scotthowson/desk-setup/desk-showcase-source/README.md

# L-249 desk showcase

30 seconds, 1920 × 1080, 24 fps, H.264 MP4 with original stereo ambient audio. Shots: establishing orbit, the three screens from the seat, a low pass under top B's front edge showing the rails, legs, feet and the bolted corner, the walnut and Y60 detail (glass rendered), a closing orbit, an end card with the repository and the manual.

Geometry exported from scotthowson/desk-setup index.html on main, Git blob e3dda0f5167aab8b4ff53113c0957ae94d3c382a.

The furniture mesh geometry is from the repository. Film treatment adds procedural walnut grain, screen artwork, studio lighting, room extension and camera animation. The model is a visual representation, not fabrication documentation. Internal coplanar case panels are omitted from the film render to prevent flicker.

Rebuild with Python (numpy, Pillow, moderngl), Node.js and ffmpeg:

1. node export_scene.cjs
2. python render.py
3. python score.py
4. ffmpeg -i desk-showcase-silent.mp4 -i ambient-score.wav -c:v copy -c:a aac -b:a 192k -af afade=t=out:st=28:d=2 -shortest -movflags +faststart desk-showcase.mp4

Three.js is included under its MIT license. Soundtrack is generated by score.py; it uses no third-party recordings.
