scotthowson/desk-setup/components/skadis/skadis-2x2-back-preview.png

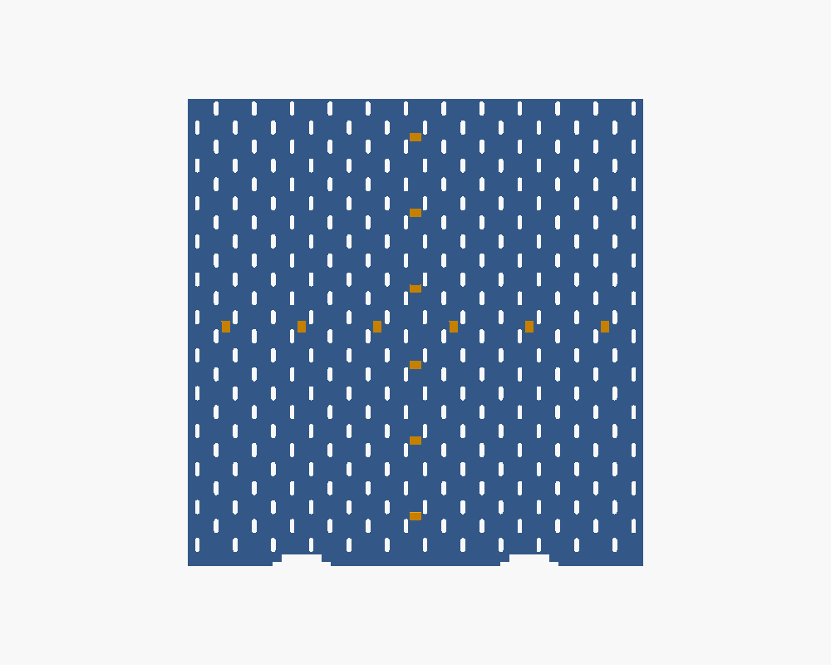
components/skadis/skadis-2x2-back-preview.png
