scotthowson/desk-setup/components/skadis/skadis-BL-preview.png

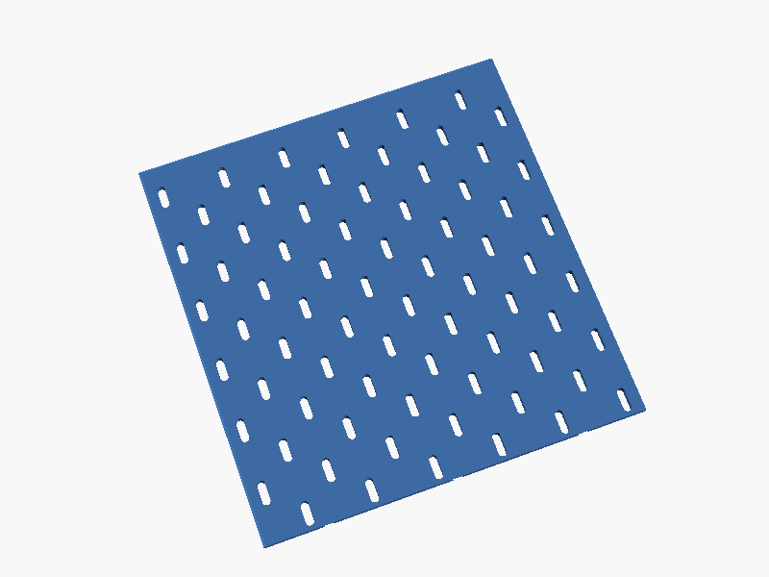
components/skadis/skadis-BL-preview.png
