scotthowson/desk-setup/components/skadis/skadis-bridges-preview.png

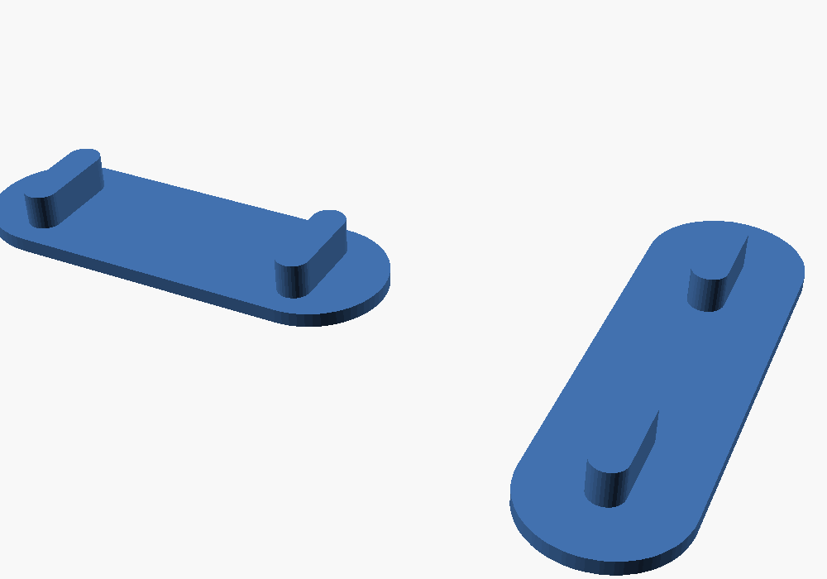
components/skadis/skadis-bridges-preview.png
