scotthowson/desk-setup/components/skadis/skadis-cross-back-preview.png

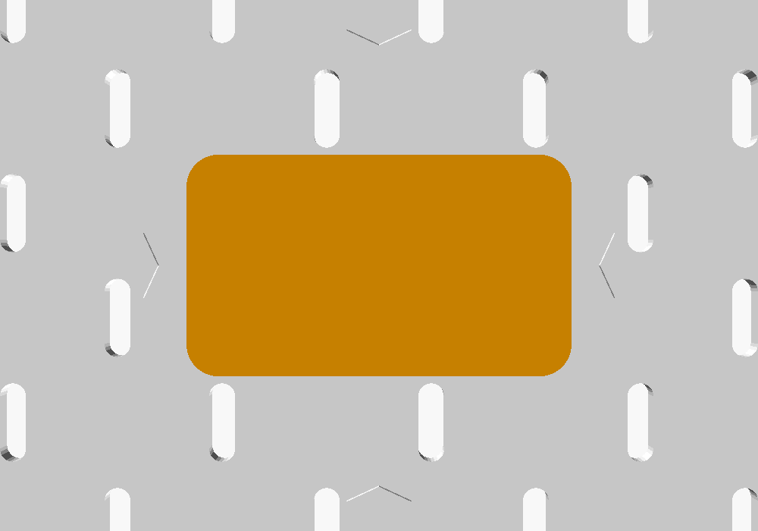
components/skadis/skadis-cross-back-preview.png
