scotthowson/desk-setup/components/skadis/skadis-cross-preview.png

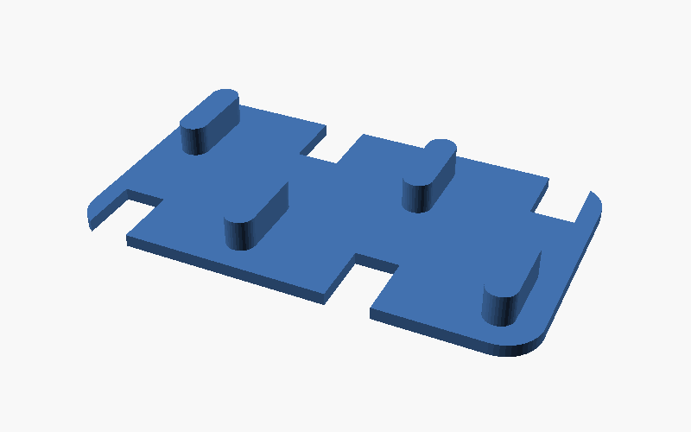
components/skadis/skadis-cross-preview.png
