scotthowson/desk-setup/components/skadis/skadis-extras-preview.png

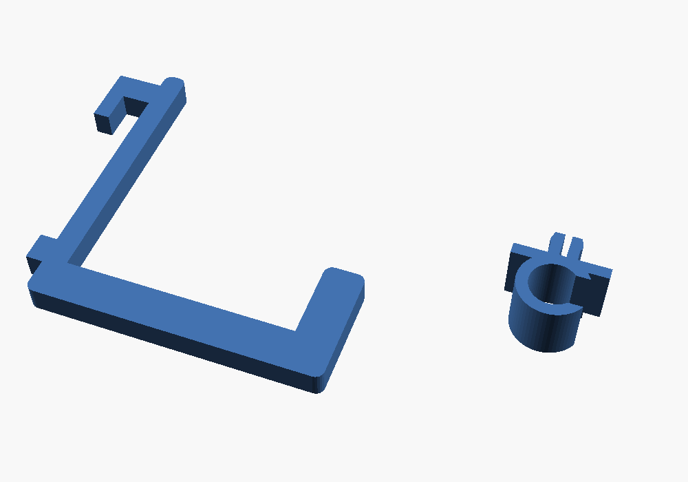
components/skadis/skadis-extras-preview.png
