scotthowson/desk-setup/components/skadis/skadis-joint-preview.png

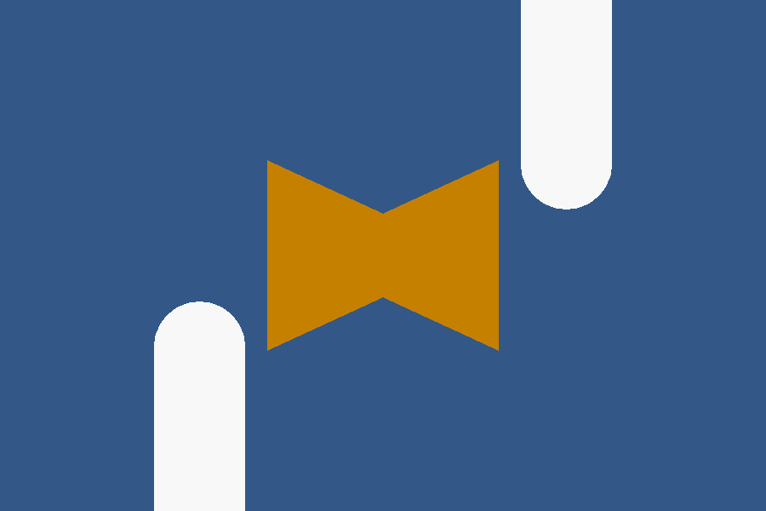
components/skadis/skadis-joint-preview.png
