scotthowson/desk-setup/components/skadis/skadis-key-preview.png

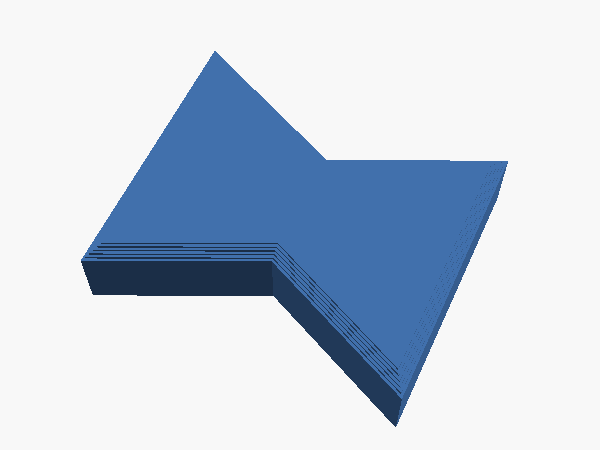
components/skadis/skadis-key-preview.png
