scotthowson/desk-setup/components/underware/accessories/og-accessories-preview.png

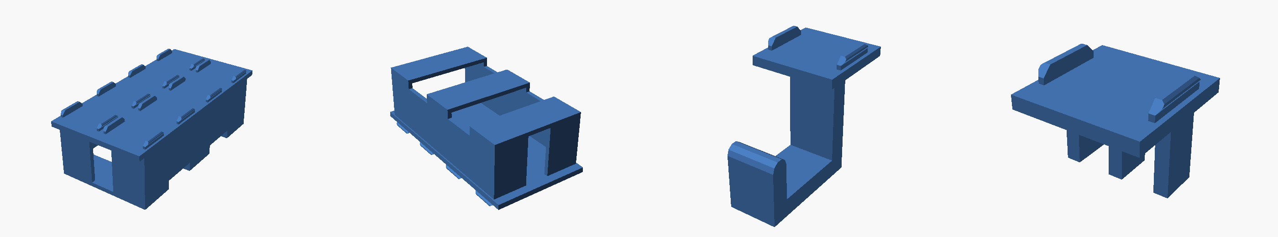
components/underware/accessories/og-accessories-preview.png
