scotthowson/desk-setup/components/underware/channel-L-preview.png

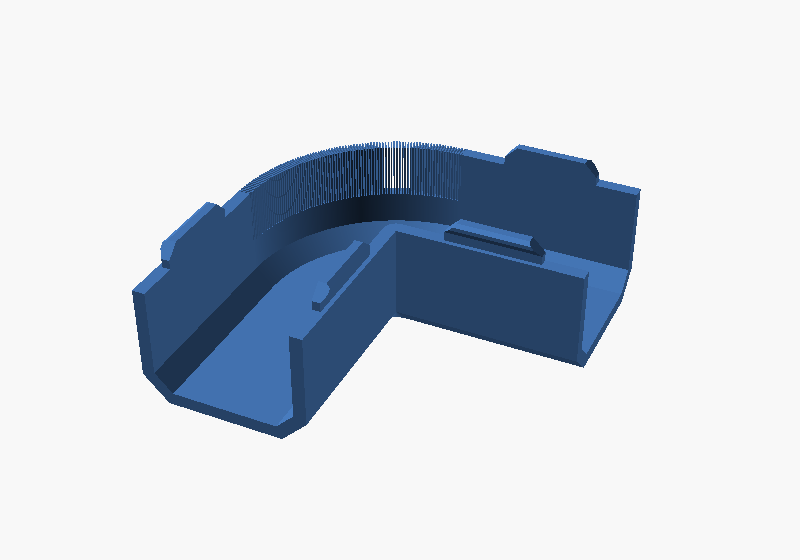
components/underware/channel-L-preview.png
