scotthowson/desk-setup/components/underware/channel-T-preview.png

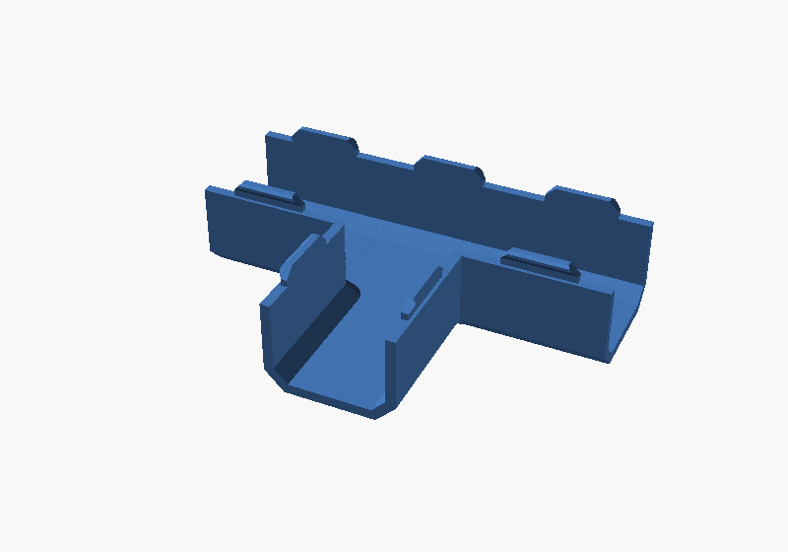
components/underware/channel-T-preview.png
