scotthowson/desk-setup/components/underware/plan.png

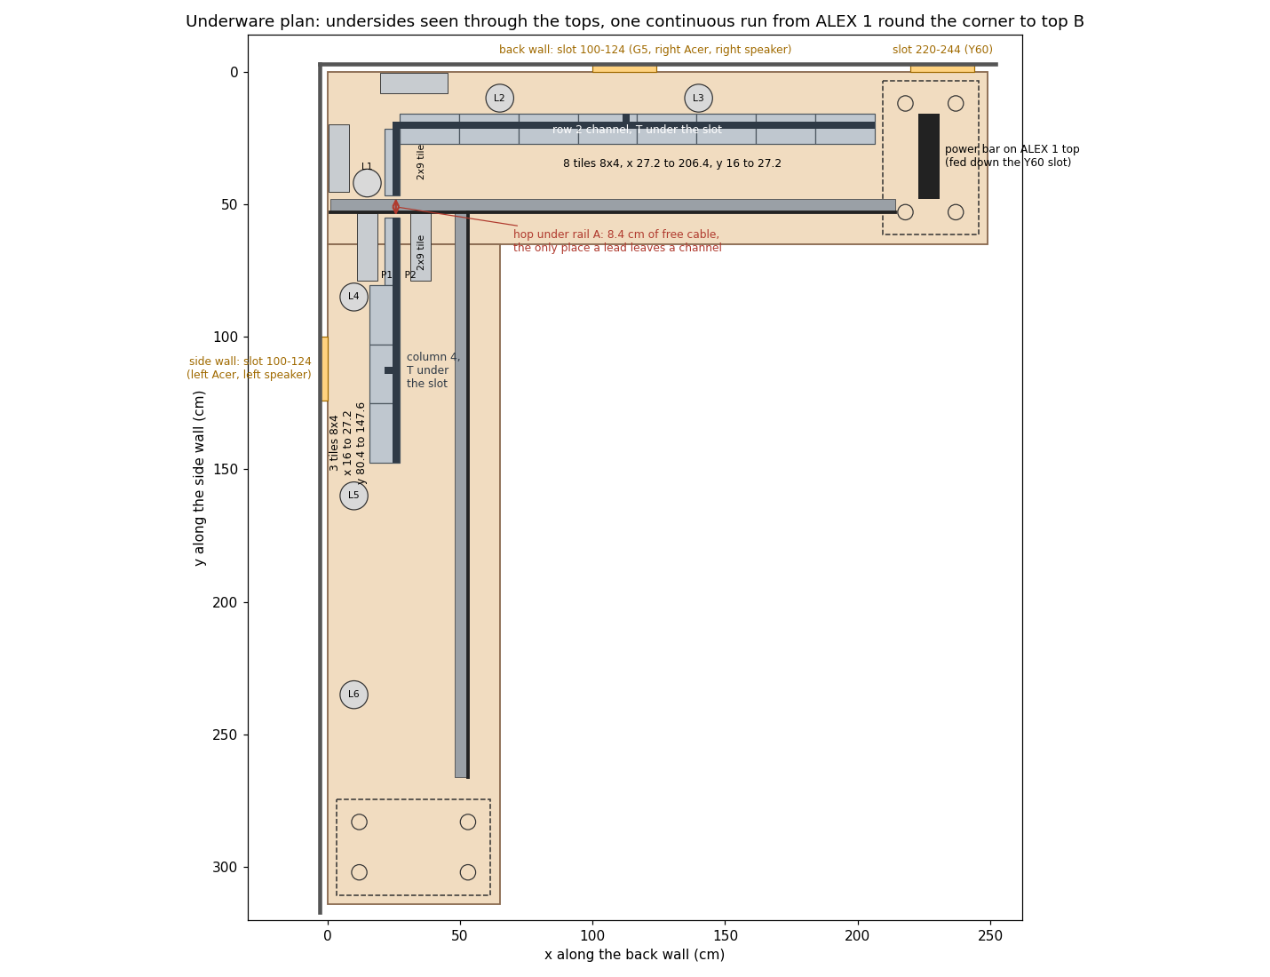
components/underware/plan.png
