scotthowson/desk-setup/components/underware/tile-8x4-lite-preview.png

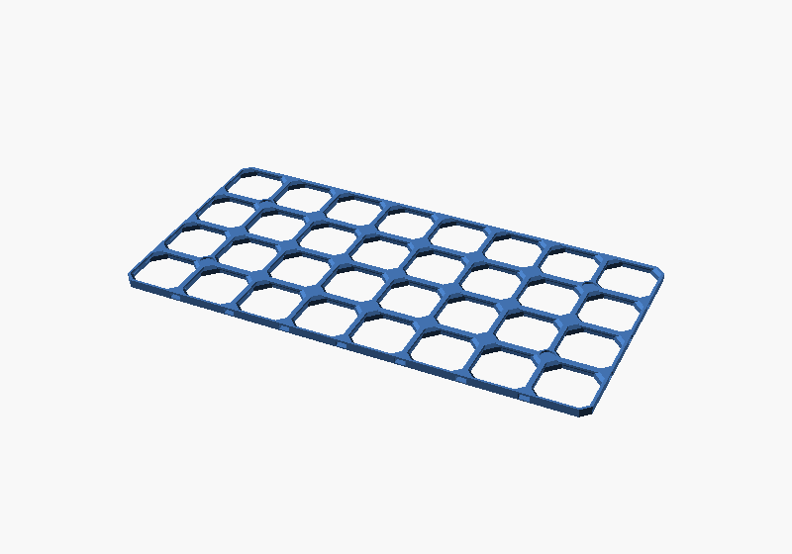
components/underware/tile-8x4-lite-preview.png
