scotthowson/desk-setup/parts/accessories/alex-foot-pad-preview.png

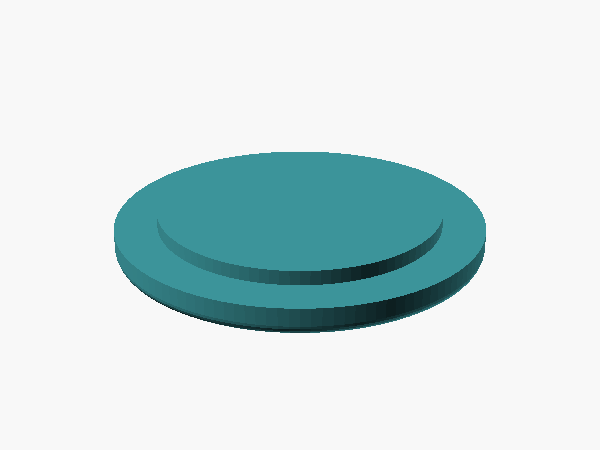
parts/accessories/alex-foot-pad-preview.png
