scotthowson/desk-setup/parts/accessories/alex-foot-preview.png

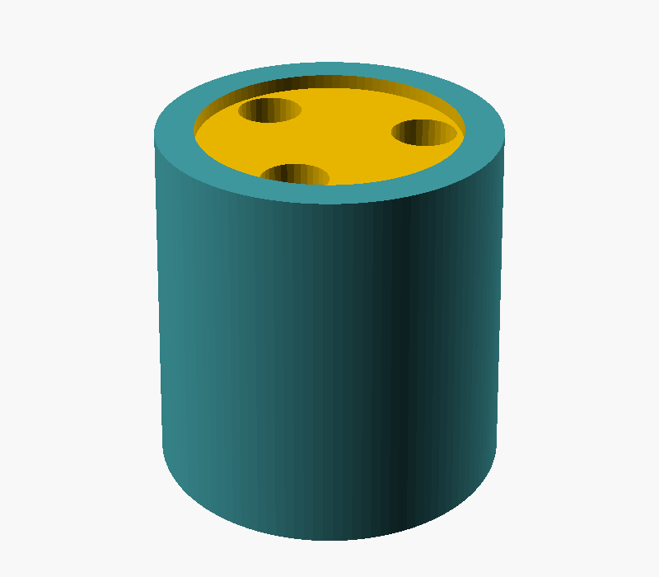
parts/accessories/alex-foot-preview.png
