scotthowson/desk-setup/parts/accessories/laptop-sling-preview.png

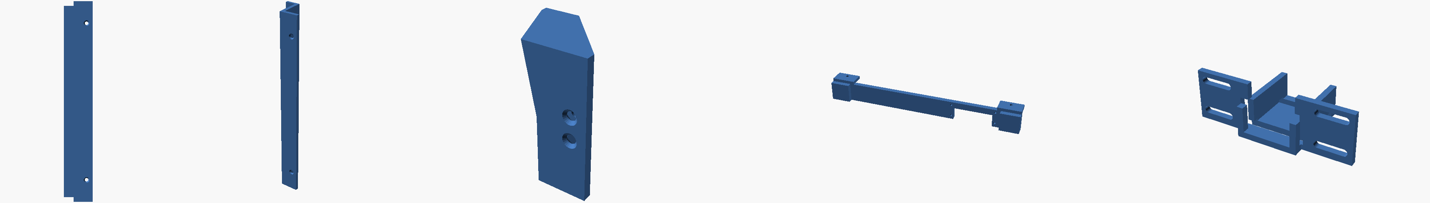
parts/accessories/laptop-sling-preview.png
