scotthowson/desk-setup/parts/accessories/phone-stand-preview.png

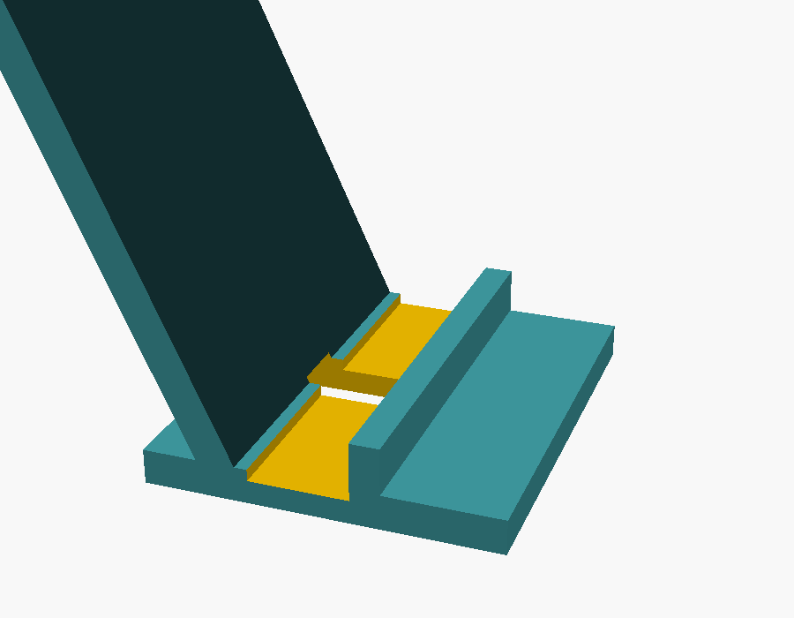
parts/accessories/phone-stand-preview.png
