scotthowson/desk-setup/parts/accessories/wall-gap-connector-preview.png

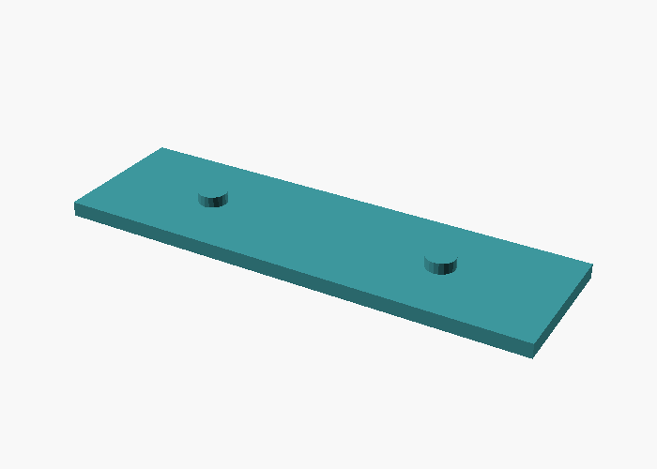
parts/accessories/wall-gap-connector-preview.png
