scotthowson/desk-setup/parts/accessories/wall-gap-corner-preview.png

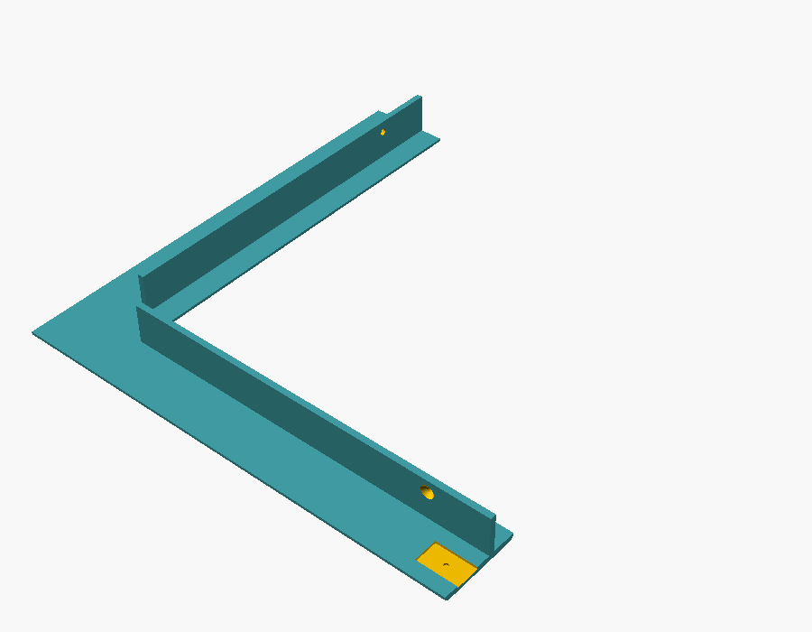
parts/accessories/wall-gap-corner-preview.png
