scotthowson/desk-setup/parts/accessories/wall-gap-end-cap-preview.png

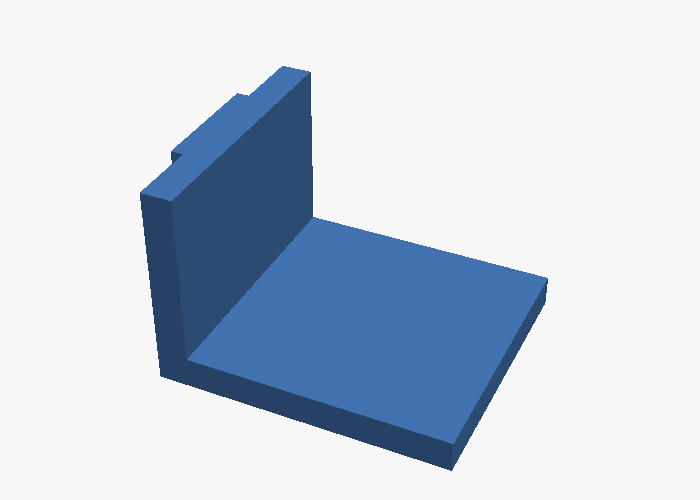
parts/accessories/wall-gap-end-cap-preview.png
