scotthowson/desk-setup/parts/accessories/wall-gap-strip-clamp-preview.png

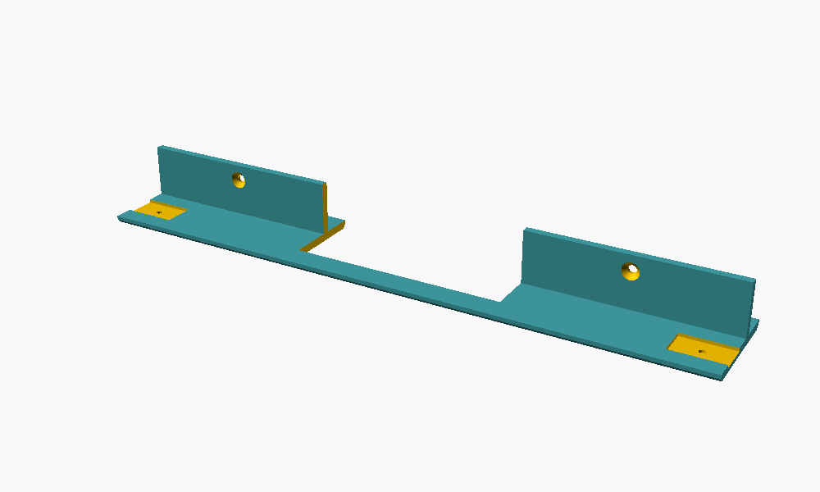
parts/accessories/wall-gap-strip-clamp-preview.png
