scotthowson/desk-setup/parts/cables/cable-clip-preview.png

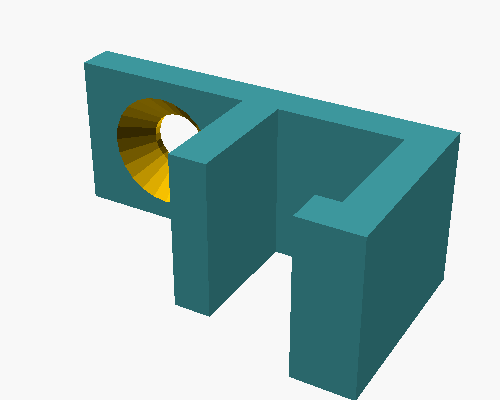
parts/cables/cable-clip-preview.png
