scotthowson/desk-setup/parts/cables/cable-tray-preview.png

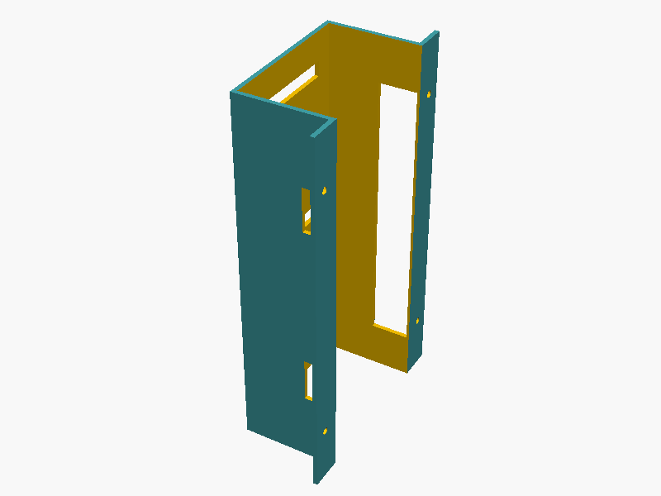
parts/cables/cable-tray-preview.png
