scotthowson/desk-setup/parts/cables/power-bar-cradle-preview.png

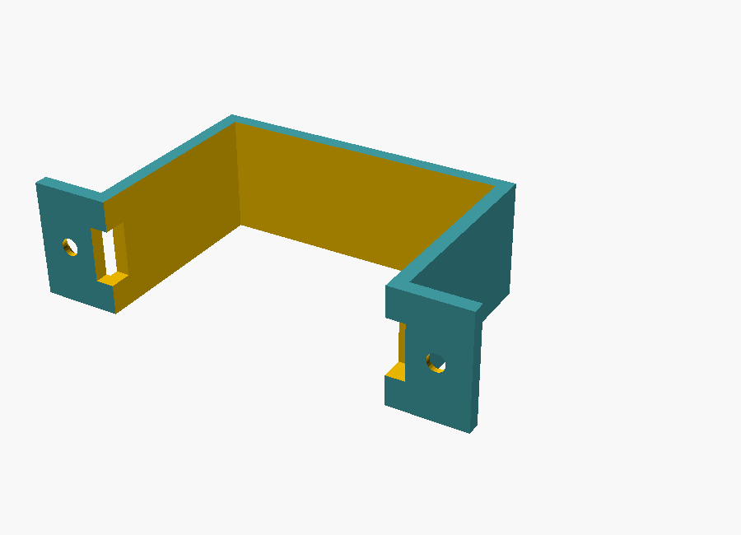
parts/cables/power-bar-cradle-preview.png
