scotthowson/desk-setup/parts/cables/rail-cable-hook-preview.png

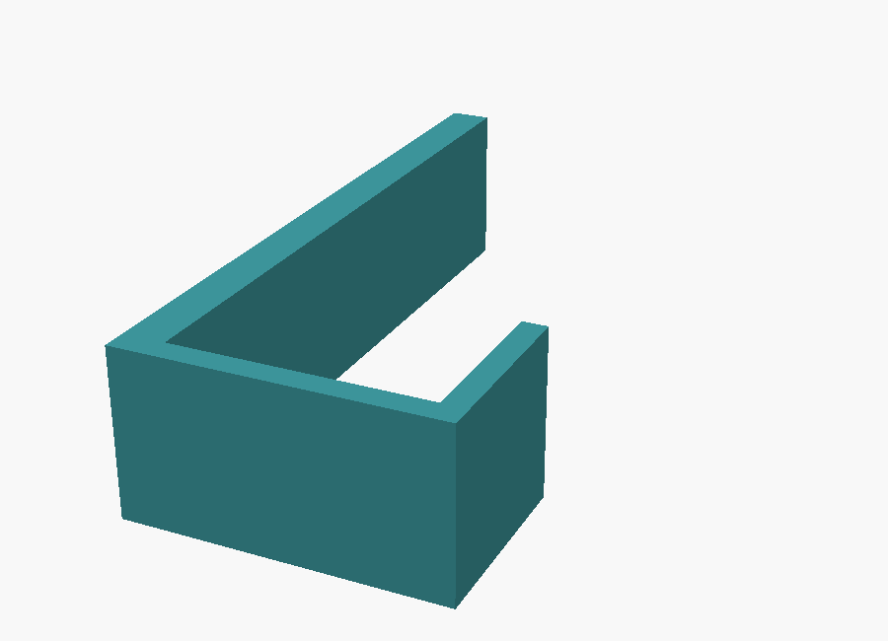
parts/cables/rail-cable-hook-preview.png
