scotthowson/desk-setup/parts/structure/foot-ring-preview.png

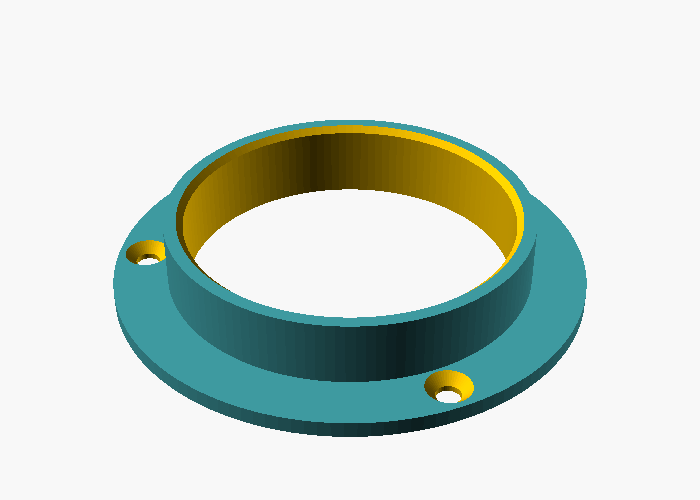
parts/structure/foot-ring-preview.png
