scotthowson/desk-setup/parts/structure/rail-end-cap-preview.png

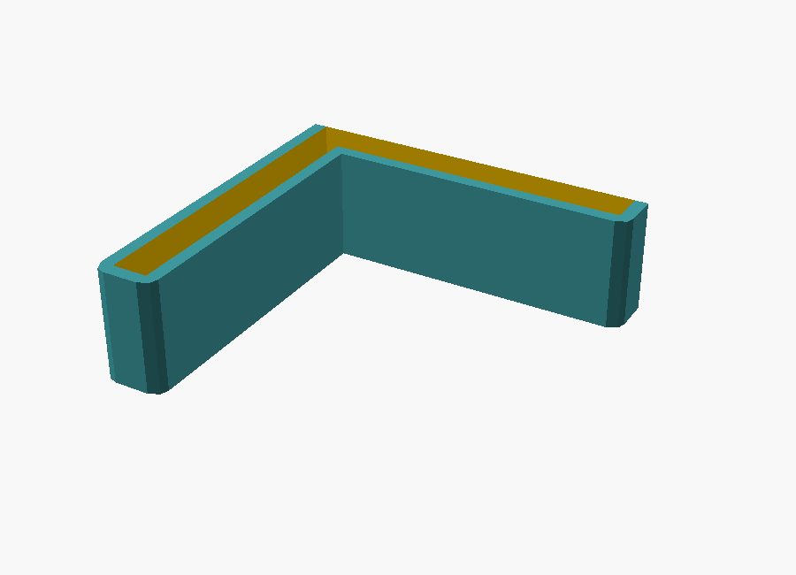
parts/structure/rail-end-cap-preview.png
