scotthowson/desk-setup/parts/tools/alex-corner-template-preview.png

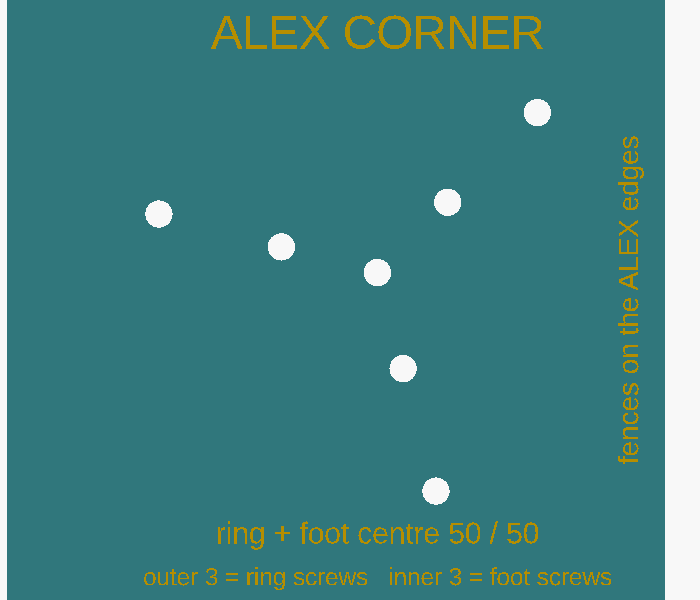
parts/tools/alex-corner-template-preview.png
