scotthowson/desk-setup/parts/tools/edge-t-square-preview.png

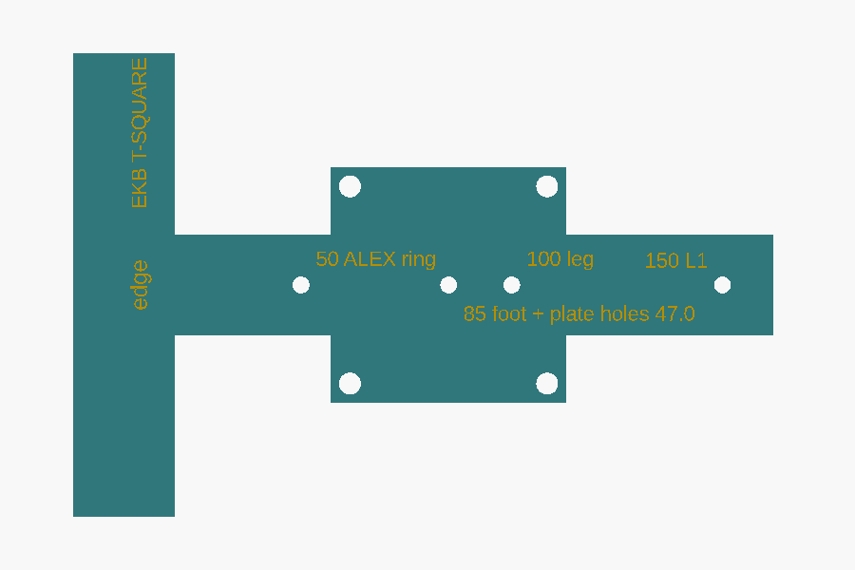
parts/tools/edge-t-square-preview.png
