scotthowson/desk-setup/parts/tools/feet-corner-jig-preview.png

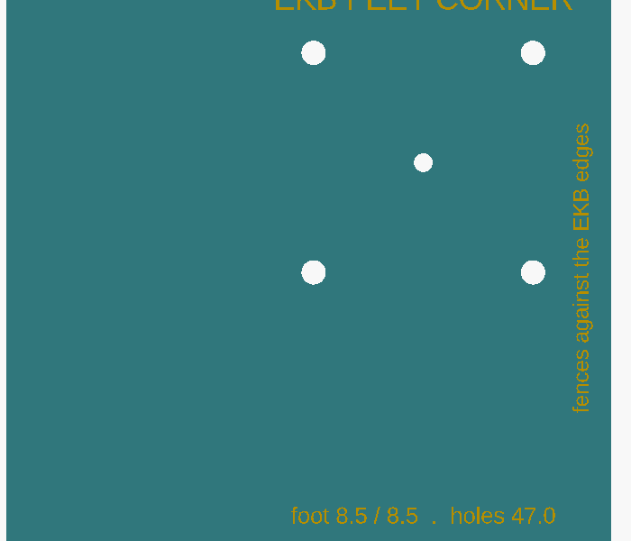
parts/tools/feet-corner-jig-preview.png
