scotthowson/desk-setup/parts/tools/fitting-centring-plug-preview.png

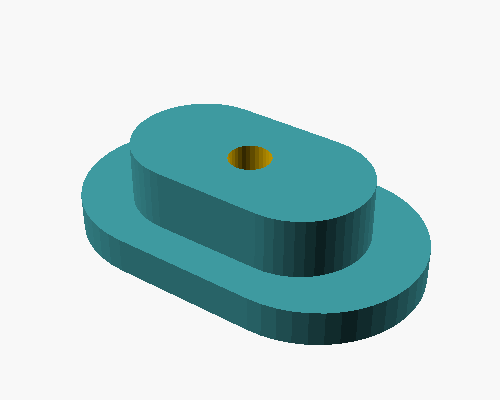
parts/tools/fitting-centring-plug-preview.png
