scotthowson/desk-setup/parts/tools/foot-height-gauge-preview.png

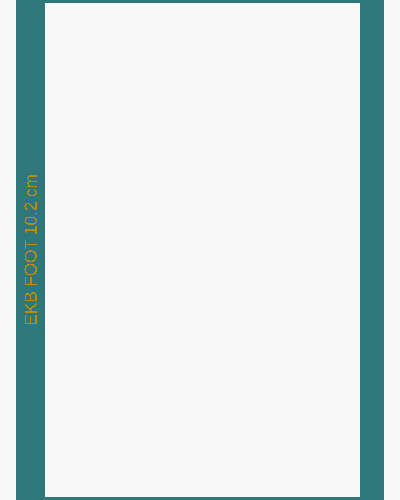
parts/tools/foot-height-gauge-preview.png
