scotthowson/desk-setup/parts/tools/leg-jig-preview.png

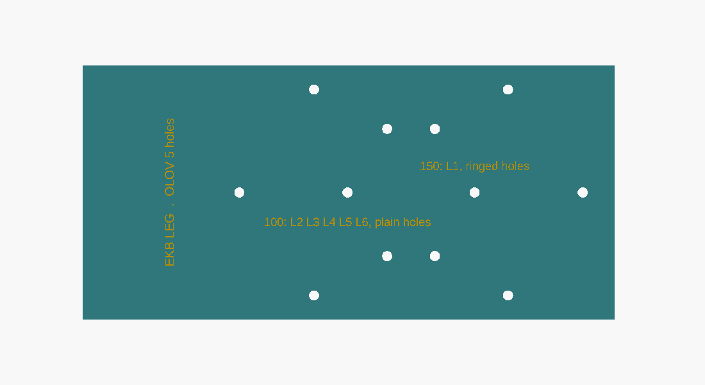
parts/tools/leg-jig-preview.png
