scotthowson/desk-setup/parts/tools/rail-bolt-jig-preview.png

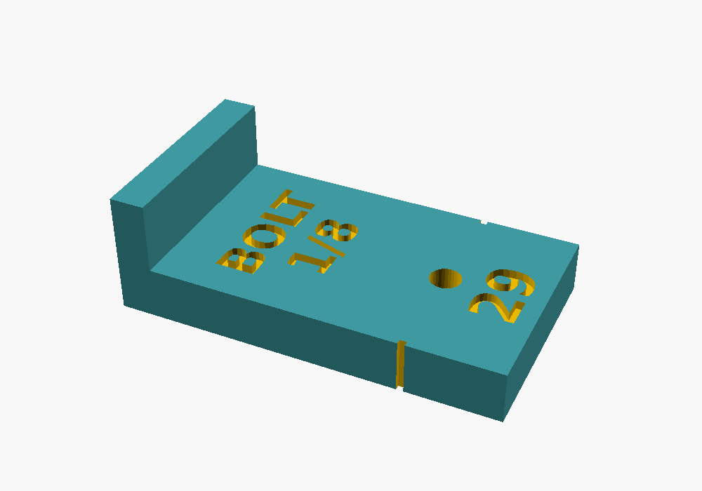
parts/tools/rail-bolt-jig-preview.png
