scotthowson/desk-setup/parts/tools/rail-drill-jig-preview.png

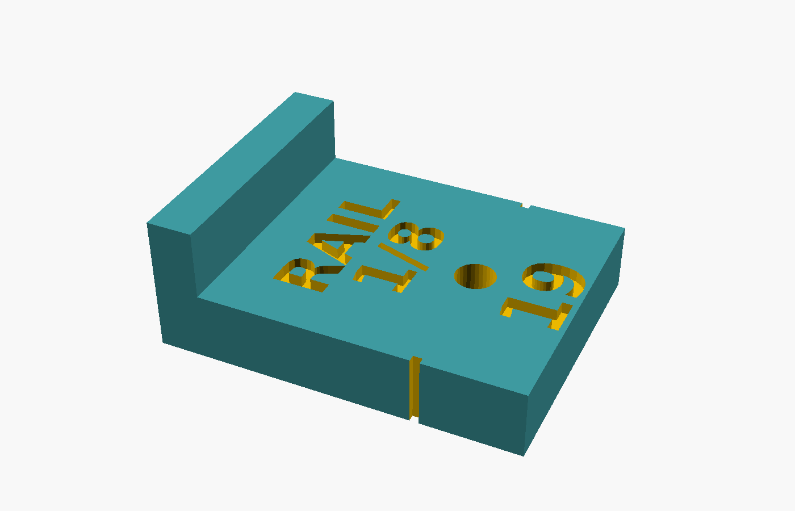
parts/tools/rail-drill-jig-preview.png
