scotthowson/desk-setup/parts/tools/rail-marking-gauge-preview.png

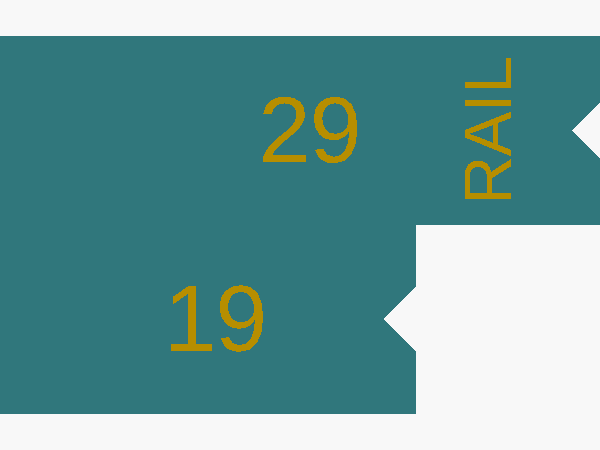
parts/tools/rail-marking-gauge-preview.png
