scotthowson/desk-setup/parts/tools/rail-setback-gauge-preview.png

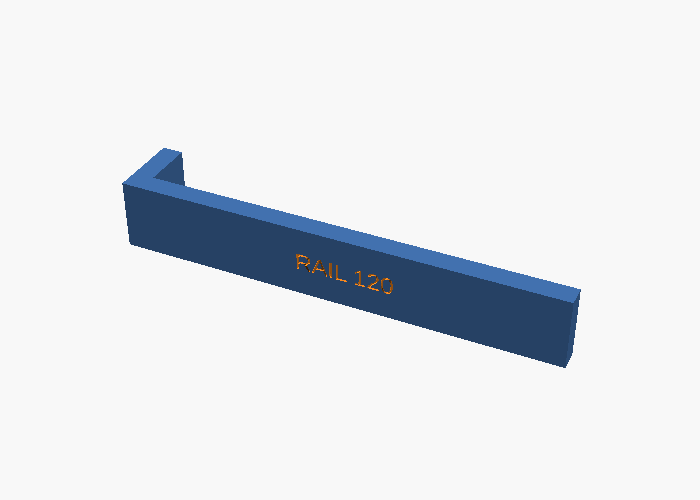
parts/tools/rail-setback-gauge-preview.png
