scotthowson/desk-setup/parts/tools/wall-gauge-preview.png

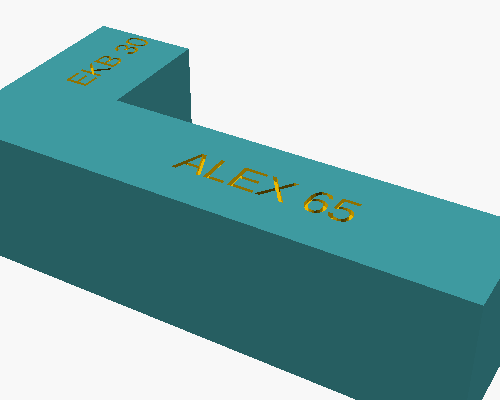
parts/tools/wall-gauge-preview.png
