scotthowson/desk-setup/components/skadis/skadis-controller-hook-x1.stl

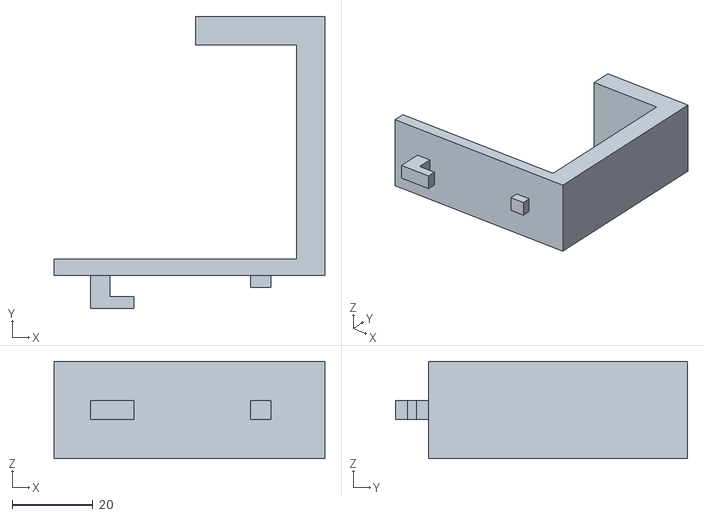
[picture p44: CAD file, 2026-10-30]
components/skadis/skadis-controller-hook-x1.stl
67.0 x 72.2 x 24.0
