scotthowson/desk-setup/components/underware/accessories/og-brick-dock-g5-x1.stl

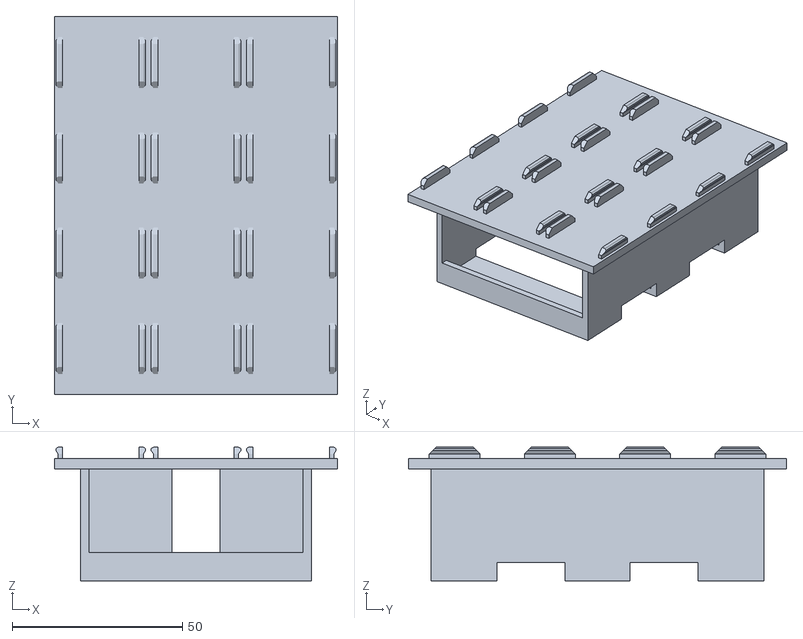
[picture p45: CAD file, 2026-11-02]
components/underware/accessories/og-brick-dock-g5-x1.stl
83.2 x 111.2 x 39.3
