scotthowson/desk-setup/components/underware/tile-9x9-lite.stl

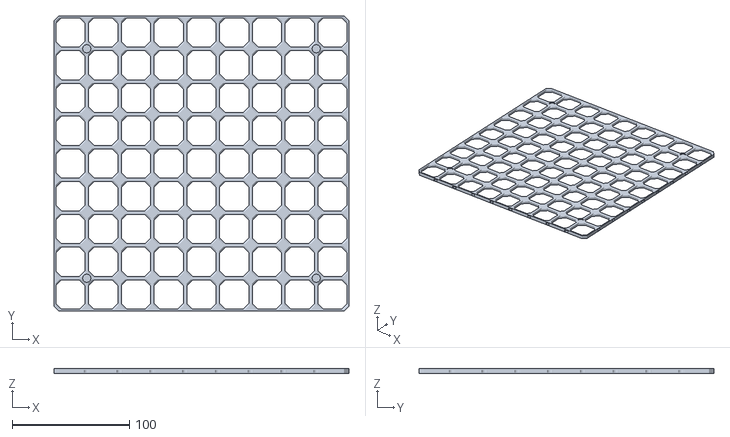
[picture p46: CAD file, 2026-10-28]
components/underware/tile-9x9-lite.stl
252.0 x 252.0 x 4.00
