scotthowson/desk-setup/parts/accessories/laptop-sling-usbc-clip-x1.stl

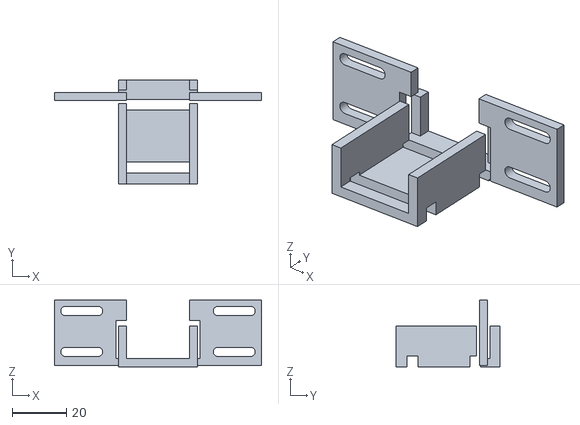
[picture p47: CAD file, 2026-11-02]
parts/accessories/laptop-sling-usbc-clip-x1.stl
76.0 x 38.0 x 24.5
