scotthowson/desk-setup/parts/cables/cable-tray-x3.stl

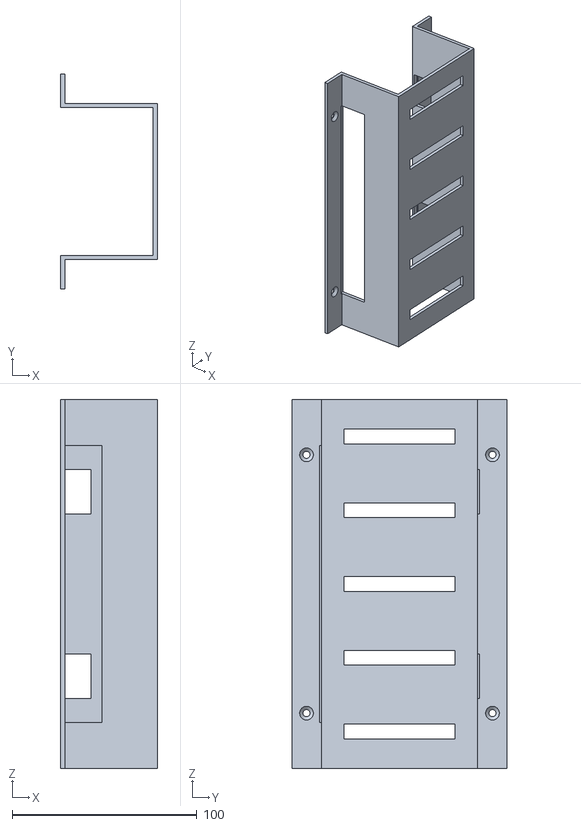
[picture p48: CAD file, 2026-10-23]
parts/cables/cable-tray-x3.stl
52.4 x 116.8 x 200.0
