scotthowson/desk-setup/parts/structure/foot-ring-x8.stl

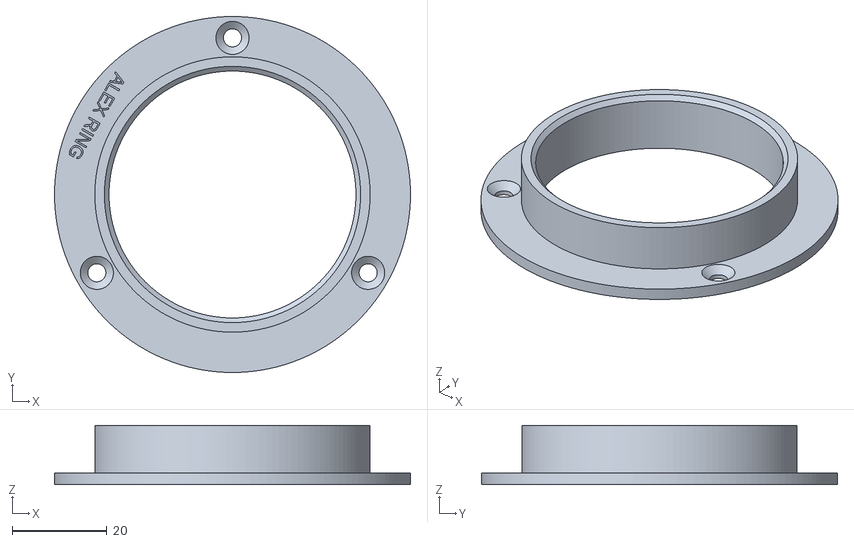
[picture p49: CAD file, 2026-10-23]
parts/structure/foot-ring-x8.stl
75.0 x 75.0 x 12.5
