scotthowson/desk-setup/components/skadis/skadis-shelf-120-x2.stl

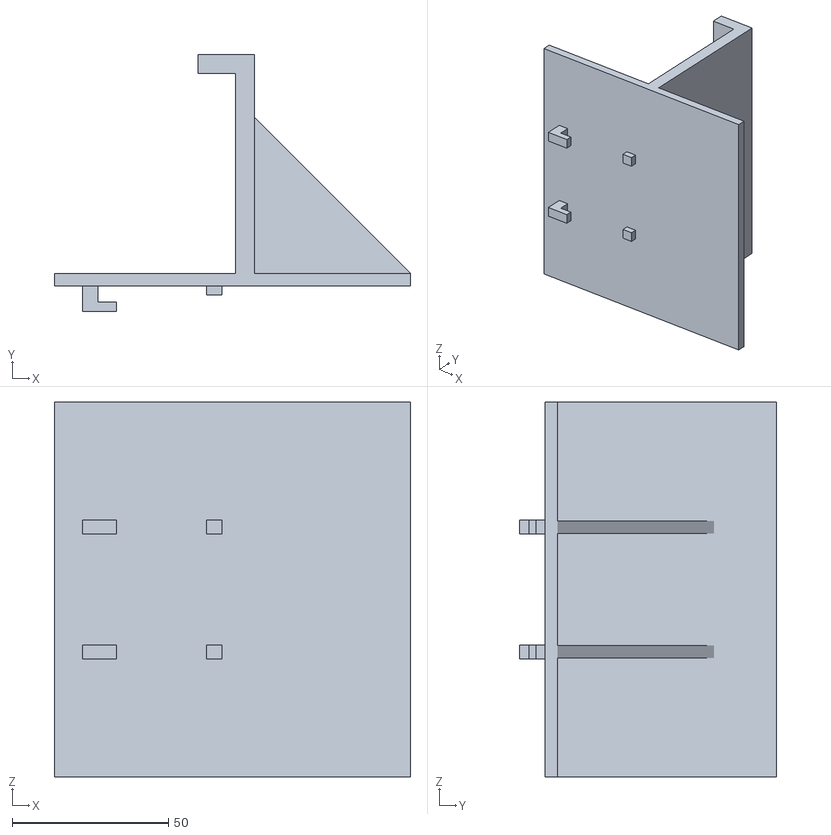
[picture p50: CAD file, 2026-10-30]
components/skadis/skadis-shelf-120-x2.stl
114.0 x 82.2 x 120.0
