scotthowson/desk-setup/components/underware/accessories/og-brick-dock-dell65-x1.stl

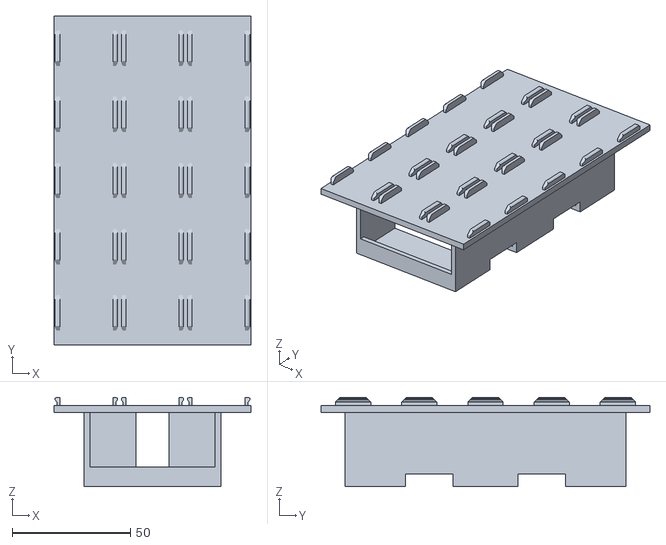
[picture p51: CAD file, 2026-11-02]
components/underware/accessories/og-brick-dock-dell65-x1.stl
83.2 x 139.2 x 37.8
