scotthowson/desk-setup/components/underware/tile-8x9-lite.stl

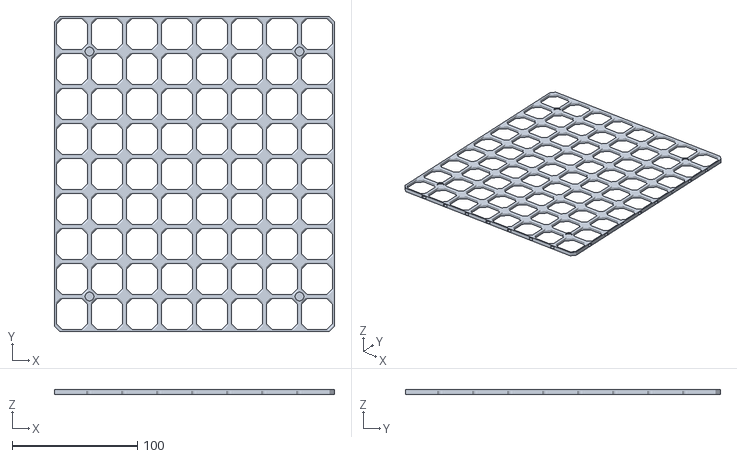
[picture p52: CAD file, 2026-10-28]
components/underware/tile-8x9-lite.stl
224.0 x 252.0 x 4.00
