scotthowson/desk-setup/parts/accessories/laptop-sling-carriage-x1.stl

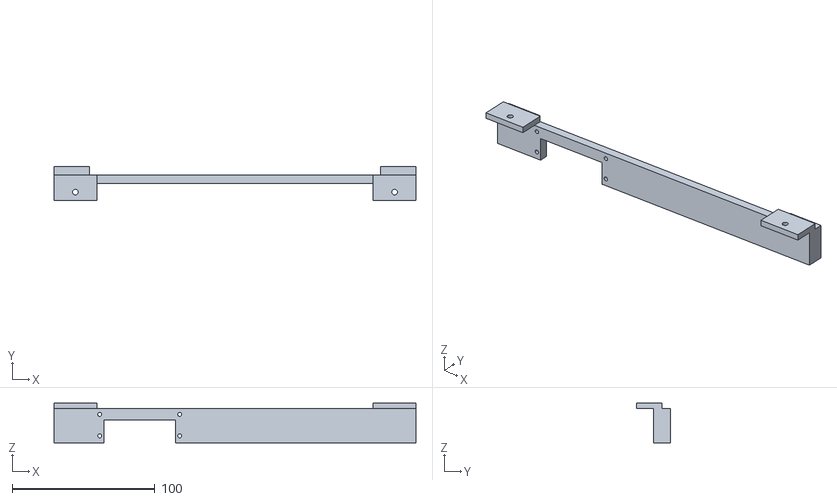
[picture p53: CAD file, 2026-11-02]
parts/accessories/laptop-sling-carriage-x1.stl
253.4 x 24.0 x 28.0
