scotthowson/desk-setup/parts/cables/cable-clip-x6.stl

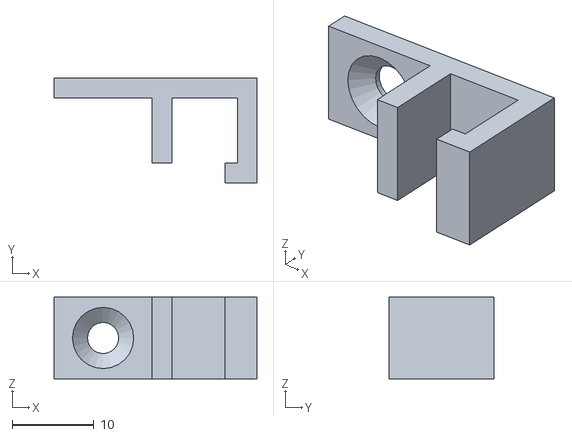
[picture p54: CAD file, 2026-10-23]
parts/cables/cable-clip-x6.stl
24.8 x 12.8 x 10.0
