scotthowson/desk-setup/parts/structure/rail-end-cap-B-x2.stl

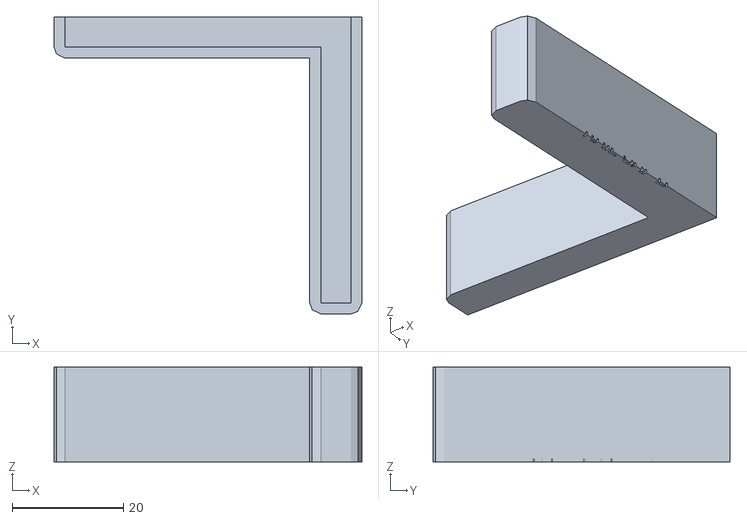
[picture p55: CAD file, 2026-10-23]
parts/structure/rail-end-cap-B-x2.stl
55.4 x 53.4 x 17.0
