scotthowson/desk-setup/parts/tools/pilot-drill-guide-x1.stl

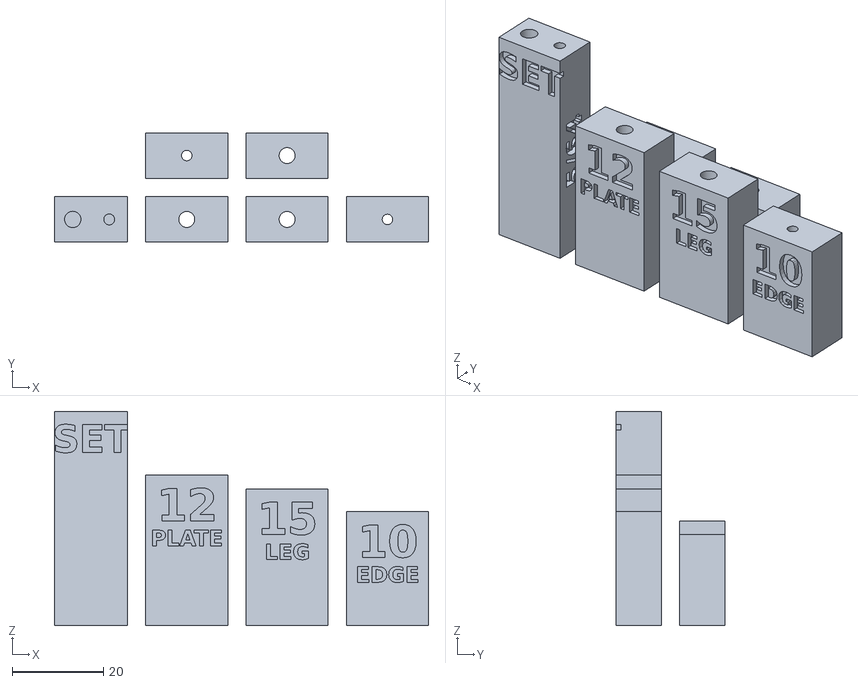
[picture p56: CAD file, 2026-11-02]
parts/tools/pilot-drill-guide-x1.stl
82.0 x 24.0 x 47.0
