scotthowson/desk-setup/components/skadis/skadis-keyboard-perch-x2.stl

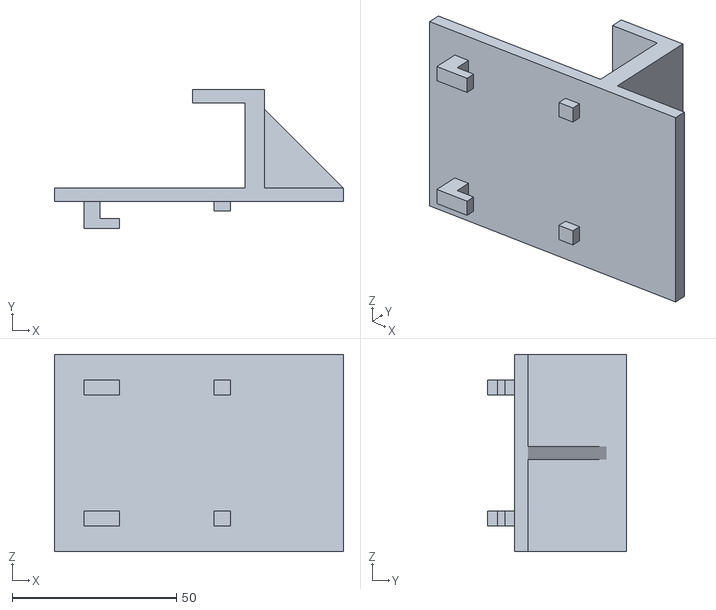
[picture p57: CAD file, 2026-10-30]
components/skadis/skadis-keyboard-perch-x2.stl
88.0 x 42.2 x 60.0
