scotthowson/desk-setup/components/underware/accessories/og-hook-x2.stl

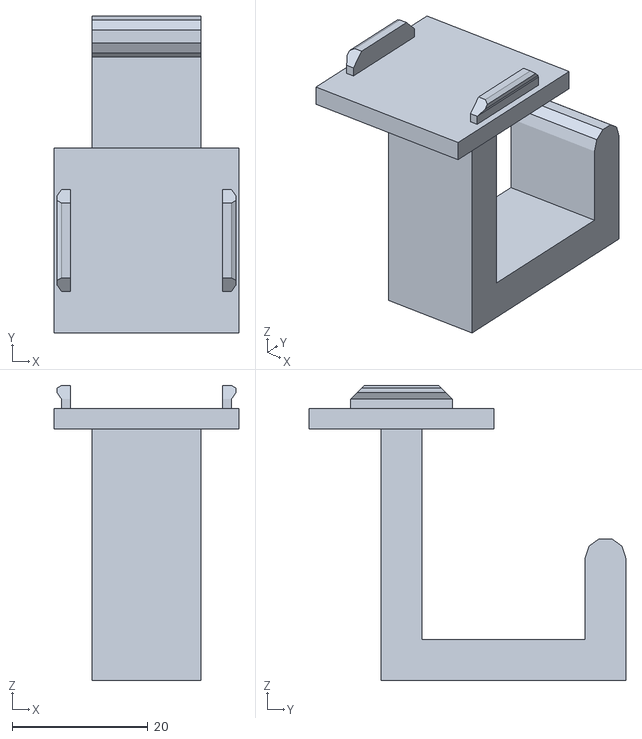
[picture p58: CAD file, 2026-11-02]
components/underware/accessories/og-hook-x2.stl
27.2 x 46.6 x 43.4
