scotthowson/desk-setup/components/underware/channel-L-x1.stl

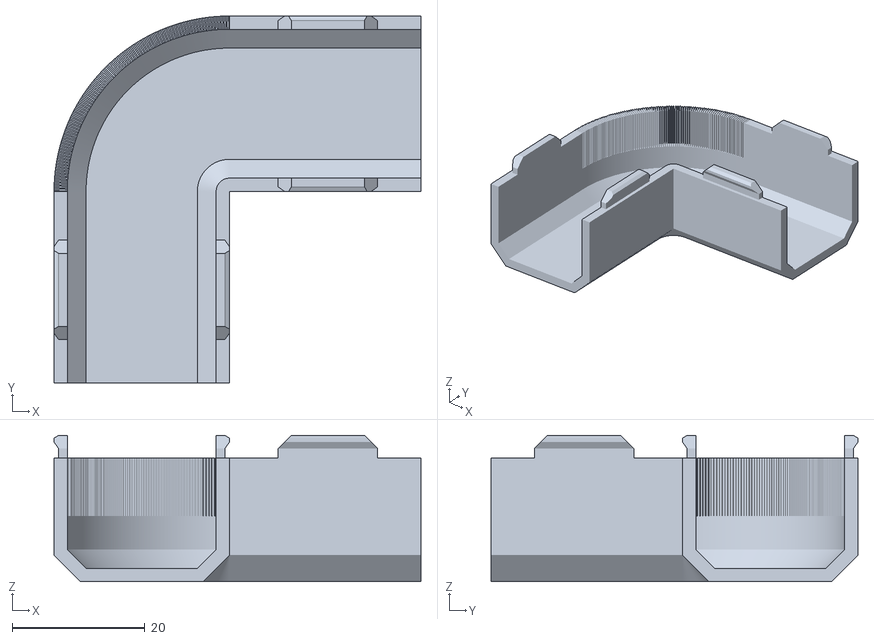
[picture p59: CAD file, 2026-10-26]
components/underware/channel-L-x1.stl
55.2 x 55.2 x 22.0
