scotthowson/desk-setup/parts/accessories/laptop-sling-mouth-x2.stl

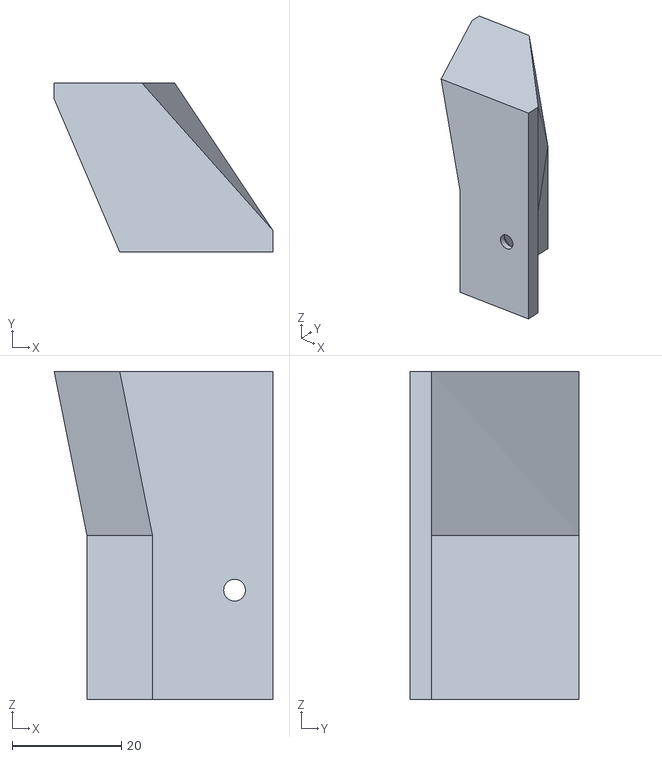
[picture p60: CAD file, 2026-11-02]
parts/accessories/laptop-sling-mouth-x2.stl
40.0 x 31.0 x 60.0
