scotthowson/desk-setup/parts/cables/power-bar-cradle-x4.stl

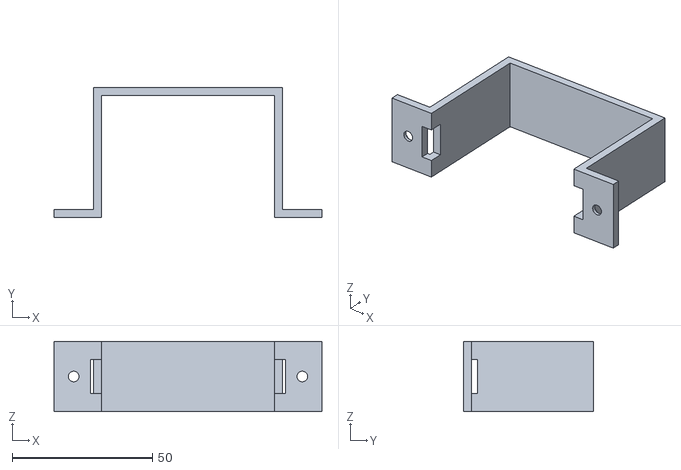
[picture p61: CAD file, 2026-10-21]
parts/cables/power-bar-cradle-x4.stl
95.5 x 46.5 x 25.0
