scotthowson/desk-setup/parts/structure/rail-end-cap-A-x1.stl

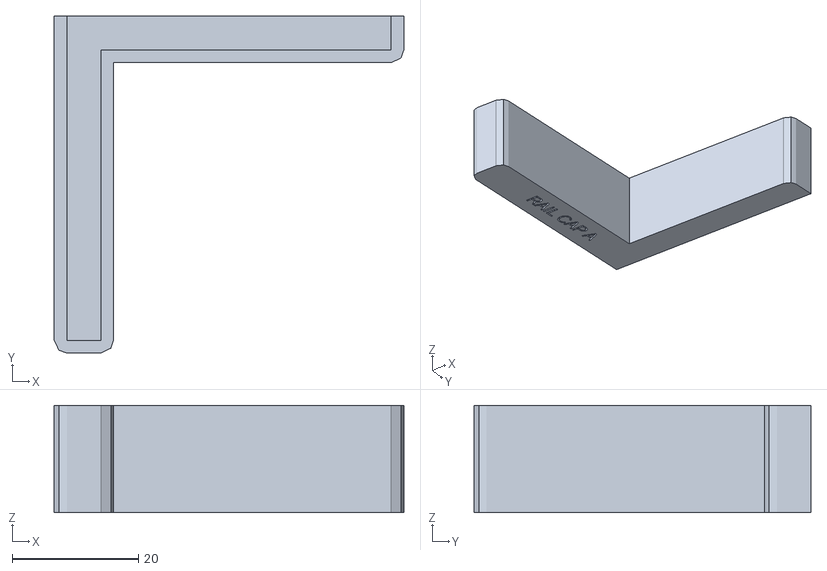
[picture p62: CAD file, 2026-10-23]
parts/structure/rail-end-cap-A-x1.stl
55.4 x 53.4 x 17.0
