scotthowson/desk-setup/parts/tools/rail-drill-jig-x1.stl

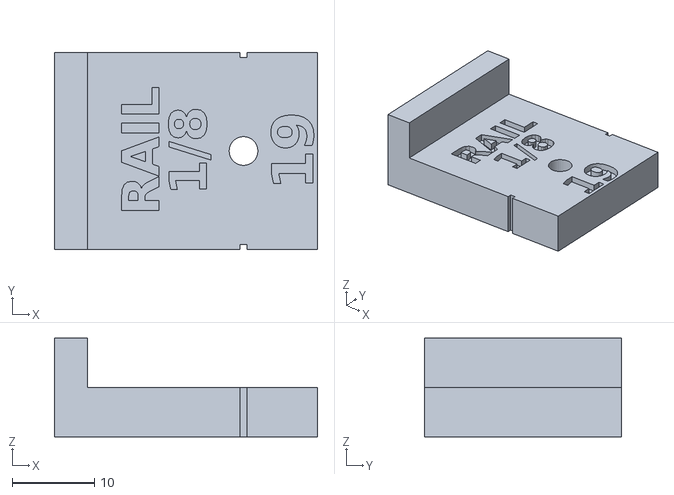
[picture p63: CAD file, 2026-11-02]
parts/tools/rail-drill-jig-x1.stl
32.0 x 24.0 x 12.0
