scotthowson/desk-setup/components/skadis/rib-240-k3-x4.stl

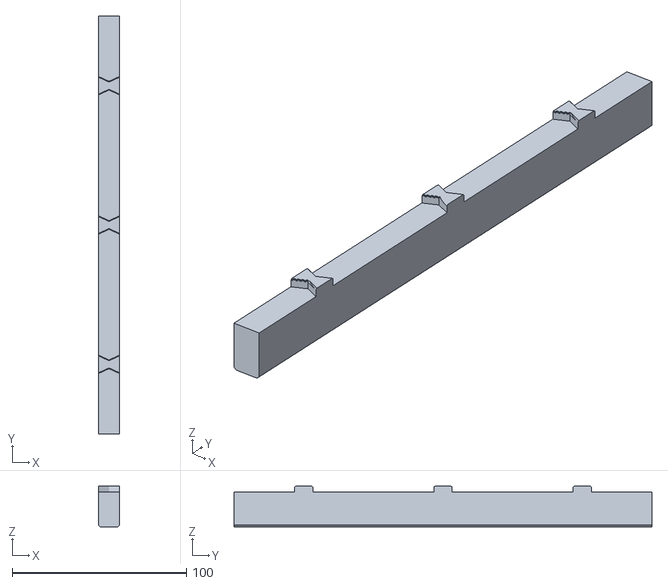
[picture p64: CAD file, 2026-10-30]
components/skadis/rib-240-k3-x4.stl
12.0 x 240.0 x 23.4
