scotthowson/desk-setup/components/underware/accessories/og-cable-exit-x2.stl

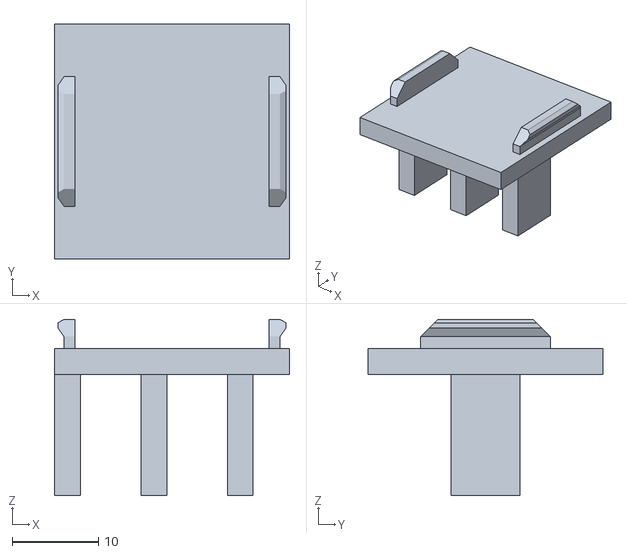
[picture p65: CAD file, 2026-11-02]
components/underware/accessories/og-cable-exit-x2.stl
27.2 x 27.2 x 20.4
