scotthowson/desk-setup/components/underware/channel-T-x2.stl

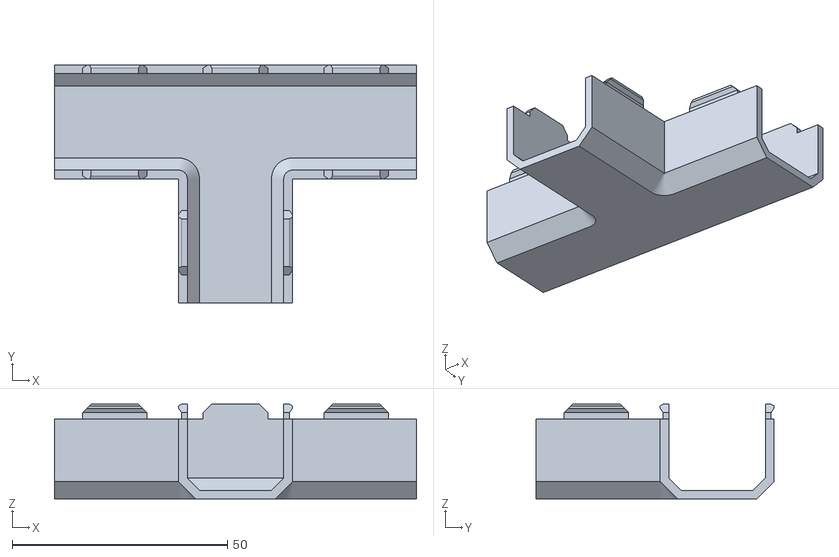
[picture p66: CAD file, 2026-10-26]
components/underware/channel-T-x2.stl
84.0 x 55.2 x 22.0
