scotthowson/desk-setup/parts/accessories/laptop-sling-rail-x2.stl

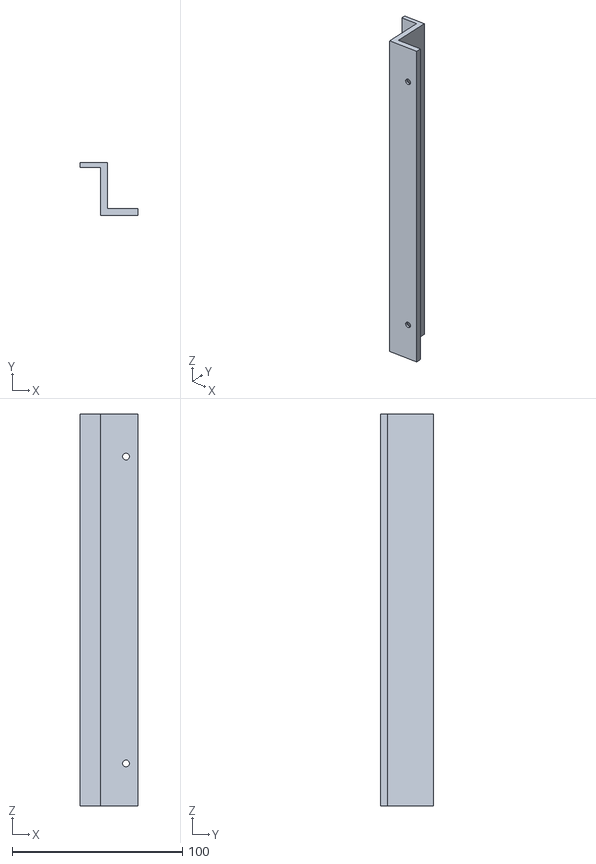
[picture p67: CAD file, 2026-11-02]
parts/accessories/laptop-sling-rail-x2.stl
34.0 x 31.0 x 230.0
