scotthowson/desk-setup/parts/cables/rail-cable-hook-x4.stl

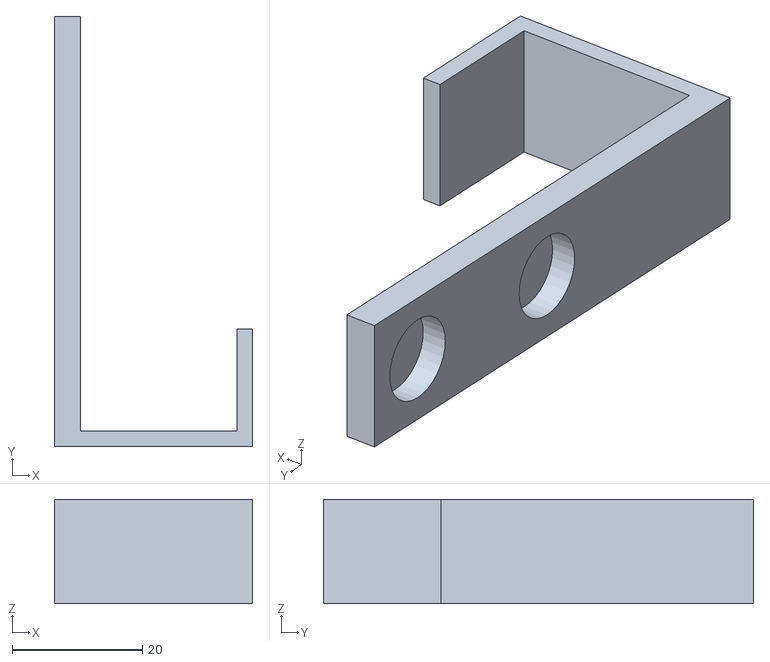
[picture p68: CAD file, 2026-10-21]
parts/cables/rail-cable-hook-x4.stl
30.4 x 66.0 x 16.0
