scotthowson/desk-setup/parts/tools/rail-setback-gauge-x2.stl

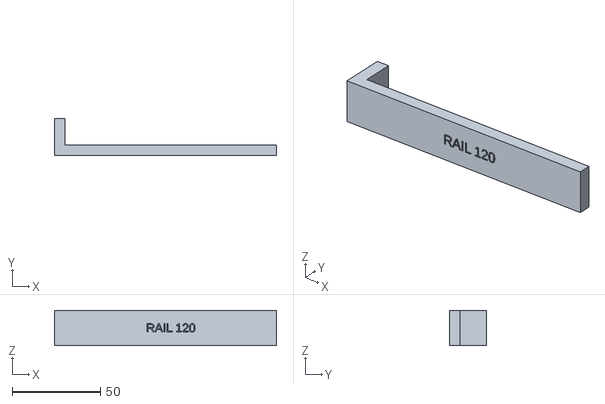
[picture p69: CAD file, 2026-10-26]
parts/tools/rail-setback-gauge-x2.stl
126.0 x 21.0 x 20.0
