scotthowson/desk-setup/components/skadis/rib-240-k0.stl

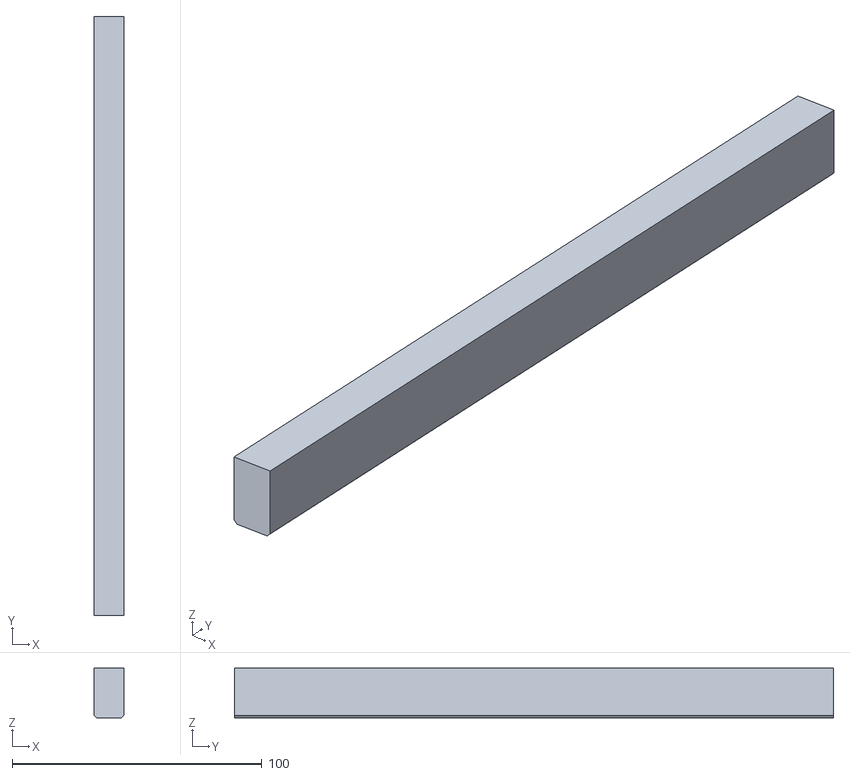
[picture p70: CAD file, 2026-10-30]
components/skadis/rib-240-k0.stl
12.0 x 240.0 x 20.0
