scotthowson/desk-setup/components/underware/channel-I-4-x1.stl

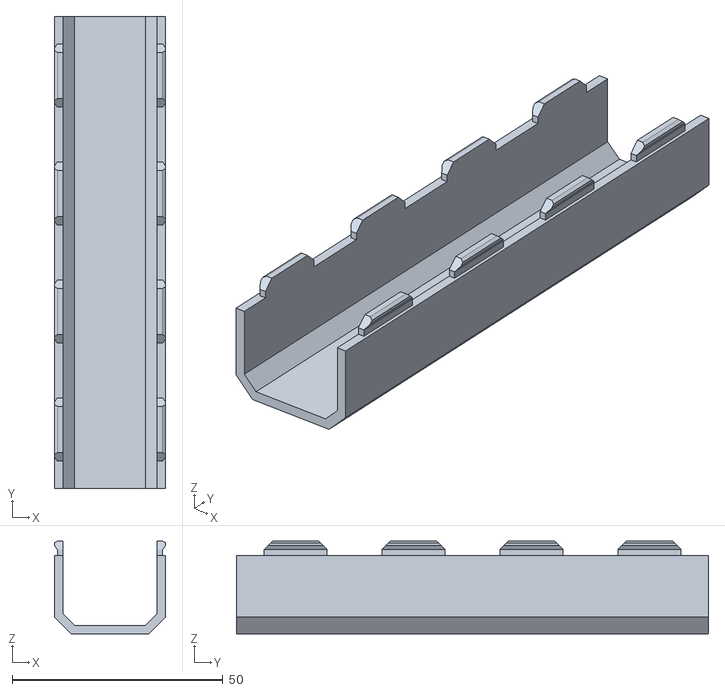
[picture p71: CAD file, 2026-10-26]
components/underware/channel-I-4-x1.stl
26.4 x 112.0 x 22.0
