scotthowson/desk-setup/parts/accessories/wall-gap-end-cap-x2.stl

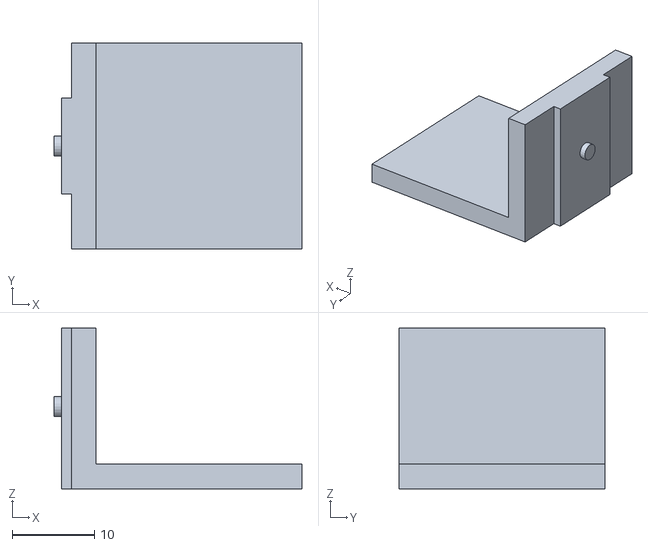
[picture p72: CAD file, 2026-10-25]
parts/accessories/wall-gap-end-cap-x2.stl
30.1 x 25.0 x 19.5
