scotthowson/desk-setup/parts/tools/alex-corner-template-x1.stl

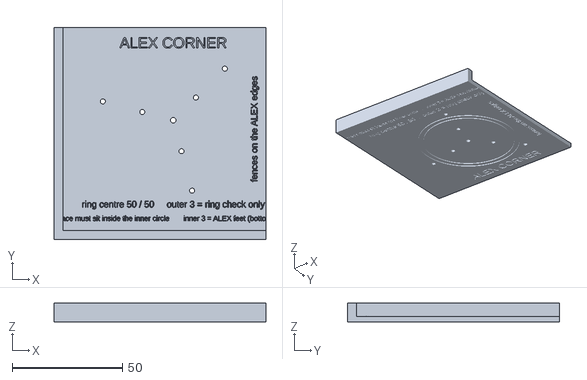
[picture p73: CAD file, 2026-10-23]
parts/tools/alex-corner-template-x1.stl
96.0 x 96.0 x 8.50
