scotthowson/desk-setup/components/skadis/skadis-bridge-v-x4.stl

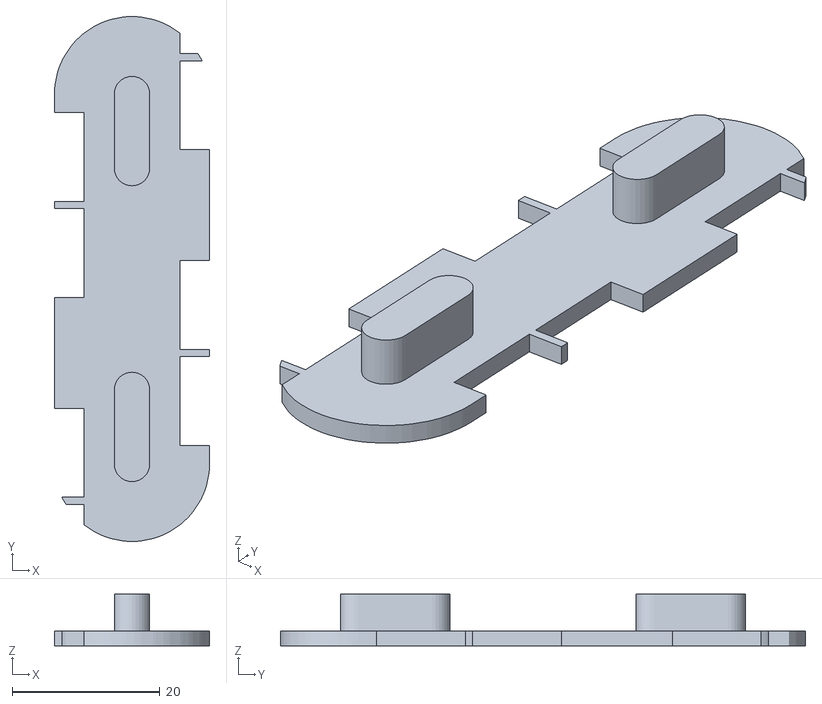
[picture p74: CAD file, 2026-10-30]
components/skadis/skadis-bridge-v-x4.stl
21.0 x 71.0 x 7.00
