scotthowson/desk-setup/components/underware/channel-I-8-x11.stl

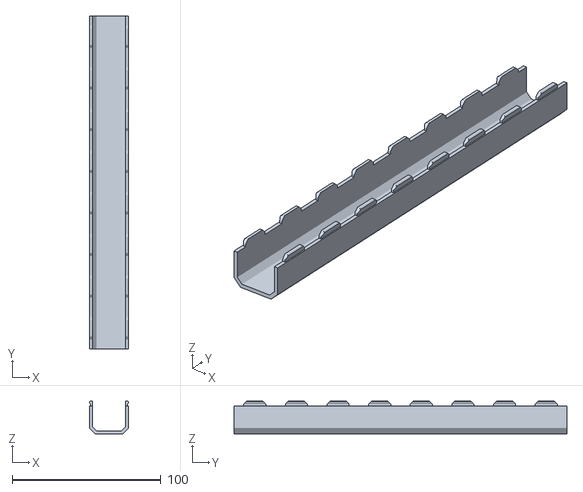
[picture p75: CAD file, 2026-10-26]
components/underware/channel-I-8-x11.stl
26.4 x 224.0 x 22.0
