scotthowson/desk-setup/parts/accessories/wall-gap-strip-220-x1.stl

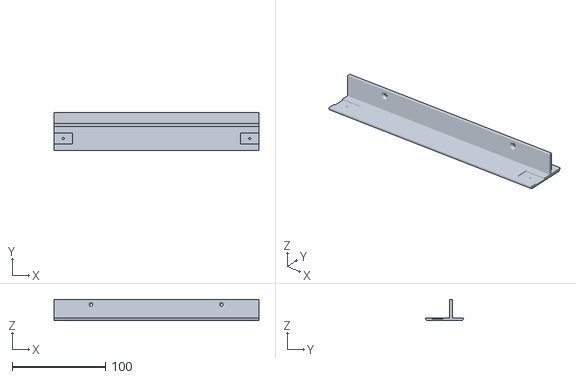
[picture p76: CAD file, 2026-10-25]
parts/accessories/wall-gap-strip-220-x1.stl
220.0 x 41.0 x 23.0
