scotthowson/desk-setup/parts/tools/edge-t-square-x1.stl

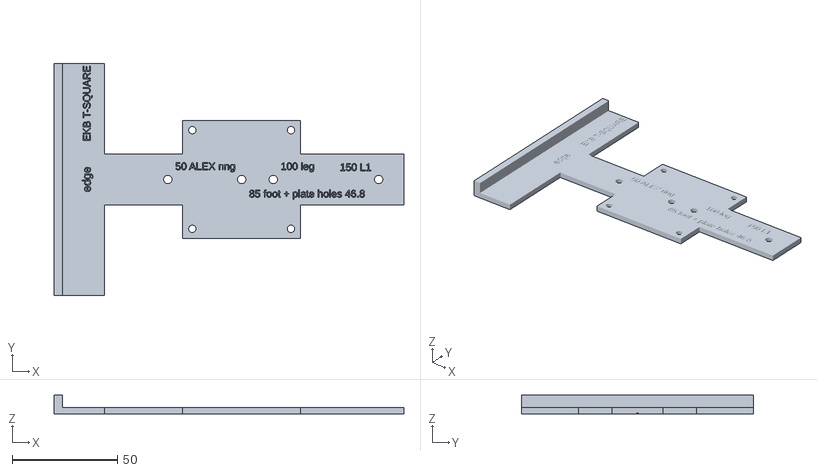
[picture p77: CAD file, 2026-10-23]
parts/tools/edge-t-square-x1.stl
166.0 x 110.0 x 9.00
