scotthowson/desk-setup/components/skadis/skadis-bridge-h-x4.stl

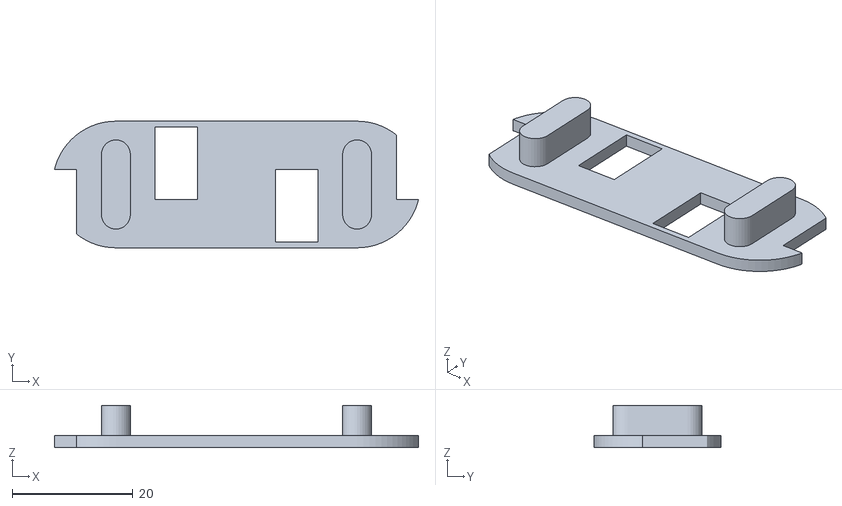
[picture p78: CAD file, 2026-10-30]
components/skadis/skadis-bridge-h-x4.stl
60.4 x 21.0 x 7.00
