scotthowson/desk-setup/components/underware/tile-2x9-lite-x2.stl

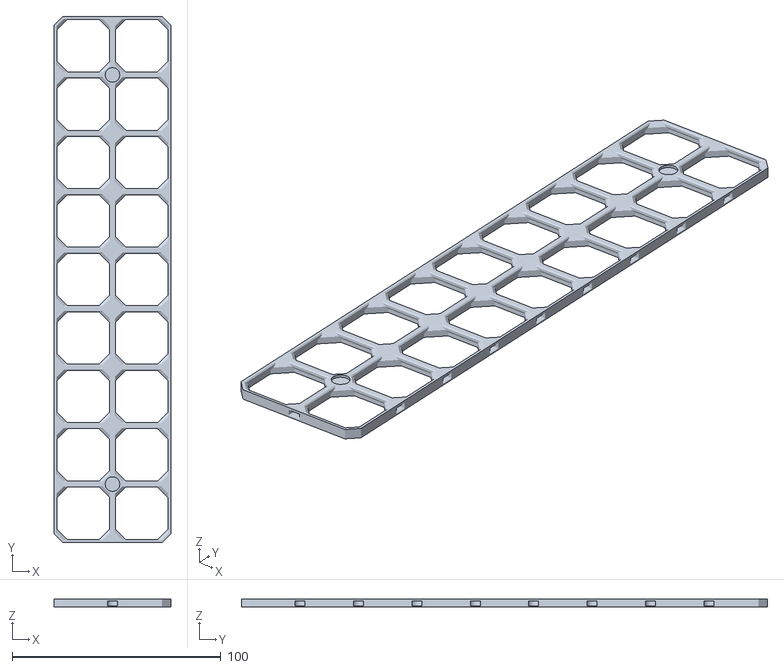
[picture p79: CAD file, 2026-10-26]
components/underware/tile-2x9-lite-x2.stl
56.0 x 252.0 x 4.00
