scotthowson/desk-setup/parts/accessories/wall-gap-strip-50-x1.stl

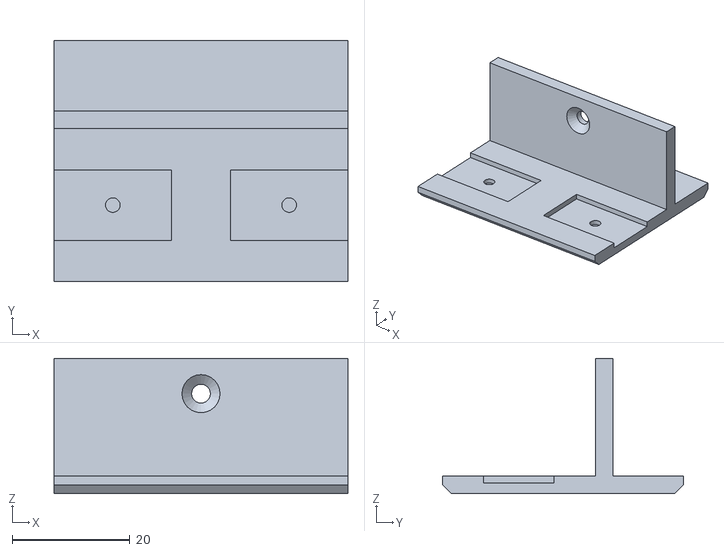
[picture p80: CAD file, 2026-10-25]
parts/accessories/wall-gap-strip-50-x1.stl
50.0 x 41.0 x 23.0
