scotthowson/desk-setup/parts/tools/feet-corner-jig-x1.stl

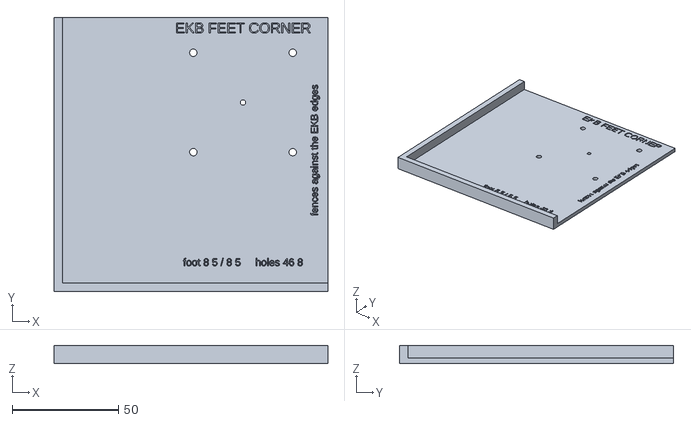
[picture p81: CAD file, 2026-10-23]
parts/tools/feet-corner-jig-x1.stl
129.0 x 129.0 x 8.50
