scotthowson/desk-setup/components/skadis/skadis-headset-hook-x1.stl

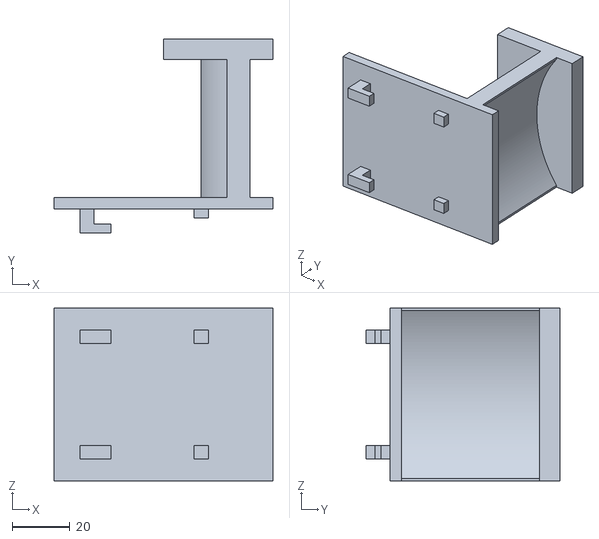
[picture p82: CAD file, 2026-10-30]
components/skadis/skadis-headset-hook-x1.stl
76.0 x 67.2 x 60.0
