scotthowson/desk-setup/components/underware/tile-8x4-lite-x11.stl

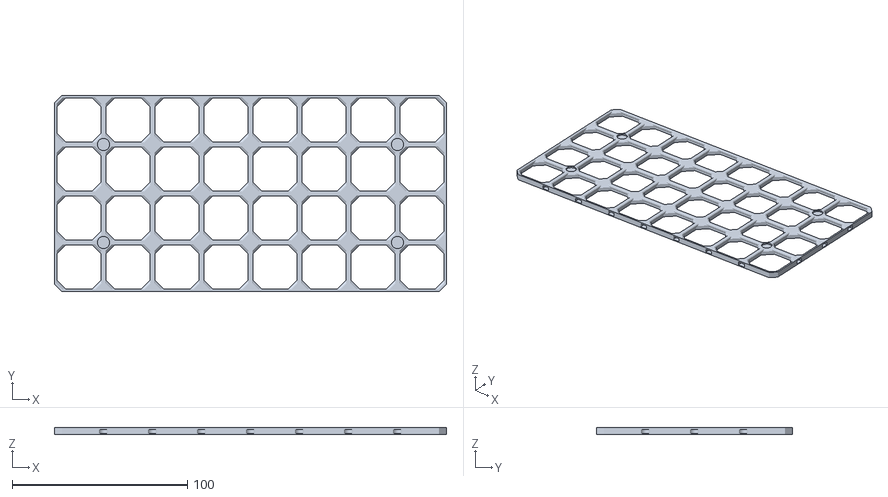
[picture p83: CAD file, 2026-10-26]
components/underware/tile-8x4-lite-x11.stl
224.0 x 112.0 x 4.00
