scotthowson/desk-setup/parts/accessories/alex-foot-60-x8.stl

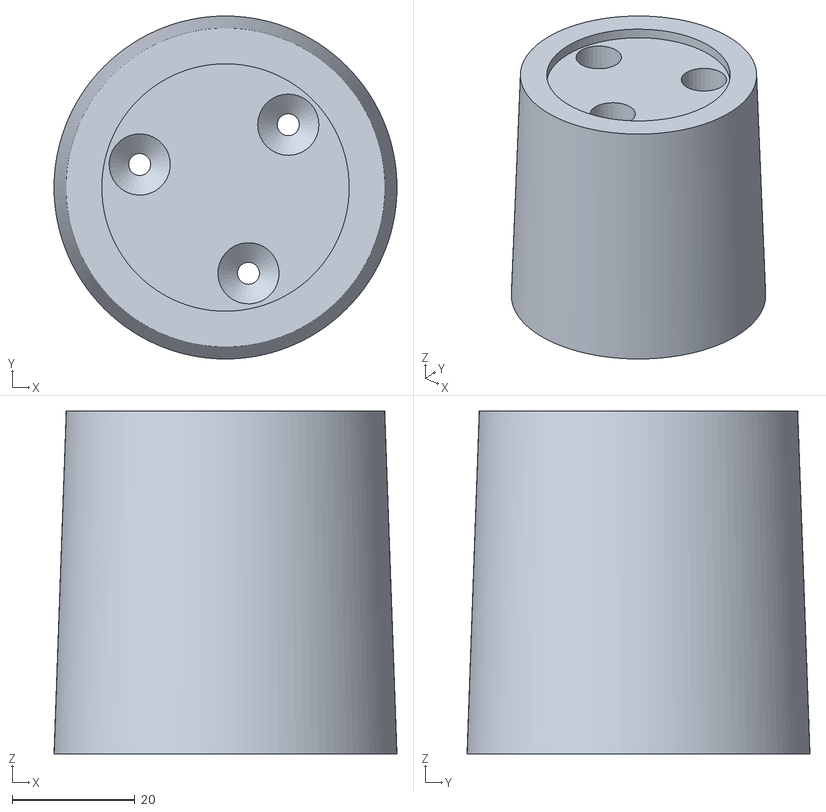
[picture p84: CAD file, 2026-10-23]
parts/accessories/alex-foot-60-x8.stl
56.0 x 56.0 x 56.0
