scotthowson/desk-setup/parts/tools/fitting-centring-plug-x2.stl

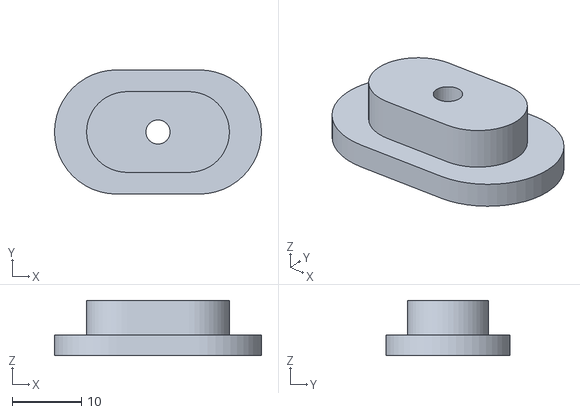
[picture p85: CAD file, 2026-10-23]
parts/tools/fitting-centring-plug-x2.stl
30.0 x 18.0 x 8.00
