scotthowson/desk-setup/components/skadis/rib-160-k2-x2.stl

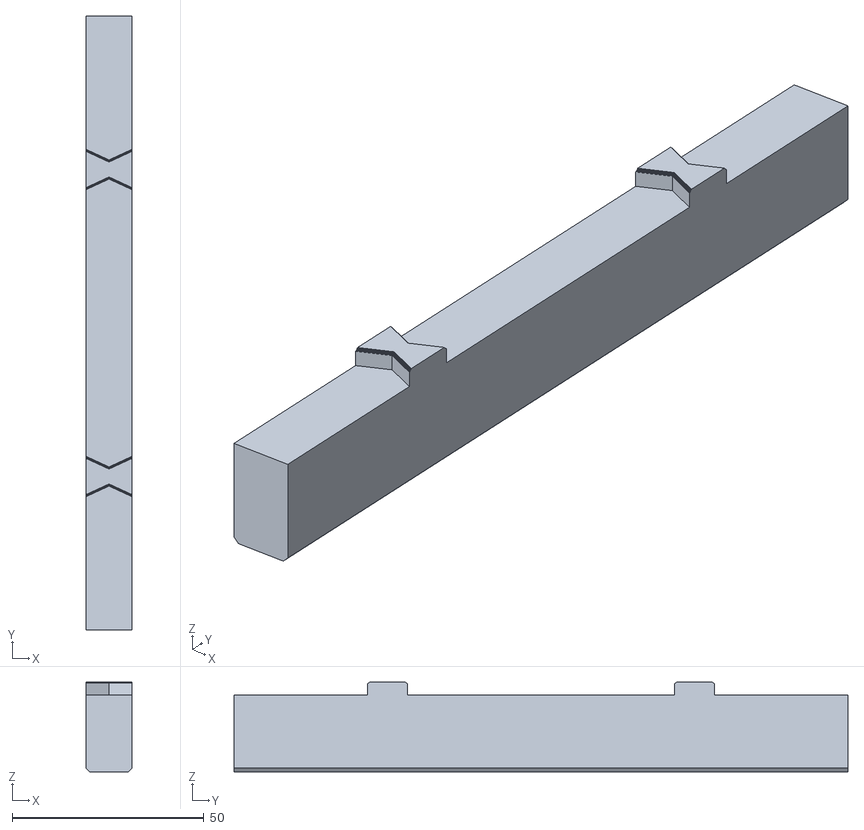
[picture p86: CAD file, 2026-10-30]
components/skadis/rib-160-k2-x2.stl
12.0 x 160.0 x 23.4
