scotthowson/desk-setup/components/underware/channel-I-3-x2.stl

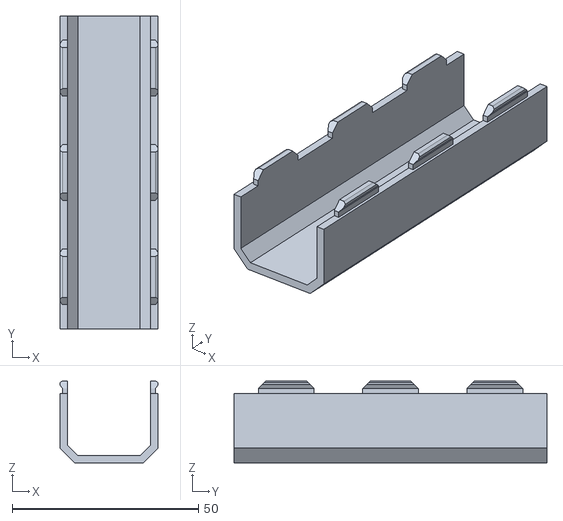
[picture p87: CAD file, 2026-10-26]
components/underware/channel-I-3-x2.stl
26.4 x 84.0 x 22.0
