scotthowson/desk-setup/parts/accessories/alex-foot-20-x8.stl

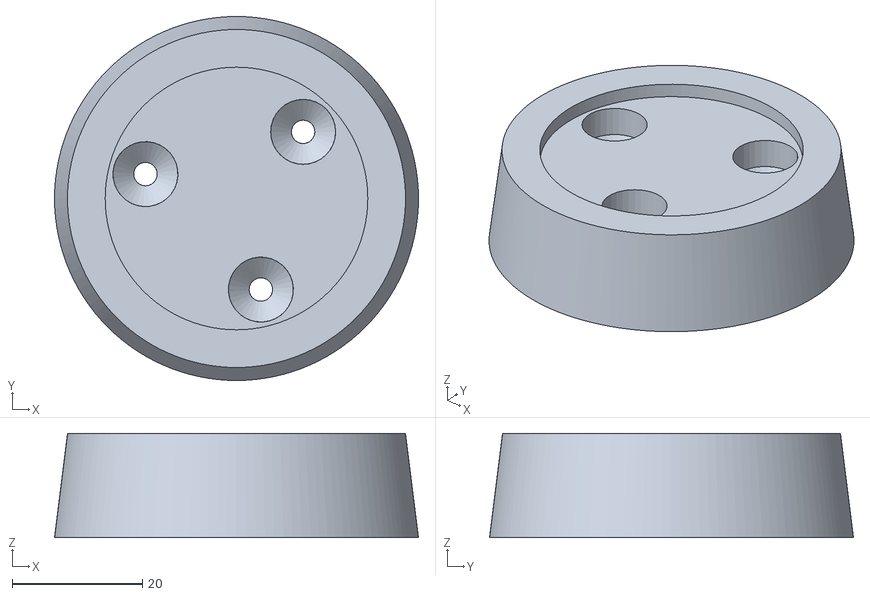
[picture p88: CAD file, 2026-10-23]
parts/accessories/alex-foot-20-x8.stl
56.0 x 56.0 x 16.0
