scotthowson/desk-setup/parts/tools/leg-jig-x1.stl

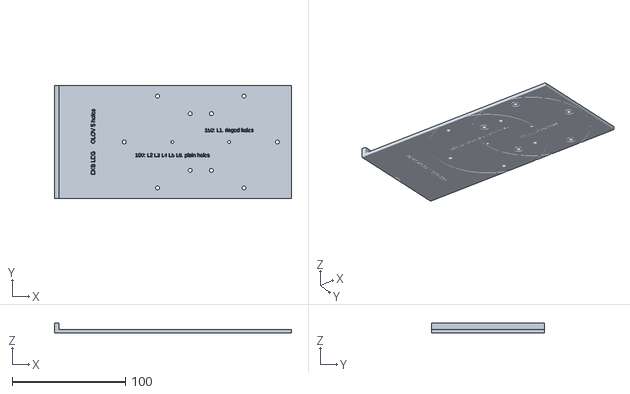
[picture p89: CAD file, 2026-10-23]
parts/tools/leg-jig-x1.stl
209.0 x 100.0 x 9.00
