scotthowson/desk-setup/components/skadis/skadis-cross-x4.stl

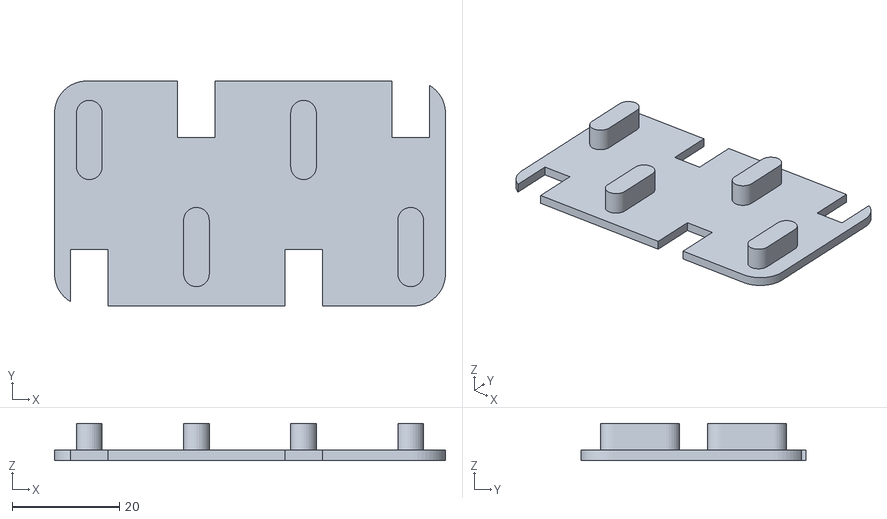
[picture p90: CAD file, 2026-10-30]
components/skadis/skadis-cross-x4.stl
73.0 x 42.0 x 7.00
