scotthowson/desk-setup/parts/accessories/alex-foot-40-x8.stl

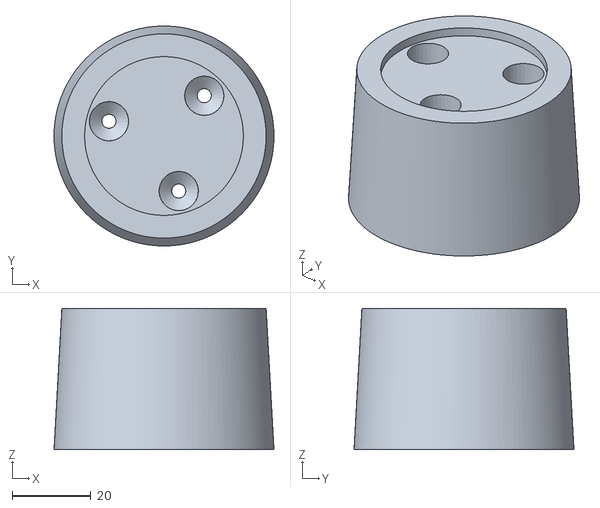
[picture p91: CAD file, 2026-10-23]
parts/accessories/alex-foot-40-x8.stl
56.0 x 56.0 x 36.0
