scotthowson/desk-setup/parts/tools/wall-gauge-x1.stl

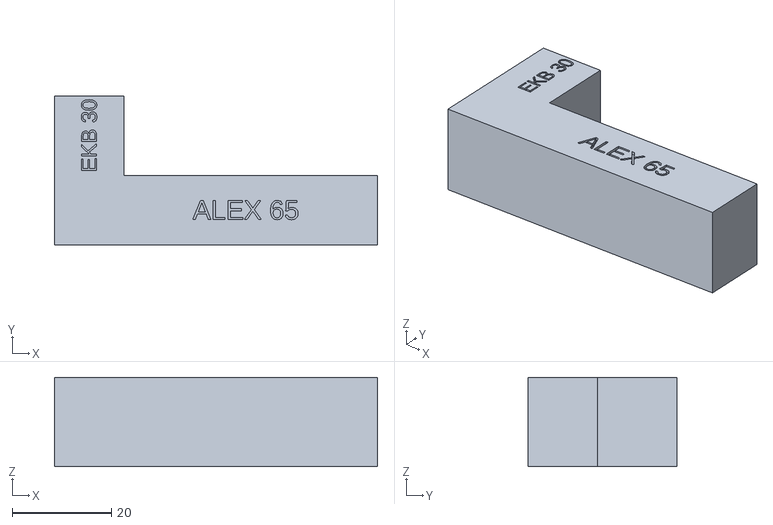
[picture p92: CAD file, 2026-10-23]
parts/tools/wall-gauge-x1.stl
65.0 x 30.0 x 18.0
