scotthowson/desk-setup/components/skadis/skadis-phone-dock-x1.stl

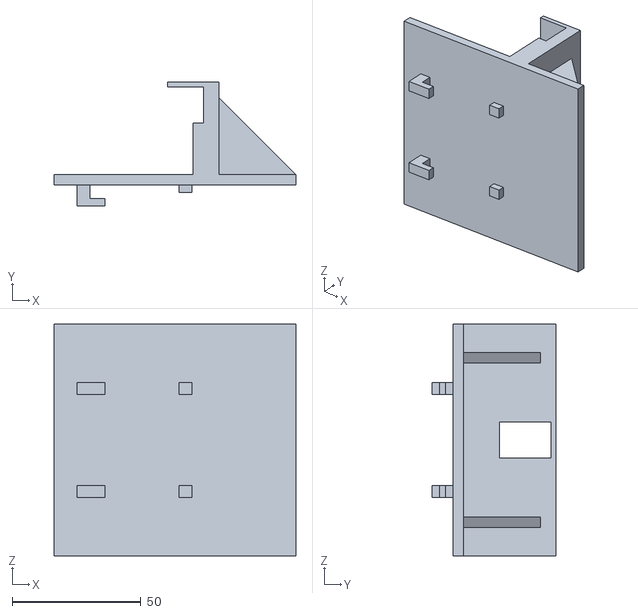
[picture p93: CAD file, 2026-10-30]
components/skadis/skadis-phone-dock-x1.stl
94.0 x 48.2 x 90.0
