scotthowson/desk-setup/parts/accessories/alex-foot-pad-x8.stl

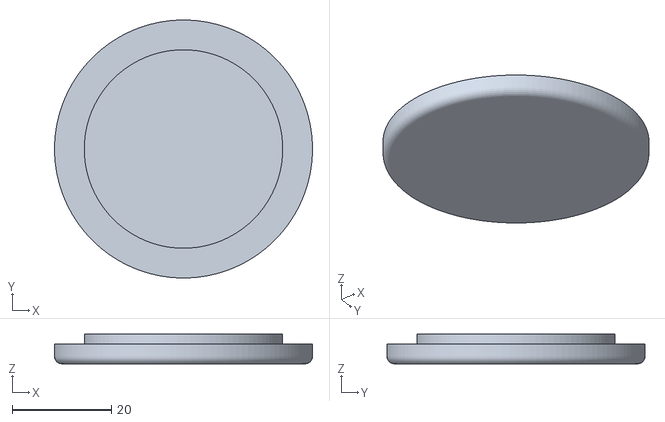
[picture p94: CAD file, 2026-10-22]
parts/accessories/alex-foot-pad-x8.stl
52.0 x 52.0 x 6.00
