scotthowson/desk-setup/parts/tools/foot-height-gauge-x1.stl

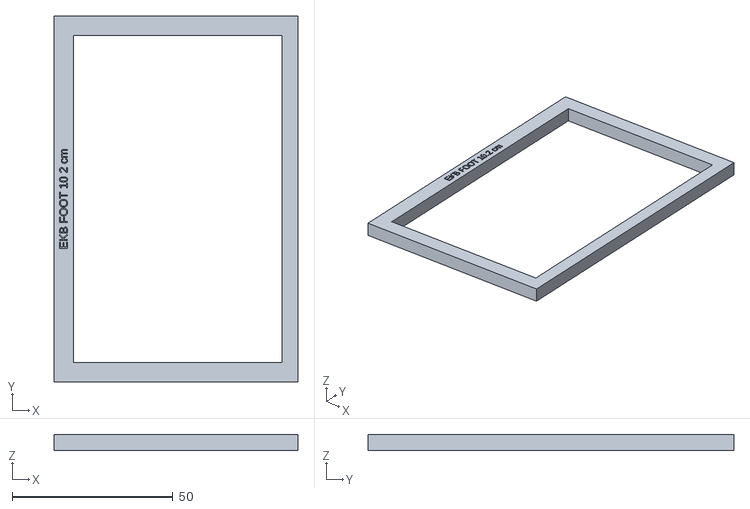
[picture p95: CAD file, 2026-10-23]
parts/tools/foot-height-gauge-x1.stl
76.0 x 114.0 x 5.00
