scotthowson/desk-setup/parts/accessories/wall-gap-strip-80-x2.stl

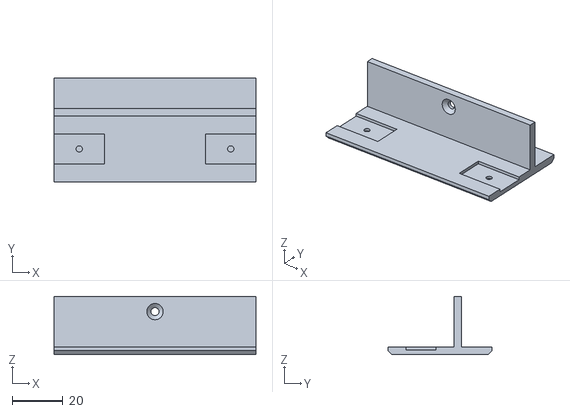
[picture p96: CAD file, 2026-10-22]
parts/accessories/wall-gap-strip-80-x2.stl
80.0 x 41.0 x 23.0
