scotthowson/desk-setup/parts/tools/rail-marking-gauge-x1.stl

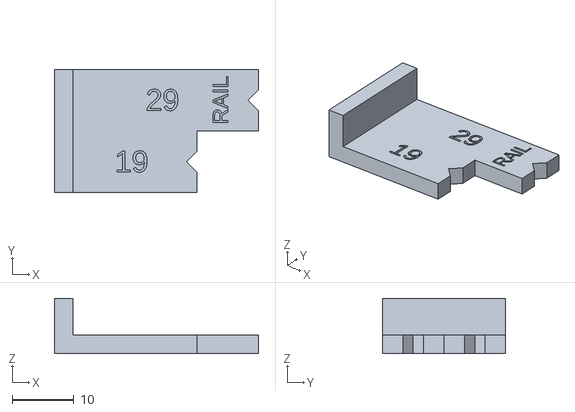
[picture p97: CAD file, 2026-10-23]
parts/tools/rail-marking-gauge-x1.stl
33.1 x 20.0 x 9.00
