scotthowson/desk-setup/components/skadis/skadis-wall-standoff-x2.stl

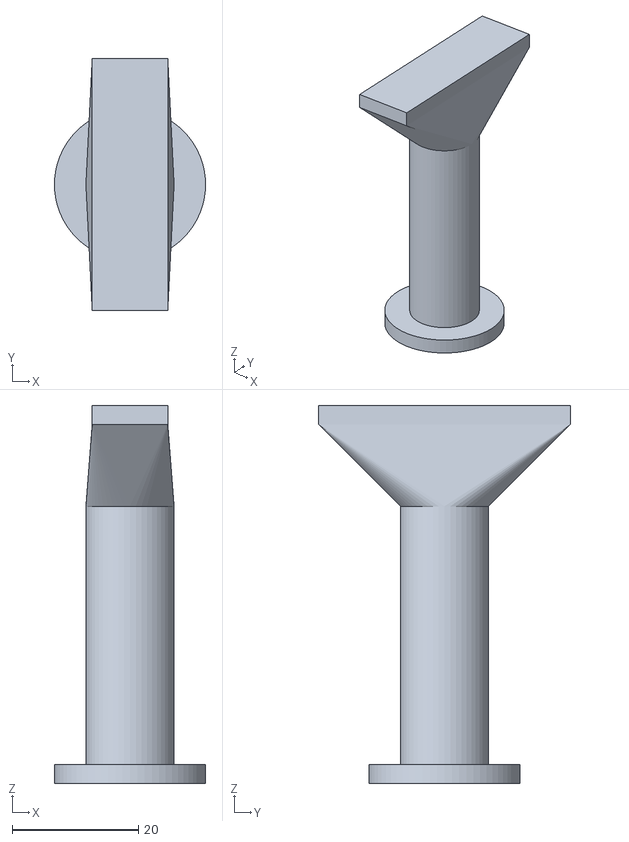
[picture p98: CAD file, 2026-10-30]
components/skadis/skadis-wall-standoff-x2.stl
24.0 x 40.0 x 60.0
