scotthowson/desk-setup/parts/accessories/wall-gap-corner-x1.stl

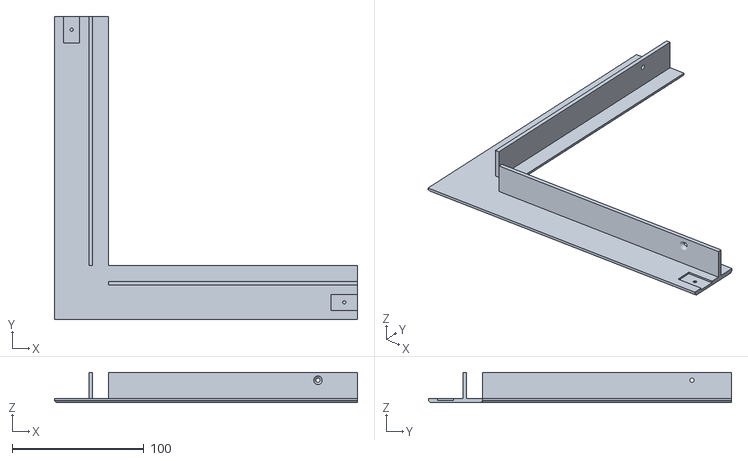
[picture p99: CAD file, 2026-10-22]
parts/accessories/wall-gap-corner-x1.stl
230.0 x 230.0 x 23.0
