scotthowson/desk-setup/components/skadis/skadis-cable-comb-x1.stl

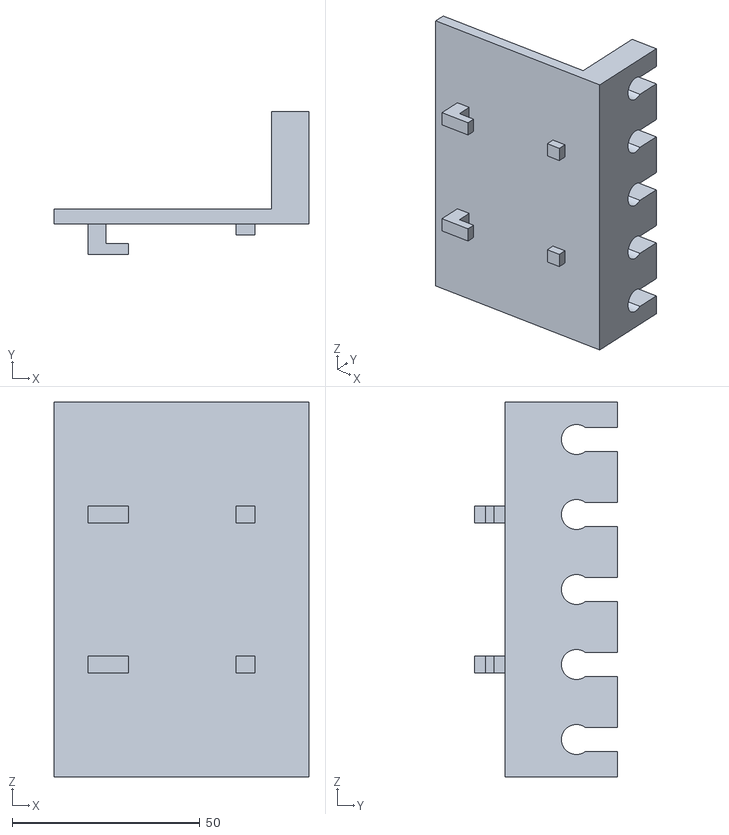
[picture p100: CAD file, 2026-10-30]
components/skadis/skadis-cable-comb-x1.stl
68.0 x 38.2 x 100.0
