scotthowson/desk-setup/parts/accessories/wall-gap-strip-clamp-x2.stl

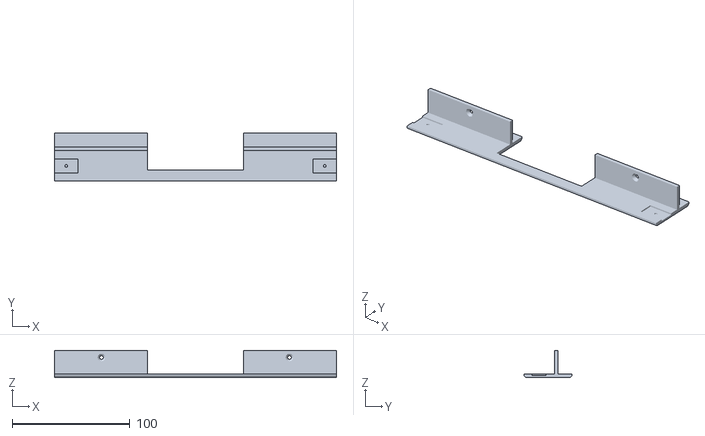
[picture p101: CAD file, 2026-10-22]
parts/accessories/wall-gap-strip-clamp-x2.stl
240.0 x 41.0 x 23.0
