scotthowson/desk-setup/components/skadis/rib-80-k1-x2.stl

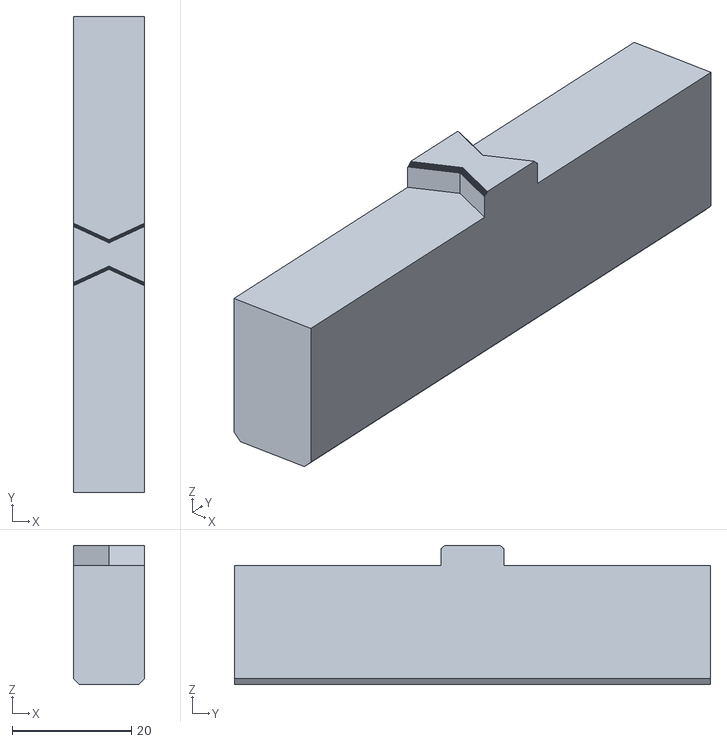
[picture p102: CAD file, 2026-10-30]
components/skadis/rib-80-k1-x2.stl
12.0 x 80.0 x 23.4
