scotthowson/desk-setup/parts/accessories/wall-gap-strip-x15.stl

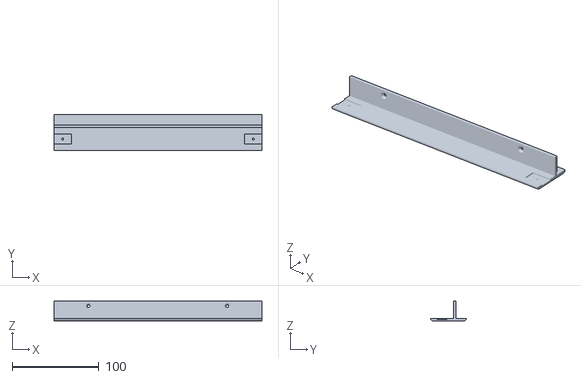
[picture p103: CAD file, 2026-10-22]
parts/accessories/wall-gap-strip-x15.stl
240.0 x 41.0 x 23.0
