scotthowson/desk-setup/components/skadis/skadis-cable-clip-x6.stl

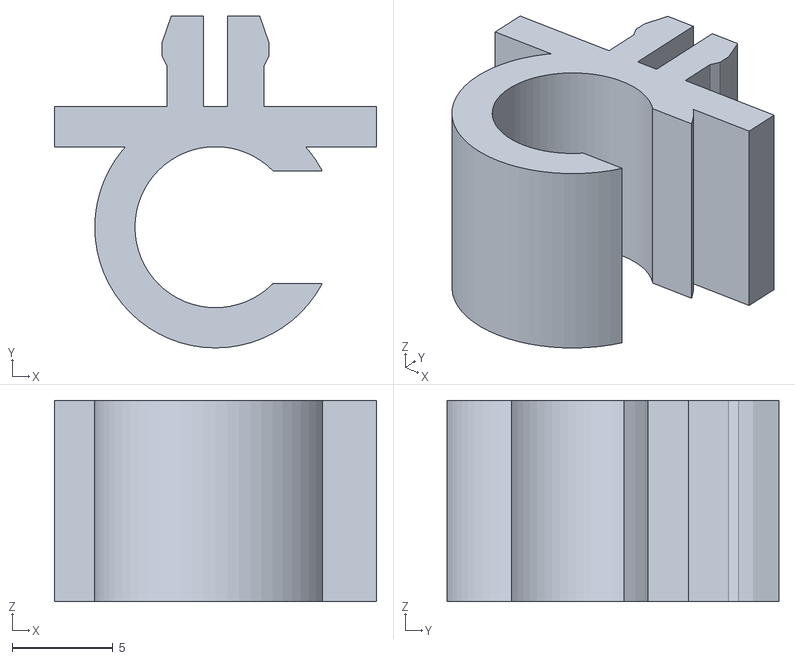
[picture p104: CAD file, 2026-10-29]
components/skadis/skadis-cable-clip-x6.stl
16.0 x 16.5 x 10.0
