scotthowson/desk-setup/parts/accessories/wall-gap-strip-slot-x3.stl

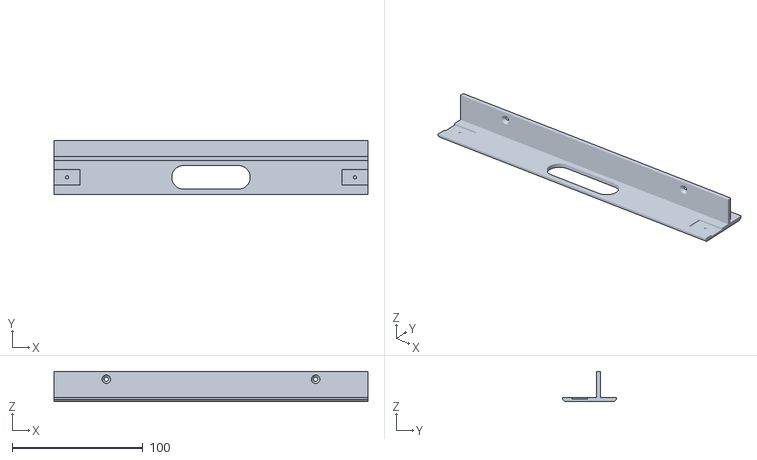
[picture p105: CAD file, 2026-10-22]
parts/accessories/wall-gap-strip-slot-x3.stl
240.0 x 41.0 x 23.0
