scotthowson/desk-setup/components/skadis/skadis-hook-x4.stl

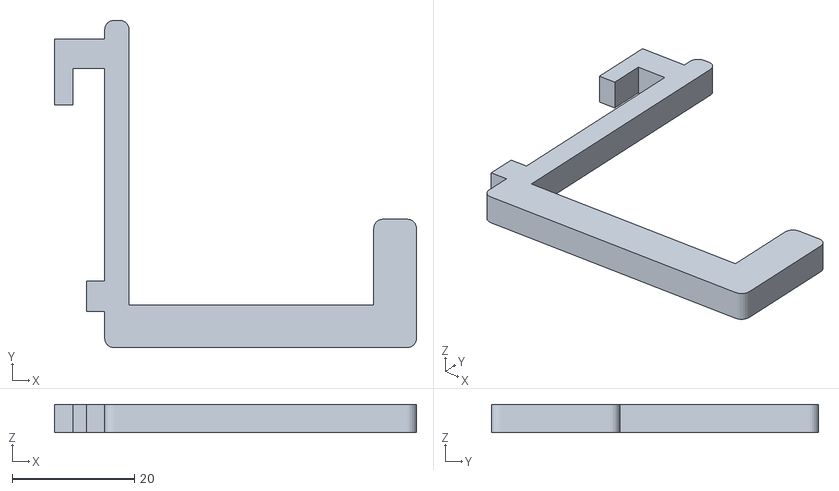
[picture p106: CAD file, 2026-10-29]
components/skadis/skadis-hook-x4.stl
59.2 x 53.5 x 4.60
