scotthowson/desk-setup/parts/accessories/wall-gap-connector-x26.stl

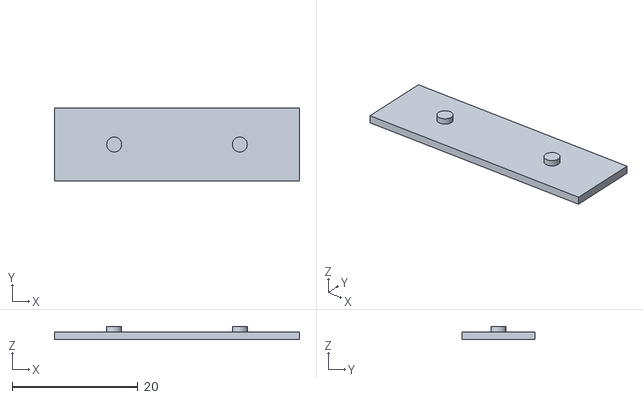
[picture p107: CAD file, 2026-10-22]
parts/accessories/wall-gap-connector-x26.stl
39.0 x 11.6 x 2.10
