scotthowson/desk-setup/components/skadis/skadis-6x6-x4.3mf

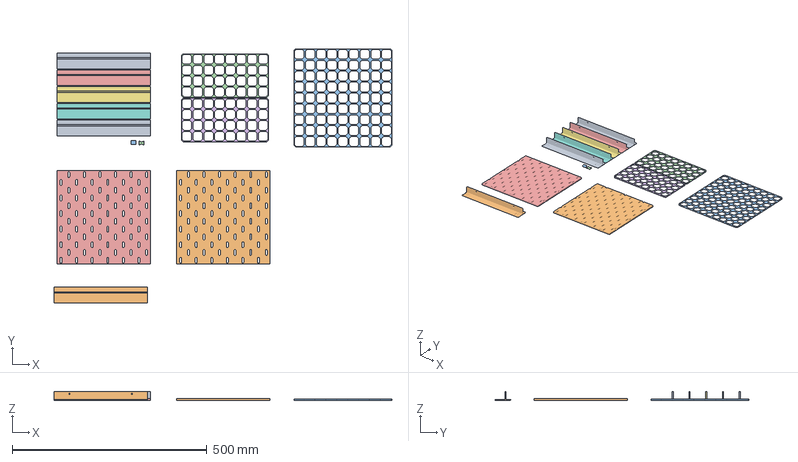
[picture p108: CAD file, 2026-10-29]
components/skadis/skadis-6x6-x4.3mf
868.0 x 653.2 x 23.0 mm
wall-gap-strip-x15.stl x 6
skadis-C-x1.stl
tile-9x9-lite.stl
tile-8x4-lite-x11.stl x 2
skadis-key-x24.stl x 2
skadis-T-x1.stl
