scotthowson/desk-setup/parts/accessories/phone-stand-x1.stl

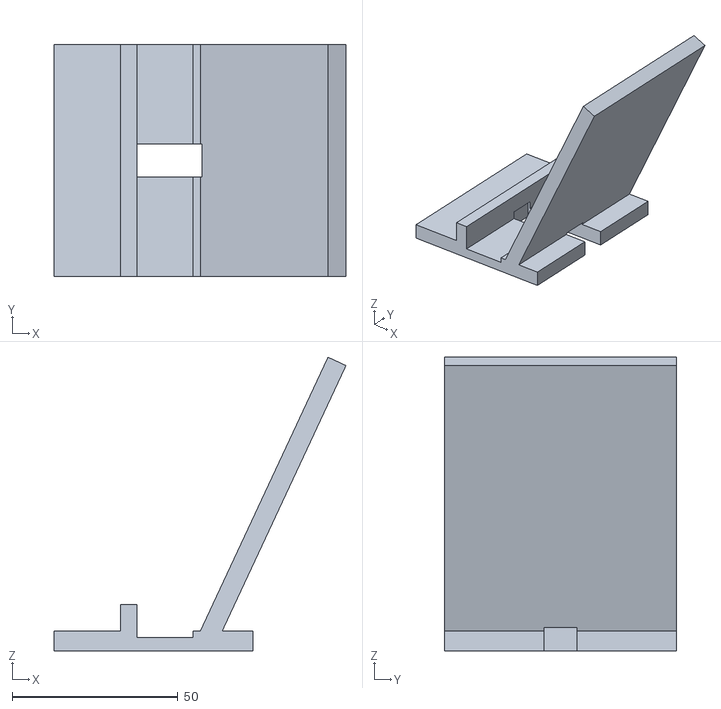
[picture p109: CAD file, 2026-10-21]
parts/accessories/phone-stand-x1.stl
88.1 x 70.0 x 88.6
