scotthowson/desk-setup/components/skadis/skadis-key-x24.stl

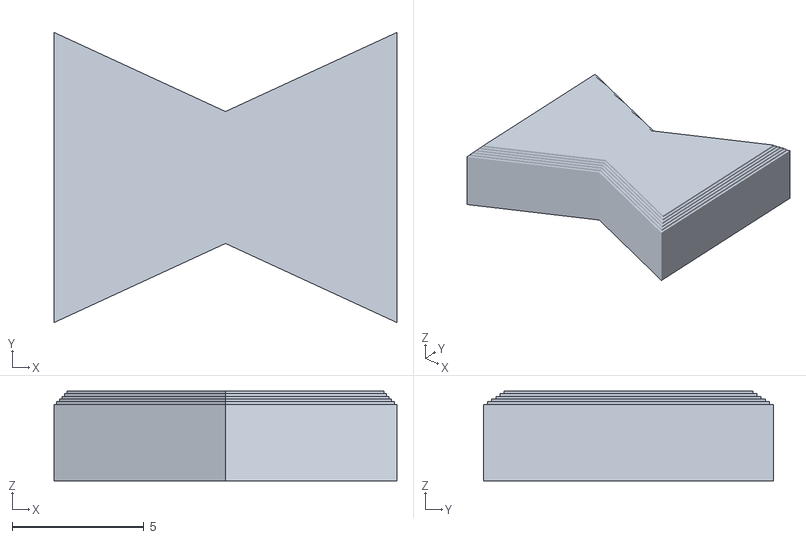
[picture p110: CAD file, 2026-10-28]
components/skadis/skadis-key-x24.stl
13.0 x 11.0 x 3.41
