scotthowson/desk-setup/components/skadis/skadis-B-x1.stl

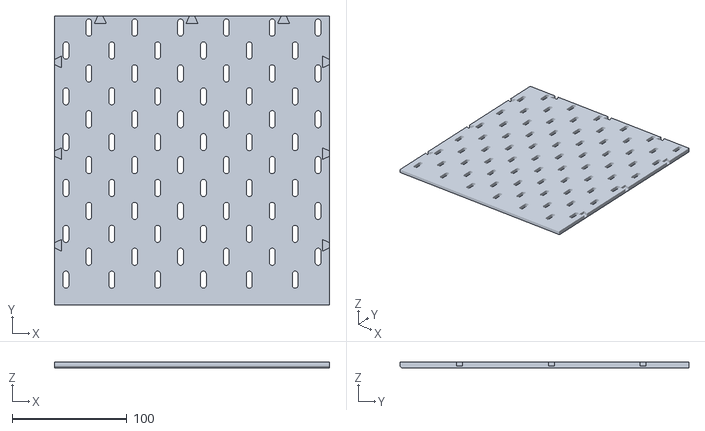
[picture p111: CAD file, 2026-10-28]
components/skadis/skadis-B-x1.stl
240.0 x 252.0 x 5.00
