scotthowson/desk-setup/components/skadis/skadis-TR-x1.stl

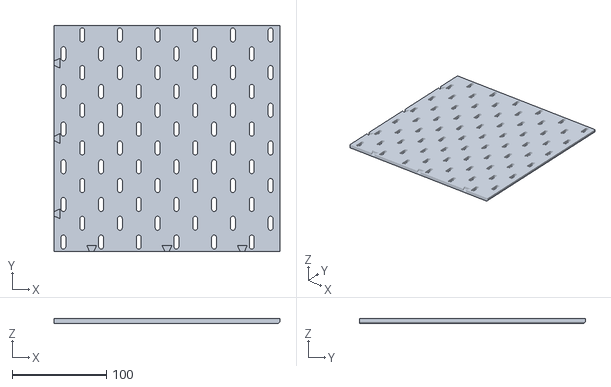
[picture p112: CAD file, 2026-10-28]
components/skadis/skadis-TR-x1.stl
240.0 x 240.0 x 5.00
