scotthowson/desk-setup/components/skadis/skadis-key.scad

// Bow-tie key for the SKÅDIS tiles (skadis-tile.scad): one per pocket pair, three per
// joint. 13 x 11 x 3.4 mm, dovetail waist 5 mm. Push it into the back of the joint with a
// thumb until the pocket's lip clicks over it; the chamfer on its top edge cams it past
// the lip. Print flat, as saved, PETG, same profile as the tiles. Print spares: 0.7 g each.

key_len = 13; key_neck = 5; key_tip = 11; key_depth = 3.5; cham = 0.5;
h = key_depth - 0.1;
key_poly = [[-key_len / 2, -key_tip / 2], [-key_len / 2, key_tip / 2], [0, key_neck / 2], [key_len / 2, key_tip / 2], [key_len / 2, -key_tip / 2], [0, -key_neck / 2]];
linear_extrude(h - cham) polygon(key_poly);
steps = 5;   // the chamfer as shrinking slices, so the waist is kept (a hull would fill it)
for (i = [0 : steps - 1]) translate([0, 0, h - cham + i * cham / steps]) linear_extrude(cham / steps + 0.01) offset(delta = -cham * (i + 1) / steps) polygon(key_poly);
