scotthowson/desk-setup/parts/structure/rail-end-cap.scad

// End cap for the 2 x 2 x 3/16 in angle rails. Slips onto a cut end so nothing sharp faces
// the wall gap or the cabinet. The flat leg of the angle is flush against the underside of
// the top, so the cap has NO wall on that face: it covers the end, the underside and free
// edge of the flat leg, and both faces and the bottom edge of the vertical leg.
// Three rail ends take a cap (rail B's corner end is bolted to rail A and takes none), and
// an L-section end is HANDED: the two ends of one rail need mirror-image caps. Render both:
//   openscad -D hand=1 -o rail-end-cap-A-x1.stl rail-end-cap.scad    (rail A's far end: print 1)
//   openscad -D hand=-1 -o rail-end-cap-B-x2.stl rail-end-cap.scad   (rail A's wall end and rail B's far end, which is the mirror of A's far end about the desk's diagonal: print 2)
// A cap that does not go on is the other hand. Print with the closed end down. PETG or ABS;
// a dab of hot glue if it is loose.

hand  = 1;
leg   = 50.8;
t     = 4.8;
slack = 0.3;   // per side
wall  = 2;
depth = 15;

// The angle seen end-on: flat leg along the top (its top face is y = leg, against the desk),
// vertical leg down the left side (x 0..t).
module L2d(l, th) { polygon([[0, 0], [th, 0], [th, l - th], [l, l - th], [l, l], [0, l]]); }

mirror([hand < 0 ? 1 : 0, 0, 0]) difference() {
    linear_extrude(depth + wall) offset(r = wall) L2d(leg + 2 * slack, t + 2 * slack);
    translate([0, 0, wall]) linear_extrude(depth + 1) L2d(leg + 2 * slack, t + 2 * slack);   // the socket
    translate([-wall - 1, leg + 2 * slack, -1]) cube([leg + 2 * wall + 4, wall + 2, depth + wall + 2]);   // open on the desk-side face
    mirror([hand < 0 ? 1 : 0, 0, 0]) translate([(t + 2 * slack) / 2, (leg + 2 * slack) / 2, -0.01]) mirror([1, 0, 0]) rotate([0, 0, 90]) linear_extrude(0.6) text(hand > 0 ? "RAIL CAP A" : "RAIL CAP B", size = 3.2, halign = "center", valign = "center");   // on the closed end, reads correctly from outside for both hands
}
