scotthowson/desk-setup/(list of files, cad)

Other CAD files:
components/skadis/rib-240-k1-x6.stl
components/skadis/skadis-TL-x1.stl
components/skadis/skadis-L1-x1.stl
components/skadis/skadis-M1-x1.stl
components/skadis/skadis-L-x1.stl
components/skadis/skadis-R1-x1.stl
components/skadis/skadis-BR-x1.stl
components/skadis/skadis-BL-x1.stl
components/skadis/skadis-R-x1.stl
components/skadis/skadis-T-x1.stl
components/skadis/skadis-C-x1.stl
parts/tools/rail-drill-jig.scad
components/underware/monokini_I_channel.scad
components/underware/monokini_L_channel.scad
components/underware/monokini_S_channel.scad
components/underware/monokini_T_channel.scad
components/underware/monokini_X_channel.scad
components/underware/openGrid.scad
parts/tools/rail-bolt-jig-x1.stl
