scotthowson/desk-setup/manual/IKEA-Style-Assembly-Manual.pdf

# L-Shaped Corner Desk

### Assembly manual

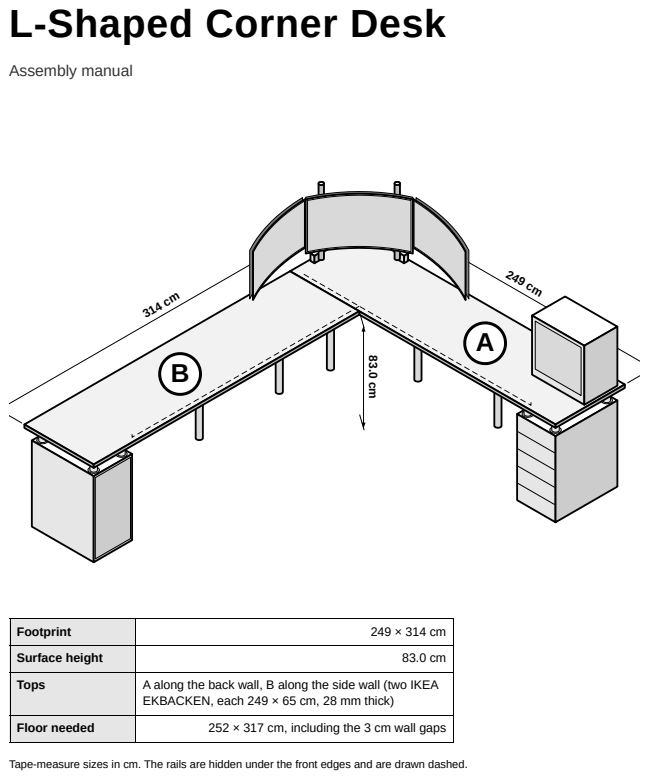
[picture p113: page 1]

Footprint | 249 × 314 cm

Surface height | 83.0 cm

Tops | A along the back wall, B along the side wall (two IKEA EKBACKEN, each 249 × 65 cm, 28 mm thick)

Floor needed | 252 × 317 cm, including the 3 cm wall gaps

Tape-measure sizes in cm. The rails are hidden under the front edges and are drawn dashed.

# Contents

A · Finished assembly | 3
B · Before you begin | 5
B · Printed tools: how each one is used | 8
C · Complete parts inventory | 14
D · Component preparation | 17
E · Steel rail fabrication and drilling | 27
F · Legs, feet, rails and cabinets | 37
G · Standing the tops and fitting the rings | 48
H · The joint | 52
I · Monitor mount and accessories | 59
J · Wall-gap trim (optional) | 64
K · Final inspection and load testing | 68
L · Maintenance and troubleshooting | 74
Appendix · Outstanding measurements | 76

L-Shaped Corner Desk · Assembly Manual

L-Shaped Corner Desk · Assembly Manual | 2

# A · Finished assembly

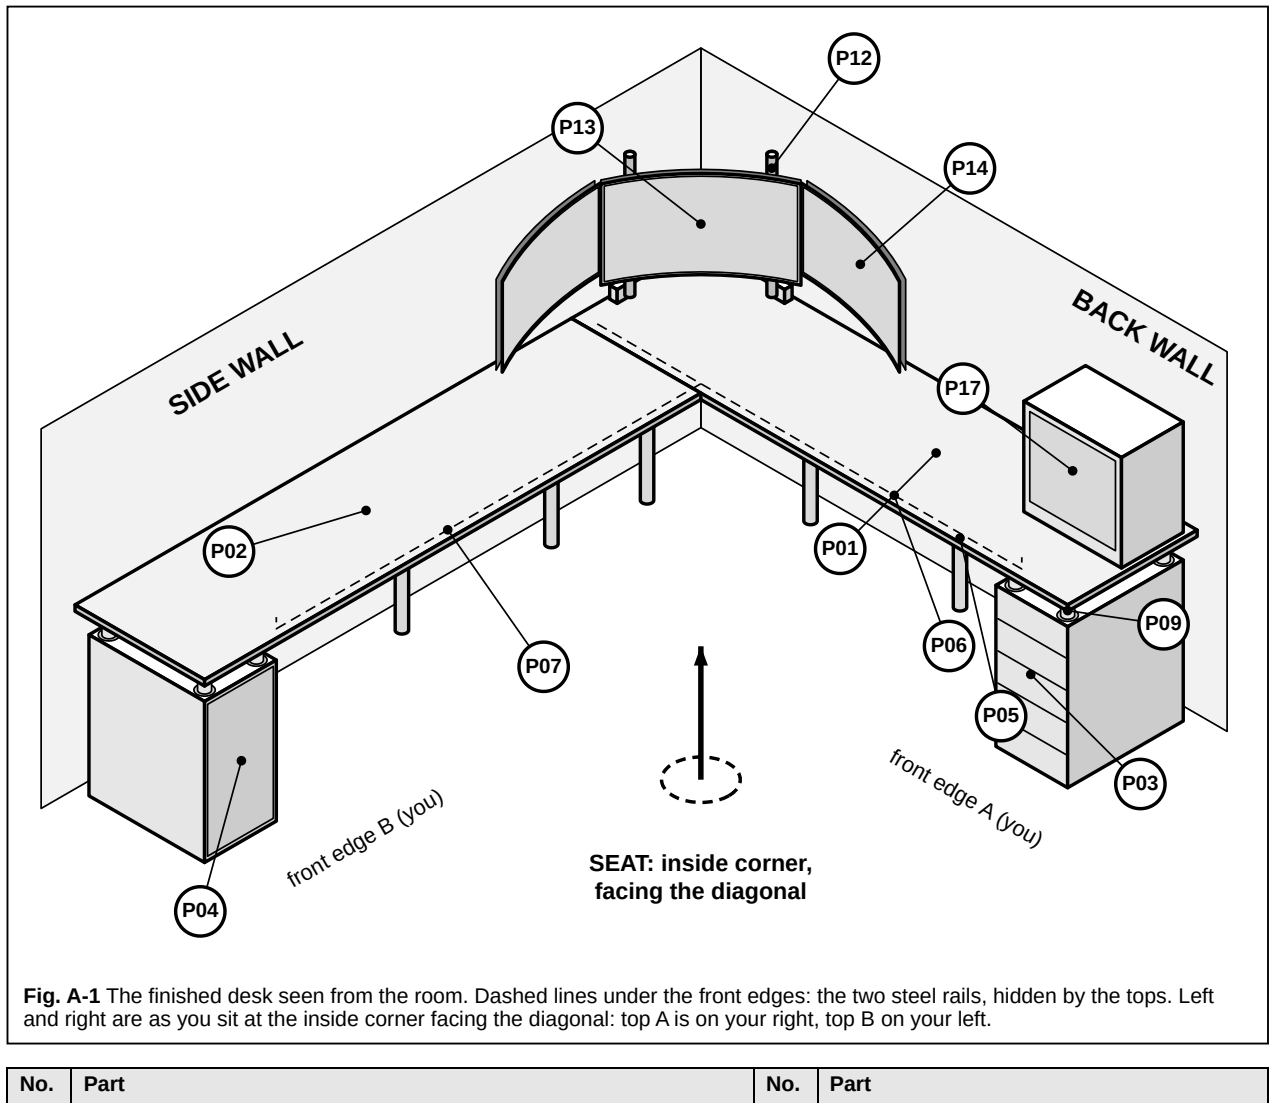
[picture p114: figure]
BACK WALL; SIDE WALL; SEAT: inside corner, facing the diagonal; front edge A (you); front edge B (you); Part

Fig. A-1 The finished desk seen from the room. Dashed lines under the front edges: the two steel rails, hidden by the tops. Left and right are as you sit at the inside corner facing the diagonal: top A is on your right, top B on your left.

P01 | Top A, EKBACKEN 249 × 65 cm, 28 mm thick | P07 | Rail B, steel angle 213 cm
P02 | Top B, EKBACKEN 249 × 65 cm, 28 mm thick | P09 | Round adjustable foot 4 in x 8
P03 | ALEX 1, drawer unit 36 × 58 × 70 cm | P12 | VIVO STAND-V300CU
P04 | ALEX 2, storage unit with door 36 × 58 × 70 cm | P13 | Samsung Odyssey G5 32 in
P05 | OLOV leg x 6, 105 mm plate | P14 | Acer XZ320QU x 2
P06 | Rail A, steel angle 213 cm | P17 | HYTE Y60 on printed pedestal

What this desk is
Two IKEA kitchen tops make an L. Top A lies along the back wall and keeps the corner square; top B lies along the side wall and its end butts against top A's front edge. Each top stands 3 cm off its wall, with its square, unfinished long edge toward the wall. The far end of each top rests on an ALEX cabinet through four adjustable feet: the feet are screwed to the top, and their pads drop into printed rings on the cabinet, so the desk cannot slide on the cabinets and the two heavy boxes hold the whole frame square. Six OLOV legs stand along the two wall edges, none at the front, so the space under the inside corner is open for your knees.

That leaves the two front edges with nothing under them for more than two metres, so each one is carried by a steel angle rail screwed to the underside 12 cm back from the front edge. Under the inside corner the two rails are bolted together with two gusseted steel fittings, so the corner of top B hangs from rail A. The rails never touch a cabinet: their ends load the top, and the top loads the nearest feet. The monitor stand clamps to top A's two wall edges, 40 cm from the corner; the surface is 83.0 cm above the floor.

L-Shaped Corner Desk · Assembly Manual | A · Finished assembly
L-Shaped Corner Desk · Assembly Manual | Page 3

# A · Plan of the finished desk

A

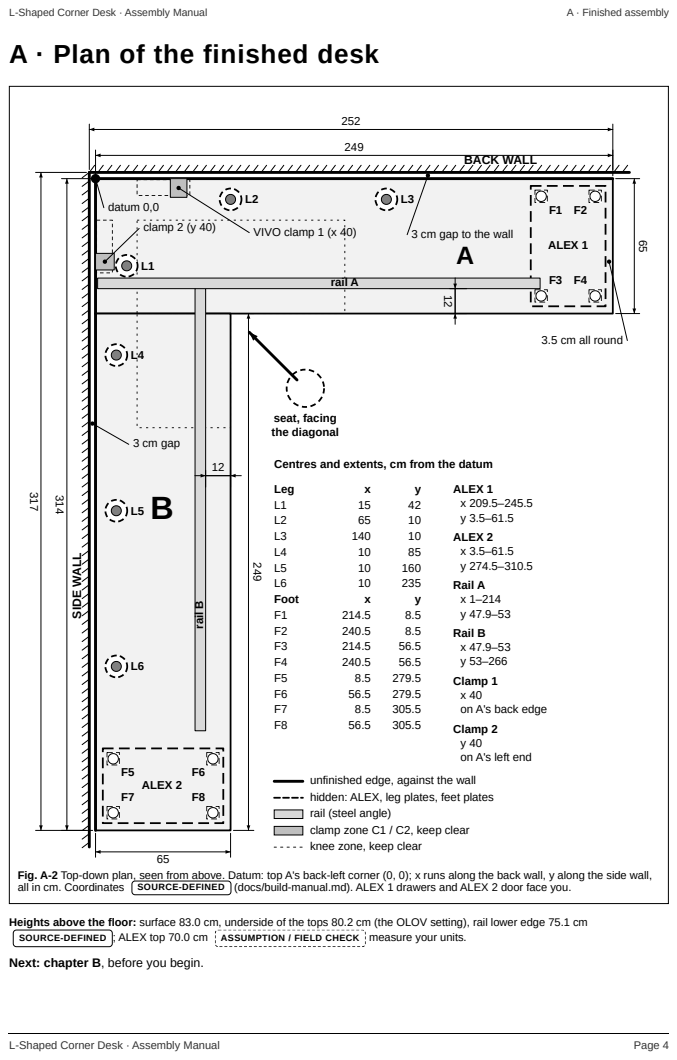
[picture p115: page 4]
BACK WALL; SID; ALEX 1; ALEX 2; rail A; rail B; VIVO clamp 1 (x 40); clamp 2 (y 40); datum 0,0; seat, facing the diagonal; 3 cm gap; Leg; Foot; ALEX 1 x 209.5–245.5 y 3.5–61.5 ALEX 2 x 3.5–61.5 y 274.5–310.5 Rail A x 1–214 y 47.9–53 Rail B x 47.9–53 y 53–266 Clamp 1 x 40 on A's back edge Clamp 2 y 40 on A's left end; L-Shaped Corner Desk · Assembly Manual; A · Finished assembly

3 cm gap to the wall

3.5 cm all round

Centres and extents, cm from the datum

unfinished edge, against the wall
hidden: ALEX, leg plates, feet plates
rail (steel angle)
clamp zone C1 / C2, keep clear
knee zone, keep clear

Fig. A-2 Top-down plan, seen from above. Datum: top A's back-left corner (0, 0); x runs along the back wall, y along the side wall,
all in cm. Coordinates SOURCE-DEFINED (docs/build-manual.md). ALEX 1 drawers and ALEX 2 door face you.

Heights above the floor: surface 83.0 cm, underside of the tops 80.2 cm (the OLOV setting), rail lower edge 75.1 cm
SOURCE-DEFINED ; ALEX top 70.0 cm ASSUMPTION / FIELD CHECK measure your units.
Next: chapter B, before you begin.

# B · Before you begin

Read this chapter once before you pick up a drill. Budget a weekend: the steel on day one, the assembly on day two.

## Safety

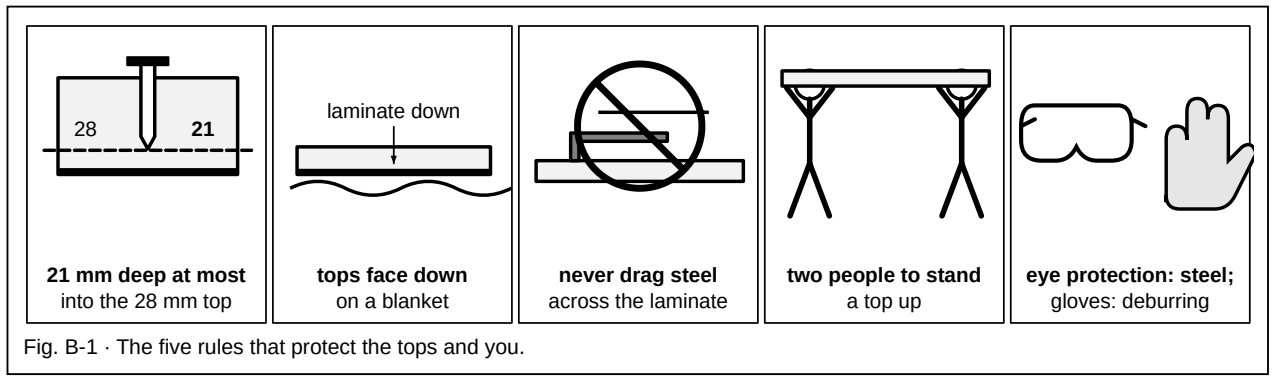
[picture p116: figure]
21 mm deep at most into the 28 mm top; tops face down on a blanket; never drag steel across the laminate; two people to stand a top up; eye protection: steel; gloves: deburring; laminate down

Fig. B-1 · The five rules that protect the tops and you.

!

NEVER A FASTENER DEEPER THAN 21 MM INTO A TOP
The EKBACKEN tops are 28 mm particleboard with a thin laminate skin. A screw or pilot that reaches the skin lifts it into a bump you will see and feel for ever. Every screw in this manual leaves at least 7 mm of wood under the laminate. 28 mm expected. If a top measures 27 mm, nothing changes: the deepest screw still stops 6 mm short of the laminate. Under 27 mm, stop and ask. If you ever substitute a screw, keep this rule. Chapter D shows every depth.

Laminate protection. Spread a blanket on the floor first. The tops lie face down on it, laminate on the blanket, for every marking and drilling step. Never slide or drag steel (rails, fittings, the clamp plates) across the laminate: lift it on and off.
Eye protection for every hole drilled in steel; drill at low speed with cutting oil. Gloves while you deburr and file the steel: drilled edges are sharp.
Two people to turn a top over and stand it on its legs (249 cm long). A helper is also needed to slide the finished desk off and back to the walls.

## Work area

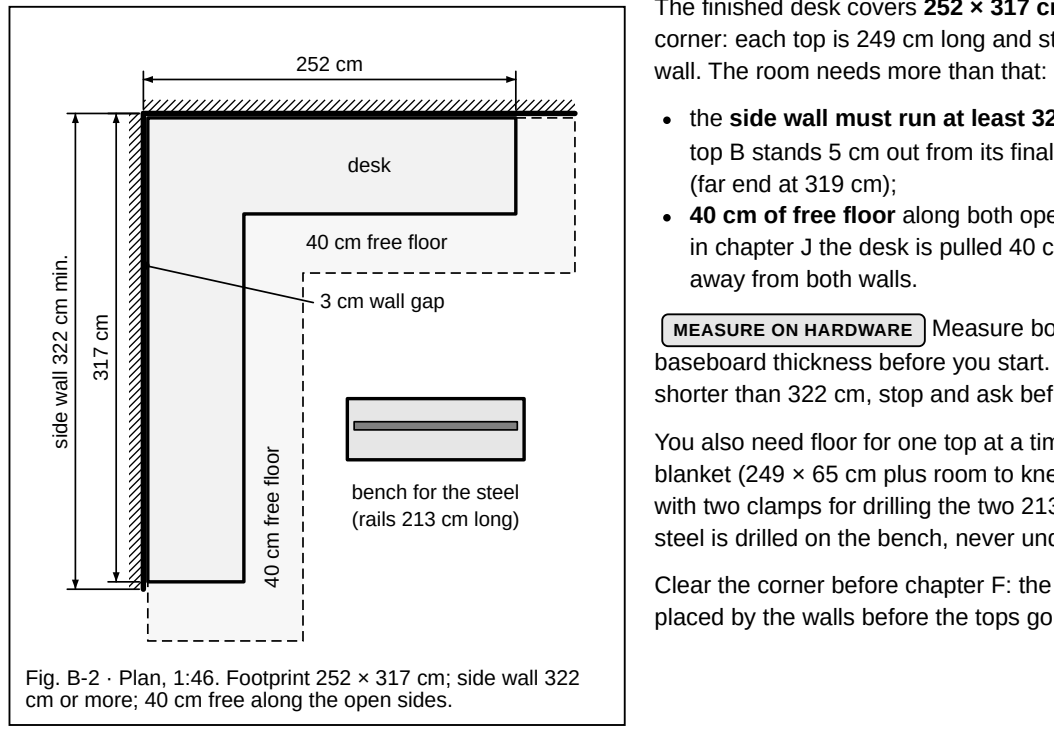
[picture p117: figure]
side wall 322 cm; min.; desk; 40 cm free floor; 3 cm wall gap; bench for the steel (rails 213 cm long); wall. The room needs more than that:; (far end at 319 cm);; away from both walls.

Fig. B-2 · Plan, 1:46. Footprint 252 × 317 cm; side wall 322 cm or more; 40 cm free along the open sides.

The finished desk covers 252 × 317 cm of floor in the corner: each top is 249 cm long and stands 3 cm off its

the side wall must run at least 322 cm: in chapter G top B stands 5 cm out from its final place for a moment

### 40 cm of free floor along both open sides of the desk:

in chapter J the desk is pulled 40 cm into the room,

MEASURE ON HARDWARE Measure both walls and the baseboard thickness before you start. If the side wall is shorter than 322 cm, stop and ask before chapter G.

You also need floor for one top at a time face down on the blanket (249 × 65 cm plus room to kneel), and a bench with two clamps for drilling the two 213 cm steel rails. All steel is drilled on the bench, never under the desk.

Clear the corner before chapter F: the ALEX units are placed by the walls before the tops go on.

L-Shaped Corner Desk · Assembly Manual | B · Before you begin

## Workshop tools

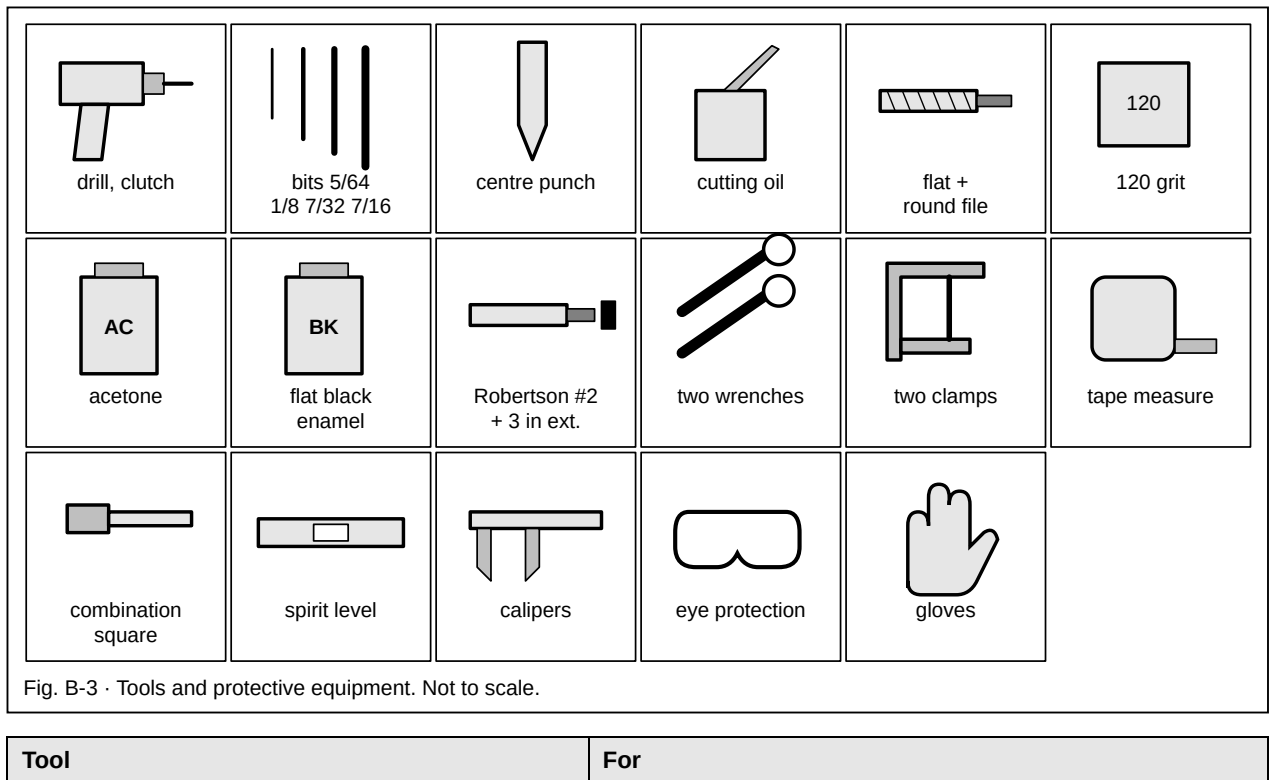
[picture p118: figure]
drill, clutch; bits 5/64; centre punch; cutting oil; flat +; round file; 120 grit; acetone; flat black enamel; Robertson #2 + 3 in ext.; two wrenches; two clamps; tape measure; combination square; spirit level; calipers; eye protection; gloves; Tool; For

Fig. B-3 · Tools and protective equipment. Not to scale.

Corded or 18 V drill, clutch set low | all holes and screws
Bits: 5/64, 1/8, 7/32 in HSS; 7/16 in cobalt | ring and trim pilots; top and steel pilots; rail screw holes; fitting bolt holes
Centre punch (or a nail) | only for a mark the jig or plug cannot reach
Cutting oil or 3-in-1 | every hole in steel
Flat file, round file, 120 grit, acetone, flat black enamel | deburr, ease a tight hole, scuff, degrease, paint the rails
Robertson #2 bit + 3 in magnetic extension | rail screws beside the vertical leg (the chuck would hit the leg otherwise)
Two wrenches or sockets for the 3/8-16 bolts (one for the head, one for the nut) | the corner fittings
Two clamps, 6 in or larger | hold each rail on its line; hold a fitting as a drilling template
Tape measure, combination square, masking tape, pencil | layout and the tape labels on the tops and rails
Spirit level, 60 cm or longer | setting the legs and feet
Calipers | top thickness, pad diameter, ALEX panel (the measurements on the last page of this chapter)

Protective equipment
Safety glasses or goggles: every hole in steel, and opening the 7/16 in holes. Work gloves: deburring, filing and handling the cut rail ends.
A blanket large enough for a whole top (249 × 65 cm).
L-Shaped Corner Desk · Assembly Manual | B · Before you begin

## Printed tools (P18): print these before you mark anything

All of them are in parts/tools/; parts/README.md has print settings. Print as saved, no supports. Never scale a printed tool in the slicer: its distances are the tool. The lipped and fenced tools print lip-up and are turned over to

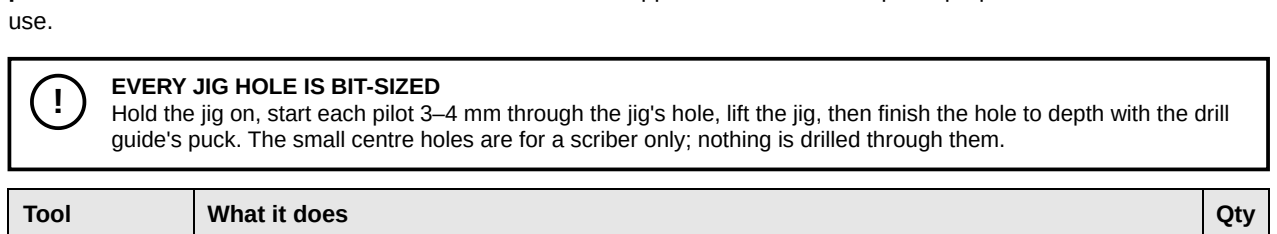
[picture p119: figure]
use.; EVERY JIG HOLE IS BIT-SIZED; Tool; What it does; Qty

Hold the jig on, start each pilot 3–4 mm through the jig's hole, lift the jig, then finish the hole to depth with the drill guide's puck. The small centre holes are for a scriber only; nothing is drilled through them.

| Edge T-square. Lip over any edge; holes named for their distance from the edge in mm: 50 (checks a ring centre 5 cm in on the ALEX), 85 (feet, 8.5 cm in, with the plate's four 1/8 in holes 46.8 mm apart round it), 100 (legs L2–L6, 10 cm in) and 150 (leg L1, 15 cm in). | 1
| Leg jig. Lip over the wall edge; an OLOV's centre and its five 1/8 in holes in one placement: 100 pattern for L2–L6 (solid circle), 150 pattern for L1 (dashed circle, ringed holes). | 1
| | Feet corner jig. Fences on a far corner of a face-down top; a foot's centre 8.5 cm from both edges and its four 1/8 in holes 46.8 mm apart: F2, F4, F7, F8. | 1
| | ALEX corner template. A check, not the way the rings are placed (they are placed by tracing the pads, chapter G). Laid on a bare traced corner, the pencil trace must sit inside its inner engraved circle (⌀52 mm); its outer three holes are check-only. It is also the jig for the optional ALEX feet on the bottom corners (inner three 5/64 in holes, radius 14.5 mm). | 1
| | Rail marking gauge. Lip over the angle's edge; pencil notches at 19 mm (screw line on the flat leg) and 29 mm (bolt line on the vertical leg). | 1
| | Rail drill jig. Lip over the flat leg's free edge; a 1/8 in bore on the 19 line; sight grooves on the station line. PETG. | 1
| | Slot plug (fitting-centring-plug). Drops into a fitting's 21 × 12 slot; a 1/8 in bore dead centre, so the pilot cannot wander in the slot's play. | 2
| | Pilot drill guide. SET tower (45 mm for the 1/8 in bit, 35 mm for the 5/64 in) and five depth pucks: 12 PLATE, 15 LEG, 10 EDGE, 12 ALEX, 25 RAIL. Re-set the bit every time you change it. | 1 set
| | | Foot height gauge. A C with 102 mm inside: all eight feet wound to the same height without a ruler. | 1
| | | Rail setback gauge. A 120 mm bar with a lip: hooked over a top's front edge (top face down), its end is where the rail's vertical leg goes, 12 cm back. Labelled RAIL 120. | 2
| | | Wall gauge. An L: the 65 leg (6.5 cm, ALEX back to wall) and the 30 leg (3 cm, a top's raw edge to wall). | 1

Also print the eight locating rings (P10) now: parts/structure/foot-ring, PETG or ABS, flange down. Their 52 mm bore suits the 50 mm pad; measure your pad first (last page of this chapter).

L-Shaped Corner Desk · Assembly Manual | B · Before you begin

## Printed tools: how each one is used

1 · Edge T-square

50

85
100

150

station (tape)

10 cm

85 pad: four 1/8 in
feet-plate holes

scriber

face-down top

lip

Fig. B-4 · The T-square on a face-down top, lip over the edge, at its station. Hole names are mm from the edge.

1. Turn it over so the lip hangs down. Hook the lip over the edge named in the marking table.
2. Slide the head along the edge until the blade's centre line sits on the station you ticked with the tape.
3. Put the scriber through the hole the table names:

### 50 checks a ring centre on the ALEX (5 cm in), 85

feet (8.5 cm in), 100 legs L2–L6 (10 cm in), 150 leg L1 (15 cm in). Each hole is named for its distance from the edge in mm.
4. The four holes round 85 are 1/8 in drill holes for a feet plate (46.8 mm apart): start the four pilots through them, lift, finish with the 15 LEG puck.
5. First-print check: hook it over a top's edge: the 100 hole must sit 10.0 cm from the edge. If not, reprint it, never scaled.

2 · Leg jig

wall | 100: L2-L6 | 150: L1
unfinished (wall) edge; dashed tick: station

Fig. B-5 · The leg jig hooked over the wall (unfinished) edge.

1. Turn it over (lip down). Hook the lip over the wall edge and slide it to the leg's station.
2. L2–L6: the 100 pattern: plain holes, solid circle, one hole toward the wall. L1: the 150 pattern: ringed holes, dashed circle.
3. Start the five 1/8 in pilots 3–4 mm deep through the pattern's holes.
4. The small centre hole is for a scriber only; never drill it.
5. Lift the jig and finish each pilot with the 15 LEG puck.
L-Shaped Corner Desk · Assembly Manual | B · Before you begin

3 · Feet corner jig

8.5 cm

8.5 cm

plate outline

Fig. B-6 · The feet corner jig on a far corner of a face-down top, fences against both edges.

1. Turn it over (fences down). Drop it over a far corner of the top so both fences bear on the two edges.
2. It gives the foot centre 8.5 cm from both edges and the plate's four holes, 46.8 mm apart, square to the edges.
3. Start the four 1/8 in pilots through it, lift it, finish with the 15 LEG puck.
4. It does F2, F4, F7, F8. The other four feet (F1, F3, F5, F6) are 34.5 cm from the far end: the T-square's 85 pad does those, at the tape stations in chapter D.

4 · ALEX corner template

ALEX corner

5 cm

5 cm

outer 3: ring
circle, check only

inner 3: ALEX
feet, bottom only

Fig. B-7 · The template on an ALEX corner, holes at 45°, 165° and 285° from the edge. Black: the outer check-only positions (radius 33 mm). White: the ALEX-foot holes (radius 14.5 mm). Dashed: the engraved ring circles; the inner one is ⌀52 mm.

1. It checks, it does not place. Each ring is placed by tracing its pad on the cabinet top (chapter G).
2. Check, before drilling (chapter G, step 2a): with the top lifted off, turn the template over (fences down) and lay it on the bare traced corner, fences against both edges. Your pencil trace must sit inside the inner engraved circle (⌀52 mm) all round. If it does not, re-trace.
3. The outer three holes (radius 33 mm, engraved "outer 3 = ring check only") are check positions only: never drill through them on the top.
4. The inner three (5/64 in, radius 14.5 mm) are drilled only for the optional ALEX feet, with the template against a cabinet's bottom corner; lift it, finish with the 12 ALEX puck. Same template for all eight corners.
L-Shaped Corner Desk · Assembly Manual | B · Before you begin

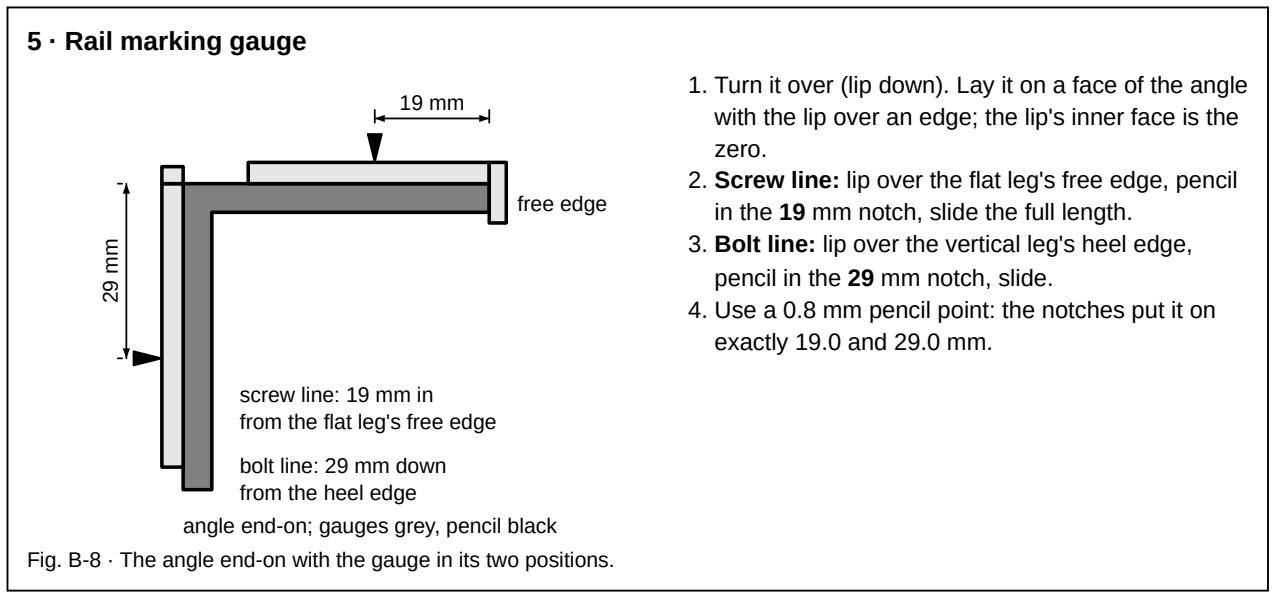
[picture p120: figure]
5 · Rail marking gauge; free edge; screw line: 19 mm in from the flat leg's free edge; bolt line: 29 mm down from the heel edge angle end-on; gauges grey, pencil black; zero.; pencil in the 29 mm notch, slide.; exactly 19.0 and 29.0 mm.

Fig. B-8 · The angle end-on with the gauge in its two positions.

1. Turn it over (lip down). Lay it on a face of the angle with the lip over an edge; the lip's inner face is the
2. Screw line: lip over the flat leg's free edge, pencil in the 19 mm notch, slide the full length.
3. Bolt line: lip over the vertical leg's heel edge,
4. Use a 0.8 mm pencil point: the notches put it on

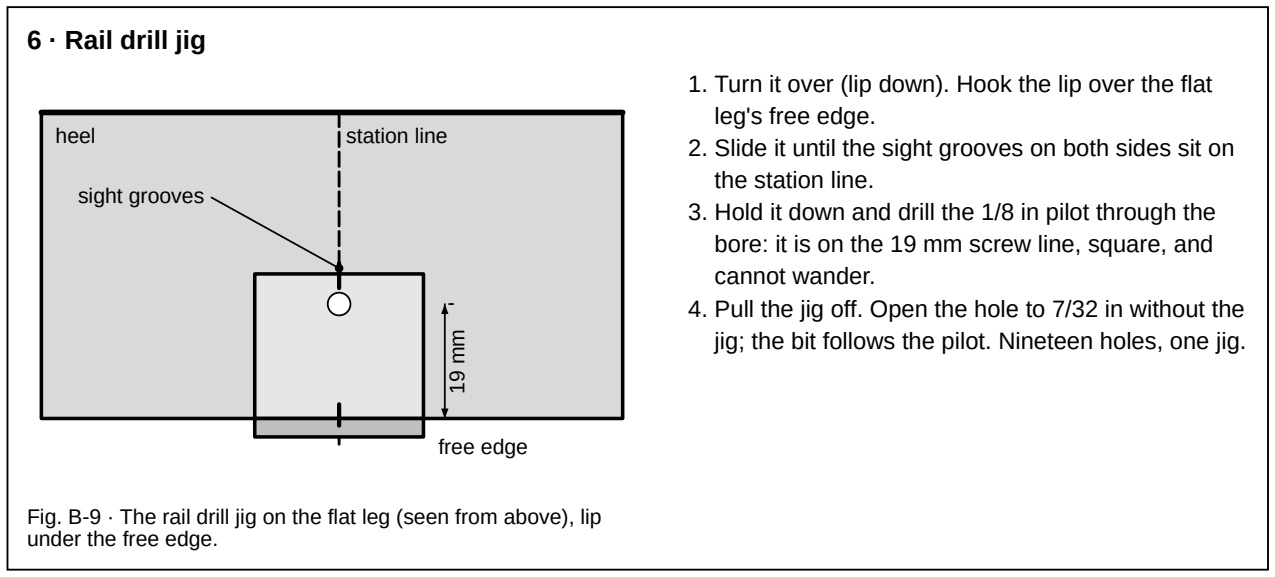
[picture p121: figure]
6 · Rail drill jig; heel; free edge; station line; sight grooves; under the free edge.; leg's free edge.; the station line.; cannot wander.

Fig. B-9 · The rail drill jig on the flat leg (seen from above), lip

1. Turn it over (lip down). Hook the lip over the flat
2. Slide it until the sight grooves on both sides sit on
3. Hold it down and drill the 1/8 in pilot through the bore: it is on the 19 mm screw line, square, and
4. Pull the jig off. Open the hole to 7/32 in without the jig; the bit follows the pilot. Nineteen holes, one jig.

## Drill bits: four sizes make every hole

Bit | Holes | Through | Depth / guide step
5/64 in HSS | ring screws into the ALEX tops, 24 (+24 for optional ALEX feet); wall-gap trim, 48 (optional) | the ring's own holes; the trim's lip holes | 12 mm, 12 ALEX; 10 mm, 10 EDGE
1/8 in HSS | OLOV plates 30; feet plates 32; joining plates 16; rail screws into the tops 19; first pass of the 6 fitting bolt holes in the rails | leg jig, feet corner jig or T-square; plate holes; rail holes; the slot plug in the fitting | 15 mm, 15 LEG; 12 mm, 12 PLATE; 20 mm into the top, 25 RAIL; through the steel
7/32 in HSS | the 19 rail screw holes in the rails' flat legs (9 in A, 10 in B) | the 1/8 in pilot made through the rail drill jig | through, 19 mm from the free edge, oil
7/16 in cobalt | the 6 fitting bolt holes in the rails' vertical legs (4 in A, 2 in B) | the 1/8 in pilot made through the slot plug, fitting off | through, 29 mm from the heel, slow, oil

Sort these four out of the bit case and keep them with the printed jigs. The jig bores are sized for these imperial bits (2.3 and 3.5 mm); the metric near-misses do not fit.

L-Shaped Corner Desk · Assembly Manual | B · Before you begin

7 · Slot plug (fitting-centring-plug)

rail's vertical leg

heel on the mark

plug: 1/8 in bore on the slot centre

next

Fig. B-10 · A fitting clamped on the rail's vertical leg, heel on its mark, plug in the first slot.

1. Clamp the fitting to the rail with its heel on the mark from chapter E.
2. Drop a plug into each of the leg's two slots (that is why there are two). Drill the 1/8 in pilot through each plug's bore. Three clamp positions, six pilots.
3. Take the fitting off. Open each pilot to 7/16 in; the bit follows the pilot.
4. Why: the slots are 21 × 12 mm, so a bolt or a punch could sit anywhere along the slot. The plug fills it and puts every pilot on the slot centre.

8 · Pilot drill guide

45 m

m

(a) SET
1/8: 45, 5/64: 35

depth of the puck

chuck nose stops

(b) drill through the puck Fig. B-11 · (a) Setting the bit in the SET tower. (b) Drilling through a puck.
1. Set the bit: loosen the chuck, drop the bit tip-first into the SET tower's hole for it (45 mm for 1/8 in, 35 mm for 5/64 in), rest the chuck nose on the tower, tighten.
2. Drill: stand the puck for that hole flat on the surface (or on the plate, or on the rail's flat leg), bit down its bore, drill until the chuck nose lands on the puck.
3. Pucks: the number is the hole depth in mm. 12 PLATE (1/8 in, joining plates) · 15 LEG (1/8 in, OLOV and feet plates) · 10 EDGE (5/64 in, trim screws sideways into the raw edge, bit horizontal)
- 12 ALEX (5/64 in, rings and ALEX feet) · 25 RAIL (1/8 in, through the angle, 20 mm into the wood).
4. In plain words: the chuck nose is the stop. The tower fixes how much bit hangs out of the chuck (45 mm). Each puck is a block exactly 45 minus the depth tall: 15 LEG is 30 mm tall, so when the chuck lands on it, 15 mm of bit is in the wood and it cannot go deeper. Do not push the bit all the way into the chuck; let the tower set it.
5. Re-set the bit every time you change it. A domed chuck nose: drill one test hole in scrap through 15 LEG and measure it; about 15 mm proves the chuck and the pucks.
L-Shaped Corner Desk · Assembly Manual | B · Before you begin

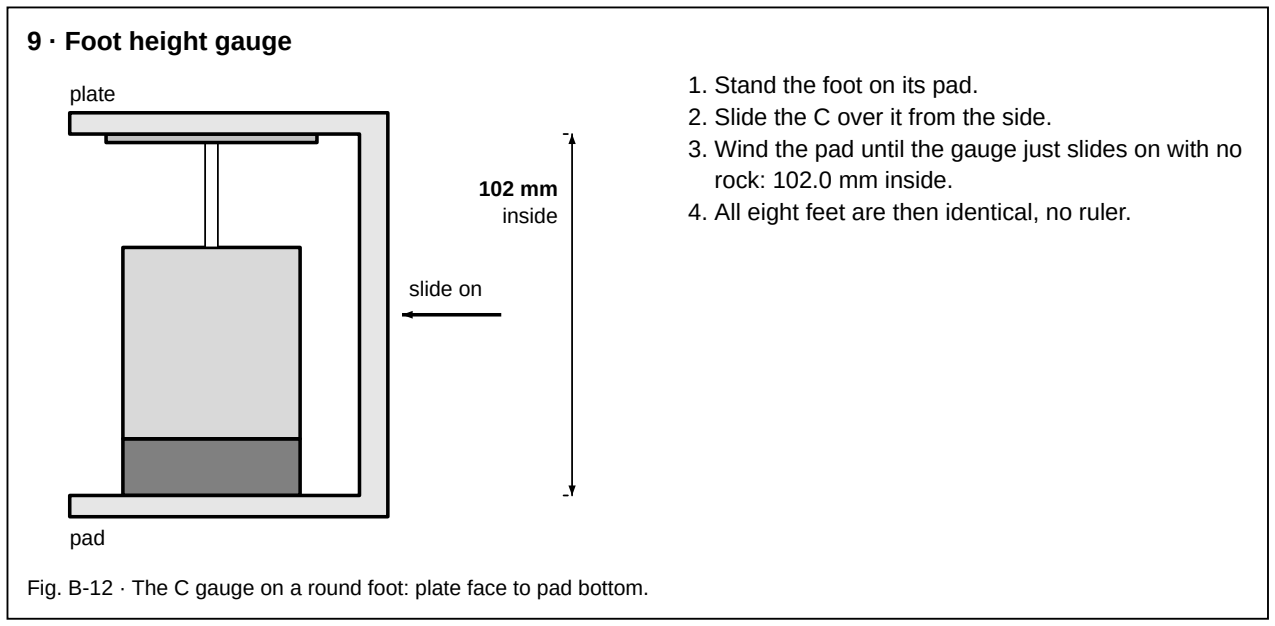
[picture p122: figure]
9 · Foot height gauge; slide on; 102 mm inside; plate; pad; 1. Stand the foot on its pad. 2. Slide the C over it from the side.; rock: 102.0 mm inside.

Fig. B-12 · The C gauge on a round foot: plate face to pad bottom.

3. Wind the pad until the gauge just slides on with no
4. All eight feet are then identical, no ruler.

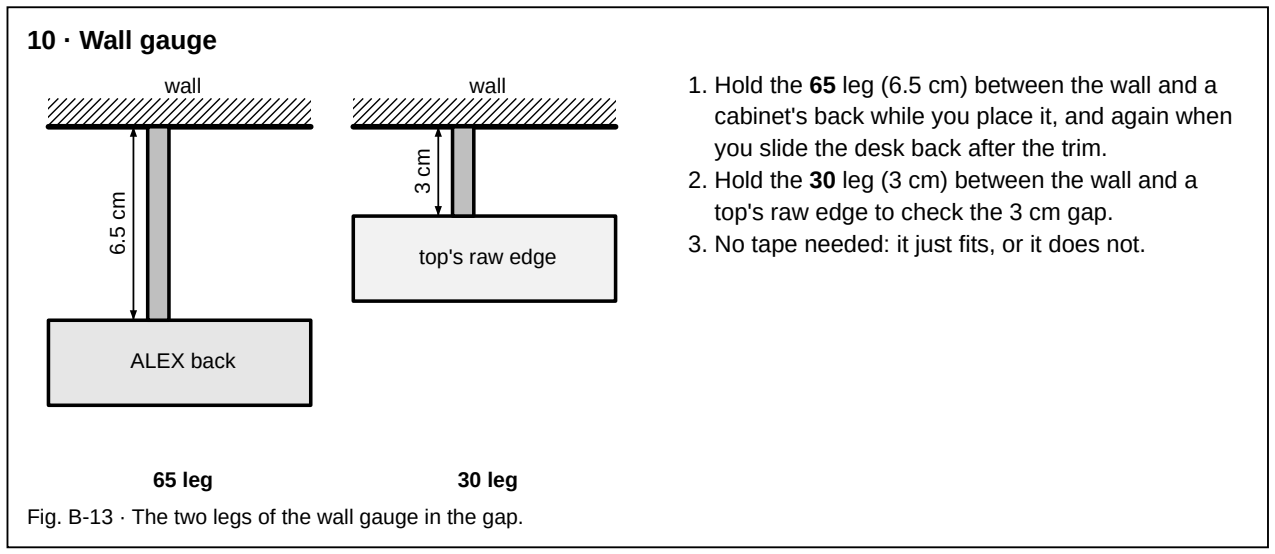
[picture p123: figure]
10 · Wall gauge; wall; ALEX back; 65 leg; top's raw edge; 30 leg; you slide the desk back after the trim.; top's raw edge to check the 3 cm gap.

Fig. B-13 · The two legs of the wall gauge in the gap.

1. Hold the 65 leg (6.5 cm) between the wall and a cabinet's back while you place it, and again when
2. Hold the 30 leg (3 cm) between the wall and a
3. No tape needed: it just fits, or it does not.

11 · Rail setback gauge (× 2)
1. Top face down. The rail lies on the underside, flat leg on the wood, vertical leg pointing up, roughly on its pencil line.
2. Hook the gauge's short lip over the front edge so the lip hangs down the edge and the bar lies flat on the underside, pointing toward the back.
3. Push the rail toward the front edge until the outer face of its vertical leg touches the end of the bar. It is now exactly 12 cm back, because the bar is 120 mm long.
4. Second gauge near the other end of the rail. With both touching, the rail is parallel to the front edge along its whole length. Clamp it there and pull the gauges out.
5. Before the first screw, hook one gauge in the middle: it should just touch. Like the wall gauge, it fits or it does not. Chapter F, step 4.

Every jig hole is bit-sized: start the pilot 3–4 mm through the jig, lift the jig, finish the hole to depth with the puck. Centre holes are for a scriber only. Never scale a tool in the slicer: its distances are the tool.

L-Shaped Corner Desk · Assembly Manual | B · Before you begin

## How sure is each number?

Every dimension in this manual carries one of three confidence labels, or a fourth label that is an instruction to you:

VERIFIED | Measured on the purchased part, or taken from the part's own geometry file (the printed parts).
SOURCE-DEFINED | Defined by the project documents (the build manual): a design position, not a measurement. It is right by definition; you put the part there.
ASSUMPTION / FIELD CHECK | An engineering estimate or a check done on site. Confirm it before you rely on it.
MEASURE ON HARDWARE | Not yet measured on your parts. Measure it yourself before the step that uses it, and stop if it differs.

## Confirm before you drill anything

These numbers are not yet confirmed on the parts you have. Each one is checked again where it is used; if one differs, stop and correct the layout before any hole is drilled.

EKBACKEN thickness, both tops (calipers) | 28 mm | MEASURE ON HARDWARE | D: every screw depth. If a top measures 27 mm, nothing changes: the deepest screw still stops 6 mm short of the laminate. Under 27 mm, stop and ask.
Delivered rail lengths, both pieces, and the angle thickness | 213 cm layout length (bought as 84 in = 213.4 cm); 4.8 mm thick | MEASURE ON HARDWARE | E: hole stations. 213 cm is the layout length; the far end may carry the extra.
Strut fitting slots, positions from the heel | 21 × 12 mm slots, centres 29.15 and 78.45 mm from the heel (legs 100.5 × 41 mm) | VERIFIED | E (drilling template), H (bolting the corner): measured 23 Oct 2026.
Feet pad diameter (calipers) | 50 mm | MEASURE ON HARDWARE | G: the rings are bored 52 mm for a 50 mm pad; re-print them if yours differs.
ALEX top panel thickness | 15.9 mm (5/8 in), measured 23 Oct 2026 | VERIFIED | G: the ring screws reach 13.4 mm, 2.5 mm of panel remains; the 12 ALEX pilot leaves 3.9 mm.
ALEX height, with and without its stock feet | 70.0 cm | ASSUMPTION / FIELD CHECK | F (cabinets placed), G: with the feet it sets the underside at 80.2 cm.
VIVO top arm reach | about 89 mm | ASSUMPTION / FIELD CHECK | I: the clamps on the 28 mm top plus a pad plate.
VIVO maximum clamp opening | 31 mm or more | MEASURE ON HARDWARE | I: the clamps on the 28 mm top plus a pad plate.
Room: both walls; baseboard thickness | back wall 252 cm or more; side wall 322 cm or more; 40 cm free along the open sides | MEASURE ON HARDWARE | B (work area), F (ALEX units by the walls), G (top B stood 5 cm out), J (desk pulled 40 cm into the room). Side wall under 322 cm: stop and ask before chapter G.
ALEX bottom panel thickness (only for the optional ALEX feet) | not given | MEASURE ON HARDWARE | F: before fitting the optional ALEX feet.
Feet load rating | unknown; the design wants 50 kg or more each | ASSUMPTION / FIELD CHECK | C (P09); check the listing or the maker.

Next: chapter C (check every part against the inventory).

L-Shaped Corner Desk · Assembly Manual | B · Before you begin

# C · Complete parts inventory

Check every part against this list before you start. Part numbers P01–P21 and hardware numbers H01–H11 are used in every callout balloon in this manual. Lengths a tape measures are in cm; thicknesses, holes, plates and screws in mm. REQUIRED parts are needed for the desk to stand; OPTIONAL parts can be left out.

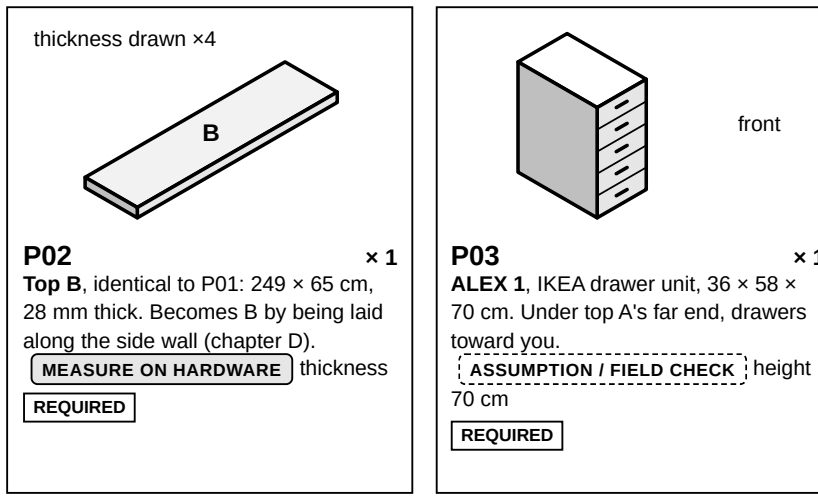
[picture p124: figure]
thickness drawn ×4; Top B, identical to P01: 249 × 65 cm, 28 mm thick. Becomes B by being laid along the side wall (chapter D). MEASURE ON HARDWARE thickness; REQUIRED; toward you. ASSUMPTION / FIELD CHECK height 70 cm
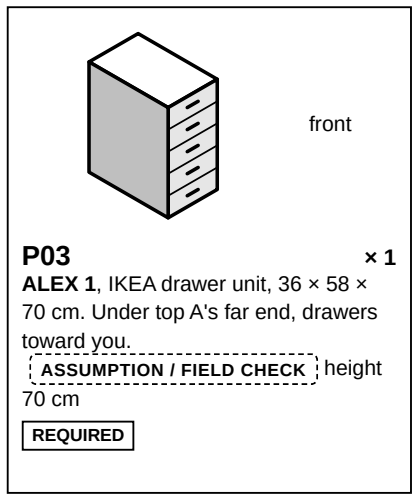
[picture p125: figure]
front; ALEX 1, IKEA drawer unit, 36 × 58 × 70 cm. Under top A's far end, drawers
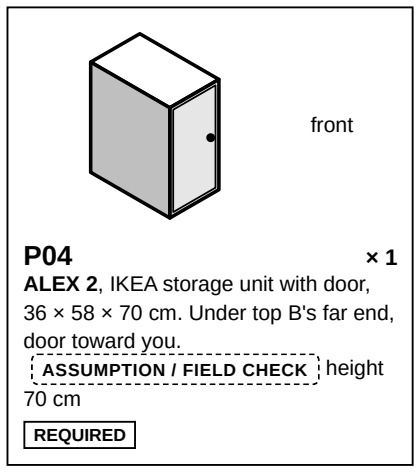
[picture p126: figure]
front; ALEX 2, IKEA storage unit with door, 36 × 58 × 70 cm. Under top B's far end, door toward you. ASSUMPTION / FIELD CHECK height 70 cm; REQUIRED
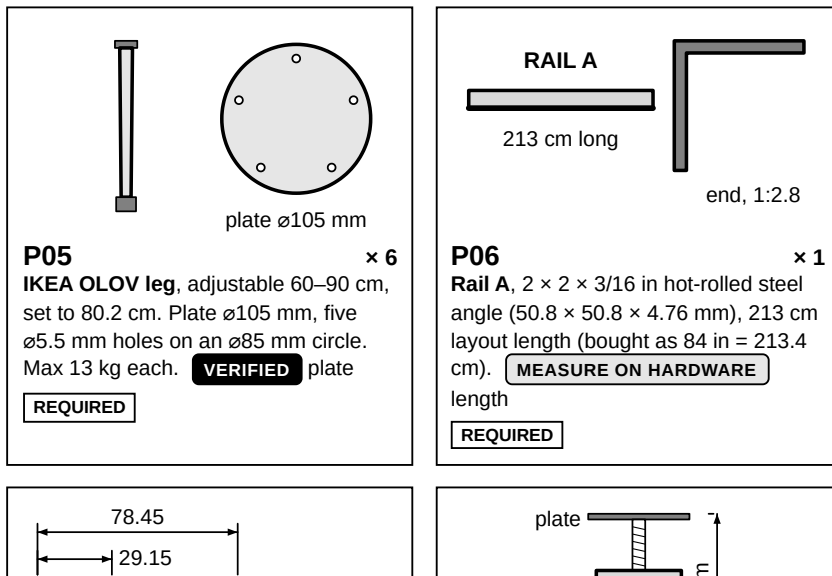
[picture p127: figure]
plate ⌀105 mm; IKEA OLOV leg, adjustable 60–90 cm, set to 80.2 cm. Plate ⌀105 mm, five ⌀5.5 mm holes on an ⌀85 mm circle. Max 13 kg each. VERIFIED plate; REQUIRED; RAIL A; 213 cm long; end, 1:2.8; angle (50.8 × 50.8 × 4.76 mm), 213 cm layout length (bought as 84 in = 213.4 cm). MEASURE ON HARDWARE length; plate
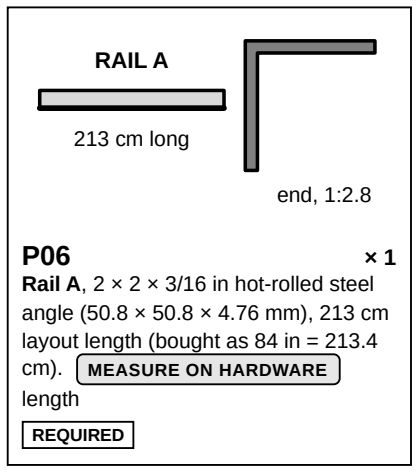
[picture p128: figure]

Rail A, 2 × 2 × 3/16 in hot-rolled steel

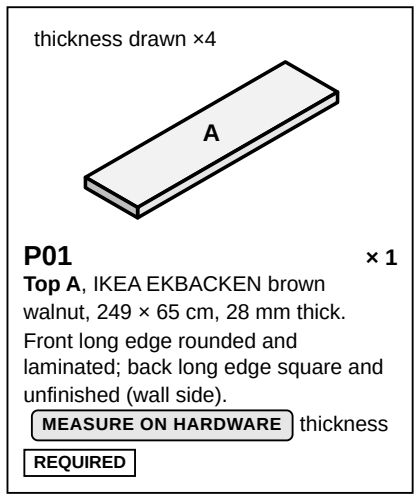
[picture p129: figure]
thickness drawn ×4; Top A, IKEA EKBACKEN brown walnut, 249 × 65 cm, 28 mm thick. Front long edge rounded and laminated; back long edge square and unfinished (wall side). MEASURE ON HARDWARE thickness; REQUIRED
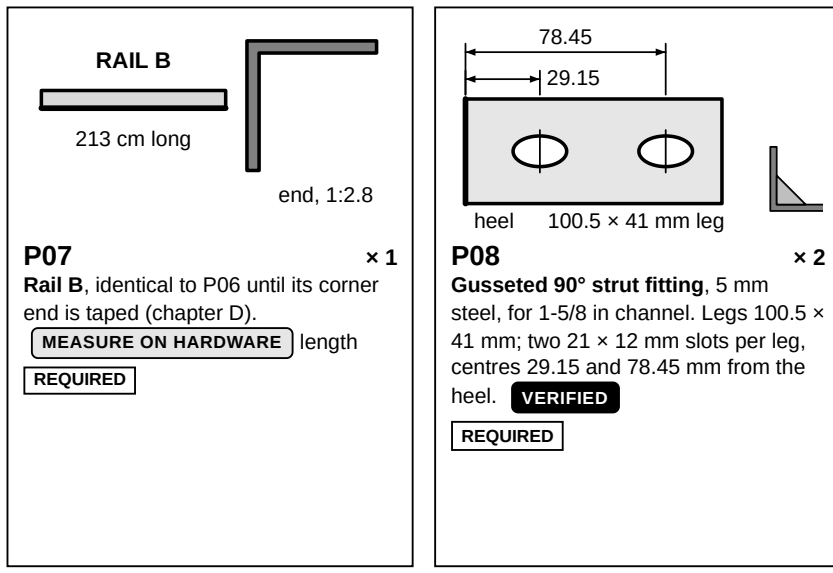
[picture p130: figure]
RAIL B; 213 cm long; end, 1:2.8; end is taped (chapter D). MEASURE ON HARDWARE length; REQUIRED; heel; 100.5 × 41 mm leg; Gusseted 90° strut fitting, 5 mm; 41 mm; two 21 × 12 mm slots per leg, centres 29.15 and 78.45 mm from the heel. VERIFIED
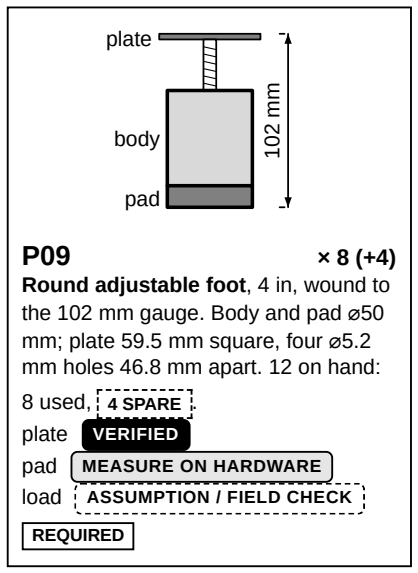
[picture p131: figure]

Rail B, identical to P06 until its corner

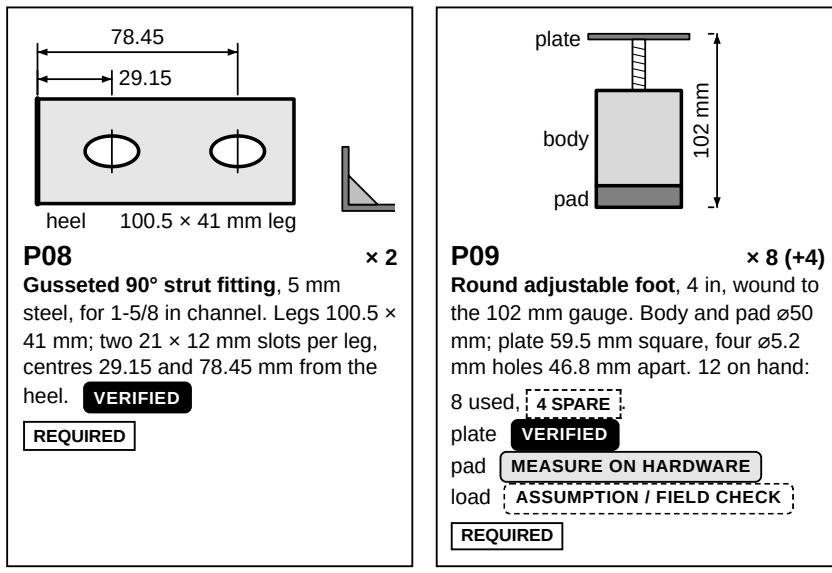
[picture p132: figure]
body; pad; Round adjustable foot, 4 in, wound to the 102 mm gauge. Body and pad ⌀50 mm; plate 59.5 mm square, four ⌀5.2 mm holes 46.8 mm apart. 12 on hand: 8 used, 4 SPARE .; plate VERIFIED; pad MEASURE ON HARDWARE; load ASSUMPTION / FIELD CHECK; REQUIRED

steel, for 1-5/8 in channel. Legs 100.5 ×

L-Shaped Corner Desk · Assembly Manual | C · Parts inventory

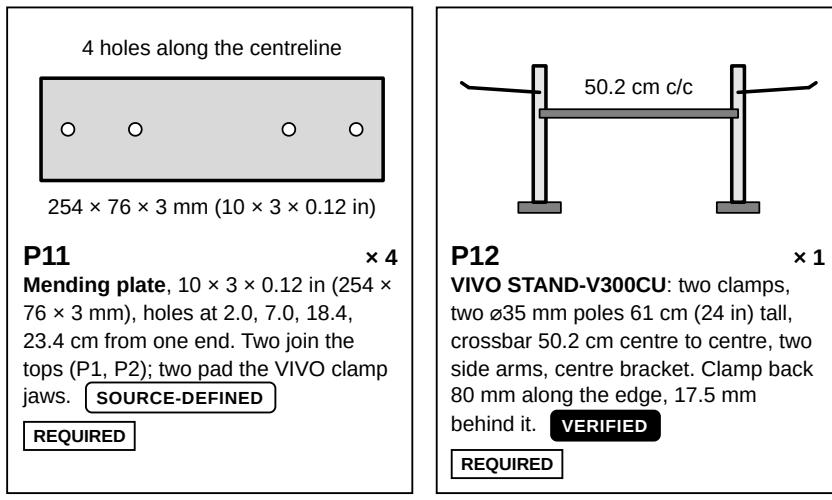
[picture p133: figure]
VIVO STAND-V300CU: two clamps, two ⌀35 mm poles 61 cm (24 in) tall, crossbar 50.2 cm centre to centre, two side arms, centre bracket. Clamp back 80 mm along the edge, 17.5 mm behind it. VERIFIED; REQUIRED
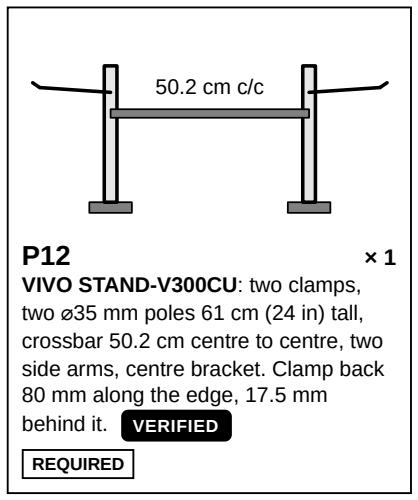
[picture p134: figure]
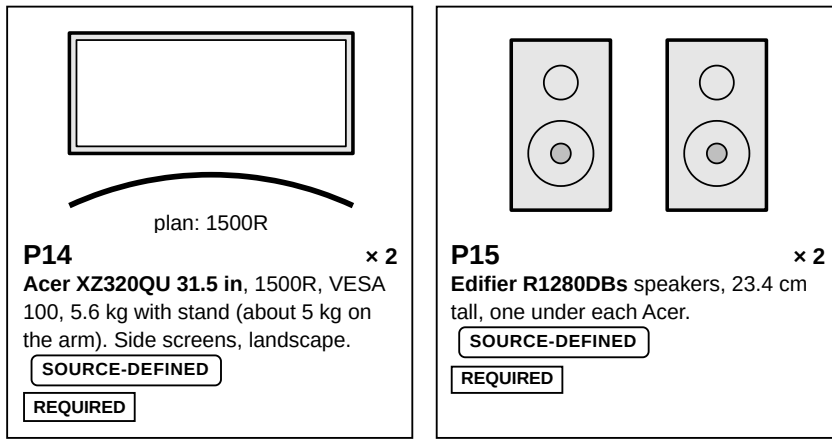
[picture p135: figure]
Edifier R1280DBs speakers, 23.4 cm tall, one under each Acer.; SOURCE-DEFINED; REQUIRED
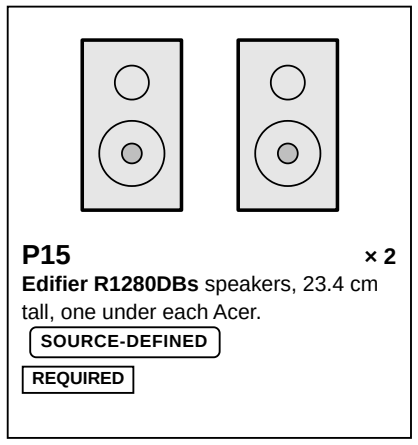
[picture p136: figure]
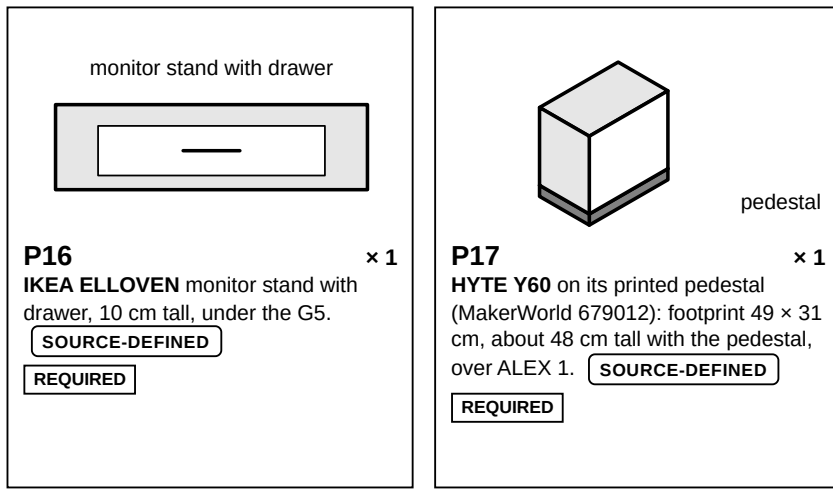
[picture p137: figure]
monitor stand with drawer; IKEA ELLOVEN monitor stand with drawer, 10 cm tall, under the G5.; SOURCE-DEFINED; REQUIRED; pedestal; HYTE Y60 on its printed pedestal (MakerWorld 679012): footprint 49 × 31 cm, about 48 cm tall with the pedestal, over ALEX 1. SOURCE-DEFINED
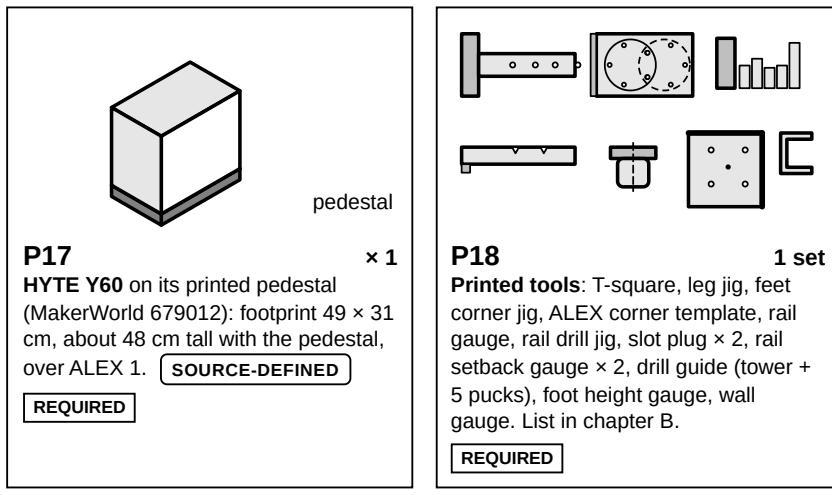
[picture p138: figure]
1 set; Printed tools: T-square, leg jig, feet corner jig, ALEX corner template, rail; setback gauge × 2, drill guide (tower + 5 pucks), foot height gauge, wall gauge. List in chapter B.; REQUIRED
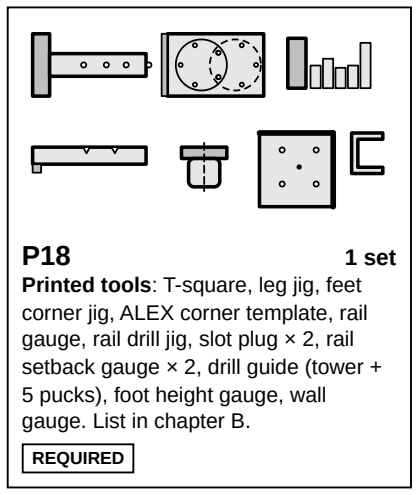
[picture p139: figure]

gauge, rail drill jig, slot plug × 2, rail

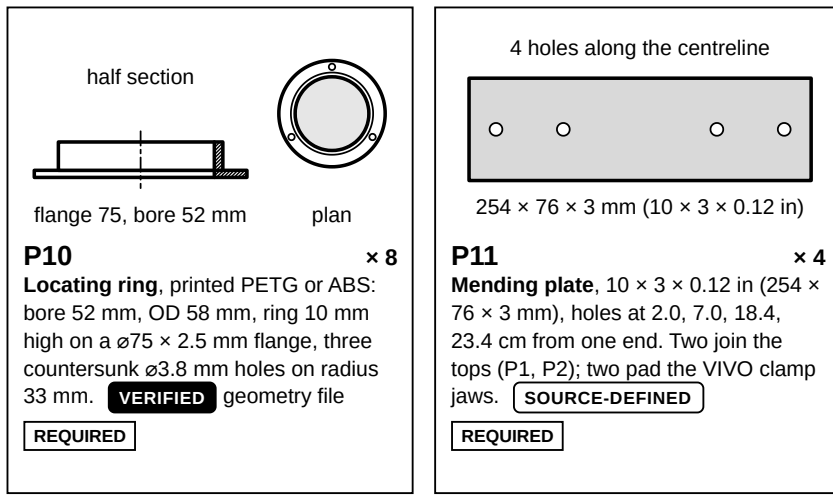
[picture p140: figure]
half section; flange 75, bore 52 mm; plan; Locating ring, printed PETG or ABS: bore 52 mm, OD 58 mm, ring 10 mm high on a ⌀75 × 2.5 mm flange, three countersunk ⌀3.8 mm holes on radius 33 mm. VERIFIED geometry file; REQUIRED; 4 holes along the centreline; Mending plate, 10 × 3 × 0.12 in (254 × 76 × 3 mm), holes at 2.0, 7.0, 18.4, 23.4 cm from one end. Two join the tops (P1, P2); two pad the VIVO clamp jaws. SOURCE-DEFINED
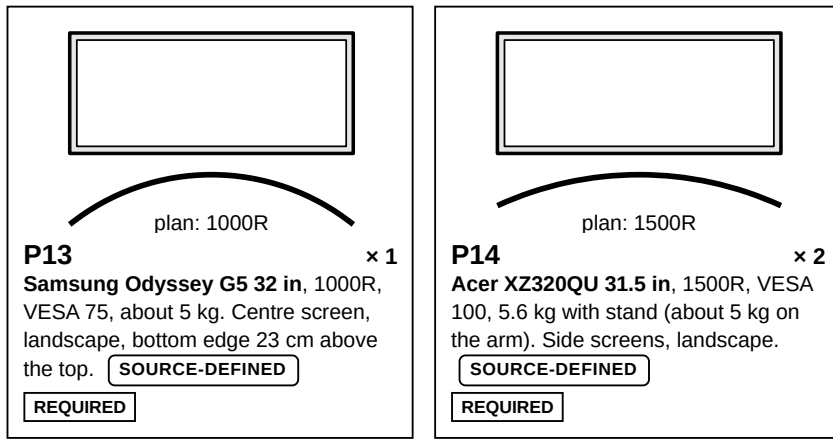
[picture p141: figure]
plan: 1000R; Samsung Odyssey G5 32 in, 1000R, VESA 75, about 5 kg. Centre screen, landscape, bottom edge 23 cm above the top. SOURCE-DEFINED; REQUIRED; plan: 1500R; Acer XZ320QU 31.5 in, 1500R, VESA 100, 5.6 kg with stand (about 5 kg on the arm). Side screens, landscape.; SOURCE-DEFINED
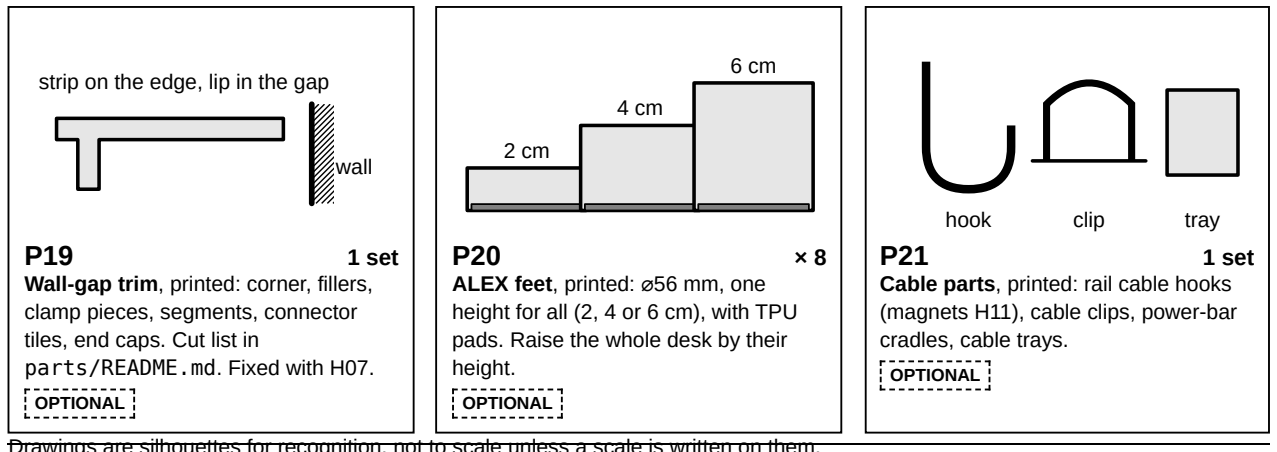
[picture p142: figure]
strip on the edge, lip in the gap; wall; 1 set; Wall-gap trim, printed: corner, fillers, clamp pieces, segments, connector tiles, end caps. Cut list in parts/README.md. Fixed with H07.; OPTIONAL; ALEX feet, printed: ⌀56 mm, one height for all (2, 4 or 6 cm), with TPU pads. Raise the whole desk by their height.; hook; clip; tray; Cable parts, printed: rail cable hooks (magnets H11), cable clips, power-bar cradles, cable trays.

Drawings are silhouettes for recognition, not to scale unless a scale is written on them.

L-Shaped Corner Desk · Assembly Manual | C · Parts inventory

## Hardware H01–H11

Screws and bolts are drawn 1:1 (true length, nominal diameter): lay a screw on the drawing to check it. Washers and the nut are symbols. All hardware was ordered 22 Oct 2026 SOURCE-DEFINED . Buy a few spares of each screw.

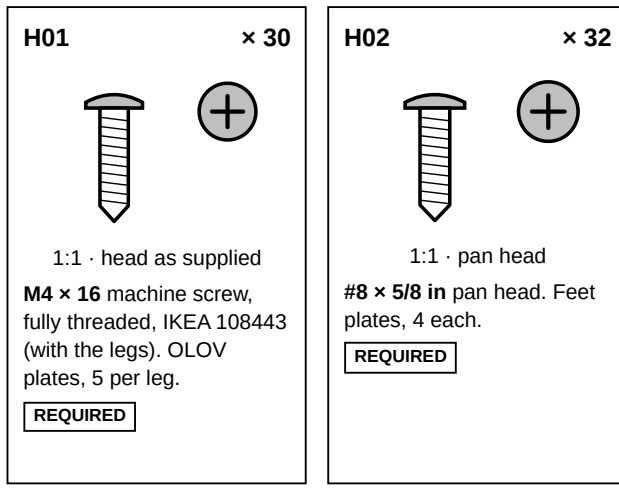
[picture p143: figure]
1:1 · head as supplied; M4 × 16 machine screw, fully threaded, IKEA 108443 (with the legs). OLOV plates, 5 per leg.; REQUIRED; 1:1 · pan head; #8 × 5/8 in pan head. Feet plates, 4 each.
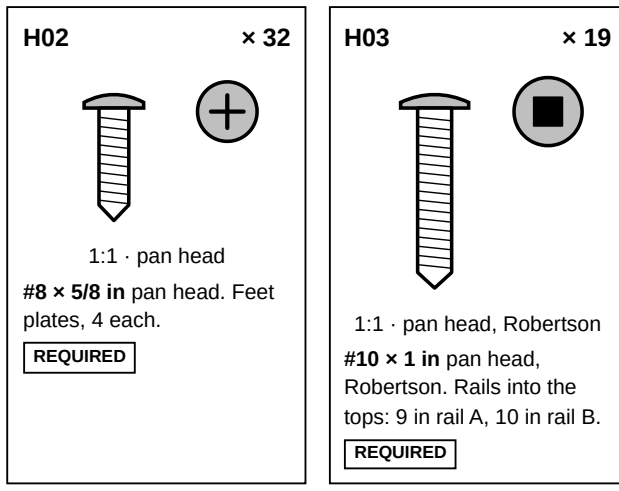
[picture p144: figure]
1:1 · pan head, Robertson; #10 × 1 in pan head, Robertson. Rails into the tops: 9 in rail A, 10 in rail B.; REQUIRED
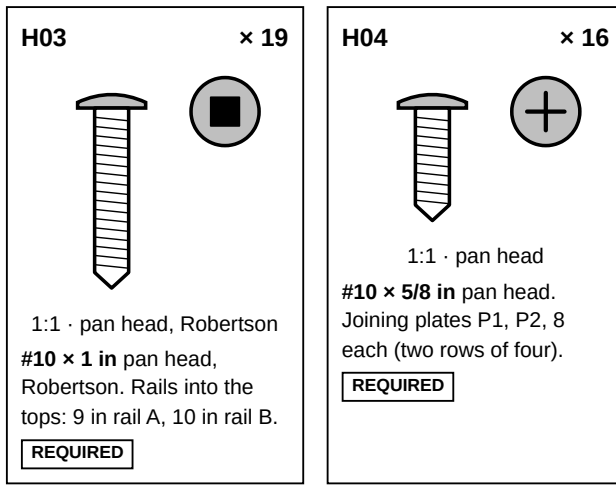
[picture p145: figure]
1:1 · pan head; #10 × 5/8 in pan head. Joining plates P1, P2, 8 each (two rows of four).; REQUIRED
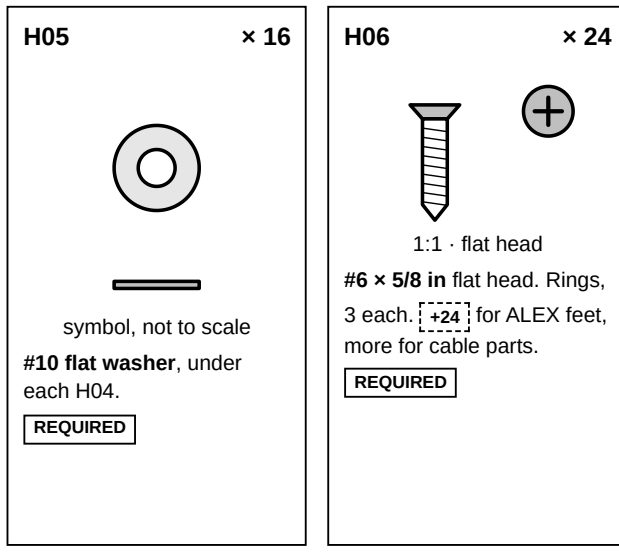
[picture p146: figure]
symbol, not to scale; #10 flat washer, under each H04.; REQUIRED; 1:1 · flat head; #6 × 5/8 in flat head. Rings, 3 each. +24 for ALEX feet, more for cable parts.
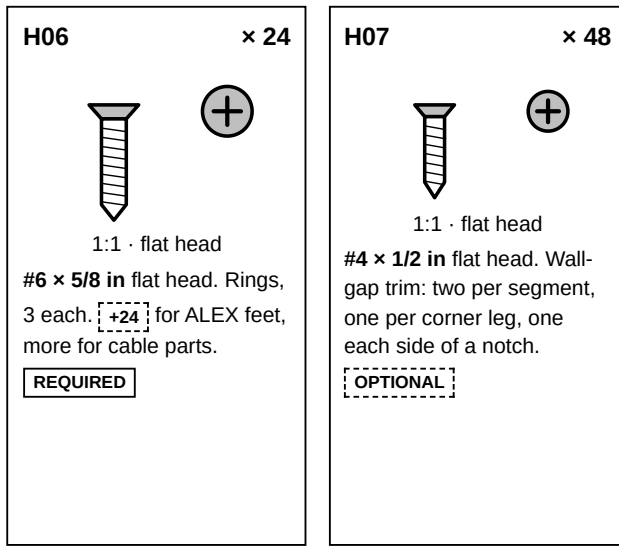
[picture p147: figure]
1:1 · flat head; #4 × 1/2 in flat head. Wall- gap trim: two per segment, one per corner leg, one each side of a notch.; OPTIONAL
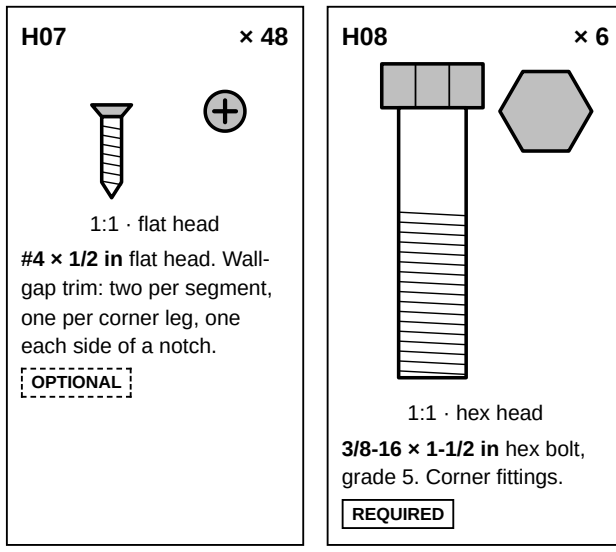
[picture p148: figure]
1:1 · hex head; 3/8-16 × 1-1/2 in hex bolt, grade 5. Corner fittings.; REQUIRED
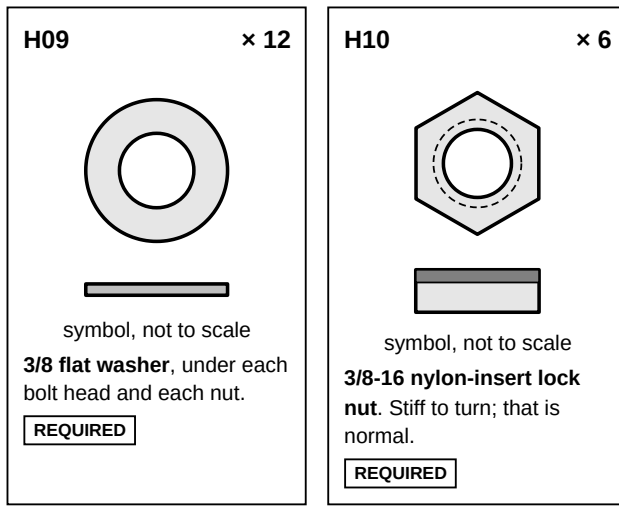
[picture p149: figure]
symbol, not to scale; 3/8 flat washer, under each bolt head and each nut.; REQUIRED; 3/8-16 nylon-insert lock nut. Stiff to turn; that is normal.
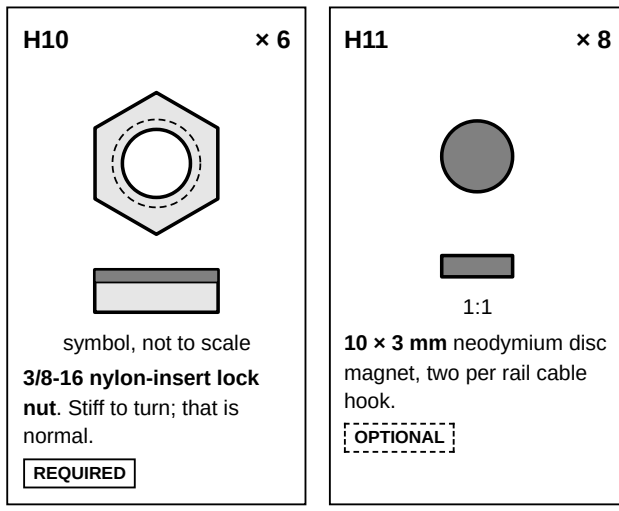
[picture p150: figure]
10 × 3 mm neodymium disc magnet, two per rail cable hook.; OPTIONAL
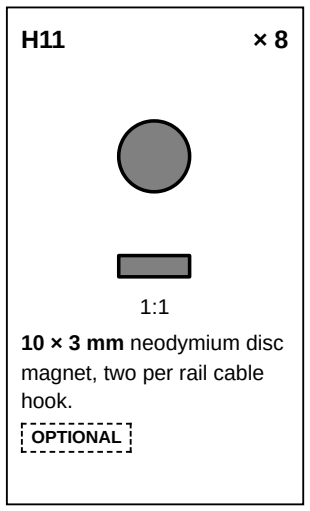
[picture p151: figure]

Next: chapter D (mark both tops face down and label the rails).

L-Shaped Corner Desk · Assembly Manual | C · Parts inventory

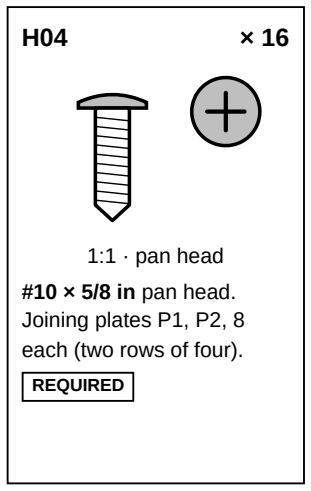
[picture p152: figure]
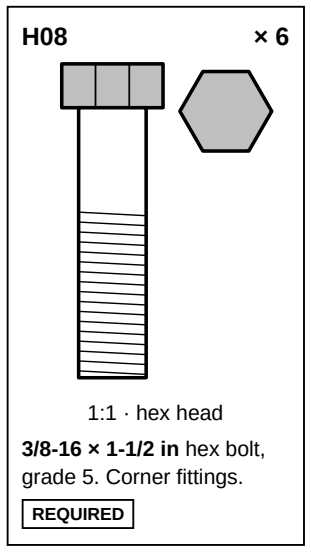
[picture p153: figure]

# D · Component preparation

This chapter marks both tops face down and labels the two rails. Nothing is fixed yet. Positions are in cm, as the tape reads them; thicknesses, holes and screws in mm. Every position is measured from one datum: top A's back-left corner. x runs along the back wall, y along the side wall. Top A covers x 0–249 cm, y 0–65 cm; top B covers x 0–65 cm,

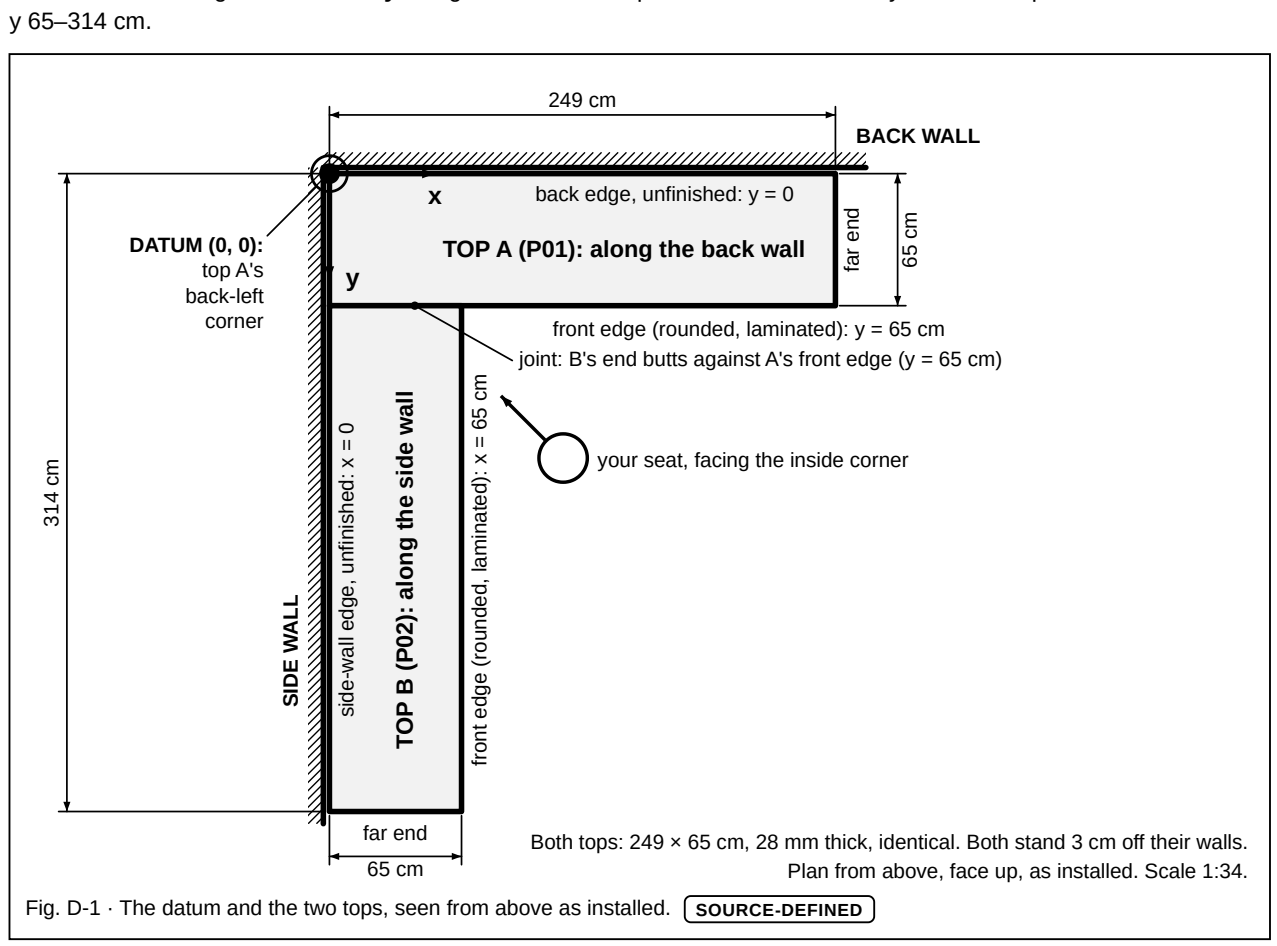
[picture p154: figure]
BACK WALL; SID; WALL; TOP A (P01): along the back wall; B (P02): alo; g the; sid; all; back edge, unfinished: y = 0; side-wall edge, unfinished: x = 0; far end; DATUM (0, 0): top A's back-left corner; your seat, facing the inside corner

front edge (rounded, laminated): y = 65 cm

front edge (rounded, laminated): x = 65 cm

joint: B's end butts against A's front edge (y = 65 cm)

Both tops: 249 × 65 cm, 28 mm thick, identical. Both stand 3 cm off their walls. Plan from above, face up, as installed. Scale 1:34. Fig. D-1 · The datum and the two tops, seen from above as installed. SOURCE-DEFINED

Which edge is which
Each top has one rounded, laminated long edge: the front. The other long edge is square and unfinished: it goes against the wall. Either short end can become the side-wall end.

Which top is A
The two tops (P01, P02) are identical. A is the one you lay along the back wall; its unfinished edge is y = 0. B lies along the side wall; its unfinished edge is x = 0 and one short end, the joint end, butts against A's front edge. Top B is top A turned 90°, never mirrored.

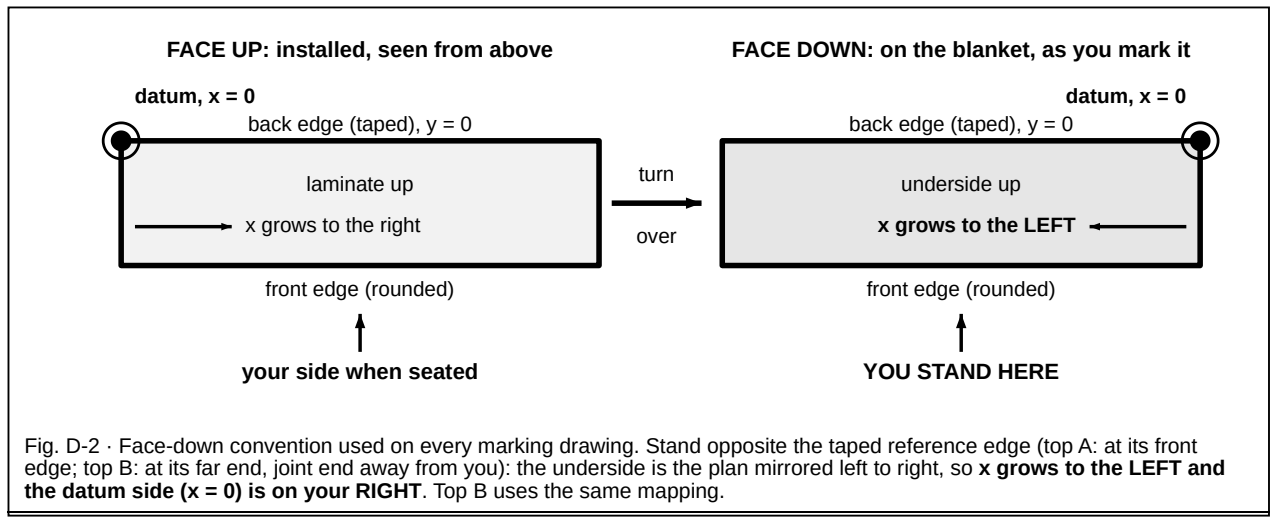
[picture p155: figure]
FACE UP: installed, seen from above; datum, x = 0 back edge (taped), y = 0; front edge (rounded); x grows to the right; laminate up; your side when seated; x grows to the LEFT; underside up; YOU STAND HERE; turn; over

FACE DOWN: on the blanket, as you mark it

Fig. D-2 · Face-down convention used on every marking drawing. Stand opposite the taped reference edge (top A: at its front edge; top B: at its far end, joint end away from you): the underside is the plan mirrored left to right, so x grows to the LEFT and the datum side (x = 0) is on your RIGHT. Top B uses the same mapping.

L-Shaped Corner Desk · Assembly Manual | D · Component preparation

## Top A, face down: overview

1

Calipers on top A MEASURE ON HARDWARE . 28 mm expected. If a top measures 27 mm, nothing changes: the deepest screw still stops 6 mm short of the laminate. Under 27 mm, stop and ask. Tape the unfinished long edge ("A · BACK EDGE") and the short end you choose as the side-wall end ("A · SIDE-WALL END"). Lay top A face down on the blanket and stand at the front edge, back edge away from you.

C1

C2

P2 P1

1

1
0

5 L1

65 L2

140 L3

214 rail A end

249

DATUM

← x grows to the LEFT · all cm · tape hooked on the side-wall end

L1

L3 | L2

F1
F2

F3

F4

10

42

RAIL A: vertical leg's outer face on y = 53 cm

ALEX 1
below

FRONT EDGE · rounded, laminated · y = 65 cm · you stand here

side-wall end, x = 0

far end

1:16. y: tape on the back edge. Feet F1–F4: from the far end, Fig. D-5. Fig. D-3 · Top A underside as you see it, all cm. Datum at the far right corner. Circles: OLOV plates (P05); squares: feet plates (P09); grey band: rail A (P06); hatched C1, C2: clamp zones; dashed: pad plates, joining plates P1, P2 (P11), rail B's corner end and ALEX 1 (reference).

Mark | Hook the tape on | Tape reads (cm) | Then
L1 | the back edge, tape along the side-wall end | 42 leg jig, 150 pattern, lip over the side-wall end (the lip gives the | 15 from the end). Plate ends 6.5 mm short of rail A
L2 | the side-wall end, tape along the back edge | 65 leg jig, 100 pattern, lip over the back edge
L3 | the side-wall end, tape along the back edge | 140 leg jig, 100 pattern, lip over the back edge
F1 | the far end, tape along the back edge | 34.5 T-square, lip over the back edge, hole 85 on the tick, its four | plate holes
F3 | the far end, tape along the front edge | 34.5 T-square, lip over the front (rounded) edge, hole 85 on the tick, | its four plate holes
F2, F4 | no tape: feet corner jig on the far back and far front corners | | 8.5 cm in from both edges
Rail A line | the back edge, at both ends of the line and the middle | 53 line from 1 to 214 on the side-wall-end tape; the vertical leg's | outer face goes on it (12 cm from the front edge)
C1 | the side-wall end, along the back edge | 36 to 44 | keep clear, 9 cm in from the back edge
C2 | the back edge, along the side-wall end | 36 to 44 | keep clear, 9 cm in from the side-wall end
Pad plate 1 | the side-wall end, along the back edge | 20.0 to 45.4 | outline only, 0.5 to 8.1 cm in from the back edge
Pad plate 2 | the back edge, along the side-wall end | 20.0 to 45.4 | outline only, 0.5 to 8.1 cm in from the side-wall end
P1 / P2 | the side-wall end, along the front edge | 11.2–18.8 / 31.2–38.8 | outline only, from 53.3 cm (back-edge tape) to the front edge; screwed in chapter H

All positions SOURCE-DEFINED (design positions). Pilots: 1/8 in, started 3–4 mm through the jig; in chapter F the jig drops back onto these starts (no second start) and each is finished to depth with its puck.

L-Shaped Corner Desk · Assembly Manual | D · Component preparation

## Top A: the corner

C1

C2

P2 | P1

1

0

rail A

wall end

15 L1, P1

20

35 P2

36

40 clamp 1

44

45.4

47.9

53 rail B line

65 L2

0
0.5

8.1
9
10 L2

20

36

40 clamp 2
42 L1
44
45.4
47.9

53 rail A
53.3 P1 P2

65

DATUM

L1

L2

pad plate 1
(outline only)

pad plate 2

(outline only)

rail B end, later

RAIL A

6.5 mm clear of rail A

FRONT EDGE · rounded · y = 65 · top B butts here · you stand here

BACK EDGE · y = 0 · away from you · all cm

x: tape hooked on the side-wall end · y: tape hooked on the back edge · Scale 1:5

Fig. D-4 · Top A corner, face down, 1:5, all cm. You stand at the front edge, back edge away; x grows to the left. The numbers along the top are the tape hooked on the side-wall end; the numbers on the right are the tape hooked on the back edge.

2

L1: hook the tape on the back edge and tick 42 cm along the side-wall end. Hook the leg jig's lip over the side-wall end at that tick and use its 150 pattern (dashed circle, ringed holes): start the five 1/8 in pilots. L2: tape on the side-wall end, tick 65 cm along the back edge; lip over the back edge, 100 pattern (solid circle).

3

Rail A line: tape hooked on the back edge, tick 53 cm near each end and in the middle; join the ticks from 1 cm to 214 cm (side-wall-end tape); the rail's wall end goes on the 1 cm mark, not flush with the end. Hatch C1 and C2 with pencil. Draw the two pad-plate outlines and the P1, P2 outlines. Nothing is drilled inside C1, C2 or the outlines.

L-Shaped Corner Desk · Assembly Manual | D · Component preparation

## Top A: the far end (feet for ALEX 1)

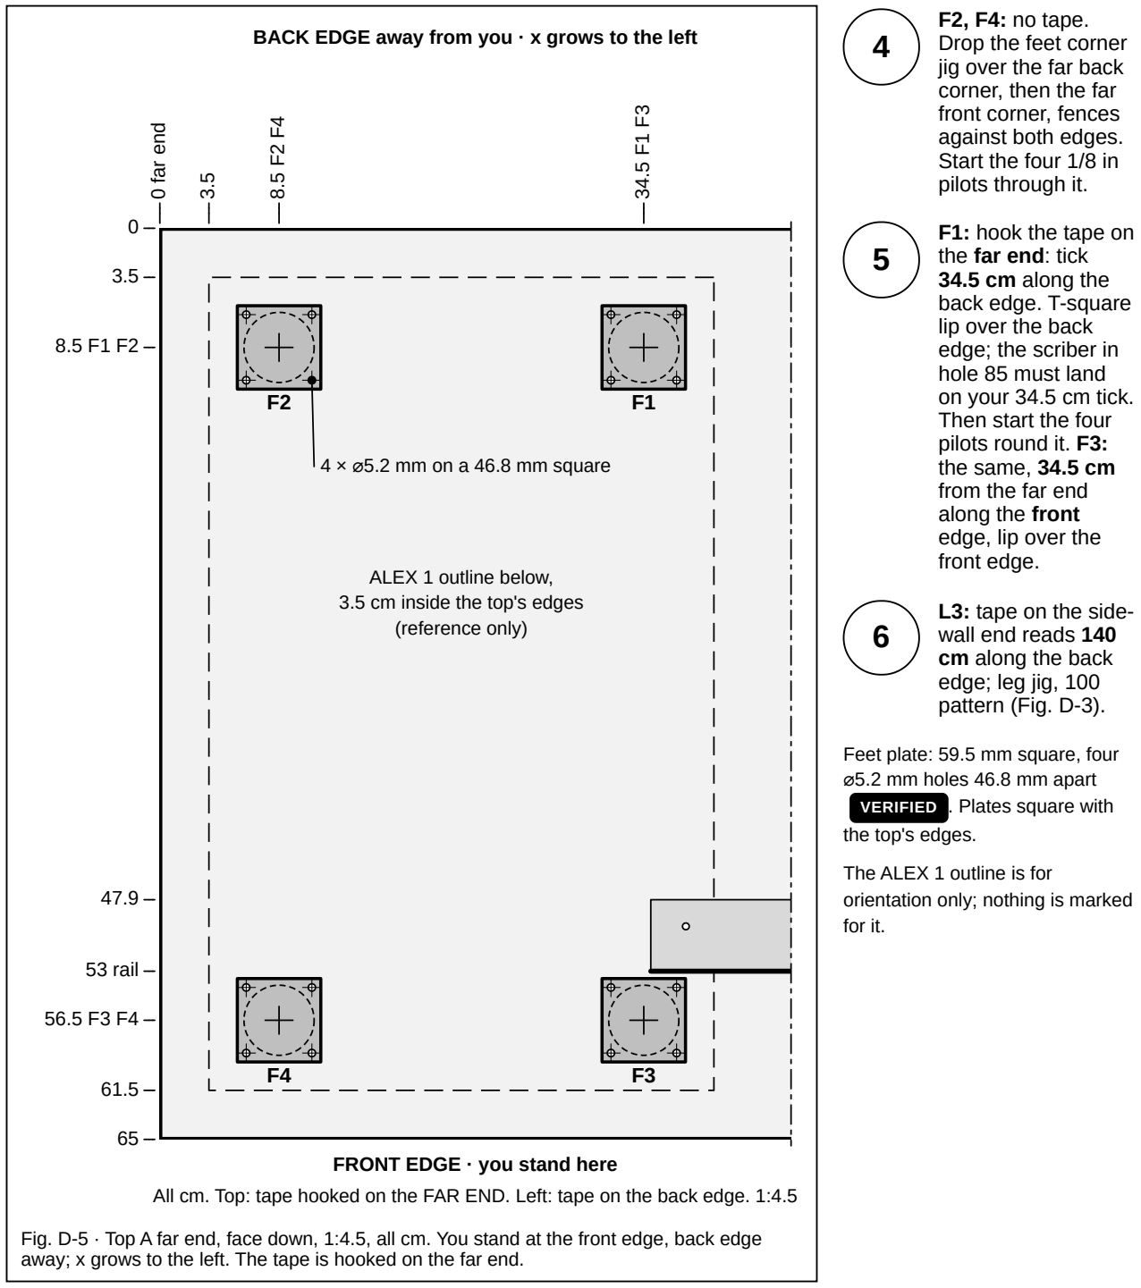
[picture p156: figure]
0 far end; 53 rail; ALEX 1 outline below, 3.5 cm inside the top's edges (reference only); 4 × ⌀5.2 mm on a 46.8 mm square; FRONT EDGE · you stand here; F2, F4: no tape. Drop the feet corner jig over the far back corner, then the far front corner, fences against both edges. Start the four 1/8 in pilots through it.; F1: hook the tape on the far end: tick 34.5 cm along the back edge. T-square lip over the back edge; the scriber in hole 85 must land on your 34.5 cm tick. Then start the four pilots round it. F3: the same, 34.5 cm from the far end along the front edge, lip over the front edge.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

All cm. Top: tape hooked on the FAR END. Left: tape on the back edge. 1:4.5

BACK EDGE away from you · x grows to the left

Fig. D-5 · Top A far end, face down, 1:4.5, all cm. You stand at the front edge, back edge away; x grows to the left. The tape is hooked on the far end.

L-Shaped Corner Desk · Assembly Manual | D · Component preparation

## Top B, face down: overview

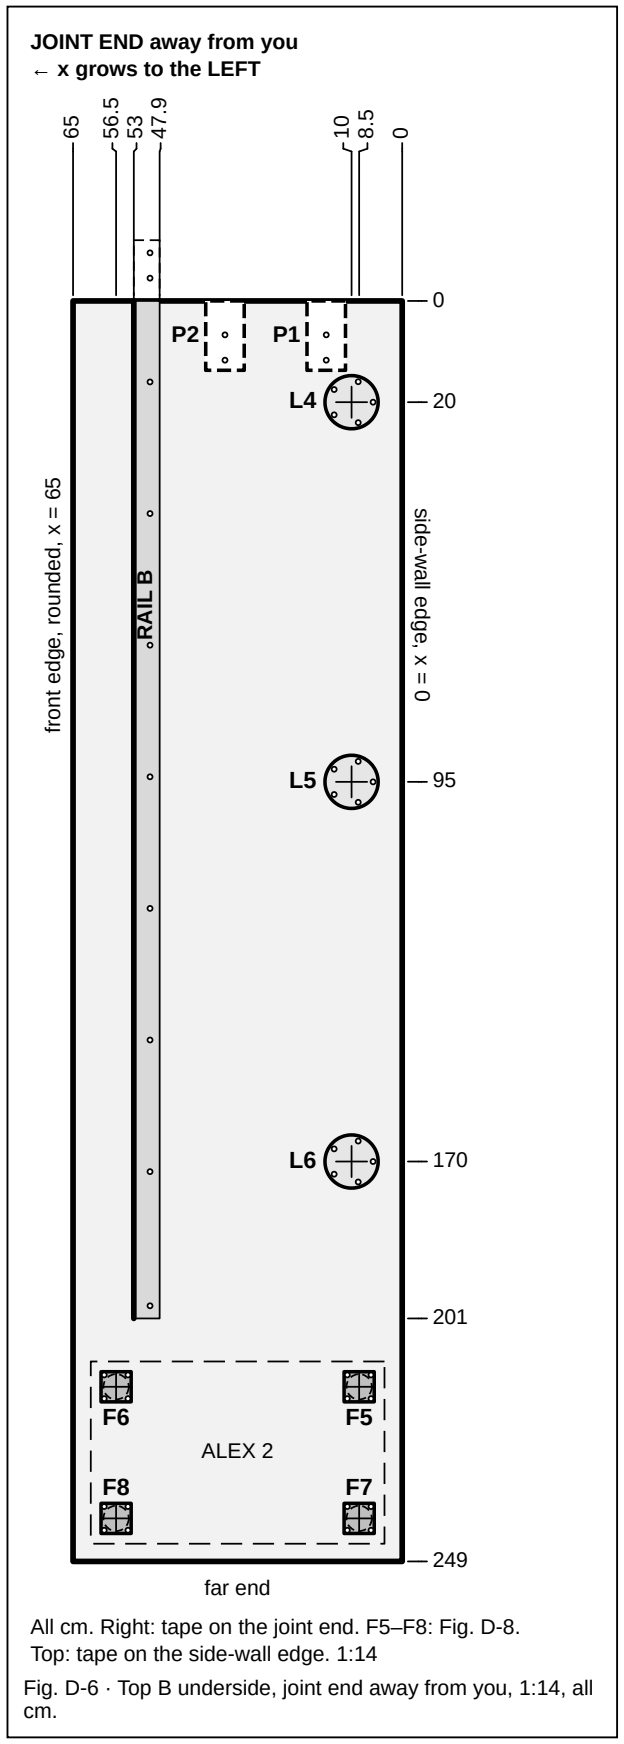
[picture p157: figure]
JOINT END away from you ← x grows to the LEFT; far end; front edge, rounded, x = 65; side-wall edge, x = 0; AIL B; ALEX 2; Top: tape on the side-wall edge. 1:14

All cm. Right: tape on the joint end. F5–F8: Fig. D-8.

Fig. D-6 · Top B underside, joint end away from you, 1:14, all

7

Calipers on top B MEASURE ON HARDWARE . 28 mm expected. If a top measures 27 mm, nothing changes: the deepest screw still stops 6 mm short of the laminate. Under 27 mm, stop and ask. Tape its unfinished long edge ("B · SIDE-WALL EDGE") and the short end that will butt against top A ("B · JOINT END"). Lay it face down and stand at the far end, joint end away from you: the side-wall edge is on your right.

On top B the legs, the rail line and the plates are read with the tape hooked on the joint end; the feet F5, F6 with the tape hooked on the far end. The numbers below are what the tape shows.

Mark | Tape reads (cm), hooked on the joint end unless marked | Then
L4 | 20 | along the side-wall edge; leg jig, 100 pattern, lip over the side-wall edge
L5 | 95
L6 | 170
F5 | far end: 34.5 | tape hooked on the far end, along the side-wall edge; T-square hole 85 on the tick, lip over the side-wall edge
F6 | far end: 34.5 | tape hooked on the far end, along the front edge; T-square hole 85 on the tick, lip over the front edge
F7, F8 | no tape | feet corner jig on the two far corners
Rail B line | 0 to 201 | at 53 cm from the side-wall edge (12 cm from the front edge); the vertical leg's outer face goes on it; the rail's corner end sticks out 12 cm past the joint end
P1 / P2 | 0 to 13.7 | outline only, 11.2–18.8 / 31.2– 38.8 cm from the side-wall edge; screws in chapter H at 6.7 and 11.7 cm

All positions SOURCE-DEFINED (design positions). L4–L6 have one pilot pointing at the side wall, like L2 and L3.

L-Shaped Corner Desk · Assembly Manual | D · Component preparation

## Top B: the joint end

P2 | P1

1

0

0 L4

15 P1

35 P2
47.9

53 rail B line

65

rail B end, 12 past

0 joint end

6.7

11.7
13.7 P1 P2 end
L4 | 20 L4

top A goes here (not this top)

rail B sticks out 12 cm past the joint end

All cm. Top: tape hooked on the side-wall edge. Right: tape hooked on the joint end.
Joint end away from you, x grows to the left. Scale 1:5 Fig. D-7 · Top B joint end, face down, 1:5, all cm. The hatched area beyond the joint end is where top A will be; rail B's corner end lies there.

8

L4: tape hooked on the joint end reads 20 cm along the side-wall edge; leg jig, 100 pattern, lip over the side-wall edge. Draw the rail B line: tape hooked on the side-wall edge, tick 53 cm near each end and in the middle; join the ticks from the joint end to 201 cm on the joint-end tape. Draw the P1 and P2 outlines from the joint end to 13.7 cm.

Rail B's holes 1 and 2 (shown beyond the joint end) go into top A when the tops are joined in chapter H; on top B only its holes 3 to 10 are used (chapter F).

L-Shaped Corner Desk · Assembly Manual | D · Component preparation

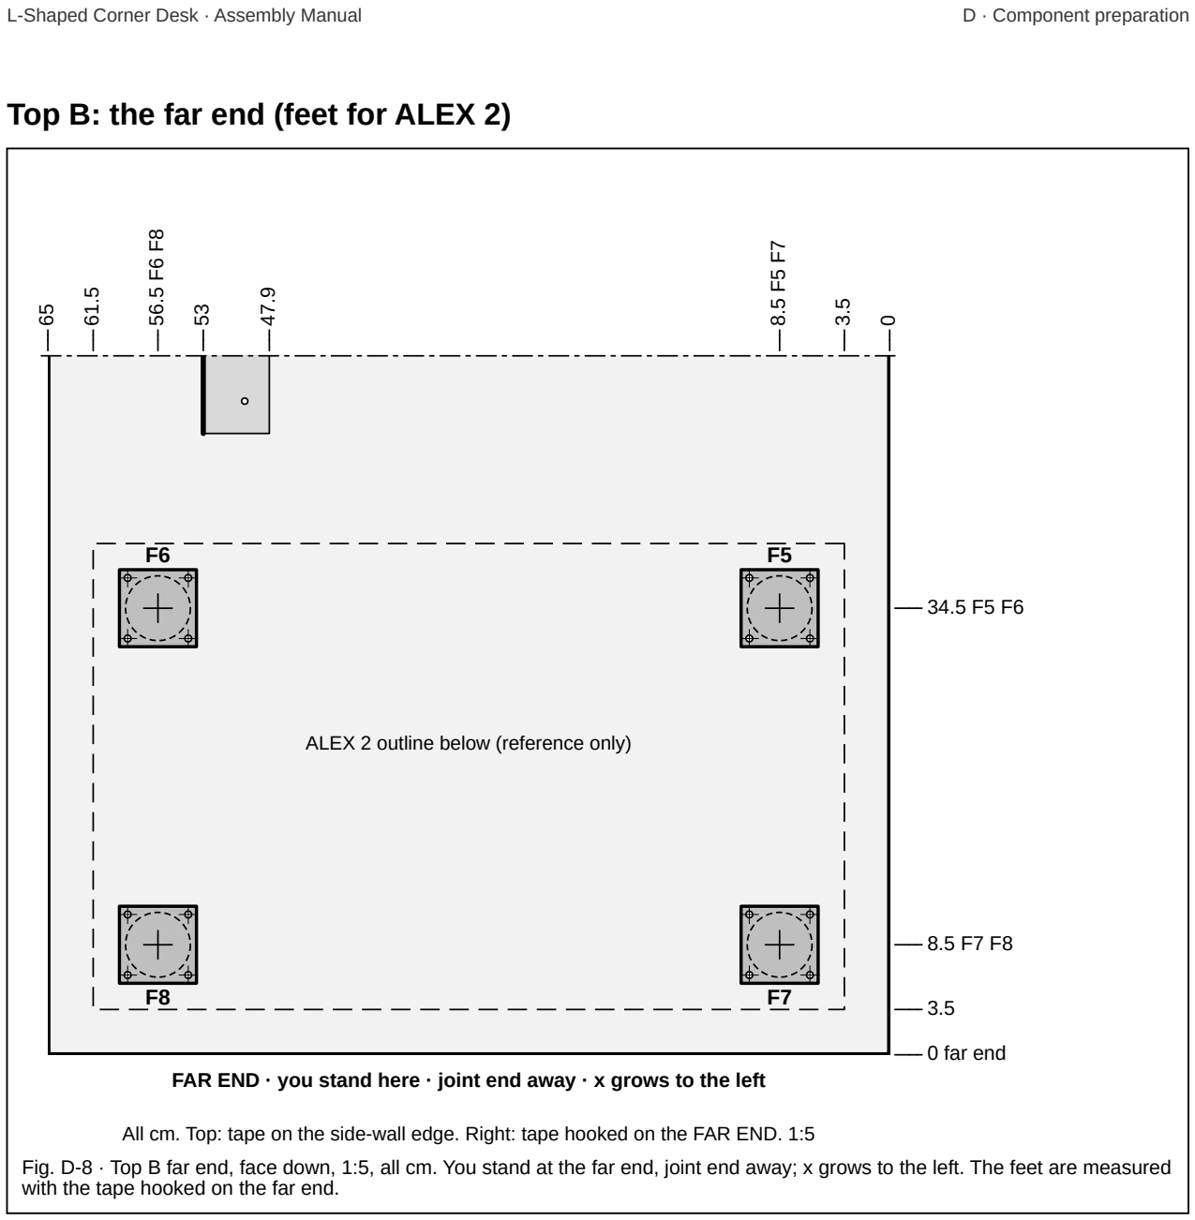
[picture p158: figure]
Top B: the far end (feet for ALEX 2); 0 far end; ALEX 2 outline below (reference only); with the tape hooked on the far end.

FAR END · you stand here · joint end away · x grows to the left

All cm. Top: tape on the side-wall edge. Right: tape hooked on the FAR END. 1:5 Fig. D-8 · Top B far end, face down, 1:5, all cm. You stand at the far end, joint end away; x grows to the left. The feet are measured

9

F7, F8: no tape: feet corner jig over the two far corners, fences against both edges; start the four 1/8 in pilots. F5: hook the tape on the far end: tick 34.5 cm along the side-wall edge; T-square lip over the side-wall edge, the scriber in hole 85 must land on the tick. F6: the same, 34.5 cm from the far end along the front edge, lip over the front edge. L5, L6: leg jig, 100 pattern, at 95 cm and 170 cm on the joint-end tape (Fig. D-6).

L-Shaped Corner Desk · Assembly Manual | D · Component preparation

## Rails: labels and orientation

10

The two steel angles arrive identical; either can be rail A. Tape one end of each: "A · WALL END" and "B · CORNER END". Every station on a rail is measured from its taped end. Measure both delivered lengths MEASURE ON HARDWARE (213 cm layout length; the far end may carry the extra).

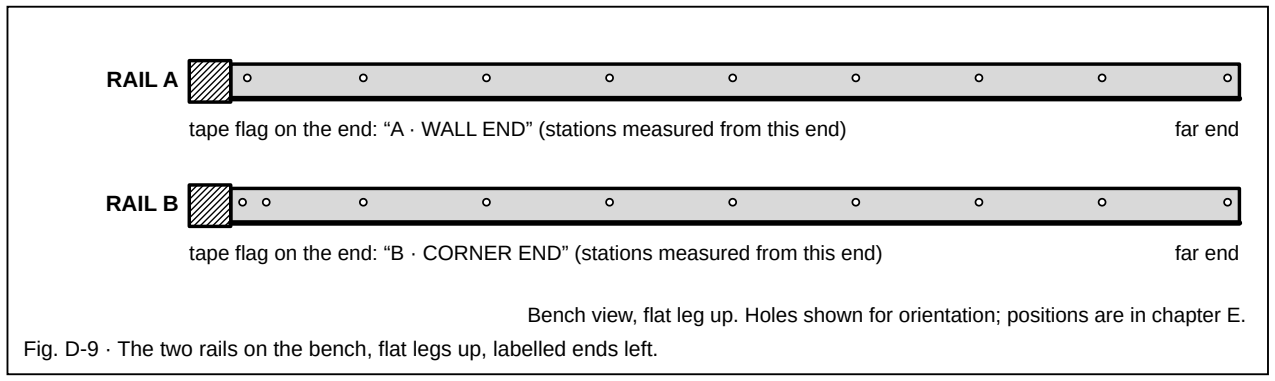
[picture p159: figure]
RAIL A; RAIL B

tape flag on the end: “A · WALL END” (stations measured from this end) | far end
tape flag on the end: “B · CORNER END” (stations measured from this end) | far end

Bench view, flat leg up. Holes shown for orientation; positions are in chapter E. Fig. D-9 · The two rails on the bench, flat legs up, labelled ends left.

flat leg UP, tight against the underside vertical leg DOWN, on the front-edge side its outer face on the rail line (top A: y = 53 cm)

12 cm to the front edge

TOP A, laminate up (as installed) | front edge

← back wall side

Section through top A and rail A, end-on, about 1:2. Rail B on top B: the same, outer face on x = 53 cm. Fig. D-10 · How a rail sits under its top: flat leg UP against the underside, all screws through it; vertical leg DOWN on the front-edge side, its outer face on the rail line, 12 cm from the front edge. Rail A: outer face at 53 cm from the back edge, wall end 1 cm in from the side-wall end. Rail B: outer face at 53 cm from the side-wall edge, corner end 12 cm past top B's joint end.

The printed rail end caps are handed: cap A fits rail A's far end (print 1); cap B fits rail A's wall end and rail B's far end (print 2); rail B's corner end is bolted to rail A and takes no cap.

L-Shaped Corner Desk · Assembly Manual | D · Component preparation

## Hole types and depths

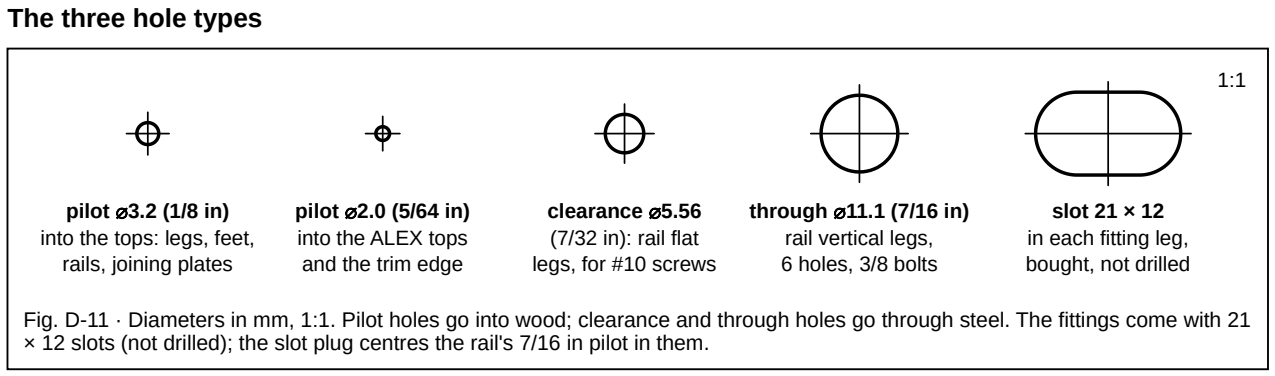
[picture p160: figure]
The three hole types; pilot ⌀3.2 (1/8 in) into the tops: legs, feet, rails, joining plates; pilot ⌀2.0 (5/64 in) into the ALEX tops and the trim edge; clearance ⌀5.56 (7/32 in): rail flat legs, for #10 screws; through ⌀11.1 (7/16 in) rail vertical legs, 6 holes, 3/8 bolts; slot 21 × 12 in each fitting leg, bought, not drilled

Fig. D-11 · Diameters in mm, 1:1. Pilot holes go into wood; clearance and through holes go through steel. The fittings come with 21 × 12 slots (not drilled); the slot plug centres the rail's 7/16 in pilot in them.

Every fastener, its pilot and its puck

Fastener | Qty | Goes through | Into the wood (mm) | Pilot | Puck
H01 · M4 × 16 (with the OLOV) | 30 | leg plate, about 3 mm | 13 | 1/8 in, 15 mm deep | 15 LEG
H02 · #8 × 5/8 in pan head | 32 | feet plate, about 1.5–2 mm | 14 | 1/8 in, 15 mm deep | 15 LEG
H03 · #10 × 1 in pan head, Robertson | 19 | 4.8 mm angle | 20.6 | 1/8 in: the 25 RAIL puck stands on the steel and stops the bit 20 mm into the wood | 25 RAIL
H04 + H05 · #10 × 5/8 in with washer | 16 | 3 mm joining plate | 13 | 1/8 in, 12 mm deep, plate OFF, puck standing on the wood | 12 PLATE
H06 · #6 × 5/8 in flat head | 24 | 2.5 mm ring flange | 13.4, into the 15.9 mm ALEX top | 5/64 in, 12 mm deep | 12 ALEX
H07 · #4 × 1/2 in flat head (optional trim) | 48 | trim lip | sideways into the raw back edge, 14 mm below the surface | 5/64 in, 10 mm deep | 10 EDGE
H08 + H09 + H10 · 3/8-16 bolts | 6 | fittings and rail vertical legs | none | 7/16 in, bench-drilled | —

Depths SOURCE-DEFINED (guide.html fastener table, facts.json). The bolt holes and the 7/32 in screw holes in the steel are drilled on the bench (chapter E); everything into wood goes through a jig first and is finished with its puck.

L-Shaped Corner Desk · Assembly Manual | D · Component preparation

## Never through the laminate

!

NEVER THROUGH THE LAMINATE
No screw tip and no pilot goes deeper than 21 mm into a 28 mm top: at least 7 mm of wood must remain under the laminate face. Set every pilot depth with the drill guide's puck, never by eye. 28 mm expected. If a top measures 27 mm, nothing changes: the deepest screw still stops 6 mm short of the laminate. Under 27 mm, stop and ask.

### 21 mm LIMIT: no screw tip and no pilot past this line

7 mm of wood must remain above the laminate

laminate face (desk surface), down on the blanket

28 m

m

OLOV plate
M4 × 16

13

pilot 15
15 LEG

foot plate
#8 × 5/8

14

pilot 15
15 LEG

rail flat leg
#10 × 1

20.6

pilot 20
25 RAIL

joining plate
#10 × 5/8

13

pilot 12
12 PLATE
(25 from the steel face) (plate off, puck on the wood)

trim #4 × 1/2

pilot 10, 10 EDGE,
14 mm below the surface

raw back edge

Section through a 28 mm top, face down as you drill it (underside up), 2:1. Grey: the part being screwed on.
Dashed: the pilot hole. Bold numbers: how far the screw goes into the wood, mm.
Fig. D-12 · Every fastener into the tops at its depth, 2:1, mm. The joining-plate pilot is drilled with the plate off: scribe through its holes, lift it, puck on the wood.

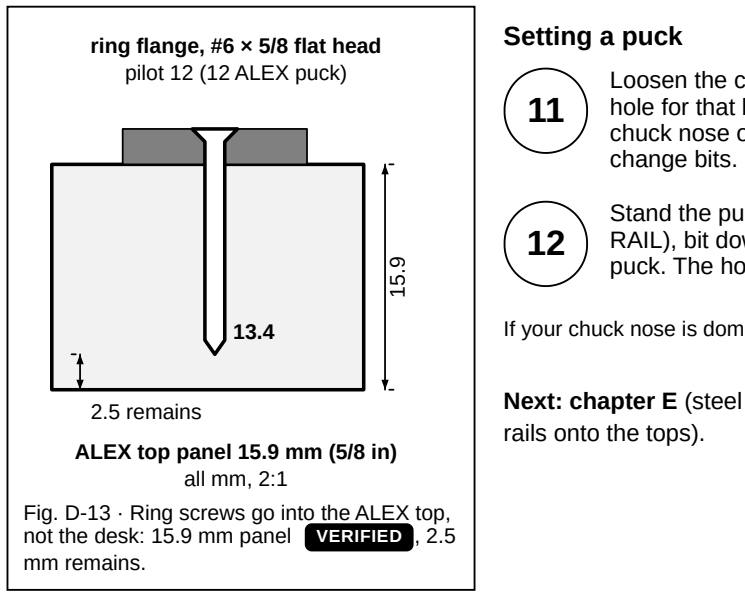
[picture p161: figure]
2.5 remains; ring flange, #6 × 5/8 flat head pilot 12 (12 ALEX puck); ALEX top panel 15.9 mm (5/8 in) all mm, 2:1; mm remains.; Setting a puck; change bits.; rails onto the tops).

Fig. D-13 · Ring screws go into the ALEX top, not the desk: 15.9 mm panel VERIFIED , 2.5

Loosen the chuck. Drop the bit tip-first into the SET tower's hole for that bit (45 mm for 1/8 in, 35 mm for 5/64 in), rest the chuck nose on the tower, tighten. Re-set every time you

Stand the puck flat on the surface (on the rail's flat leg for 25 RAIL), bit down its bore, drill until the chuck nose lands on the puck. The hole is then the depth written on the puck.

If your chuck nose is domed, drill one test hole in scrap and measure it first.

Next: chapter E (steel on the bench), then chapter F (legs, feet and

L-Shaped Corner Desk · Assembly Manual | D · Component preparation

# E · Steel rail fabrication and drilling

All steel work happens on the bench, before either rail goes near a top. Under the desk you only drive screws and bolts; you never drill steel there. Two identical lengths of 2 × 2 × 3/16 in hot-rolled angle arrive; either can be rail A. Tape readings in cm, caliper and drill sizes in mm.

!

MEASURE BEFORE MARKING OR DRILLING MEASURE ON HARDWARE
1 · Tape each rail from end to end and write the length on the tape label. Design length 213 cm; bought as 84 in (2133.6 mm, so about 213.4 cm). If a rail is under 213 cm, stop and check before drilling.
2 · Calipers on each angle: legs 50.8 mm, thickness 4.76 mm (the docs expect about 4.8 mm).
3 · Every station is measured from the labelled end: rail A's wall end, rail B's corner end. The far end carries any extra length. Never centre the hole pattern on the bar and never shift a hole to share out the extra.

1

Check the datum labels. The rail ends were tape-labelled in chapter D: check them (RAIL A · WALL END, RAIL B · CORNER END). Never add a second label to the other end. Measure both rails from those ends (Fig. E-1). File both cut ends of each rail smooth.

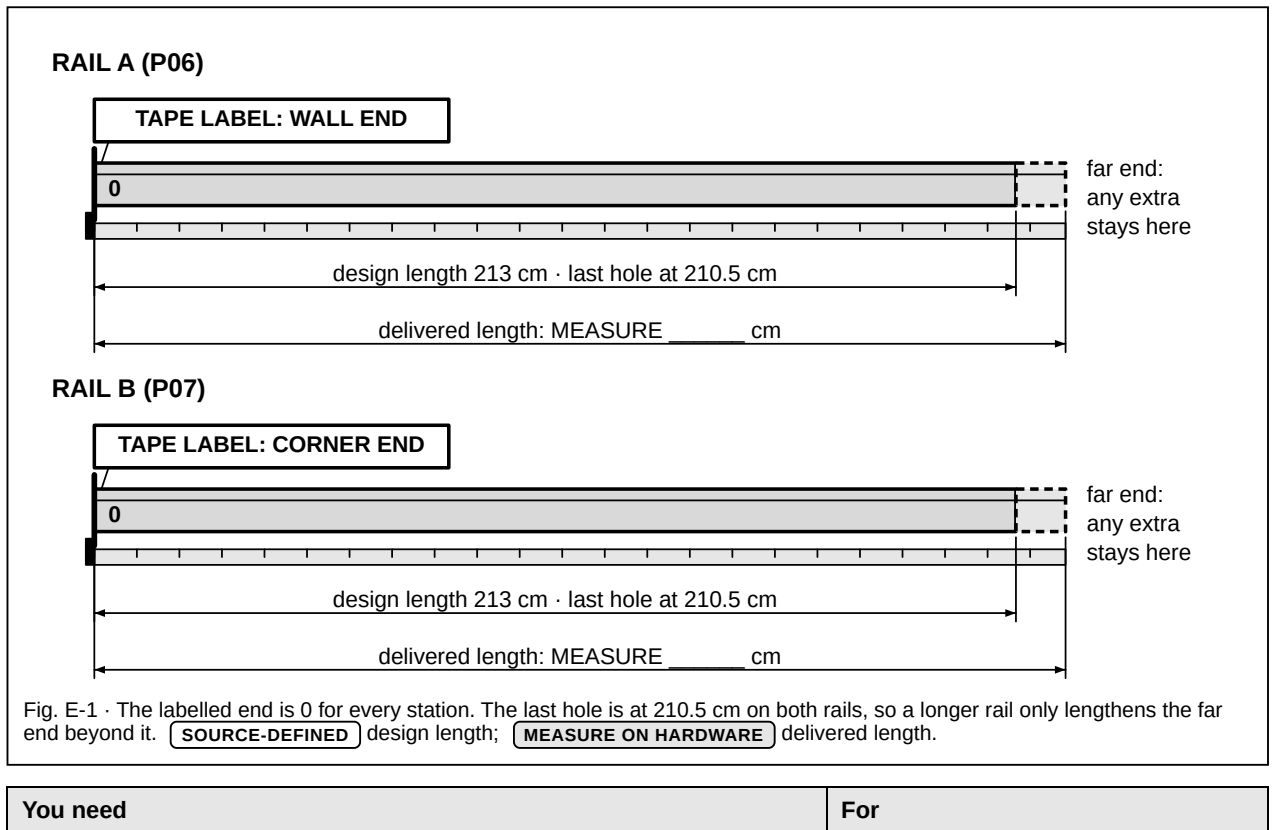
[picture p162: figure]
RAIL A (P06); TAPE LABEL: WALL END; delivered length: MEASURE ______ cm; far end: any extra stays here; RAIL B (P07); TAPE LABEL: CORNER END; You need; For

design length 213 cm · last hole at 210.5 cm

design length 213 cm · last hole at 210.5 cm

Fig. E-1 · The labelled end is 0 for every station. The last hole is at 210.5 cm on both rails, so a longer rail only lengthens the far end beyond it. SOURCE-DEFINED design length; MEASURE ON HARDWARE delivered length.

P06 rail A, P07 rail B; one P08 fitting as the template | the work pieces
P18 printed tools: edge T-square, rail marking gauge, rail drill jig (PETG), 2 fitting slot plugs | stations, the 19 and 29 lines, pilots, bolt-hole transfer
Bits 1/8, 7/32 and 7/16 in (the 7/16 cobalt), cutting oil, flat file, 2 clamps, tape, combination square, pencil | drilling and deburring; a drill press if you have one
Acetone or mineral spirits, 120 grit, flat black enamel | finish (step 9)
L-Shaped Corner Desk · Assembly Manual | E · Steel rails

## Which way up: the section and the two lines

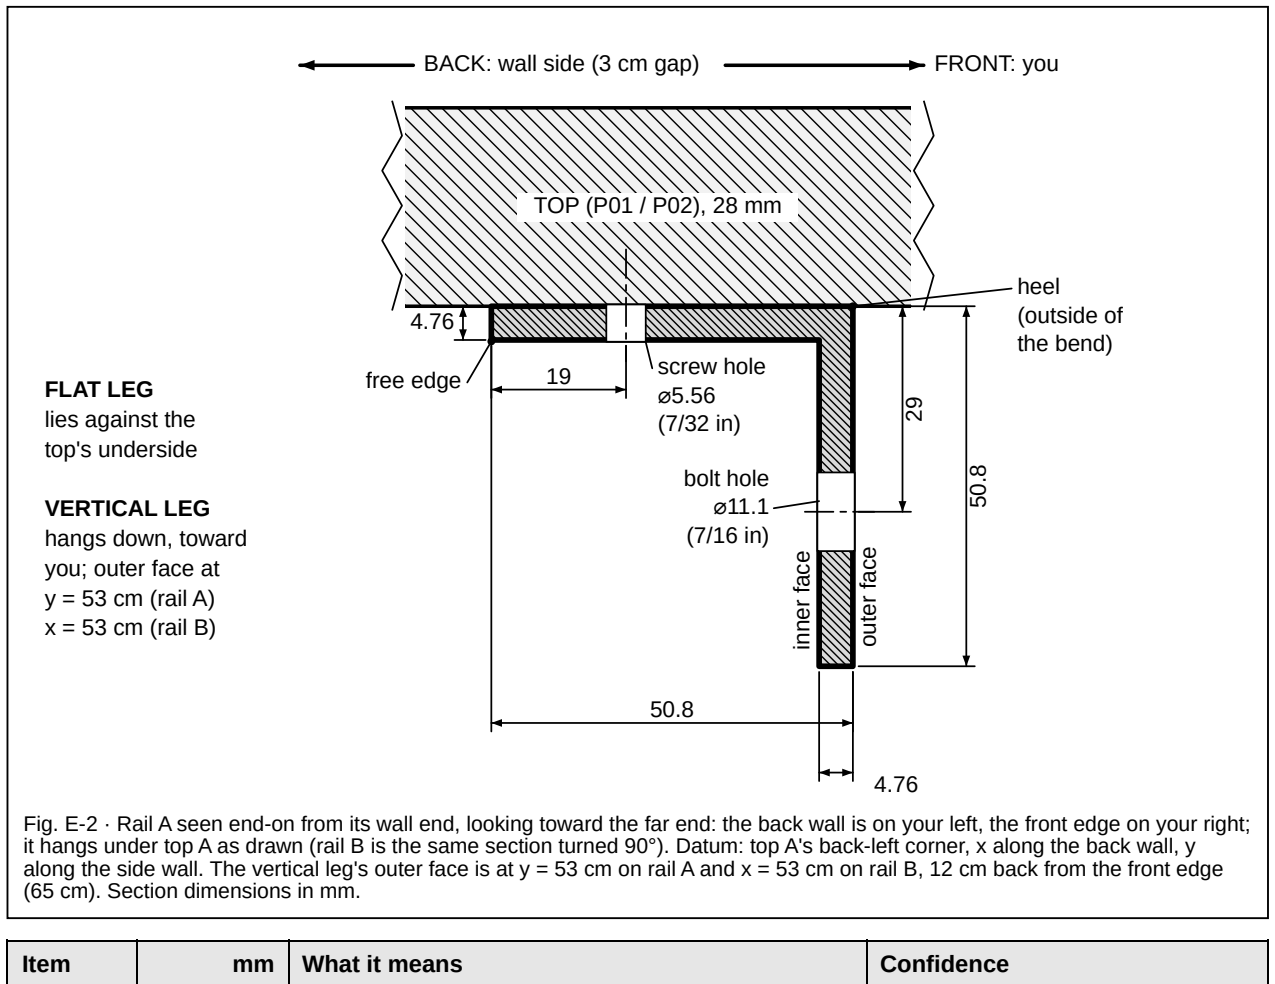
[picture p163: figure]
TOP (P01 / P02), 28 mm; free edge; screw hole ⌀5.56 (7/32 in); bolt hole ⌀11.1 (7/16 in); inner face; outer face; heel (outside of the bend); FLAT LEG lies against the top's underside; VERTICAL LEG hangs down, toward you; outer face at y = 53 cm (rail A) x = 53 cm (rail B); BACK: wall side (3 cm gap); FRONT: you; (65 cm). Section dimensions in mm.; Item; What it means; Confidence

Fig. E-2 · Rail A seen end-on from its wall end, looking toward the far end: the back wall is on your left, the front edge on your right; it hangs under top A as drawn (rail B is the same section turned 90°). Datum: top A's back-left corner, x along the back wall, y along the side wall. The vertical leg's outer face is at y = 53 cm on rail A and x = 53 cm on rail B, 12 cm back from the front edge

Section | 50.8 × 50.8 × 4.76 | 2 × 2 × 3/16 in hot-rolled angle | SOURCE-DEFINED MEASURE ON HARDWARE thickness
Flat leg | | lies against the top's underside; its free edge points to the wall | SOURCE-DEFINED
Vertical leg | | hangs down on the side nearer you; outer face y = 53 cm (A), x = 53 cm (B) | SOURCE-DEFINED
Screw line | 19 | from the flat leg's free edge; centres of the ⌀5.56 (7/32 in) screw holes | SOURCE-DEFINED
Bolt line | 29 | below the heel (the top's underside); centres of the ⌀11.1 (7/16 in) bolt holes | SOURCE-DEFINED
Fitting slots | 21 × 12 | two per P08 leg, centres 29.15 and 78.45 from the heel; legs 100.5 × 41, 5 thick (all mm) | VERIFIED 23 Oct 2026

Bench set-up. Clamp the rail with the flat leg's face up and the vertical leg hanging down over the bench edge. That is how it is marked and how the flat-leg holes are drilled. For the vertical leg (steps 6 and 7) turn it so the vertical leg's outer face is up and the flat leg hangs over the edge.

The two fabrication drawings that follow are full pages, turned sideways: turn the booklet a quarter turn clockwise to read them. Every hole is given from the labelled end, never from the hole before: the drawings carry mm ordinates, the hole table beside each drawing gives the same stations in cm for the tape.

L-Shaped Corner Desk · Assembly Manual | E · Steel rails

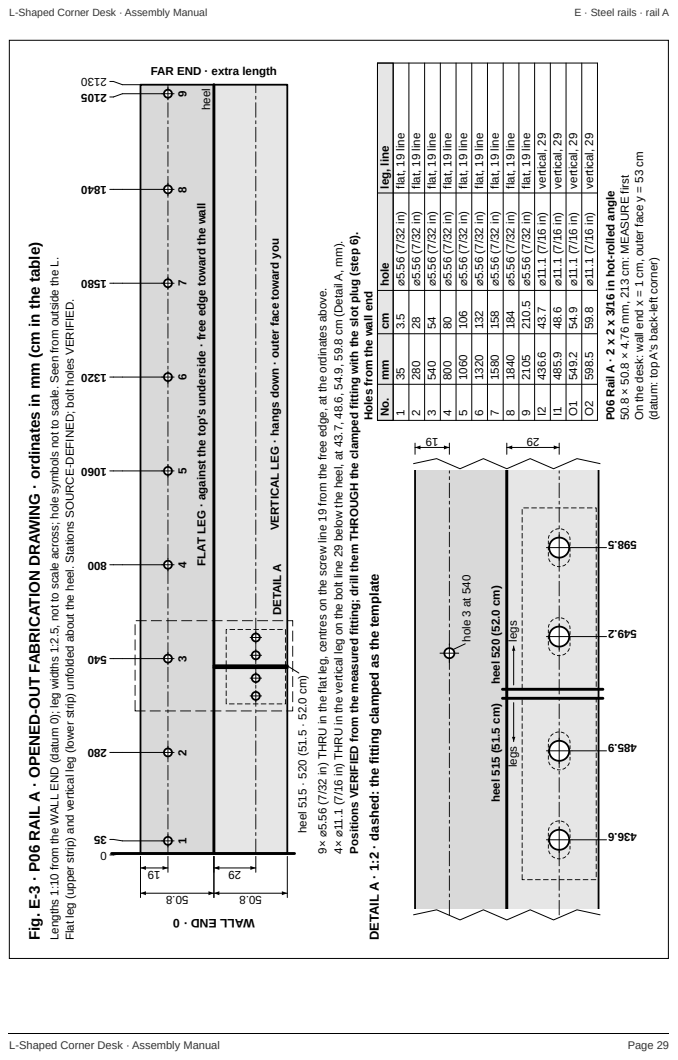
[picture p164: page 29]
Fig. E-3 · P; AIL; RIC; ATIO; AWIN; G · ordin; ate; ble); EFIN; D; bolt holes V; RIFIE; TAIL; ard the w; all; TIC; G · hangs do; ard y; heel; heel 515 · 520 (51.5 · 52.0 cm); ositions V; D fro; H the cla; e fittin; cla; plate; hole 3 at 540; legs; heel 515 (51.5 cm); heel 520 (52.0 cm); oles fro; m the w; all end; I2 436.6 43.7 ⌀11.1 (7/16 in) vertical, 29; I1 485.9 48.6 ⌀11.1 (7/16 in) vertical, 29; O1 549.2 54.9 ⌀11.1 (7/16 in) vertical, 29; O2 598.5 59.8 ⌀11.1 (7/16 in) vertical, 29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

FAR END · extra length

1 35 3.5 ⌀5.56 (7/32 in) flat, 19 line

2 280 28 ⌀5.56 (7/32 in) flat, 19 line

3 540 54 ⌀5.56 (7/32 in) flat, 19 line

4 800 80 ⌀5.56 (7/32 in) flat, 19 line

5 1060 106 ⌀5.56 (7/32 in) flat, 19 line

6 1320 132 ⌀5.56 (7/32 in) flat, 19 line

7 1580 158 ⌀5.56 (7/32 in) flat, 19 line

8 1840 184 ⌀5.56 (7/32 in) flat, 19 line

9 2105 210.5 ⌀5.56 (7/32 in) flat, 19 line

m cm hole leg, line

all end x = 1 cm, outer face y = 53 cm

ail A · 2 x 2 x 3/16 in hot-rolled angle

mped fitting with the slot plug (step 6).

D (datum 0); leg widths 1:2.5, not to scale across; hole symbols not to scale. Seen from outside the L.

U in the vertical leg on the bolt line 29 below the heel, at 43.7, 48.6, 54.9, 59.8 cm (Detail A, m

(datum: top A's back-left corner)

G · against the top's underside · free edge to

wn · outer face to

U in the flat leg, centres on the screw line 19 from the free edge, at the ordinates above.

On the desk: w

Flat leg (upper strip) and vertical leg (lower strip) unfolded about the heel. Stations S

m the measured fitting; drill them

Lengths 1:10 from the WALL E

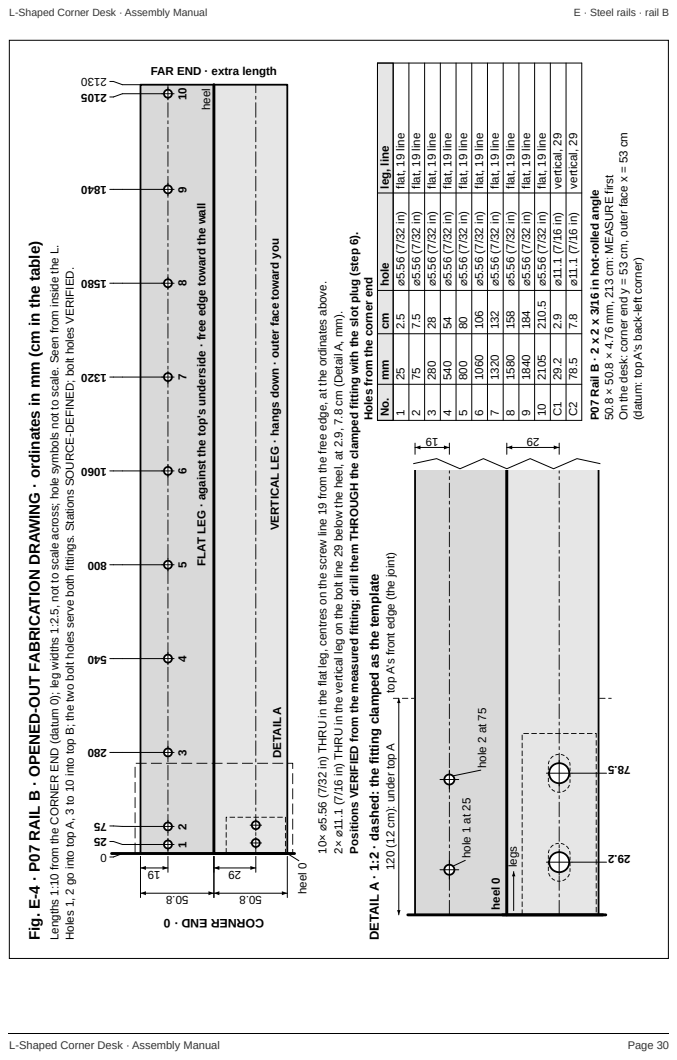
[picture p165: page 30]
Fig. E-4 · P; AIL; RIC; ATIO; AWIN; G · ordin; ate; ble); EFIN; D; bolt holes V; RIFIE; TAIL; ard the w; all; TIC; G · hangs do; ard y; heel; heel 0; ositions V; D fro; H the cla; e fittin; cla; plate; hole 1 at 25; hole 2 at 75; legs; oles fro; C1 29.2 2.9 ⌀11.1 (7/16 in) vertical, 29; C2 78.5 7.8 ⌀11.1 (7/16 in) vertical, 29; E first; L-Shaped Corner Desk · Assembly Manual; E · Steel rails · rail B

FAR END · extra length

On the desk: corner end y = 53 cm, outer face x = 53 cm

1 25 2.5 ⌀5.56 (7/32 in) flat, 19 line

2 75 7.5 ⌀5.56 (7/32 in) flat, 19 line

3 280 28 ⌀5.56 (7/32 in) flat, 19 line

4 540 54 ⌀5.56 (7/32 in) flat, 19 line

5 800 80 ⌀5.56 (7/32 in) flat, 19 line

6 1060 106 ⌀5.56 (7/32 in) flat, 19 line

7 1320 132 ⌀5.56 (7/32 in) flat, 19 line

8 1580 158 ⌀5.56 (7/32 in) flat, 19 line

9 1840 184 ⌀5.56 (7/32 in) flat, 19 line

10 2105 210.5 ⌀5.56 (7/32 in) flat, 19 line

m cm hole leg, line

ail B · 2 x 2 x 3/16 in hot-rolled angle

mped fitting with the slot plug (step 6).

D (datum 0); leg widths 1:2.5, not to scale across; hole symbols not to scale. Seen from inside the L.

(datum: top A's back-left corner)

G · against the top's underside · free edge to

m the corner end

wn · outer face to

U in the flat leg, centres on the screw line 19 from the free edge, at the ordinates above.

U in the vertical leg on the bolt line 29 below the heel, at 2.9, 7.8 cm (Detail A, m

Holes 1, 2 go into top A, 3 to 10 into top B; the two bolt holes serve both fittings. Stations S

m the measured fitting; drill them

120 (12 cm): under top A top A's front edge (the joint)

Lengths 1:10 from the C

2

Mark the stations. Hook the tape over the labelled end and tick every station on the flat leg from that one hook: rail A 3.5, 28, 54, 80, 106, 132, 158, 184, 210.5 cm; rail B 2.5, 7.5, 28, 54, 80, 106, 132, 158, 184, 210.5 cm. Square each tick across the leg along the T-square's blade, its lip hooked over the heel edge.

Heel marks. On rail A, turn the vertical leg's outer face up and scribe (do not pencil) the heel positions at 51.5 cm and 52.0 cm from the wall end, squared across the leg. On rail B scribe a 0 on the vertical leg's outer face at the corner end. Scribed lines survive the paint; pencil does not.

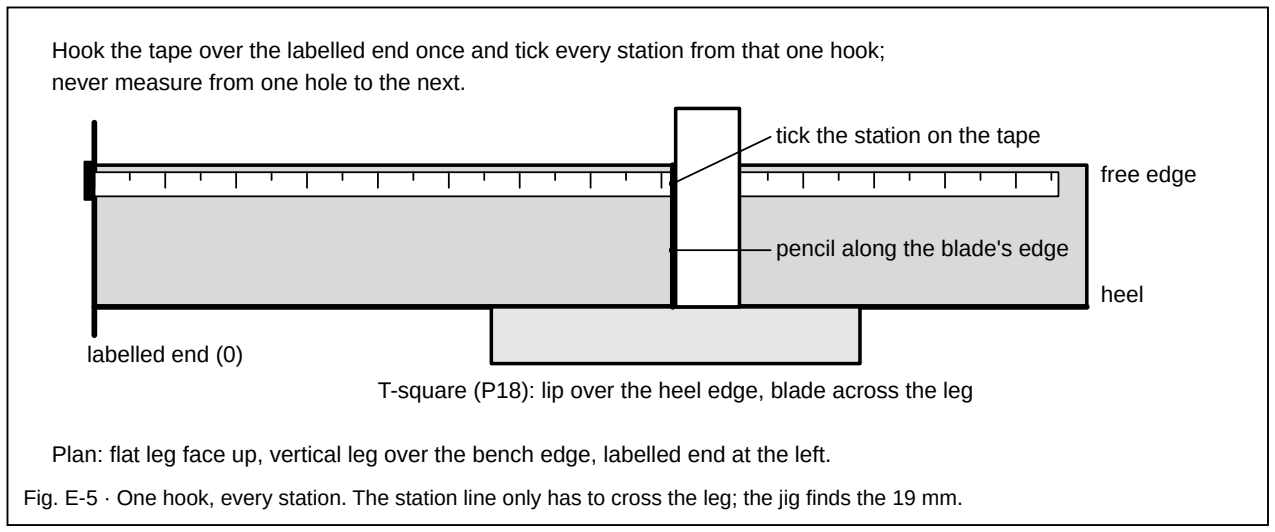
[picture p166: figure]
free edge; heel; labelled end (0); tick the station on the tape; pencil along the blade's edge

T-square (P18): lip over the heel edge, blade across the leg

Hook the tape over the labelled end once and tick every station from that one hook; never measure from one hole to the next.

Plan: flat leg face up, vertical leg over the bench edge, labelled end at the left.

Fig. E-5 · One hook, every station. The station line only has to cross the leg; the jig finds the 19 mm.

3

Pencil the two lines with the rail marking gauge, full length. Screw line: lip over the flat leg's free edge, pencil in the 19 notch, slide. Bolt line: gauge on the vertical leg's outer face, lip over the heel, pencil in the 29 notch, slide. The bolt line is only a check: the fitting's holes must sit on it in step 6.

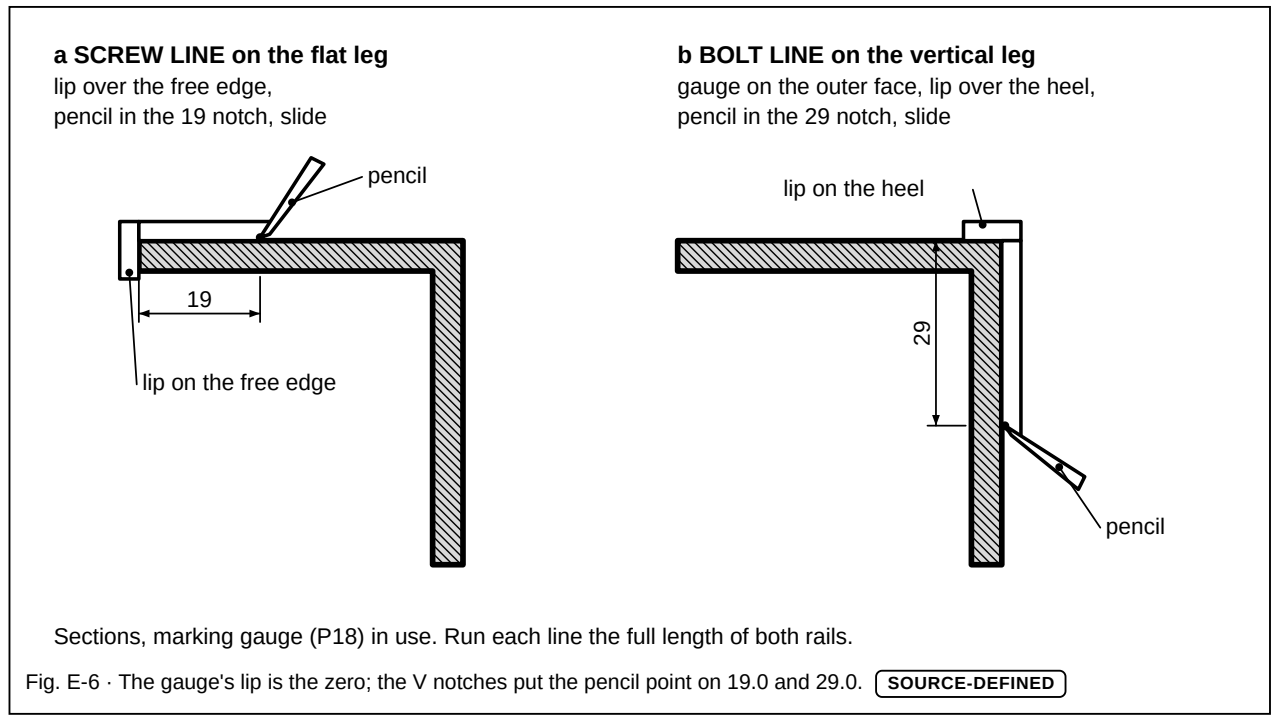
[picture p167: figure]
a SCREW LINE on the flat leg lip over the free edge, pencil in the 19 notch, slide; lip on the free edge; pencil; b BOLT LINE on the vertical leg; pencil in the 29 notch, slide; lip on the heel

gauge on the outer face, lip over the heel,

Sections, marking gauge (P18) in use. Run each line the full length of both rails.

Fig. E-6 · The gauge's lip is the zero; the V notches put the pencil point on 19.0 and 29.0. SOURCE-DEFINED

L-Shaped Corner Desk · Assembly Manual | E · Steel rails

4

Pilot the screw holes through the drill jig. Jig lip down over the flat leg's free edge, sight grooves on the station line, hold it down and drill 1/8 in through its bore: square, on the 19 mm line, no punch needed. All 19 stations (9 on rail A, 10 on rail B). Use a drill press if you have one.

5

Open and deburr. Jig off. Open every pilot to ⌀5.56 (7/32 in) at low speed with a drop of oil on each; the bit follows the pilot. Deburr both faces with the file or a larger bit turned by hand.

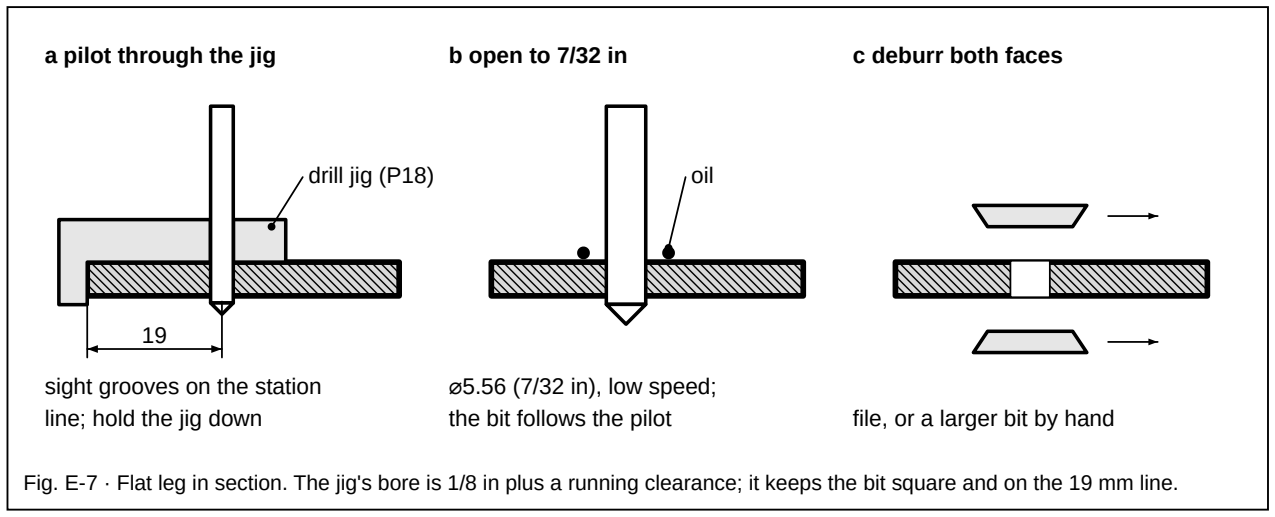
[picture p168: figure]
a pilot through the jig; drill jig (P18); sight grooves on the station line; hold the jig down; b open to 7/32 in; oil; ⌀5.56 (7/32 in), low speed; the bit follows the pilot; c deburr both faces; file, or a larger bit by hand

Fig. E-7 · Flat leg in section. The jig's bore is 1/8 in plus a running clearance; it keeps the bit square and on the 19 mm line.

!

THE FITTING IS THE TEMPLATE VERIFIED
The fittings were measured on 23 Oct 2026: legs 100.5 × 41, two 21 × 12 slots per leg with centres 29.15 and 78.45 mm from the heel. That puts the six bolt holes at the positions below. Even so, do not lay them out with the tape: clamp the fitting on its heel mark and drill through it with the printed slot plug (steps 6 and 7), so each hole lands on its slot's centre. Check first that a plug drops into each slot without rattle. The heel of a fitting is the outside of its bend.
Clamp the fitting | Heel on | Legs toward | Holes it makes (cm from the labelled end)
Rail A, outside fitting | the 52.0 cm mark | the far end | O1 54.9, O2 59.8
Rail A, inside fitting | the 51.5 cm mark | the wall end | I1 48.6, I2 43.7
Rail B, one fitting (both share the holes) | the corner end itself (0) | the far end | C1 2.9, C2 7.8

Heel stations SOURCE-DEFINED ; hole positions from the measured slot centres VERIFIED . Both fittings are identical, so holes copied from one fit the other.

L-Shaped Corner Desk · Assembly Manual | E · Steel rails

6

Clamp the fitting and pilot through the plugs. Rail with the vertical leg's outer face up. Clamp one fitting to the vertical leg with its heel exactly on the mark and its holes centred on the 29 mm line, legs the way Fig. E-8 shows. Drop a slot plug into each slot and drill the 1/8 in pilot through each plug's bore into the rail. Repeat for each of the three placements.

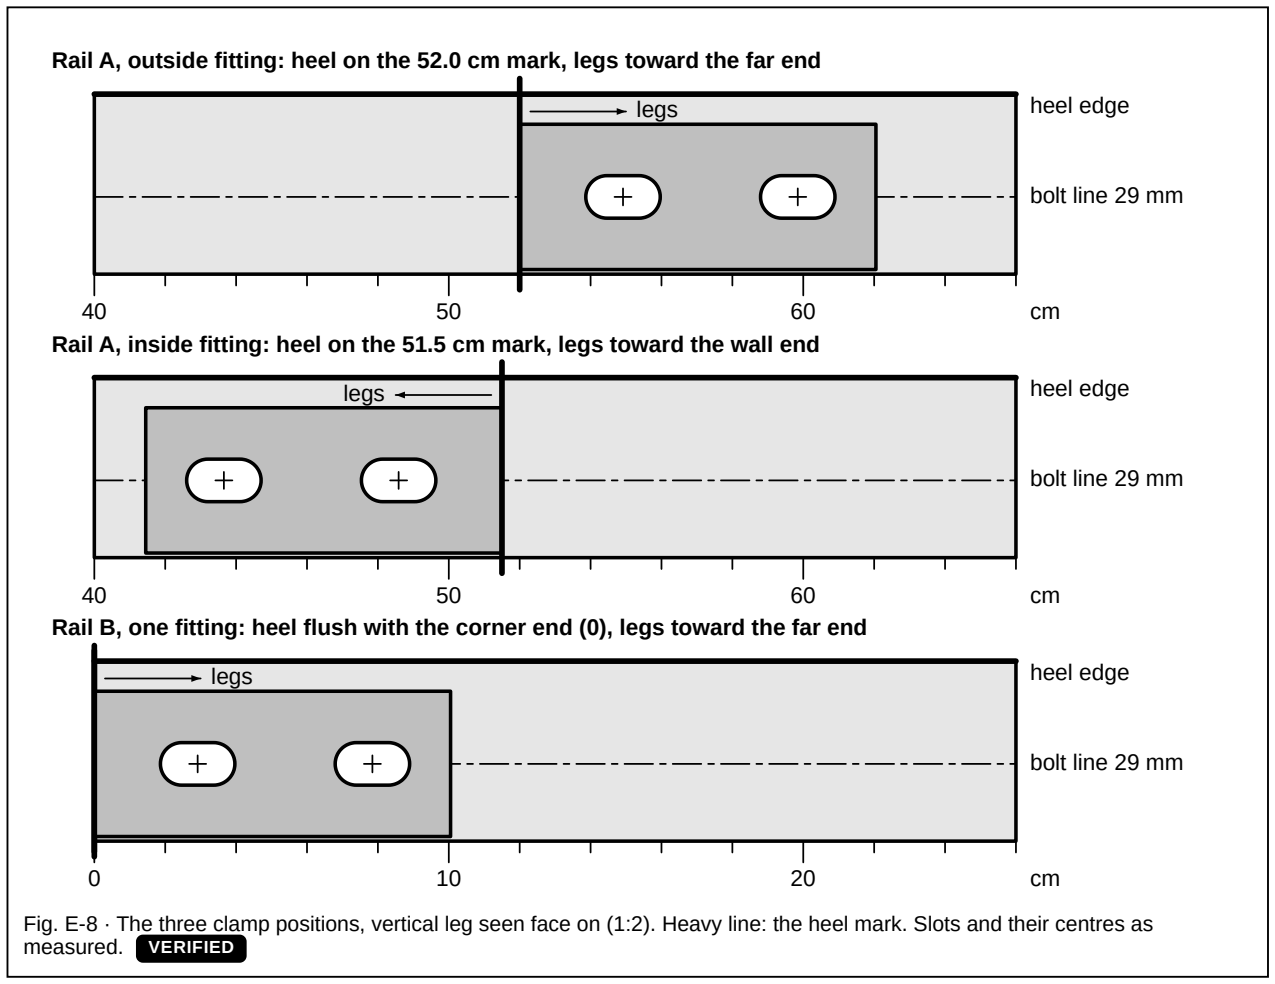
[picture p169: figure]
heel edge; bolt line 29 mm; legs; measured. VERIFIED

Rail A, outside fitting: heel on the 52.0 cm mark, legs toward the far end

Rail A, inside fitting: heel on the 51.5 cm mark, legs toward the wall end

Rail B, one fitting: heel flush with the corner end (0), legs toward the far end

Fig. E-8 · The three clamp positions, vertical leg seen face on (1:2). Heavy line: the heel mark. Slots and their centres as

L-Shaped Corner Desk · Assembly Manual | E · Steel rails

7

Fitting off, open to ⌀11.1 (7/16 in). Cobalt bit, slow, oil on each. The bit follows the pilot, so the hole lands on the slot's centre, not anywhere along its 21 mm. Deburr. Six holes: four in rail A, two in rail B.

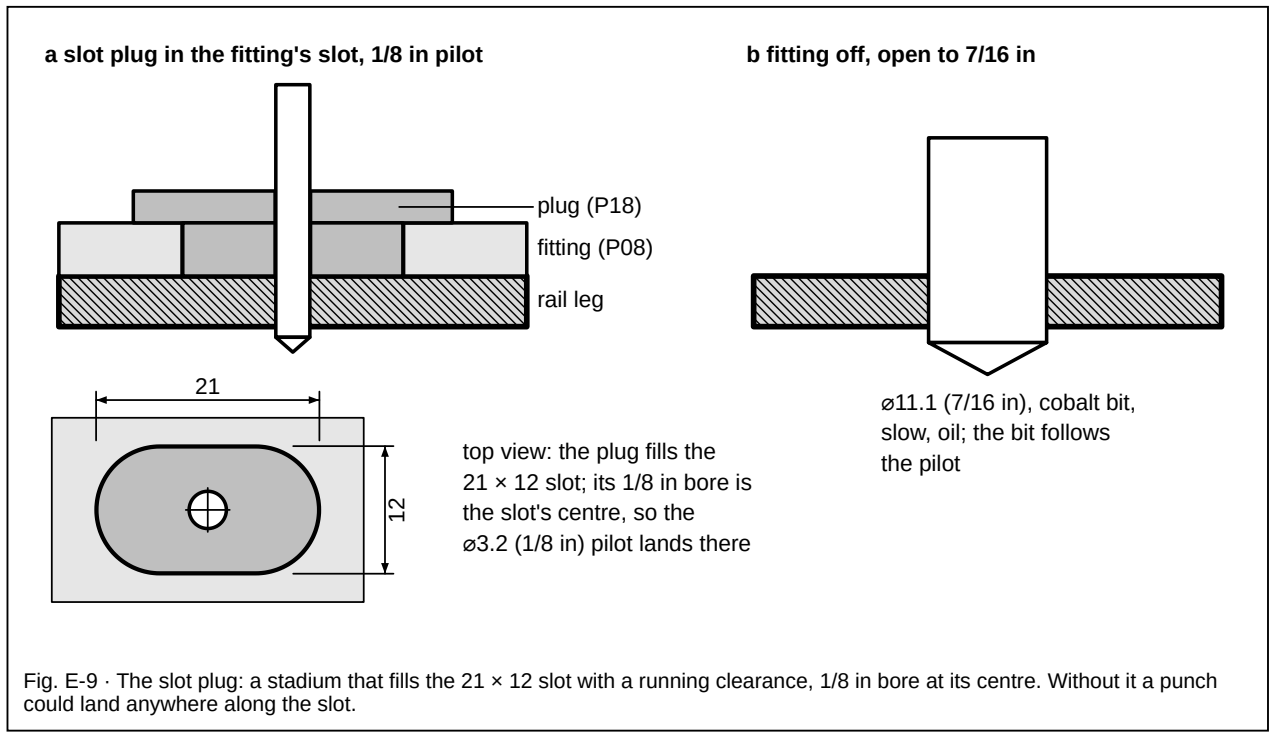
[picture p170: figure]
plug (P18); fitting (P08); rail leg; top view: the plug fills the 21 × 12 slot; its 1/8 in bore is the slot's centre, so the ⌀3.2 (1/8 in) pilot lands there; b fitting off, open to 7/16 in; ⌀11.1 (7/16 in), cobalt bit, slow, oil; the bit follows the pilot; could land anywhere along the slot.

a slot plug in the fitting's slot, 1/8 in pilot

Fig. E-9 · The slot plug: a stadium that fills the 21 × 12 slot with a running clearance, 1/8 in bore at its centre. Without it a punch

L-Shaped Corner Desk · Assembly Manual | E · Steel rails

!

WHY THE HOLES ON BOTH RAILS MEET WITHOUT A JIG VERIFIED
1 · The same fitting is the template for all three placements: rail A heel on the 52.0 cm mark legs toward the far end, rail A heel on the 51.5 cm mark legs toward the wall end, rail B heel flush with the corner end.
2 · The slot plug puts every pilot on a slot centre, 29.15 and 78.45 mm from wherever the heel sat. So when a fitting is bolted on, its slots sit over the holes it made.
3 · Both fittings are identical, so the inside one fits the holes the outside one made.
4 · What makes the two rails meet at the corner is rail B's end against rail A's vertical leg with B's outer face on the 52.0 cm mark. The floor test (step 8) proves it before painting: every bolt must slide in by hand. If one won't, open that rail hole with a round file now, never under the desk.
The rail drill jig is only for the 19-line screw holes, on either rail; it plays no part in the bolt holes.

### 1 One fitting, three placements. Rail A, vertical leg:

heel on 51.5 cm, legs → wall end heel on 52.0 cm, legs → far end

slot centres
29.15 and
78.45 mm from
the heel

Rail B, vertical leg:

heel flush with the corner end, legs → far end

each pilot goes through
the slot plug: dead on
the slot centre

### 2 Bolted: each slot sits over the hole it made (rail A from the knee space, rail B cut)

rail A

slots (grey)
over the holes

rail B's end on A, outer face on the 52.0 cm mark

inside fitting | outside fitting

Fig. E-10 · Top: the one fitting in its three placements, heel marks heavy, slots dashed. Bottom: bolted at the corner, each slot over the hole it made. VERIFIED slot centres; SOURCE-DEFINED heel marks.

L-Shaped Corner Desk · Assembly Manual | E · Steel rails

8

Floor test. Lay both rails upside down on the floor, flat legs down, vertical legs up. Butt rail B's corner end against the outer face of rail A's vertical leg so that rail B's outer face is on rail A's 52.0 cm mark; rail B's flat leg then covers 46.9 to 52.0 cm on rail A's tape. Bolt both fittings on loosely: the outside one on the far-end side of rail B, the inside one on the wall side. Every bolt must slide in by hand. Check the corner with the combination square. If a bolt will not go in, open that hole with a round file now, not under the desk.

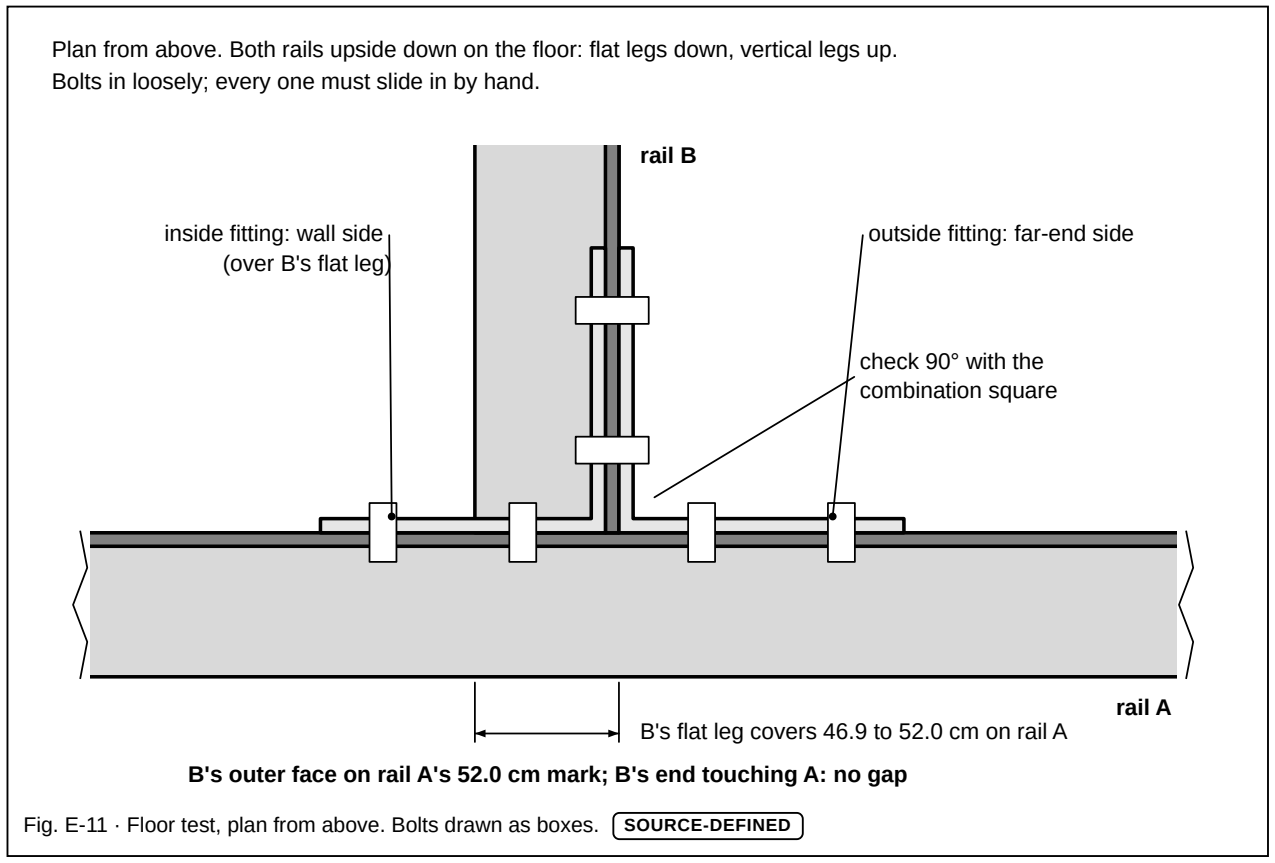
[picture p171: figure]
inside fitting: wall side; outside fitting: far-end side; (over B's flat leg); rail B; check 90° with the combination square; rail A

Plan from above. Both rails upside down on the floor: flat legs down, vertical legs up.
Bolts in loosely; every one must slide in by hand.

B's flat leg covers 46.9 to 52.0 cm on rail A B's outer face on rail A's 52.0 cm mark; B's end touching A: no gap

Fig. E-11 · Floor test, plan from above. Bolts drawn as boxes. SOURCE-DEFINED

9

Finish. Take the fittings off. Degrease both rails, scuff with 120 grit, two coats of flat black enamel, 24 h to cure. The holes need no masking.

Re-mark after painting. Put a strip of tape on rail A's vertical leg over the scribed 52.0 cm line and mark the line and 52.0 on it. Tape and re-label both reference ends again: RAIL A · WALL END, RAIL B · CORNER END. Chapter H checks rail B's outer face against this 52.0 cm mark.

The rails are now ready for the tops: rail A goes on top A with its wall end at x = 1 cm (1 cm in from the taped end), rail B on top B with its corner end projecting 12 cm past the joint end. The corner is bolted in chapter H.

Next: chapter F (legs, feet and the rails go onto the tops).

L-Shaped Corner Desk · Assembly Manual | E · Steel rails

# F · Legs, feet, rails and cabinets

Tops face down on a blanket: six legs, eight feet (gauged before the plates go on) and the two rails. Then the cabinets are set by the walls. Rings come in chapter G.

No. | Part | No. | Hardware | Qty
P01 P02 | Top A and top B, EKBACKEN 249 × 65 cm, 28 mm thick | H01 | M4 x 16 mm machine screw, IKEA 108443 (with the OLOV legs) | 30
P03 P04 | ALEX 1, drawer unit; ALEX 2, storage unit with door (36 × 58 × 70 cm) | H02 | #8 x 5/8 in pan head screw (feet plates, 4 each) | 32
P05 | OLOV leg x 6, 105 mm plate | H06 | #6 x 5/8 in flat head (rings, 3 each) | 24
P06 P07 | Rail A and rail B, steel angle 213 cm, drilled | H03 | #10 x 1 in pan head, Robertson (rails; 17 now, 2 in chapter H) | 19
P09 P10 | Round adjustable foot 4 in x 8; printed locating ring x 8 (chapter G) | P18 printed tools: leg jig, feet corner jig, edge T-square, ALEX corner template, drill guide (tower + pucks), foot height gauge, wall gauge

A

back edge: square, unfinished (goes to the wall) · y = 0 measure y from here

front edge: rounded, laminated

side-w

all end · x = 0

far end · x = 249 cm
TAPE

TA

P
E

datum

x

stand here | B

joint end (tape 0)

front edge: rounded, la

minated · x = 65 cm

TAPE

TA

P
E

y

far end

stand here

A
B

Face up, as installed:
heavy line = unfinished edge, always to a wall.

B is A turned a quarter turn: B's drawings are not a
mirror of A's.

Either short end of A can be its side-wall end: tape one.

Fig. F-1 How each top lies while you mark it: face down, laminate on the blanket. Heavy line: the square, unfinished long edge, which always goes to a wall (y = 0 on A, x = 0 on B). Tape the unfinished edge and the end you measure from, and stand where the person symbol is; the drawings in this chapter then match what you see, with x growing to the left. Datum: top A's back-left corner (0, 0). The arrow turns A anticlockwise into B.

Decide the desk height first (the legs are pre-set in step 1): built at 83.0 cm as planned; optional printed ALEX feet, 2, 4 or 6 cm tall, raise everything by their height. SOURCE-DEFINED

ALEX feet | Underside of the tops (cm) | Top surface (cm) | Every OLOV set to (cm) | Rail lower edge (cm)
none (as planned) | 80.2 | 83.0 | 80.2 | 75.1
2 cm | 82.2 | 85.0 | 82.2 | 77.1
4 cm | 84.2 | 87.0 | 84.2 | 79.1
6 cm | 86.2 | 89.0 | 86.2 (OLOV max 90) | 81.1
L-Shaped Corner Desk · Assembly Manual | F · Legs, feet, rails and cabinets

# F · Underside support layout

rail A line, y = 53 cm (step 4)

C1

C2

back edge (unfinished, to the wall) · y = 0 · measure y from here

front edge (rounded)

far end

side-w

all end · x = 0

datum

L1

L3 | L2
F2 | F1
F4 | F3

ALEX 1
below

10 cm

8.5 cm

34.5 cm | 15 cm

Fig. F-2 Top A face down. Stand at the front edge with the back edge away from you: the side-wall end is on your right and x grows to the left from the side-wall end. Circles: OLOV plates with their five holes, one pointing at the wall (L1's pattern is turned). Squares: feet plates. Grey: clamp zones C1, C2, keep clear; thin dashed: the clamp pad outlines; dash-dot: rail A's line. Datum (0,
0) at the top-right corner of this view. Drawing labels in cm.

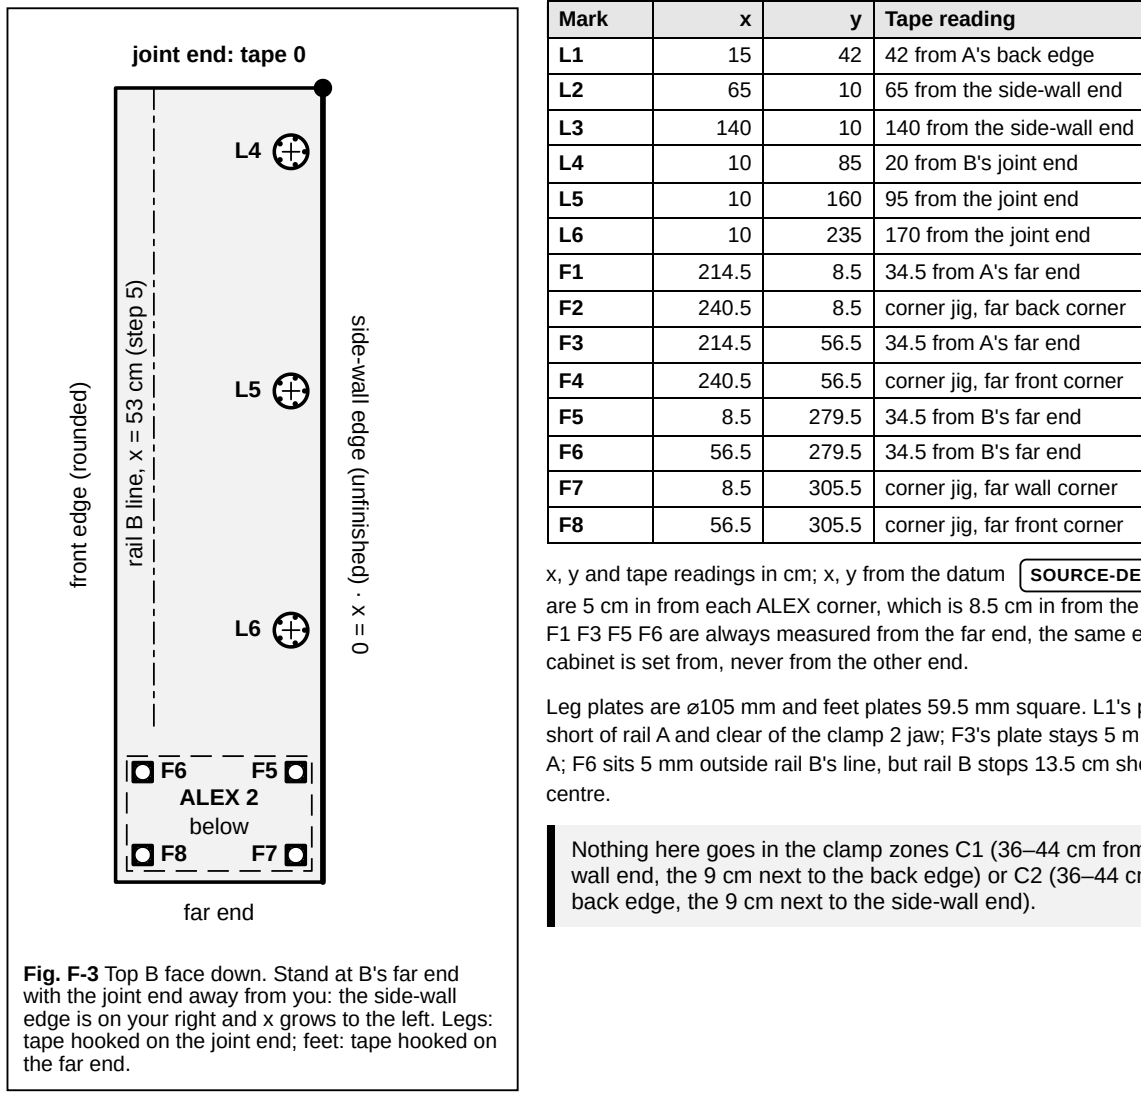
[picture p172: figure]
rail B line, x = 53 cm (step 5); joint end: tape 0; far end; side-w; all edge (unfinished) · x = 0; front edge (rounded); ALEX 2 below; the far end.; Mark; Tape reading; 42 from A's back edge; 65 from the side-wall end; 140 from the side-wall end; 20 from B's joint end; 95 from the joint end; 170 from the joint end; 34.5 from A's far end; corner jig, far back corner; corner jig, far front corner; 34.5 from B's far end; corner jig, far wall corner; centre.

Fig. F-3 Top B face down. Stand at B's far end with the joint end away from you: the side-wall edge is on your right and x grows to the left. Legs: tape hooked on the joint end; feet: tape hooked on x, y and tape readings in cm; x, y from the datum SOURCE-DEFINED . Feet are 5 cm in from each ALEX corner, which is 8.5 cm in from the top's edges. F1 F3 F5 F6 are always measured from the far end, the same end the cabinet is set from, never from the other end.

Leg plates are ⌀105 mm and feet plates 59.5 mm square. L1's plate ends short of rail A and clear of the clamp 2 jaw; F3's plate stays 5 mm clear of rail A; F6 sits 5 mm outside rail B's line, but rail B stops 13.5 cm short of F6's

Nothing here goes in the clamp zones C1 (36–44 cm from the side-wall end, the 9 cm next to the back edge) or C2 (36–44 cm from the back edge, the 9 cm next to the side-wall end).

L-Shaped Corner Desk · Assembly Manual | F · Legs, feet, rails and cabinets

# F · Step 1: legs

Calipers on both tops before the first hole: expect 28 mm. At 27 mm nothing changes: the deepest screw still stops 6 mm short of the laminate. Under 27 mm, stop and ask. No screw may go deeper than 21 mm into a top.

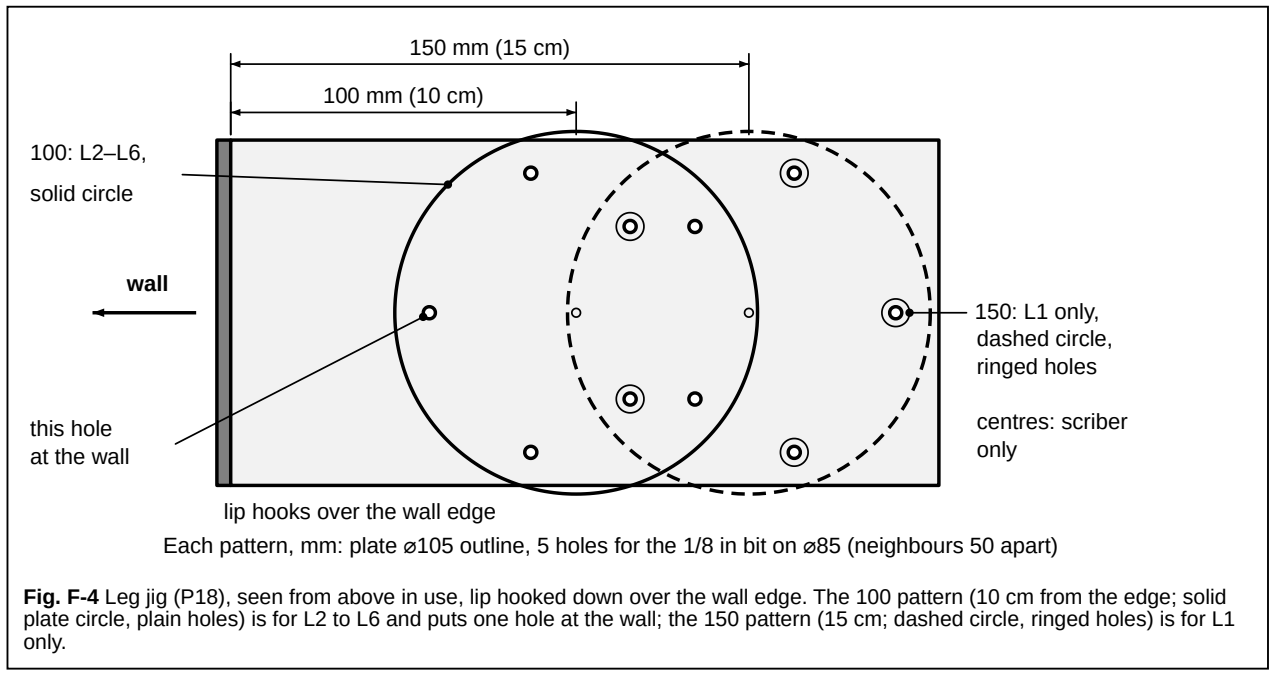
[picture p173: figure]
wall; lip hooks over the wall edge; this hole at the wall; 150: L1 only, dashed circle, ringed holes; solid circle; centres: scriber only; only.

Each pattern, mm: plate ⌀105 outline, 5 holes for the 1/8 in bit on ⌀85 (neighbours 50 apart)

Fig. F-4 Leg jig (P18), seen from above in use, lip hooked down over the wall edge. The 100 pattern (10 cm from the edge; solid plate circle, plain holes) is for L2 to L6 and puts one hole at the wall; the 150 pattern (15 cm; dashed circle, ringed holes) is for L1

Leg | Top | Hook the lip over | Tape station (cm), as marked in chapter D | Pattern
L1 | A | side-wall end (x = 0) | 42 from the back edge | 150, ringed holes
L2 L3 | A | back edge (y = 0) | 65 (L2) and 140 (L3) from the side-wall end | 100
L4 L5 L6 | B | side-wall edge (x = 0) | 20 (L4), 95 (L5), 170 (L6) from the joint end | 100

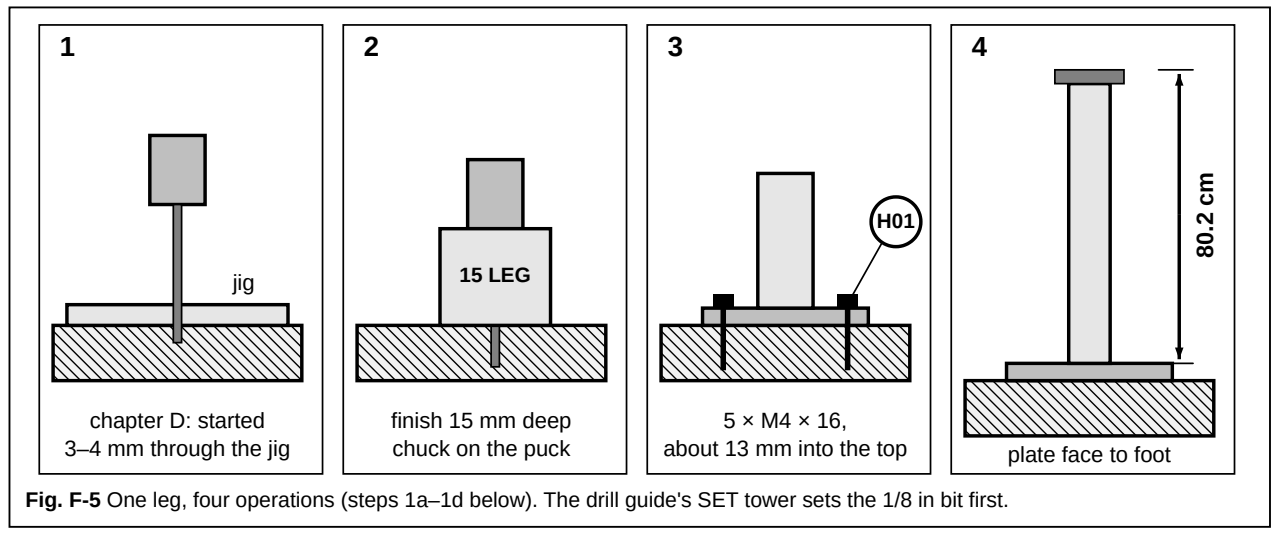
[picture p174: figure]
chapter D: started 3–4 mm through the jig; jig; 15 LEG; finish 15 mm deep chuck on the puck; 5 × M4 × 16, about 13 mm into the top; plate face to foot

Fig. F-5 One leg, four operations (steps 1a–1d below). The drill guide's SET tower sets the 1/8 in bit first.

1

a Drop the leg jig back onto the five starts you made in chapter D, bit tip in each start, then lift it. b Finish each pilot 15 mm deep with the 1/8 in bit and the 15 LEG puck. c Screw the OLOV plate on with five H01 M4 × 16 screws (about 13 mm into the top). d Pre-set the leg to 80.2 cm from plate face to foot (or the table's number at the start of this chapter if you fit ALEX feet). Six legs, 30 screws.

OLOV plate ⌀105 mm, five ⌀5.5 mm holes on an ⌀85 mm circle, neighbouring holes 50 mm apart; leg range 60–90 cm. VERIFIED 105 mm plate measured 22 Oct 2026; hole pattern from a shared OLOV template, printed and test-fitted.

L-Shaped Corner Desk · Assembly Manual | F · Legs, feet, rails and cabinets

# F · Step 2: wind each foot to 102 mm, loose

Measure your ALEX units first, with and without their stock feet. The drawings take an ALEX as 70 cm tall, which is what makes the feet 102 mm between the ALEX top and the underside at 80.2 cm. If a unit is not 70.0 cm tall, nothing changes here; levelling in chapter G takes it up.

2

Hold each foot loose in your hand, plate and all, before
anything is screwed. Wind its pad out until the printed foot height gauge (102.0 mm inside) just slides over it from the side with no rock. All eight then match without a ruler. Do this now: the gauge's C sits against the plate face, so it cannot be used once the plate is screwed to the top.

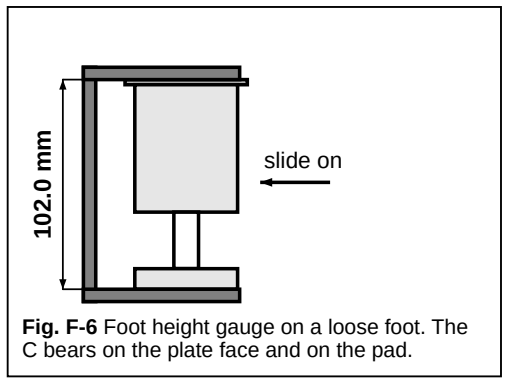
[picture p175: figure]
slide on

Fig. F-6 Foot height gauge on a loose foot. The C bears on the plate face and on the pad.

!

ASSUMPTION / FIELD CHECK ASSUMPTION / FIELD CHECK
The feet's load rating is unknown; the design wants 50 kg or more each.
L-Shaped Corner Desk · Assembly Manual | F · Legs, feet, rails and cabinets

# F · Step 3: feet plates

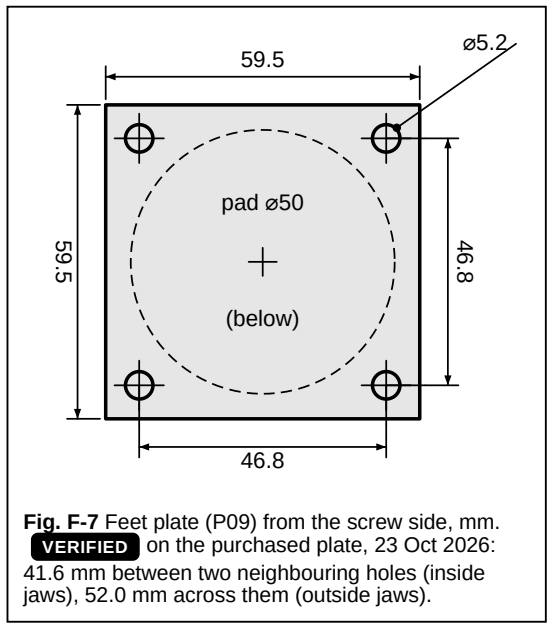
[picture p176: figure]
pad ⌀50; (below)

Fig. F-7 Feet plate (P09) from the screw side, mm. VERIFIED on the purchased plate, 23 Oct 2026: 41.6 mm between two neighbouring holes (inside jaws), 52.0 mm across them (outside jaws).

Feet | Tool | Placement (as in chapter D)
F2 F4 | feet corner jig | top A's two far corners, fences on both edges
F1 F3 | T-square, 85 hole | lip over A's back edge (F1) or front edge (F3), station 34.5 cm from A's far end (tape hooked on the far end)
F7 F8 | feet corner jig | top B's two far corners
F5 F6 | T-square, 85 hole | lip over B's side-wall edge (F5) or front edge (F6), station 34.5 cm from B's far end (tape hooked on the far end)

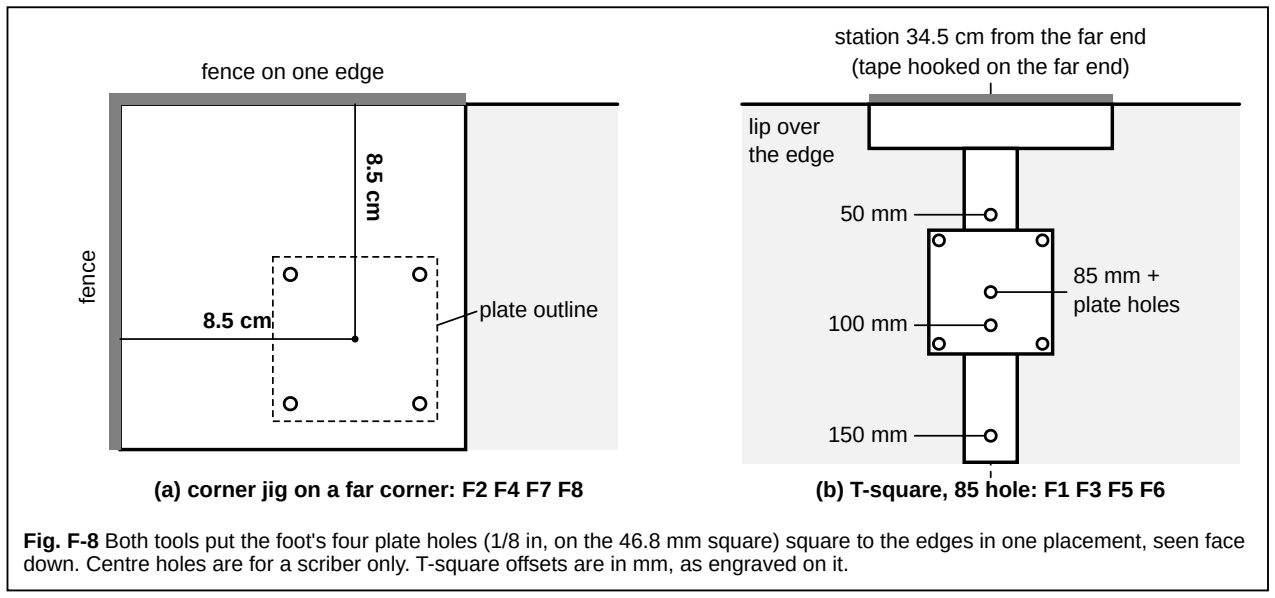
[picture p177: figure]
fence on one edge; fence; plate outline; station 34.5 cm from the far end (tape hooked on the far end); 85 mm + plate holes; lip over the edge; (b) T-square, 85 hole: F1 F3 F5 F6

(a) corner jig on a far corner: F2 F4 F7 F8

Fig. F-8 Both tools put the foot's four plate holes (1/8 in, on the 46.8 mm square) square to the edges in one placement, seen face down. Centre holes are for a scriber only. T-square offsets are in mm, as engraved on it.

3

Drop the tool back onto the four starts you made in chapter D, bit tip in each start, then lift it and finish each pilot 15 mm deep with the 1/8 in bit and the 15 LEG puck. Screw the plate of each gauged foot on with four H02 #8 × 5/8 pan heads (14 mm into the top), pad pointing away from the top. Eight plates, 32 screws.

L-Shaped Corner Desk · Assembly Manual | F · Legs, feet, rails and cabinets

# F · Steps 4 and 5: rails to the tops

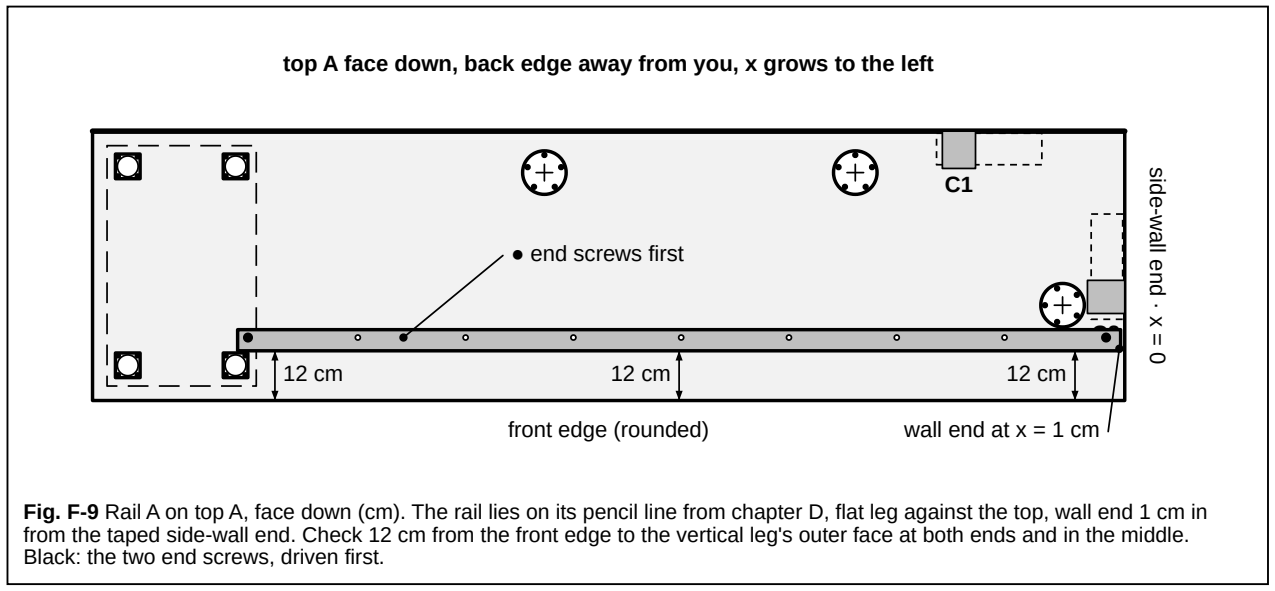
[picture p178: figure]
front edge (rounded); side-w; all end · x = 0; wall end at x = 1 cm; ● end screws first

top A face down, back edge away from you, x grows to the left

Fig. F-9 Rail A on top A, face down (cm). The rail lies on its pencil line from chapter D, flat leg against the top, wall end 1 cm in from the taped side-wall end. Check 12 cm from the front edge to the vertical leg's outer face at both ends and in the middle. Black: the two end screws, driven first.

25 RAIL puck

12 cm to the outer face

top, laminate down on the blanket

vertical leg

(a) rail A in section: pilot 1/8 in, 20 mm into the wood

12 cm

- holes 1, 2: chapter H
- holes 3–10: screw now

joint end

side-w

all edge

(b) rail B at top B's joint end

Fig. F-10 (a) Rail A in section, the top face down, so the vertical leg points up (mm, except the 12 cm). The 25 RAIL puck stands on the flat leg: the 1/8 in pilot goes 20 mm into the wood. (b) Rail B on top B, face down: stand at B's far end, joint end away from you, x grows to the left. Its corner end projects 12 cm past the joint end; holes 1 and 2 (open) lie in the projection.

4

Rail A. Clamp it on its line, flat leg against the top, wall end at x = 1 cm. Hook a rail setback gauge over the front edge near each end and push the rail against both (12 cm from the front edge to the vertical leg's outer face); check the middle with one. Through each rail hole drill a 1/8 in pilot with the 25 RAIL puck standing on the flat leg (20 mm into the wood). Drive the two end screws first, re-check the 12 cm, then the rest: H03 #10 × 1 in Robertson on the #2 bit in the 3 in extension (the chuck would hit the vertical leg otherwise), until each head seats. Nine screws.

5

Rail B. Clamp it on its line with the corner end projecting 12 cm past top B's joint end. Pilot and screw holes 3 to 10 only, the same way: eight screws. Holes 1 and 2 go into top A in chapter H.

The printed rail end caps go on later, once the desk stands; they are handed: cap A fits rail A's far end, cap B fits rail A's wall end and rail B's far end. Rail B's corner end is bolted to rail A and takes no cap.

L-Shaped Corner Desk · Assembly Manual | F · Legs, feet, rails and cabinets

# F · Step 6: place the ALEX units

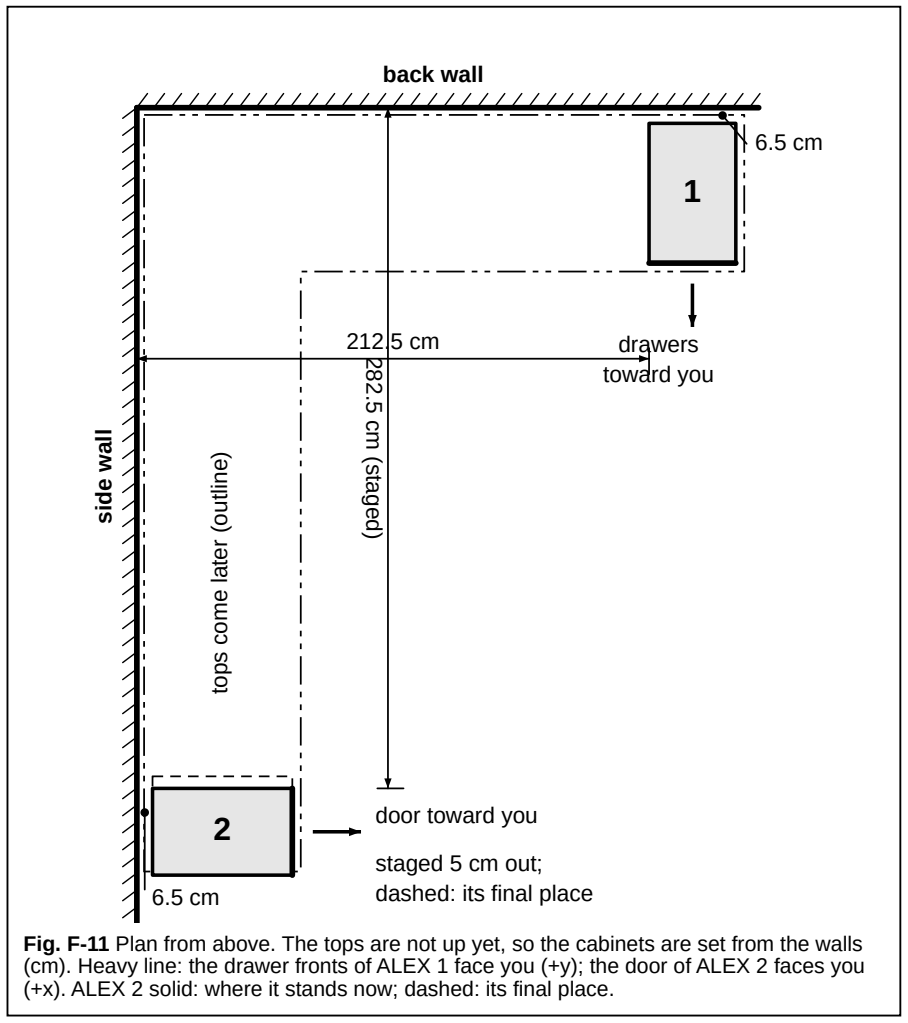
[picture p179: figure]
back wall; side w; all; tops come later (outline); drawers toward you; door toward you; staged 5 cm out; dashed: its final place; 282.5 cm (staged)

Fig. F-11 Plan from above. The tops are not up yet, so the cabinets are set from the walls (cm). Heavy line: the drawer fronts of ALEX 1 face you (+y); the door of ALEX 2 faces you (+x). ALEX 2 solid: where it stands now; dashed: its final place.

6

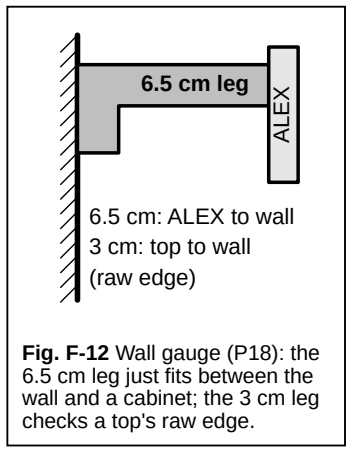
[picture p180: figure]
ALE; 6.5 cm leg; 6.5 cm: ALEX to wall 3 cm: top to wall (raw edge); Fig. F-12 Wall gauge (P18): the 6.5 cm leg just fits between the wall and a cabinet; the 3 cm leg checks a top's raw edge.

Stand ALEX 1 (P03) with its back 6.5 cm off the back wall and its near side 212.5 cm from the side wall, drawers toward you. Stand ALEX 2 (P04) with its side 6.5 cm off the side wall and, for now, its near end 282.5 cm from the back wall, door toward you: 5 cm short of its final 277.5 cm, so that rail B's corner end comes down clear of rail A's flat leg when top B is stood on it in chapter G. It is pushed home in chapter G. Painter's tape on the floor round each one saves guessing.

While it stands 5 cm out, top B's far end reaches 319 cm from the back wall: the side wall must run at least 322 cm. If it does not, stop and ask before chapter G.

No rings yet: they are fitted in chapter G by tracing the pads (a 50 mm pad in a 52 mm ring has only about 1 mm each side).

Optional ALEX feet (decided at the start of this chapter): fit them now, before the cabinets stand. Unscrew the stock feet, lay the unit on its back, hook the corner template over each bottom corner and use its inner three holes (r 14.5 mm). Pilot 5/64 in, 12 mm deep with the 12 ALEX puck; three #6 × 5/8 flat heads per foot down the wells, four feet per unit, all the same height.

!

MEASURE ON HARDWARE MEASURE ON HARDWARE
Before fitting ALEX feet, measure the ALEX bottom panel at an edge. 14 mm or more is fine: the 12 ALEX pilot is 12 mm deep and the #6 × 5/8 screw reaches only 9.9 mm into the panel through the foot's 6 mm roof, so 4 mm remains at 14 mm. Under 14 mm: do not fit them. The top panel measured 15.9 mm, so the bottom is likely similar and likely fine.
L-Shaped Corner Desk · Assembly Manual | F · Legs, feet, rails and cabinets

# F · The ring, and the check (used in chapter G)

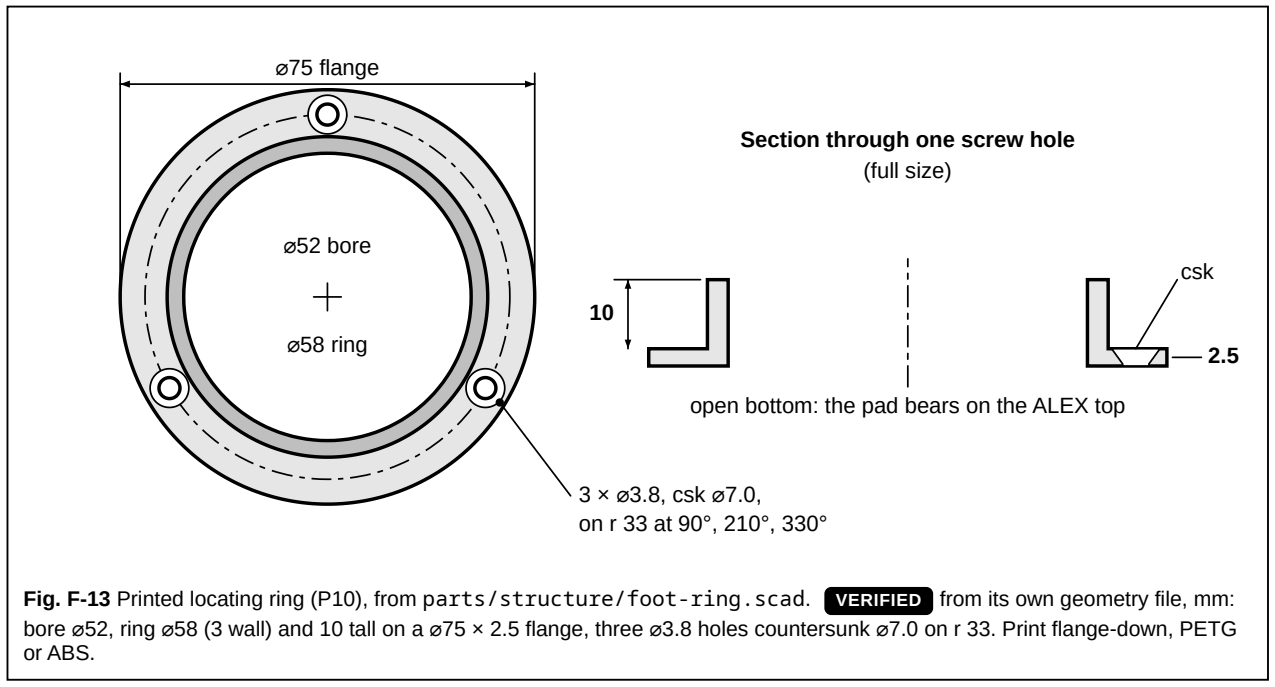
[picture p181: figure]
⌀52 bore; ⌀58 ring; 3 × ⌀3.8, csk ⌀7.0, on r 33 at 90°, 210°, 330°; ⌀75 flange; csk; Section through one screw hole (full size); or ABS.

open bottom: the pad bears on the ALEX top

Fig. F-13 Printed locating ring (P10), from parts/structure/foot-ring.scad. VERIFIED from its own geometry file, mm: bore ⌀52, ring ⌀58 (3 wall) and 10 tall on a ⌀75 × 2.5 flange, three ⌀3.8 holes countersunk ⌀7.0 on r 33. Print flange-down, PETG

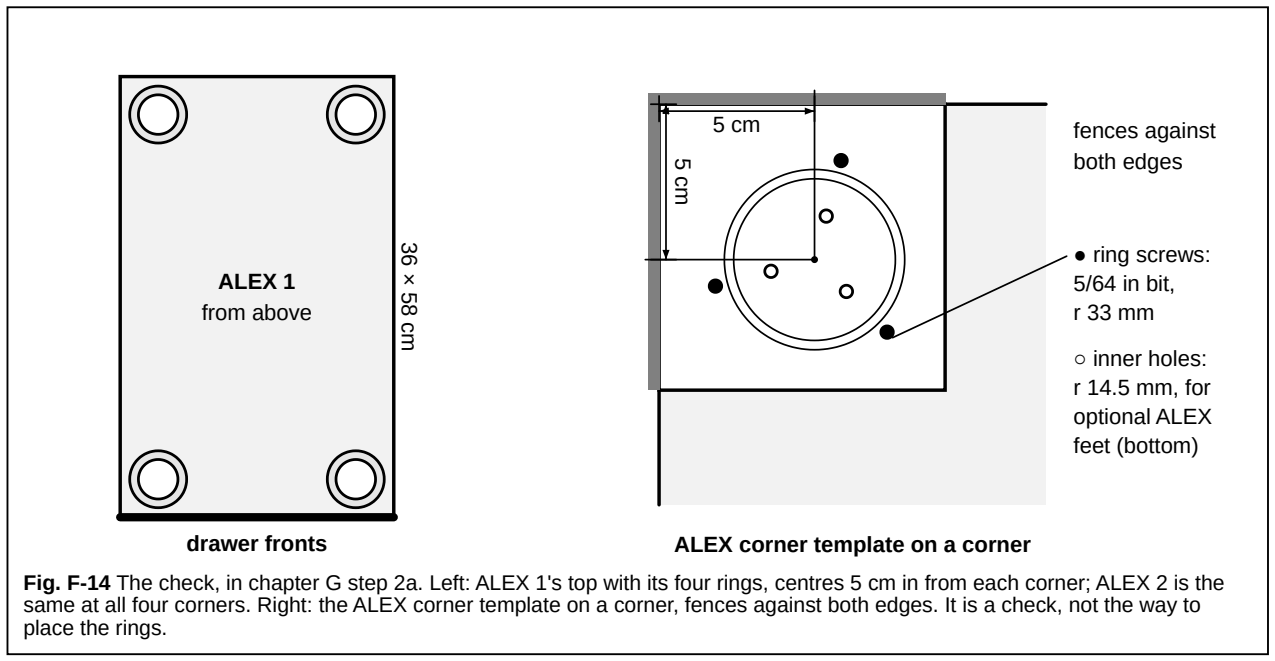
[picture p182: figure]
drawer fronts; ALEX 1 from above; fences against both edges; ● ring screws: 5/64 in bit, r 33 mm; ○ inner holes: r 14.5 mm, for optional ALEX feet (bottom); ALEX corner template on a corner; place the rings.

Fig. F-14 The check, in chapter G step 2a. Left: ALEX 1's top with its four rings, centres 5 cm in from each corner; ALEX 2 is the same at all four corners. Right: the ALEX corner template on a corner, fences against both edges. It is a check, not the way to

The check happens in chapter G step 2a: with the top lifted off and before any ring is drilled, lay the corner template on the bare corner. The pencil trace must sit inside the template's inner engraved circle (⌀52 mm) all round. If it does not, move the cabinet and trace again. The ring is round and is fitted turned so its own three holes are at any angle.

L-Shaped Corner Desk · Assembly Manual | F · Legs, feet, rails and cabinets

# F · Foot, pad and ring in section

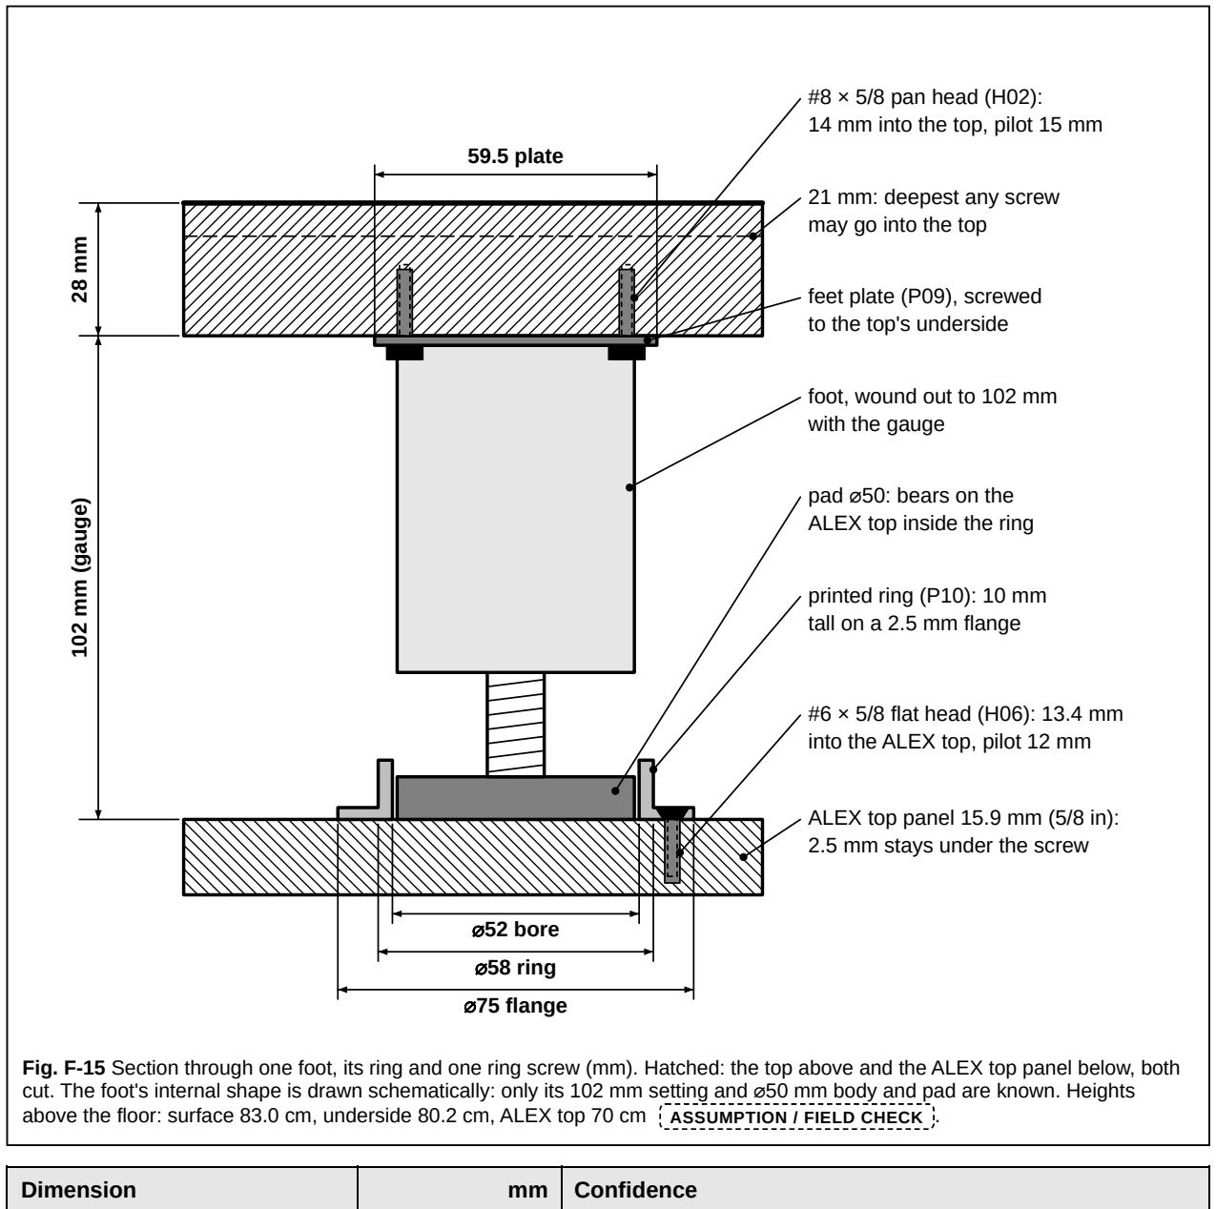
[picture p183: figure]
m (gauge) 28 m; ⌀52 bore; ⌀58 ring; ⌀75 flange; 59.5 plate; #8 × 5/8 pan head (H02): 14 mm into the top, pilot 15 mm; 21 mm: deepest any screw may go into the top; feet plate (P09), screwed to the top's underside; foot, wound out to 102 mm with the gauge; printed ring (P10): 10 mm tall on a 2.5 mm flange; pad ⌀50: bears on the ALEX top inside the ring; #6 × 5/8 flat head (H06): 13.4 mm into the ALEX top, pilot 12 mm; ALEX top panel 15.9 mm (5/8 in): 2.5 mm stays under the screw; Dimension; Confidence

Fig. F-15 Section through one foot, its ring and one ring screw (mm). Hatched: the top above and the ALEX top panel below, both cut. The foot's internal shape is drawn schematically: only its 102 mm setting and ⌀50 mm body and pad are known. Heights above the floor: surface 83.0 cm, underside 80.2 cm, ALEX top 70 cm ASSUMPTION / FIELD CHECK .

Top thickness | 28 | MEASURE ON HARDWARE expect 28 mm
Foot, plate face to pad (gauge) | 102 | SOURCE-DEFINED
Feet plate, hole spacing | 59.5 / 46.8 | VERIFIED
Pad diameter | 50 | MEASURE ON HARDWARE before relying on the 52 mm bore
Ring bore / ring / flange | 52 / 58 / 75 × 2.5 | VERIFIED geometry file
ALEX top panel thickness | 15.9 | VERIFIED 5/8 in, 23 Oct 2026; 2.5 mm under each screw
L-Shaped Corner Desk · Assembly Manual | F · Legs, feet, rails and cabinets

# F · Load path

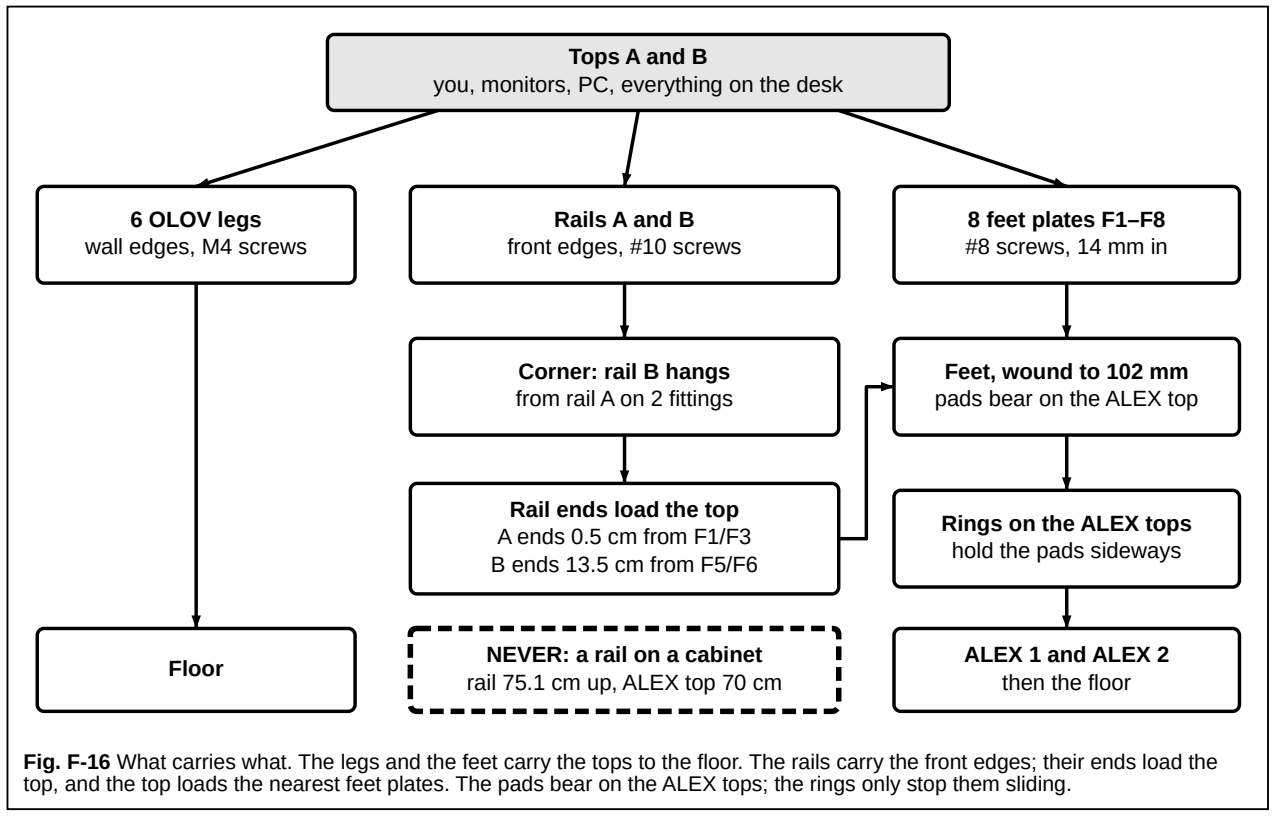
[picture p184: figure]
Tops A and B; 6 OLOV legs wall edges, M4 screws; Rails A and B front edges, #10 screws; 8 feet plates F1–F8 #8 screws, 14 mm in; Corner: rail B hangs from rail A on 2 fittings; Rail ends load the top A ends 0.5 cm from F1/F3 B ends 13.5 cm from F5/F6; Feet, wound to 102 mm pads bear on the ALEX top; Rings on the ALEX tops hold the pads sideways; ALEX 1 and ALEX 2 then the floor; Floor; NEVER: a rail on a cabinet rail 75.1 cm up, ALEX top 70 cm

you, monitors, PC, everything on the desk

Fig. F-16 What carries what. The legs and the feet carry the tops to the floor. The rails carry the front edges; their ends load the top, and the top loads the nearest feet plates. The pads bear on the ALEX tops; the rings only stop them sliding.

F3 | F4

rail end

rail A

ALEX 1 below

(a) rail A's far end, plan rail end x 214 cm
F1/F3 centres x 214.5 cm

F6

### 13.5 cm

rail B

ALEX 2

front edge

(b) rail B's end, plan (front edge at the top) rail end y 266 cm · ALEX 2 face y 274.5 cm F5/F6 centres y 279.5 cm

Fig. F-17 Where the rails stop (cm from the datum; front edges at the bottom). (a) Rail A ends at x 214 cm, 0.5 cm short of the F1/F3 centres at 214.5 cm, beside F3's plate. (b) Seen from above, turned a quarter turn: front edge at the top, y grows to the right. Rail B ends at y 266 cm; the top bridges the 13.5 cm to F5/F6.

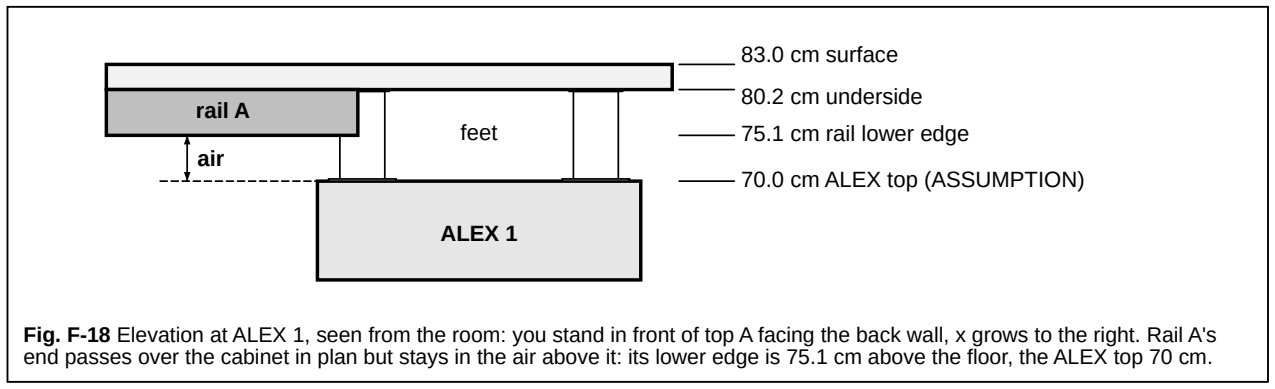
[picture p185: figure]
83.0 cm surface; 80.2 cm underside; 75.1 cm rail lower edge; 70.0 cm ALEX top (ASSUMPTION); air; rail A; feet; ALEX 1

Fig. F-18 Elevation at ALEX 1, seen from the room: you stand in front of top A facing the back wall, x grows to the right. Rail A's end passes over the cabinet in plan but stays in the air above it: its lower edge is 75.1 cm above the floor, the ALEX top 70 cm.

L-Shaped Corner Desk · Assembly Manual | F · Legs, feet, rails and cabinets

# F · The assembled underside

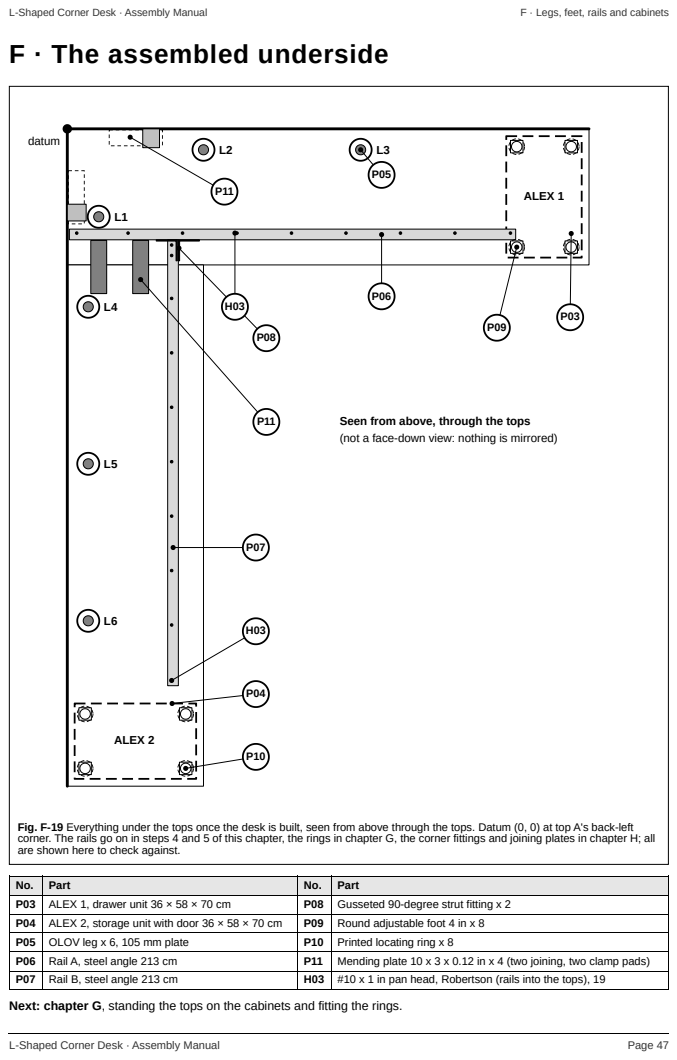
[picture p186: page 47]

Seen from above, through the tops
(not a face-down view: nothing is mirrored)

Fig. F-19 Everything under the tops once the desk is built, seen from above through the tops. Datum (0, 0) at top A's back-left
corner. The rails go on in steps 4 and 5 of this chapter, the rings in chapter G, the corner fittings and joining plates in chapter H; all
are shown here to check against.

No. | Part | No. | Part
P03 | ALEX 1, drawer unit 36 × 58 × 70 cm | P08 | Gusseted 90-degree strut fitting x 2
P04 | ALEX 2, storage unit with door 36 × 58 × 70 cm | P09 | Round adjustable foot 4 in x 8
P05 | OLOV leg x 6, 105 mm plate | P10 | Printed locating ring x 8
P06 | Rail A, steel angle 213 cm | P11 | Mending plate 10 x 3 x 0.12 in x 4 (two joining, two clamp pads)
P07 | Rail B, steel angle 213 cm | H03 | #10 x 1 in pan head, Robertson (rails into the tops), 19

Next: chapter G, standing the tops on the cabinets and fitting the rings.

# G · Standing the tops and fitting the rings

Two people. Both tops lie face down with their legs, feet and rails on (chapter F), every OLOV at 80.2 cm and every pad set with the foot height gauge (102 mm). ALEX 1 stands in its place; ALEX 2 stands 5 cm short of its place, its near end 282.5 cm from the back wall. Neither has rings yet: each ring is placed by tracing round its pad.

Parts | Hardware | Tools
P01 top A · P02 top B · P03 ALEX 1 · P04 ALEX 2 · P05 OLOV leg · P06 rail A · P07 rail B · P09 foot · P10 ring × 8 | H06 #6 × 5/8 in flat head × 24 (3 per ring) | Sharp pencil, wall gauge, ALEX corner template, drill guide (SET tower, 12 ALEX puck), 5/64 in bit, level, tape measure, blanket

1

Stand top A on the bare ALEX 1. With a helper, turn top A over and stand it on its legs with its four pads on the bare ALEX top: lower the ALEX end first, then the leg end. Push the ALEX unit, never the top, until 3.5 cm of top shows all round the cabinet and the wall gauge's ALEX 65 leg (6.5 cm) just fits between the back

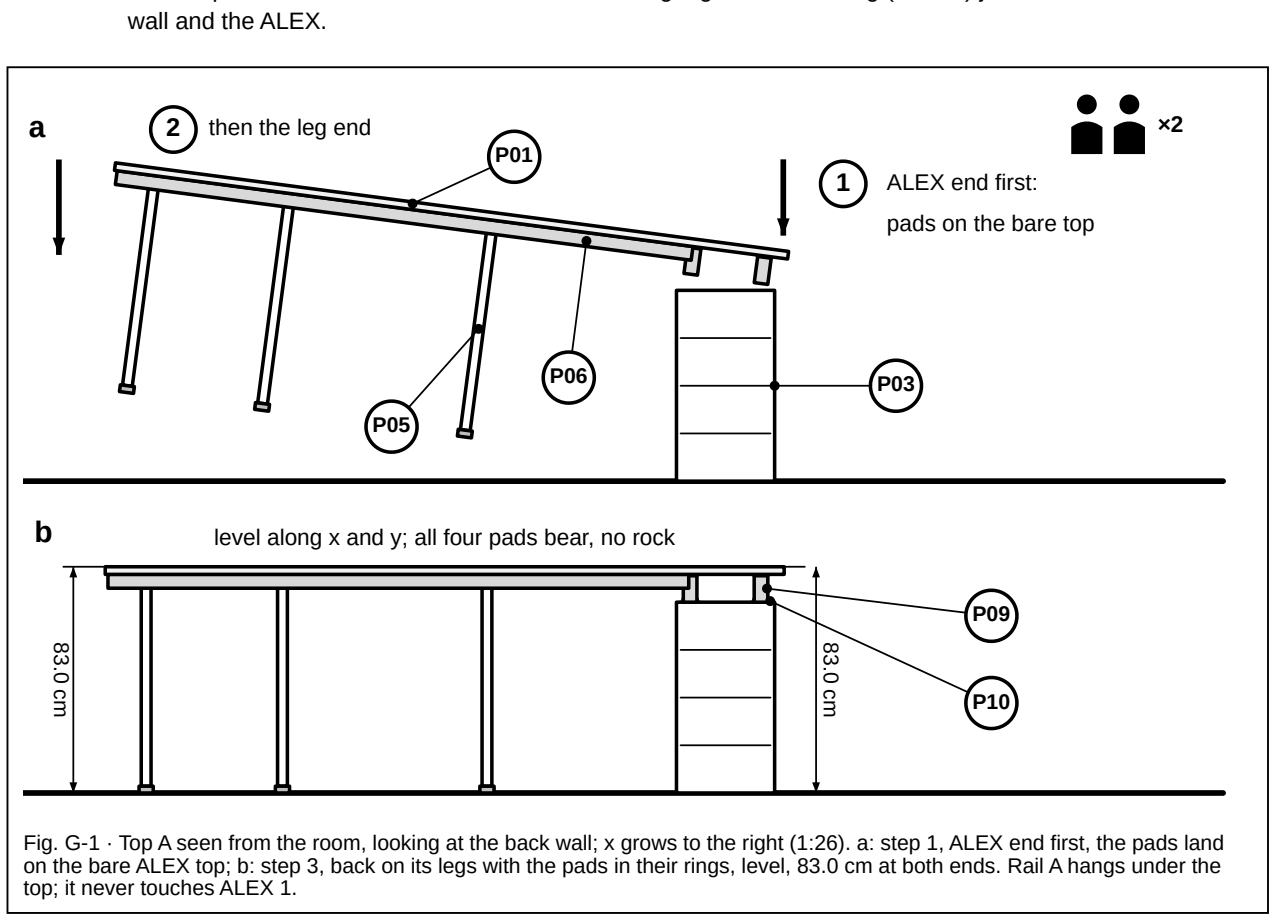
[picture p187: figure]
wall and the ALEX.; 1 ALEX end first:; pads on the bare top; 2 then the leg end; top; it never touches ALEX 1.

level along x and y; all four pads bear, no rock

Fig. G-1 · Top A seen from the room, looking at the back wall; x grows to the right (1:26). a: step 1, ALEX end first, the pads land on the bare ALEX top; b: step 3, back on its legs with the pads in their rings, level, 83.0 cm at both ends. Rail A hangs under the

Top A is positioned only by moving ALEX 1 under it. Once the rings are on and the pads sit in them, push the ALEX with the pads in the rings; the top moves with it.

L-Shaped Corner Desk · Assembly Manual | G · Standing the tops

2

Fit the rings on ALEX 1 by tracing.
1. With top A standing where step 1 left it, draw round each of the four pads on the ALEX top with a sharp pencil.
2. Two people: lift top A off and lay it face down on the blanket.
3. Check the traces before drilling anything. Lay the ALEX corner template on each bare corner, fences against the edges: the pencil trace must sit inside the template's inner engraved circle (⌀52 mm) all round. If one does not, put the top back on, push the cabinet to correct it, and trace again.
4. Set a ring (P10) on each pencil circle, flange down. Look down through its open bottom and move it until the pencil line shows all the way round inside the ⌀52 mm bore.
5. Hold it there. Start the three 5/64 in pilots through the ring's own holes, 3–4 mm deep, lift the ring, and finish each pilot 12 mm deep with the drill guide's 12 ALEX puck.
6. Put the ring back and drive three H06 #6 × 5/8 in flat-head screws.

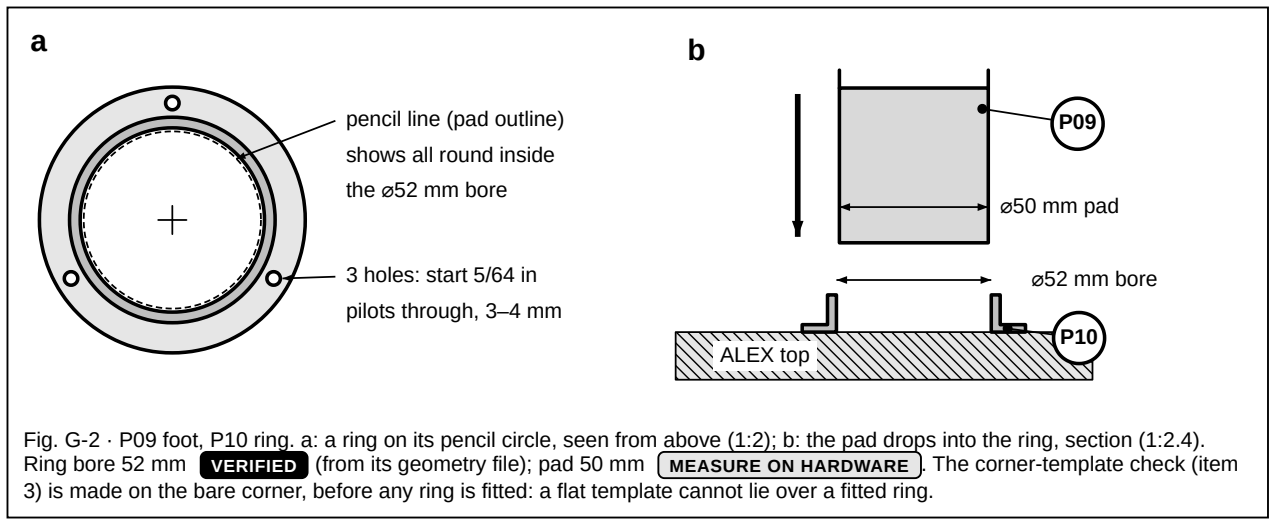
[picture p188: figure]
pencil line (pad outline) shows all round inside the ⌀52 mm bore; 3 holes: start 5/64 in pilots through, 3–4 mm; ALEX top; ⌀52 mm bore; ⌀50 mm pad

Fig. G-2 · P09 foot, P10 ring. a: a ring on its pencil circle, seen from above (1:2); b: the pad drops into the ring, section (1:2.4). Ring bore 52 mm VERIFIED (from its geometry file); pad 50 mm MEASURE ON HARDWARE . The corner-template check (item
3) is made on the bare corner, before any ring is fitted: a flat template cannot lie over a fitted ring.

3

Stand top A again and level it. Two people, ALEX end first as in step 1: the pads drop into the rings. Level along x and along y by turning the OLOV feet and the round feet until it reads flat and all four pads bear with no rock. Target: surface 83.0 cm above the floor at every corner. SOURCE-DEFINED

From here on, never push or lift the top alone.
If top A is not 3 cm off a wall (the wall gauge's EKB 30 leg, 3 cm), push the ALEX with the pads in the rings; the

83.0 cm assumes ALEX units 70.0 cm tall ASSUMPTION / FIELD CHECK until measured. With the optional ALEX feet the surface is 85.0, 87.0 or 89.0 cm (2, 4 or 6 cm feet).

L-Shaped Corner Desk · Assembly Manual | G · Standing the tops

4

Top B on the bare ALEX 2, then its rings.
1. Wind each of top B's OLOV legs to 79.9–80.0 cm (plate face to foot), so rail B's corner end can later slide under top A.
2. ALEX 2 stands with its near end 282.5 cm from the back wall (chapter F), 5 cm short of its place, so rail B's corner end clears rail A's flat leg. Turn top B over onto its legs with its pads on the bare ALEX 2, ALEX end first. For a moment top B's far end reaches 319 cm from the back wall: the side wall must run at least 322 cm; if it does not, stop and ask.
3. Push ALEX 2, never the top, until 3.5 cm of top shows all round the cabinet and the wall gauge's ALEX 65 leg (6.5 cm) just fits between the side wall and the ALEX.
4. Fit the four rings on ALEX 2 by tracing, exactly as in step 2: pencil round each pad, lift top B off, check every trace with the corner template, rings on the circles, pilots through the rings, screws.
5. Stand top B back on, ALEX end first: the pads drop into the rings.

5

Push ALEX 2 home; top B comes with it. Push ALEX 2 the last 5 cm toward the back wall, with the pads in its rings, until rail B's corner end touches the outer face of rail A's vertical leg and B's end meets A's front edge (y = 65 cm). Under the corner, rail B's outer face lines up with the taped 52.0 cm mark on rail A. Then wind B's legs up to 80.2 cm, until the two surfaces are flush.

a | push ALEX 2

legs set to
79.9–80.0 cm

P07

P02

P04

P01

b | rail B's end on rail A, B's end at A's front edge: wind B's legs up to flush

Fig. G-3 · P01 top A, P02 top B, P04 ALEX 2, P07 rail B. Seen from the knee space, looking at the side wall: top A is on your right, y grows to the left (1:24); top A cut beyond B's inside edge, ALEX 1 not shown. a: rings on, legs at 79.9–80.0 cm, ALEX 2 5 cm out, push it home; b: home, legs wound up to 80.2 cm. Neither rail touches an ALEX.

L-Shaped Corner Desk · Assembly Manual | G · Standing the tops

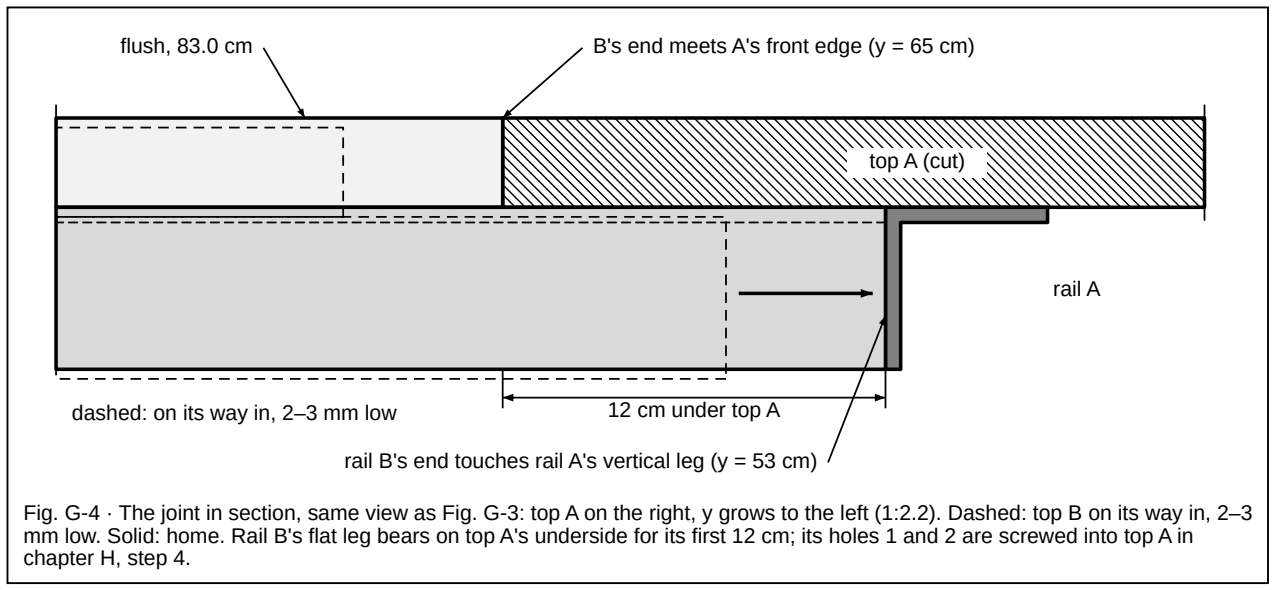
[picture p189: figure]
12 cm under top A; dashed: on its way in, 2–3 mm low; top A (cut); rail A; chapter H, step 4.

rail B's end touches rail A's vertical leg (y = 53 cm)

flush, 83.0 cm | B's end meets A's front edge (y = 65 cm)

Fig. G-4 · The joint in section, same view as Fig. G-3: top A on the right, y grows to the left (1:2.2). Dashed: top B on its way in, 2–3 mm low. Solid: home. Rail B's flat leg bears on top A's underside for its first 12 cm; its holes 1 and 2 are screwed into top A in

If the corner will not meet or come flush, adjust leg height, not the joint. Never hammer, clamp or lever the tops together. If B's end is off along the joint, push ALEX 2 with the pads in the rings; top B moves with it.

Next: chapter H, the joint: plates, rail B's last two screws and the corner fittings.

L-Shaped Corner Desk · Assembly Manual | G · Standing the tops

# H · The joint

Both tops stand on their rings (chapter G); top B's end meets top A's front edge and rail B's end touches rail A. You work from below, lying in the knee space. The two gusseted fittings bolted round rail B's end, not the joining plates, carry the inside corner of top B.

!

SEQUENCE: THE FITTINGS GO ON LAST SOURCE-DEFINED
1 · The two surfaces are flush at the joint, levelled with the feet, never packed (step 1).
2 · Rail B's end touches rail A's vertical leg; rail B's outer face is on the taped 52.0 cm mark; the L is square (step 2).
3 · Joining plates P1 and P2 are screwed across the joint (step 3). They align the tops; they do not carry the corner.
4 · Rail B's screws 1 and 2 are in top A (step 4). The inside fitting sits right under them and would block the driver. 5 · Only then the fittings (steps 5–7), and the bolts tightened last (step 8).
| Part | Qty | | Hardware | Qty
P06 P07 | Rail A, rail B, on the tops (chapter F) | 1 + 1 | H03 | #10 × 1 in pan head, Robertson (rail B holes 1, 2) | 2
P08 | Gusseted 90° strut fitting, 5 mm, legs 100.5 × 41 mm, two 21 × 12 mm slots per leg VERIFIED | 2 | H04 H05 | #10 × 5/8 in pan head, #10 washer (plates) | 8 + 8
P11 | Mending plate 10 × 3 × 0.12 in (joining plates P1, P2) | 2 | H08 H09 H10 | 3/8-16 × 1½ in hex bolt grade 5; 3/8 flat washer; 3/8-16 nylon-insert nut | 6 / 12 / 6

1

Surfaces flush. Bring the two surfaces level at the joint by turning the OLOV feet and the round feet, never by packing anything under the joining plates. A fingertip across the joint finds no step.

2

Check under the corner and the square, while the tops can still move. Rail B's end touches the face of rail A's vertical leg with no gap, and rail B's outer face lines up with the taped 52.0 cm mark on rail A. The butt joint is closed across its full 65 cm width (no light). If anything is off, push ALEX 2 with the pads in its rings; top B moves with it. Never push or lift top B alone.

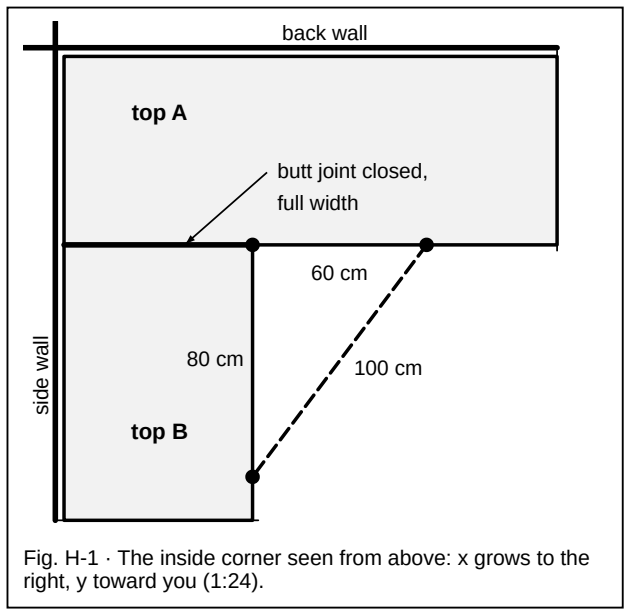
[picture p190: figure]
back wall; side wall; butt joint closed, full width; top A; top B; right, y toward you (1:24).

Fig. H-1 · The inside corner seen from above: x grows to the

!

FIELD CHECK, not in the source documents
ASSUMPTION / FIELD CHECK
Optional 3-4-5 triangle: hook the tape on the inside corner and mark 60 cm along A's front edge and 80 cm along B's inside edge; the tape between the two marks reads 100 cm when the L is square. Write down what it reads. If it is off, check the butt joint for a gap first, then push ALEX 2 with the pads in its rings. Never force the corner.
L-Shaped Corner Desk · Assembly Manual | H · The joint

3

Joining plates P1 and P2, from below. Each plate goes on the outline drawn in chapter D: y 53.3–78.7 cm, long axis along y, centred on x = 15 cm (P1) and x = 35 cm (P2). They are not centred on the joint: each starts 3 mm clear of rail A.
1. Hold the plate on its outline and scribe through its eight holes (two rows of four, 5.0 cm apart).
2. Take the plate off. Pilot each mark 1/8 in, 12 mm deep, with the drill guide's 12 PLATE puck standing on the wood.
3. Put the plate back and drive H04 #10 × 5/8 in, each with an H05 washer: four screws in each top, eight
per plate. SOURCE-DEFINED

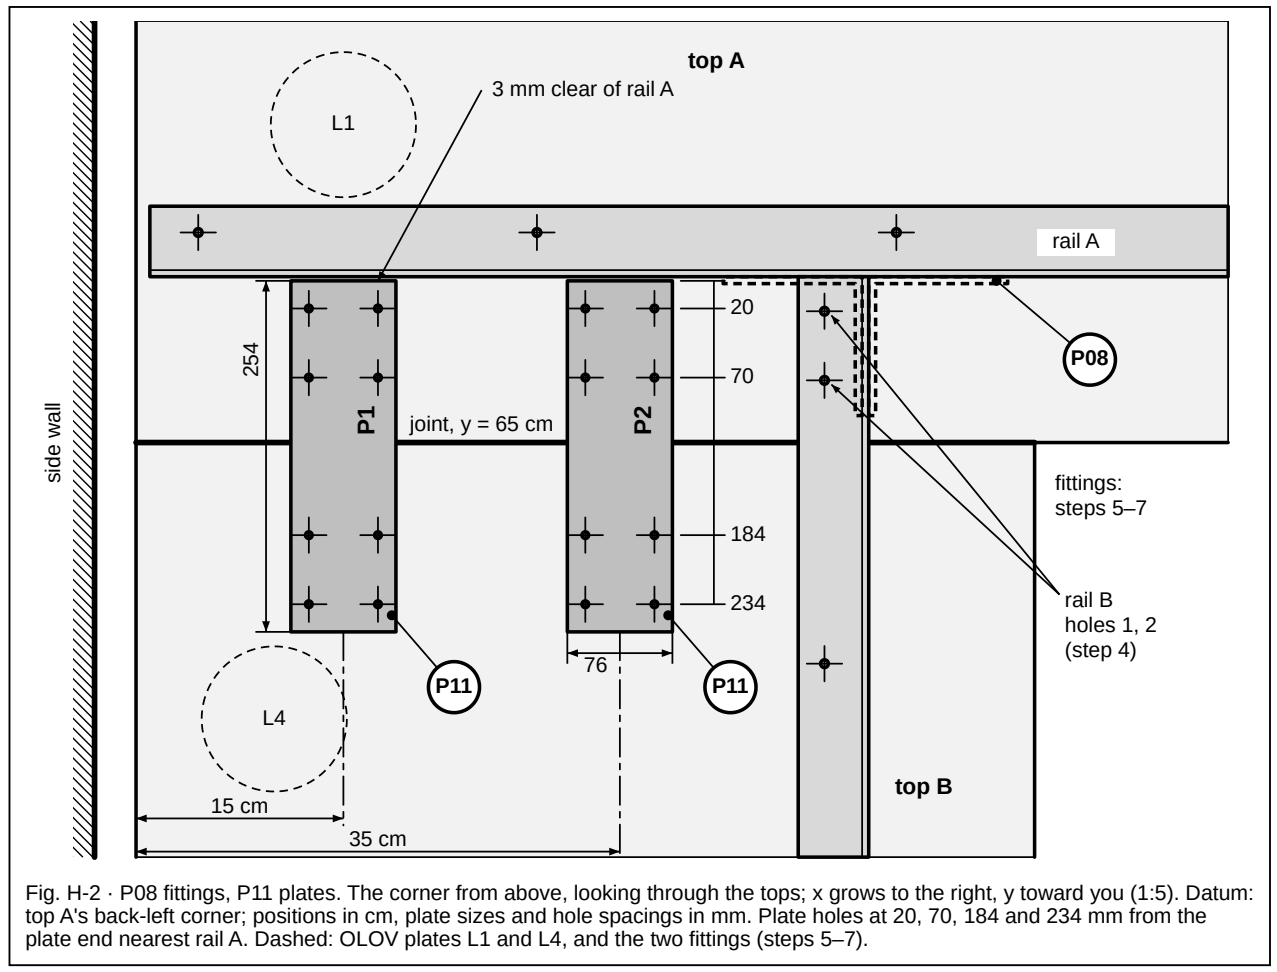
[picture p191: figure]
3 mm clear of rail A L1; top A; top B; rail B holes 1, 2 (step 4); fittings: steps 5–7; joint, y = 65 cm; side wall; rail A

Fig. H-2 · P08 fittings, P11 plates. The corner from above, looking through the tops; x grows to the right, y toward you (1:5). Datum: top A's back-left corner; positions in cm, plate sizes and hole spacings in mm. Plate holes at 20, 70, 184 and 234 mm from the plate end nearest rail A. Dashed: OLOV plates L1 and L4, and the two fittings (steps 5–7).

Plate | Centre x (cm) | Span y (cm) | Screws in top A, y (cm) | Screws in top B, y (cm) | Pilot (mm)
P1 | 15 | 53.3–78.7 | 55.3, 60.3 | 71.7, 76.7 | ⌀3.2 (1/8 in) × 12 deep, puck 12 PLATE
P2 | 35 | 53.3–78.7 | 55.3, 60.3 | 71.7, 76.7 | same

Every plate hole is more than 4 cm from an edge, so all eight get a screw.

L-Shaped Corner Desk · Assembly Manual | H · The joint

4

Rail B's screws 1 and 2. Rail B's first 12 cm lies under top A; its holes 1 and 2 (2.5 cm and 7.5 cm from its corner end) are the only rail holes not yet screwed. Through each, drill a 1/8 in pilot with the drill guide's 25 RAIL puck standing on the flat leg; it stops the bit 20 mm into the wood. Drive H03 #10 × 1 in with the Robertson #2 bit on the 3 in extension until the head seats. SOURCE-DEFINED

a pilot through the rail hole

puck 25 RAIL (P18)
on the leg's face

chuck nose stops here

25 m

m from the leg

20

pilot
⌀3.2 (1/8 in)

b screw driven

20.6 m

m in wood

7.4 left

4.76

28 top

#10 × 1 in pan head (H03)

through the ⌀5.56 (7/32 in) hole

Never more than 21 mm into the 28 mm top. Drawn upright, as for rail B's holes 1 and 2.

Fig. H-3 · One rail screw in section, all mm. The puck stops the pilot 25 mm from the flat leg's face, 20 mm into the wood; the screw passes the 4.76 mm steel and goes 20.6 mm into the 28 mm top, leaving 7.4 mm under the laminate. SOURCE-DEFINED ; top thickness MEASURE ON HARDWARE : if a top reads 27 mm nothing changes, this deepest screw still stops 6 mm short of the laminate; under 27 mm, stop and ask.

Every hole below this point is already drilled: the rails' bolt holes were drilled on the bench through a fitting (chapter E). Rail A: 54.9 cm and 59.8 cm (outside fitting), 48.6 cm and 43.7 cm (inside fitting) from the wall end; rail B: 2.9 cm and 7.8

L-Shaped Corner Desk · Assembly Manual | H · The joint

## The corner assembly

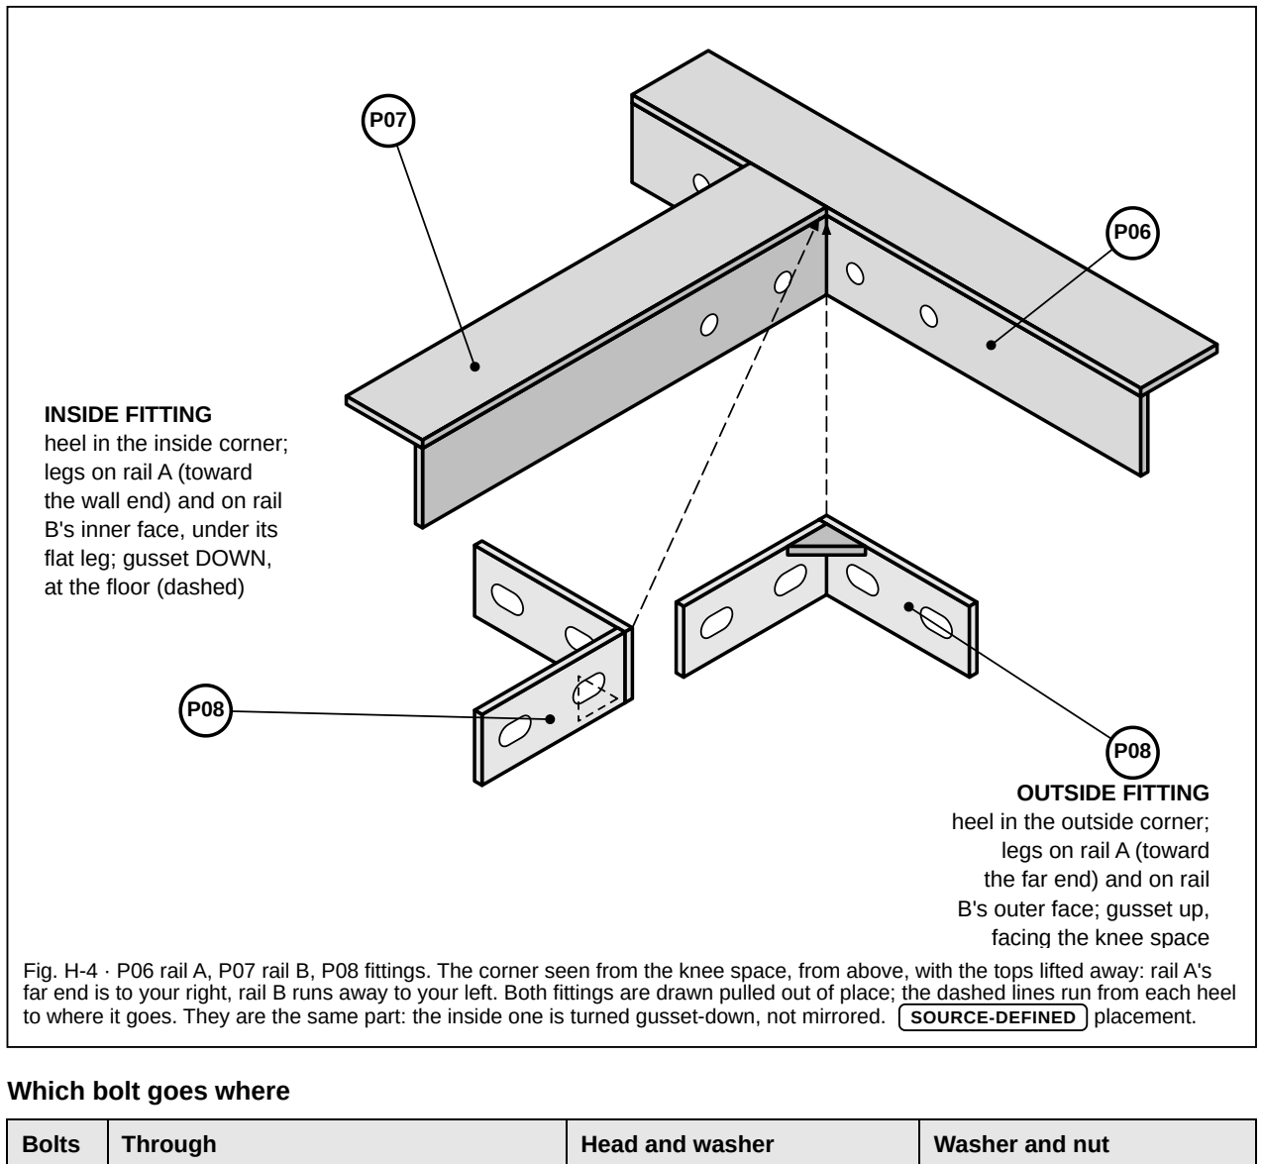
[picture p192: figure]
OUTSIDE FITTING heel in the outside corner; legs on rail A (toward the far end) and on rail B's outer face; gusset up, facing the knee space; INSIDE FITTING heel in the inside corner; legs on rail A (toward the wall end) and on rail B's inner face, under its flat leg; gusset DOWN, at the floor (dashed); Which bolt goes where; Bolts; Through; Head and washer; Washer and nut

Fig. H-4 · P06 rail A, P07 rail B, P08 fittings. The corner seen from the knee space, from above, with the tops lifted away: rail A's far end is to your right, rail B runs away to your left. Both fittings are drawn pulled out of place; the dashed lines run from each heel to where it goes. They are the same part: the inside one is turned gusset-down, not mirrored. SOURCE-DEFINED placement.

O1, O2 | outside fitting + rail A's vertical leg | fitting side, in the knee space | rail A's inner face, under its flat leg
I1, I2 | inside fitting + rail A's vertical leg | fitting side, in the pocket under rail B | rail A's inner face, under its flat leg
C1, C2 | outside fitting + rail B's vertical leg + inside fitting | outside fitting, knee side | inside fitting, in the pocket

Every bolt goes in from the fitting side: four H08 through rail A's leg with one fitting each, two through rail B's leg with a fitting on each side. H09 washer under every head and every nut; H10 nylon-insert nuts.

L-Shaped Corner Desk · Assembly Manual | H · The joint

5

Outside fitting. Heel into the outside corner, one leg flat on rail A's vertical leg toward the far end, the other on rail B's outer face, gusset up, facing the knee space. Push O1 and O2 through from the fitting side with a washer under each head; washer and nut on rail A's inner face. Finger-tight.

6

Inside fitting. Into the pocket: heel in the inside corner, one leg on rail A's vertical leg toward the wall end, the other on the inner face of rail B's vertical leg, gusset pointing at the floor. Gusset-up it would sit 1 mm under the head of rail B's screw 1. I1 and I2 from the fitting side, washers, nuts on rail A's inner face. Finger-tight.

I1 | O1

C1

I2 | O2

C2

rail A (P06)

rail B (P07)

← wall end

outside fitting:
heel on rail A's
52.0 cm mark

inside fitting:
heel on rail A's
51.5 cm mark

Section at the bolt line, 29 mm below the top, seen from above. Dashed: flat legs above the cut.

Fig. H-5 · P06 rail A, P07 rail B. Section at the bolt line, seen from above: x grows to the right (wall end on the left), y toward you. The outside fitting's heel is on rail A's 52.0 cm mark, the inside one's on the 51.5 cm mark. Arrows: insertion direction. The cut runs along the fitting slots, so their 21 mm length shows round each bolt.

L-Shaped Corner Desk · Assembly Manual | H · The joint

7

Through bolts. C1 and C2 from the outside fitting: through the outside fitting, rail B's vertical leg and the inside fitting, washer under the head, washer and nut in the pocket. Finger-tight. All six bolts are now in;

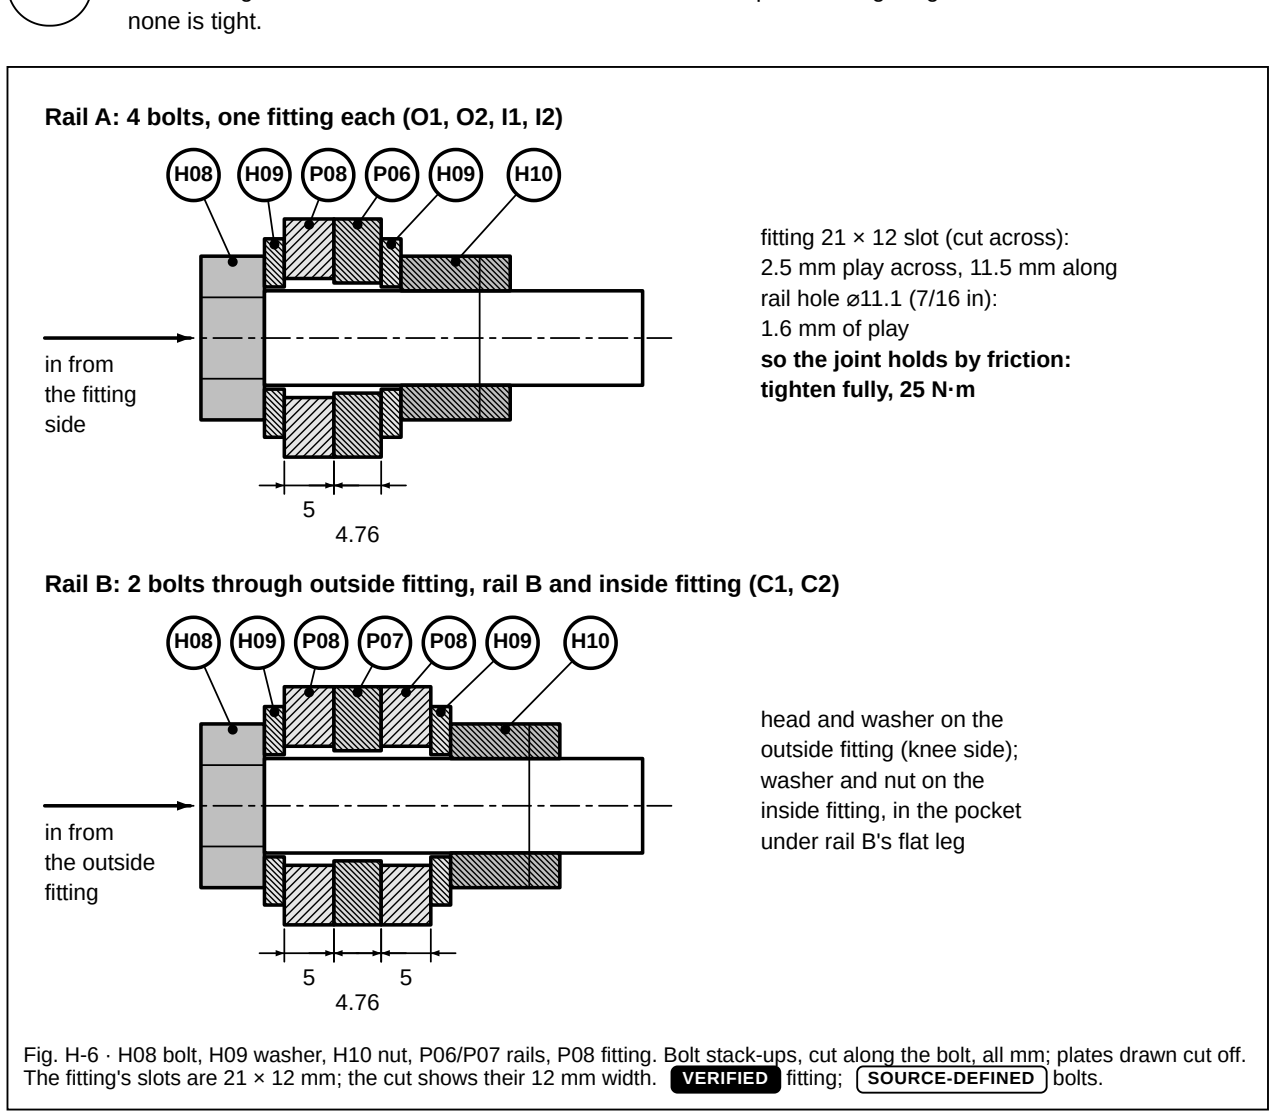
[picture p193: figure]
none is tight.; in from the fitting side; fitting 21 × 12 slot (cut across): 2.5 mm play across, 11.5 mm along rail hole ⌀11.1 (7/16 in): 1.6 mm of play so the joint holds by friction: tighten fully, 25 N·m; in from the outside fitting; head and washer on the outside fitting (knee side); washer and nut on the inside fitting, in the pocket under rail B's flat leg

Rail A: 4 bolts, one fitting each (O1, O2, I1, I2)

Rail B: 2 bolts through outside fitting, rail B and inside fitting (C1, C2)

Fig. H-6 · H08 bolt, H09 washer, H10 nut, P06/P07 rails, P08 fitting. Bolt stack-ups, cut along the bolt, all mm; plates drawn cut off. The fitting's slots are 21 × 12 mm; the cut shows their 12 mm width. VERIFIED fitting; SOURCE-DEFINED bolts.

8

Check again, then tighten all six. Fingertip across the joint: no step. Rail B's end still touching rail A. Then tighten every bolt fully, as the panel says.

!

TIGHTENING: 25 N·m (18 ft·lb) SOURCE-DEFINED
With a torque wrench, 25 N·m (18 ft·lb), under the standard dry torque even for a grade 2 bolt. Without one, pull as hard as one hand can on a 15 cm wrench, then stop. Never an impact wrench or impact driver on these bolts: a 1/2 in impact wrench delivers many times this and will strip the 3/8 thread or shear the bolt; run the nuts down by hand and finish with a hand ratchet or torque wrench, 9/16 in socket.
Why tight, not snug: this is a friction joint. The fittings' 21 × 12 mm slots leave 2.5 mm of play across and 11.5 mm along each bolt, the 7/16 in rail holes 1.6 mm, so only the clamping force keeps rail B's corner from settling. When: only after the two surfaces are flush and rail B's end touches rail A.
Later: if the corner ever drops a millimetre, retighten these six bolts.
L-Shaped Corner Desk · Assembly Manual | H · The joint

9

Quick checks before the mount. If one fails, fix it with the feet or the legs, never at the joint. Heights at the corners are measured in chapter K.

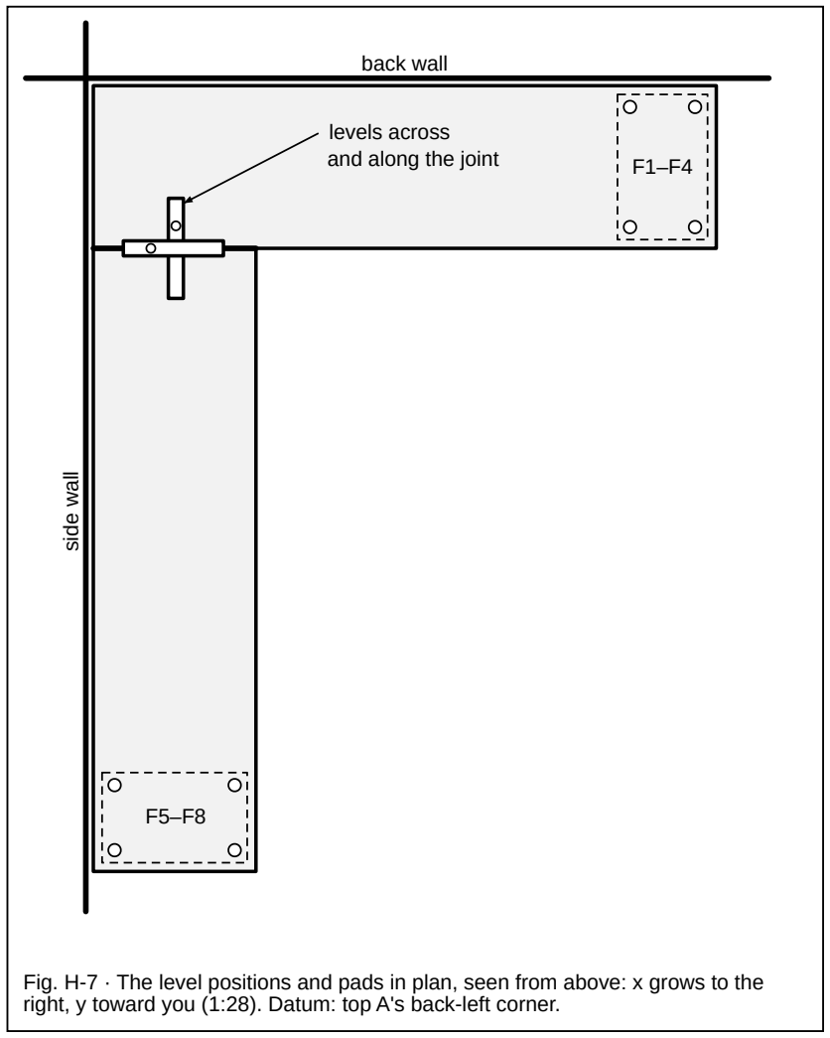
[picture p194: figure]
back wall; side wall; levels across and along the joint

Fig. H-7 · The level positions and pads in plan, seen from above: x grows to the right, y toward you (1:28). Datum: top A's back-left corner.

Level: a level across the joint and along it reads flat both ways; a fingertip finds no step.
Pads: all eight bear. Rock each of F1–F8 sideways by hand; do not turn it, that changes its height. None rocks or lifts.

Load test, sideways push and settling record: chapter K. Never stand or sit on the corner.

Next: chapter I, the monitor mount.

L-Shaped Corner Desk · Assembly Manual | H · The joint

# I · Monitor mount and accessories

The VIVO STAND-V300CU (P12) has two independent C-clamps and no base bar. Both clamp onto top A's own wall edges, never on the joint: clamp 1 centred at x = 40.0 cm on the back edge, clamp 2 centred at y = 40.0 cm on the side-wall end. The crossbar runs on the diagonal between the poles. Each lower jaw bears on a spare steel mending plate (P11), because particleboard crushes under a bare steel jaw over months. Datum: top A's back-left corner (0, 0); x along the back wall, y along the side wall.

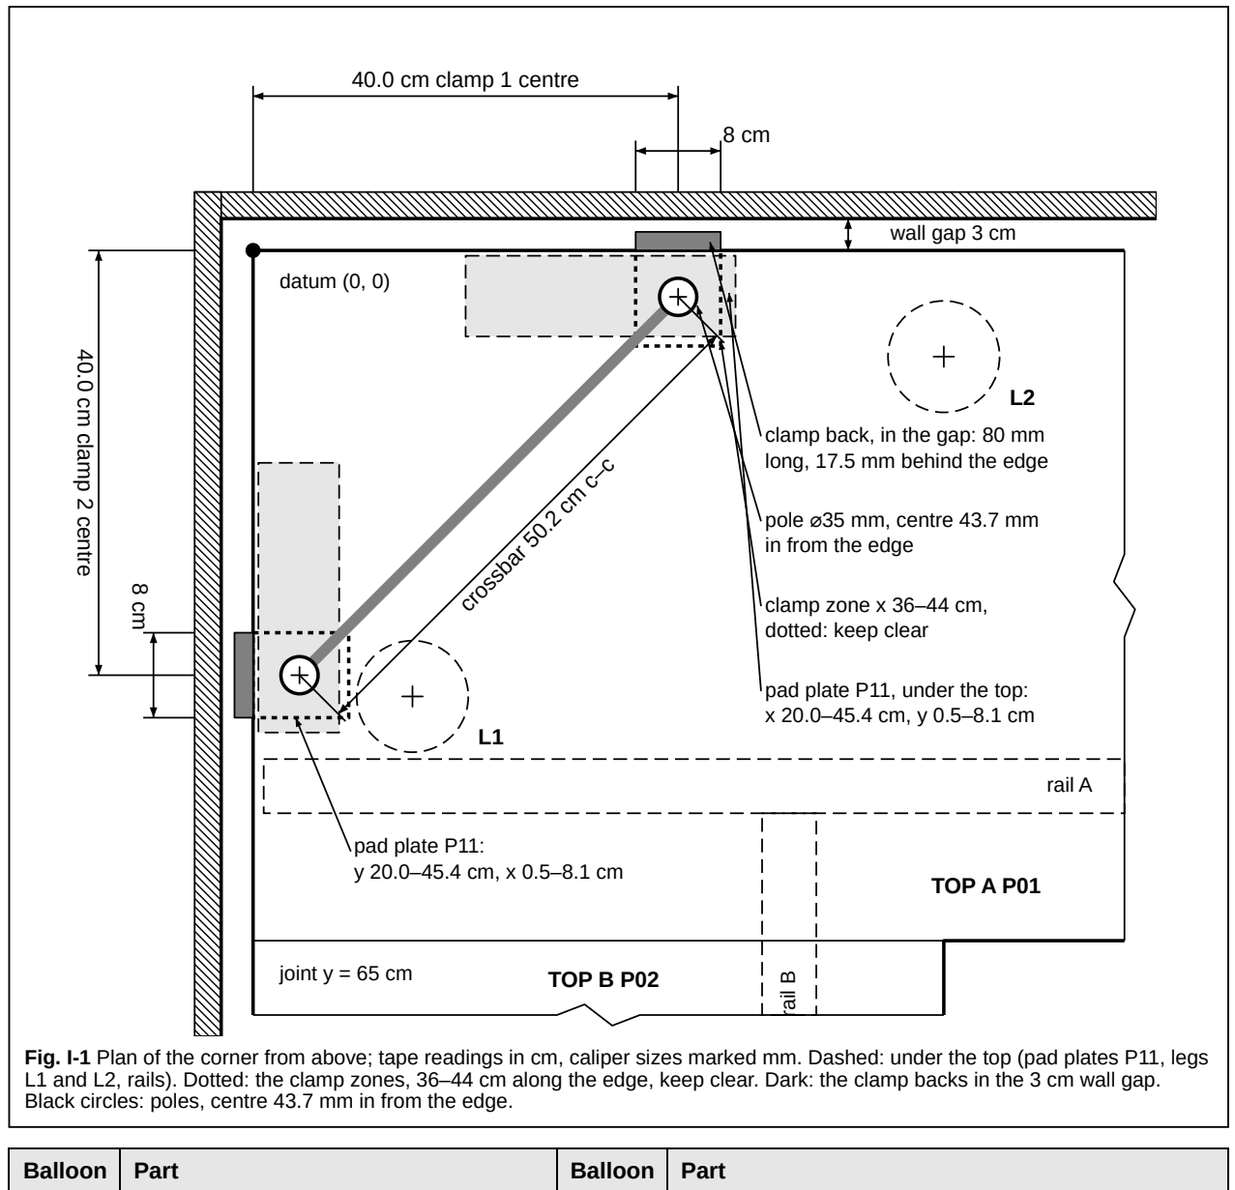
[picture p195: figure]
40.0 cm clamp 1 centre; 40.0 cm cla; mp 2 centre; wall gap 3 cm; crossbar 50.2 cm c–c; datum (0, 0); clamp back, in the gap: 80 mm long, 17.5 mm behind the edge; pole ⌀35 mm, centre 43.7 mm in from the edge; clamp zone x 36–44 cm, dotted: keep clear; pad plate P11, under the top: x 20.0–45.4 cm, y 0.5–8.1 cm; pad plate P11: y 20.0–45.4 cm, x 0.5–8.1 cm; rail A; rail; joint y = 65 cm; TOP A P01; TOP B P02; Balloon; Part

Fig. I-1 Plan of the corner from above; tape readings in cm, caliper sizes marked mm. Dashed: under the top (pad plates P11, legs L1 and L2, rails). Dotted: the clamp zones, 36–44 cm along the edge, keep clear. Dark: the clamp backs in the 3 cm wall gap. Black circles: poles, centre 43.7 mm in from the edge.

P01 | Top A, EKBACKEN 249 × 65 cm, 28 mm thick | P11 | Mending plate 10 × 3 × 0.12 in, two used here as clamp pads
P02 | Top B, EKBACKEN 249 × 65 cm, 28 mm thick | P12 | VIVO STAND-V300CU (clamps, poles, crossbar, arms)
L-Shaped Corner Desk · Assembly Manual | I · Monitor mount

## What is measured at the clamp

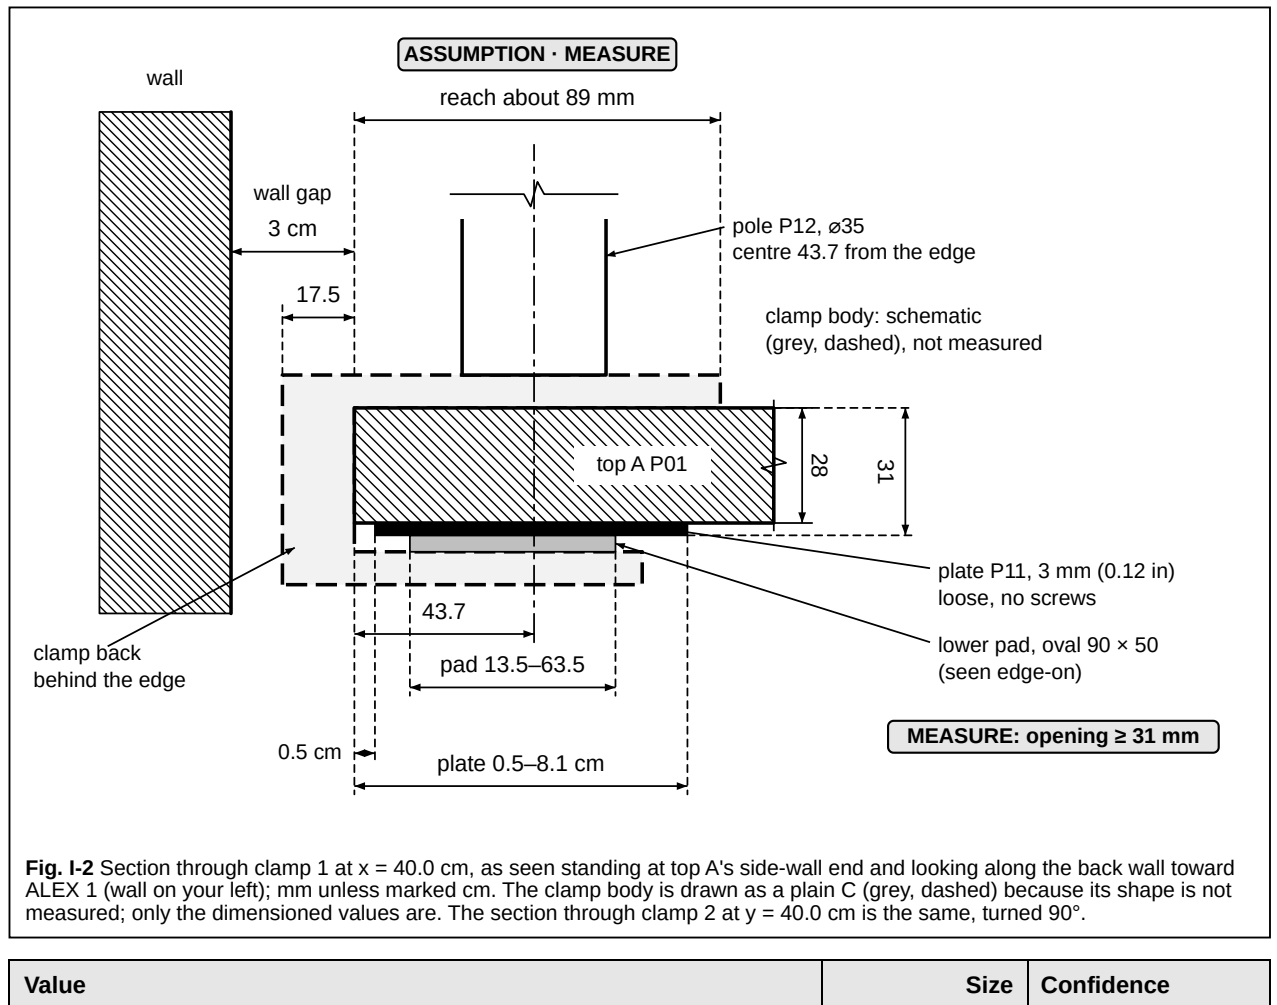
[picture p196: figure]
wall; top A P01; wall gap; pad 13.5–63.5; plate 0.5–8.1 cm; reach about 89 mm; ASSUMPTION · MEASURE; pole P12, ⌀35 centre 43.7 from the edge; clamp back behind the edge; plate P11, 3 mm (0.12 in) loose, no screws; lower pad, oval 90 × 50 (seen edge-on); clamp body: schematic (grey, dashed), not measured; MEASURE: opening ≥ 31 mm; Value; Size; Confidence

Fig. I-2 Section through clamp 1 at x = 40.0 cm, as seen standing at top A's side-wall end and looking along the back wall toward ALEX 1 (wall on your left); mm unless marked cm. The clamp body is drawn as a plain C (grey, dashed) because its shape is not measured; only the dimensioned values are. The section through clamp 2 at y = 40.0 cm is the same, turned 90°.

Crossbar, centre to centre of its end collars (19¾ in) | 50.2 cm | VERIFIED
Pole diameter; pole centre in from the desk edge | 35 mm; 43.7 mm | VERIFIED
Clamp back: length along the edge; projection behind the edge (it sits in the 3 cm wall gap) | 80 mm; 17.5 mm | VERIFIED
Lower pad: oval 90 × 50 mm, 13.5 to 63.5 mm in from the edge, so it lands on the plate (0.5–8.1 cm from the edge) | 13.5–63.5 mm | VERIFIED
Clamp centre from the corner: ideal 39.9 cm; built at 40.0 cm, the crossbar sets the last millimetre | 40.0 cm | SOURCE-DEFINED
Clamp zones x 36–44 cm, y 0–9 cm (clamp 1) and y 36–44 cm, x 0–9 cm (clamp 2); pad plates x 20.0–45.4 cm, y 0.5–8.1 cm and y 20.0–45.4 cm, x 0.5–8.1 cm | Fig. I-1 | SOURCE-DEFINED
Top 28 mm plus plate 3 mm (0.12 in): under 60 mm, so VIVO's Option 1 holes (2 and 4 on the lower clamp) | 31 mm | SOURCE-DEFINED
Top arm reach from the edge | about 89 mm | ASSUMPTION / FIELD CHECK
Maximum jaw opening (must be 31 mm or more) | ≥ 31 mm | MEASURE ON HARDWARE
L-Shaped Corner Desk · Assembly Manual | I · Monitor mount

## Hang the mount

1

Lay the pad plates. Lay a spare mending plate P11 flat on the underside, on each pad outline drawn when top A was marked (chapter D), long side along the edge: x 20.0–45.4 cm, y 0.5–8.1 cm at clamp 1; y 20.0– 45.4 cm, x 0.5–8.1 cm at clamp 2. Loose, no screws: the jaw holds it. SOURCE-DEFINED

!

MEASURE ON HARDWARE before hanging the clamps
Top arm reach (about 89 mm) and maximum opening (needs 31 mm or more: 28 mm top + 3 mm plate) are not measured. Open the lower clamp fully on the Option 1 holes and measure the gap with calipers; if it is under 31 mm, stop. The clamp zones are drawn 9 cm deep from the edge; if the reach measures more, keep the zone clear to the measured reach.

2

Hang both lower clamps, finger-tight only. Clamp 1 centred at x = 40.0 cm on A's back edge, clamp 2 centred at y = 40.0 cm on A's side-wall end (Fig. I-1). Use the VIVO sheet's Option 1 holes (2 and 4): top and plate together are 31 mm, under 60 mm. The clamp backs sit in the 3 cm wall gap; the lower pad lands on the plate, 13.5–63.5 mm from the edge (Fig. I-2).

3

Fit the poles and the crossbar as the spacing guide (VIVO sheet step 3). The crossbar measured 50.2 cm centre to centre, so it fixes the pole spacing. Only now tighten both clamps, with the crossbar on.

VERIFIED

4

Refit the crossbar at monitor height (VIVO sheet step 6): 40–43 cm above the top (123.0–126.0 cm from the floor).

5

Hang the three screens, all landscape, and set the heights in Fig. I-3. The G5 goes on the centre bracket (VESA 75), screen centred on the diagonal at (36.5, 36.5) cm, 20 cm in front of the crossbar. The Acers go on the side arms, toed in 15°; each Acer's near end ends up about 12 cm from the G5's curved end. The side arms run along the wall behind each panel, then forward into the VESA plate.

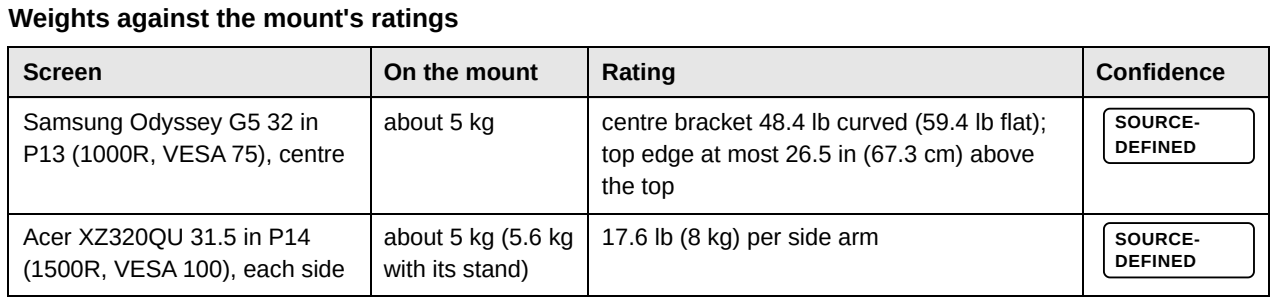
[picture p197: figure]
Weights against the mount's ratings; Screen; On the mount; Rating; Confidence

Samsung Odyssey G5 32 in P13 (1000R, VESA 75), centre | about 5 kg | centre bracket 48.4 lb curved (59.4 lb flat); top edge at most 26.5 in (67.3 cm) above the top | SOURCE-DEFINED
Acer XZ320QU 31.5 in P14 (1500R, VESA 100), each side | about 5 kg (5.6 kg with its stand) | 17.6 lb (8 kg) per side arm | SOURCE-DEFINED

Ratings: the VIVO listing as quoted in docs/design-review.md (facts.json monitors.vivo_ratings); screen weights from the same review.

The clamps load top A's edges near legs L1 and L2, not the corner tip. Do not add a soft pad under a jaw: the steel plate is the pad.

L-Shaped Corner Desk · Assembly Manual | I · Monitor mount

## Heights above the top

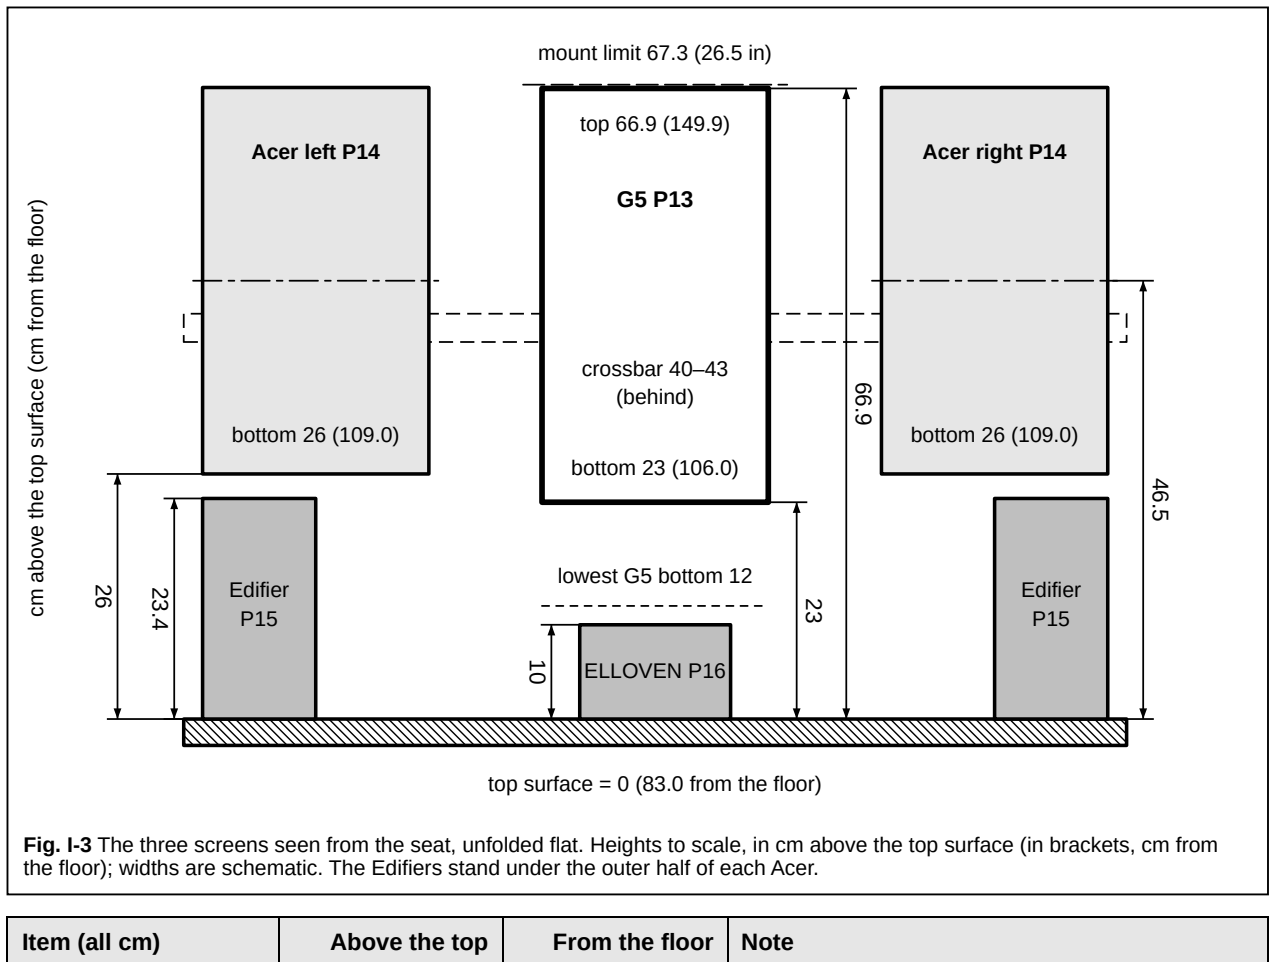
[picture p198: figure]
Acer left P14; bottom 26 (109.0); Acer right P14; top 66.9 (149.9); bottom 23 (106.0); ELLOVEN P16; lowest G5 bottom 12; mount limit 67.3 (26.5 in); Edifier P15; crossbar 40–43 (behind); top surface = 0 (83.0 from the floor); Item (all cm); Above the top; From the floor; Note

cm above the top surface (cm from the floor)

Fig. I-3 The three screens seen from the seat, unfolded flat. Heights to scale, in cm above the top surface (in brackets, cm from the floor); widths are schematic. The Edifiers stand under the outer half of each Acer.

Top surface | 0 | 83.0 | underside 80.2, top 28 mm thick
ELLOVEN P16 top | 10 | 93.0 | 13 under the G5
G5 bottom edge | 23 | 106.0 | SOURCE-DEFINED
Edifier P15 top | 23.4 | 106.4 | 2.6 under each Acer
Acer bottom edges | 26 | 109.0 | panel centre 46.5 above the top
VIVO crossbar | 40–43 | 123.0–126.0 | refitted at monitor height
G5 top edge | 66.9 | 149.9 | 0.4 under the mount's 67.3 (26.5 in) limit

The G5's top edge at 66.9 cm is only 0.4 cm under the 67.3 cm limit. If the assembled mount will not reach, lower the G5: a bottom edge anywhere down to 12 cm above the top still clears the ELLOVEN (10 cm tall).

L-Shaped Corner Desk · Assembly Manual | I · Monitor mount

## Everything else on the desk

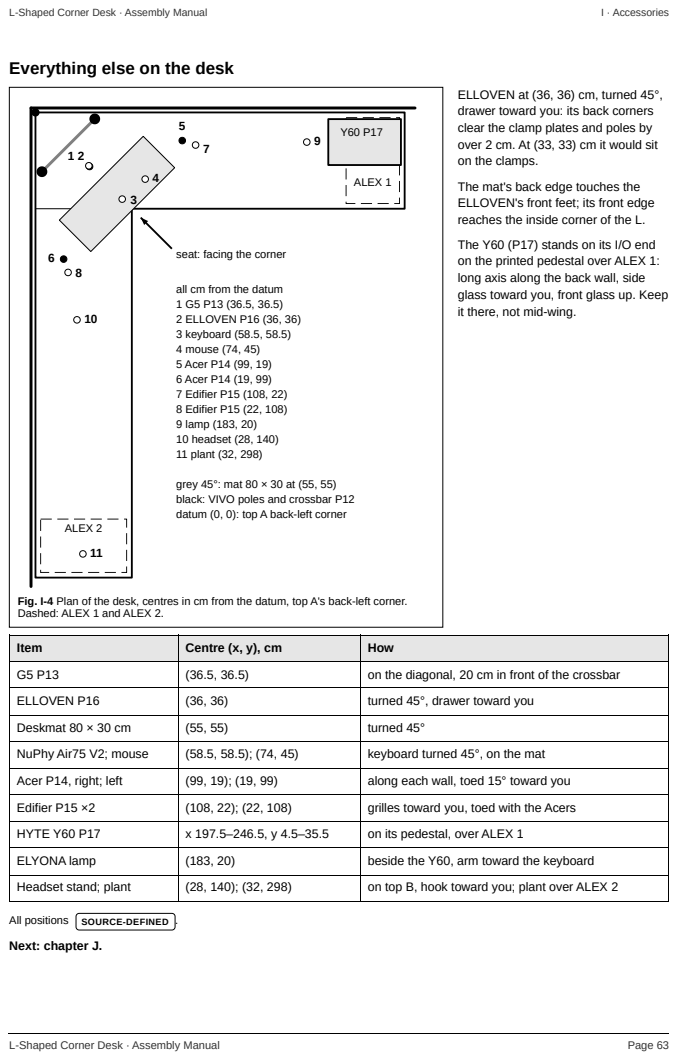
[picture p199: page 63]
ALEX 1; ALEX 2; all cm from the datum 1 G5 P13 (36.5, 36.5) 2 ELLOVEN P16 (36, 36) 3 keyboard (58.5, 58.5) 4 mouse (74, 45) 5 Acer P14 (99, 19) 6 Acer P14 (19, 99) 7 Edifier P15 (108, 22) 8 Edifier P15 (22, 108) 9 lamp (183, 20) 10 headset (28, 140) 11 plant (32, 298); L-Shaped Corner Desk · Assembly Manual; I · Accessories

ELLOVEN at (36, 36) cm, turned 45°,
drawer toward you: its back corners
clear the clamp plates and poles by
over 2 cm. At (33, 33) cm it would sit
on the clamps.
The mat's back edge touches the
ELLOVEN's front feet; its front edge
reaches the inside corner of the L.
The Y60 (P17) stands on its I/O end
on the printed pedestal over ALEX 1:
long axis along the back wall, side
glass toward you, front glass up. Keep
it there, not mid-wing.

seat: facing the corner

grey 45°: mat 80 × 30 at (55, 55)
black: VIVO poles and crossbar P12
datum (0, 0): top A back-left corner

Fig. I-4 Plan of the desk, centres in cm from the datum, top A's back-left corner.
Dashed: ALEX 1 and ALEX 2.

Item | Centre (x, y), cm | How

G5 P13 | (36.5, 36.5) | on the diagonal, 20 cm in front of the crossbar

ELLOVEN P16 | (36, 36) | turned 45°, drawer toward you

Deskmat 80 × 30 cm | (55, 55) | turned 45°

NuPhy Air75 V2; mouse | (58.5, 58.5); (74, 45) | keyboard turned 45°, on the mat

Acer P14, right; left | (99, 19); (19, 99) | along each wall, toed 15° toward you

Edifier P15 ×2 | (108, 22); (22, 108) | grilles toward you, toed with the Acers

HYTE Y60 P17 | x 197.5–246.5, y 4.5–35.5 | on its pedestal, over ALEX 1

ELYONA lamp | (183, 20) | beside the Y60, arm toward the keyboard

Headset stand; plant | (28, 140); (32, 298) | on top B, hook toward you; plant over ALEX 2

All positions SOURCE-DEFINED .
Next: chapter J.

# J · Wall-gap trim (optional)

The clamp pieces wrap round the VIVO clamp backs, so both clamps must already be fitted and tight. The trim goes on before the final push to the walls.

Parts: P19 wall-gap trim (corner, two 80 mm fillers, two clamp pieces, 240 mm segments, the short end pieces, connector tiles, two end caps), H07 #4 × 1/2 in flat head × 48. Tools: tape measure, drill guide with the 10 EDGE puck, 5/64 in bit, wall gauge. No figure in this chapter uses part balloons.

1

Unload the desk. Take the screens, the PC and everything loose off the desk.

2

Measure, set, print. With the desk still against both walls, measure the gap between each top's raw back edge and the wall, in mm, at five or six points along each wall. Take the smallest reading, find it in the table, and set gap in parts/accessories/wall-gap-common.scad to the value under it. Then print the trim.

MEASURE ON HARDWARE

Smallest gap (mm) | 27 | 28 | 29 | 30 | 31 | 32 | 33 | under 27 or over 33
Set gap to | 26 | 27 | 28 | 29 (as saved) | 30 | 31 | 32 | measure again and ask before printing
Wall | From the wall corner outward: desk positions in cm, piece lengths in mm | Slotted segments (cm)
back | corner (to 20), 80 mm filler (20–28), clamp piece (28–52), 8 × 240 mm, 1 × 50 mm (to 249) | 3rd (100–124), 8th (220– 244)
side | corner (to 20), 80 mm filler (20–28), clamp piece (28–52), 10 × 240 mm, 1 × 220 mm (to 314) | 3rd (100–124)

The corner piece covers each wall's first 20 cm of desk. 24 connector tiles: 11 joints on the back wall, 13 on the side wall. Cut list from parts/README.md.

L-Shaped Corner Desk · Assembly Manual | J · Wall-gap trim

3

Pull the desk out, 40 cm from both walls. Two people, one at each ALEX unit: slide the whole desk away from both walls. The ALEX units slide on their feet and the pads stay in their rings. Nothing comes apart.

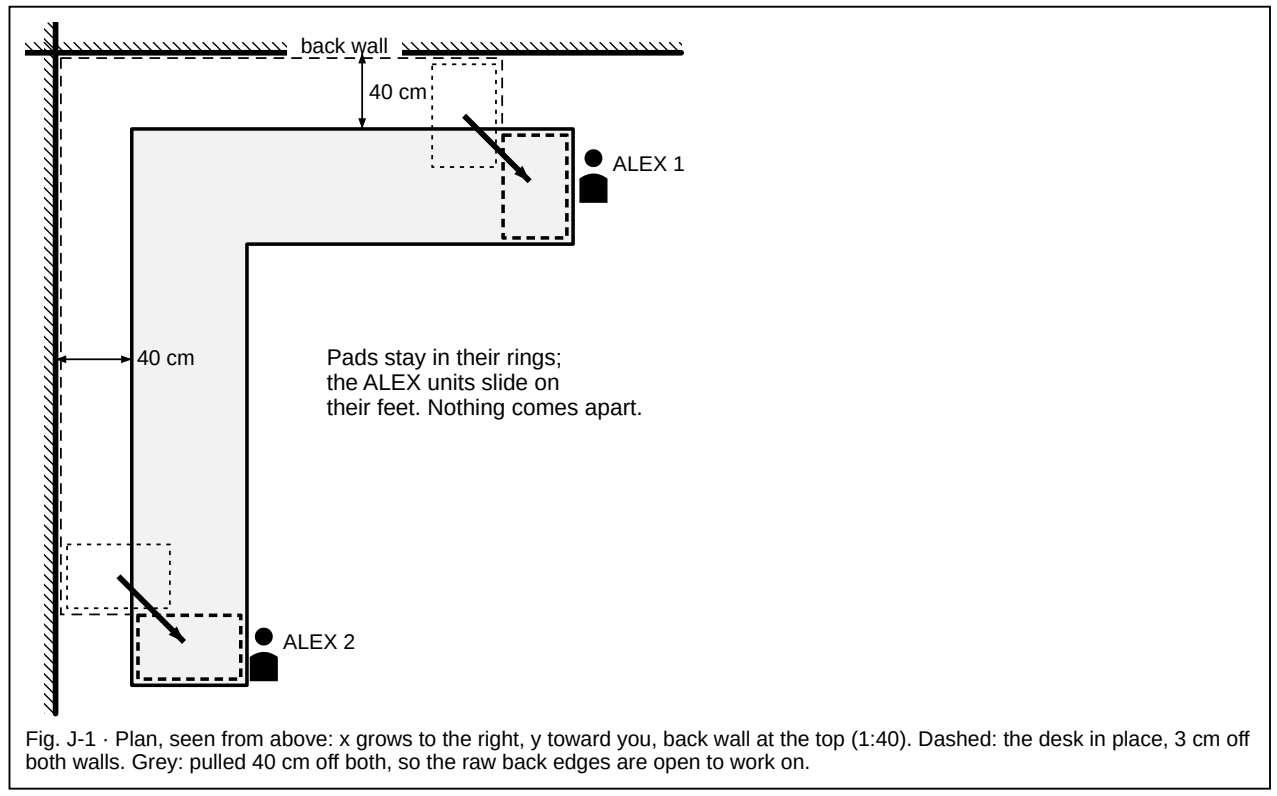
[picture p200: figure]
back wall; ALEX 1; ALEX 2; Pads stay in their rings; the ALEX units slide on their feet. Nothing comes apart.

Fig. J-1 · Plan, seen from above: x grows to the right, y toward you, back wall at the top (1:40). Dashed: the desk in place, 3 cm off both walls. Grey: pulled 40 cm off both, so the raw back edges are open to work on.

L-Shaped Corner Desk · Assembly Manual | J · Wall-gap trim

4

Build each chain from the corner outward. Corner piece, 80 mm filler, clamp piece with its notch round the clamp back, then the 240 mm segments (slotted ones where the cut list says), ending with the short piece. Butt every joint and push a connector tile up into the pockets. Push an end cap into the last piece's end pocket, end wall flush with the trim's end.

back wall
C F
K
1 | 2 | 3 | 4 | 5 | 6 | 7 | 8 | 50 mm
0 | 20 | 52 | 100 | 124 | 220 | 244

side wall
C F
K
1 | 2 | 3 | 4 | 5 | 6 | 7 | 8 | 9 | 10 | 220
0 | 20 | 52 | 100 | 124 | 292 | 314

Desk positions in cm. C corner · F 80 mm filler · K clamp piece (white: notch round the clamp back)
1, 2 … 240 mm segments, grey with a slot = slotted · ■ connector tile under every joint

Fig. J-2 · Chain order along both walls, straightened out: the wall corner on the left, desk positions in cm growing to the right, piece lengths in mm (1:20). The notch (white, in K) wraps the clamp back, 80 mm long and 17.5 mm proud VERIFIED .

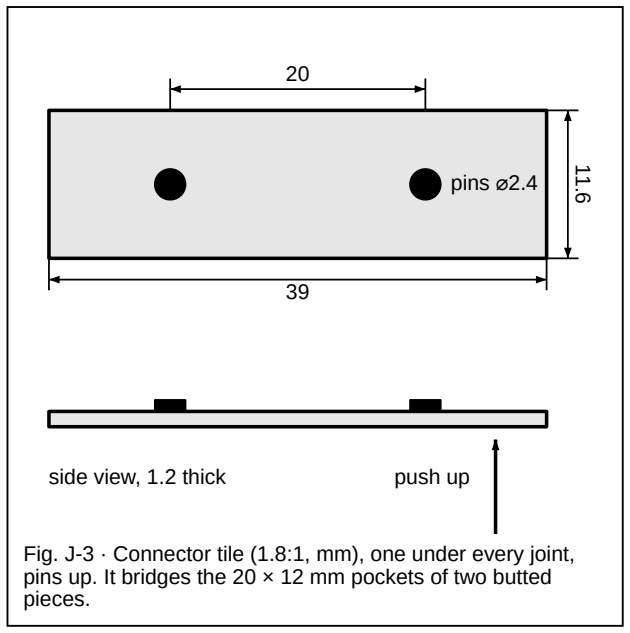
[picture p201: figure]
pins ⌀2.4; side view, 1.2 thick; push up; pieces.

Fig. J-3 · Connector tile (1.8:1, mm), one under every joint, pins up. It bridges the 20 × 12 mm pockets of two butted

Every piece, the corner included, has a pocket on its underside at each end, over the gap. Butt two pieces, then push a tile up into both pockets until its pins seat: the joint cannot step, bow or drift, and nothing shows on top. The end cap is half a tile with a 28 mm end wall: it clips into the far-end pocket of each chain and closes the gap where the raw edge would show from the side.

If a wall is out and the notch misses the clamp, change the 80 mm filler's seg and reprint it, nothing else.

L-Shaped Corner Desk · Assembly Manual | J · Wall-gap trim

5

Pilot and screw. Through each lip hole, pilot 5/64 in, 10 mm deep, drill horizontal, with the drill guide's 10 EDGE puck held against the raw edge. Drive an H07 #4 × 1/2 in flat head into each: two per segment, one per corner leg, one each side of a clamp notch.

29 reach | 12 on top

1 to
the wall
20 lip

14

pilot ⌀2.0 (5/64 in) × 10 mm deep, puck 10 EDGE, bit horizontal

#4 × 1/2 in flat head (H07)

desk top, raw back edge

desk surface

gap
(wall side)

Fig. J-4 · Trim on the raw back edge, section across the edge (1.8:1, mm), seen from the side-wall end looking along the back wall (x grows away from you): the wall on the left, the desk on the right. 12 mm rests on the surface, the 20 mm lip drops into the gap, the screw sits 14 mm below the surface: nothing shows on top and nothing goes into the top face. Profile from parts/accessories/wall-gap-common.scad SOURCE-DEFINED ; top 28 mm thick MEASURE ON HARDWARE .

6

Slide the desk back. Two people again, one at each ALEX, until the wall gauge's ALEX 65 leg (6.5 cm) just fits between the wall and each ALEX. The trim's outer edge stops 1 mm short of the wall.

7

Load the desk again. Put the screens, the PC and everything else back in their chapter I positions: chapter K checks the desk with everything in place.

Retighten every screw after two weeks.

Next: chapter K, final inspection and load testing.

ALEX 65
leg

6.5 cm

3 cm

ALEX 1

top A

back wall

Fig. J-5 · Wall gauge at ALEX 1, section across the back wall, seen from the side-wall end looking along the back wall (x grows away from you): the wall on the left, the room on the right (1:3.3).

L-Shaped Corner Desk · Assembly Manual | J · Wall-gap trim

# K · Final inspection and load testing

Ten checks, in order, before you call the desk done. Each is an ACCEPTANCE CHECK : a pass or fail you can see or measure. Several of them test a STRUCTURAL ESTIMATE from the design review that has not been measured on this desk; the check says which. Write the results in the boxes and in the sign-off table at the end of this chapter. Datum for every drawing: top A's back-left corner (0, 0).

## Check 1 · Surface height at the six corners ACCEPTANCE CHECK

1

Measure from the floor to the top face at the six supported corners 1 to 6, then the inside corner 7 last (Fig. K-1). Every reading 83.0 cm ± 0.3 cm (82.7 to 83.3 cm). With the optional ALEX feet fitted, read instead: 2 cm feet 85.0 cm, 4 cm feet 87.0 cm, 6 cm feet 89.0 cm, each ± 0.3 cm. If a corner is out, adjust only what carries it, then measure all seven again (positions x, y in cm): corner 1 (0, 0) by legs L1 and L2; corners 2 (249, 0) and 3 (249, 65) by the ALEX 1 feet; corners 4 (65, 314) and 5 (0, 314) by the ALEX 2 feet; corner 6 (0, 65) by leg L4. Corner 7, the inside corner (65, 65), has no support of its own: it follows the joint, so it is measured last and set by chapter H, never adjusted here.

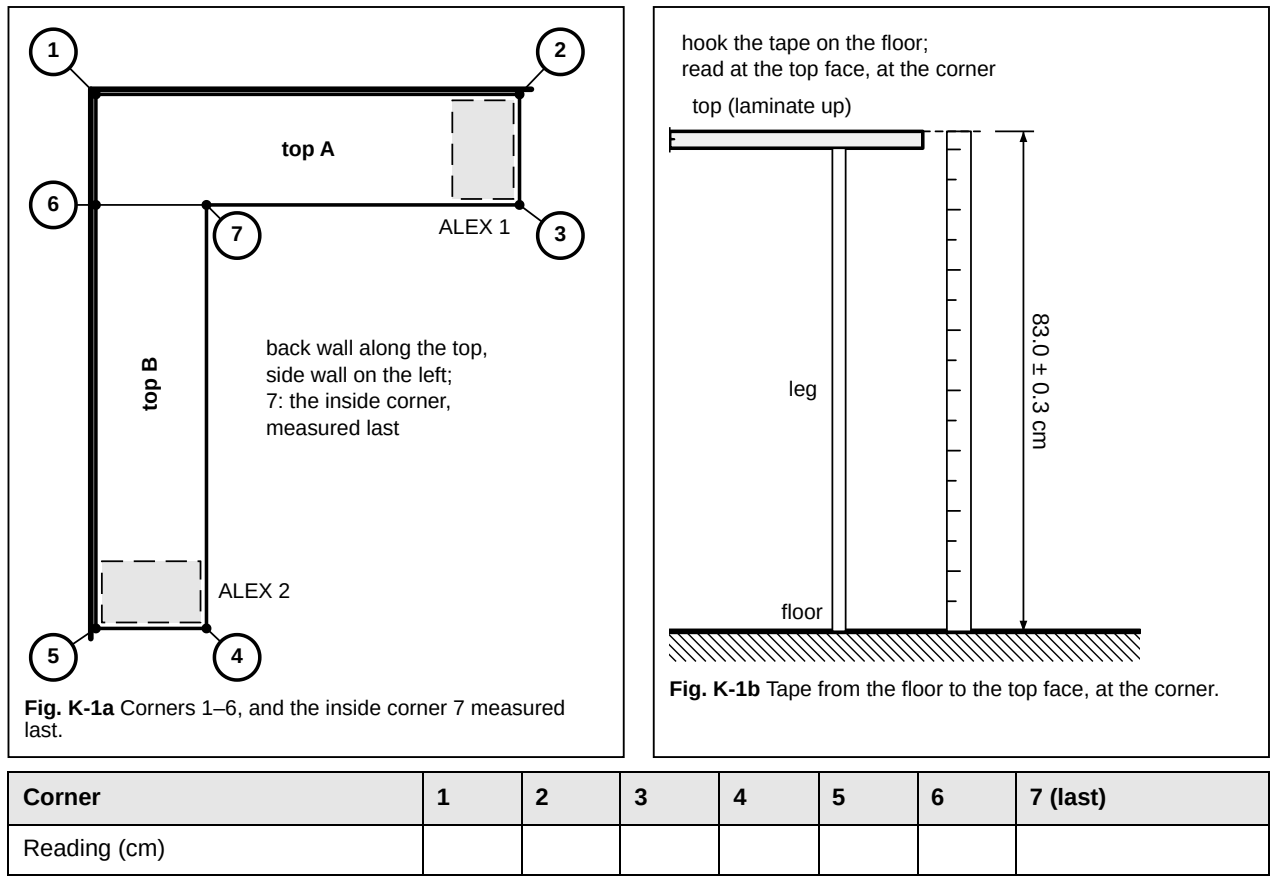
[picture p202: figure]
7 ALEX 1; ALEX 2; top A; top B; back wall along the top, side wall on the left; 7: the inside corner, measured last; last.; leg; hook the tape on the floor; read at the top face, at the corner; top (laminate up); floor; Corner; 7 (last); Reading (cm)

Fig. K-1a Corners 1–6, and the inside corner 7 measured

Fig. K-1b Tape from the floor to the top face, at the corner.

L-Shaped Corner Desk · Assembly Manual | K · Final inspection

## Check 2 · Level and flush across the joint ACCEPTANCE CHECK

2

A level across the joint reads flat both ways: across it (1) and along it (2). A fingertip drawn across the joint
(3) finds no step. Level the two tops with the OLOV feet and the round feet, never by packing anything under the joining plates.

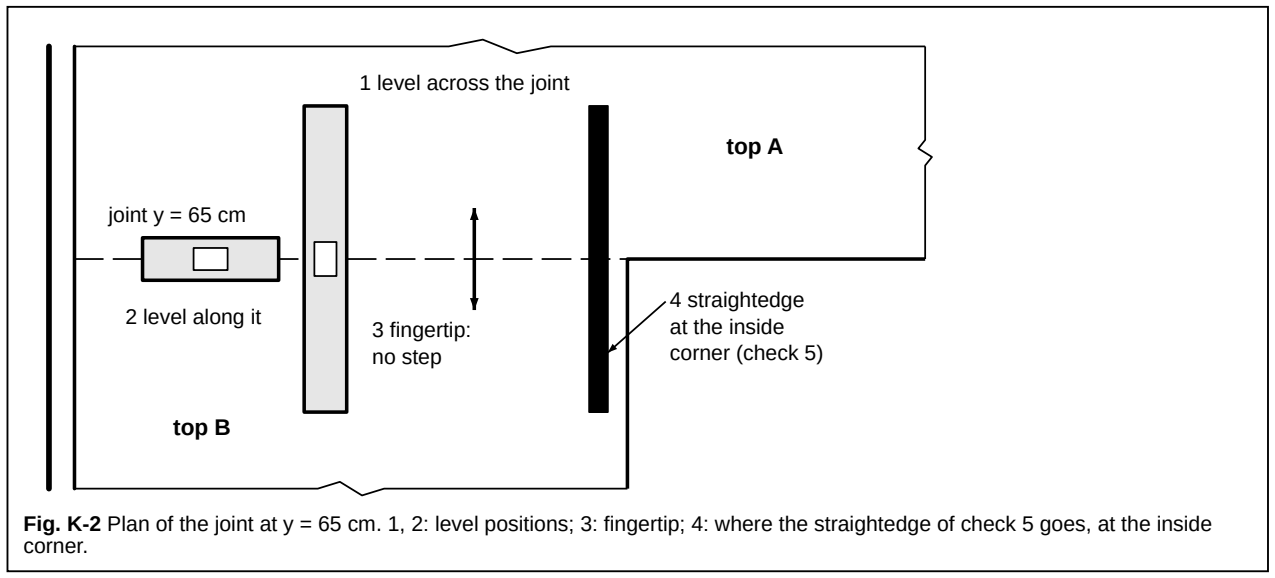
[picture p203: figure]
1 level across the joint; 2 level along it; 3 fingertip: no step; 4 straightedge at the inside corner (check 5); top A; top B; joint y = 65 cm; corner.

Fig. K-2 Plan of the joint at y = 65 cm. 1, 2: level positions; 3: fingertip; 4: where the straightedge of check 5 goes, at the inside

## For the remaining checks you need

Wrench
torque wrench at 25 N·m, or a 15 cm wrench, checks 5
and 10

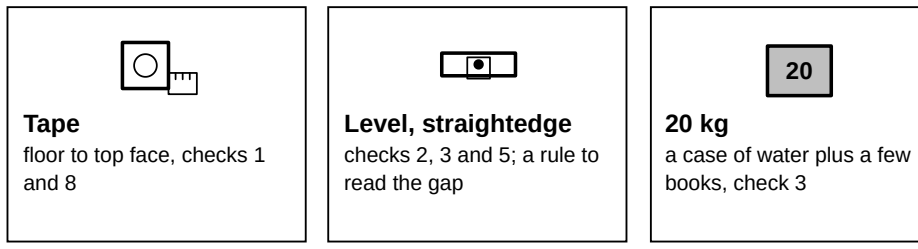
[picture p204: figure]
Tape floor to top face, checks 1 and 8; Level, straightedge checks 2, 3 and 5; a rule to read the gap; 20 kg a case of water plus a few books, check 3

Do the checks in this order, with the screens and everything else in place.

L-Shaped Corner Desk · Assembly Manual | K · Final inspection

## Check 3 · Corner load test ACCEPTANCE CHECK

The test load is a known weight: 20 kg of water and books. Do not stand or sit on the corner; that is not what the

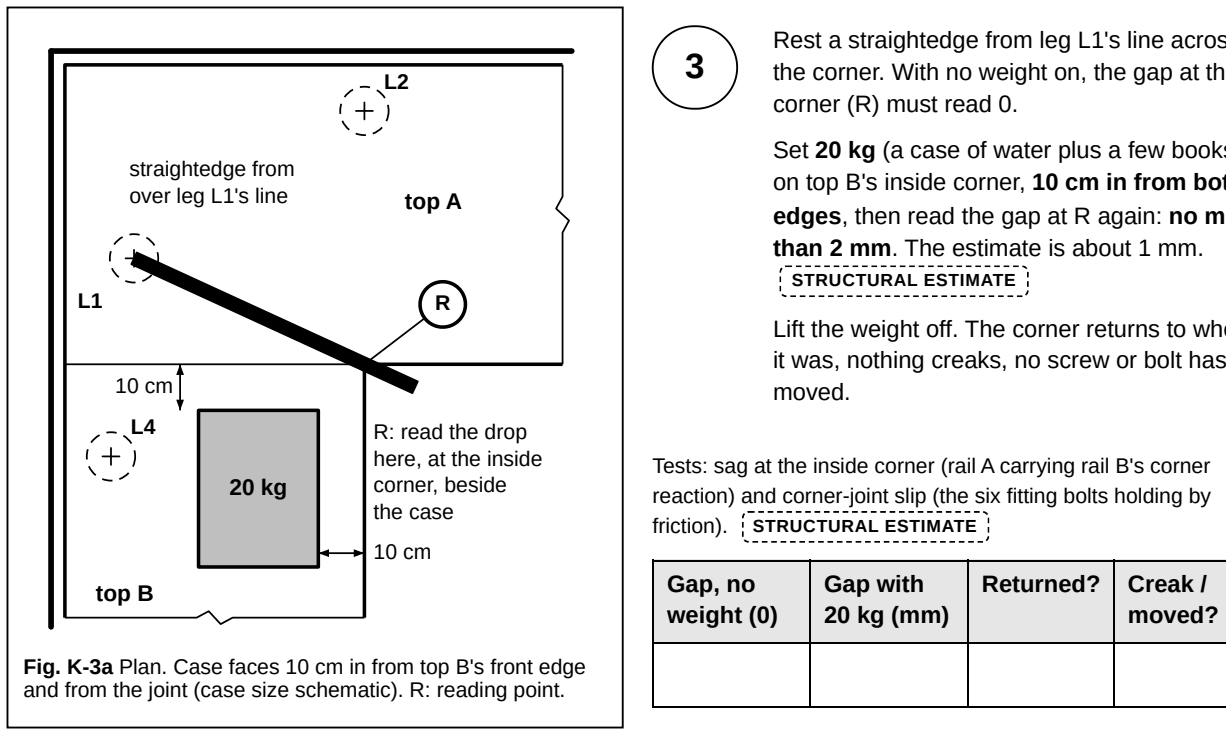
[picture p205: figure]
R: read the drop here, at the inside corner, beside the case; straightedge from; over leg L1's line; top A; top B; corner (R) must read 0.; than 2 mm. The estimate is about 1 mm.; STRUCTURAL ESTIMATE; moved.; friction). STRUCTURAL ESTIMATE; Gap, no weight (0); Gap with 20 kg (mm); Returned?; Creak /; moved?

Fig. K-3a Plan. Case faces 10 cm in from top B's front edge and from the joint (case size schematic). R: reading point.

Rest a straightedge from leg L1's line across the corner. With no weight on, the gap at the

Set 20 kg (a case of water plus a few books) on top B's inside corner, 10 cm in from both edges, then read the gap at R again: no more

Lift the weight off. The corner returns to where it was, nothing creaks, no screw or bolt has

Tests: sag at the inside corner (rail A carrying rail B's corner reaction) and corner-joint slip (the six fitting bolts holding by

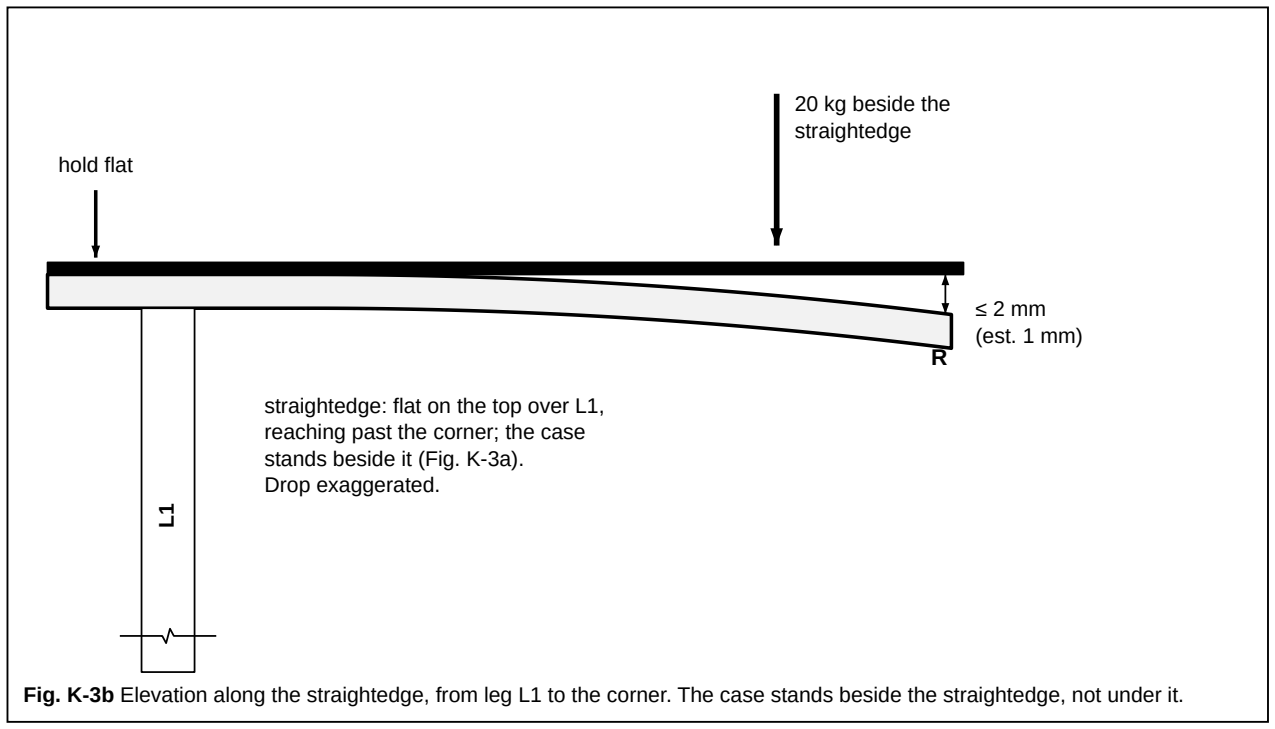
[picture p206: figure]
20 kg beside the straightedge; ≤ 2 mm (est. 1 mm); hold flat; straightedge: flat on the top over L1, reaching past the corner; the case stands beside it (Fig. K-3a). Drop exaggerated.

Fig. K-3b Elevation along the straightedge, from leg L1 to the corner. The case stands beside the straightedge, not under it.

L-Shaped Corner Desk · Assembly Manual | K · Load test

## Check 4 · All eight pads bear ACCEPTANCE CHECK

4

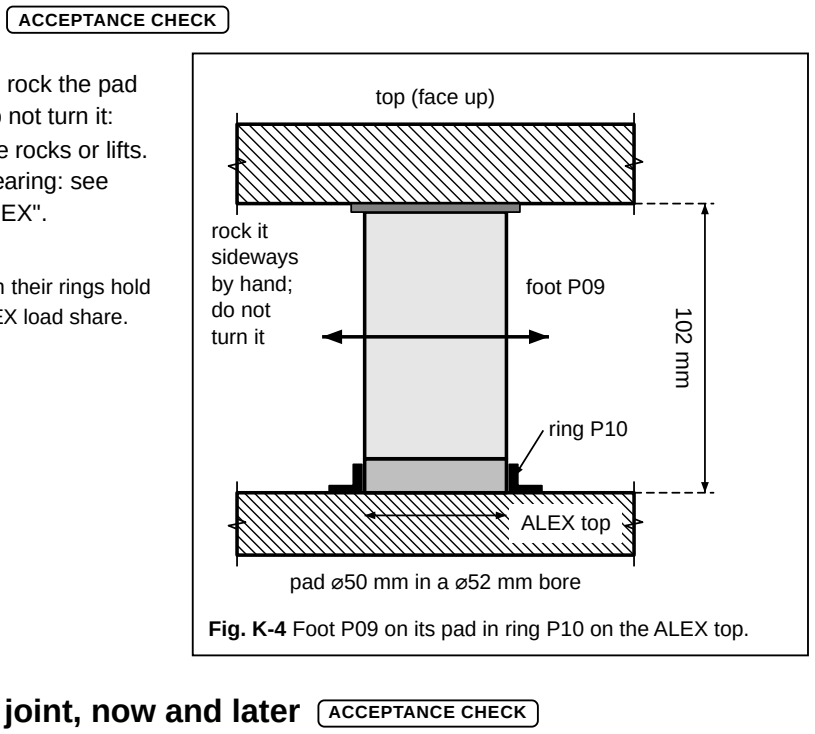
[picture p207: figure]
pad ⌀50 mm in a ⌀52 mm bore; ALEX top; top (face up); rock it sideways by hand; do not turn it; foot P09; ring P10

At each of the eight feet F1–F8, rock the pad sideways in its ring by hand. Do not turn it: turning changes its height. None rocks or lifts. A pad that rocks or lifts is not bearing: see chapter L, "Top moves on its ALEX".

Tests: the racking estimate (eight pads captive in their rings hold the frame against a sideways push) and the ALEX load share.
STRUCTURAL ESTIMATE

Fig. K-4 Foot P09 on its pad in ring P10 on the ALEX top.

## Check 5 · Straightedge at the joint, now and later ACCEPTANCE CHECK

5

Lay a straightedge across the joint at the inside corner (Fig. K-2, position 4) and write down any step. Check it again after two weeks and after the first month. If today's step is bigger than Day 0's, retighten the six fitting bolts (25 N·m, chapter L).

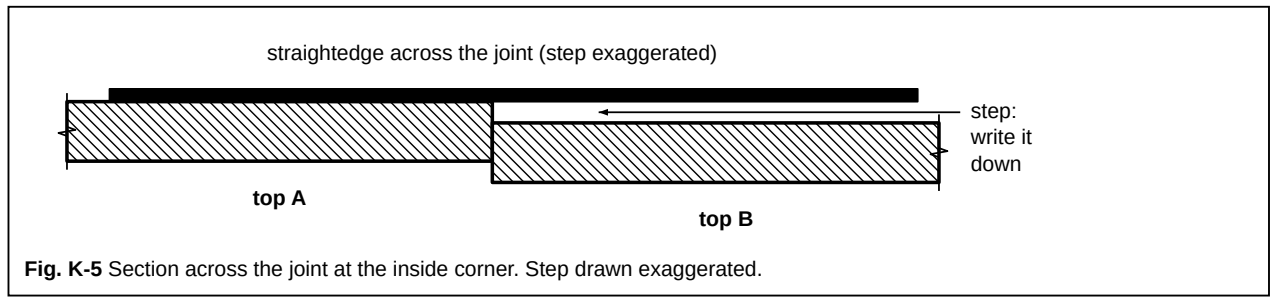
[picture p208: figure]
step: write it down; top A; top B

straightedge across the joint (step exaggerated)

Fig. K-5 Section across the joint at the inside corner. Step drawn exaggerated.

Step at the joint | Day 0 | Two weeks | One month | Bolts retightened?

mm, and which top is higher

Tests: corner-joint slip, an estimate, not a measured capacity. STRUCTURAL ESTIMATE

L-Shaped Corner Desk · Assembly Manual | K · Final inspection

## Check 6 · Sideways push ACCEPTANCE CHECK

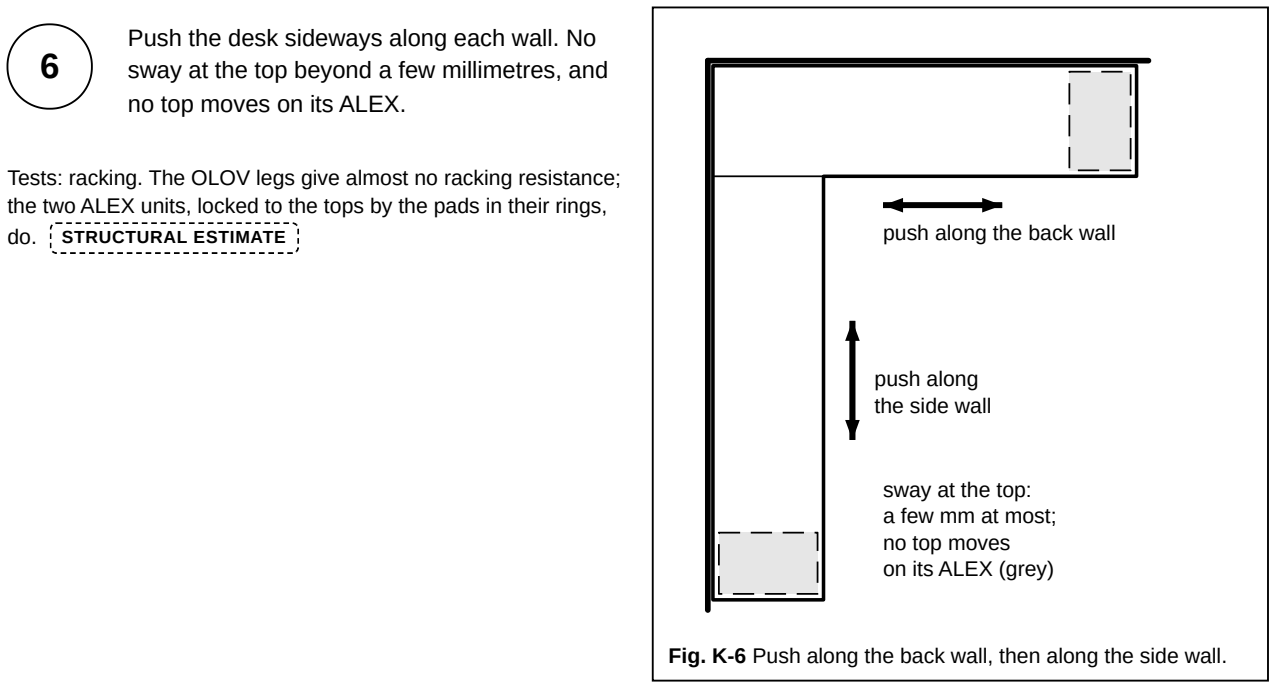
[picture p209: figure]
no top moves on its ALEX.; do. STRUCTURAL ESTIMATE; push along the back wall; push along the side wall; sway at the top: a few mm at most; no top moves on its ALEX (grey)

Push the desk sideways along each wall. No sway at the top beyond a few millimetres, and

Tests: racking. The OLOV legs give almost no racking resistance; the two ALEX units, locked to the tops by the pads in their rings,

Fig. K-6 Push along the back wall, then along the side wall.

## Check 7 · Screw tips ACCEPTANCE CHECK

7

No screw tip visible, or felt as a bump, on either laminate face. Run a hand over both tops, above every leg, foot plate, rail screw and joining plate.

## Check 8 · Knees clear ACCEPTANCE CHECK

8

Knees clear. Sit at the corner and slide in: nothing within reach of a knee or thigh. The rails' lower edge is 75.1 cm from the floor, 12 cm back from the front edge.

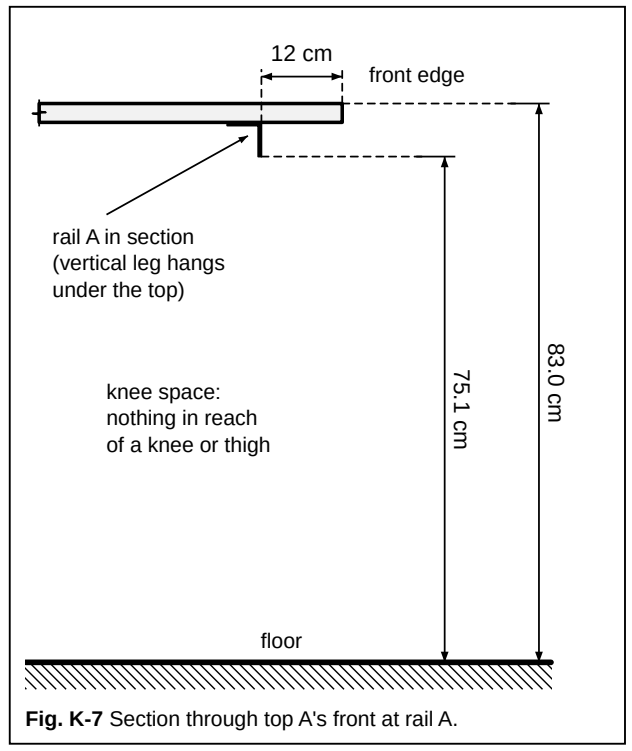
[picture p210: figure]
rail A in section (vertical leg hangs under the top); knee space: nothing in reach of a knee or thigh; floor; front edge

Fig. K-7 Section through top A's front at rail A.

L-Shaped Corner Desk · Assembly Manual | K · Final inspection

## Check 9 · ALEX fronts ACCEPTANCE CHECK

9

Both ALEX fronts open fully (ALEX 1's drawers, ALEX 2's door) without touching a foot or a leg.

## Check 10 · Retighten ACCEPTANCE CHECK

10

Retighten every screw after two weeks, then repeat check 5.

## Sign-off

# | Acceptance check | Pass when | Structural estimate it tests | Result

1 | Surface height, six corners, then the inside corner | 83.0 cm ± 0.3 cm each (85.0 / 87.0 / 89.0 cm with 2 / 4 / 6 cm ALEX feet) | —
2 | Level and fingertip across the joint | flat both ways; no step felt | —
3 | Corner load test, 20 kg | gap 0 with no weight; ≤ 2 mm with it; returns; no creak; nothing moved | sag at the inside corner (estimate about 1 mm); corner joint slip
4 | All eight pads bear | none rocks or lifts when rocked sideways (never turned) | racking; ALEX load share
5 | Straightedge at the joint | step written down; re-checked at two weeks and one month; bolts retightened if a step grew bigger than Day 0's | corner joint slip (settling)
6 | Sideways push along each wall | sway a few mm at most; no top moves on its ALEX | racking
7 | Screw tips | none visible or felt on either laminate face | —
8 | Knees clear | nothing in reach; rail lower edge 75.1 cm from the floor, 12 cm back | —
9 | ALEX fronts | open fully, touch no foot or leg | —
10 | Retighten every screw | done after two weeks | —

ACCEPTANCE CHECK pass or fail on this desk. STRUCTURAL ESTIMATE a number from the design review that the check confirms or refutes. If a check fails, see chapter L.

Checked by | Date | Two-week re-check | One-month re-check

Next: chapter L.

L-Shaped Corner Desk · Assembly Manual | K · Sign-off

# L · Maintenance and troubleshooting

## Schedule

When | Do | See
Day 0 | Write down the step at the joint (straightedge at the inside corner). | Chapter K, check 5, Fig. K-5
Two weeks | Retighten every screw. Straightedge at the joint again; if today's step is bigger than Day 0's, retighten the six fitting bolts to 25 N·m. Look at each printed ring and its three screws. | Chapter K, checks 5 and 10; troubleshooting
One month | Straightedge at the joint again; if today's step is bigger than Day 0's, retighten the six fitting bolts. | Chapter K, check 5
Any time | If the corner ever drops a millimetre, retighten the six fitting bolts. | Corner bolts, below

The tops are 28 mm particleboard with a thin laminate skin; a screw reaching the skin lifts it. Replace a screw only with the same size. If a top measures 27 mm, nothing changes: the deepest screw (rail #10 × 1 in) still stops 6 mm short of the laminate. Under 27 mm, stop and ask. SOURCE-DEFINED

## Corner bolts

Bolts six 3/8-16 × 1-1/2 in hex bolts, grade 5 (H08), washer under head and nut (H09), nylon-insert nuts (H10): four through rail A's vertical leg, two through rail B's leg with a fitting on each side

Torque 25 N·m (18 ft·lb); without a torque wrench, pull as hard as one hand can on a 15 cm wrench, then stop
Why | a friction joint: only the clamping force keeps rail B's corner from settling. Each fitting leg has two 21 × 12 mm slots, centred 29.15 mm and 78.45 mm from the heel, which leave each bolt 2.5 mm of play across and 11.5 mm along; the rails' 7/16 in holes leave 1.6 mm. VERIFIED
Order | tighten only with the two surfaces flush and rail B's end touching rail A

The mending plates across the joint align the tops; they do not carry the corner. SOURCE-DEFINED

L-Shaped Corner Desk · Assembly Manual | L · Maintenance

## Troubleshooting

Symptom | Cause | Fix
Corner has dropped; step at the joint grew | The six fitting bolts lost clamping force (friction joint); supports settling | Bring the surfaces flush with the OLOV feet and the round feet, never by packing anything under the joining plates. Check rail B's end still touches rail A. Retighten all six bolts to 25 N·m. Write the new step down (Fig. K-5).
Top moves on its ALEX, or a pad rocks or lifts | A pad is out of its ring or not bearing | Lift that ALEX end a few millimetres and slide the ALEX unit, never the top alone, until the pads drop into their rings (chapter G). Wind the pads until a level reads flat along x and y and all pads bear; never unscrew a plate; re-check 83.0 cm at the corners (chapter K, Figs. K-1 and K-4).
Printed ring cracked or its screws loose | Ring wall overloaded by a sideways push | Inspect at two weeks. A crack: reprint the ring (parts/structure/foot-ring-x8.stl), PETG or ABS, flange-down: 52 mm bore, 3 mm wall, 75 × 2.5 mm flange. Refit with #6 × 5/8 in flat-head screws (H06), 5/64 in pilots 12 mm deep (12 ALEX puck). Never run the desk with a ring missing.
Leg moves or wobbles | OLOV plate screws loose | Retighten the five M4 × 16 mm screws (H01). A screw that spins: repair the hole (below), re-pilot 1/8 in, 15 mm deep (15 LEG puck). Re-set the OLOV to 80.2 cm, or the ALEX-feet table's number (chapter F).
Monitor clamp creeps | Clamp loosened over time | Retighten the clamp with the crossbar fitted. Keep the steel plate (P11) flat on its outline under the jaw. Never add a soft pad under the jaw.
Screw spins (stripped) | Hole worn in the particleboard | Back it out, fill the hole with wood glue and a couple of matchsticks, let it dry, re-pilot.
A mark is off by more than 2 mm | Marking error | Redraw it. A stray 1/8 in hole in the underside does no harm.
A fitting bolt will not go in | Holes not quite in line | With the bolts out and the fittings off, open the hole in the rail with a round file, never under the desk; never force a bolt.

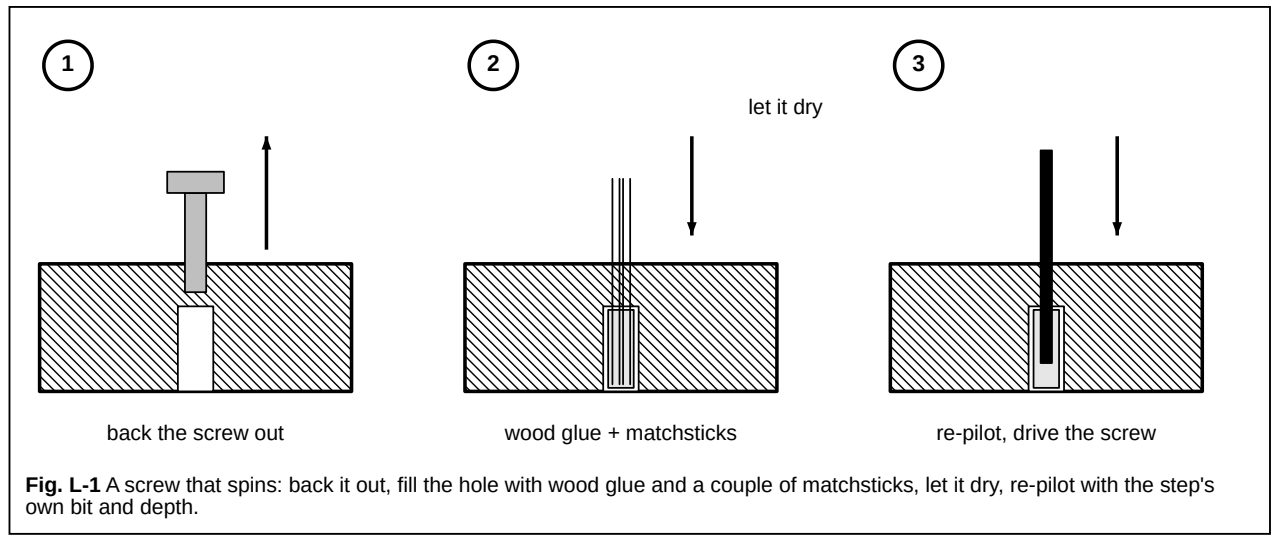
[picture p211: figure]
back the screw out; wood glue + matchsticks; let it dry; re-pilot, drive the screw; own bit and depth.

Fig. L-1 A screw that spins: back it out, fill the hole with wood glue and a couple of matchsticks, let it dry, re-pilot with the step's

Every fix above is from the build manual and the build guide SOURCE-DEFINED .

L-Shaped Corner Desk · Assembly Manual | L · Troubleshooting

# Appendix · Outstanding measurements

These values were not measured on the purchased parts when this manual was built. Each is marked
MEASURE ON HARDWARE at its point of use. Measure it before the step that uses it; if it differs, the step's own warning panel says what changes.
Measurement | Expected | Used in
ALEX bottom panel thickness (only for the optional ALEX feet) | not yet known | Chapter F, optional ALEX feet: three #6 × 5/8 in screws each. (The top panel is measured: 15.9 mm, VERIFIED.)
ALEX height, with and without its stock feet | 70.0 cm (docs assume) | Chapter F, OLOV setting 80.2 cm; underside 80.2 cm; chapter K, check 1, surface 83.0 cm
Feet pad diameter (calipers) | 50 mm; rings bored 52 mm | Chapter B, rings P10 before printing; chapter K, check 4
EKBACKEN thickness (calipers) | 28 mm | Chapter D, every screw into a top (never deeper than 21 mm; at 27 mm nothing changes, under 27 mm stop and ask); chapter I, clamp opening 31 mm
VIVO top arm reach and maximum opening | reach about 89 mm; opening 31 mm or more | Chapter I: clamp zones, Fig. I-2
Delivered rail lengths and angle thickness | 213 cm layout (bought as 84 in, 213.4 cm); 4.8 mm | Chapter E, hole stations; chapter F, rail pilot depth 25 mm from the steel face
Room: wall to wall along the back wall and along the side wall, and baseboard thickness | back wall 252.0 cm or more; side wall 322.0 cm or more (317.0 cm plus 5 cm of staging in chapter G); 40 cm free on the open sides | Chapter B (stop and ask if short); chapter G, top B stood 5 cm out; chapter J pulls the desk 40 cm into the room
Feet load rating | unknown; the design wants 50 kg or more each | Load path through the eight feet ASSUMPTION / FIELD CHECK ; chapter K, check 3 corner load test

## Confidence labels

VERIFIED | measured on the purchased part, or taken from its own geometry file.
SOURCE-DEFINED | defined by the project documents (docs/build-manual.md). A source-defined dimension is never called verified.
ASSUMPTION / FIELD CHECK | engineering estimate or field check.
MEASURE ON HARDWARE | not yet measured: measure it before the step that uses it.

## Quality control

Every number in this manual comes from manual/data.json (extracted from guide.html's D object), manual/facts.json or docs/build-manual.md. Source: HEAD of https://github.com/scotthowson/desk-setup on 23 Oct 2026 (supersedes a2e99ea with measured facts). If you change a measured value, change it in the docs first, then rebuild the manual.

L-Shaped Corner Desk · Assembly Manual | Appendix · Outstanding measurements
