scotthowson/desk-setup/manual/Drilling-and-Placement-Templates.pdf

Template T0 · rev 2026-10-23 units: mm; tape stations also in cm

Oct 2026 (supersedes a2e99ea with measured facts)

DISABLE FIT TO PAGE / shrink to fit / scale to fit. Measure the ruler before use: 0 to 100 must read 100.0 mm and the cross-check bar 50.0 mm (±0.5). If either is off, do not use the sheet: reprint.
Print every sheet at 100 % / Actual size on portrait A4; every page is portrait, the T4 strips are printed sideways and read that way. Then lay a steel rule on the ruler below. Use the sheets only if 0 to 100 reads 100.0 mm and the bar reads 50.0 mm. A sheet that is 1 % small puts a hole 0.5 mm off at 50 mm.

The print dialog is the usual culprit. Chromium's default for a PDF is Fit to printable area and Firefox's is Fit to page width; both shrink to the printer's imageable area (97.3 % on the Brother HL-2140, measured 1 Nov 2026: the ruler read 97.3). A typed scale is ignored until the mode is Custom or Actual size. The sure way is to send the file to CUPS with scaling off: lp -d HL-2140-series -o media=A4 -o print-scaling=none -P 1 Drilling-and-Placement-Templates.pdf, measure the ruler, then -P 2-25 for the rest. Never add -o landscape: CUPS re-fits whatever it rotates. Check the queue's default paper too (lpoptions -l): it was Letter.

0 | 10 | 20 | 30 | 40 | 50 | 60 | 70 | 80 | 90 | 100

CALIBRATION 0-100 mm: must measure 100.0 (+/- 0.5)

### 50 m

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
LEGEND
DRILL ⌀ (bit): circle at the bit size, crosshair and centre dot. Punch the centre through the paper, lift the sheet, drill.
OPTIONAL DRILL: dashed circle; only where the sheet says so.

POSITION: centre mark only. Do NOT drill.

Outline of the part, reference only.

Datum edge line: trim the paper on it, butt it to the edge.

Sheet | What | Use
T1 | Locating ring P10 (+ optional ALEX foot P20) | 1:1 check; drilling only for the ALEX feet
T2 | Feet plate P09, two pieces | 1:1 drilling
T3a | OLOV plate P05 at 100: L2-L6 | 1:1 drilling
T3b | OLOV plate P05 at 150: L1 | 1:1 drilling
T4-A | Rail A P06 station strip, 9 sheets (read sideways) | 1:1 marking check
T4-B | Rail B P07 station strip, 9 sheets (read sideways) | 1:1 marking check
T5 | Corner fitting P08 placement | reference 1:2, not for drilling
T6 | Clamp pad plate P11 placement | reference 1:4, positioning only
T7 | Corner bolt holes P08 on rails A and B (read sideways) | 1:1 drilling, on the bench

Using a drilling sheet: trim on the heavy datum line(s), butt the trimmed edge to the named edge, tape, then punch each DRILL centre through the paper with an awl or automatic centre punch, lift the sheet and drill to the depth stated. The printed jigs (P18) are the primary tools; these sheets reproduce their patterns and serve as the check. Top marking is done face down (underside up); every pattern here is used without flipping the sheet.

Drilling and Placement Templates | T0 · Print first
Drilling and Placement Templates | Page 1

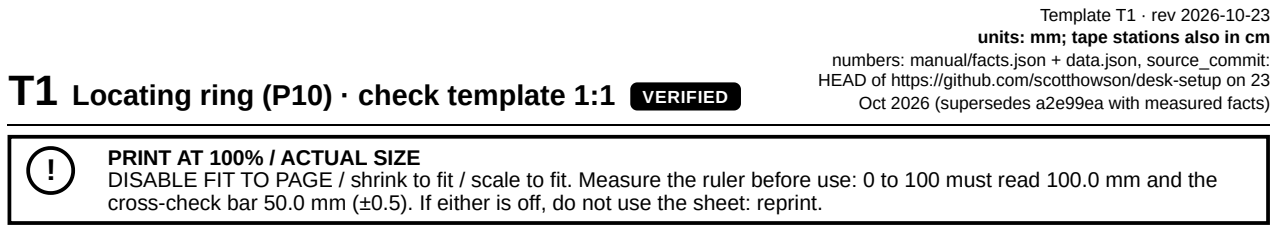
[picture p212: figure]
Template T1 · rev 2026-10-23 units: mm; tape stations also in cm numbers: manual/facts.json + data.json, source_commit: HEAD of https://github.com/scotthowson/desk-setup on 23; PRINT AT 100% / ACTUAL SIZE

## T1 Locating ring (P10) · check template 1:1 VERIFIED

Oct 2026 (supersedes a2e99ea with measured facts)

DISABLE FIT TO PAGE / shrink to fit / scale to fit. Measure the ruler before use: 0 to 100 must read 100.0 mm and the cross-check bar 50.0 mm (±0.5). If either is off, do not use the sheet: reprint.

CHECK SHEET (chapter G, step 2a). With the top lifted off and before drilling any ring, lay this sheet on each bare ALEX corner: the pencil trace of the pad must lie inside the ⌀52 circle all round. If not, move the cabinet and re-trace. It is a drilling template only for the optional ALEX feet, on the bottom corners.

ALE

X

E

D

G

E: trim, butt to the cabinet edge

ALEX EDGE: trim, butt to it

DATUM: ALEX corner

into the cabinet
50 (5.0 cm)

50 (5.0 cm)

0°

RING 45°

RING 165°

RING 285°

inner 3 = DRILL, ALEX feet only (bottom)

0 | 10 | 20 | 30 | 40 | 50 | 60 | 70 | 80 | 90 | 100

CALIBRATION 0-100 mm: must measure 100.0 (+/- 0.5)

### 50 m

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
T1 · P10 locating ring + P20 ALEX foot (opt.) · rev 2026-10-23

CHECK, before drilling any ring (chapter G, step
2a): top lifted off, lay the sheet face up on the
bare ALEX corner, edge lines on the two edges. The
pencil trace of the pad must lie inside the ⌀52 circle all round; if not, move the cabinet and re-trace.
DRILL, ALEX BOTTOM, only if fitting ALEX feet (unit on its back): punch the 3 inner centres, lift, pilot 5/64 in, 12 mm deep (puck 12 ALEX).

LEGEND
DRILL ⌀2.0 (5/64 in),
dashed: ALEX feet only,
ALEX BOTTOM.
POSITION: centre mark
only. Do NOT drill.

Outline of the part,
reference only.

Datum edge line: trim
the paper on it, butt it
to the edge.

Dashed circles: ring bore ⌀52 (the check), ring flange ⌀75. RING marks: position only, never drilled; the ring is fitted turned, its own holes at any angle. ALEX foot: 3 holes on r 14.5 at 45 / 165 / 285°, counter-clockwise from the bottom edge, sheet face up. Turn the sheet for each corner, never flip it.

The ring is fitted turned: its own holes may sit at any angle. ALEX top panel 15.9 mm (5/8 in), measured 23 Oct 2026: the #6 × 5/8 in screws go 13.4 mm in and leave 2.5 mm.

Drilling and Placement Templates | T1 · Locating ring P10
Drilling and Placement Templates | Page 2

## T2 Feet plate (P09) · drilling template 1:1 VERIFIED

!

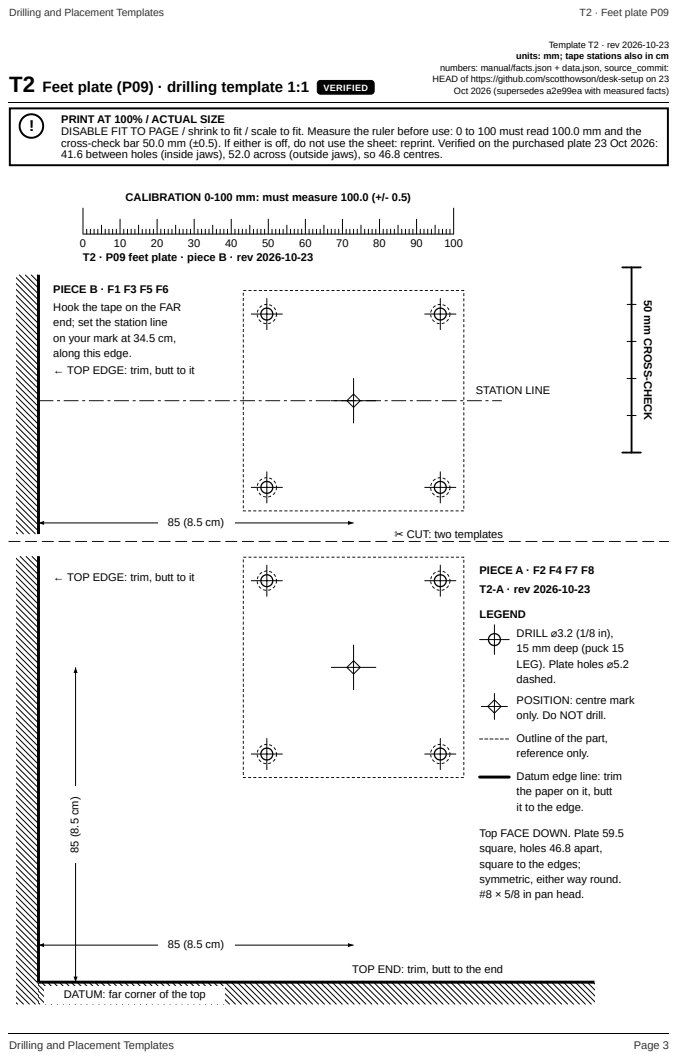
[picture p213: page 3]
Template T2 · rev 2026-10-23; STATION LINE; PIECE A · F2 F4 F7 F8 T2-A · rev 2026-10-23; Drilling and Placement Templates; T2 · Feet plate P09; Page 3

units: mm; tape stations also in cm

numbers: manual/facts.json + data.json, source_commit:
HEAD of https://github.com/scotthowson/desk-setup on 23
Oct 2026 (supersedes a2e99ea with measured facts)

PRINT AT 100% / ACTUAL SIZE
DISABLE FIT TO PAGE / shrink to fit / scale to fit. Measure the ruler before use: 0 to 100 must read 100.0 mm and the
cross-check bar 50.0 mm (±0.5). If either is off, do not use the sheet: reprint. Verified on the purchased plate 23 Oct 2026:
41.6 between holes (inside jaws), 52.0 across (outside jaws), so 46.8 centres.

CALIBRATION 0-100 mm: must measure 100.0 (+/- 0.5)

T2 · P09 feet plate · piece B · rev 2026-10-23

PIECE B · F1 F3 F5 F6
Hook the tape on the FAR
end; set the station line
on your mark at 34.5 cm,
along this edge.
← TOP EDGE: trim, butt to it

✂ CUT: two templates

LEGEND
DRILL ⌀3.2 (1/8 in),
15 mm deep (puck 15
LEG). Plate holes ⌀5.2
dashed.
POSITION: centre mark
only. Do NOT drill.
Outline of the part,
reference only.
Datum edge line: trim
the paper on it, butt
it to the edge.

Top FACE DOWN. Plate 59.5
square, holes 46.8 apart,
square to the edges;
symmetric, either way round.
#8 × 5/8 in pan head.

TOP END: trim, butt to the end

DATUM: far corner of the top

## T3a OLOV plate (P05) · 100 from the edge · 1:1 VERIFIED

!

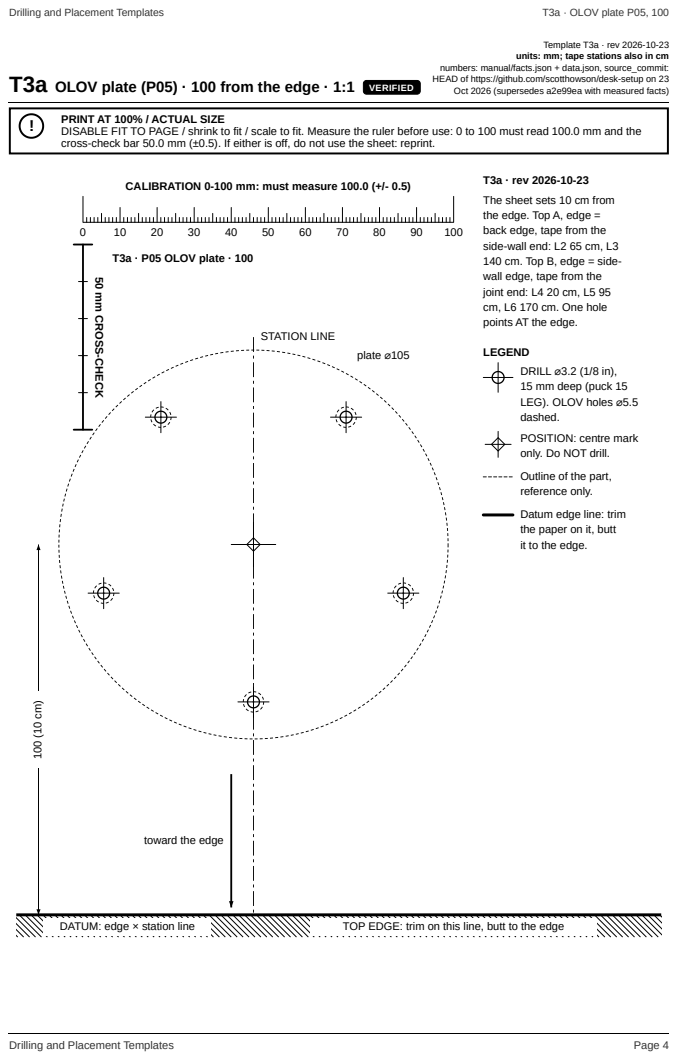
[picture p214: page 4]
DATUM: edge × station line; TOP EDGE: trim on this line, butt to the edge; STATION LINE; plate ⌀105; T3a · P05 OLOV plate · 100; Drilling and Placement Templates; T3a · OLOV plate P05, 100; Page 4

Template T3a · rev 2026-10-23
units: mm; tape stations also in cm

numbers: manual/facts.json + data.json, source_commit:
HEAD of https://github.com/scotthowson/desk-setup on 23
Oct 2026 (supersedes a2e99ea with measured facts)

PRINT AT 100% / ACTUAL SIZE
DISABLE FIT TO PAGE / shrink to fit / scale to fit. Measure the ruler before use: 0 to 100 must read 100.0 mm and the
cross-check bar 50.0 mm (±0.5). If either is off, do not use the sheet: reprint.

CALIBRATION 0-100 mm: must measure 100.0 (+/- 0.5)

T3a · rev 2026-10-23
The sheet sets 10 cm from
the edge. Top A, edge =
back edge, tape from the
side-wall end: L2 65 cm, L3
140 cm. Top B, edge = side-
wall edge, tape from the
joint end: L4 20 cm, L5 95
cm, L6 170 cm. One hole
points AT the edge.

LEGEND
DRILL ⌀3.2 (1/8 in),
15 mm deep (puck 15
LEG). OLOV holes ⌀5.5
dashed.
POSITION: centre mark
only. Do NOT drill.
Outline of the part,
reference only.
Datum edge line: trim
the paper on it, butt
it to the edge.

toward the edge

## T3b OLOV plate (P05) · 150 from the end · 1:1 VERIFIED

!

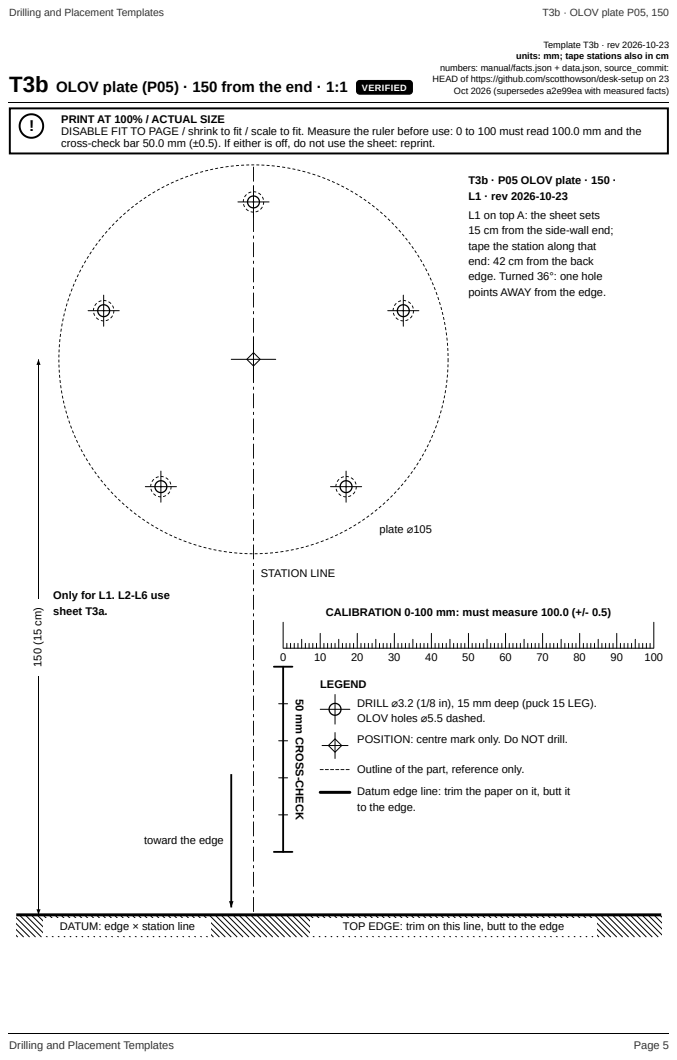
[picture p215: page 5]
DATUM: edge × station line; TOP EDGE: trim on this line, butt to the edge; STATION LINE; plate ⌀105; Drilling and Placement Templates; T3b · OLOV plate P05, 150; Page 5

Template T3b · rev 2026-10-23
units: mm; tape stations also in cm

numbers: manual/facts.json + data.json, source_commit:
HEAD of https://github.com/scotthowson/desk-setup on 23
Oct 2026 (supersedes a2e99ea with measured facts)

PRINT AT 100% / ACTUAL SIZE
DISABLE FIT TO PAGE / shrink to fit / scale to fit. Measure the ruler before use: 0 to 100 must read 100.0 mm and the
cross-check bar 50.0 mm (±0.5). If either is off, do not use the sheet: reprint.

T3b · P05 OLOV plate · 150 ·
L1 · rev 2026-10-23
L1 on top A: the sheet sets
15 cm from the side-wall end;
tape the station along that
end: 42 cm from the back
edge. Turned 36°: one hole
points AWAY from the edge.

Only for L1. L2-L6 use
sheet T3a.

CALIBRATION 0-100 mm: must measure 100.0 (+/- 0.5)

LEGEND
DRILL ⌀3.2 (1/8 in), 15 mm deep (puck 15 LEG).
OLOV holes ⌀5.5 dashed.
POSITION: centre mark only. Do NOT drill.

Outline of the part, reference only.
Datum edge line: trim the paper on it, butt it
to the edge.

toward the edge

# T4-A Rail A (P06) station strip 1/9 SOURCE-DEFINED MEASURE ON HARDWARE

Template T4-A · rev 2026-10-23 units: mm; tape stations also in cm

numbers: manual/facts.json + data.json, source_commit:

HEAD of https://github.com/scotthowson/desk-setup on 23

Oct 2026 (supersedes a2e99ea with measured facts)

! PRINT AT 100% / ACTUAL SIZE · READ SIDEWAYS (PORTRAIT A4) DISABLE FIT TO PAGE / shrink to fit / scale to fit. Measure the ruler before use: 0 to 100 must read 100.0 mm and the cross-check bar 50.0 mm (±0.5). If either is off, do not use the sheet:
reprint. FREE EDGE of the flat leg: trim on the heavy line, set it flush with the leg's free edge

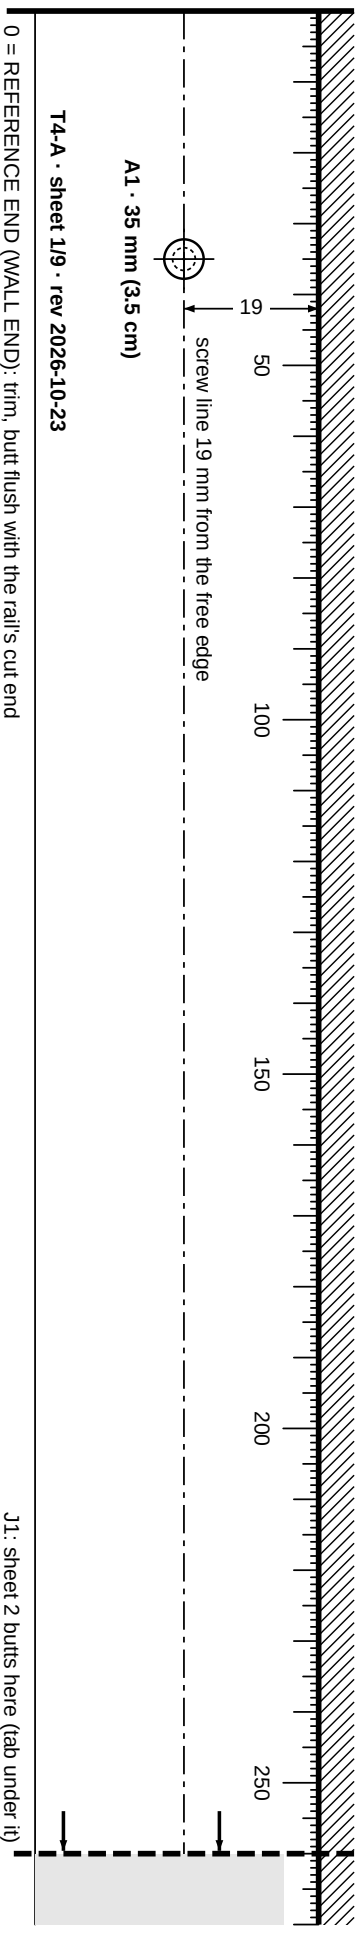
[picture p216: figure]
T4-A · sheet 1/9 · rev 2026-10-23; screw line 19 mm from the free edge

0 = REFERENCE END (WALL END): trim, butt flush with the rail's cut end J1: sheet 2 butts here (tab under it)

0 10 20 30 40 50 60 70 80 90 100

CALIBRATION 0-100 mm: must measure 100.0 (+/- 0.5)

DRILL ⌀5.56 (7/32 in) through the

# steel; 1/8 in pilot first (dashed). Centre-punch through the paper, low

# speed, cutting oil. Ticks and numbers: position only, never

# drilled. Preferred method: the printed rail drill jig

on the 19 line, with a tape from the

reference end. This strip is the check. Tape

it to either face of the flat leg. 19 is from

the FREE edge (chapter E), not from the heel. MEASURE THE DELIVERED RAIL Design 213.0 cm (2130 mm); bought as 84 in = 213.4 cm (2133.6 mm). Every station runs from the labelled wall end; the far end carries any extra. Tape-check each station from that end. Joins: trim each later sheet on its start J line and lay it on the previous sheet's J line so ticks, numbers and the screw line run on; tape. Rail A

holes, cm from the wall end: A1 3.5, A2 28, A3 54, A4 80, A5 106, A6 132, A7 158, A8 184, A9 210.5. Drilling and Placement Templates T4-A · Rail A strip 1/9
Drilling and Placement Templates Page 6

# T4-A Rail A (P06) station strip 2/9 SOURCE-DEFINED MEASURE ON HARDWARE

Template T4-A · rev 2026-10-23 units: mm; tape stations also in cm

numbers: manual/facts.json + data.json, source_commit:

HEAD of https://github.com/scotthowson/desk-setup on 23

Oct 2026 (supersedes a2e99ea with measured facts)

! PRINT AT 100% / ACTUAL SIZE · READ SIDEWAYS (PORTRAIT A4) DISABLE FIT TO PAGE / shrink to fit / scale to fit. Measure the ruler before use: 0 to 100 must read 100.0 mm and the cross-check bar 50.0 mm (±0.5). If either is off, do not use the sheet:
reprint. FREE EDGE of the flat leg: trim on the heavy line, set it flush with the leg's free edge

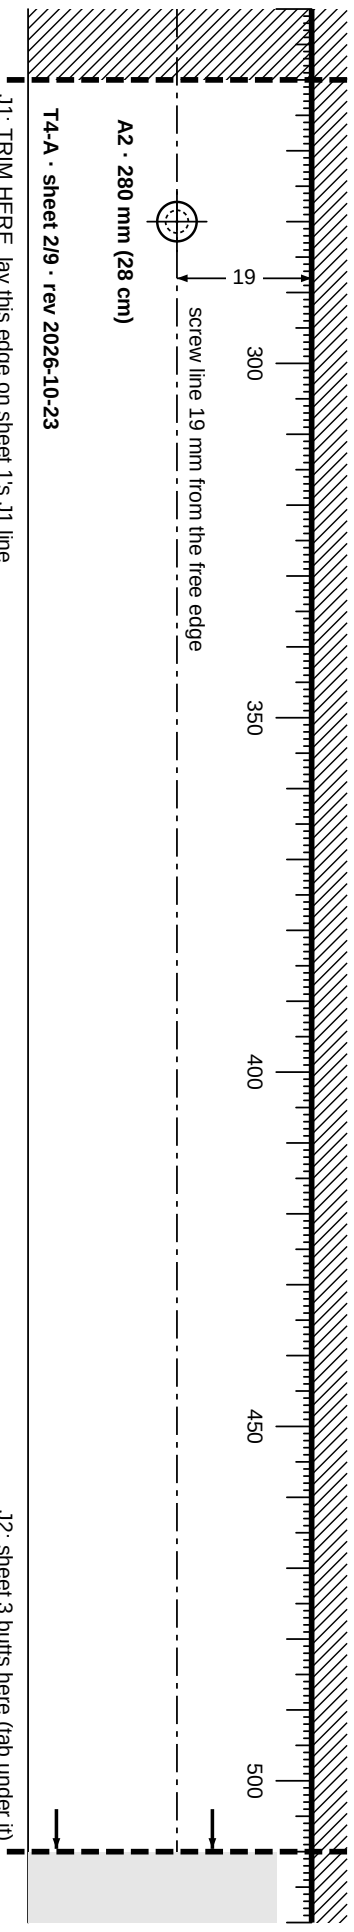
[picture p217: figure]
T4-A · sheet 2/9 · rev 2026-10-23; screw line 19 mm from the free edge

J1: TRIM HERE, lay this edge on sheet 1's J1 line J2: sheet 3 butts here (tab under it)

0 10 20 30 40 50 60 70 80 90 100

CALIBRATION 0-100 mm: must measure 100.0 (+/- 0.5)

DRILL ⌀5.56 (7/32 in) through the

# steel; 1/8 in pilot first (dashed). Centre-punch through the paper, low

# speed, cutting oil. Ticks and numbers: position only, never

# drilled. Preferred method: the printed rail drill jig

on the 19 line, with a tape from the

reference end. This strip is the check. Tape

it to either face of the flat leg. 19 is from

the FREE edge (chapter E), not from the heel. MEASURE THE DELIVERED RAIL Design 213.0 cm (2130 mm); bought as 84 in = 213.4 cm (2133.6 mm). Every station runs from the labelled wall end; the far end carries any extra. Tape-check each station from that end. Joins: trim each later sheet on its start J line and lay it on the previous sheet's J line so ticks, numbers and the screw line run on; tape. Rail A

holes, cm from the wall end: A1 3.5, A2 28, A3 54, A4 80, A5 106, A6 132, A7 158, A8 184, A9 210.5. Drilling and Placement Templates T4-A · Rail A strip 2/9
Drilling and Placement Templates Page 7

# T4-A Rail A (P06) station strip 3/9 SOURCE-DEFINED MEASURE ON HARDWARE

Template T4-A · rev 2026-10-23 units: mm; tape stations also in cm

numbers: manual/facts.json + data.json, source_commit:

HEAD of https://github.com/scotthowson/desk-setup on 23

Oct 2026 (supersedes a2e99ea with measured facts)

! PRINT AT 100% / ACTUAL SIZE · READ SIDEWAYS (PORTRAIT A4) DISABLE FIT TO PAGE / shrink to fit / scale to fit. Measure the ruler before use: 0 to 100 must read 100.0 mm and the cross-check bar 50.0 mm (±0.5). If either is off, do not use the sheet:
reprint. FREE EDGE of the flat leg: trim on the heavy line, set it flush with the leg's free edge

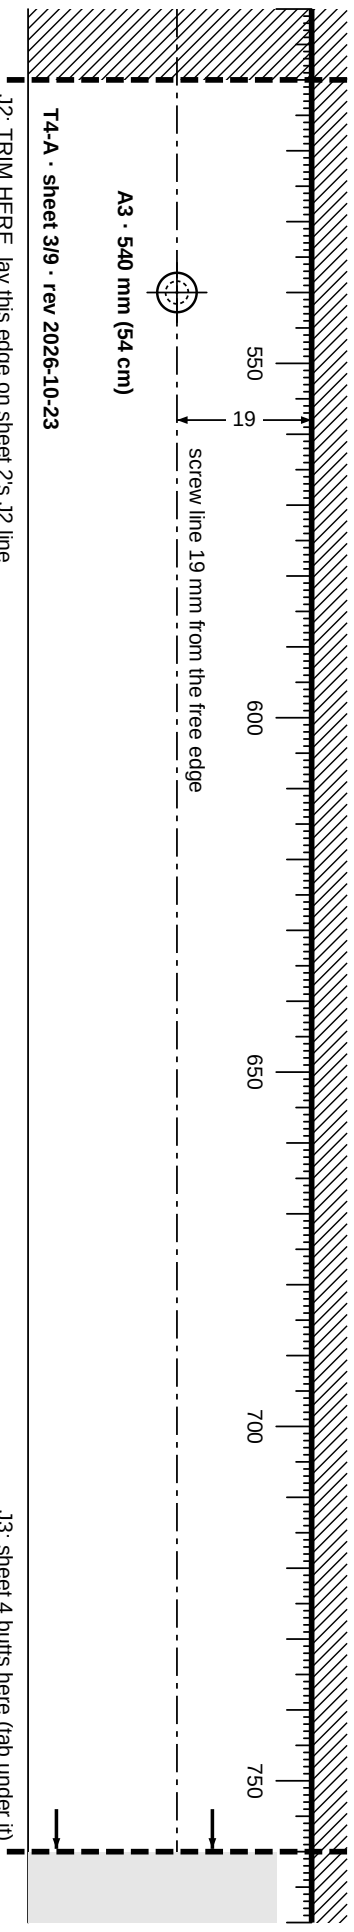
[picture p218: figure]
T4-A · sheet 3/9 · rev 2026-10-23; screw line 19 mm from the free edge

J2: TRIM HERE, lay this edge on sheet 2's J2 line J3: sheet 4 butts here (tab under it)

0 10 20 30 40 50 60 70 80 90 100

CALIBRATION 0-100 mm: must measure 100.0 (+/- 0.5)

DRILL ⌀5.56 (7/32 in) through the

# steel; 1/8 in pilot first (dashed). Centre-punch through the paper, low

# speed, cutting oil. Ticks and numbers: position only, never

# drilled. Preferred method: the printed rail drill jig

on the 19 line, with a tape from the

reference end. This strip is the check. Tape

it to either face of the flat leg. 19 is from

the FREE edge (chapter E), not from the heel. MEASURE THE DELIVERED RAIL Design 213.0 cm (2130 mm); bought as 84 in = 213.4 cm (2133.6 mm). Every station runs from the labelled wall end; the far end carries any extra. Tape-check each station from that end. Joins: trim each later sheet on its start J line and lay it on the previous sheet's J line so ticks, numbers and the screw line run on; tape. Rail A

holes, cm from the wall end: A1 3.5, A2 28, A3 54, A4 80, A5 106, A6 132, A7 158, A8 184, A9 210.5. Drilling and Placement Templates T4-A · Rail A strip 3/9
Drilling and Placement Templates Page 8

# T4-A Rail A (P06) station strip 4/9 SOURCE-DEFINED MEASURE ON HARDWARE

Template T4-A · rev 2026-10-23 units: mm; tape stations also in cm

numbers: manual/facts.json + data.json, source_commit:

HEAD of https://github.com/scotthowson/desk-setup on 23

Oct 2026 (supersedes a2e99ea with measured facts)

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

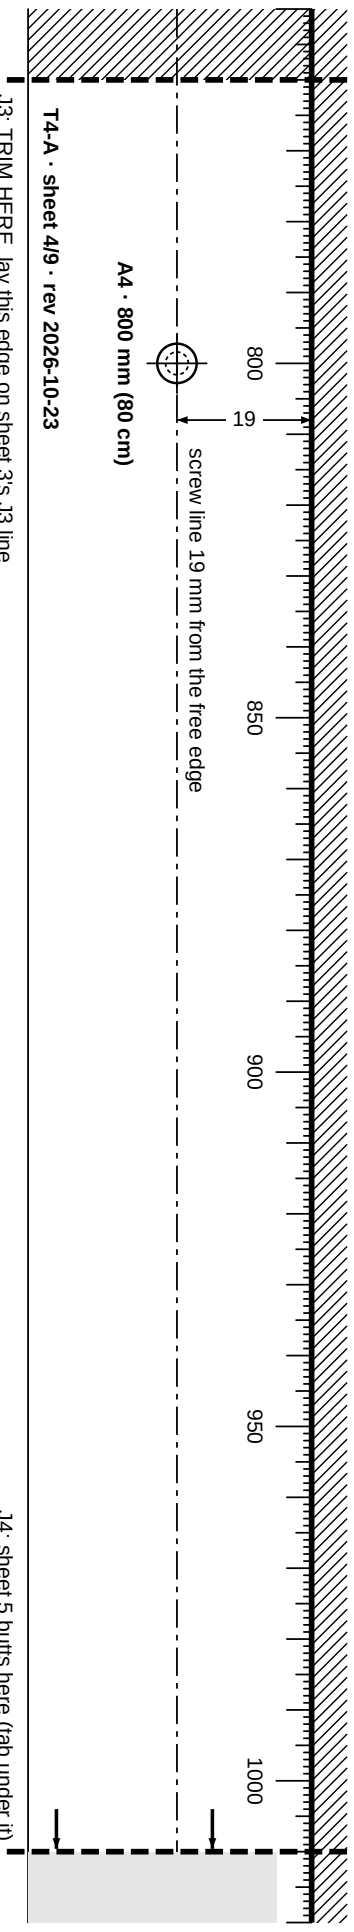
[picture p219: figure]
T4-A · sheet 4/9 · rev 2026-10-23; screw line 19 mm from the free edge

J3: TRIM HERE, lay this edge on sheet 3's J3 line J4: sheet 5 butts here (tab under it)

0 10 20 30 40 50 60 70 80 90 100

CALIBRATION 0-100 mm: must measure 100.0 (+/- 0.5)

DRILL ⌀5.56 (7/32 in) through the

# steel; 1/8 in pilot first (dashed). Centre-punch through the paper, low

# speed, cutting oil. Ticks and numbers: position only, never

# drilled. Preferred method: the printed rail drill jig

on the 19 line, with a tape from the

reference end. This strip is the check. Tape

it to either face of the flat leg. 19 is from

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

holes, cm from the wall end: A1 3.5, A2 28, A3 54, A4 80, A5 106, A6 132, A7 158, A8 184, A9 210.5. Drilling and Placement Templates T4-A · Rail A strip 4/9
Drilling and Placement Templates Page 9

# T4-A Rail A (P06) station strip 5/9 SOURCE-DEFINED MEASURE ON HARDWARE

Template T4-A · rev 2026-10-23 units: mm; tape stations also in cm

numbers: manual/facts.json + data.json, source_commit:

HEAD of https://github.com/scotthowson/desk-setup on 23

Oct 2026 (supersedes a2e99ea with measured facts)

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

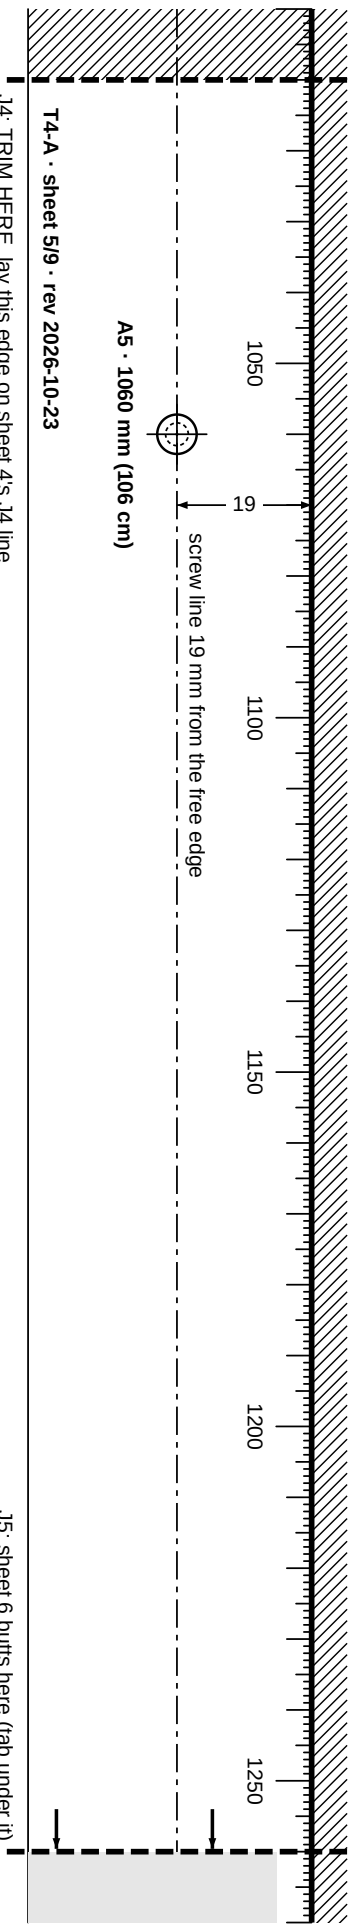
[picture p220: figure]
T4-A · sheet 5/9 · rev 2026-10-23; screw line 19 mm from the free edge

J4: TRIM HERE, lay this edge on sheet 4's J4 line J5: sheet 6 butts here (tab under it)

0 10 20 30 40 50 60 70 80 90 100

CALIBRATION 0-100 mm: must measure 100.0 (+/- 0.5)

DRILL ⌀5.56 (7/32 in) through the

# steel; 1/8 in pilot first (dashed). Centre-punch through the paper, low

# speed, cutting oil. Ticks and numbers: position only, never

# drilled. Preferred method: the printed rail drill jig

on the 19 line, with a tape from the

reference end. This strip is the check. Tape

it to either face of the flat leg. 19 is from

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

holes, cm from the wall end: A1 3.5, A2 28, A3 54, A4 80, A5 106, A6 132, A7 158, A8 184, A9 210.5. Drilling and Placement Templates T4-A · Rail A strip 5/9
Drilling and Placement Templates Page 10

# T4-A Rail A (P06) station strip 6/9 SOURCE-DEFINED MEASURE ON HARDWARE

Template T4-A · rev 2026-10-23 units: mm; tape stations also in cm

numbers: manual/facts.json + data.json, source_commit:

HEAD of https://github.com/scotthowson/desk-setup on 23

Oct 2026 (supersedes a2e99ea with measured facts)

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

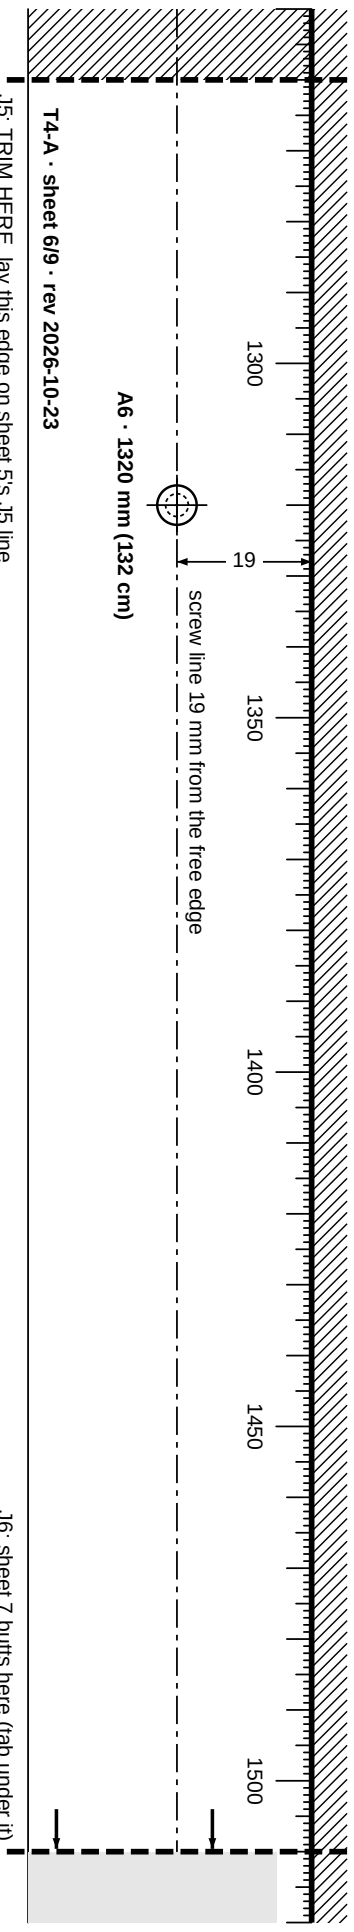
[picture p221: figure]
T4-A · sheet 6/9 · rev 2026-10-23; screw line 19 mm from the free edge

J5: TRIM HERE, lay this edge on sheet 5's J5 line J6: sheet 7 butts here (tab under it)

0 10 20 30 40 50 60 70 80 90 100

CALIBRATION 0-100 mm: must measure 100.0 (+/- 0.5)

DRILL ⌀5.56 (7/32 in) through the

# steel; 1/8 in pilot first (dashed). Centre-punch through the paper, low

# speed, cutting oil. Ticks and numbers: position only, never

# drilled. Preferred method: the printed rail drill jig

on the 19 line, with a tape from the

reference end. This strip is the check. Tape

it to either face of the flat leg. 19 is from

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

holes, cm from the wall end: A1 3.5, A2 28, A3 54, A4 80, A5 106, A6 132, A7 158, A8 184, A9 210.5. Drilling and Placement Templates T4-A · Rail A strip 6/9
Drilling and Placement Templates Page 11

# T4-A Rail A (P06) station strip 7/9 SOURCE-DEFINED MEASURE ON HARDWARE

Template T4-A · rev 2026-10-23 units: mm; tape stations also in cm

numbers: manual/facts.json + data.json, source_commit:

HEAD of https://github.com/scotthowson/desk-setup on 23

Oct 2026 (supersedes a2e99ea with measured facts)

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

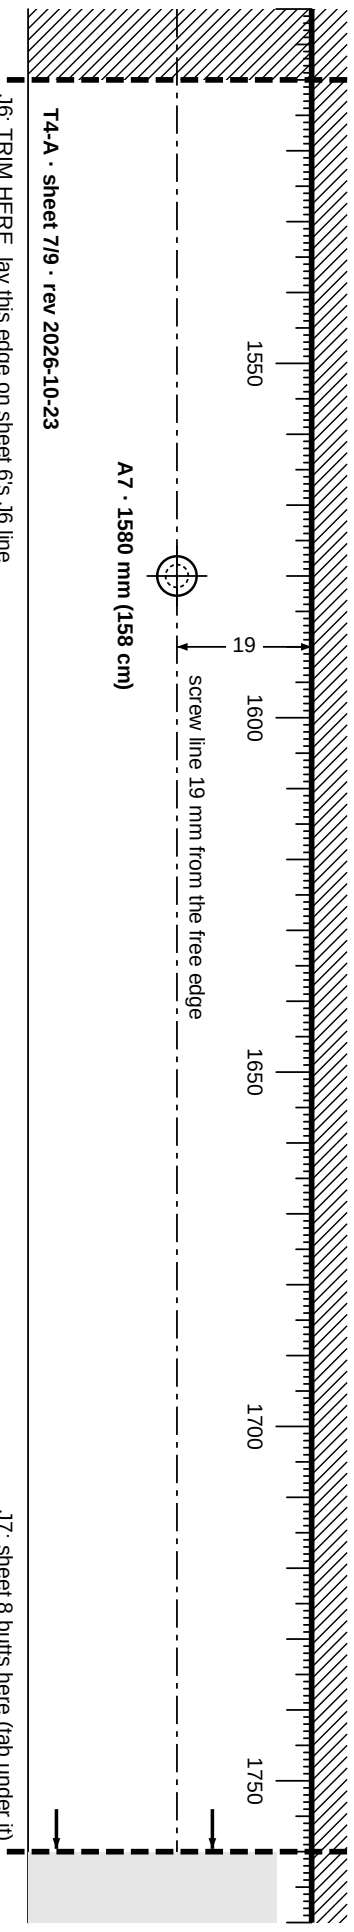
[picture p222: figure]
T4-A · sheet 7/9 · rev 2026-10-23; screw line 19 mm from the free edge

J6: TRIM HERE, lay this edge on sheet 6's J6 line J7: sheet 8 butts here (tab under it)

0 10 20 30 40 50 60 70 80 90 100

CALIBRATION 0-100 mm: must measure 100.0 (+/- 0.5)

DRILL ⌀5.56 (7/32 in) through the

# steel; 1/8 in pilot first (dashed). Centre-punch through the paper, low

# speed, cutting oil. Ticks and numbers: position only, never

# drilled. Preferred method: the printed rail drill jig

on the 19 line, with a tape from the

reference end. This strip is the check. Tape

it to either face of the flat leg. 19 is from

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

holes, cm from the wall end: A1 3.5, A2 28, A3 54, A4 80, A5 106, A6 132, A7 158, A8 184, A9 210.5. Drilling and Placement Templates T4-A · Rail A strip 7/9
Drilling and Placement Templates Page 12

# T4-A Rail A (P06) station strip 8/9 SOURCE-DEFINED MEASURE ON HARDWARE

Template T4-A · rev 2026-10-23 units: mm; tape stations also in cm

numbers: manual/facts.json + data.json, source_commit:

HEAD of https://github.com/scotthowson/desk-setup on 23

Oct 2026 (supersedes a2e99ea with measured facts)

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

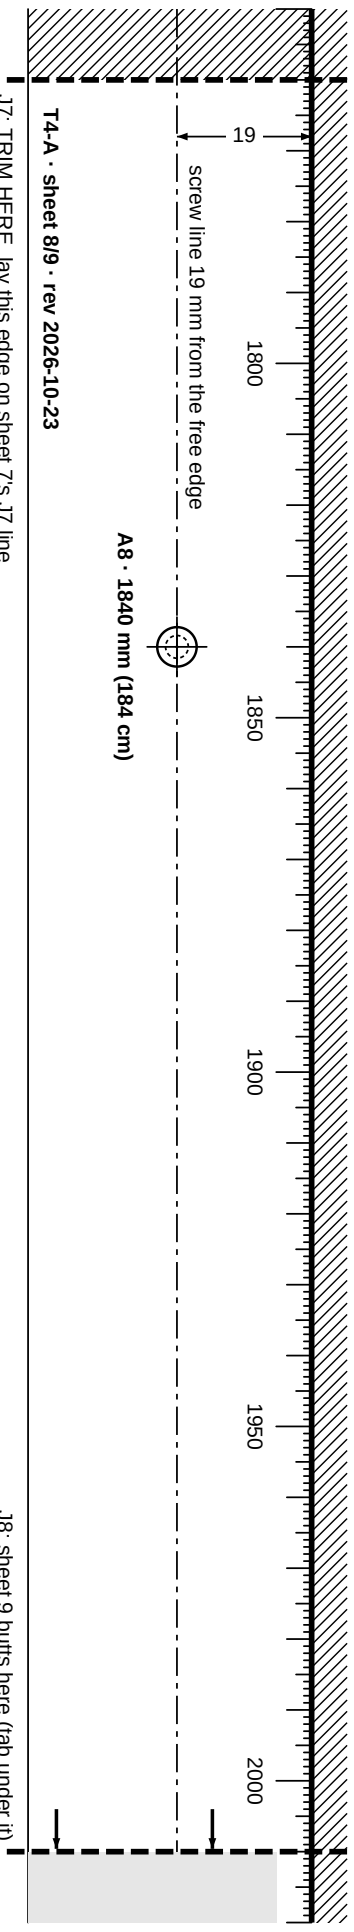
[picture p223: figure]
T4-A · sheet 8/9 · rev 2026-10-23; screw line 19 mm from the free edge

J7: TRIM HERE, lay this edge on sheet 7's J7 line J8: sheet 9 butts here (tab under it)

0 10 20 30 40 50 60 70 80 90 100

CALIBRATION 0-100 mm: must measure 100.0 (+/- 0.5)

DRILL ⌀5.56 (7/32 in) through the

# steel; 1/8 in pilot first (dashed). Centre-punch through the paper, low

# speed, cutting oil. Ticks and numbers: position only, never

# drilled. Preferred method: the printed rail drill jig

on the 19 line, with a tape from the

reference end. This strip is the check. Tape

it to either face of the flat leg. 19 is from

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

holes, cm from the wall end: A1 3.5, A2 28, A3 54, A4 80, A5 106, A6 132, A7 158, A8 184, A9 210.5. Drilling and Placement Templates T4-A · Rail A strip 8/9
Drilling and Placement Templates Page 13

# T4-A Rail A (P06) station strip 9/9 SOURCE-DEFINED MEASURE ON HARDWARE

Template T4-A · rev 2026-10-23 units: mm; tape stations also in cm

numbers: manual/facts.json + data.json, source_commit:

HEAD of https://github.com/scotthowson/desk-setup on 23

Oct 2026 (supersedes a2e99ea with measured facts)

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

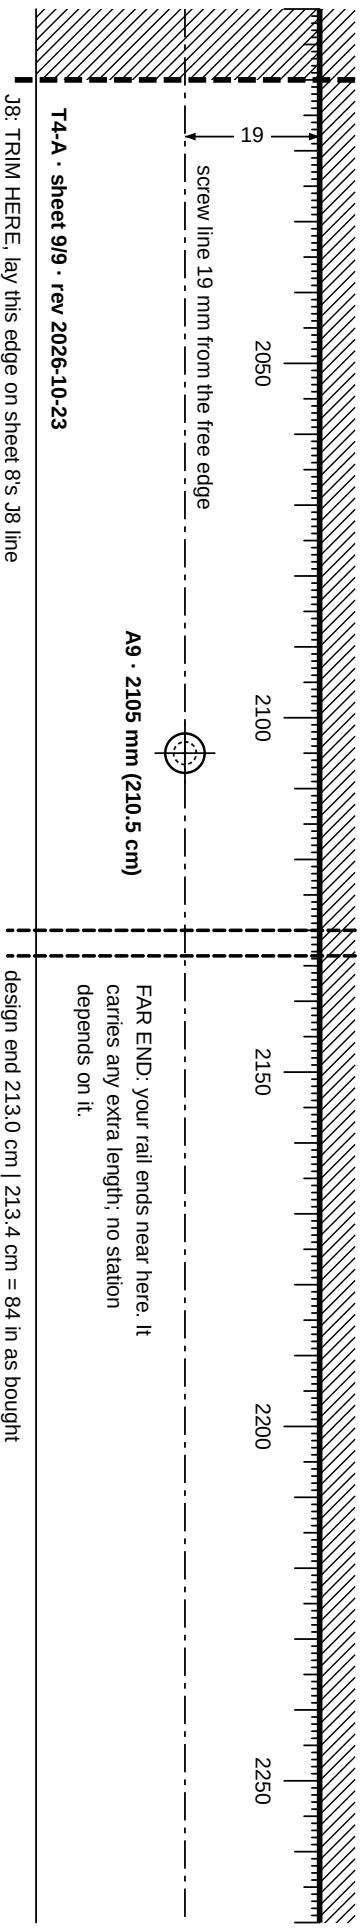
[picture p224: figure]
FAR END: your rail ends near here. It; carries any extra length; no station; screw line 19 mm from the free edge

J8: TRIM HERE, lay this edge on sheet 8's J8 line design end 213.0 cm | 213.4 cm = 84 in as bought

# depends on it. T4-A · sheet 9/9 · rev 2026-10-23

0 10 20 30 40 50 60 70 80 90 100

CALIBRATION 0-100 mm: must measure 100.0 (+/- 0.5)

DRILL ⌀5.56 (7/32 in) through the

# steel; 1/8 in pilot first (dashed). Centre-punch through the paper, low

# speed, cutting oil. Ticks and numbers: position only, never

# drilled. Preferred method: the printed rail drill jig

on the 19 line, with a tape from the

reference end. This strip is the check. Tape

it to either face of the flat leg. 19 is from

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

holes, cm from the wall end: A1 3.5, A2 28, A3 54, A4 80, A5 106, A6 132, A7 158, A8 184, A9 210.5. Drilling and Placement Templates T4-A · Rail A strip 9/9
Drilling and Placement Templates Page 14

# T4-B Rail B (P07) station strip 1/9 SOURCE-DEFINED MEASURE ON HARDWARE

Template T4-B · rev 2026-10-23 units: mm; tape stations also in cm

numbers: manual/facts.json + data.json, source_commit:

HEAD of https://github.com/scotthowson/desk-setup on 23

Oct 2026 (supersedes a2e99ea with measured facts)

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

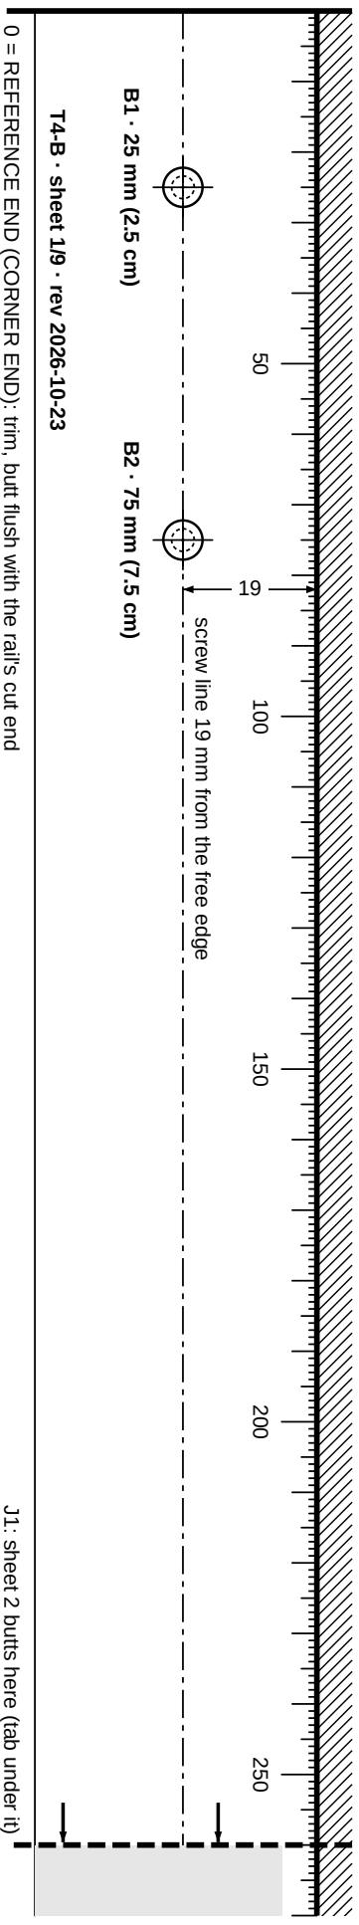
[picture p225: figure]
T4-B · sheet 1/9 · rev 2026-10-23; screw line 19 mm from the free edge

0 = REFERENCE END (CORNER END): trim, butt flush with the rail's cut end J1: sheet 2 butts here (tab under it)

0 10 20 30 40 50 60 70 80 90 100

CALIBRATION 0-100 mm: must measure 100.0 (+/- 0.5)

DRILL ⌀5.56 (7/32 in) through the

# steel; 1/8 in pilot first (dashed). Centre-punch through the paper, low

# speed, cutting oil. Ticks and numbers: position only, never

# drilled. Preferred method: the printed rail drill jig

on the 19 line, with a tape from the

reference end. This strip is the check. Tape

it to either face of the flat leg. 19 is from

the FREE edge (chapter E), not from the heel. MEASURE THE DELIVERED RAIL Design 213.0 cm (2130 mm); bought as 84 in = 213.4 cm (2133.6 mm). Every station runs from the labelled corner end; the far end carries any extra. Tape-check each station from that end. Joins: trim each later sheet on its start J line and lay it on the previous sheet's J line so ticks, numbers and the screw line run on; tape. Rail B

holes, cm from the corner end: B1 2.5, B2 7.5, B3 28, B4 54, B5 80, B6 106, B7 132, B8 158, B9 184, B10 210.5. Drilling and Placement Templates T4-B · Rail B strip 1/9
Drilling and Placement Templates Page 15

# T4-B Rail B (P07) station strip 2/9 SOURCE-DEFINED MEASURE ON HARDWARE

Template T4-B · rev 2026-10-23 units: mm; tape stations also in cm

numbers: manual/facts.json + data.json, source_commit:

HEAD of https://github.com/scotthowson/desk-setup on 23

Oct 2026 (supersedes a2e99ea with measured facts)

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

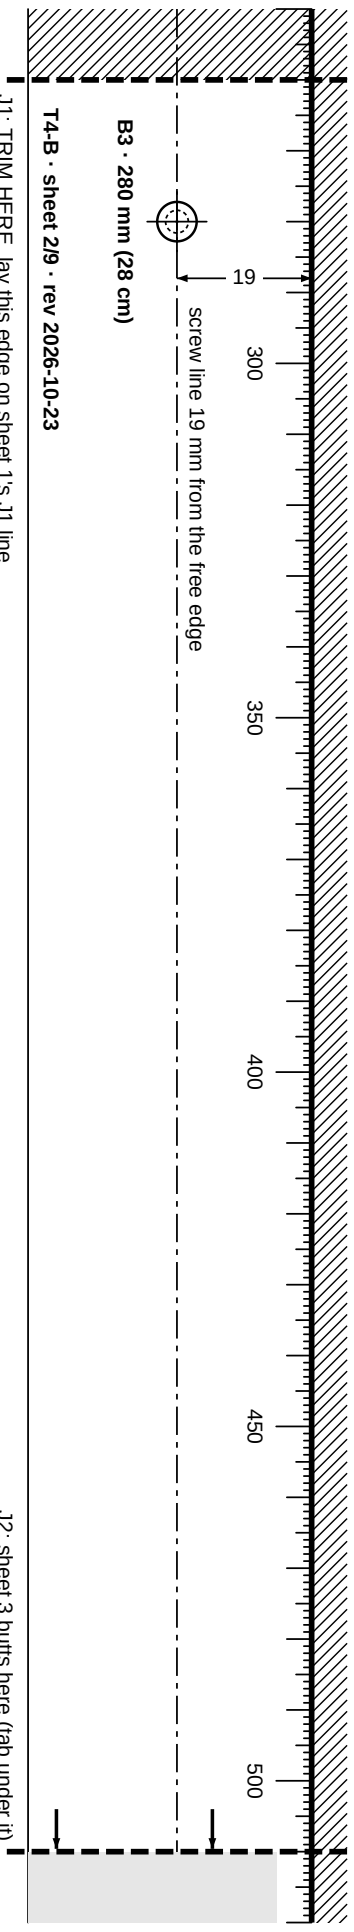
[picture p226: figure]
T4-B · sheet 2/9 · rev 2026-10-23; screw line 19 mm from the free edge

J1: TRIM HERE, lay this edge on sheet 1's J1 line J2: sheet 3 butts here (tab under it)

0 10 20 30 40 50 60 70 80 90 100

CALIBRATION 0-100 mm: must measure 100.0 (+/- 0.5)

DRILL ⌀5.56 (7/32 in) through the

# steel; 1/8 in pilot first (dashed). Centre-punch through the paper, low

# speed, cutting oil. Ticks and numbers: position only, never

# drilled. Preferred method: the printed rail drill jig

on the 19 line, with a tape from the

reference end. This strip is the check. Tape

it to either face of the flat leg. 19 is from

the FREE edge (chapter E), not from the heel. MEASURE THE DELIVERED RAIL Design 213.0 cm (2130 mm); bought as 84 in = 213.4 cm (2133.6 mm). Every station runs from the labelled corner end; the far end carries any extra. Tape-check each station from that end. Joins: trim each later sheet on its start J line and lay it on the previous sheet's J line so ticks, numbers and the screw line run on; tape. Rail B

holes, cm from the corner end: B1 2.5, B2 7.5, B3 28, B4 54, B5 80, B6 106, B7 132, B8 158, B9 184, B10 210.5. Drilling and Placement Templates T4-B · Rail B strip 2/9
Drilling and Placement Templates Page 16

# T4-B Rail B (P07) station strip 3/9 SOURCE-DEFINED MEASURE ON HARDWARE

Template T4-B · rev 2026-10-23 units: mm; tape stations also in cm

numbers: manual/facts.json + data.json, source_commit:

HEAD of https://github.com/scotthowson/desk-setup on 23

Oct 2026 (supersedes a2e99ea with measured facts)

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

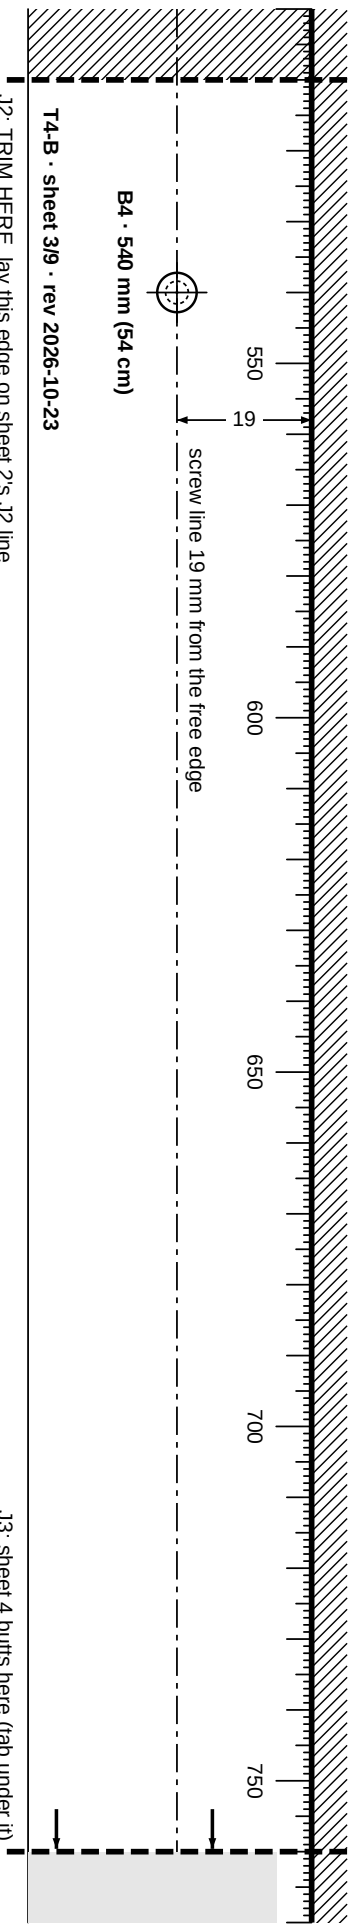
[picture p227: figure]
T4-B · sheet 3/9 · rev 2026-10-23; screw line 19 mm from the free edge

J2: TRIM HERE, lay this edge on sheet 2's J2 line J3: sheet 4 butts here (tab under it)

0 10 20 30 40 50 60 70 80 90 100

CALIBRATION 0-100 mm: must measure 100.0 (+/- 0.5)

DRILL ⌀5.56 (7/32 in) through the

# steel; 1/8 in pilot first (dashed). Centre-punch through the paper, low

# speed, cutting oil. Ticks and numbers: position only, never

# drilled. Preferred method: the printed rail drill jig

on the 19 line, with a tape from the

reference end. This strip is the check. Tape

it to either face of the flat leg. 19 is from

the FREE edge (chapter E), not from the heel. MEASURE THE DELIVERED RAIL Design 213.0 cm (2130 mm); bought as 84 in = 213.4 cm (2133.6 mm). Every station runs from the labelled corner end; the far end carries any extra. Tape-check each station from that end. Joins: trim each later sheet on its start J line and lay it on the previous sheet's J line so ticks, numbers and the screw line run on; tape. Rail B

holes, cm from the corner end: B1 2.5, B2 7.5, B3 28, B4 54, B5 80, B6 106, B7 132, B8 158, B9 184, B10 210.5. Drilling and Placement Templates T4-B · Rail B strip 3/9
Drilling and Placement Templates Page 17

# T4-B Rail B (P07) station strip 4/9 SOURCE-DEFINED MEASURE ON HARDWARE

Template T4-B · rev 2026-10-23 units: mm; tape stations also in cm

numbers: manual/facts.json + data.json, source_commit:

HEAD of https://github.com/scotthowson/desk-setup on 23

Oct 2026 (supersedes a2e99ea with measured facts)

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

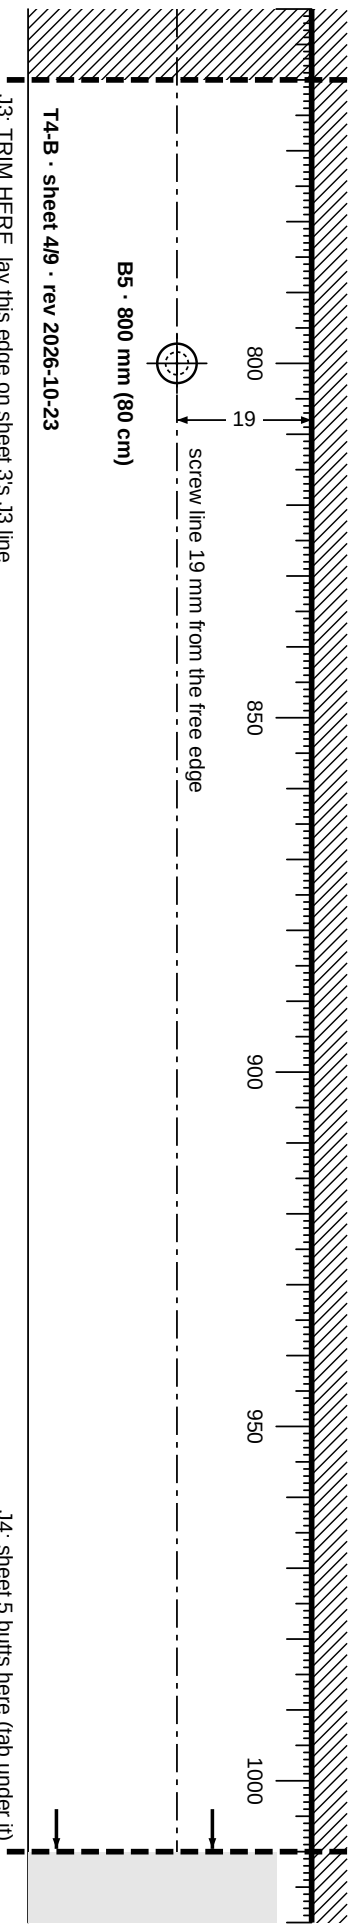
[picture p228: figure]
T4-B · sheet 4/9 · rev 2026-10-23; screw line 19 mm from the free edge

J3: TRIM HERE, lay this edge on sheet 3's J3 line J4: sheet 5 butts here (tab under it)

0 10 20 30 40 50 60 70 80 90 100

CALIBRATION 0-100 mm: must measure 100.0 (+/- 0.5)

DRILL ⌀5.56 (7/32 in) through the

# steel; 1/8 in pilot first (dashed). Centre-punch through the paper, low

# speed, cutting oil. Ticks and numbers: position only, never

# drilled. Preferred method: the printed rail drill jig

on the 19 line, with a tape from the

reference end. This strip is the check. Tape

it to either face of the flat leg. 19 is from

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

holes, cm from the corner end: B1 2.5, B2 7.5, B3 28, B4 54, B5 80, B6 106, B7 132, B8 158, B9 184, B10 210.5. Drilling and Placement Templates T4-B · Rail B strip 4/9
Drilling and Placement Templates Page 18

# T4-B Rail B (P07) station strip 5/9 SOURCE-DEFINED MEASURE ON HARDWARE

Template T4-B · rev 2026-10-23 units: mm; tape stations also in cm

numbers: manual/facts.json + data.json, source_commit:

HEAD of https://github.com/scotthowson/desk-setup on 23

Oct 2026 (supersedes a2e99ea with measured facts)

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

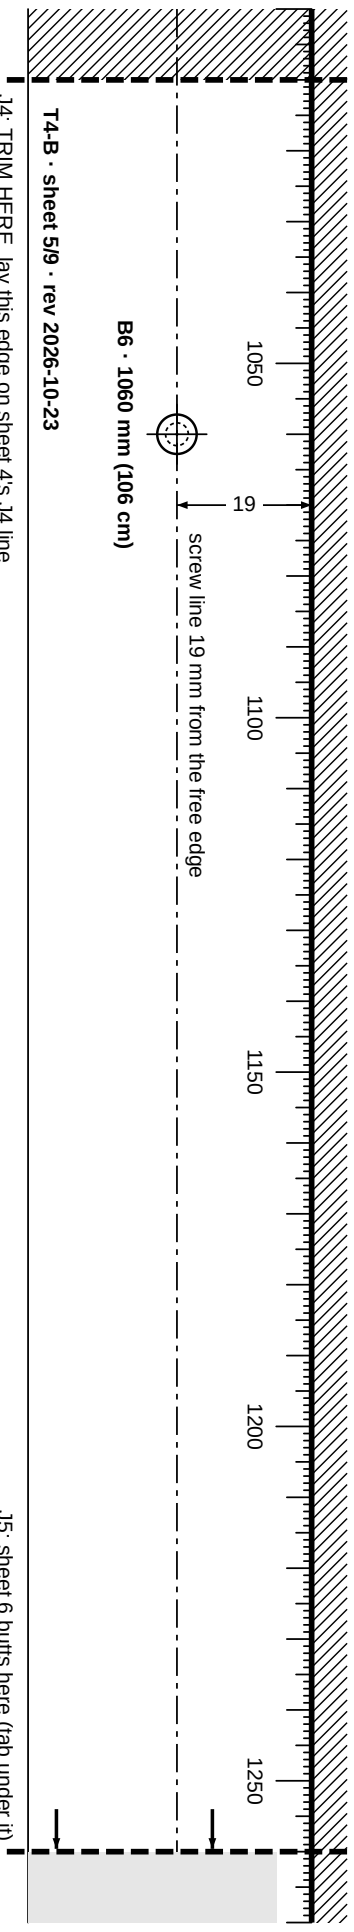
[picture p229: figure]
T4-B · sheet 5/9 · rev 2026-10-23; screw line 19 mm from the free edge

J4: TRIM HERE, lay this edge on sheet 4's J4 line J5: sheet 6 butts here (tab under it)

0 10 20 30 40 50 60 70 80 90 100

CALIBRATION 0-100 mm: must measure 100.0 (+/- 0.5)

DRILL ⌀5.56 (7/32 in) through the

# steel; 1/8 in pilot first (dashed). Centre-punch through the paper, low

# speed, cutting oil. Ticks and numbers: position only, never

# drilled. Preferred method: the printed rail drill jig

on the 19 line, with a tape from the

reference end. This strip is the check. Tape

it to either face of the flat leg. 19 is from

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

holes, cm from the corner end: B1 2.5, B2 7.5, B3 28, B4 54, B5 80, B6 106, B7 132, B8 158, B9 184, B10 210.5. Drilling and Placement Templates T4-B · Rail B strip 5/9
Drilling and Placement Templates Page 19

# T4-B Rail B (P07) station strip 6/9 SOURCE-DEFINED MEASURE ON HARDWARE

Template T4-B · rev 2026-10-23 units: mm; tape stations also in cm

numbers: manual/facts.json + data.json, source_commit:

HEAD of https://github.com/scotthowson/desk-setup on 23

Oct 2026 (supersedes a2e99ea with measured facts)

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

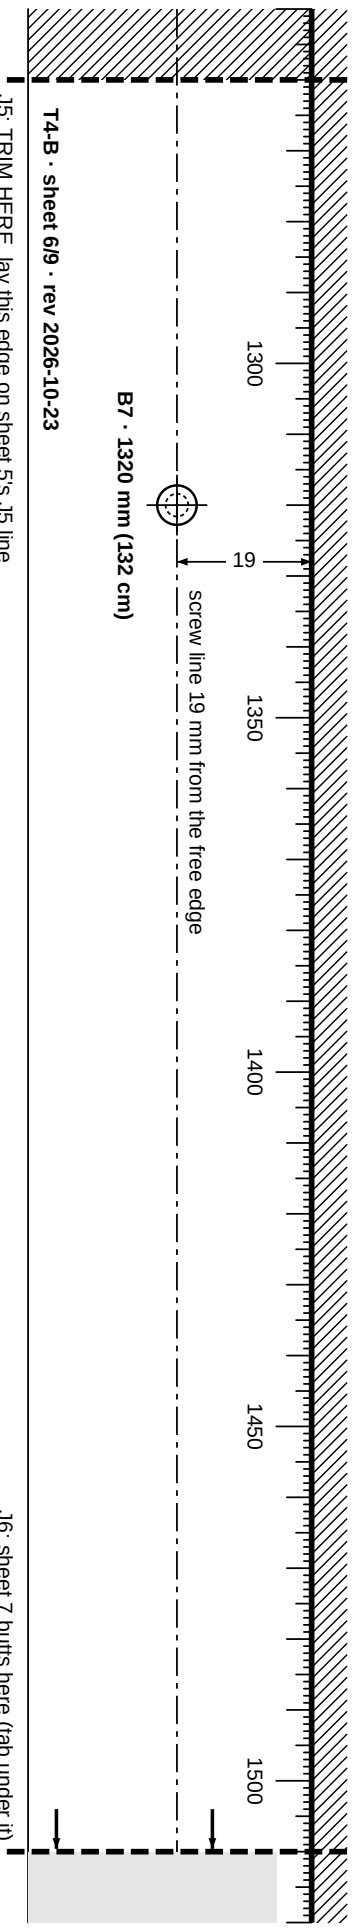
[picture p230: figure]
T4-B · sheet 6/9 · rev 2026-10-23; screw line 19 mm from the free edge

J5: TRIM HERE, lay this edge on sheet 5's J5 line J6: sheet 7 butts here (tab under it)

0 10 20 30 40 50 60 70 80 90 100

CALIBRATION 0-100 mm: must measure 100.0 (+/- 0.5)

DRILL ⌀5.56 (7/32 in) through the

# steel; 1/8 in pilot first (dashed). Centre-punch through the paper, low

# speed, cutting oil. Ticks and numbers: position only, never

# drilled. Preferred method: the printed rail drill jig

on the 19 line, with a tape from the

reference end. This strip is the check. Tape

it to either face of the flat leg. 19 is from

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

holes, cm from the corner end: B1 2.5, B2 7.5, B3 28, B4 54, B5 80, B6 106, B7 132, B8 158, B9 184, B10 210.5. Drilling and Placement Templates T4-B · Rail B strip 6/9
Drilling and Placement Templates Page 20

# T4-B Rail B (P07) station strip 7/9 SOURCE-DEFINED MEASURE ON HARDWARE

Template T4-B · rev 2026-10-23 units: mm; tape stations also in cm

numbers: manual/facts.json + data.json, source_commit:

HEAD of https://github.com/scotthowson/desk-setup on 23

Oct 2026 (supersedes a2e99ea with measured facts)

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

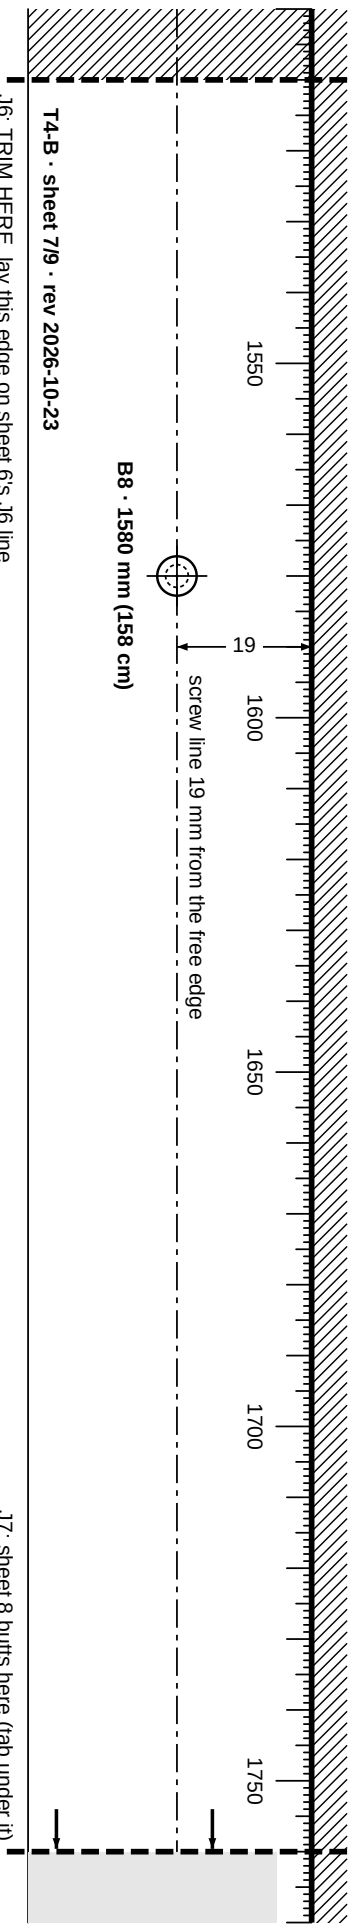
[picture p231: figure]
T4-B · sheet 7/9 · rev 2026-10-23; screw line 19 mm from the free edge

J6: TRIM HERE, lay this edge on sheet 6's J6 line J7: sheet 8 butts here (tab under it)

0 10 20 30 40 50 60 70 80 90 100

CALIBRATION 0-100 mm: must measure 100.0 (+/- 0.5)

DRILL ⌀5.56 (7/32 in) through the

# steel; 1/8 in pilot first (dashed). Centre-punch through the paper, low

# speed, cutting oil. Ticks and numbers: position only, never

# drilled. Preferred method: the printed rail drill jig

on the 19 line, with a tape from the

reference end. This strip is the check. Tape

it to either face of the flat leg. 19 is from

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

holes, cm from the corner end: B1 2.5, B2 7.5, B3 28, B4 54, B5 80, B6 106, B7 132, B8 158, B9 184, B10 210.5. Drilling and Placement Templates T4-B · Rail B strip 7/9
Drilling and Placement Templates Page 21

# T4-B Rail B (P07) station strip 8/9 SOURCE-DEFINED MEASURE ON HARDWARE

Template T4-B · rev 2026-10-23 units: mm; tape stations also in cm

numbers: manual/facts.json + data.json, source_commit:

HEAD of https://github.com/scotthowson/desk-setup on 23

Oct 2026 (supersedes a2e99ea with measured facts)

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

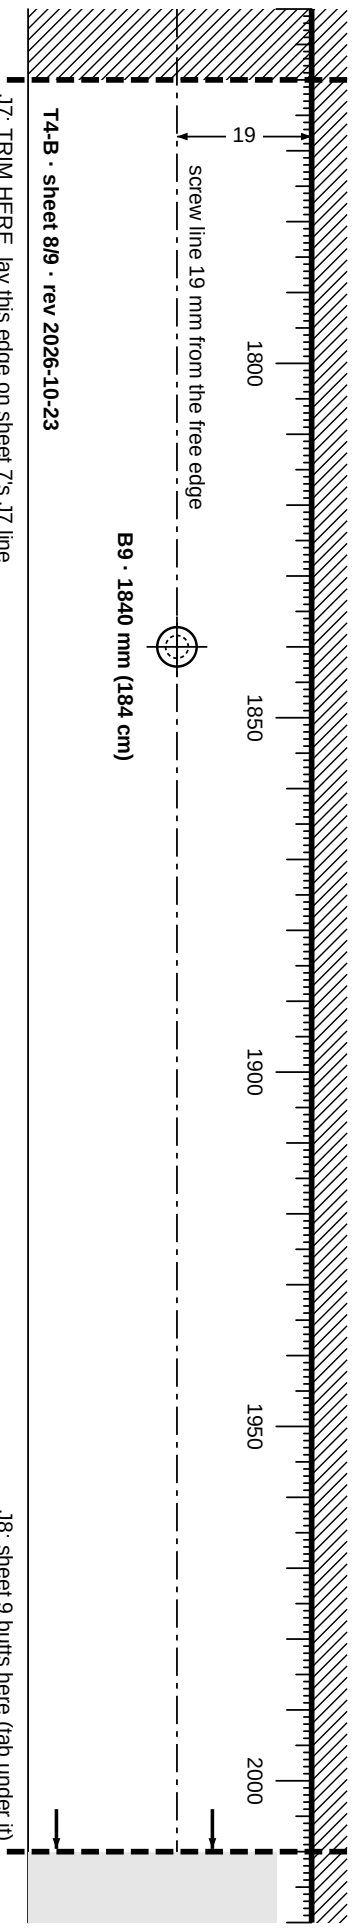
[picture p232: figure]
T4-B · sheet 8/9 · rev 2026-10-23; screw line 19 mm from the free edge

J7: TRIM HERE, lay this edge on sheet 7's J7 line J8: sheet 9 butts here (tab under it)

0 10 20 30 40 50 60 70 80 90 100

CALIBRATION 0-100 mm: must measure 100.0 (+/- 0.5)

DRILL ⌀5.56 (7/32 in) through the

# steel; 1/8 in pilot first (dashed). Centre-punch through the paper, low

# speed, cutting oil. Ticks and numbers: position only, never

# drilled. Preferred method: the printed rail drill jig

on the 19 line, with a tape from the

reference end. This strip is the check. Tape

it to either face of the flat leg. 19 is from

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

holes, cm from the corner end: B1 2.5, B2 7.5, B3 28, B4 54, B5 80, B6 106, B7 132, B8 158, B9 184, B10 210.5. Drilling and Placement Templates T4-B · Rail B strip 8/9
Drilling and Placement Templates Page 22

# T4-B Rail B (P07) station strip 9/9 SOURCE-DEFINED MEASURE ON HARDWARE

Template T4-B · rev 2026-10-23 units: mm; tape stations also in cm

numbers: manual/facts.json + data.json, source_commit:

HEAD of https://github.com/scotthowson/desk-setup on 23

Oct 2026 (supersedes a2e99ea with measured facts)

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

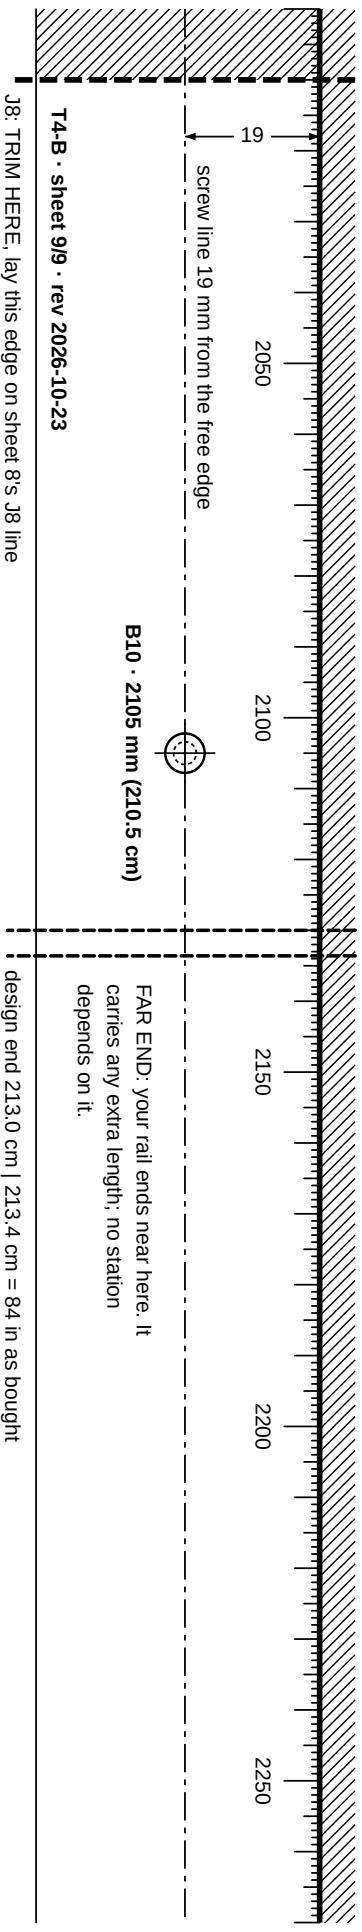
[picture p233: figure]
FAR END: your rail ends near here. It; carries any extra length; no station; screw line 19 mm from the free edge

J8: TRIM HERE, lay this edge on sheet 8's J8 line design end 213.0 cm | 213.4 cm = 84 in as bought

# depends on it. T4-B · sheet 9/9 · rev 2026-10-23

0 10 20 30 40 50 60 70 80 90 100

CALIBRATION 0-100 mm: must measure 100.0 (+/- 0.5)

DRILL ⌀5.56 (7/32 in) through the

# steel; 1/8 in pilot first (dashed). Centre-punch through the paper, low

# speed, cutting oil. Ticks and numbers: position only, never

# drilled. Preferred method: the printed rail drill jig

on the 19 line, with a tape from the

reference end. This strip is the check. Tape

it to either face of the flat leg. 19 is from

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

holes, cm from the corner end: B1 2.5, B2 7.5, B3 28, B4 54, B5 80, B6 106, B7 132, B8 158, B9 184, B10 210.5. Drilling and Placement Templates T4-B · Rail B strip 9/9
Drilling and Placement Templates Page 23

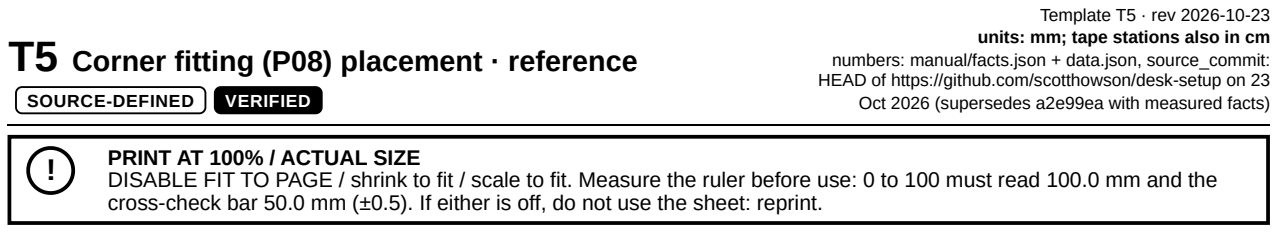
[picture p234: figure]
SOURCE-DEFINED; VERIFIED; Template T5 · rev 2026-10-23 units: mm; tape stations also in cm numbers: manual/facts.json + data.json, source_commit: HEAD of https://github.com/scotthowson/desk-setup on 23; PRINT AT 100% / ACTUAL SIZE

## T5 Corner fitting (P08) placement · reference

Oct 2026 (supersedes a2e99ea with measured facts)

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

0 | 10 | 20 | 30 | 40 | 50 | 60 | 70 | 80 | 90 | 100

CALIBRATION 0-100 mm: must measure 100.0 (+/- 0.5)

### 50 m

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
T5 · P08 on P06 / P07 · REFERENCE 1:2, NOT FOR DRILLING · rev 2026-10-23

VIEW 1 · rail A vertical leg, front face (from the knee side), 1:2

INSIDE heel 51.5 cm: legs ← wall end

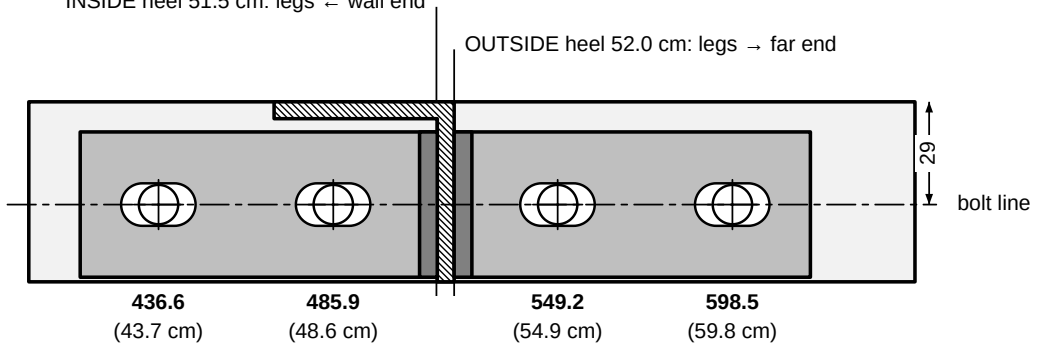
[picture p235: figure]
OUTSIDE heel 52.0 cm: legs → far end; bolt line

rail A hole centres from the WALL END (40 cm off the drawing) rail B end (section)

VIEW 2 · rail B vertical leg, outer face, corner end, 1:2

HEEL = corner end (0): fitting legs → far end

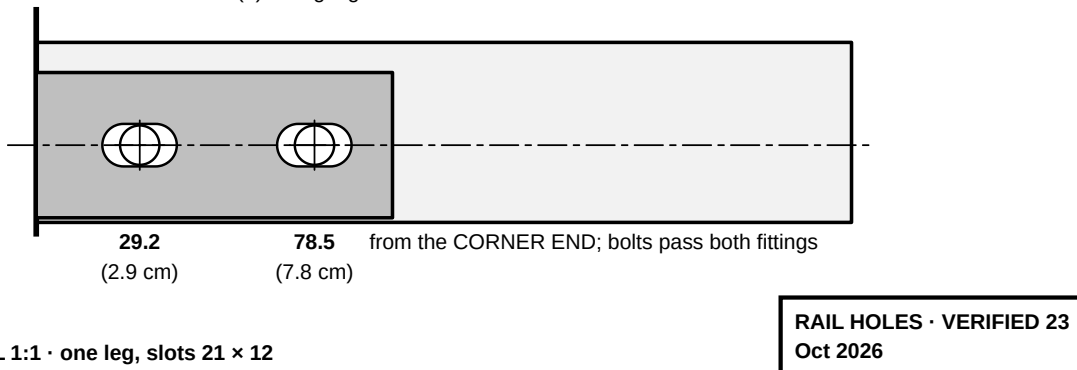
[picture p236: figure]
RAIL HOLES · VERIFIED 23 Oct 2026

from the CORNER END; bolts pass both fittings

DETAIL 1:1 · one leg, slots 21 × 12 Rail A, cm from the wall

Drilling and Placement Templates | T5 · Corner fittings P08

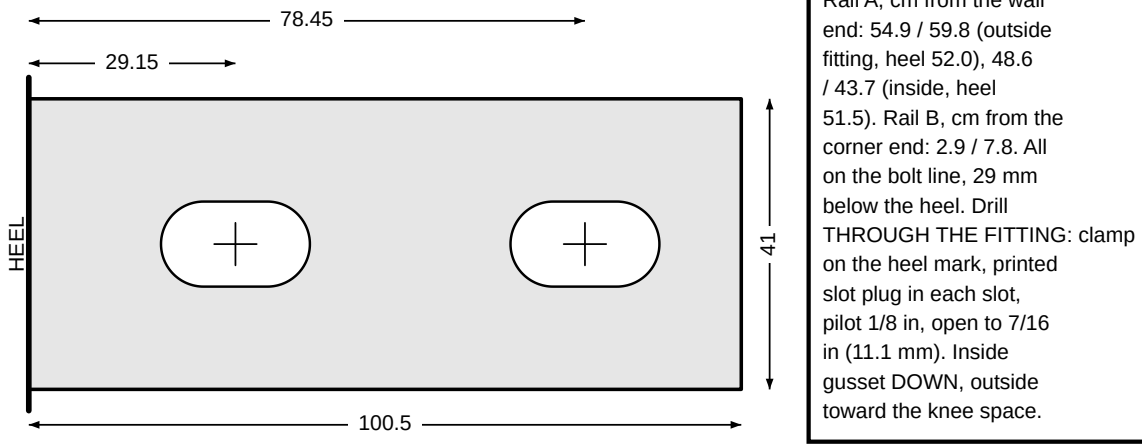
[picture p237: figure]
end: 54.9 / 59.8 (outside fitting, heel 52.0), 48.6 / 43.7 (inside, heel 51.5). Rail B, cm from the corner end: 2.9 / 7.8. All on the bolt line, 29 mm below the heel. Drill THROUGH THE FITTING: clamp on the heel mark, printed slot plug in each slot, pilot 1/8 in, open to 7/16 in (11.1 mm). Inside gusset DOWN, outside toward the knee space.

Drilling and Placement Templates | Page 24

## T6 Clamp pad plate (P11) placement · reference

SOURCE-DEFINED | VERIFIED | ASSUMPTION / FIELD CHECK

Template T6 · rev 2026-10-23 units: mm; tape stations also in cm numbers: manual/facts.json + data.json, source_commit: HEAD of https://github.com/scotthowson/desk-setup on 23 Oct 2026 (supersedes a2e99ea with measured facts)

!

PRINT AT 100% / ACTUAL SIZE
DISABLE FIT TO PAGE / shrink to fit / scale to fit. Measure the ruler before use: 0 to 100 must read 100.0 mm and the cross-check bar 50.0 mm (±0.5). If either is off, do not use the sheet: reprint.
0 | 10 | 20 | 30 | 40 | 50 | 60 | 70 | 80 | 90 | 100

CALIBRATION 0-100 mm: must measure 100.0 (+/- 0.5)

### 50 m

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
T6 · P11 pads for P12 · POSITIONING ONLY, NO DRILLING · 1:4 · rev 2026-10-23

back wall

side wall

DATUM (0, 0)

x

y

rail A (y 47.9-53.0 cm)

L1

200 (20.0 cm)

454 (45.4 cm)

200 (20.0 cm)

454 (45.4 cm)

pad plate x 20.0-45.4 cm, y 0.5-8.1 cm

clamp zone 36-44 cm
jaw pad 90 × 50 mm

pad plate x 0.5-8.1 cm, y 20.0-45.4 cm

clamp zone 36-44 cm; oval

Plan from above, datum top A's back-left corner (x along the back wall, y along the side wall). The plates lie LOOSE on the underside under the VIVO lower jaws (chapter I): with the top face down, draw the outlines measuring from the same two named edges. Jaw pad: oval 90 × 50 mm,
13.5-63.5 mm in from the edge (measured), drawn centred on each clamp.

SOURCE-DEFINED: the pad plate outlines (marking table, chapter D). VERIFIED: the 90 × 50 mm lower-jaw pad, measured 21-23 Oct 2026 (facts.json vivo). ASSUMPTION / FIELD CHECK: the oval drawn centred on the clamp; the clamp back sets the final position (crossbar fitted as the spacing guide).

Drilling and Placement Templates | T6 · Clamp pad plates P11
Drilling and Placement Templates | Page 25

# T7 Corner bolt holes (P08 on P06 / P07) · drilling template 1:1 VERIFIED SOURCE-DEFINED

Template T7 · rev 2026-10-23 units: mm; tape stations also in cm

numbers: manual/facts.json + data.json, source_commit:

HEAD of https://github.com/scotthowson/desk-setup on 23

Oct 2026 (supersedes a2e99ea with measured facts)

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

reprint. 0 10 20 30 40 50 60 70 80 90 100 CALIBRATION 0-100 mm: must measure 100.0 (+/- 0.5) DRILL ⌀11.11 (7/16 in) through the vertical leg, 29 below the heel: punch through the paper, 1/8 in pilot (dashed), then 7/16, low speed, oil; deburr both faces. On the bench, before the rails go on the tops. Hatched: rail B's end on rail A. Grey: the fittings' legs and slots, orientation only. RAIL A (P06) · vertical leg, OUTER face (toward the knee space) · HEEL edge UP · WALL END to the LEFT

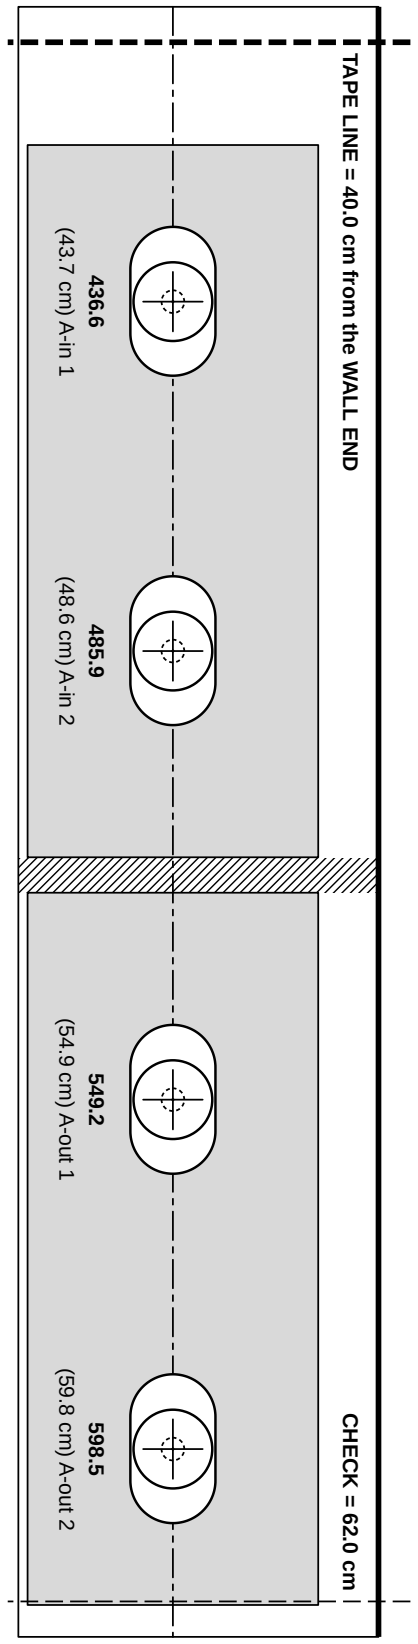
[picture p238: figure]
(54.9 cm) A-out 1; (59.8 cm) A-out 2

TAPE LINE = 40.0 cm from the WALL END CHECK = 62.0 cm

WALL END (x = 1 cm) FAR END INSIDE fitting heel 51.5 OUTSIDE fitting heel 52.0

RAIL B (P07) · vertical leg, EITHER face · HEEL edge UP · trim on the heavy END line, butt it flush with the CORNER END

29.2

(2.9 cm) B1

78.5

(7.8 cm) B2

RAIL A: 1. Trim on the heavy HEEL line. 2. Hook the tape on

rail A's WALL END (the end that goes 1 cm in from top A's

taped end) and mark 40.0 and 62.0 cm on the heel corner. 3. Trimmed edge along the heel, TAPE line on 40.0; the CHECK line

must fall on 62.0 (if not, the sheet is scaled: reprint). 4. Tape, punch, drill the four. Assumes rail B's outer face at 53

cm from the wall, butting on rail A (chapter H). RAIL B: one bolt per hole with a fitting on both sides of the

leg, so the pattern is the same from either face. Skip if

already drilled. Bolts 3/8-16 x 1-1/2, washers, nylon nuts, 25

N·m by hand; never an impact wrench. K

T7 · P08 on P06 / P07 · rev 2026-10-23

Drilling and Placement Templates T7 · Corner bolt holes

Drilling and Placement Templates Page 26
