scotthowson/desk-setup/manual/build/manual-a.pdf

# L-Shaped Corner Desk

## Assembly manual


Footprint | 249 × 314 cm

Surface height | 83.0 cm

Tops | A along the back wall, B along the side wall (two IKEA EKBACKEN, each 249 × 65 cm, 28 mm thick)

Floor needed | 252 × 317 cm, including the 3 cm wall gaps

Tape-measure sizes in cm. The rails are hidden under the front edges and are drawn dashed.

# Contents

A · Finished assembly | 3
F · Legs, feet, rails and cabinets | 5

L-Shaped Corner Desk · Assembly Manual

L-Shaped Corner Desk · Assembly Manual | 2

# A · Finished assembly

BACK WALL; SIDE WALL; SEAT: inside corner, facing the diagonal; front edge A (you); front edge B (you); Part

Fig. A-1 The finished desk seen from the room. Dashed lines under the front edges: the two steel rails, hidden by the tops. Left and right are as you sit at the inside corner facing the diagonal: top A is on your right, top B on your left.

P01 | Top A, EKBACKEN 249 × 65 cm, 28 mm thick | P07 | Rail B, steel angle 213 cm
P02 | Top B, EKBACKEN 249 × 65 cm, 28 mm thick | P09 | Round adjustable foot 4 in x 8
P03 | ALEX 1, drawer unit 36 × 58 × 70 cm | P12 | VIVO STAND-V300CU
P04 | ALEX 2, storage unit with door 36 × 58 × 70 cm | P13 | Samsung Odyssey G5 32 in
P05 | OLOV leg x 6, 105 mm plate | P14 | Acer XZ320QU x 2
P06 | Rail A, steel angle 213 cm | P17 | HYTE Y60 on printed pedestal

### What this desk is

Two IKEA kitchen tops make an L. Top A lies along the back wall and keeps the corner square; top B lies along the side wall and its end butts against top A's front edge. Each top stands 3 cm off its wall, with its square, unfinished long edge toward the wall. The far end of each top rests on an ALEX cabinet through four adjustable feet: the feet are screwed to the top, and their pads drop into printed rings on the cabinet, so the desk cannot slide on the cabinets and the two heavy boxes hold the whole frame square. Six OLOV legs stand along the two wall edges, none at the front, so the space under the inside corner is open for your knees.

That leaves the two front edges with nothing under them for more than two metres, so each one is carried by a steel angle rail screwed to the underside 12 cm back from the front edge. Under the inside corner the two rails are bolted together with two gusseted steel fittings, so the corner of top B hangs from rail A. The rails never touch a cabinet: their ends load the top, and the top loads the nearest feet. The monitor stand clamps to top A's two wall edges, 40 cm from the corner; the surface is 83.0 cm above the floor.

L-Shaped Corner Desk · Assembly Manual | A · Finished assembly
L-Shaped Corner Desk · Assembly Manual | Page 3

# A · Plan of the finished desk

A

BACK WALL; SID; ALEX 1; ALEX 2; rail A; rail B; VIVO clamp 1 (x 40); clamp 2 (y 40); datum 0,0; seat, facing the diagonal; 3 cm gap; Leg; Foot; ALEX 1 x 209.5–245.5 y 3.5–61.5 ALEX 2 x 3.5–61.5 y 274.5–310.5 Rail A x 1–214 y 47.9–53 Rail B x 47.9–53 y 53–266 Clamp 1 x 40 on A's back edge Clamp 2 y 40 on A's left end; L-Shaped Corner Desk · Assembly Manual; A · Finished assembly

3 cm gap to the wall

3.5 cm all round

Centres and extents, cm from the datum

unfinished edge, against the wall
hidden: ALEX, leg plates, feet plates
rail (steel angle)
clamp zone C1 / C2, keep clear
knee zone, keep clear

Fig. A-2 Top-down plan, seen from above. Datum: top A's back-left corner (0, 0); x runs along the back wall, y along the side wall,
all in cm. Coordinates SOURCE-DEFINED (docs/build-manual.md). ALEX 1 drawers and ALEX 2 door face you.

Heights above the floor: surface 83.0 cm, underside of the tops 80.2 cm (the OLOV setting), rail lower edge 75.1 cm
SOURCE-DEFINED ; ALEX top 70.0 cm ASSUMPTION / FIELD CHECK measure your units.
Next: chapter B, before you begin.

# F · Legs, feet, rails and cabinets

Tops face down on a blanket: six legs, eight feet (gauged before the plates go on) and the two rails. Then the cabinets are set by the walls. Rings come in chapter G.

No. | Part | No. | Hardware | Qty
P01 P02 | Top A and top B, EKBACKEN 249 × 65 cm, 28 mm thick | H01 | M4 x 16 mm machine screw, IKEA 108443 (with the OLOV legs) | 30
P03 P04 | ALEX 1, drawer unit; ALEX 2, storage unit with door (36 × 58 × 70 cm) | H02 | #8 x 5/8 in pan head screw (feet plates, 4 each) | 32
P05 | OLOV leg x 6, 105 mm plate | H06 | #6 x 5/8 in flat head (rings, 3 each) | 24
P06 P07 | Rail A and rail B, steel angle 213 cm, drilled | H03 | #10 x 1 in pan head, Robertson (rails; 17 now, 2 in chapter H) | 19
P09 P10 | Round adjustable foot 4 in x 8; printed locating ring x 8 (chapter G) | P18 printed tools: leg jig, feet corner jig, edge T-square, ALEX corner template, drill guide (tower + pucks), foot height gauge, wall gauge

A

back edge: square, unfinished (goes to the wall) · y = 0 measure y from here

front edge: rounded, laminated

side-w

all end · x = 0

far end · x = 249 cm
TAPE

TA

P
E

datum

x

stand here | B

joint end (tape 0)

front edge: rounded, la

minated · x = 65 cm

TAPE

TA

P
E

y

far end

stand here

A
B

Face up, as installed:
heavy line = unfinished edge, always to a wall.

B is A turned a quarter turn: B's drawings are not a
mirror of A's.

Either short end of A can be its side-wall end: tape one.

Fig. F-1 How each top lies while you mark it: face down, laminate on the blanket. Heavy line: the square, unfinished long edge, which always goes to a wall (y = 0 on A, x = 0 on B). Tape the unfinished edge and the end you measure from, and stand where the person symbol is; the drawings in this chapter then match what you see, with x growing to the left. Datum: top A's back-left corner (0, 0). The arrow turns A anticlockwise into B.

Decide the desk height first (the legs are pre-set in step 1): built at 83.0 cm as planned; optional printed ALEX feet, 2, 4 or 6 cm tall, raise everything by their height. SOURCE-DEFINED

ALEX feet | Underside of the tops (cm) | Top surface (cm) | Every OLOV set to (cm) | Rail lower edge (cm)
none (as planned) | 80.2 | 83.0 | 80.2 | 75.1
2 cm | 82.2 | 85.0 | 82.2 | 77.1
4 cm | 84.2 | 87.0 | 84.2 | 79.1
6 cm | 86.2 | 89.0 | 86.2 (OLOV max 90) | 81.1
L-Shaped Corner Desk · Assembly Manual | F · Legs, feet, rails and cabinets

# F · Underside support layout

rail A line, y = 53 cm (step 4)

C1

C2

back edge (unfinished, to the wall) · y = 0 · measure y from here

front edge (rounded)

far end

side-w

all end · x = 0

datum

L1

L3 | L2
F2 | F1
F4 | F3

ALEX 1
below

10 cm

8.5 cm

34.5 cm | 15 cm

Fig. F-2 Top A face down. Stand at the front edge with the back edge away from you: the side-wall end is on your right and x grows to the left from the side-wall end. Circles: OLOV plates with their five holes, one pointing at the wall (L1's pattern is turned). Squares: feet plates. Grey: clamp zones C1, C2, keep clear; thin dashed: the clamp pad outlines; dash-dot: rail A's line. Datum (0,
0) at the top-right corner of this view. Drawing labels in cm.

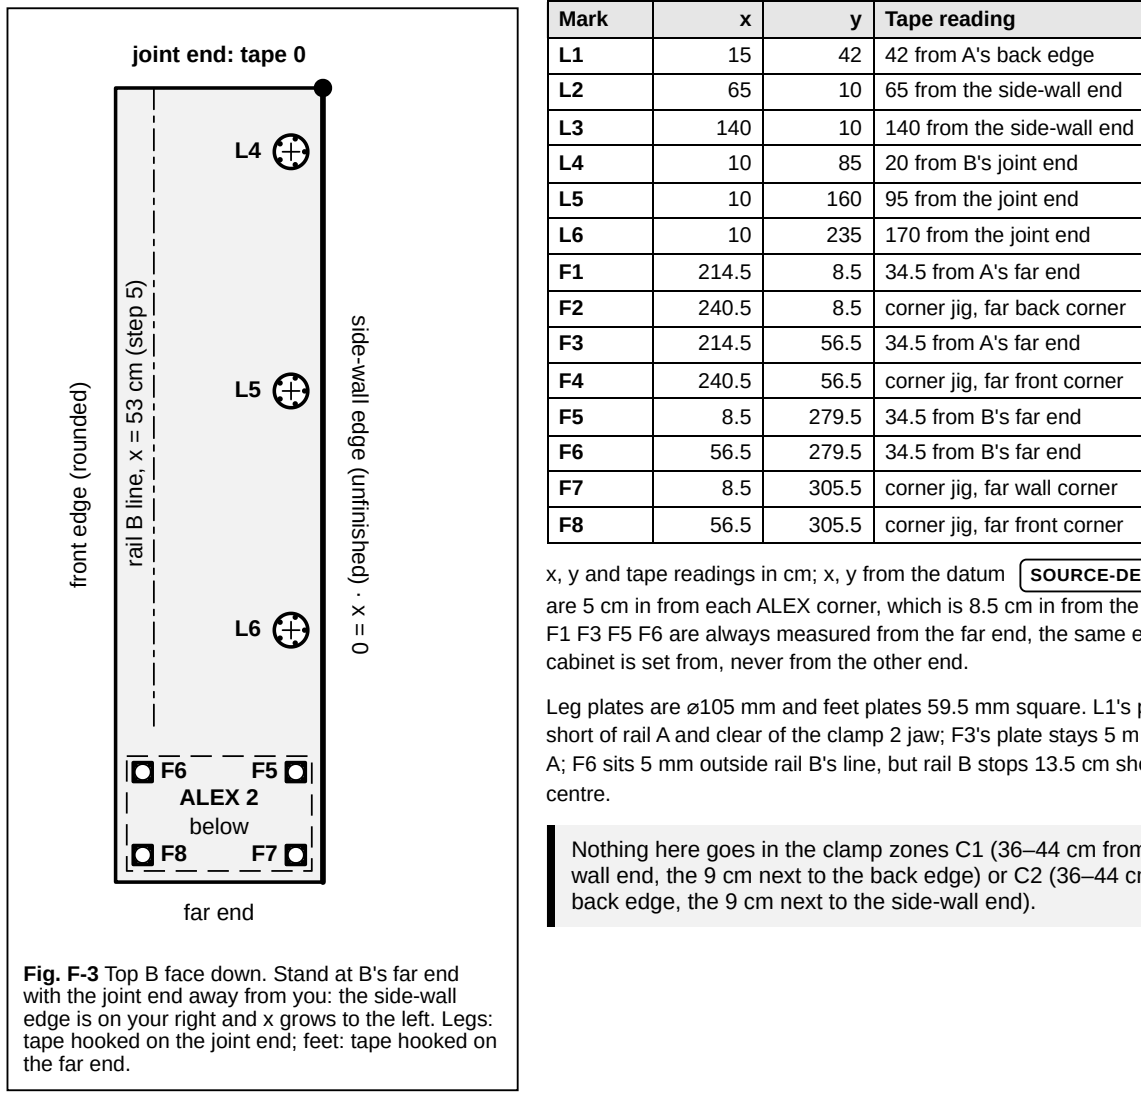
[picture p239: figure]
rail B line, x = 53 cm (step 5); joint end: tape 0; far end; side-w; all edge (unfinished) · x = 0; front edge (rounded); ALEX 2 below; the far end.; Mark; Tape reading; 42 from A's back edge; 65 from the side-wall end; 140 from the side-wall end; 20 from B's joint end; 95 from the joint end; 170 from the joint end; 34.5 from A's far end; corner jig, far back corner; corner jig, far front corner; 34.5 from B's far end; corner jig, far wall corner; centre.

Fig. F-3 Top B face down. Stand at B's far end with the joint end away from you: the side-wall edge is on your right and x grows to the left. Legs: tape hooked on the joint end; feet: tape hooked on x, y and tape readings in cm; x, y from the datum SOURCE-DEFINED . Feet are 5 cm in from each ALEX corner, which is 8.5 cm in from the top's edges. F1 F3 F5 F6 are always measured from the far end, the same end the cabinet is set from, never from the other end.

Leg plates are ⌀105 mm and feet plates 59.5 mm square. L1's plate ends short of rail A and clear of the clamp 2 jaw; F3's plate stays 5 mm clear of rail A; F6 sits 5 mm outside rail B's line, but rail B stops 13.5 cm short of F6's

Nothing here goes in the clamp zones C1 (36–44 cm from the side-wall end, the 9 cm next to the back edge) or C2 (36–44 cm from the back edge, the 9 cm next to the side-wall end).

# F · Step 1: legs

Calipers on both tops before the first hole: expect 28 mm. At 27 mm nothing changes: the deepest screw still stops 6 mm short of the laminate. Under 27 mm, stop and ask. No screw may go deeper than 21 mm into a top.

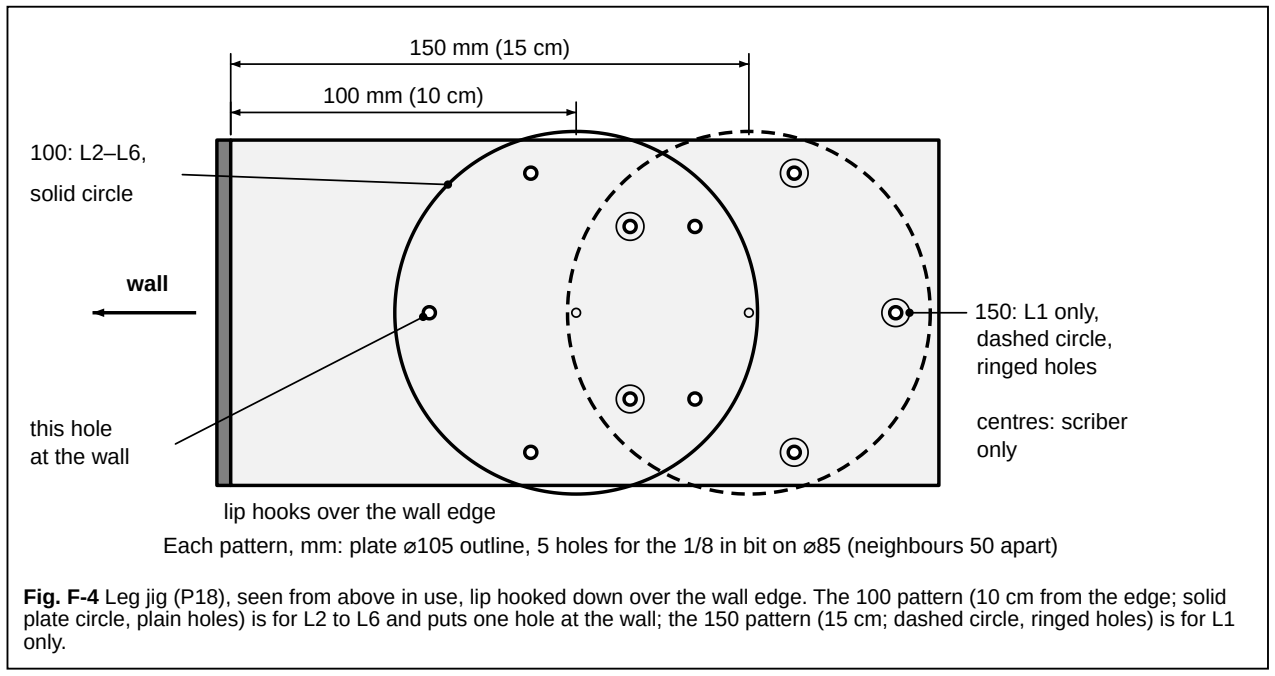
[picture p240: figure]
wall; lip hooks over the wall edge; this hole at the wall; 150: L1 only, dashed circle, ringed holes; solid circle; centres: scriber only; only.

Each pattern, mm: plate ⌀105 outline, 5 holes for the 1/8 in bit on ⌀85 (neighbours 50 apart)

Fig. F-4 Leg jig (P18), seen from above in use, lip hooked down over the wall edge. The 100 pattern (10 cm from the edge; solid plate circle, plain holes) is for L2 to L6 and puts one hole at the wall; the 150 pattern (15 cm; dashed circle, ringed holes) is for L1

Leg | Top | Hook the lip over | Tape station (cm), as marked in chapter D | Pattern
L1 | A | side-wall end (x = 0) | 42 from the back edge | 150, ringed holes
L2 L3 | A | back edge (y = 0) | 65 (L2) and 140 (L3) from the side-wall end | 100
L4 L5 L6 | B | side-wall edge (x = 0) | 20 (L4), 95 (L5), 170 (L6) from the joint end | 100

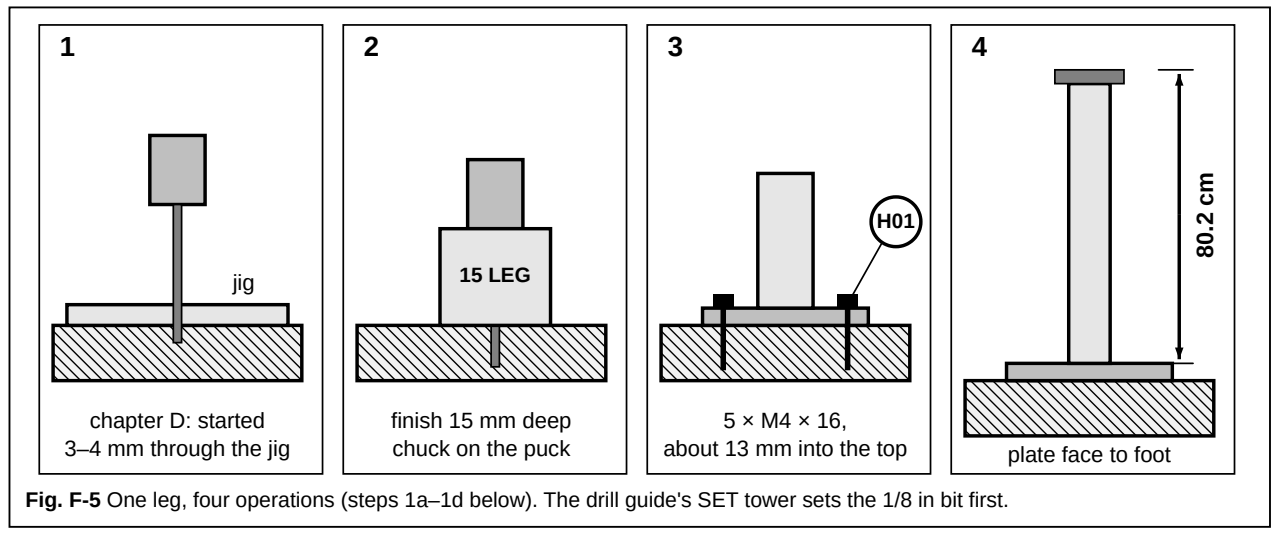
[picture p241: figure]
chapter D: started 3–4 mm through the jig; jig; 15 LEG; finish 15 mm deep chuck on the puck; 5 × M4 × 16, about 13 mm into the top; plate face to foot

Fig. F-5 One leg, four operations (steps 1a–1d below). The drill guide's SET tower sets the 1/8 in bit first.

1

a Drop the leg jig back onto the five starts you made in chapter D, bit tip in each start, then lift it. b Finish each pilot 15 mm deep with the 1/8 in bit and the 15 LEG puck. c Screw the OLOV plate on with five H01 M4 × 16 screws (about 13 mm into the top). d Pre-set the leg to 80.2 cm from plate face to foot (or the table's number at the start of this chapter if you fit ALEX feet). Six legs, 30 screws.

OLOV plate ⌀105 mm, five ⌀5.5 mm holes on an ⌀85 mm circle, neighbouring holes 50 mm apart; leg range 60–90 cm. VERIFIED 105 mm plate measured 22 Oct 2026; hole pattern from a shared OLOV template, printed and test-fitted.

# F · Step 2: wind each foot to 102 mm, loose

Measure your ALEX units first, with and without their stock feet. The drawings take an ALEX as 70 cm tall, which is what makes the feet 102 mm between the ALEX top and the underside at 80.2 cm. If a unit is not 70.0 cm tall, nothing changes here; levelling in chapter G takes it up.

2

Hold each foot loose in your hand, plate and all, before
anything is screwed. Wind its pad out until the printed foot height gauge (102.0 mm inside) just slides over it from the side with no rock. All eight then match without a ruler. Do this now: the gauge's C sits against the plate face, so it cannot be used once the plate is screwed to the top.

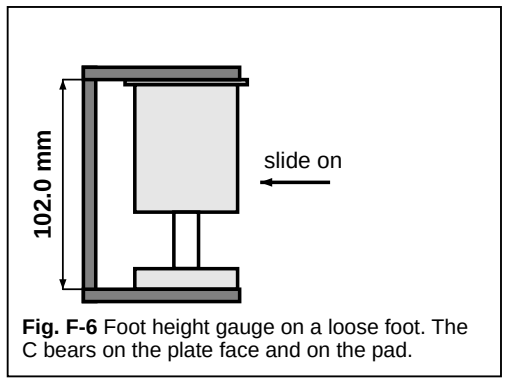
[picture p242: figure]
slide on

Fig. F-6 Foot height gauge on a loose foot. The C bears on the plate face and on the pad.

!

ASSUMPTION / FIELD CHECK ASSUMPTION / FIELD CHECK
The feet's load rating is unknown; the design wants 50 kg or more each.

# F · Step 3: feet plates

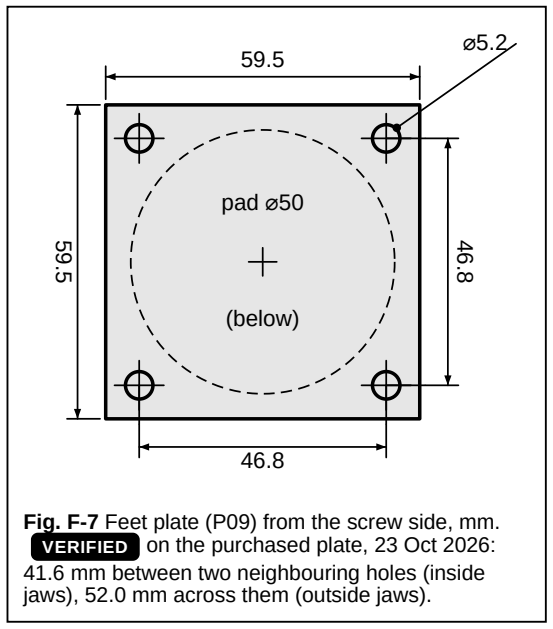
[picture p243: figure]
pad ⌀50; (below)

Fig. F-7 Feet plate (P09) from the screw side, mm. VERIFIED on the purchased plate, 23 Oct 2026: 41.6 mm between two neighbouring holes (inside jaws), 52.0 mm across them (outside jaws).

Feet | Tool | Placement (as in chapter D)
F2 F4 | feet corner jig | top A's two far corners, fences on both edges
F1 F3 | T-square, 85 hole | lip over A's back edge (F1) or front edge (F3), station 34.5 cm from A's far end (tape hooked on the far end)
F7 F8 | feet corner jig | top B's two far corners
F5 F6 | T-square, 85 hole | lip over B's side-wall edge (F5) or front edge (F6), station 34.5 cm from B's far end (tape hooked on the far end)

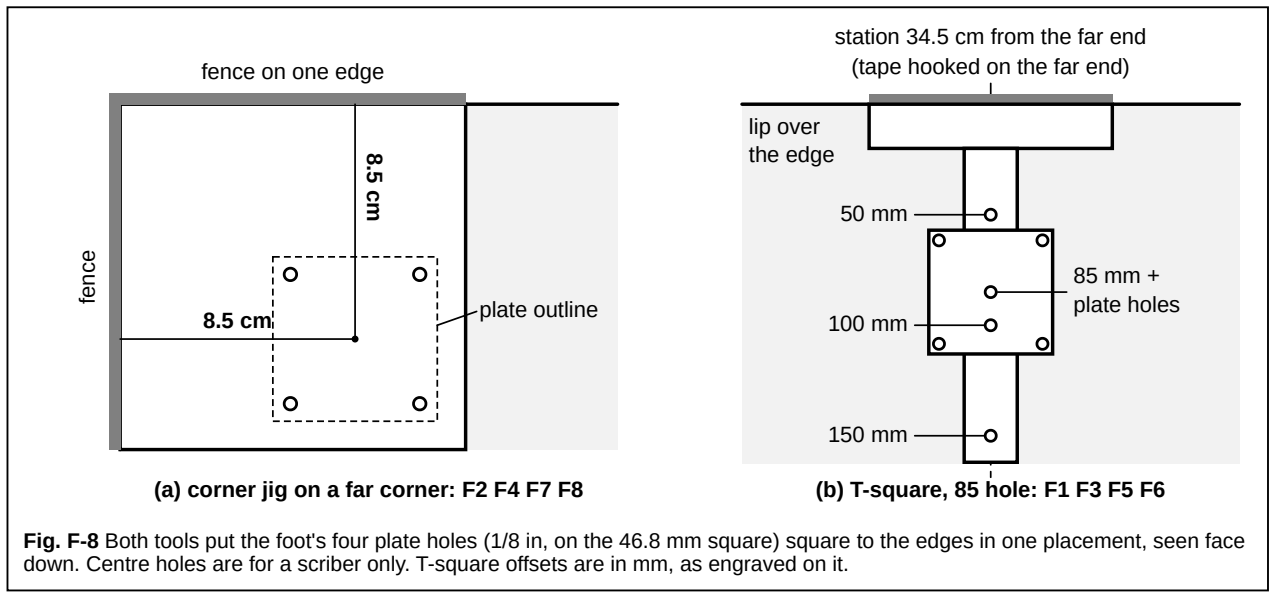
[picture p244: figure]
fence on one edge; fence; plate outline; station 34.5 cm from the far end (tape hooked on the far end); 85 mm + plate holes; lip over the edge; (b) T-square, 85 hole: F1 F3 F5 F6

(a) corner jig on a far corner: F2 F4 F7 F8

Fig. F-8 Both tools put the foot's four plate holes (1/8 in, on the 46.8 mm square) square to the edges in one placement, seen face down. Centre holes are for a scriber only. T-square offsets are in mm, as engraved on it.

3

Drop the tool back onto the four starts you made in chapter D, bit tip in each start, then lift it and finish each pilot 15 mm deep with the 1/8 in bit and the 15 LEG puck. Screw the plate of each gauged foot on with four H02 #8 × 5/8 pan heads (14 mm into the top), pad pointing away from the top. Eight plates, 32 screws.

# F · Steps 4 and 5: rails to the tops

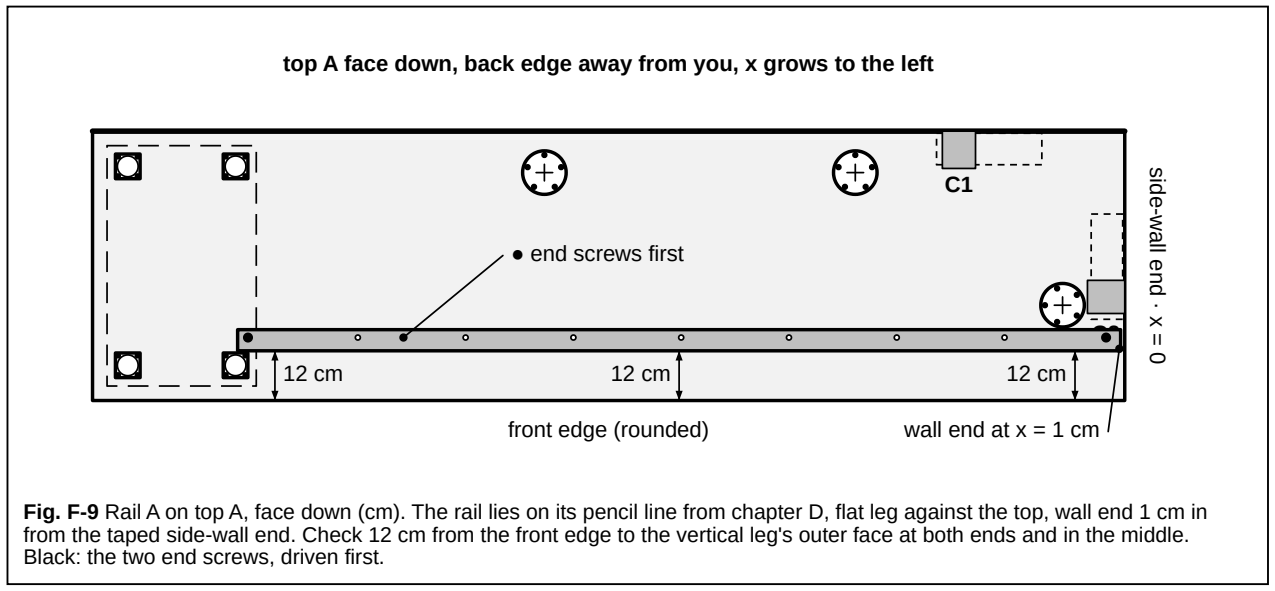
[picture p245: figure]
front edge (rounded); side-w; all end · x = 0; wall end at x = 1 cm; ● end screws first

top A face down, back edge away from you, x grows to the left

Fig. F-9 Rail A on top A, face down (cm). The rail lies on its pencil line from chapter D, flat leg against the top, wall end 1 cm in from the taped side-wall end. Check 12 cm from the front edge to the vertical leg's outer face at both ends and in the middle. Black: the two end screws, driven first.

25 RAIL puck

12 cm to the outer face

top, laminate down on the blanket

vertical leg

(a) rail A in section: pilot 1/8 in, 20 mm into the wood

12 cm

- holes 1, 2: chapter H
- holes 3–10: screw now

joint end

side-w

all edge

(b) rail B at top B's joint end

Fig. F-10 (a) Rail A in section, the top face down, so the vertical leg points up (mm, except the 12 cm). The 25 RAIL puck stands on the flat leg: the 1/8 in pilot goes 20 mm into the wood. (b) Rail B on top B, face down: stand at B's far end, joint end away from you, x grows to the left. Its corner end projects 12 cm past the joint end; holes 1 and 2 (open) lie in the projection.

4

Rail A. Clamp it on its line, flat leg against the top, wall end at x = 1 cm. Measure 12 cm from the front edge to the vertical leg's outer face at both ends and in the middle. Through each rail hole drill a 1/8 in pilot with the 25 RAIL puck standing on the flat leg (20 mm into the wood). Drive the two end screws first, re-check the 12 cm, then the rest: H03 #10 × 1 in Robertson on the #2 bit in the 3 in extension (the chuck would hit the vertical leg otherwise), until each head seats. Nine screws.

5

Rail B. Clamp it on its line with the corner end projecting 12 cm past top B's joint end. Pilot and screw holes 3 to 10 only, the same way: eight screws. Holes 1 and 2 go into top A in chapter H.

The printed rail end caps go on later, once the desk stands; they are handed: cap A fits rail A's far end, cap B fits rail A's wall end and rail B's far end. Rail B's corner end is bolted to rail A and takes no cap.

# F · Step 6: place the ALEX units

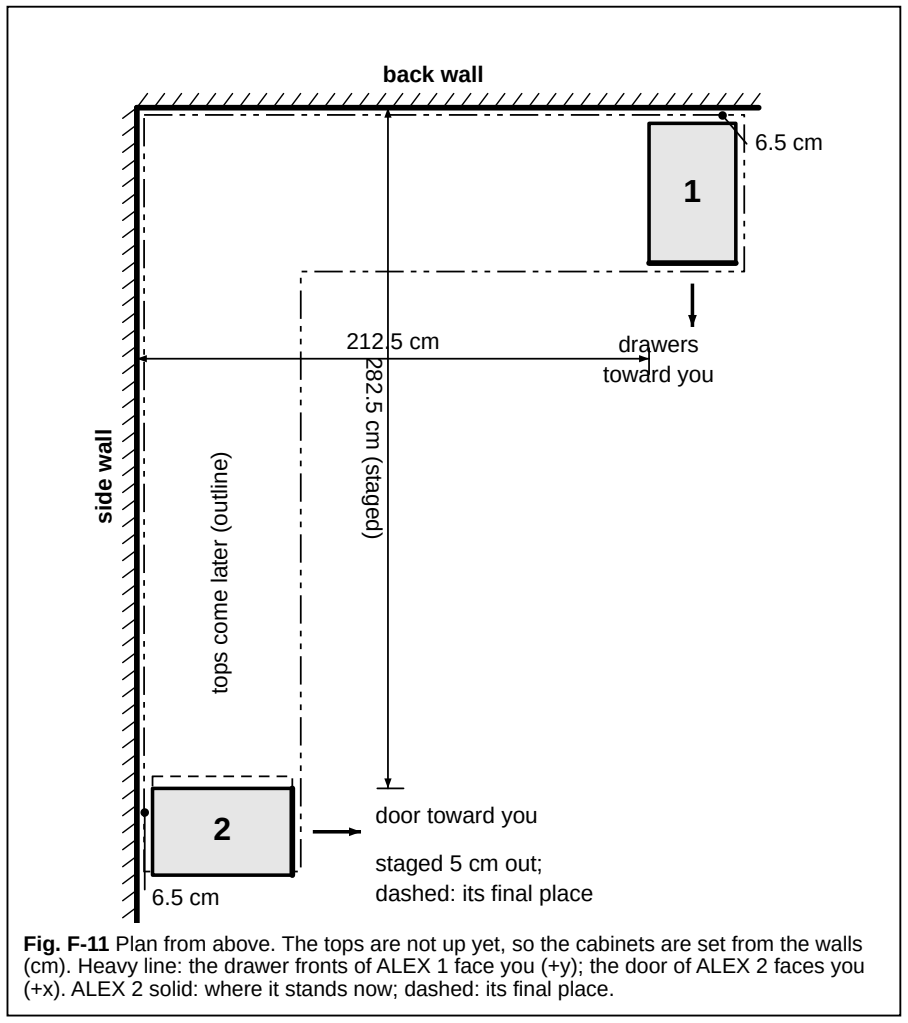
[picture p246: figure]
back wall; side w; all; tops come later (outline); drawers toward you; door toward you; staged 5 cm out; dashed: its final place; 282.5 cm (staged)

Fig. F-11 Plan from above. The tops are not up yet, so the cabinets are set from the walls (cm). Heavy line: the drawer fronts of ALEX 1 face you (+y); the door of ALEX 2 faces you (+x). ALEX 2 solid: where it stands now; dashed: its final place.

6

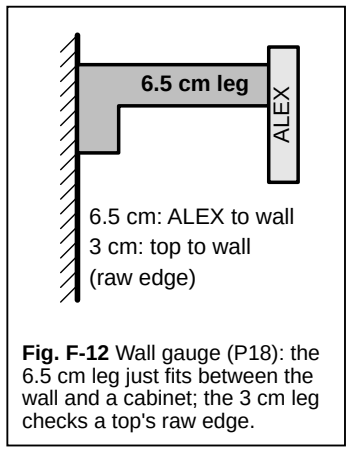
[picture p247: figure]
ALE; 6.5 cm leg; 6.5 cm: ALEX to wall 3 cm: top to wall (raw edge); Fig. F-12 Wall gauge (P18): the 6.5 cm leg just fits between the wall and a cabinet; the 3 cm leg checks a top's raw edge.

Stand ALEX 1 (P03) with its back 6.5 cm off the back wall and its near side 212.5 cm from the side wall, drawers toward you. Stand ALEX 2 (P04) with its side 6.5 cm off the side wall and, for now, its near end 282.5 cm from the back wall, door toward you: 5 cm short of its final 277.5 cm, so that rail B's corner end comes down clear of rail A's flat leg when top B is stood on it in chapter G. It is pushed home in chapter G. Painter's tape on the floor round each one saves guessing.

While it stands 5 cm out, top B's far end reaches 319 cm from the back wall: the side wall must run at least 322 cm. If it does not, stop and ask before chapter G.

No rings yet: they are fitted in chapter G by tracing the pads (a 50 mm pad in a 52 mm ring has only about 1 mm each side).

Optional ALEX feet (decided at the start of this chapter): fit them now, before the cabinets stand. Unscrew the stock feet, lay the unit on its back, hook the corner template over each bottom corner and use its inner three holes (r 14.5 mm). Pilot 5/64 in, 12 mm deep with the 12 ALEX puck; three #6 × 5/8 flat heads per foot down the wells, four feet per unit, all the same height.

!

MEASURE ON HARDWARE MEASURE ON HARDWARE
Before fitting ALEX feet, measure the ALEX bottom panel at an edge. 14 mm or more is fine: the 12 ALEX pilot is 12 mm deep and the #6 × 5/8 screw reaches only 9.9 mm into the panel through the foot's 6 mm roof, so 4 mm remains at 14 mm. Under 14 mm: do not fit them. The top panel measured 15.9 mm, so the bottom is likely similar and likely fine.

# F · The ring, and the check (used in chapter G)

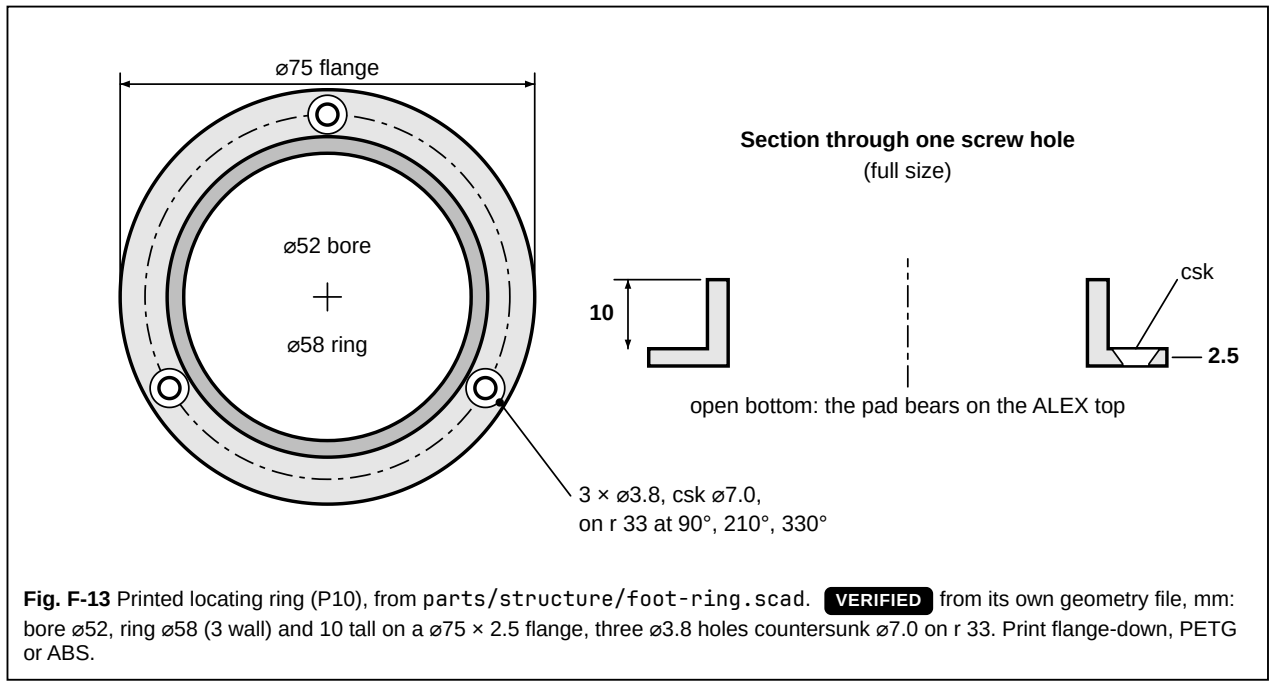
[picture p248: figure]
⌀52 bore; ⌀58 ring; 3 × ⌀3.8, csk ⌀7.0, on r 33 at 90°, 210°, 330°; ⌀75 flange; csk; Section through one screw hole (full size); or ABS.

open bottom: the pad bears on the ALEX top

Fig. F-13 Printed locating ring (P10), from parts/structure/foot-ring.scad. VERIFIED from its own geometry file, mm: bore ⌀52, ring ⌀58 (3 wall) and 10 tall on a ⌀75 × 2.5 flange, three ⌀3.8 holes countersunk ⌀7.0 on r 33. Print flange-down, PETG

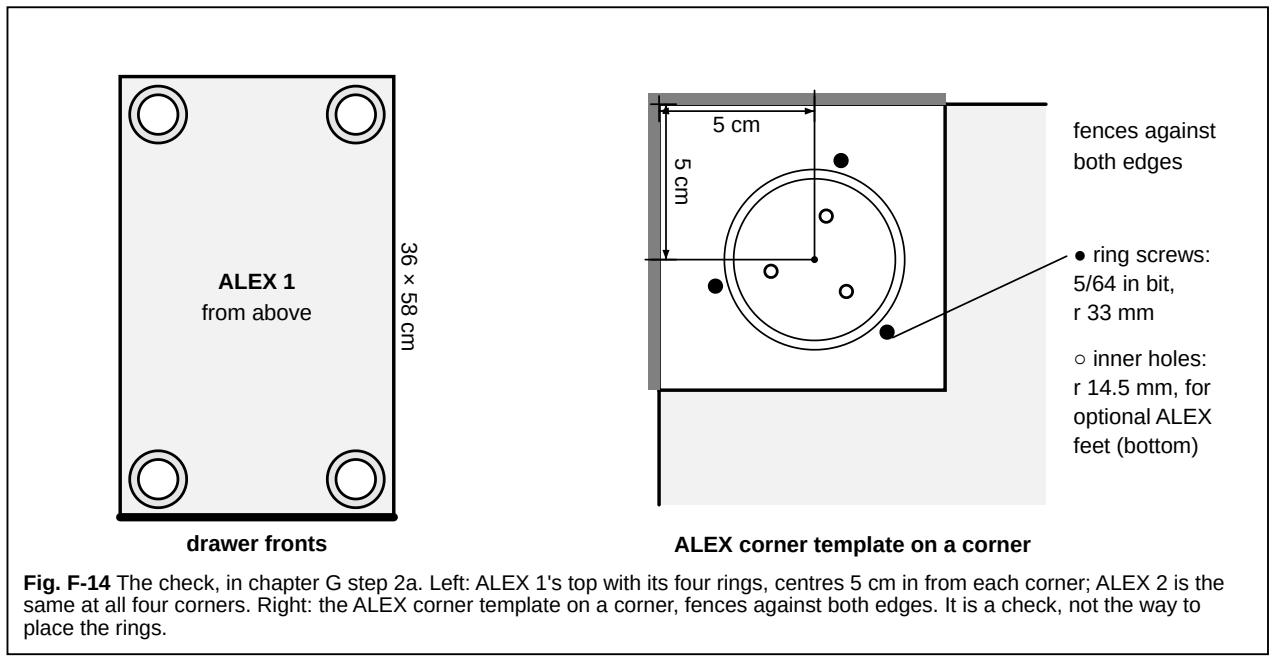
[picture p249: figure]
drawer fronts; ALEX 1 from above; fences against both edges; ● ring screws: 5/64 in bit, r 33 mm; ○ inner holes: r 14.5 mm, for optional ALEX feet (bottom); ALEX corner template on a corner; place the rings.

Fig. F-14 The check, in chapter G step 2a. Left: ALEX 1's top with its four rings, centres 5 cm in from each corner; ALEX 2 is the same at all four corners. Right: the ALEX corner template on a corner, fences against both edges. It is a check, not the way to

The check happens in chapter G step 2a: with the top lifted off and before any ring is drilled, lay the corner template on the bare corner. The pencil trace must sit inside the template's inner engraved circle (⌀52 mm) all round. If it does not, move the cabinet and trace again. The ring is round and is fitted turned so its own three holes are at any angle.

# F · Foot, pad and ring in section

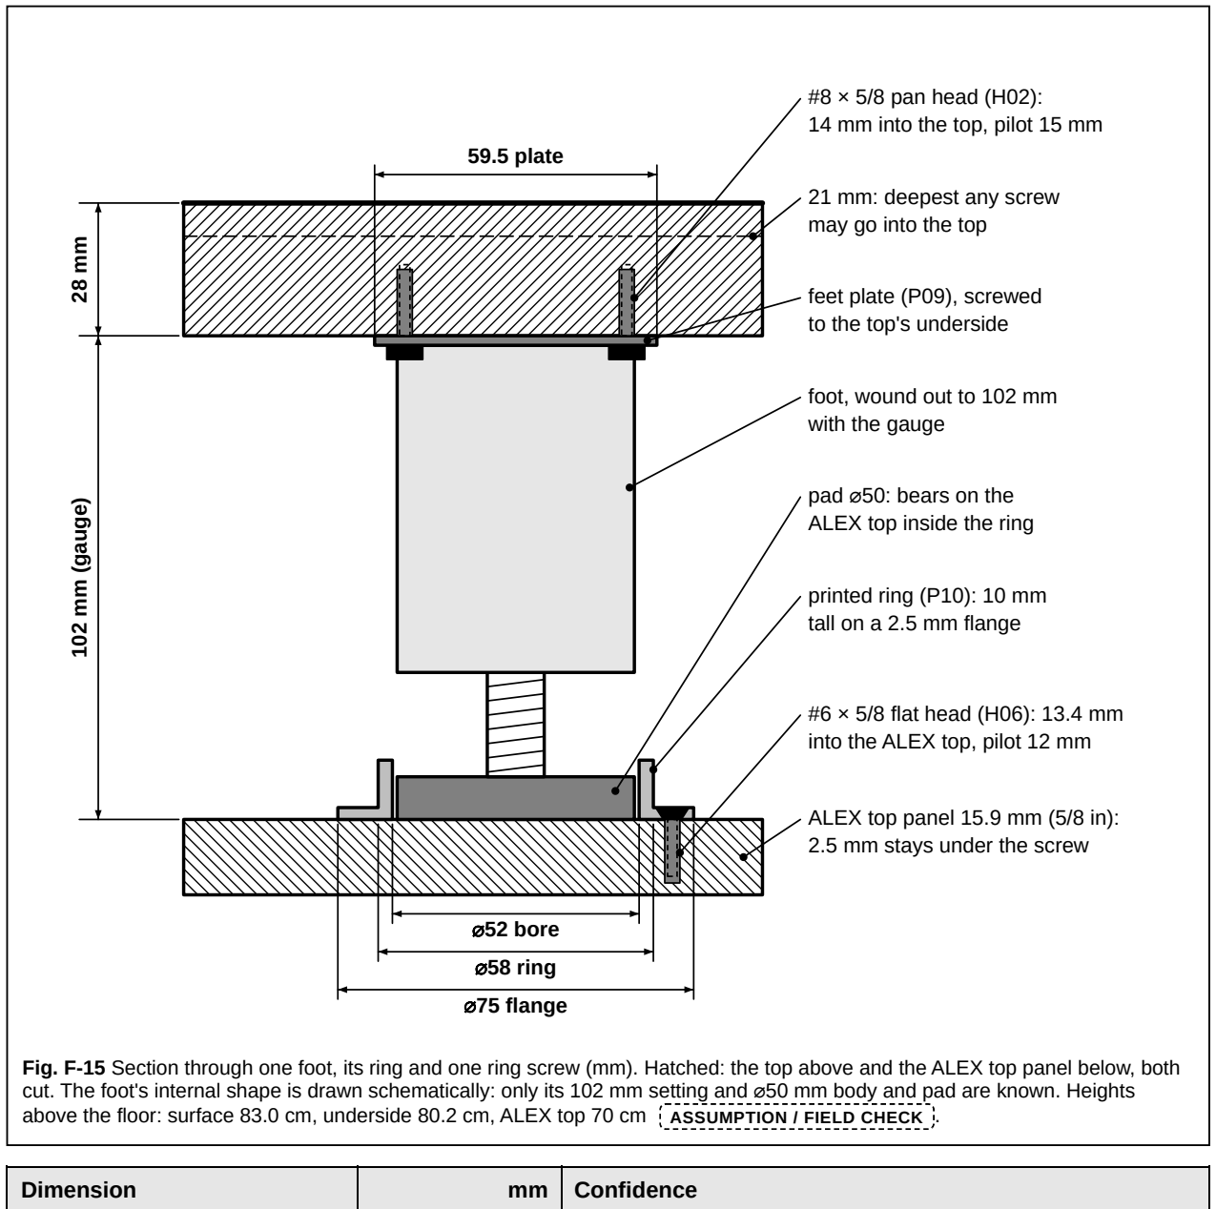
[picture p250: figure]
m (gauge) 28 m; ⌀52 bore; ⌀58 ring; ⌀75 flange; 59.5 plate; #8 × 5/8 pan head (H02): 14 mm into the top, pilot 15 mm; 21 mm: deepest any screw may go into the top; feet plate (P09), screwed to the top's underside; foot, wound out to 102 mm with the gauge; printed ring (P10): 10 mm tall on a 2.5 mm flange; pad ⌀50: bears on the ALEX top inside the ring; #6 × 5/8 flat head (H06): 13.4 mm into the ALEX top, pilot 12 mm; ALEX top panel 15.9 mm (5/8 in): 2.5 mm stays under the screw; Dimension; Confidence

Fig. F-15 Section through one foot, its ring and one ring screw (mm). Hatched: the top above and the ALEX top panel below, both cut. The foot's internal shape is drawn schematically: only its 102 mm setting and ⌀50 mm body and pad are known. Heights above the floor: surface 83.0 cm, underside 80.2 cm, ALEX top 70 cm ASSUMPTION / FIELD CHECK .

Top thickness | 28 | MEASURE ON HARDWARE expect 28 mm
Foot, plate face to pad (gauge) | 102 | SOURCE-DEFINED
Feet plate, hole spacing | 59.5 / 46.8 | VERIFIED
Pad diameter | 50 | MEASURE ON HARDWARE before relying on the 52 mm bore
Ring bore / ring / flange | 52 / 58 / 75 × 2.5 | VERIFIED geometry file
ALEX top panel thickness | 15.9 | VERIFIED 5/8 in, 23 Oct 2026; 2.5 mm under each screw

# F · Load path

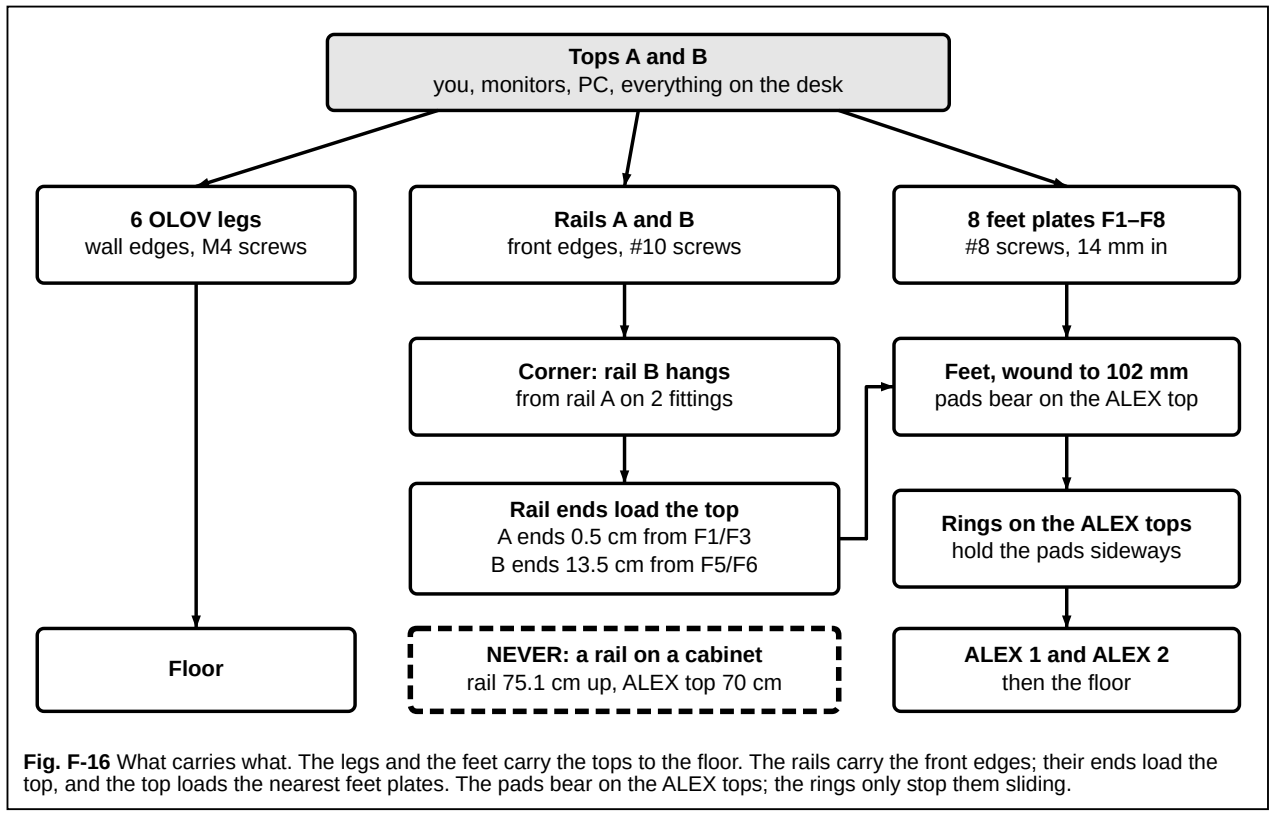
[picture p251: figure]
Tops A and B; 6 OLOV legs wall edges, M4 screws; Rails A and B front edges, #10 screws; 8 feet plates F1–F8 #8 screws, 14 mm in; Corner: rail B hangs from rail A on 2 fittings; Rail ends load the top A ends 0.5 cm from F1/F3 B ends 13.5 cm from F5/F6; Feet, wound to 102 mm pads bear on the ALEX top; Rings on the ALEX tops hold the pads sideways; ALEX 1 and ALEX 2 then the floor; Floor; NEVER: a rail on a cabinet rail 75.1 cm up, ALEX top 70 cm

you, monitors, PC, everything on the desk

Fig. F-16 What carries what. The legs and the feet carry the tops to the floor. The rails carry the front edges; their ends load the top, and the top loads the nearest feet plates. The pads bear on the ALEX tops; the rings only stop them sliding.

F3 | F4

rail end

rail A

ALEX 1 below

(a) rail A's far end, plan rail end x 214 cm
F1/F3 centres x 214.5 cm

F6

### 13.5 cm

rail B

ALEX 2

front edge

(b) rail B's end, plan (front edge at the top) rail end y 266 cm · ALEX 2 face y 274.5 cm F5/F6 centres y 279.5 cm

Fig. F-17 Where the rails stop (cm from the datum; front edges at the bottom). (a) Rail A ends at x 214 cm, 0.5 cm short of the F1/F3 centres at 214.5 cm, beside F3's plate. (b) Seen from above, turned a quarter turn: front edge at the top, y grows to the right. Rail B ends at y 266 cm; the top bridges the 13.5 cm to F5/F6.

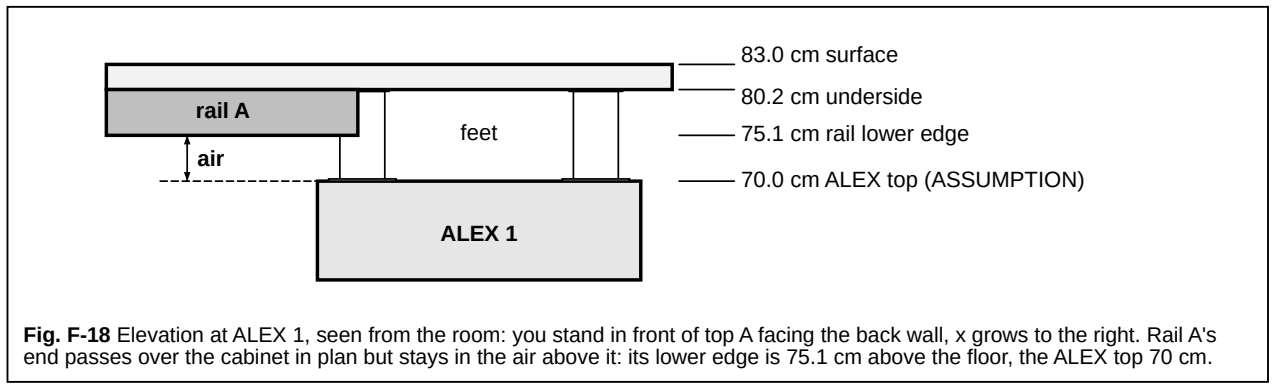
[picture p252: figure]
83.0 cm surface; 80.2 cm underside; 75.1 cm rail lower edge; 70.0 cm ALEX top (ASSUMPTION); air; rail A; feet; ALEX 1

Fig. F-18 Elevation at ALEX 1, seen from the room: you stand in front of top A facing the back wall, x grows to the right. Rail A's end passes over the cabinet in plan but stays in the air above it: its lower edge is 75.1 cm above the floor, the ALEX top 70 cm.

# F · The assembled underside

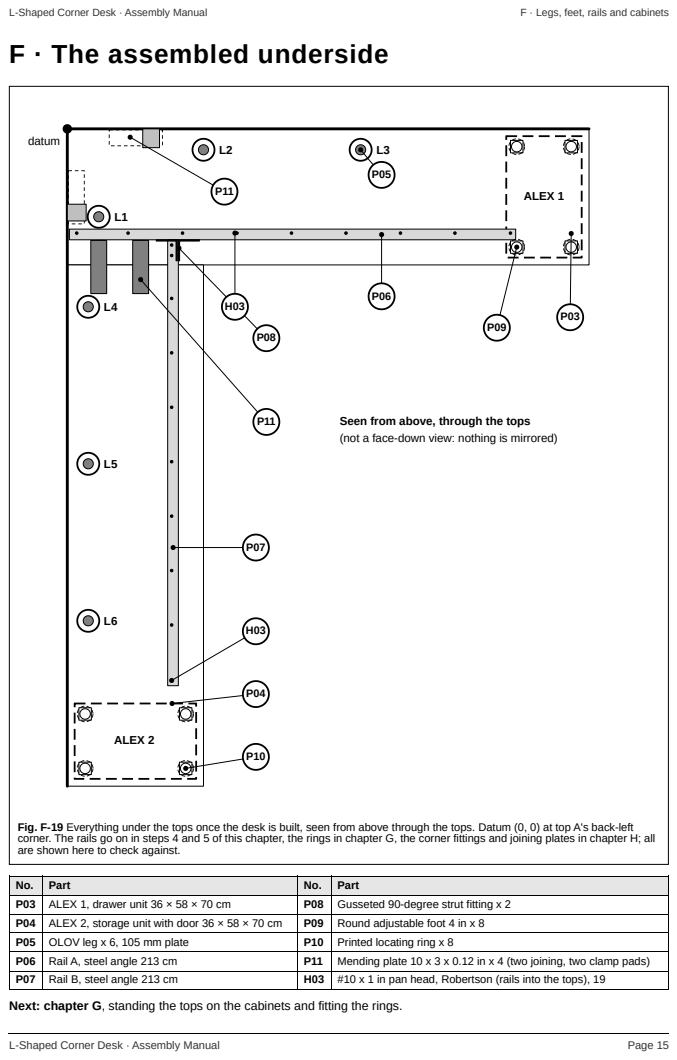
[picture p253: page 15]

Seen from above, through the tops
(not a face-down view: nothing is mirrored)

Fig. F-19 Everything under the tops once the desk is built, seen from above through the tops. Datum (0, 0) at top A's back-left
corner. The rails go on in steps 4 and 5 of this chapter, the rings in chapter G, the corner fittings and joining plates in chapter H; all
are shown here to check against.

No. | Part | No. | Part
P03 | ALEX 1, drawer unit 36 × 58 × 70 cm | P08 | Gusseted 90-degree strut fitting x 2
P04 | ALEX 2, storage unit with door 36 × 58 × 70 cm | P09 | Round adjustable foot 4 in x 8
P05 | OLOV leg x 6, 105 mm plate | P10 | Printed locating ring x 8
P06 | Rail A, steel angle 213 cm | P11 | Mending plate 10 x 3 x 0.12 in x 4 (two joining, two clamp pads)
P07 | Rail B, steel angle 213 cm | H03 | #10 x 1 in pan head, Robertson (rails into the tops), 19

Next: chapter G, standing the tops on the cabinets and fitting the rings.
