scotthowson/desk-setup/manual/build/manual-steel.pdf

# E · Steel rail fabrication and drilling

All steel work happens on the bench, before either rail goes near a top. Under the desk you only drive screws and bolts; you never drill steel there. Two identical lengths of 2 × 2 × 3/16 in hot-rolled angle arrive; either can be rail A. Tape readings in cm, caliper and drill sizes in mm.

!

MEASURE BEFORE MARKING OR DRILLING MEASURE ON HARDWARE
1 · Tape each rail from end to end and write the length on the tape label. Design length 213 cm; bought as 84 in (2133.6 mm, so about 213.4 cm). If a rail is under 213 cm, stop and check before drilling.
2 · Calipers on each angle: legs 50.8 mm, thickness 4.76 mm (the docs expect about 4.8 mm).
3 · Every station is measured from the labelled end: rail A's wall end, rail B's corner end. The far end carries any extra length. Never centre the hole pattern on the bar and never shift a hole to share out the extra.

1

Check the datum labels. The rail ends were tape-labelled in chapter D: check them (RAIL A · WALL END, RAIL B · CORNER END). Never add a second label to the other end. Measure both rails from those ends (Fig. E-1). File both cut ends of each rail smooth.

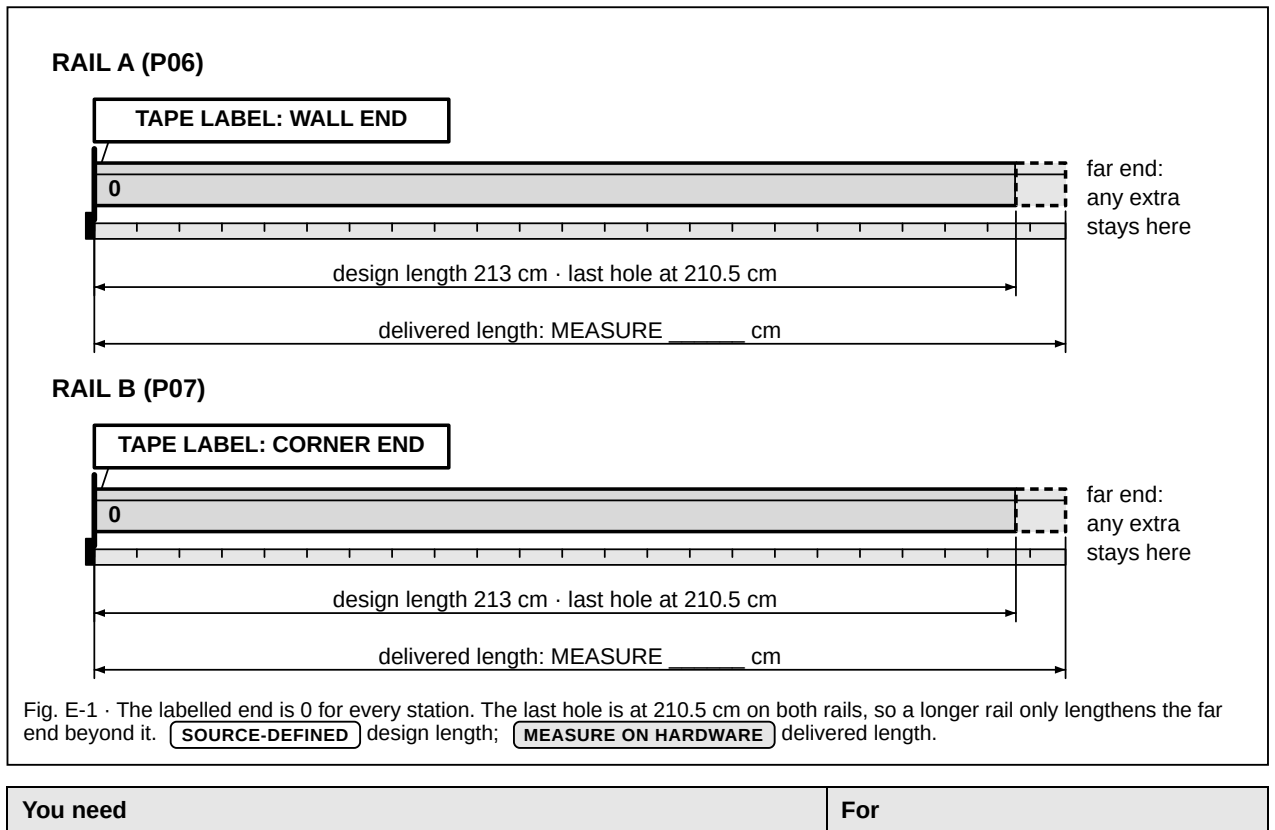
[picture p315: figure]
RAIL A (P06); TAPE LABEL: WALL END; delivered length: MEASURE ______ cm; far end: any extra stays here; RAIL B (P07); TAPE LABEL: CORNER END; You need; For

design length 213 cm · last hole at 210.5 cm

design length 213 cm · last hole at 210.5 cm

Fig. E-1 · The labelled end is 0 for every station. The last hole is at 210.5 cm on both rails, so a longer rail only lengthens the far end beyond it. SOURCE-DEFINED design length; MEASURE ON HARDWARE delivered length.

P06 rail A, P07 rail B; one P08 fitting as the template | the work pieces
P18 printed tools: edge T-square, rail marking gauge, rail drill jig (PETG), 2 fitting slot plugs | stations, the 19 and 29 lines, pilots, bolt-hole transfer
Bits 1/8, 7/32 and 7/16 in (the 7/16 cobalt), cutting oil, flat file, 2 clamps, tape, combination square, pencil | drilling and deburring; a drill press if you have one
Acetone or mineral spirits, 120 grit, flat black enamel | finish (step 9)
L-Shaped Corner Desk · Assembly Manual | E · Steel rails
L-Shaped Corner Desk · Assembly Manual | Page 1

# Contents

E · Steel rail fabrication and drilling | 1

L-Shaped Corner Desk · Assembly Manual

L-Shaped Corner Desk · Assembly Manual | 2

## Which way up: the section and the two lines

TOP (P01 / P02), 28 mm; free edge; screw hole ⌀5.56 (7/32 in); bolt hole ⌀11.1 (7/16 in); inner face; outer face; heel (outside of the bend); FLAT LEG lies against the top's underside; VERTICAL LEG hangs down, toward you; outer face at y = 53 cm (rail A) x = 53 cm (rail B); BACK: wall side (3 cm gap); FRONT: you; (65 cm). Section dimensions in mm.; Item; What it means; Confidence

Fig. E-2 · Rail A seen end-on from its wall end, looking toward the far end: the back wall is on your left, the front edge on your right; it hangs under top A as drawn (rail B is the same section turned 90°). Datum: top A's back-left corner, x along the back wall, y along the side wall. The vertical leg's outer face is at y = 53 cm on rail A and x = 53 cm on rail B, 12 cm back from the front edge

Section | 50.8 × 50.8 × 4.76 | 2 × 2 × 3/16 in hot-rolled angle | SOURCE-DEFINED MEASURE ON HARDWARE thickness
Flat leg | | lies against the top's underside; its free edge points to the wall | SOURCE-DEFINED
Vertical leg | | hangs down on the side nearer you; outer face y = 53 cm (A), x = 53 cm (B) | SOURCE-DEFINED
Screw line | 19 | from the flat leg's free edge; centres of the ⌀5.56 (7/32 in) screw holes | SOURCE-DEFINED
Bolt line | 29 | below the heel (the top's underside); centres of the ⌀11.1 (7/16 in) bolt holes | SOURCE-DEFINED
Fitting slots | 21 × 12 | two per P08 leg, centres 29.15 and 78.45 from the heel; legs 100.5 × 41, 5 thick (all mm) | VERIFIED 23 Oct 2026

Bench set-up. Clamp the rail with the flat leg's face up and the vertical leg hanging down over the bench edge. That is how it is marked and how the flat-leg holes are drilled. For the vertical leg (steps 6 and 7) turn it so the vertical leg's outer face is up and the flat leg hangs over the edge.

The two fabrication drawings that follow are full pages, turned sideways: turn the booklet a quarter turn clockwise to read them. Every hole is given from the labelled end, never from the hole before: the drawings carry mm ordinates, the hole table beside each drawing gives the same stations in cm for the tape.

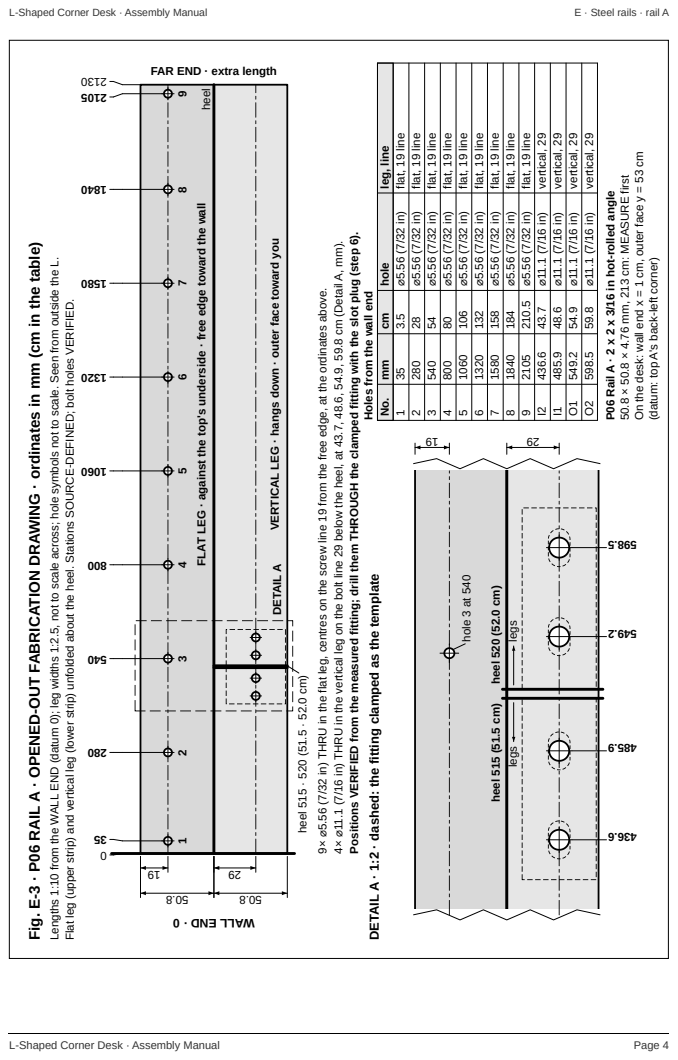
[picture p316: page 4]
Fig. E-3 · P; AIL; RIC; ATIO; AWIN; G · ordin; ate; ble); EFIN; D; bolt holes V; RIFIE; TAIL; ard the w; all; TIC; G · hangs do; ard y; heel; heel 515 · 520 (51.5 · 52.0 cm); ositions V; D fro; H the cla; e fittin; cla; plate; hole 3 at 540; legs; heel 515 (51.5 cm); heel 520 (52.0 cm); oles fro; m the w; all end; I2 436.6 43.7 ⌀11.1 (7/16 in) vertical, 29; I1 485.9 48.6 ⌀11.1 (7/16 in) vertical, 29; O1 549.2 54.9 ⌀11.1 (7/16 in) vertical, 29; O2 598.5 59.8 ⌀11.1 (7/16 in) vertical, 29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

FAR END · extra length

1 35 3.5 ⌀5.56 (7/32 in) flat, 19 line

2 280 28 ⌀5.56 (7/32 in) flat, 19 line

3 540 54 ⌀5.56 (7/32 in) flat, 19 line

4 800 80 ⌀5.56 (7/32 in) flat, 19 line

5 1060 106 ⌀5.56 (7/32 in) flat, 19 line

6 1320 132 ⌀5.56 (7/32 in) flat, 19 line

7 1580 158 ⌀5.56 (7/32 in) flat, 19 line

8 1840 184 ⌀5.56 (7/32 in) flat, 19 line

9 2105 210.5 ⌀5.56 (7/32 in) flat, 19 line

m cm hole leg, line

all end x = 1 cm, outer face y = 53 cm

ail A · 2 x 2 x 3/16 in hot-rolled angle

mped fitting with the slot plug (step 6).

D (datum 0); leg widths 1:2.5, not to scale across; hole symbols not to scale. Seen from outside the L.

U in the vertical leg on the bolt line 29 below the heel, at 43.7, 48.6, 54.9, 59.8 cm (Detail A, m

(datum: top A's back-left corner)

G · against the top's underside · free edge to

wn · outer face to

U in the flat leg, centres on the screw line 19 from the free edge, at the ordinates above.

On the desk: w

Flat leg (upper strip) and vertical leg (lower strip) unfolded about the heel. Stations S

m the measured fitting; drill them

Lengths 1:10 from the WALL E

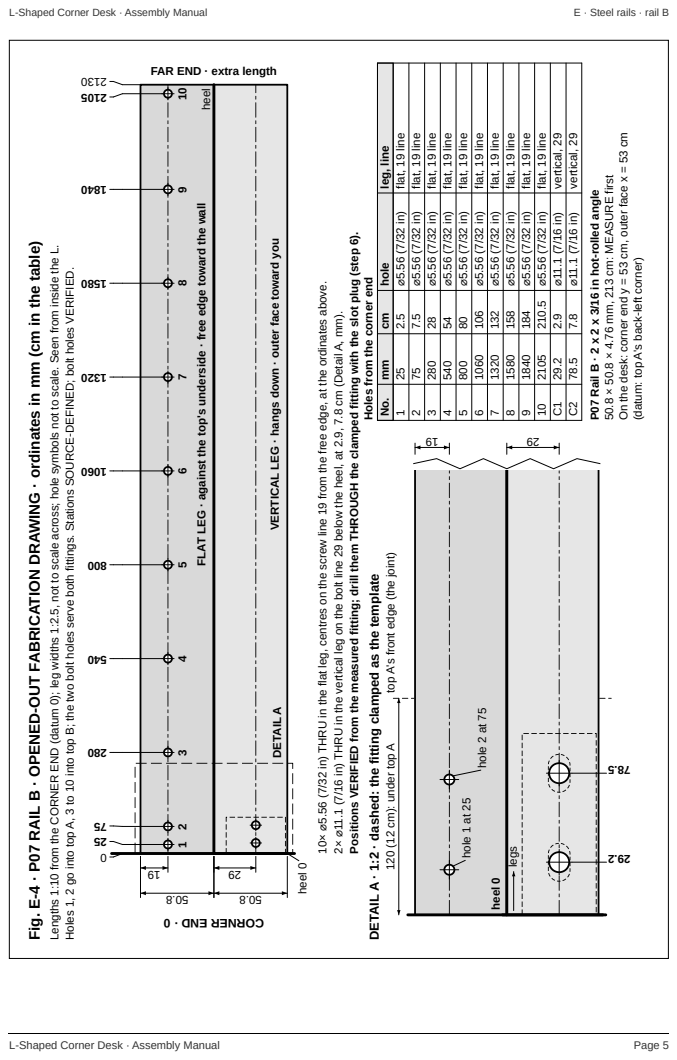
[picture p317: page 5]
Fig. E-4 · P; AIL; RIC; ATIO; AWIN; G · ordin; ate; ble); EFIN; D; bolt holes V; RIFIE; TAIL; ard the w; all; TIC; G · hangs do; ard y; heel; heel 0; ositions V; D fro; H the cla; e fittin; cla; plate; hole 1 at 25; hole 2 at 75; legs; oles fro; C1 29.2 2.9 ⌀11.1 (7/16 in) vertical, 29; C2 78.5 7.8 ⌀11.1 (7/16 in) vertical, 29; E first; L-Shaped Corner Desk · Assembly Manual; E · Steel rails · rail B

FAR END · extra length

On the desk: corner end y = 53 cm, outer face x = 53 cm

1 25 2.5 ⌀5.56 (7/32 in) flat, 19 line

2 75 7.5 ⌀5.56 (7/32 in) flat, 19 line

3 280 28 ⌀5.56 (7/32 in) flat, 19 line

4 540 54 ⌀5.56 (7/32 in) flat, 19 line

5 800 80 ⌀5.56 (7/32 in) flat, 19 line

6 1060 106 ⌀5.56 (7/32 in) flat, 19 line

7 1320 132 ⌀5.56 (7/32 in) flat, 19 line

8 1580 158 ⌀5.56 (7/32 in) flat, 19 line

9 1840 184 ⌀5.56 (7/32 in) flat, 19 line

10 2105 210.5 ⌀5.56 (7/32 in) flat, 19 line

m cm hole leg, line

ail B · 2 x 2 x 3/16 in hot-rolled angle

mped fitting with the slot plug (step 6).

D (datum 0); leg widths 1:2.5, not to scale across; hole symbols not to scale. Seen from inside the L.

(datum: top A's back-left corner)

G · against the top's underside · free edge to

m the corner end

wn · outer face to

U in the flat leg, centres on the screw line 19 from the free edge, at the ordinates above.

U in the vertical leg on the bolt line 29 below the heel, at 2.9, 7.8 cm (Detail A, m

Holes 1, 2 go into top A, 3 to 10 into top B; the two bolt holes serve both fittings. Stations S

m the measured fitting; drill them

120 (12 cm): under top A top A's front edge (the joint)

Lengths 1:10 from the C

2

Mark the stations. Hook the tape over the labelled end and tick every station on the flat leg from that one hook: rail A 3.5, 28, 54, 80, 106, 132, 158, 184, 210.5 cm; rail B 2.5, 7.5, 28, 54, 80, 106, 132, 158, 184, 210.5 cm. Square each tick across the leg along the T-square's blade, its lip hooked over the heel edge.

Heel marks. On rail A, turn the vertical leg's outer face up and scribe (do not pencil) the heel positions at 51.5 cm and 52.0 cm from the wall end, squared across the leg. On rail B scribe a 0 on the vertical leg's outer face at the corner end. Scribed lines survive the paint; pencil does not.

free edge; heel; labelled end (0); tick the station on the tape; pencil along the blade's edge

T-square (P18): lip over the heel edge, blade across the leg

Hook the tape over the labelled end once and tick every station from that one hook; never measure from one hole to the next.

Plan: flat leg face up, vertical leg over the bench edge, labelled end at the left.

Fig. E-5 · One hook, every station. The station line only has to cross the leg; the jig finds the 19 mm.

3

Pencil the two lines with the rail marking gauge, full length. Screw line: lip over the flat leg's free edge, pencil in the 19 notch, slide. Bolt line: gauge on the vertical leg's outer face, lip over the heel, pencil in the 29 notch, slide. The bolt line is only a check: the fitting's holes must sit on it in step 6.

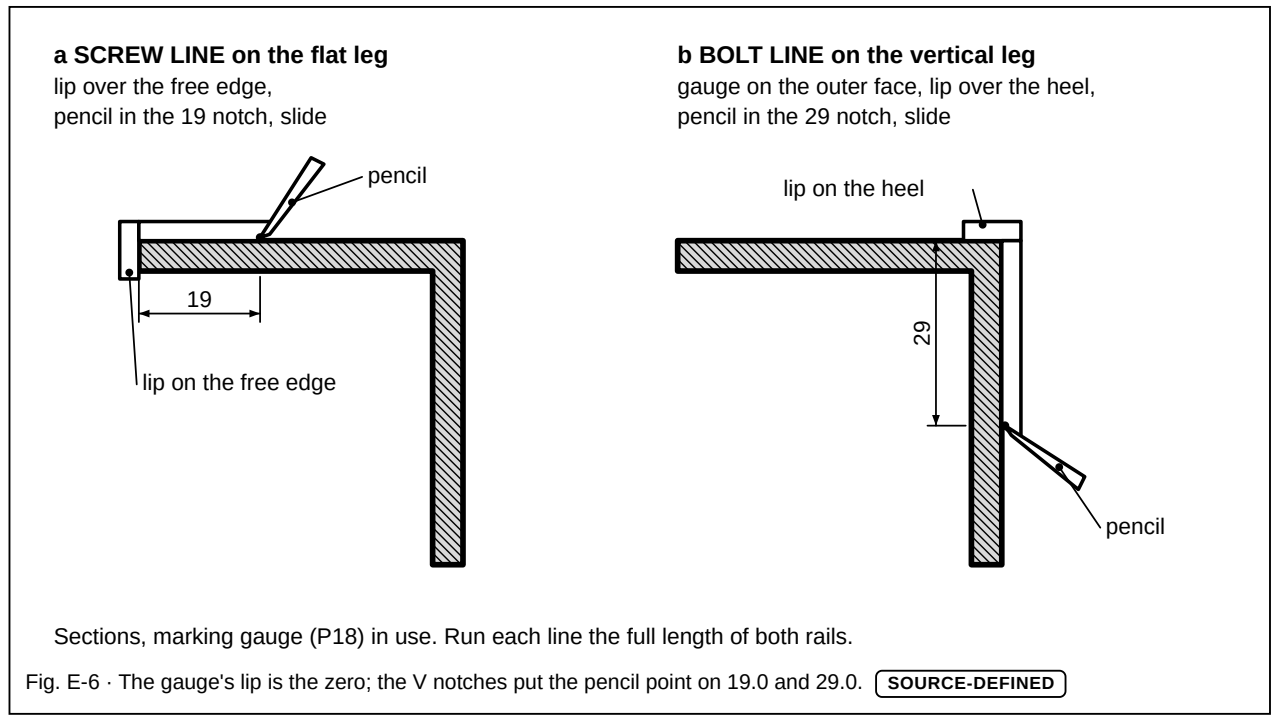
[picture p318: figure]
a SCREW LINE on the flat leg lip over the free edge, pencil in the 19 notch, slide; lip on the free edge; pencil; b BOLT LINE on the vertical leg; pencil in the 29 notch, slide; lip on the heel

gauge on the outer face, lip over the heel,

Sections, marking gauge (P18) in use. Run each line the full length of both rails.

Fig. E-6 · The gauge's lip is the zero; the V notches put the pencil point on 19.0 and 29.0. SOURCE-DEFINED

4

Pilot the screw holes through the drill jig. Jig lip down over the flat leg's free edge, sight grooves on the station line, hold it down and drill 1/8 in through its bore: square, on the 19 mm line, no punch needed. All 19 stations (9 on rail A, 10 on rail B). Use a drill press if you have one.

5

Open and deburr. Jig off. Open every pilot to ⌀5.56 (7/32 in) at low speed with a drop of oil on each; the bit follows the pilot. Deburr both faces with the file or a larger bit turned by hand.

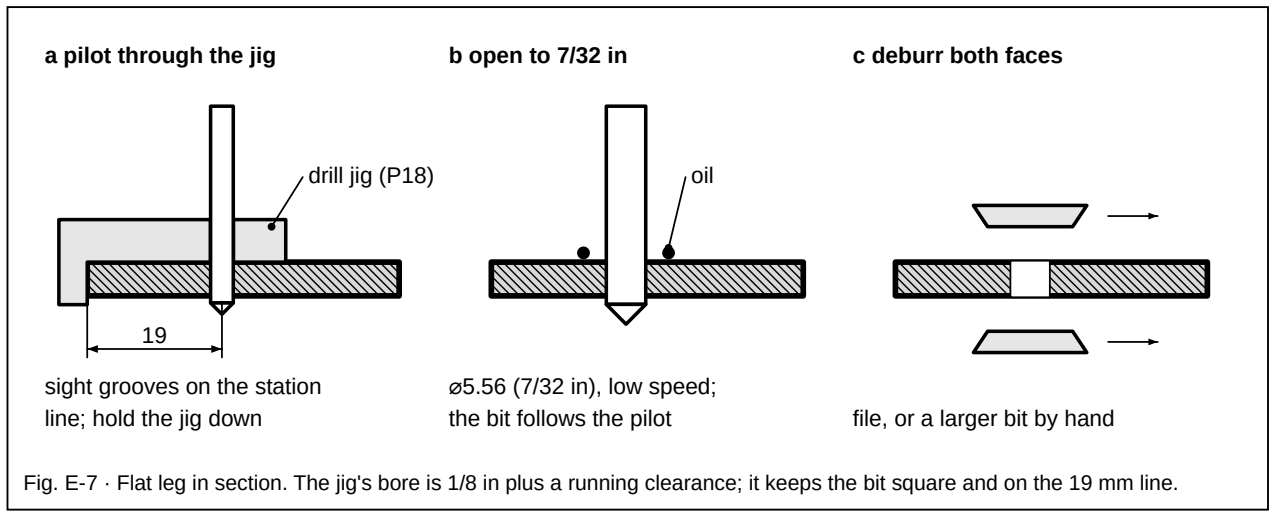
[picture p319: figure]
a pilot through the jig; drill jig (P18); sight grooves on the station line; hold the jig down; b open to 7/32 in; oil; ⌀5.56 (7/32 in), low speed; the bit follows the pilot; c deburr both faces; file, or a larger bit by hand

Fig. E-7 · Flat leg in section. The jig's bore is 1/8 in plus a running clearance; it keeps the bit square and on the 19 mm line.

!

THE FITTING IS THE TEMPLATE VERIFIED
The fittings were measured on 23 Oct 2026: legs 100.5 × 41, two 21 × 12 slots per leg with centres 29.15 and 78.45 mm from the heel. That puts the six bolt holes at the positions below. Even so, do not lay them out with the tape: clamp the fitting on its heel mark and drill through it with the printed slot plug (steps 6 and 7), so each hole lands on its slot's centre. Check first that a plug drops into each slot without rattle. The heel of a fitting is the outside of its bend.
Clamp the fitting | Heel on | Legs toward | Holes it makes (cm from the labelled end)
Rail A, outside fitting | the 52.0 cm mark | the far end | O1 54.9, O2 59.8
Rail A, inside fitting | the 51.5 cm mark | the wall end | I1 48.6, I2 43.7
Rail B, one fitting (both share the holes) | the corner end itself (0) | the far end | C1 2.9, C2 7.8

Heel stations SOURCE-DEFINED ; hole positions from the measured slot centres VERIFIED . Both fittings are identical, so holes copied from one fit the other.

6

Clamp the fitting and pilot through the plugs. Rail with the vertical leg's outer face up. Clamp one fitting to the vertical leg with its heel exactly on the mark and its holes centred on the 29 mm line, legs the way Fig. E-8 shows. Drop a slot plug into each slot and drill the 1/8 in pilot through each plug's bore into the rail. Repeat for each of the three placements.

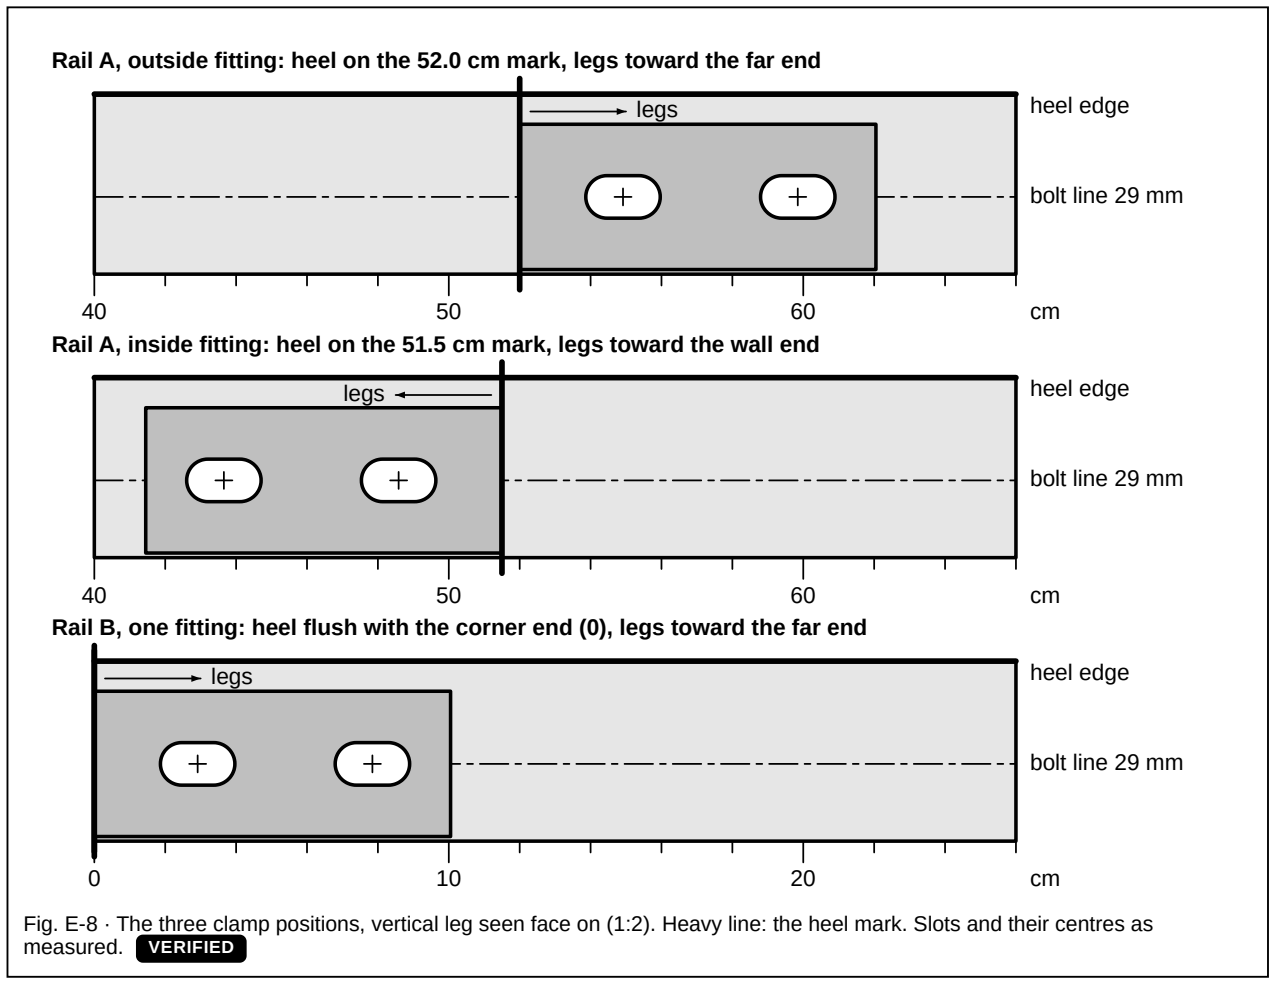
[picture p320: figure]
heel edge; bolt line 29 mm; legs; measured. VERIFIED

Rail A, outside fitting: heel on the 52.0 cm mark, legs toward the far end

Rail A, inside fitting: heel on the 51.5 cm mark, legs toward the wall end

Rail B, one fitting: heel flush with the corner end (0), legs toward the far end

Fig. E-8 · The three clamp positions, vertical leg seen face on (1:2). Heavy line: the heel mark. Slots and their centres as

7

Fitting off, open to ⌀11.1 (7/16 in). Cobalt bit, slow, oil on each. The bit follows the pilot, so the hole lands on the slot's centre, not anywhere along its 21 mm. Deburr. Six holes: four in rail A, two in rail B.

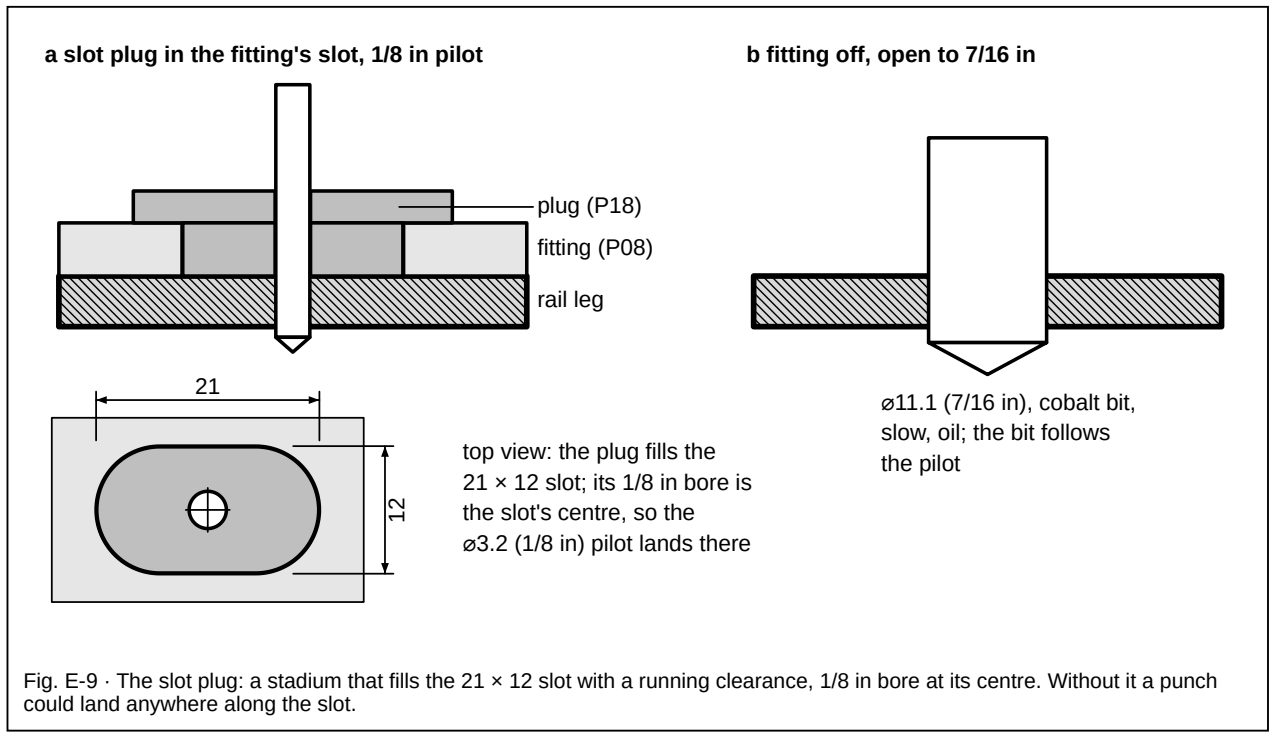
[picture p321: figure]
plug (P18); fitting (P08); rail leg; top view: the plug fills the 21 × 12 slot; its 1/8 in bore is the slot's centre, so the ⌀3.2 (1/8 in) pilot lands there; b fitting off, open to 7/16 in; ⌀11.1 (7/16 in), cobalt bit, slow, oil; the bit follows the pilot; could land anywhere along the slot.

a slot plug in the fitting's slot, 1/8 in pilot

Fig. E-9 · The slot plug: a stadium that fills the 21 × 12 slot with a running clearance, 1/8 in bore at its centre. Without it a punch

!

WHY THE HOLES ON BOTH RAILS MEET WITHOUT A JIG VERIFIED
1 · The same fitting is the template for all three placements: rail A heel on the 52.0 cm mark legs toward the far end, rail A heel on the 51.5 cm mark legs toward the wall end, rail B heel flush with the corner end.
2 · The slot plug puts every pilot on a slot centre, 29.15 and 78.45 mm from wherever the heel sat. So when a fitting is bolted on, its slots sit over the holes it made.
3 · Both fittings are identical, so the inside one fits the holes the outside one made.
4 · What makes the two rails meet at the corner is rail B's end against rail A's vertical leg with B's outer face on the 52.0 cm mark. The floor test (step 8) proves it before painting: every bolt must slide in by hand. If one won't, open that rail hole with a round file now, never under the desk.
The rail drill jig is only for the 19-line screw holes, on either rail; it plays no part in the bolt holes.

### 1 One fitting, three placements. Rail A, vertical leg:

heel on 51.5 cm, legs → wall end heel on 52.0 cm, legs → far end

slot centres
29.15 and
78.45 mm from
the heel

Rail B, vertical leg:

heel flush with the corner end, legs → far end

each pilot goes through
the slot plug: dead on
the slot centre

### 2 Bolted: each slot sits over the hole it made (rail A from the knee space, rail B cut)

rail A

slots (grey)
over the holes

rail B's end on A, outer face on the 52.0 cm mark

inside fitting | outside fitting

Fig. E-10 · Top: the one fitting in its three placements, heel marks heavy, slots dashed. Bottom: bolted at the corner, each slot over the hole it made. VERIFIED slot centres; SOURCE-DEFINED heel marks.

8

Floor test. Lay both rails upside down on the floor, flat legs down, vertical legs up. Butt rail B's corner end against the outer face of rail A's vertical leg so that rail B's outer face is on rail A's 52.0 cm mark; rail B's flat leg then covers 46.9 to 52.0 cm on rail A's tape. Bolt both fittings on loosely: the outside one on the far-end side of rail B, the inside one on the wall side. Every bolt must slide in by hand. Check the corner with the combination square. If a bolt will not go in, open that hole with a round file now, not under the desk.

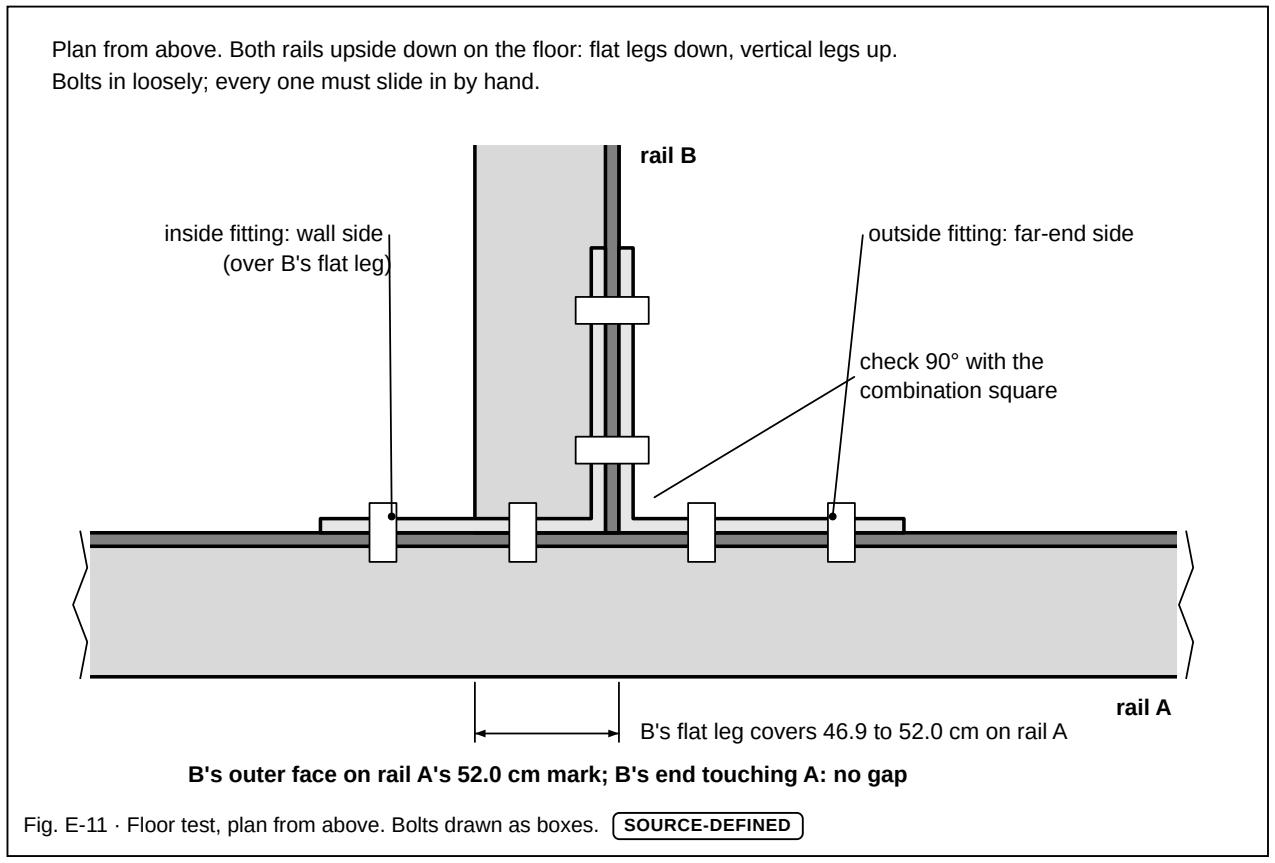
[picture p322: figure]
inside fitting: wall side; outside fitting: far-end side; (over B's flat leg); rail B; check 90° with the combination square; rail A

Plan from above. Both rails upside down on the floor: flat legs down, vertical legs up.
Bolts in loosely; every one must slide in by hand.

B's flat leg covers 46.9 to 52.0 cm on rail A B's outer face on rail A's 52.0 cm mark; B's end touching A: no gap

Fig. E-11 · Floor test, plan from above. Bolts drawn as boxes. SOURCE-DEFINED

9

Finish. Take the fittings off. Degrease both rails, scuff with 120 grit, two coats of flat black enamel, 24 h to cure. The holes need no masking.

Re-mark after painting. Put a strip of tape on rail A's vertical leg over the scribed 52.0 cm line and mark the line and 52.0 on it. Tape and re-label both reference ends again: RAIL A · WALL END, RAIL B · CORNER END. Chapter H checks rail B's outer face against this 52.0 cm mark.

The rails are now ready for the tops: rail A goes on top A with its wall end at x = 1 cm (1 cm in from the taped end), rail B on top B with its corner end projecting 12 cm past the joint end. The corner is bolted in chapter H.

Next: chapter F (legs, feet and the rails go onto the tops).
