scotthowson/desk-setup/manual/build/png/checklist/p-1.png

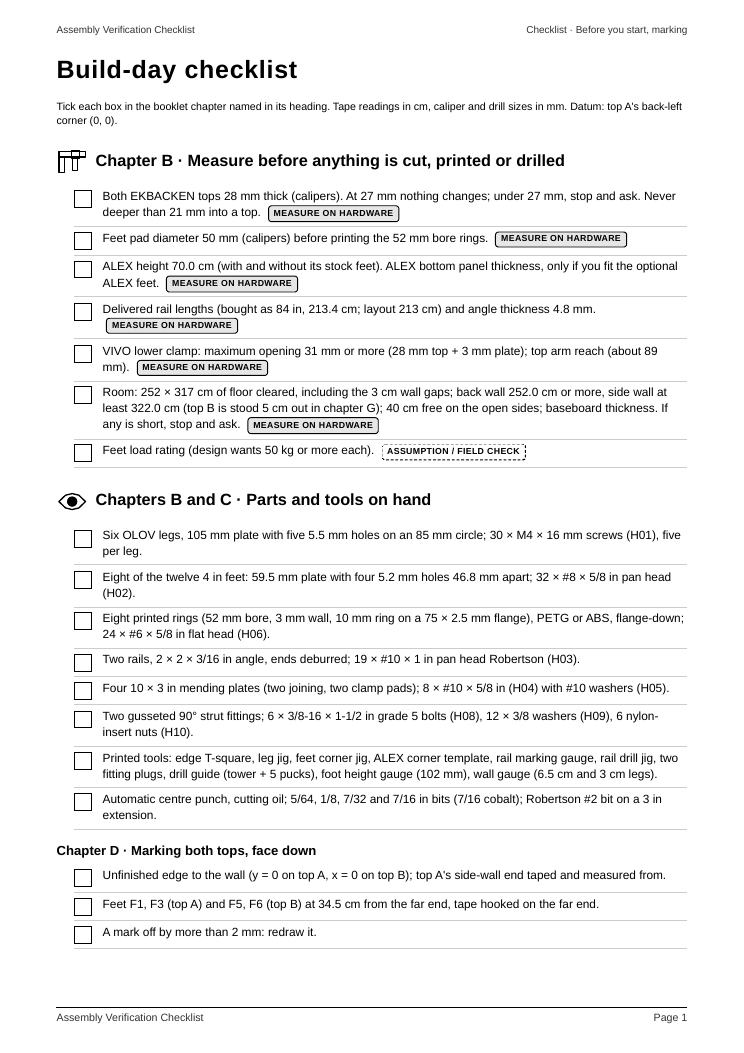
manual/build/png/checklist/p-1.png
