scotthowson/desk-setup/manual/build/png/checklist/p-2.png

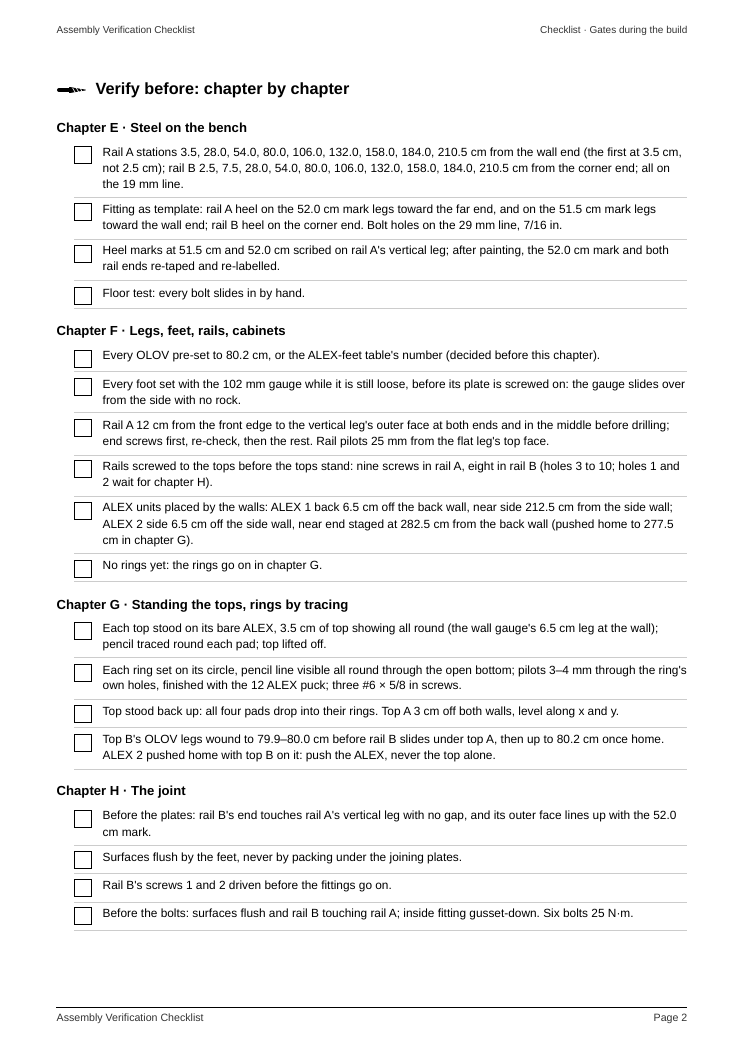
manual/build/png/checklist/p-2.png
