scotthowson/desk-setup/manual/build/png/checklist/p-3.png

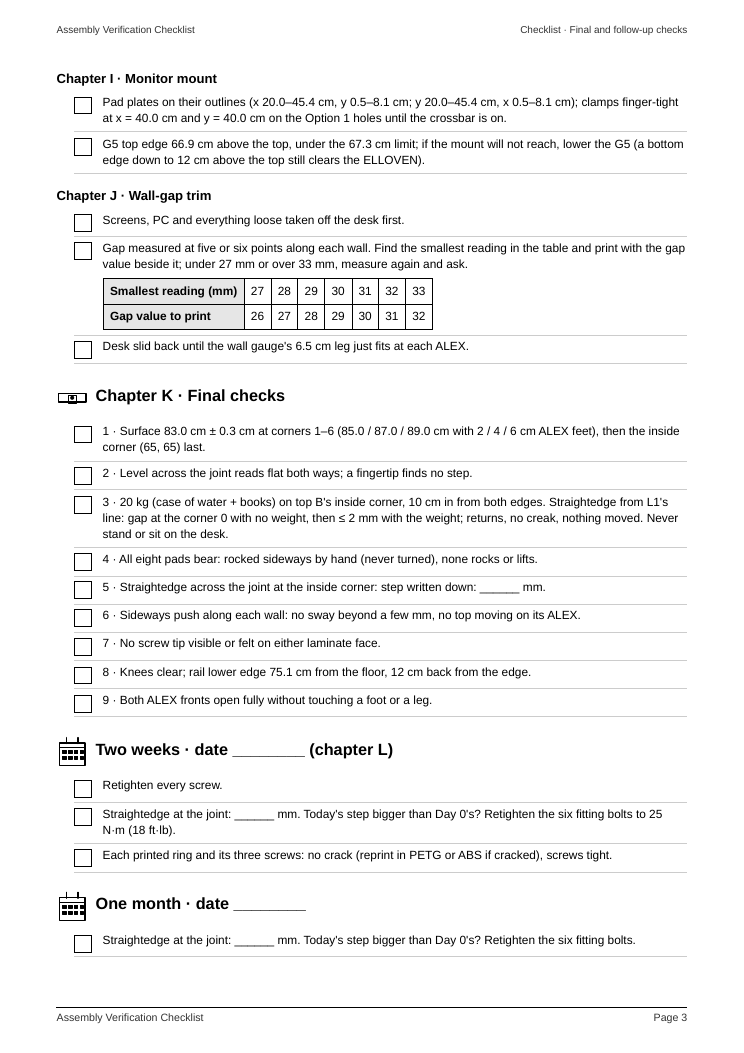
manual/build/png/checklist/p-3.png
