scotthowson/desk-setup/manual/build/png/dense/p-13.png

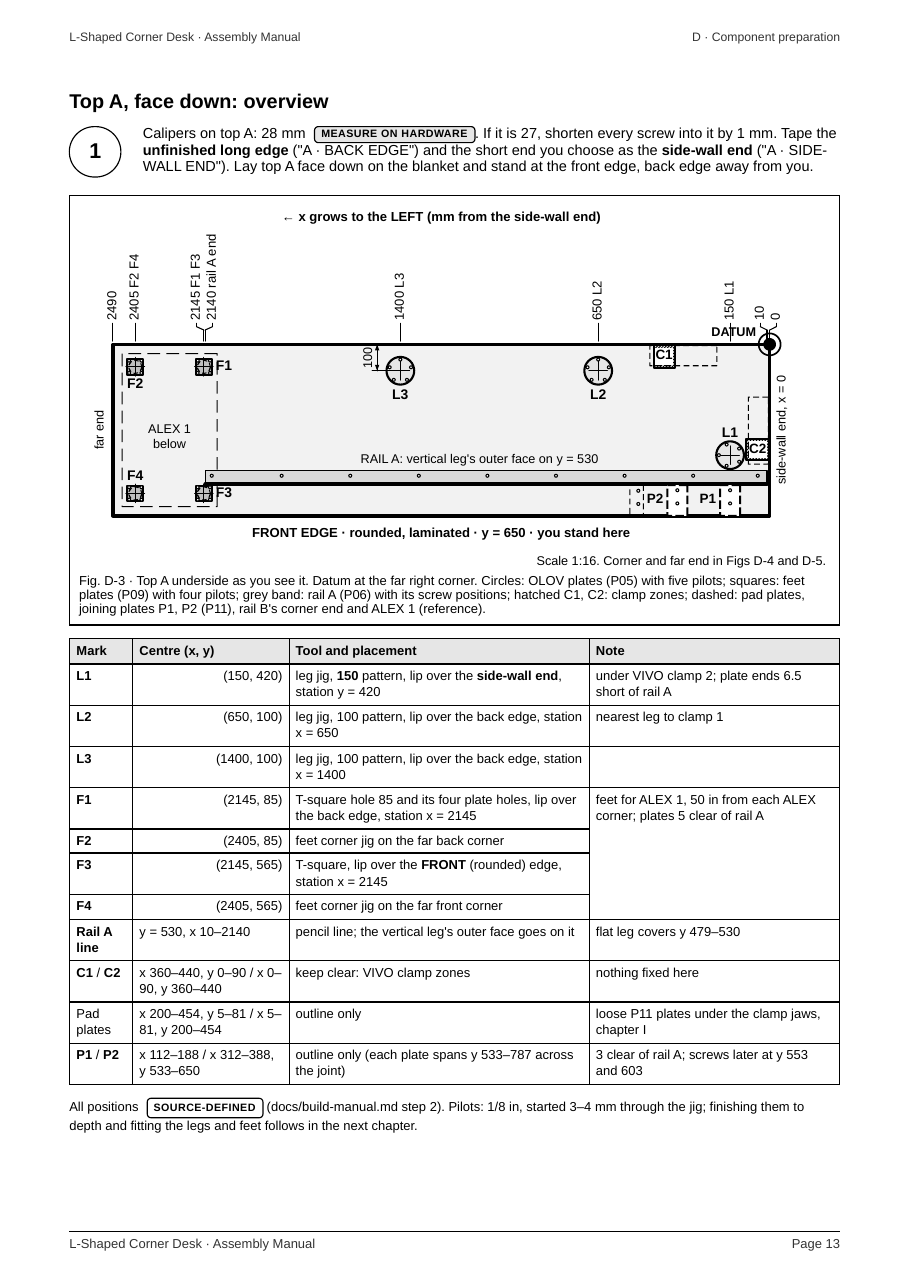
manual/build/png/dense/p-13.png
