scotthowson/desk-setup/manual/build/png/dense/p-14.png

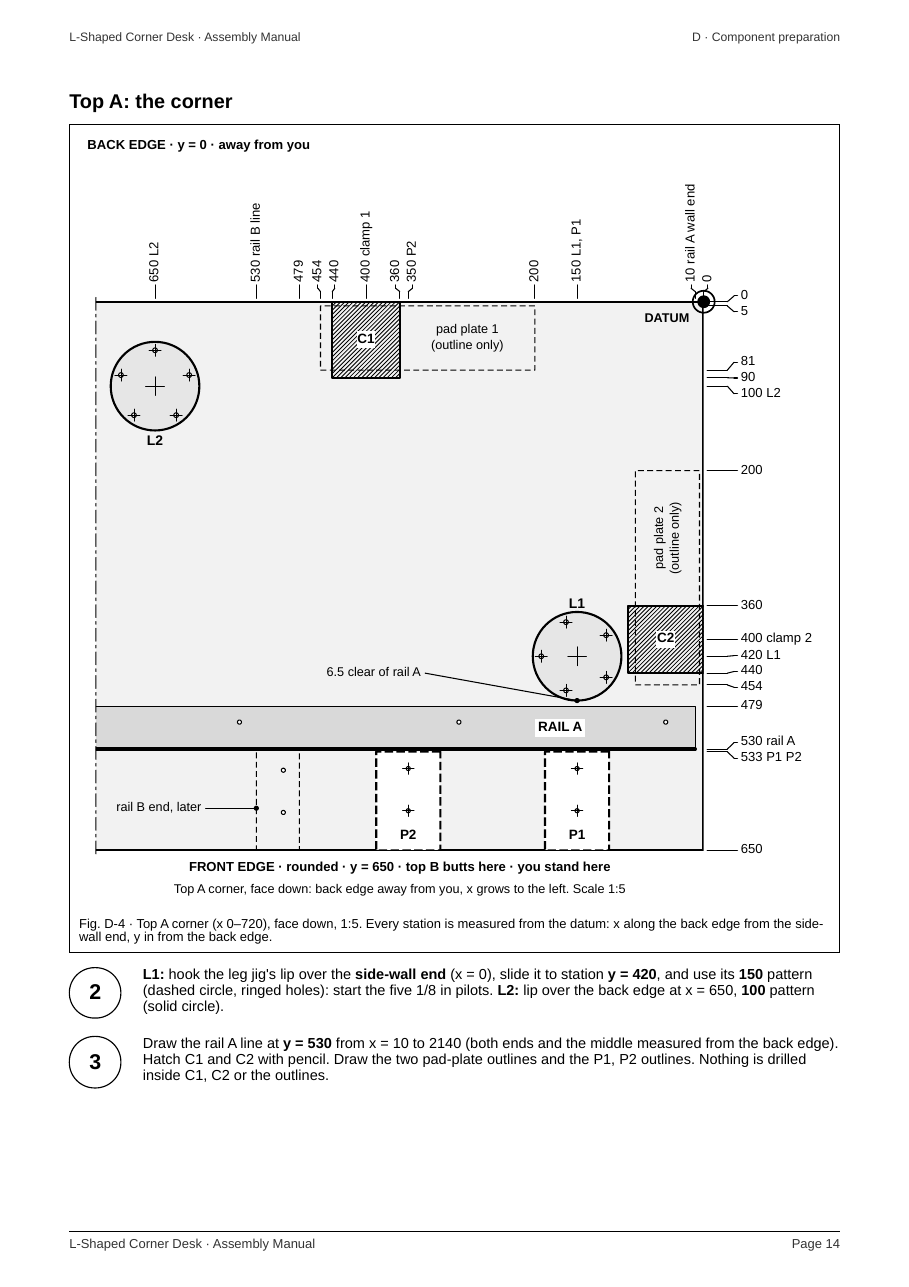
manual/build/png/dense/p-14.png
