scotthowson/desk-setup/manual/build/png/dense/p-24.png

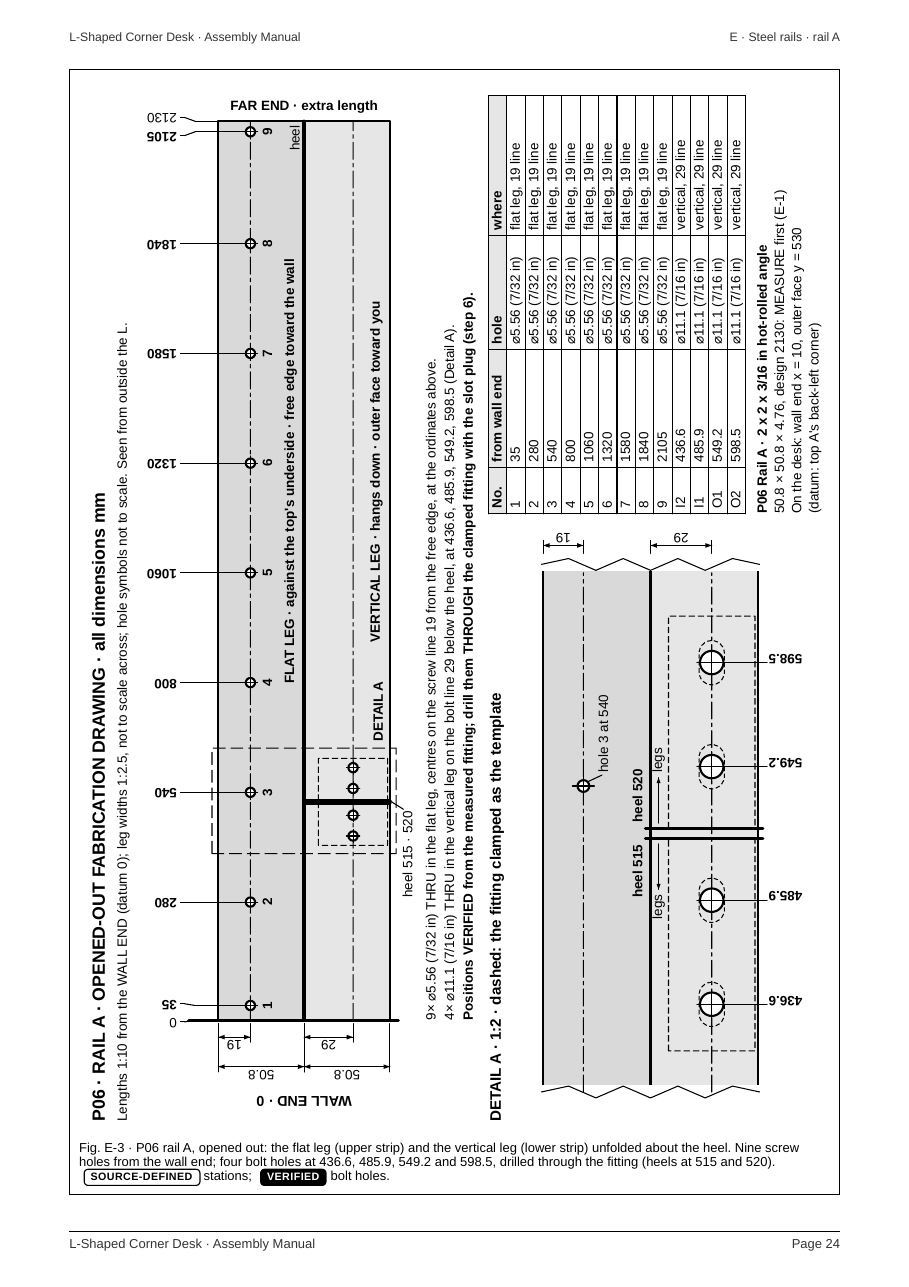
manual/build/png/dense/p-24.png
