scotthowson/desk-setup/manual/build/png/dense/p-36.png

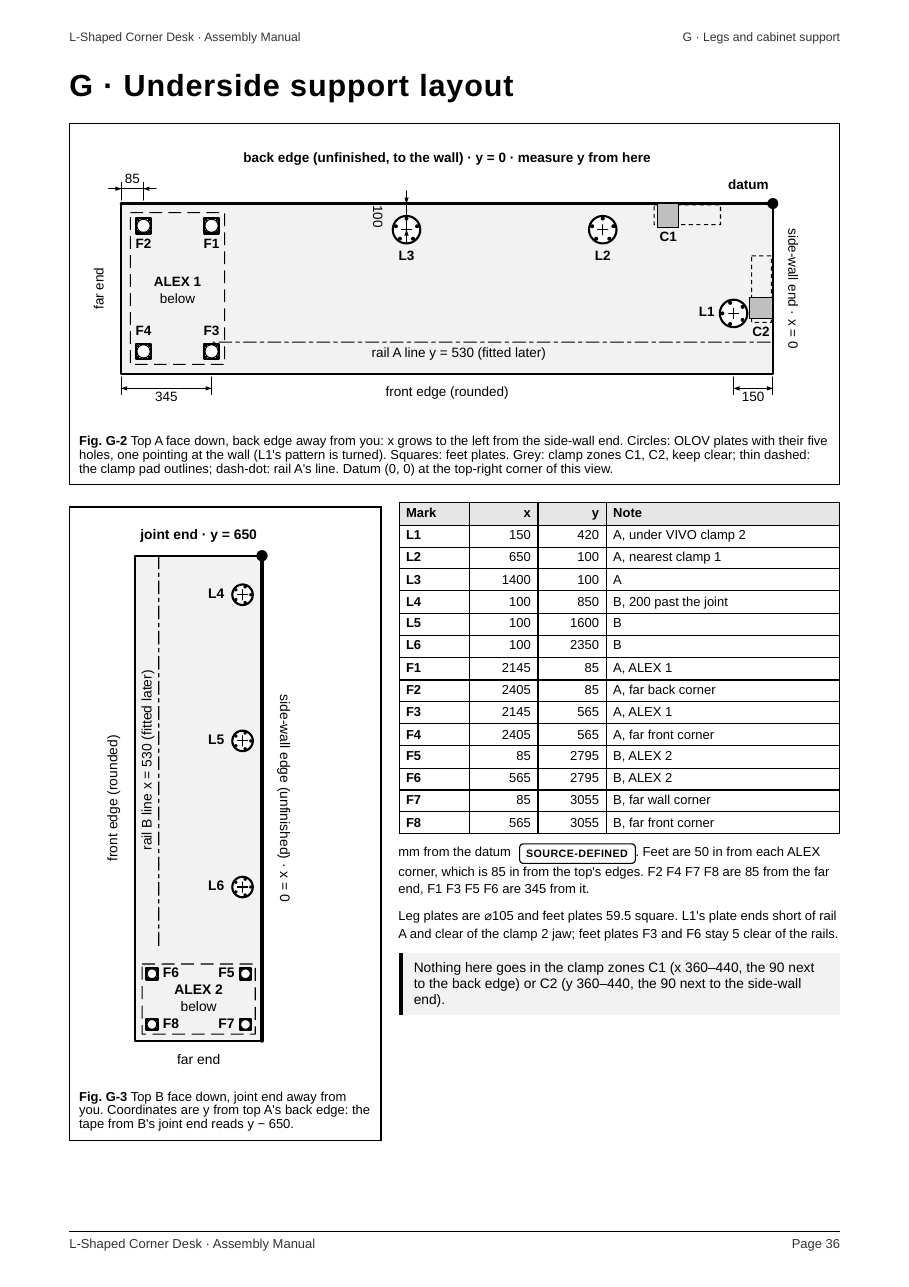
manual/build/png/dense/p-36.png
