scotthowson/desk-setup/manual/build/png/dense/p-46.png

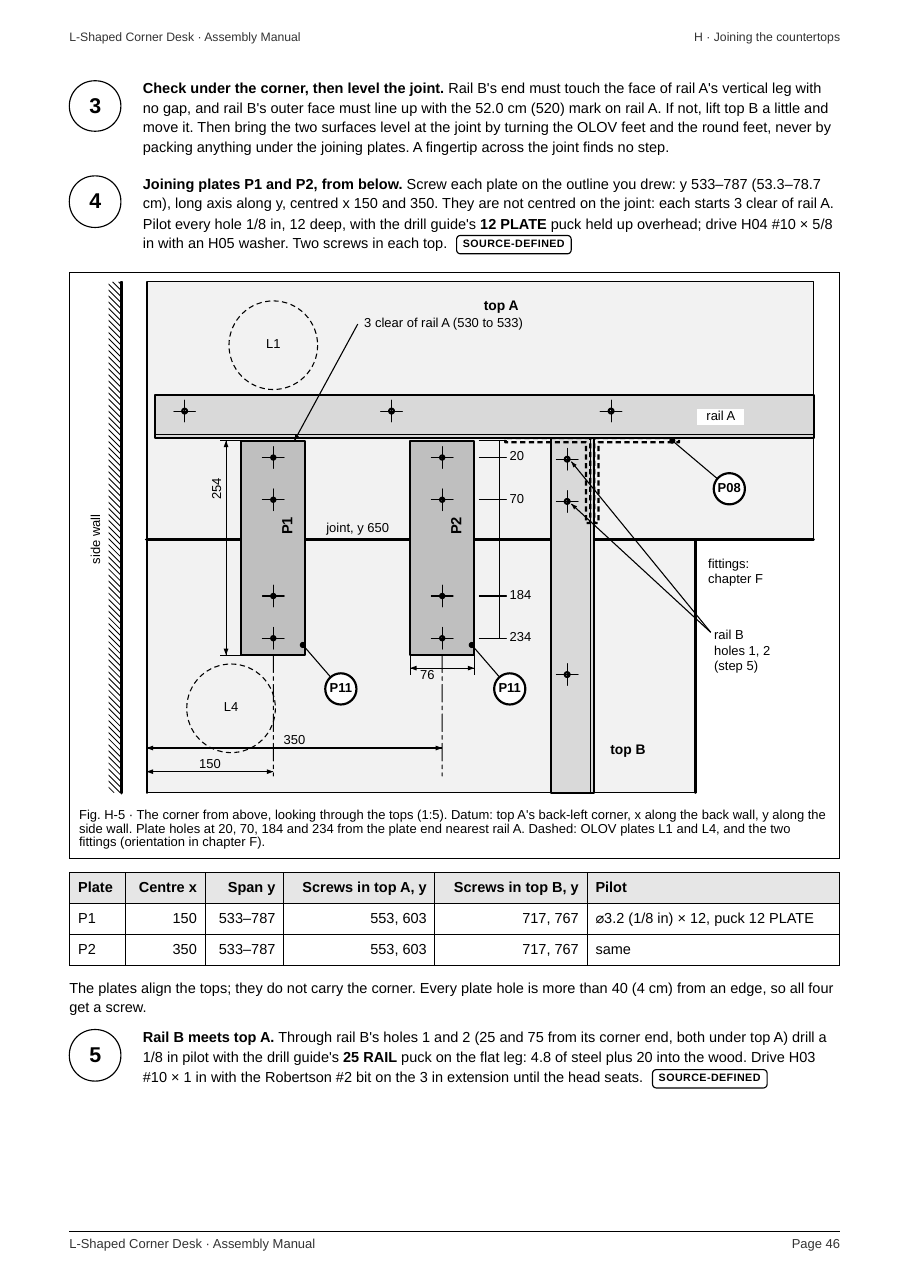
manual/build/png/dense/p-46.png
