scotthowson/desk-setup/manual/build/png/dense/p-52.png

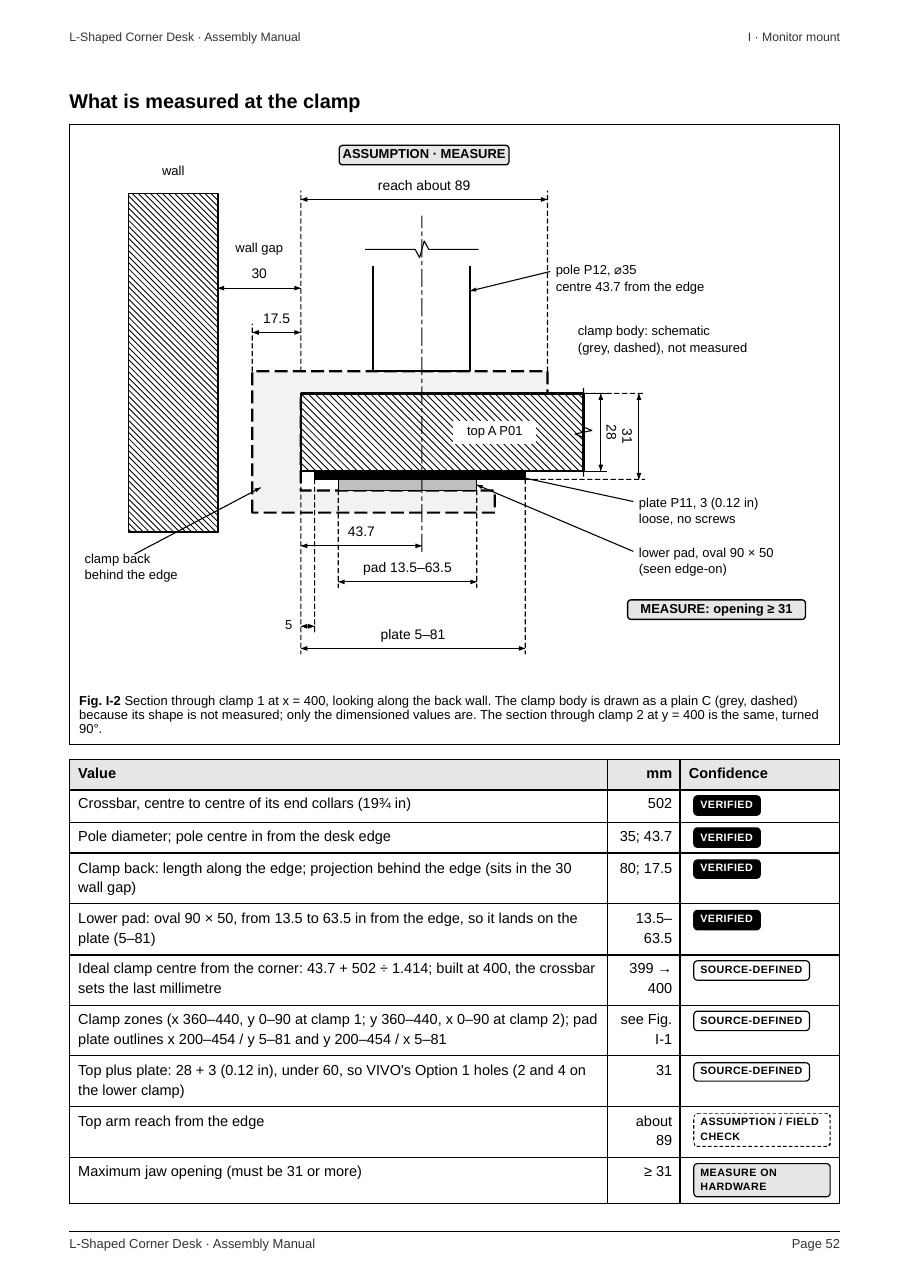
manual/build/png/dense/p-52.png
