scotthowson/desk-setup/manual/build/png/dense/ringdepth-21.png

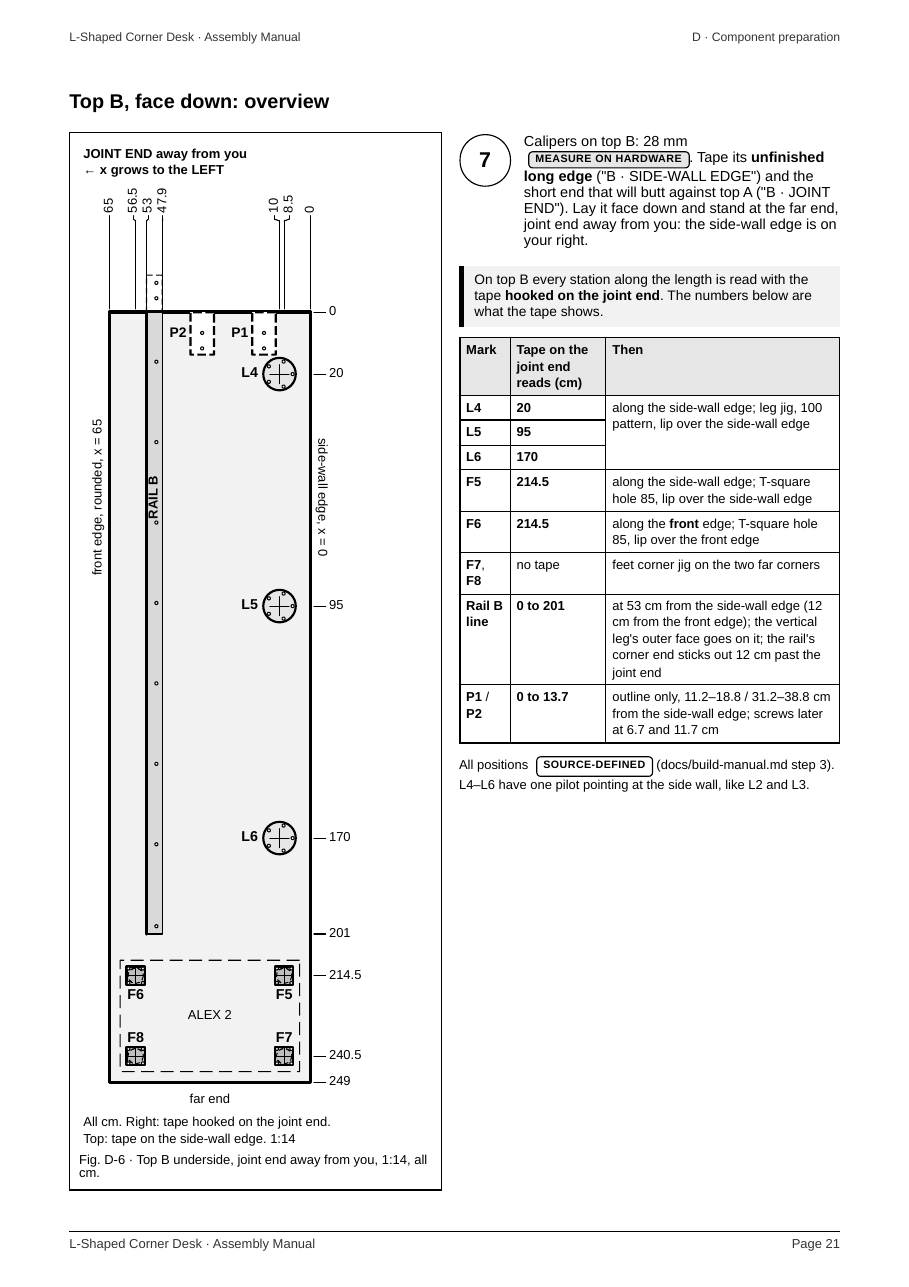
manual/build/png/dense/ringdepth-21.png
