scotthowson/desk-setup/manual/build/png/dense/t-06.png

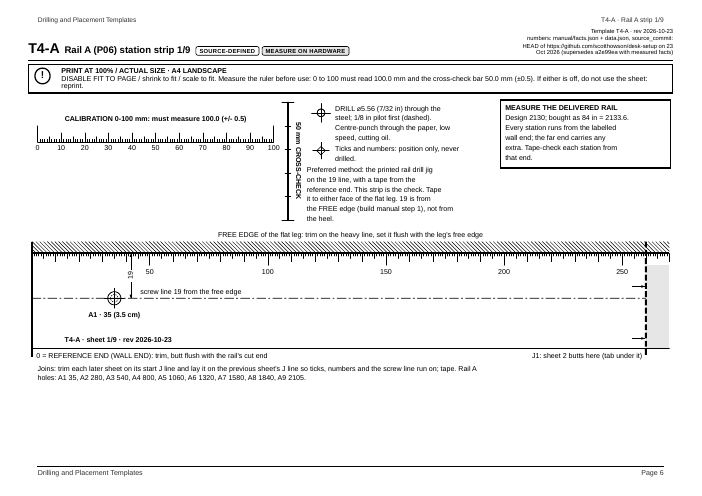
manual/build/png/dense/t-06.png
