scotthowson/desk-setup/manual/build/png/dense/t-24.png

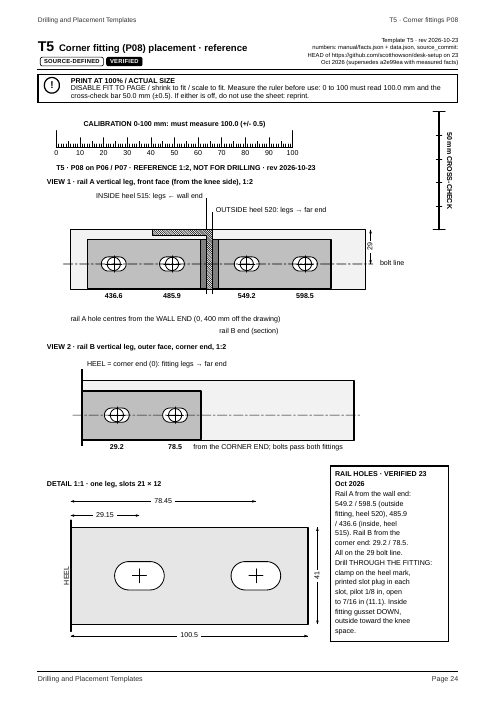
manual/build/png/dense/t-24.png
