scotthowson/desk-setup/manual/build/png/dense/toc-02.png

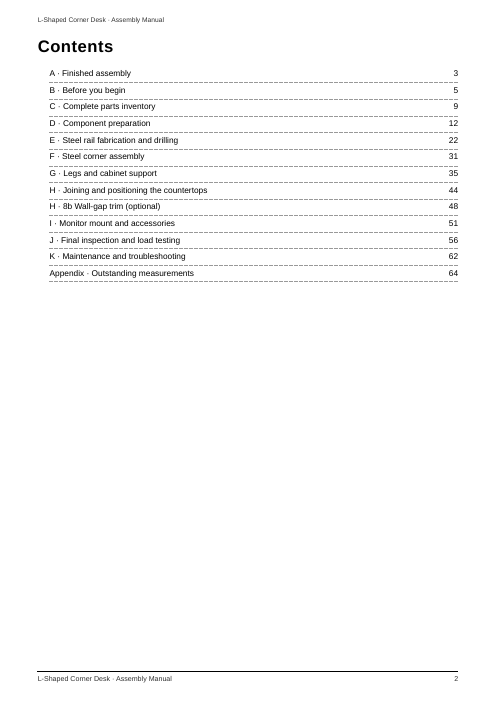
manual/build/png/dense/toc-02.png
