scotthowson/desk-setup/manual/build/png/manual-a/p-01.png

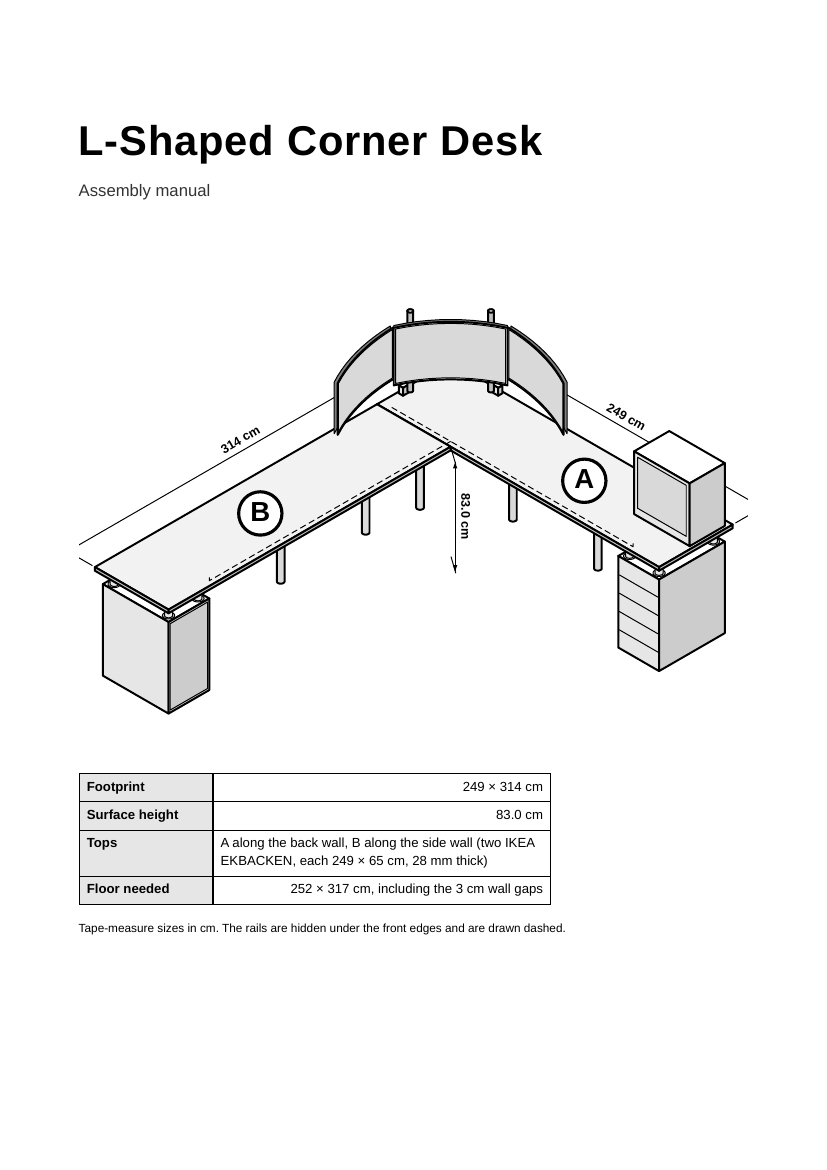
manual/build/png/manual-a/p-01.png
