scotthowson/desk-setup/manual/build/png/manual-a/p-02.png

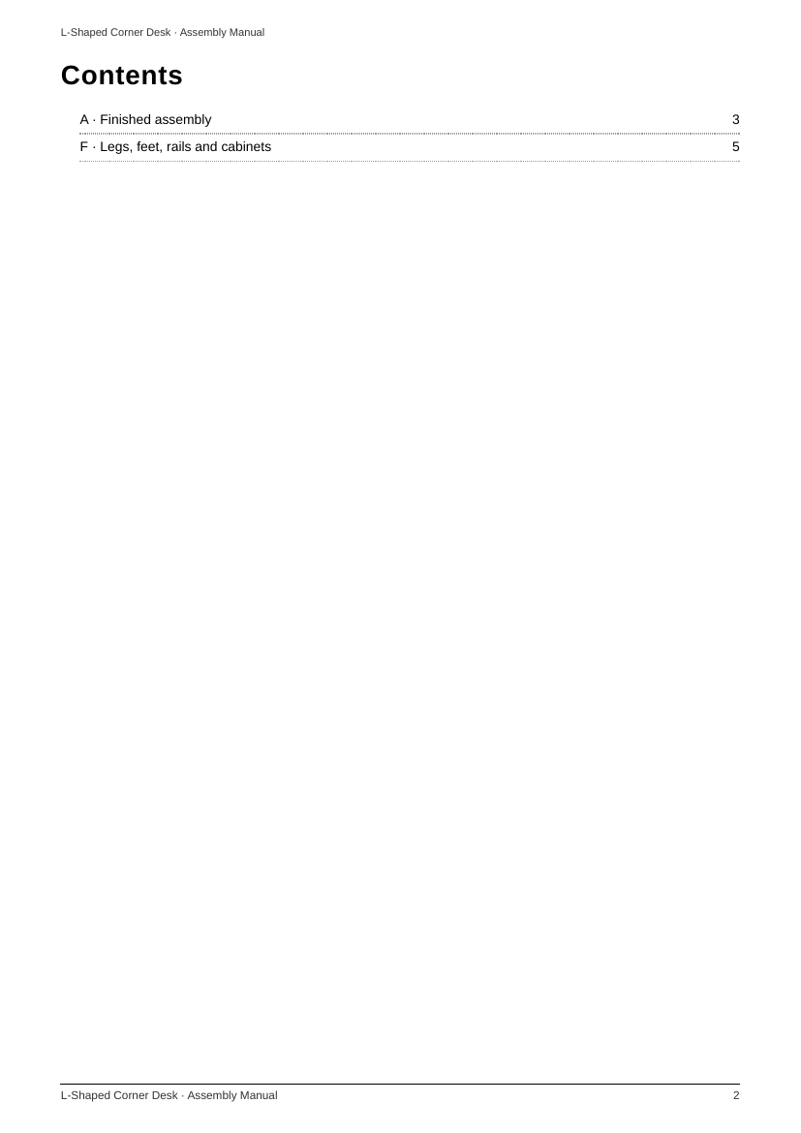
manual/build/png/manual-a/p-02.png
