scotthowson/desk-setup/manual/build/png/manual-a/p-03.png

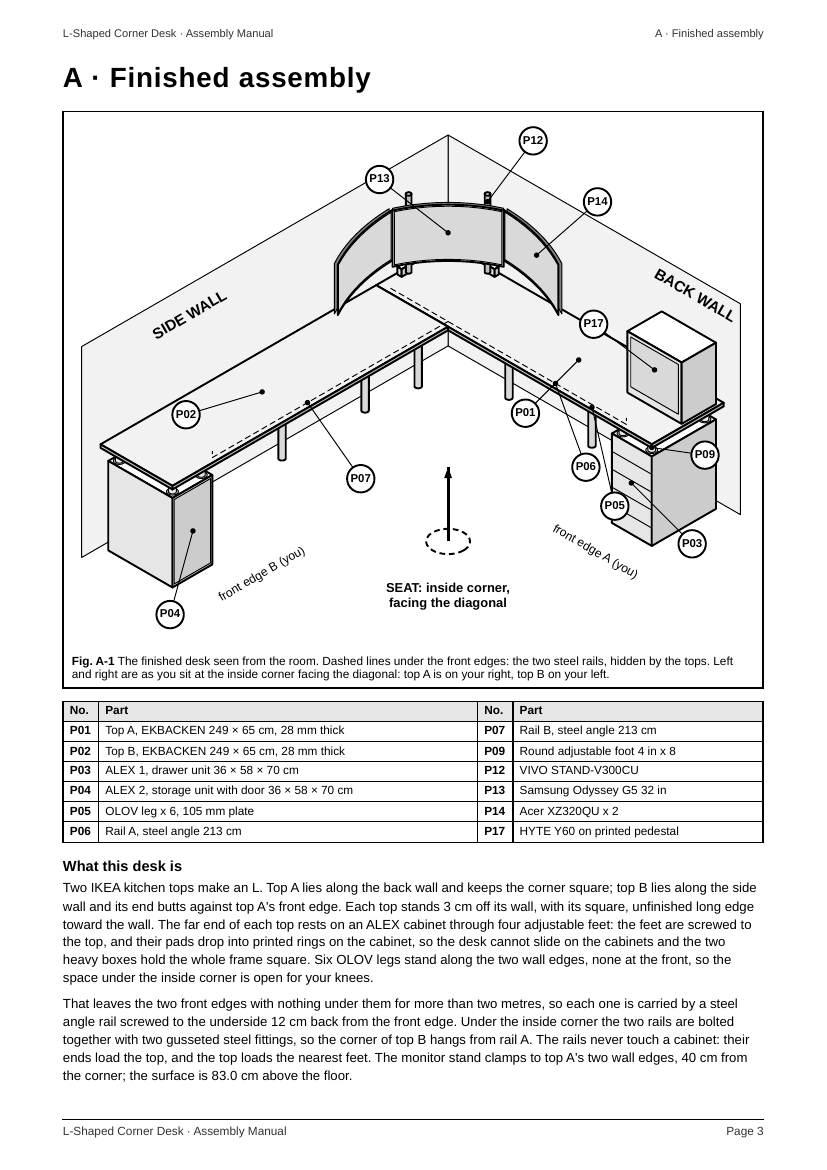
manual/build/png/manual-a/p-03.png
