scotthowson/desk-setup/manual/build/png/manual-a/p-04.png

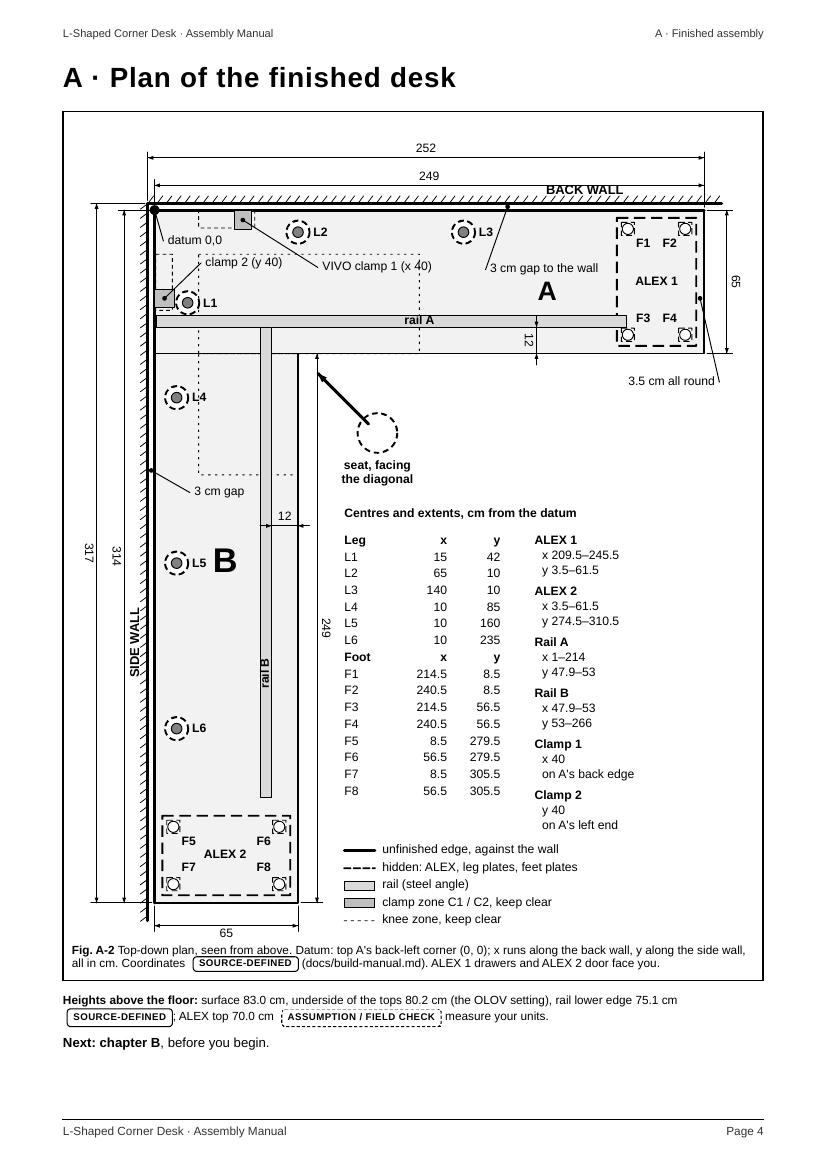
manual/build/png/manual-a/p-04.png
