scotthowson/desk-setup/manual/build/png/manual-a/p-05.png

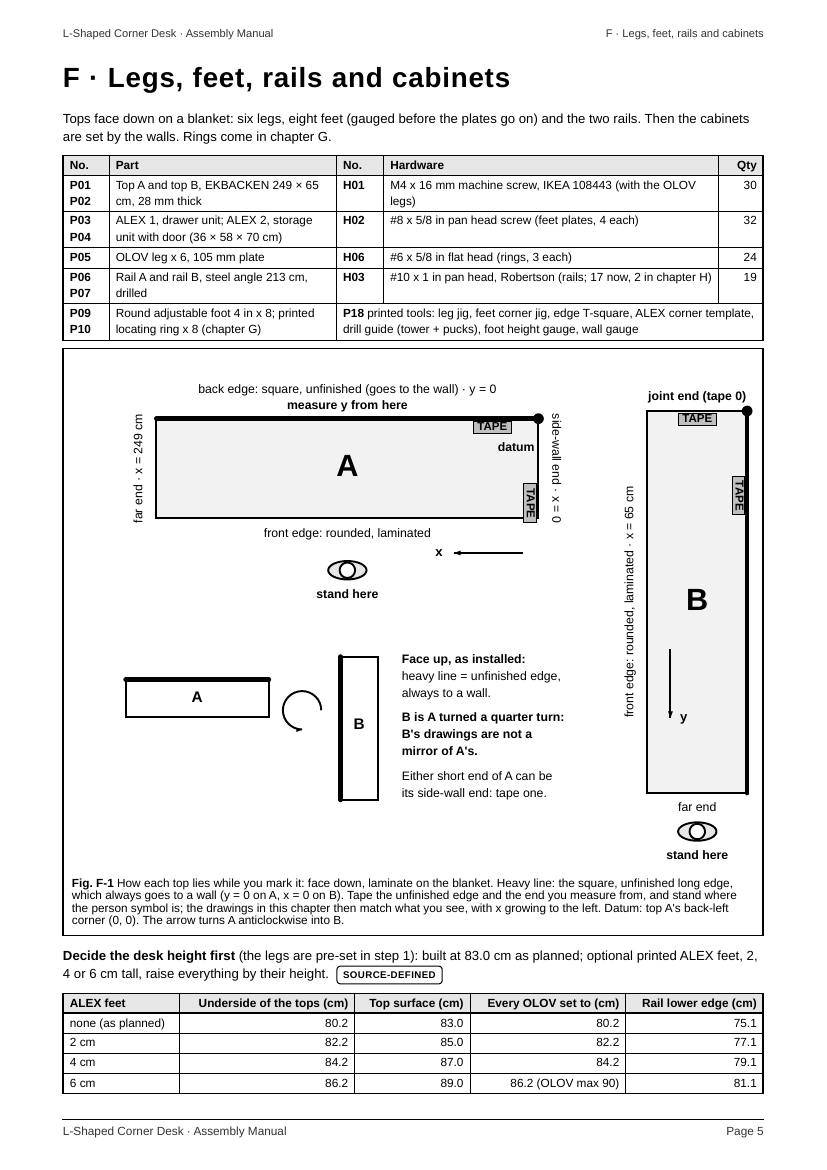
manual/build/png/manual-a/p-05.png
