scotthowson/desk-setup/manual/build/png/manual-a/p-06.png

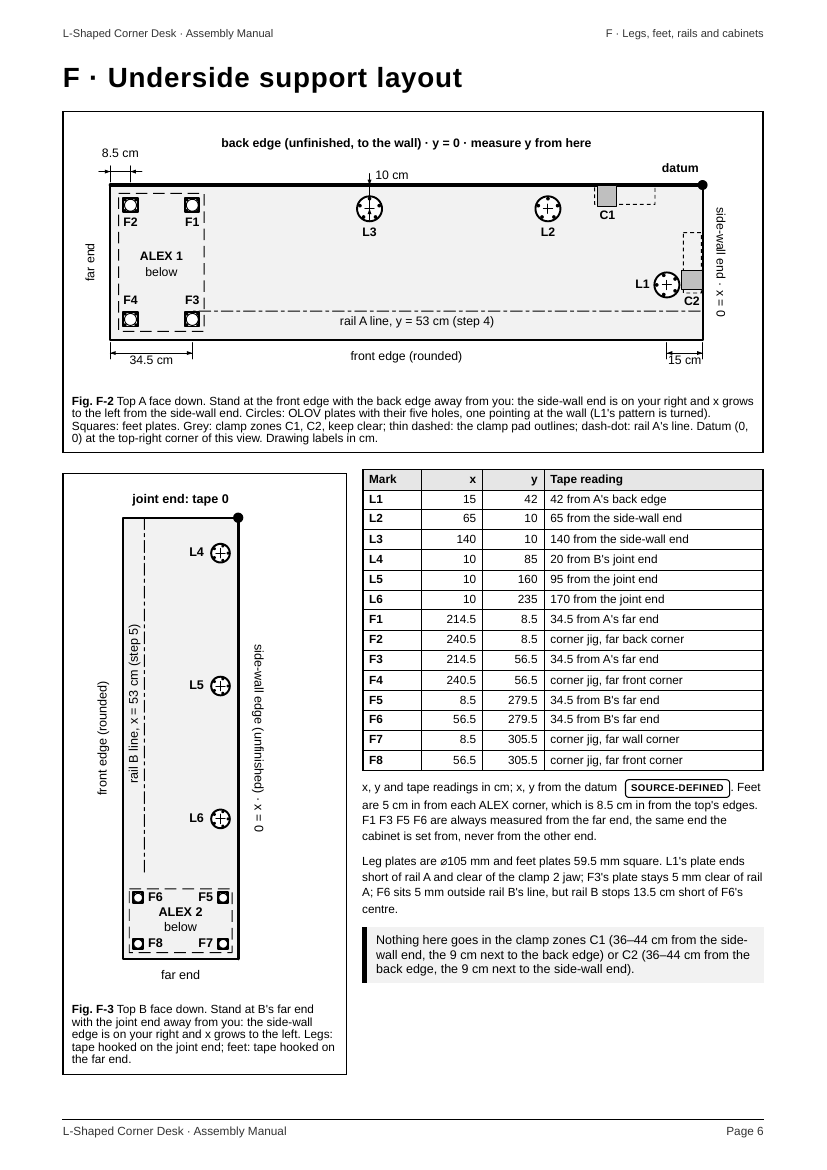
manual/build/png/manual-a/p-06.png
