scotthowson/desk-setup/manual/build/png/manual-a/p-07.png

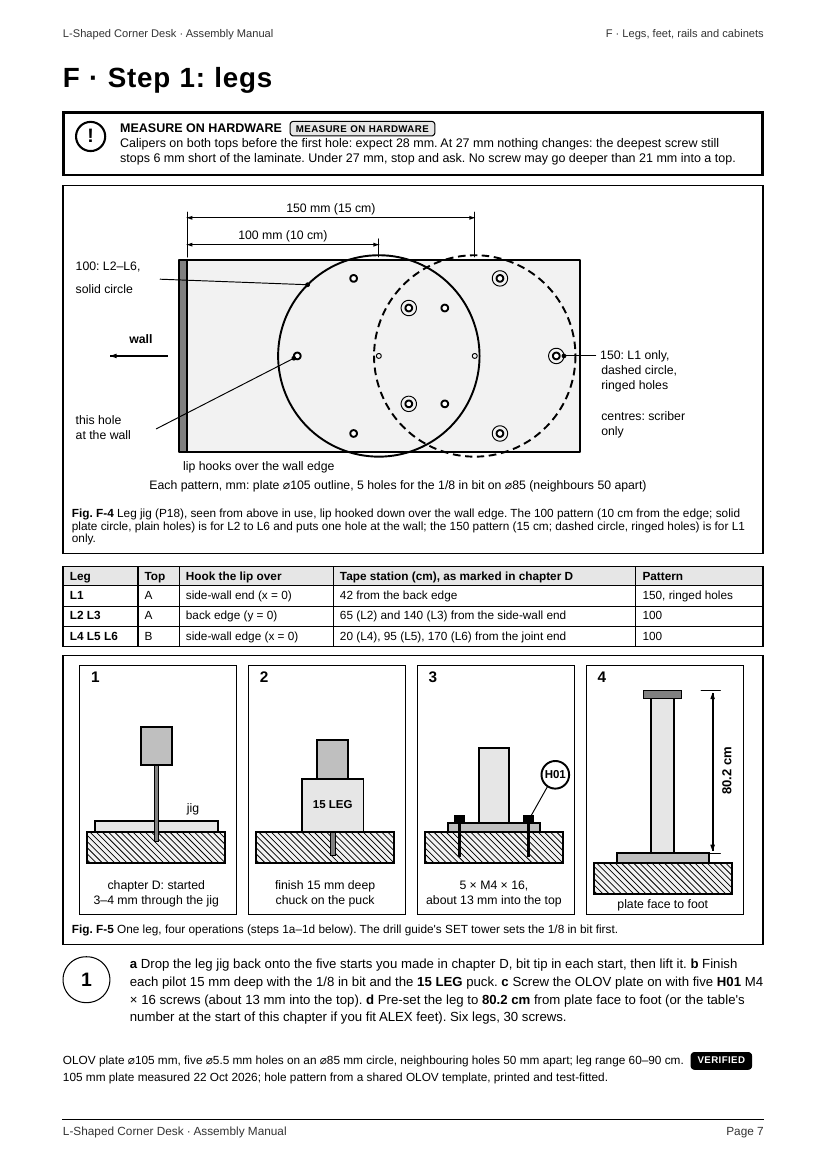
manual/build/png/manual-a/p-07.png
