scotthowson/desk-setup/manual/build/png/manual-a/p-08.png

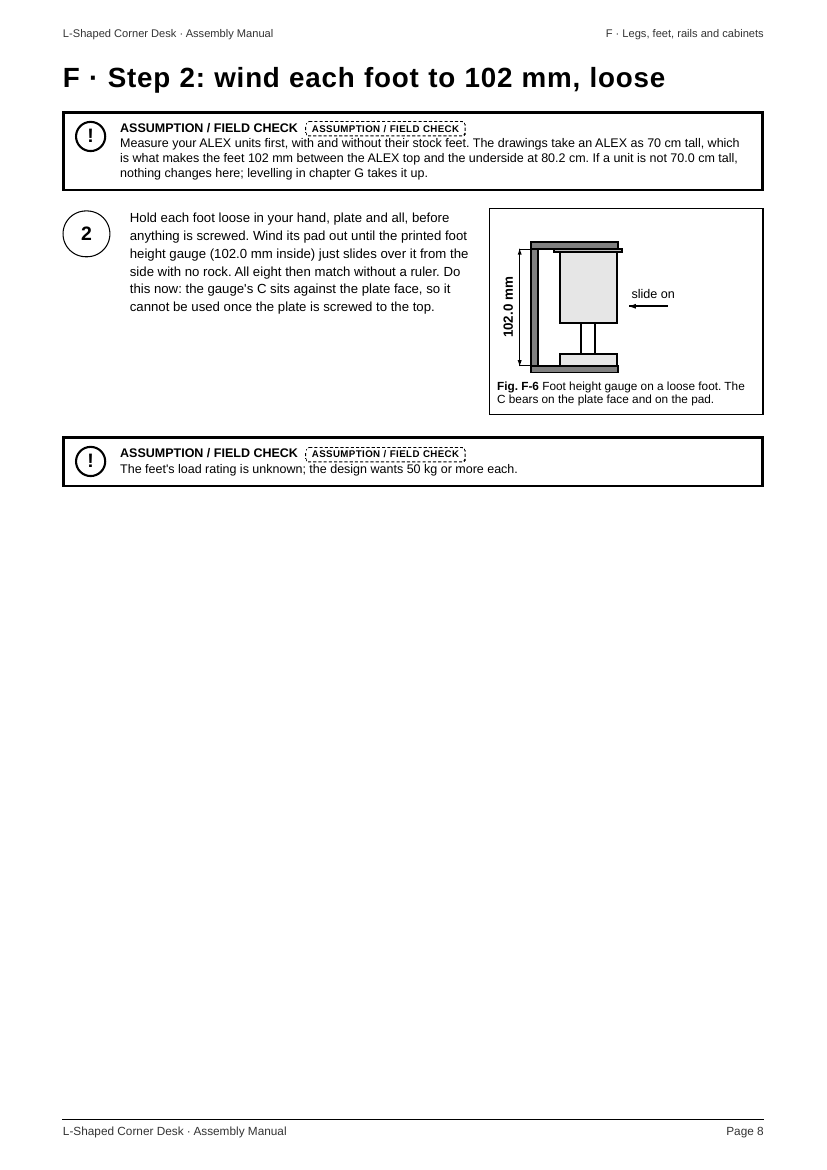
manual/build/png/manual-a/p-08.png
