scotthowson/desk-setup/manual/build/png/manual-a/p-09.png

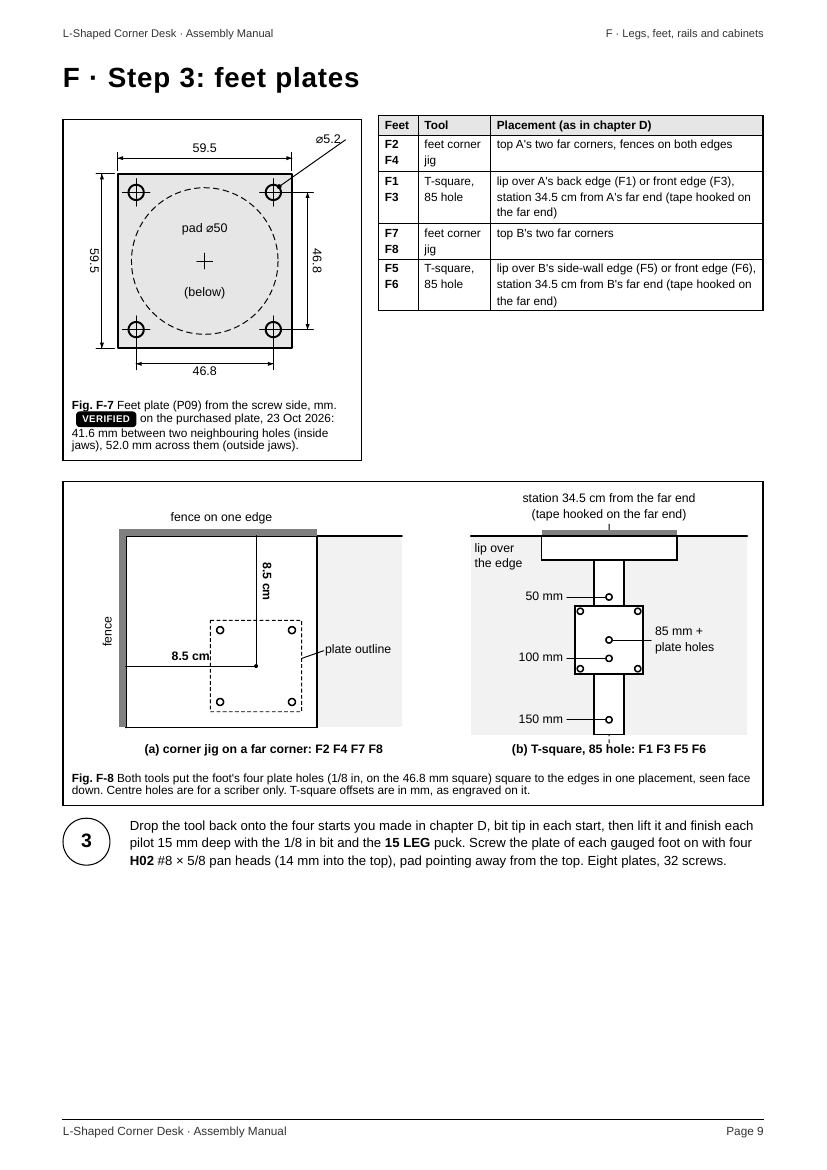
manual/build/png/manual-a/p-09.png
