scotthowson/desk-setup/manual/build/png/manual-a/p-10.png

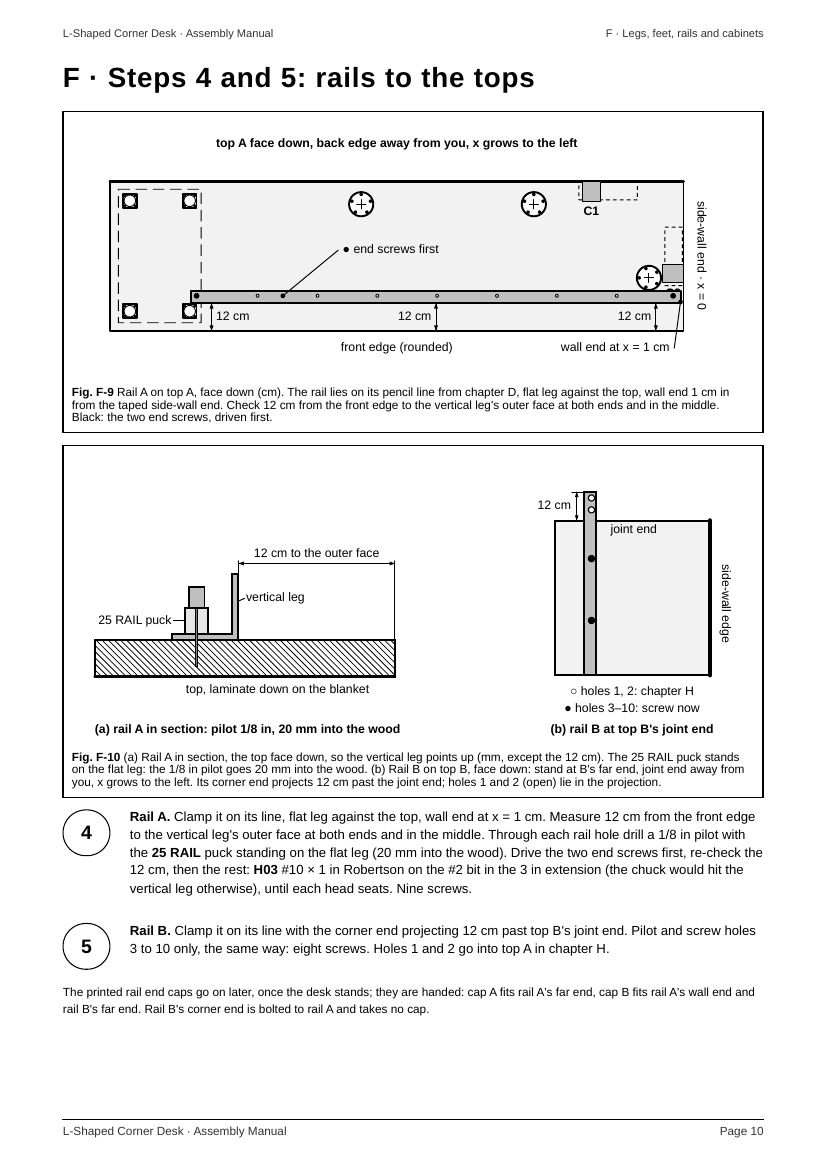
manual/build/png/manual-a/p-10.png
