scotthowson/desk-setup/manual/build/png/manual-a/p-11.png

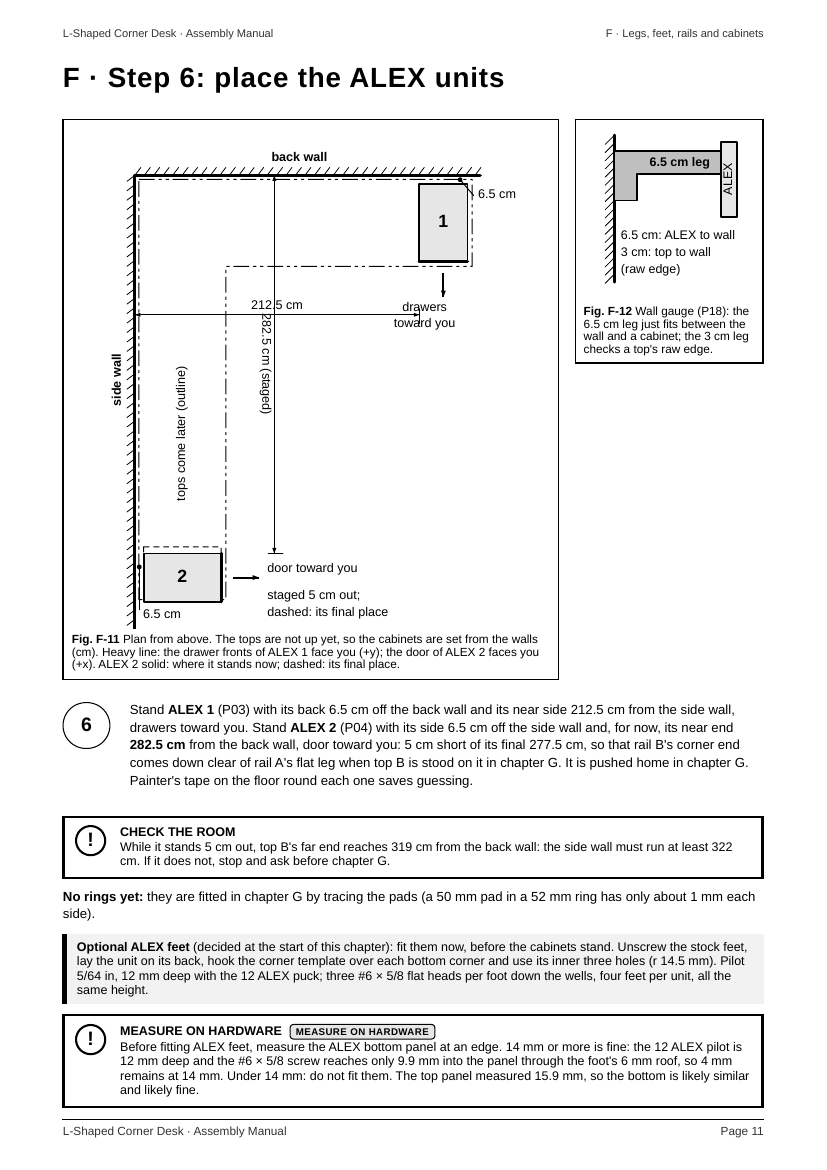
manual/build/png/manual-a/p-11.png
