scotthowson/desk-setup/manual/build/png/manual-a/p-12.png

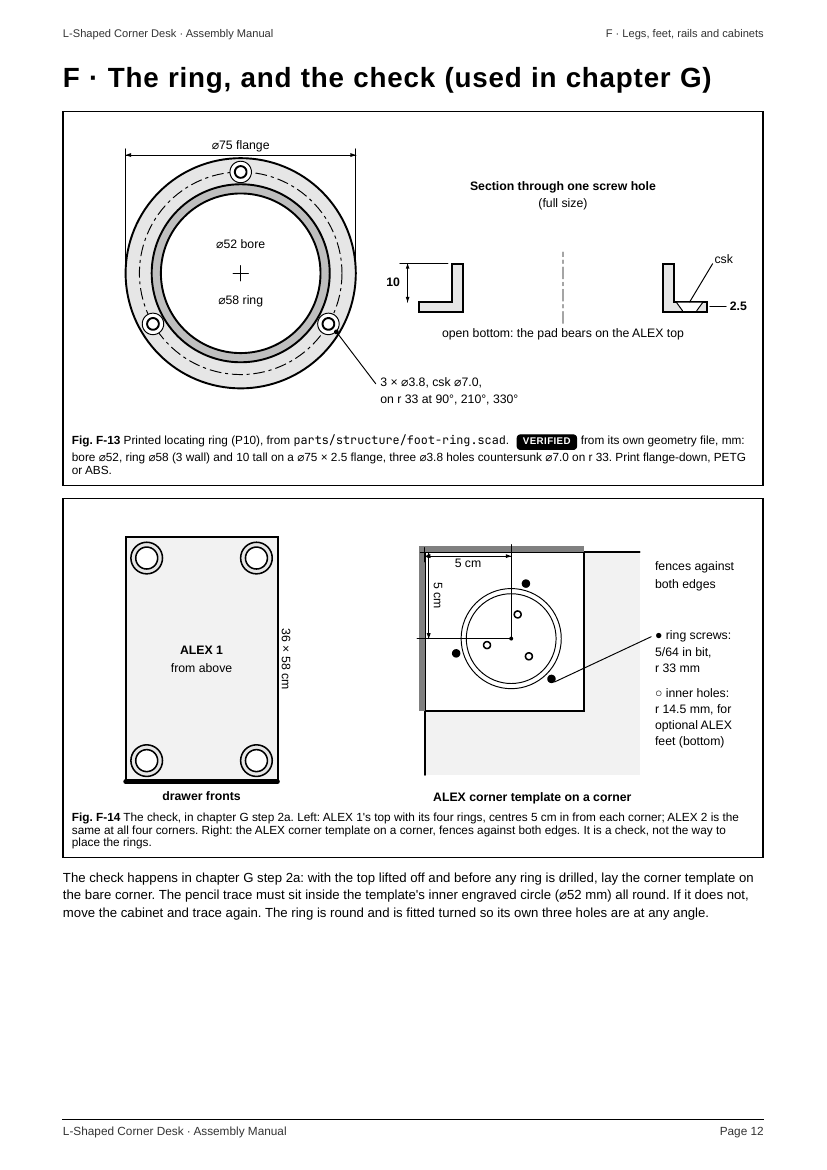
manual/build/png/manual-a/p-12.png
