scotthowson/desk-setup/manual/build/png/manual-a/p-13.png

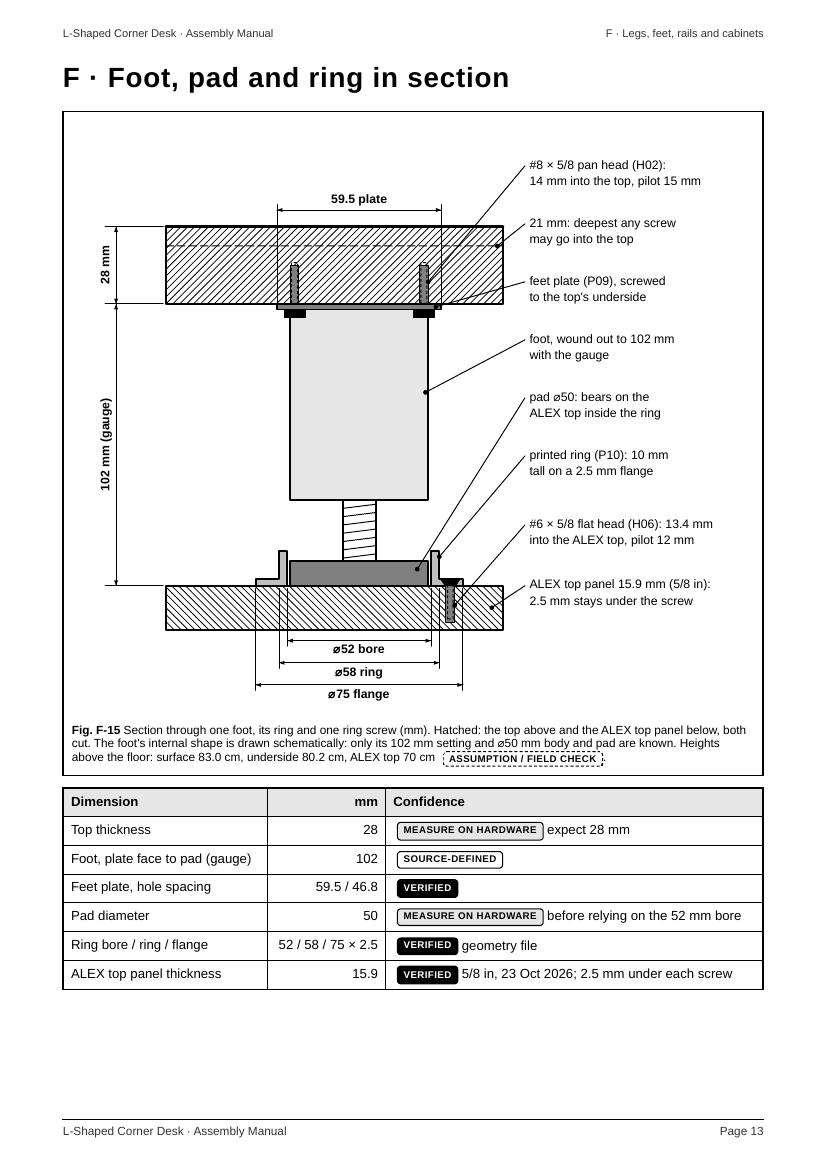
manual/build/png/manual-a/p-13.png
