scotthowson/desk-setup/manual/build/png/manual-a/p-14.png

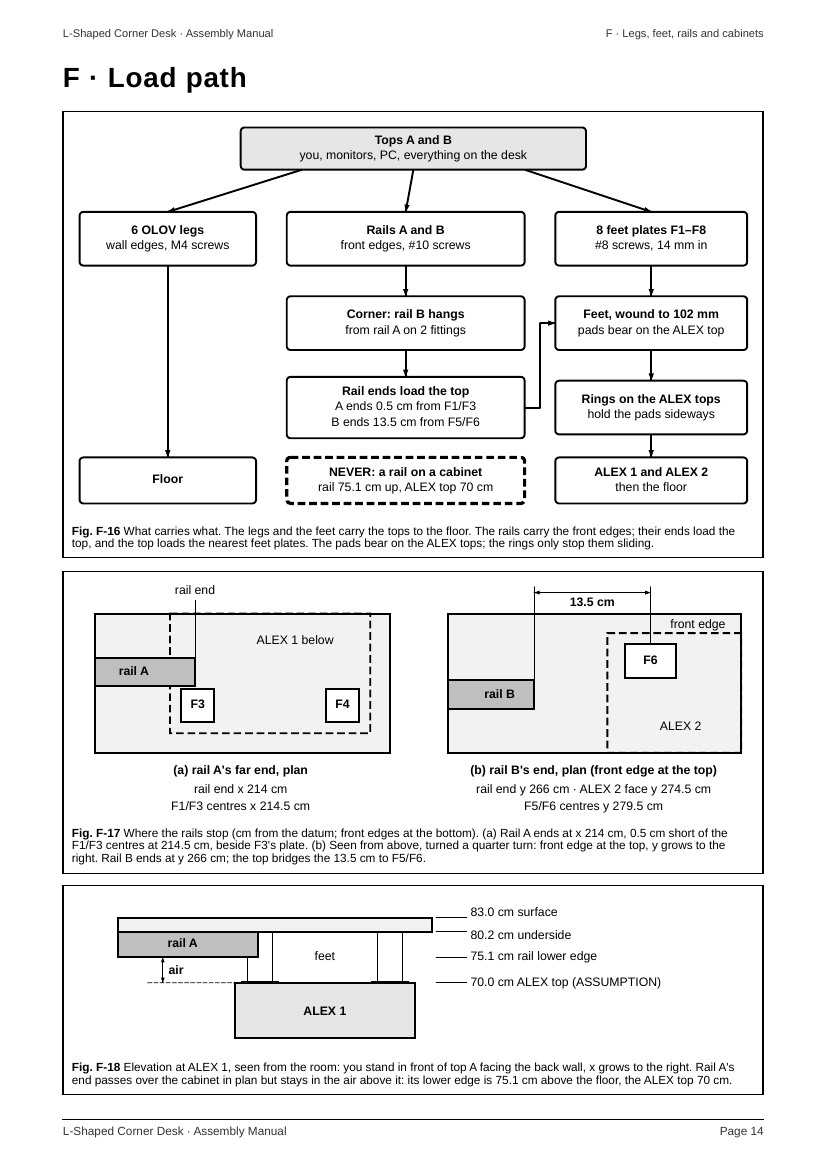
manual/build/png/manual-a/p-14.png
