scotthowson/desk-setup/manual/build/png/manual-a/p-15.png

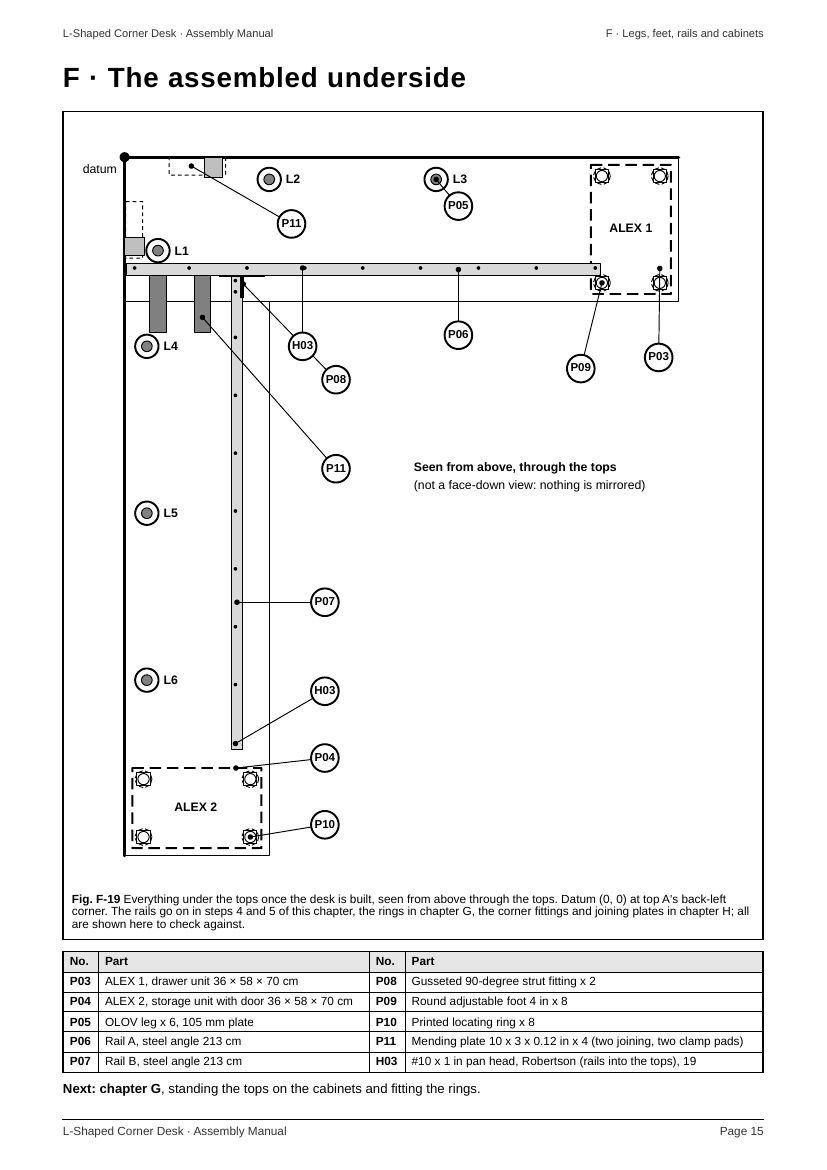
manual/build/png/manual-a/p-15.png
