scotthowson/desk-setup/manual/build/png/manual-checks/p-01.png

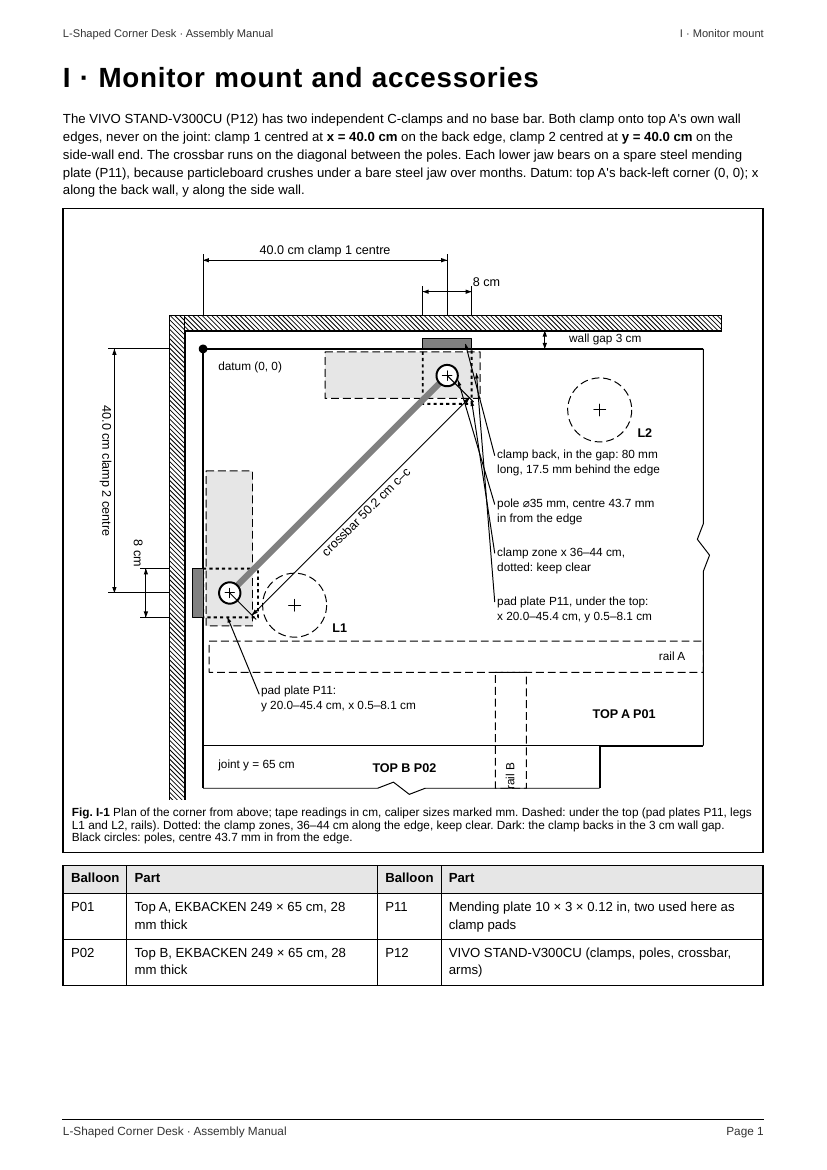
manual/build/png/manual-checks/p-01.png
