scotthowson/desk-setup/manual/build/png/manual-checks/p-03.png

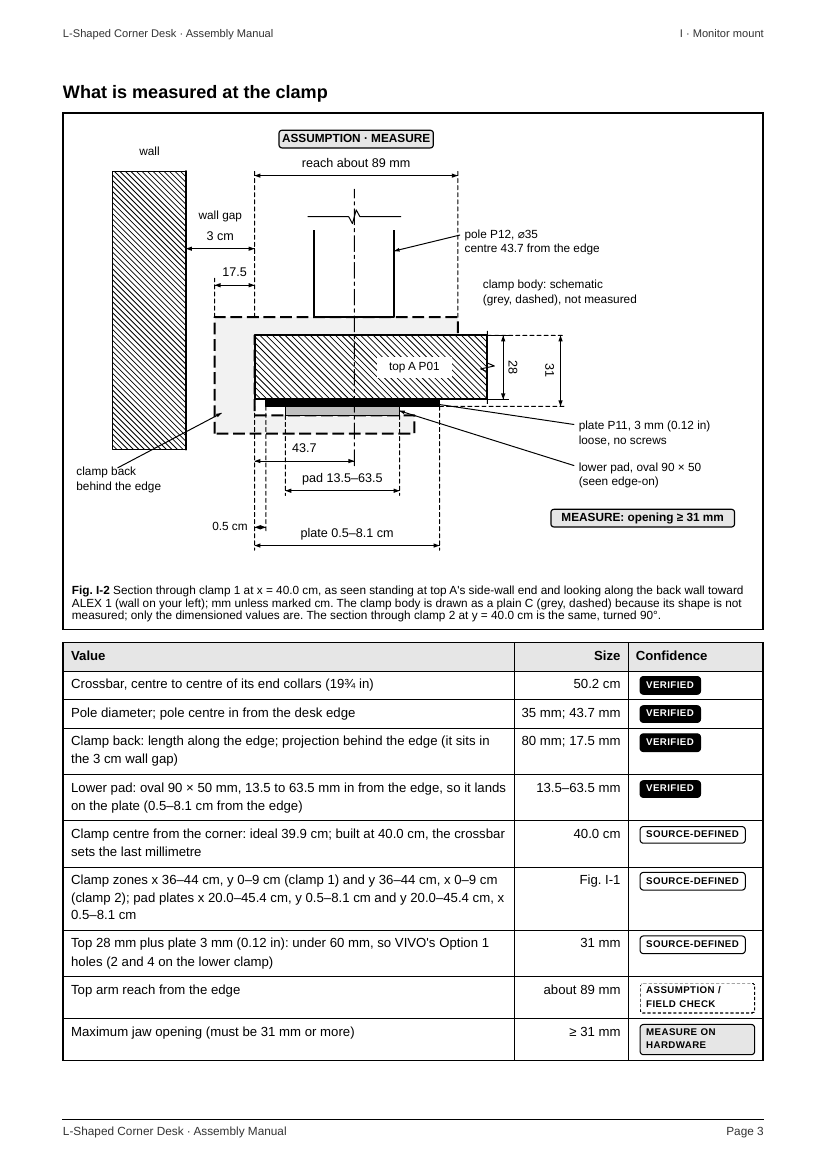
manual/build/png/manual-checks/p-03.png
