scotthowson/desk-setup/manual/build/png/manual-checks/p-04.png

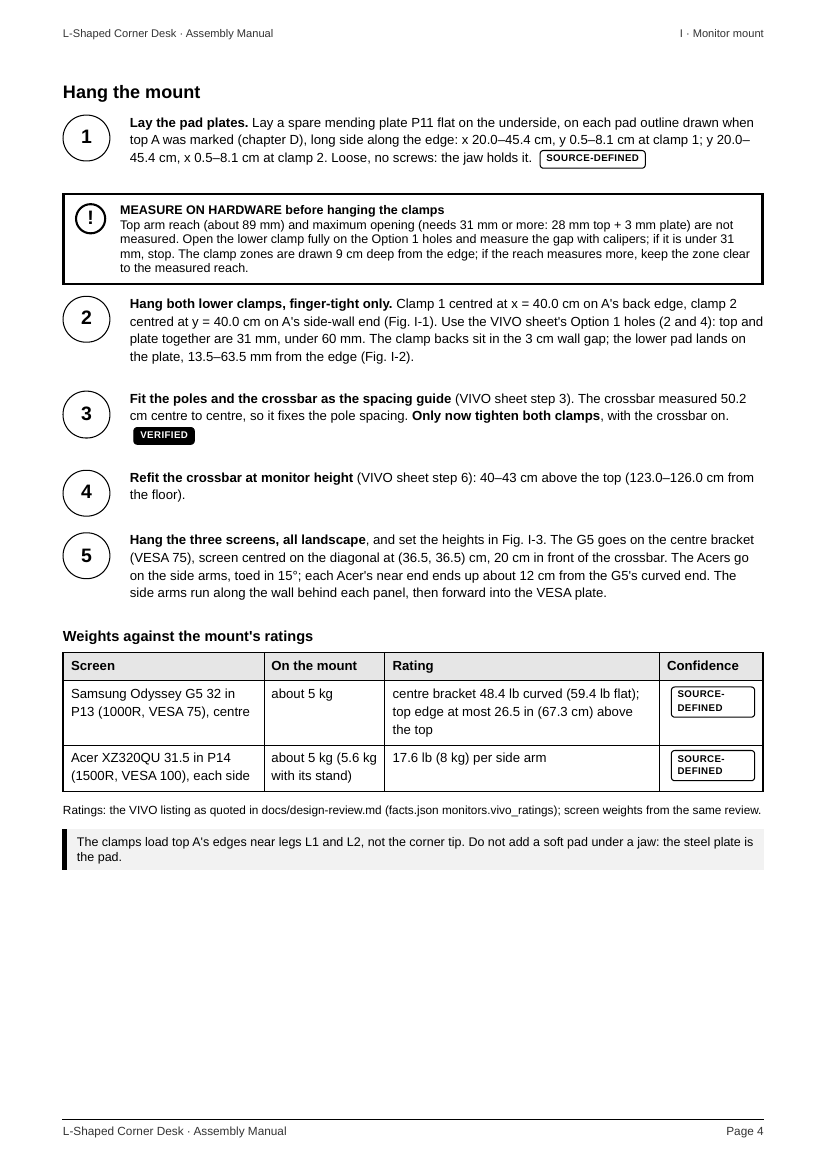
manual/build/png/manual-checks/p-04.png
