scotthowson/desk-setup/manual/build/png/manual-checks/p-05.png

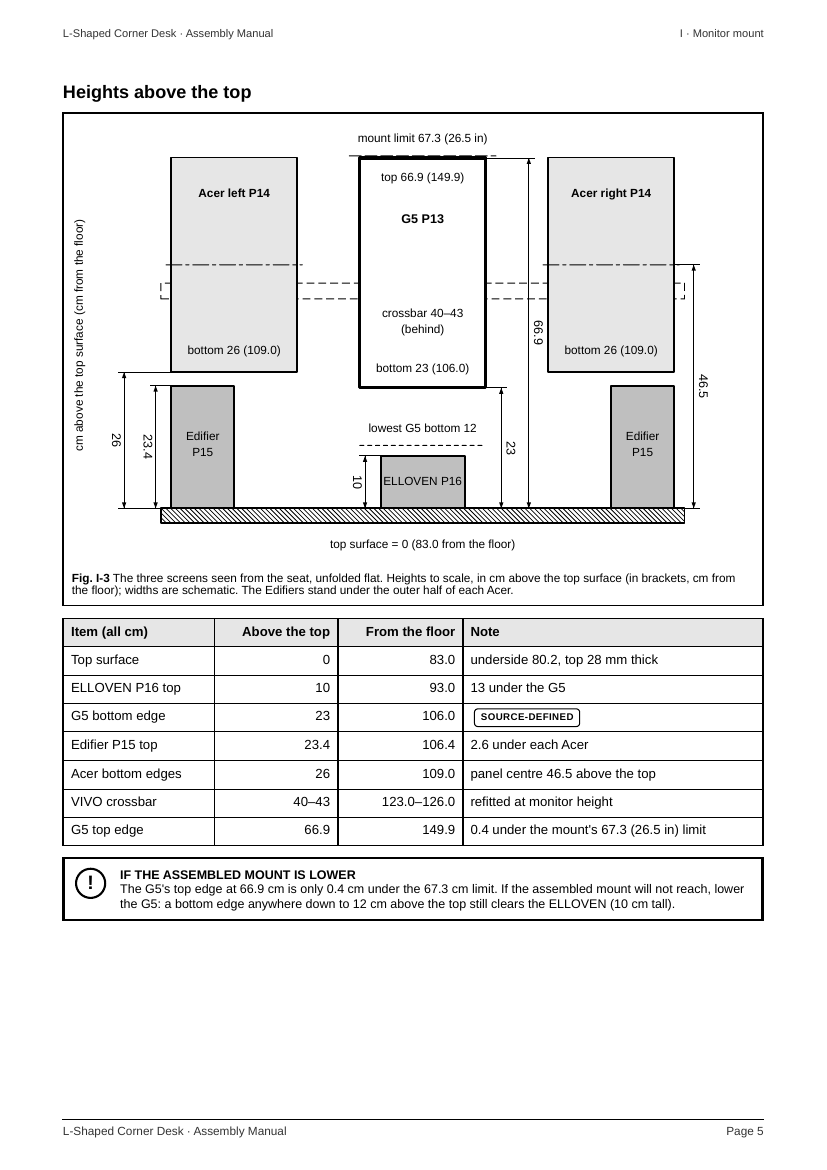
manual/build/png/manual-checks/p-05.png
