scotthowson/desk-setup/manual/build/png/manual-checks/p-06.png

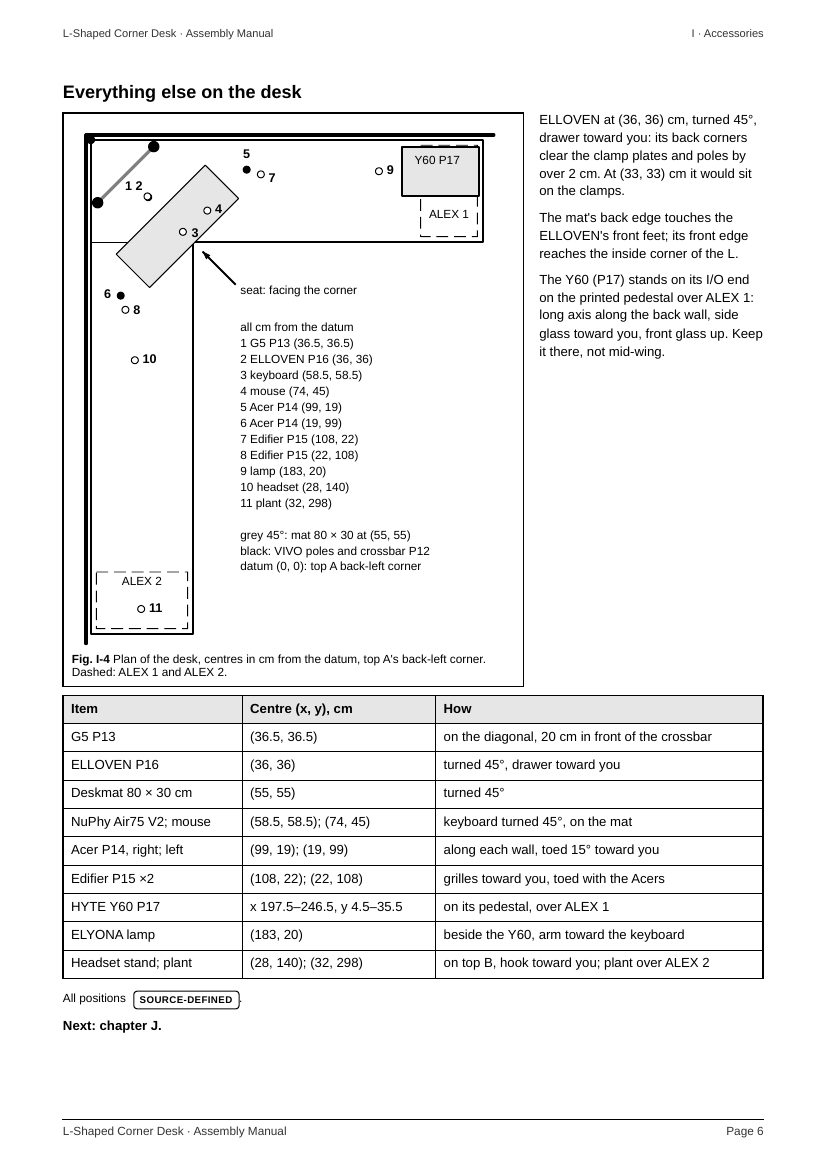
manual/build/png/manual-checks/p-06.png
