scotthowson/desk-setup/manual/build/png/manual-checks/p-07.png

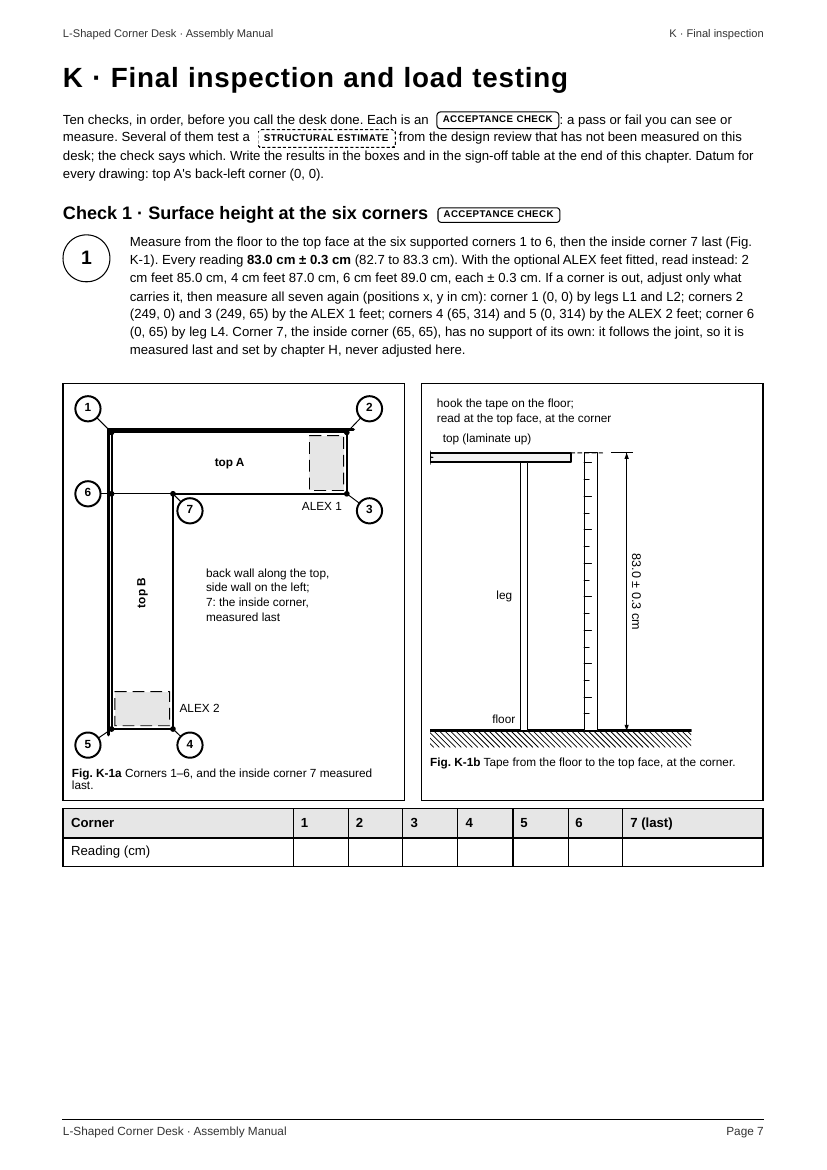
manual/build/png/manual-checks/p-07.png
