scotthowson/desk-setup/manual/build/png/manual-checks/p-08.png

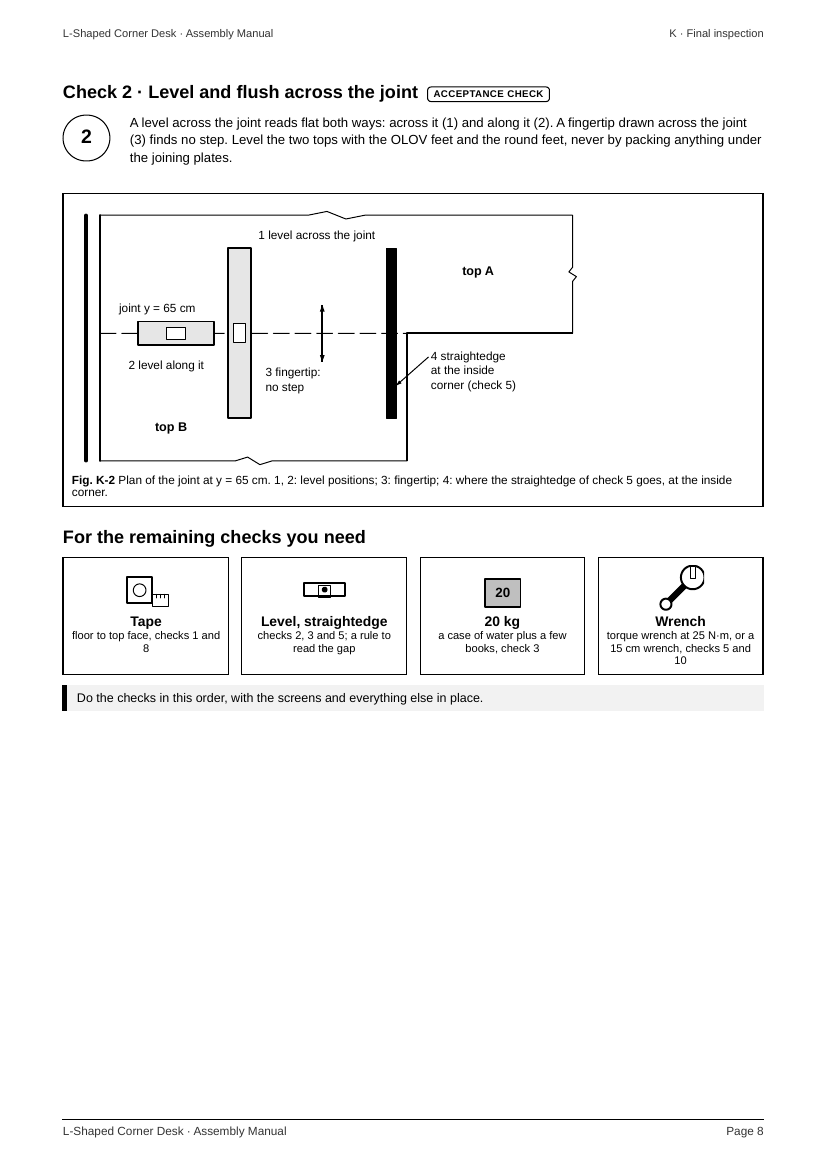
manual/build/png/manual-checks/p-08.png
