scotthowson/desk-setup/manual/build/png/manual-checks/p-09.png

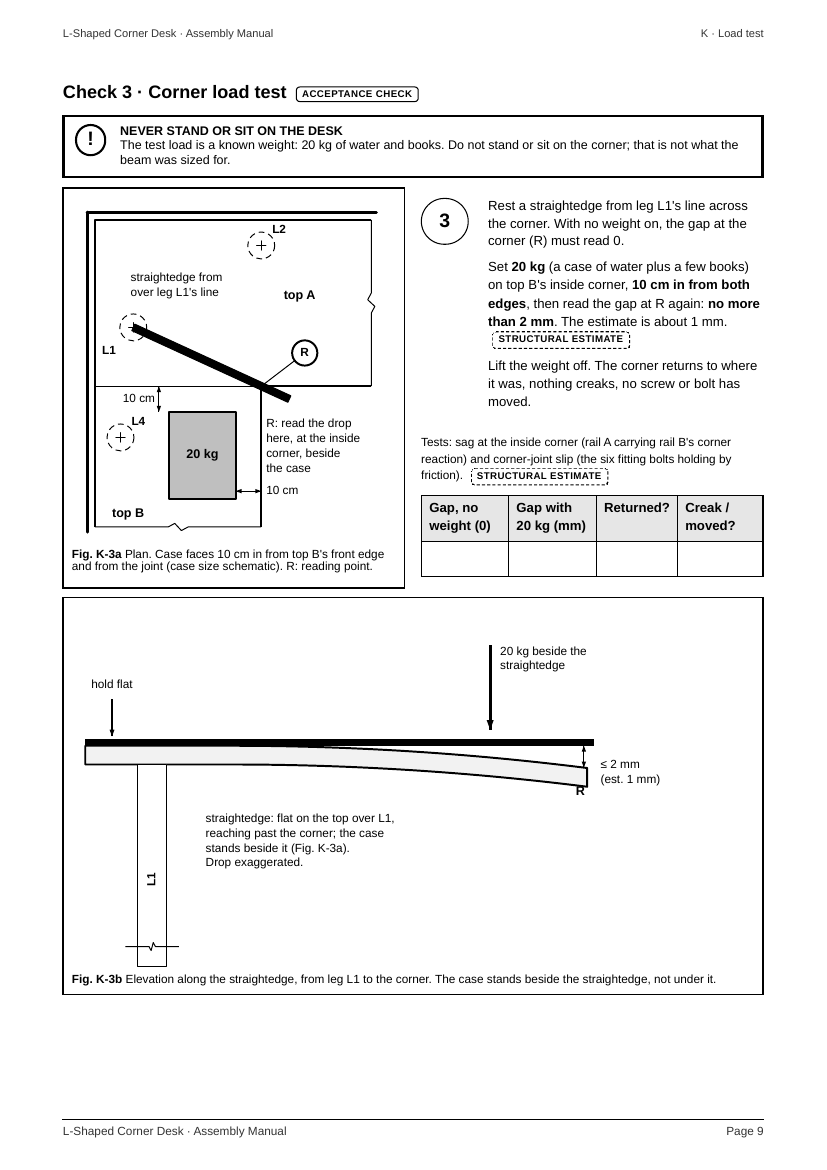
manual/build/png/manual-checks/p-09.png
