scotthowson/desk-setup/manual/build/png/manual-checks/p-10.png

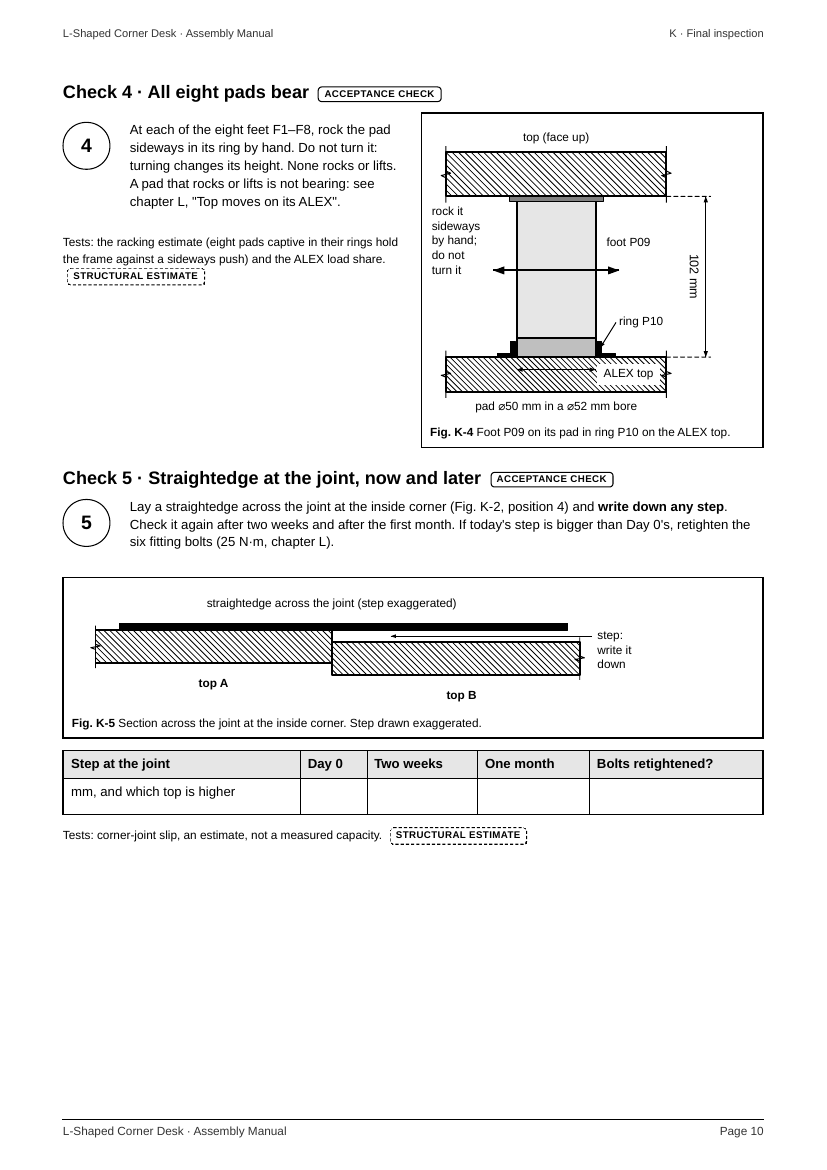
manual/build/png/manual-checks/p-10.png
