scotthowson/desk-setup/manual/build/png/manual-checks/p-11.png

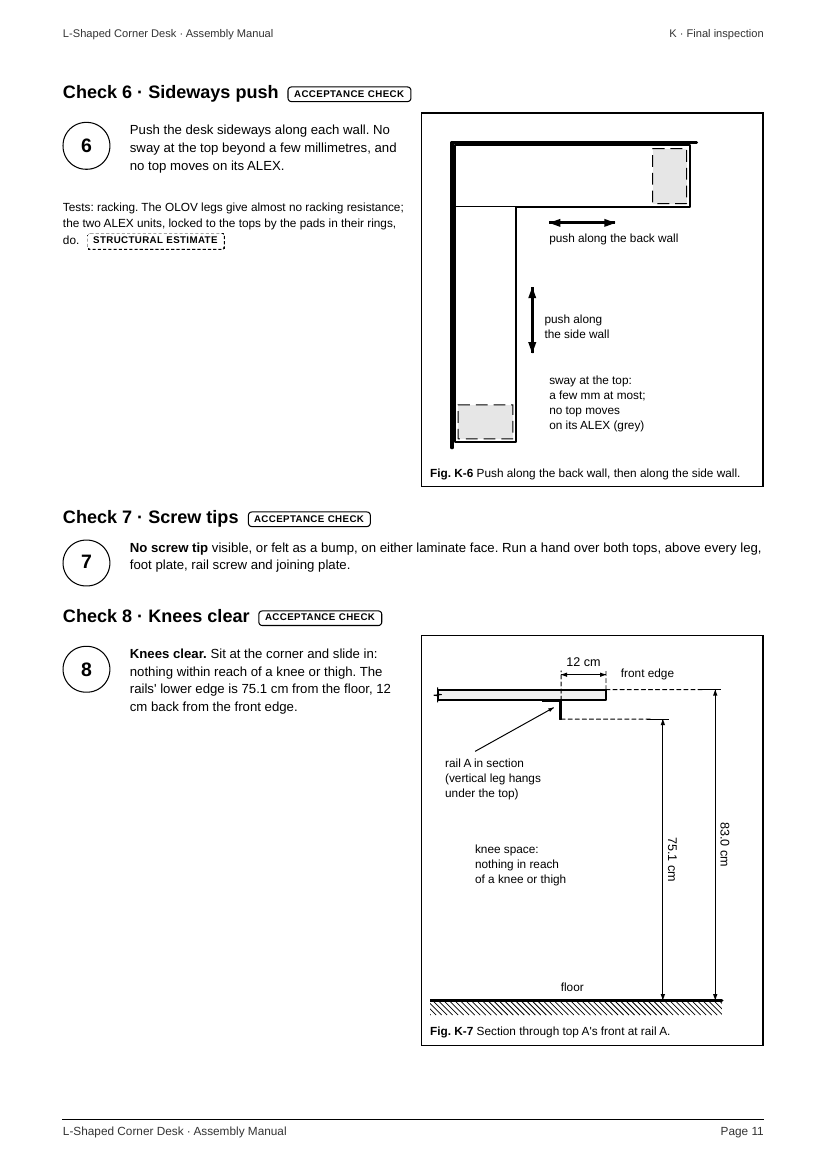
manual/build/png/manual-checks/p-11.png
