scotthowson/desk-setup/manual/build/png/manual-checks/p-12.png

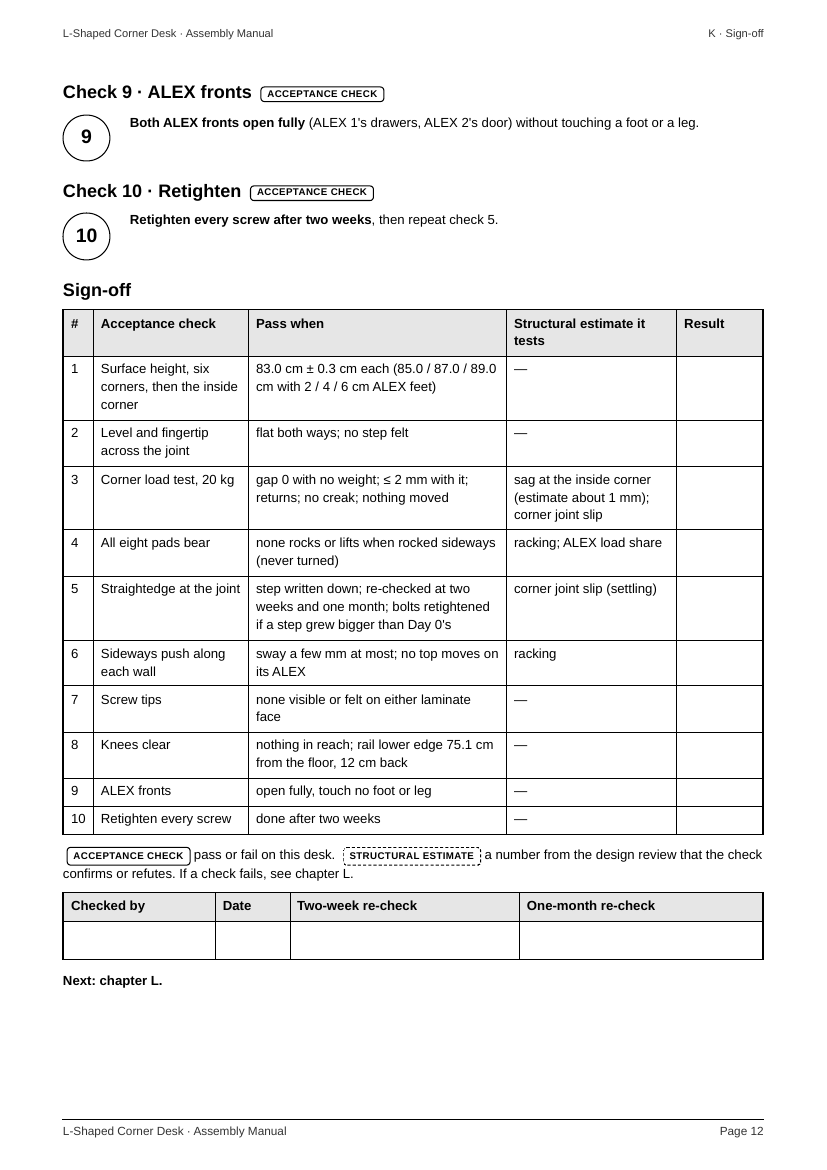
manual/build/png/manual-checks/p-12.png
