scotthowson/desk-setup/manual/build/png/manual-checks/p-13.png

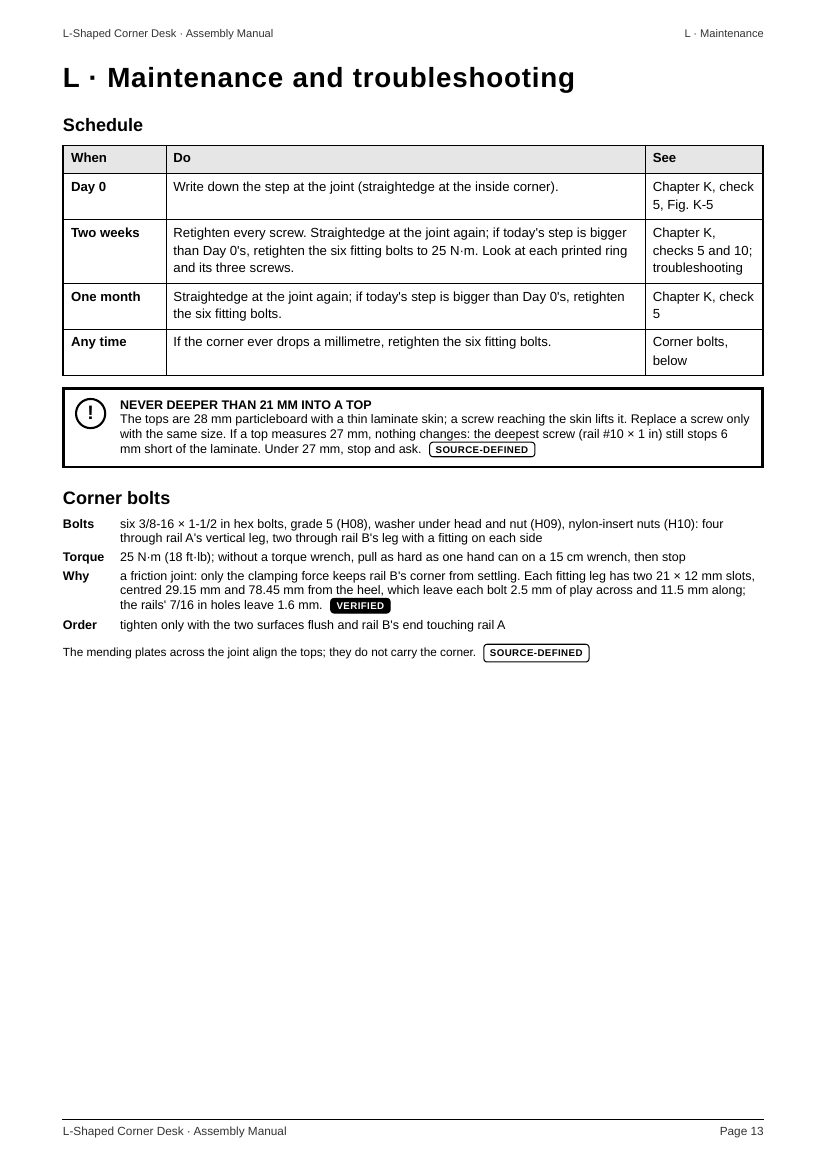
manual/build/png/manual-checks/p-13.png
