scotthowson/desk-setup/manual/build/png/manual-checks/p-14.png

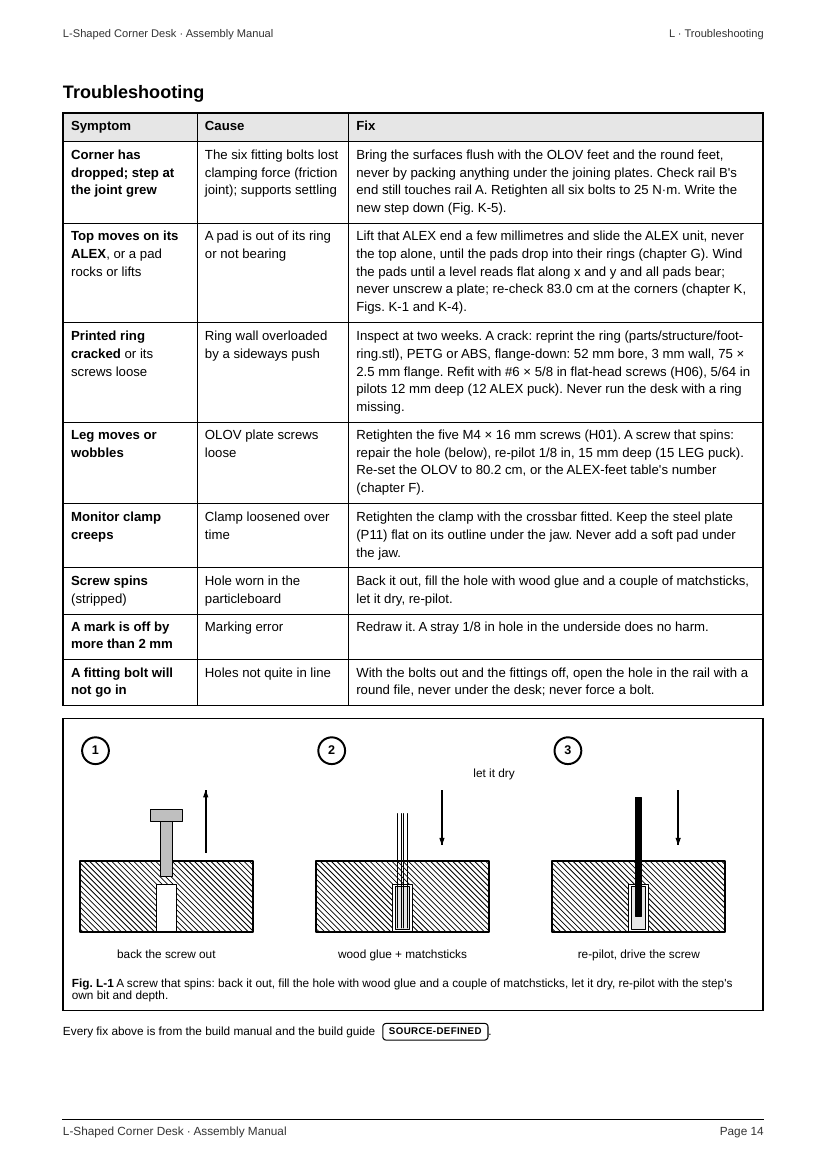
manual/build/png/manual-checks/p-14.png
