scotthowson/desk-setup/manual/build/png/manual-checks/p-15.png

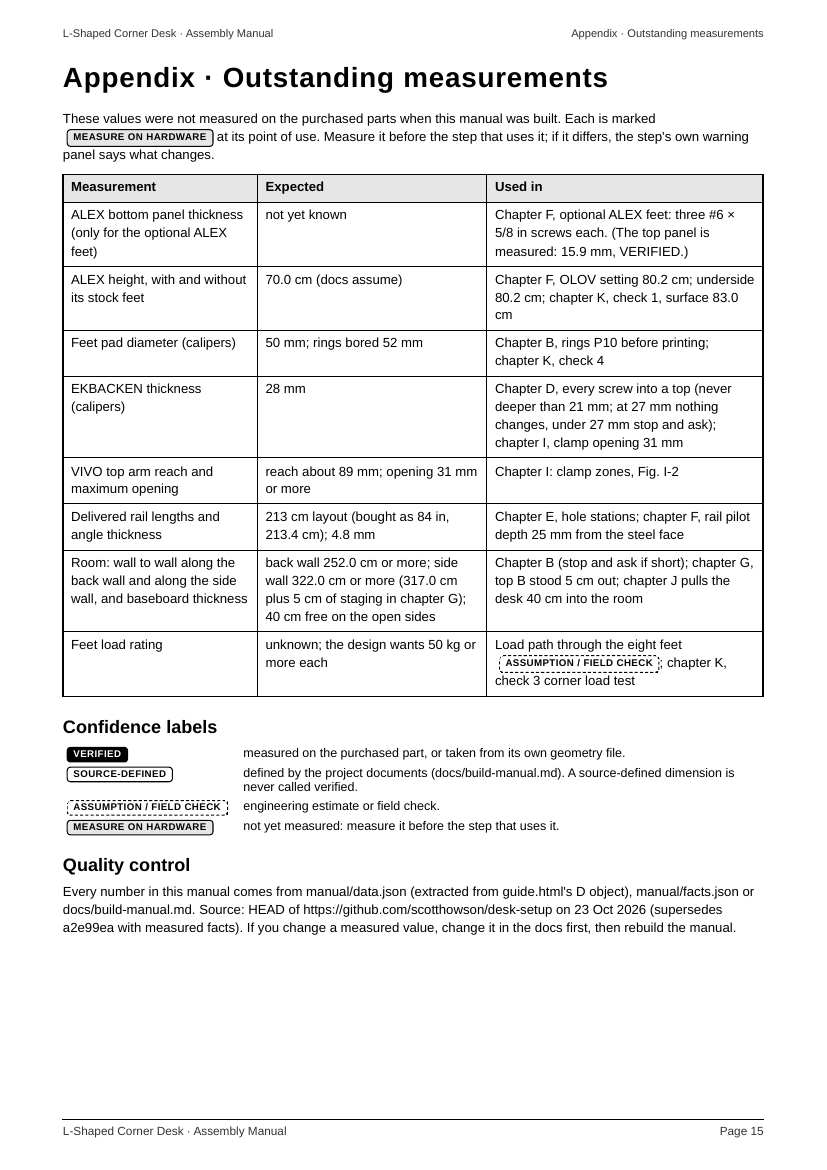
manual/build/png/manual-checks/p-15.png
