scotthowson/desk-setup/manual/build/png/manual-prep/p-01.png

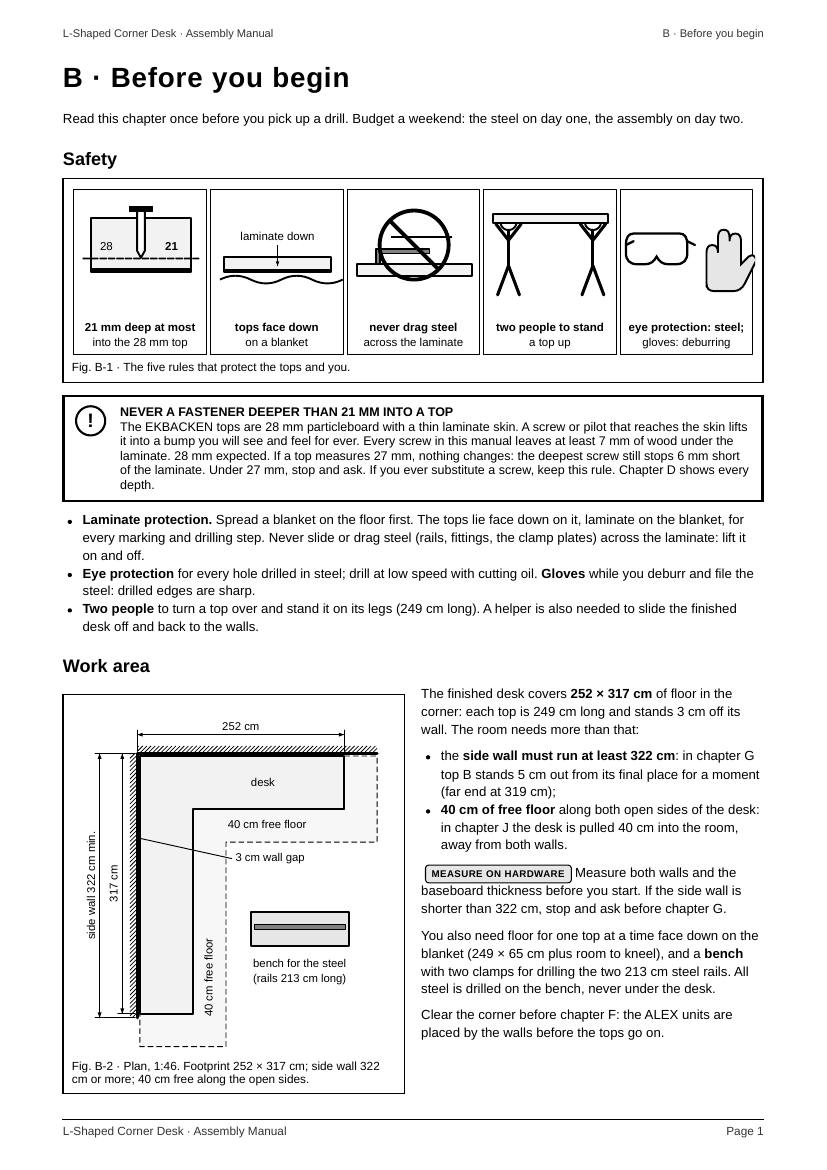
manual/build/png/manual-prep/p-01.png
