scotthowson/desk-setup/manual/build/png/manual-prep/p-03.png

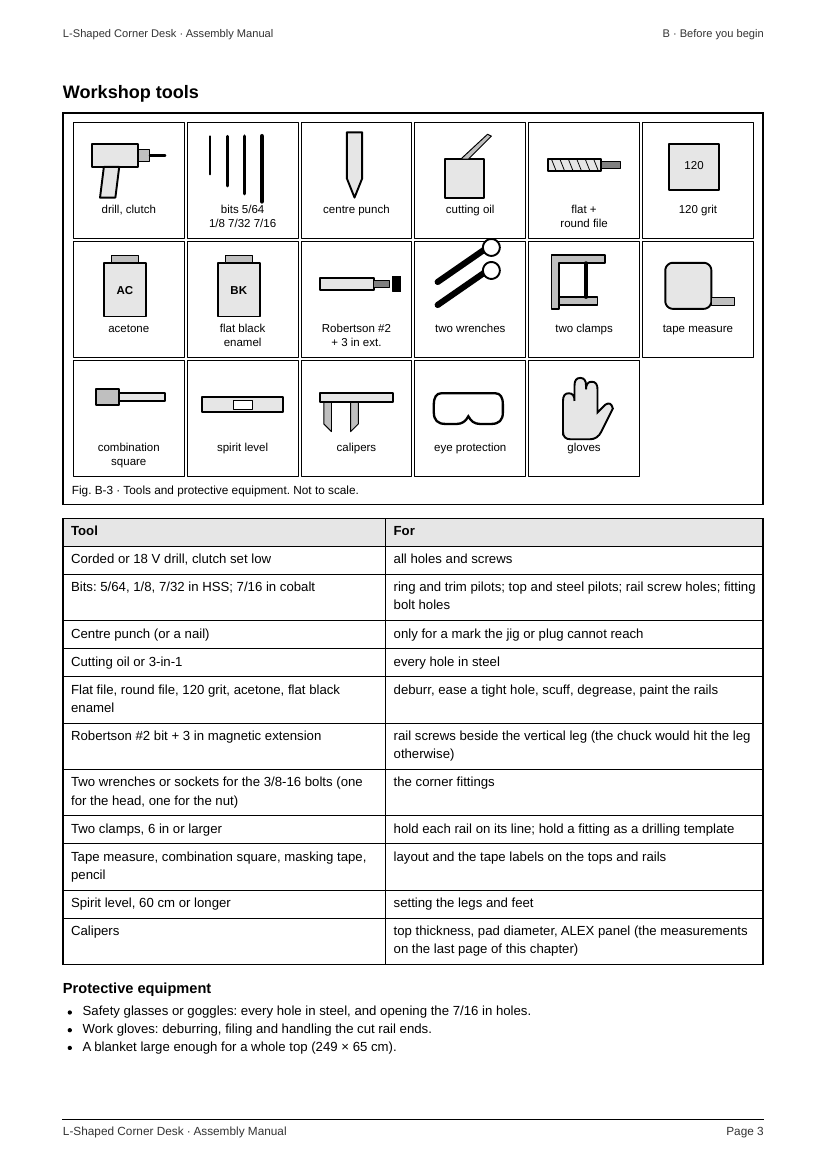
manual/build/png/manual-prep/p-03.png
