scotthowson/desk-setup/manual/build/png/manual-prep/p-04.png

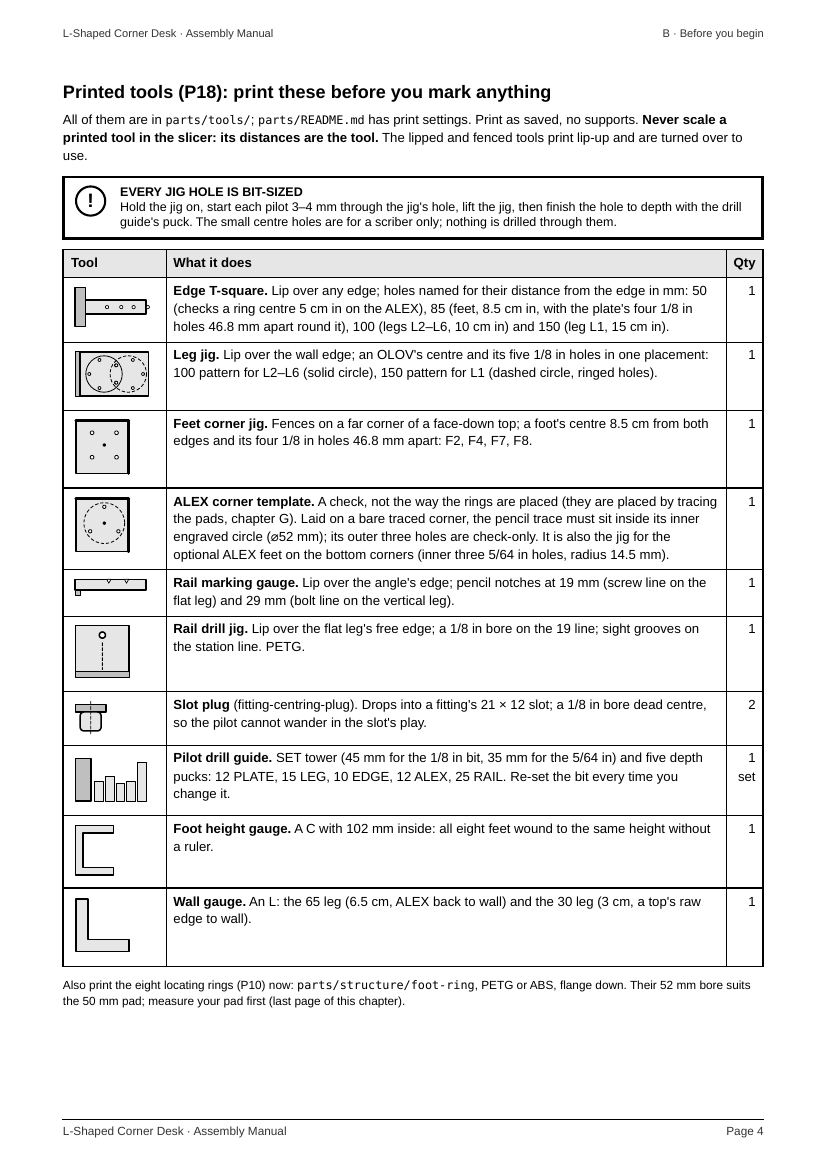
manual/build/png/manual-prep/p-04.png
