scotthowson/desk-setup/manual/build/png/manual-prep/p-05.png

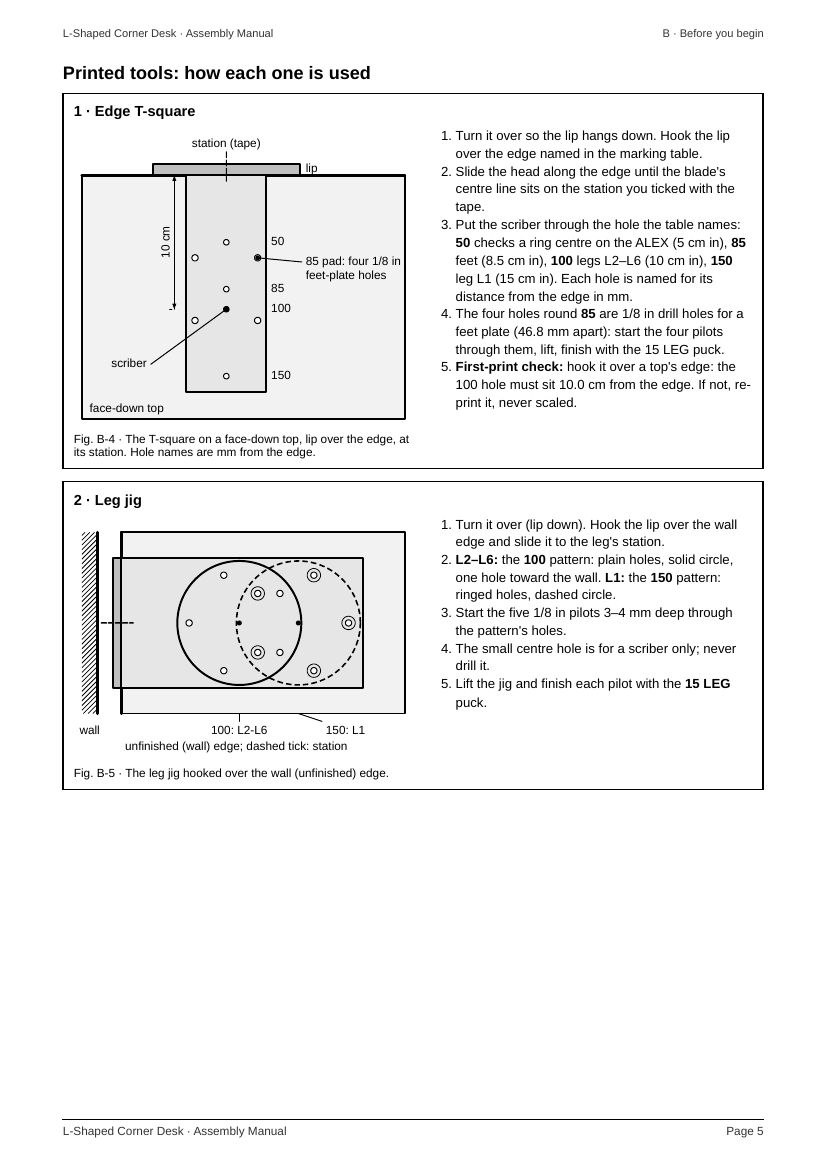
manual/build/png/manual-prep/p-05.png
