scotthowson/desk-setup/manual/build/png/manual-prep/p-06.png

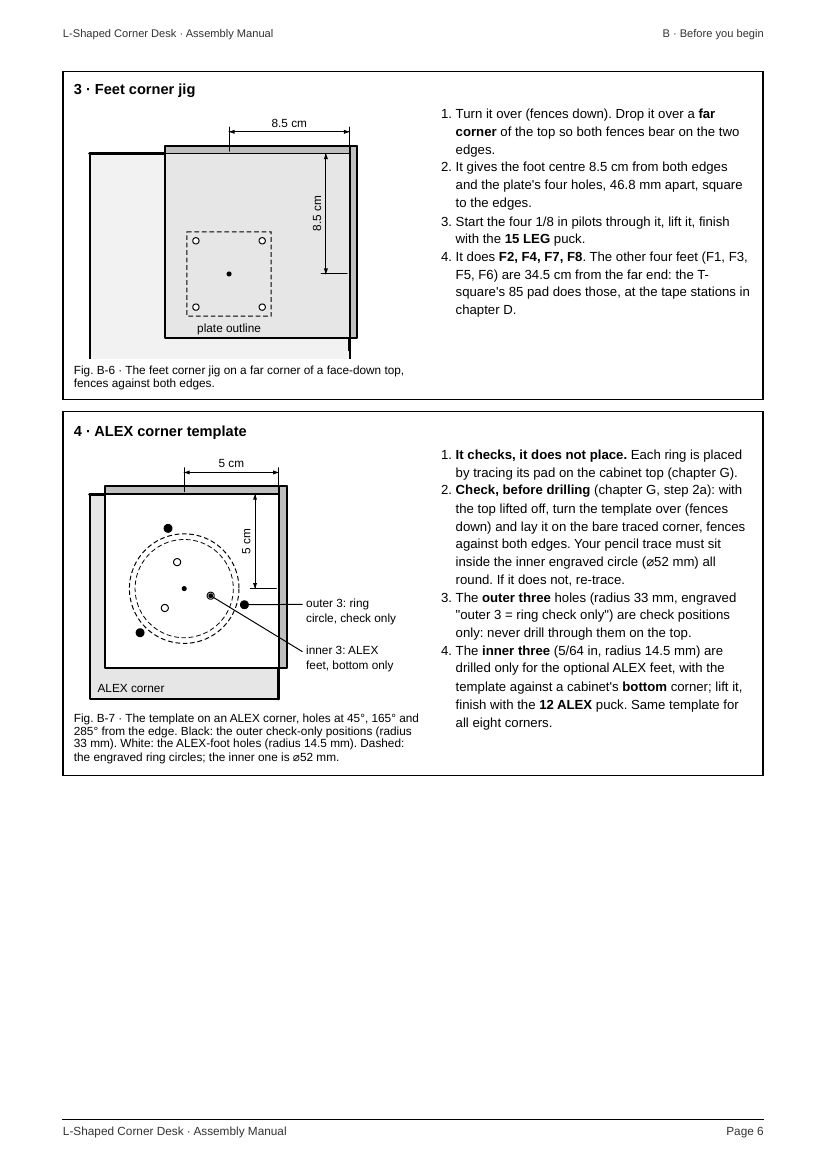
manual/build/png/manual-prep/p-06.png
