scotthowson/desk-setup/manual/build/png/manual-prep/p-07.png

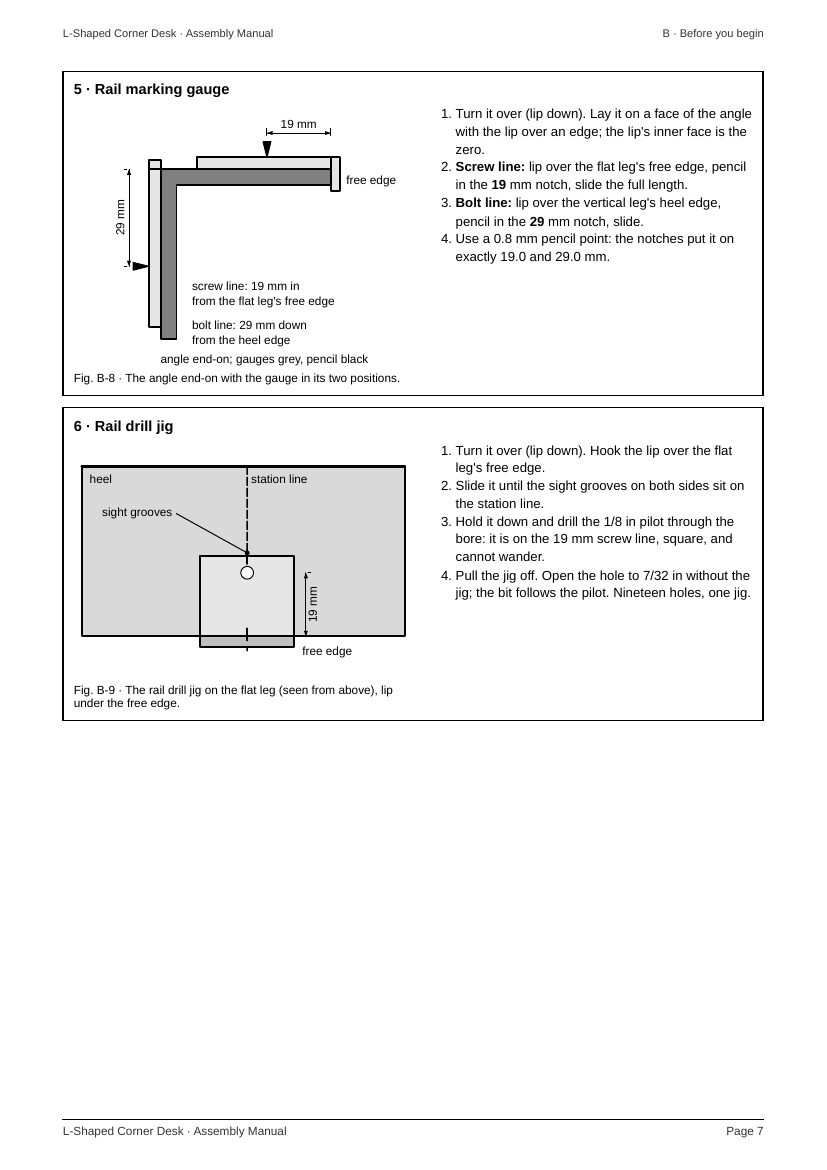
manual/build/png/manual-prep/p-07.png
