scotthowson/desk-setup/manual/build/png/manual-prep/p-08.png

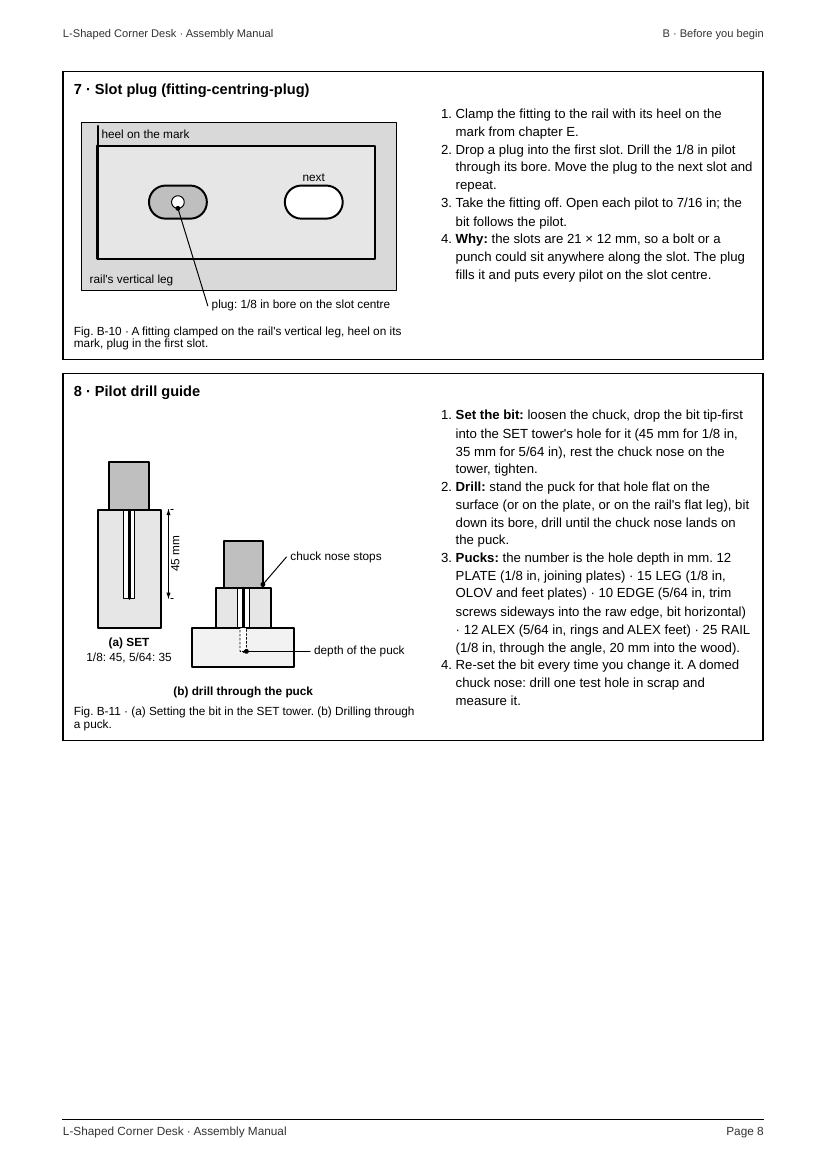
manual/build/png/manual-prep/p-08.png
