scotthowson/desk-setup/manual/build/png/manual-prep/p-09.png

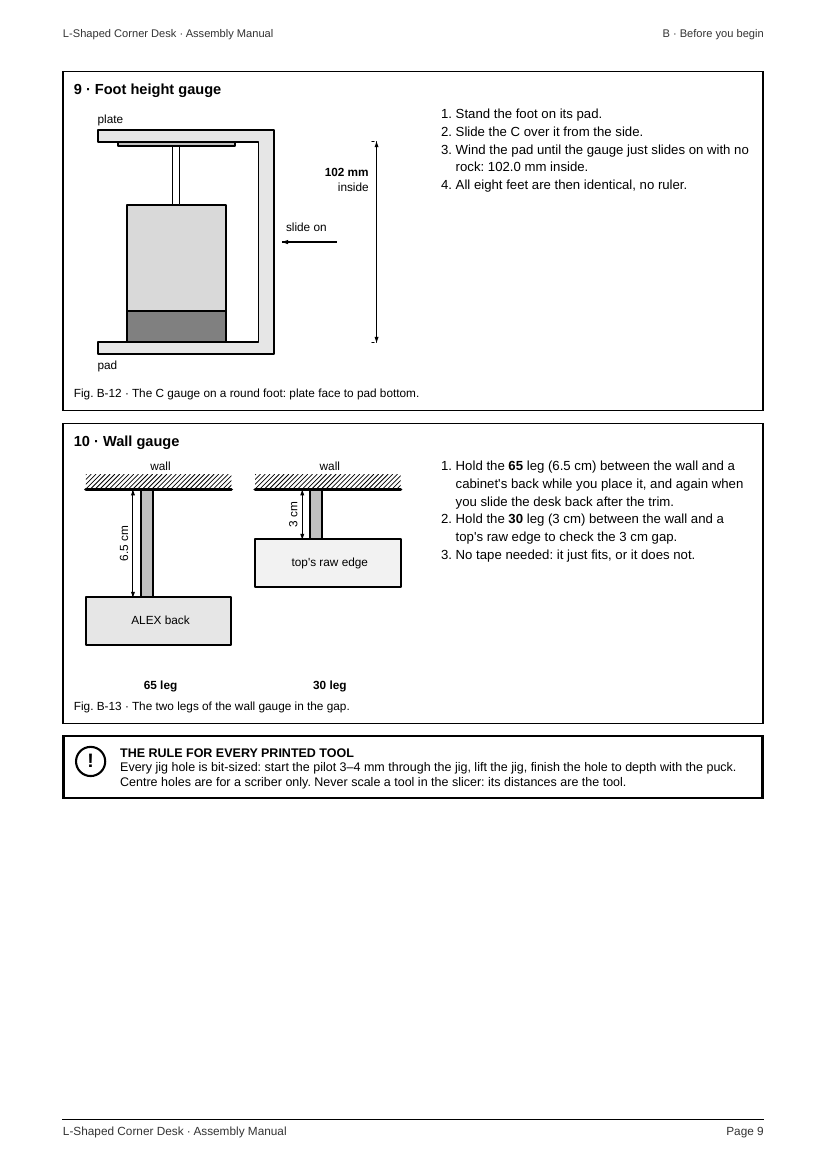
manual/build/png/manual-prep/p-09.png
