scotthowson/desk-setup/manual/build/png/manual-prep/p-10.png

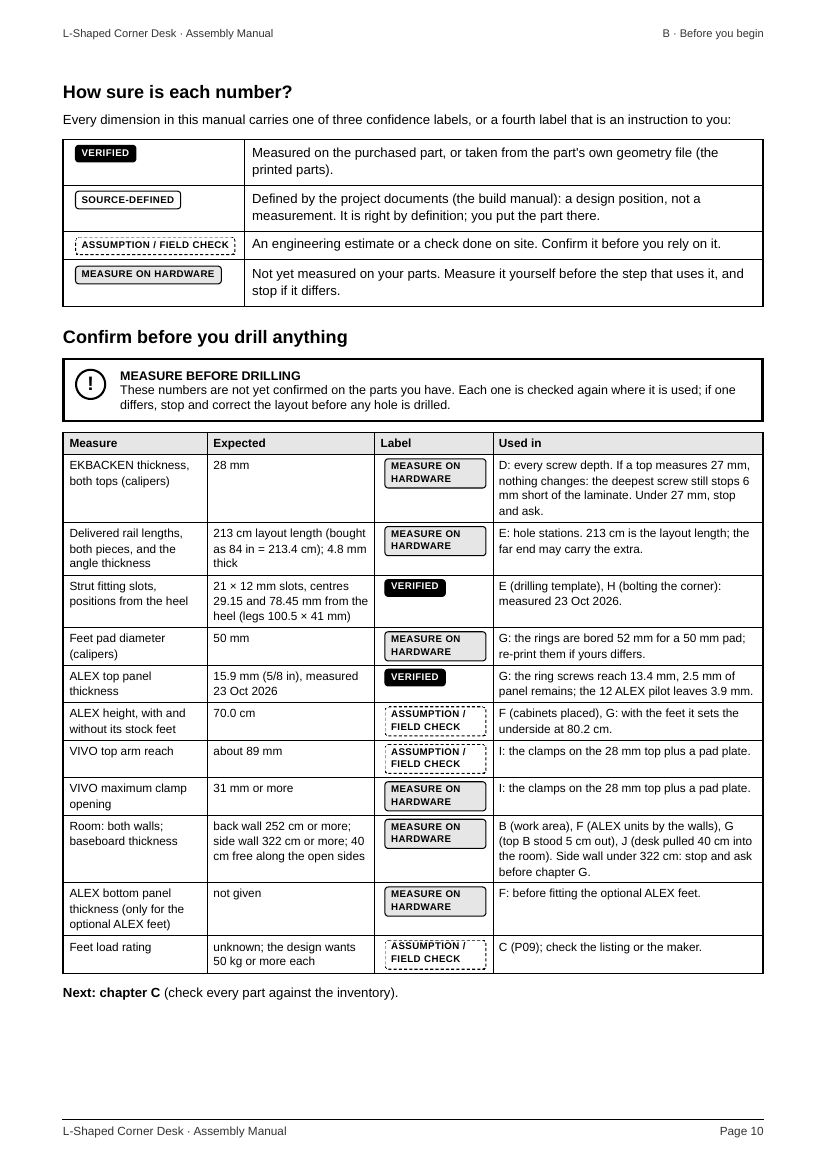
manual/build/png/manual-prep/p-10.png
