scotthowson/desk-setup/manual/build/png/manual-prep/p-11.png

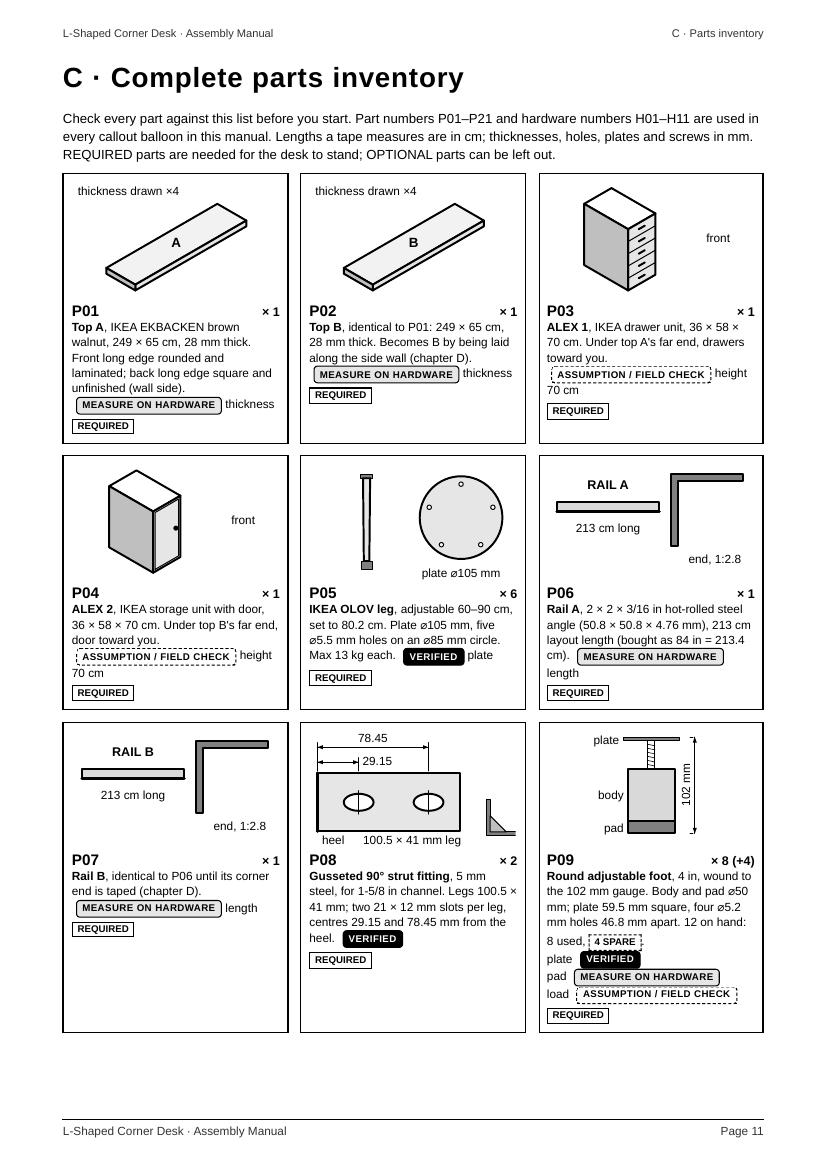
manual/build/png/manual-prep/p-11.png
