scotthowson/desk-setup/manual/build/png/manual-prep/p-12.png

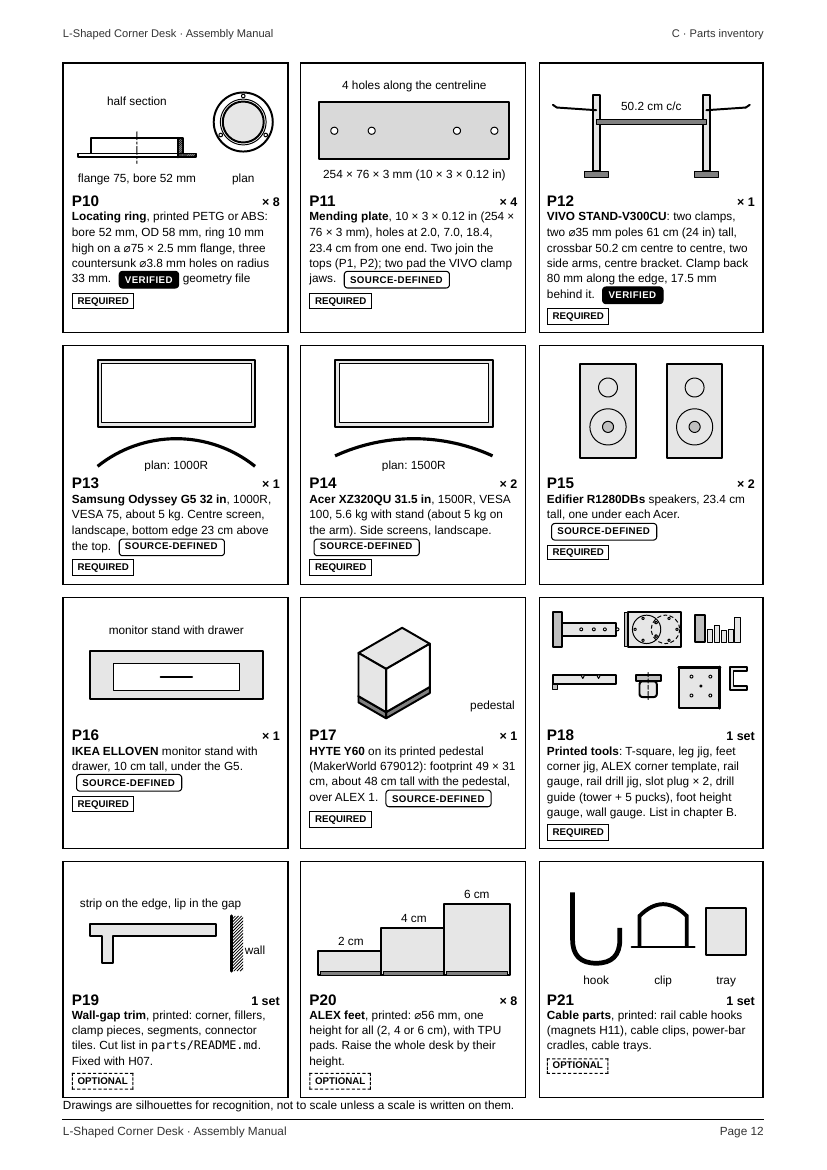
manual/build/png/manual-prep/p-12.png
