scotthowson/desk-setup/manual/build/png/manual-prep/p-13.png

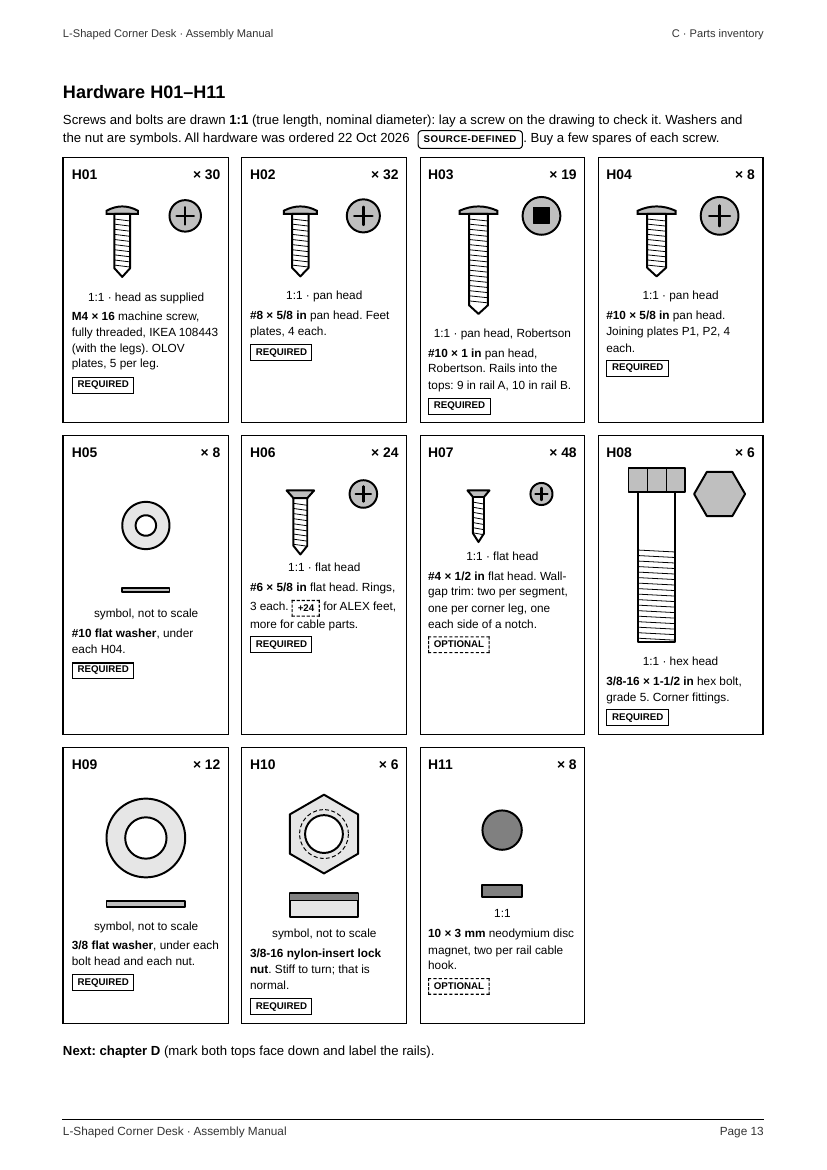
manual/build/png/manual-prep/p-13.png
