scotthowson/desk-setup/manual/build/png/manual-prep/p-14.png

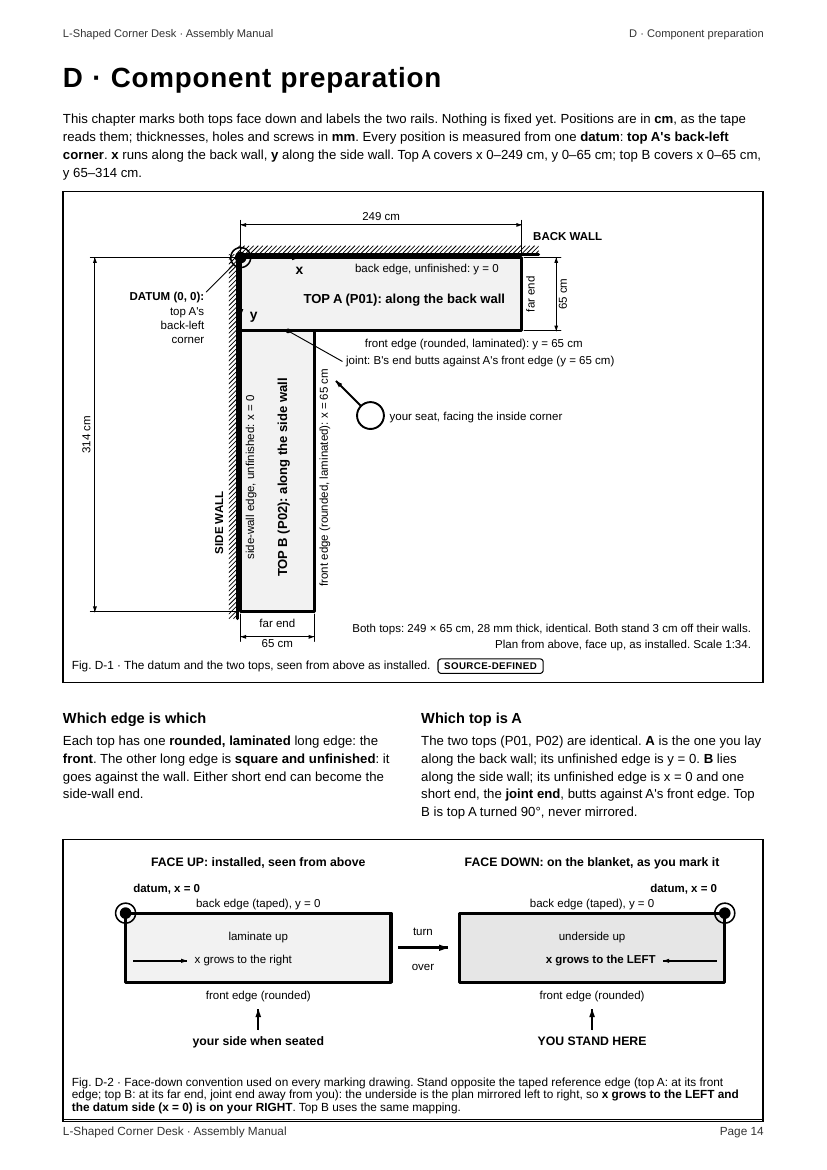
manual/build/png/manual-prep/p-14.png
