scotthowson/desk-setup/manual/build/png/manual-prep/p-15.png

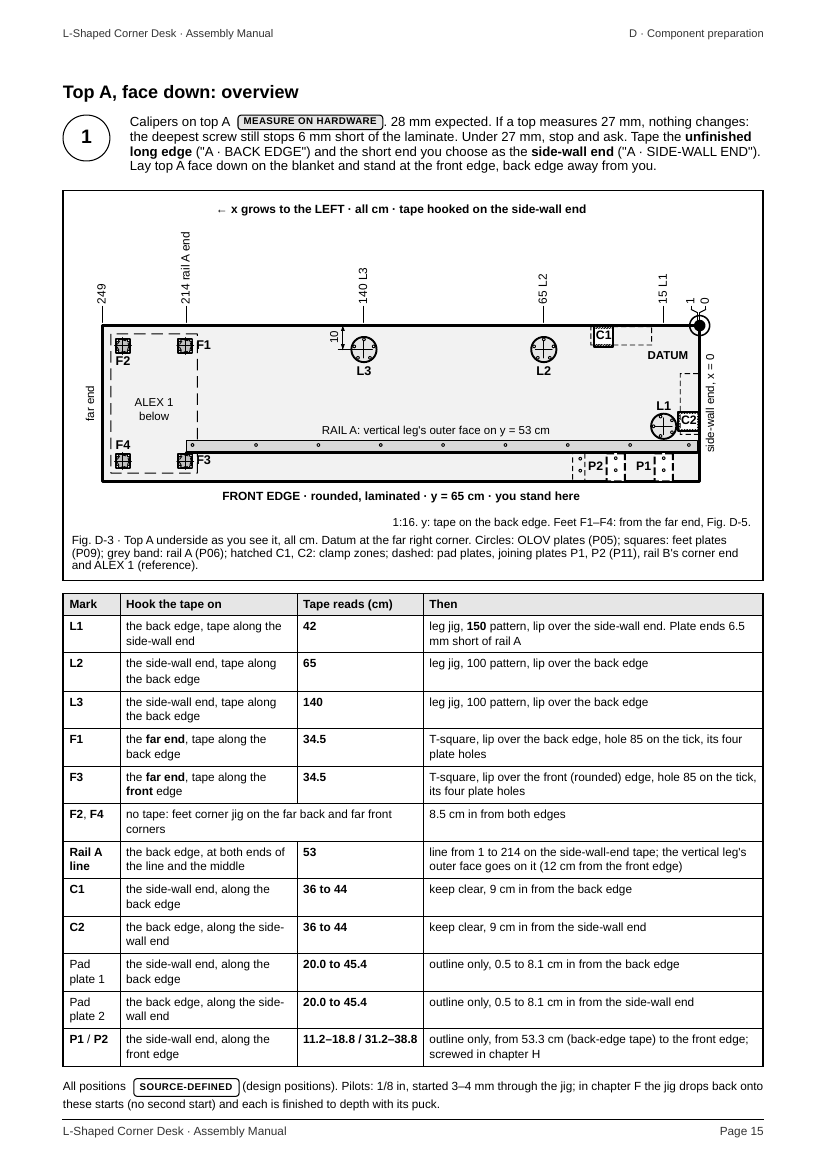
manual/build/png/manual-prep/p-15.png
