scotthowson/desk-setup/manual/build/png/manual-prep/p-16.png

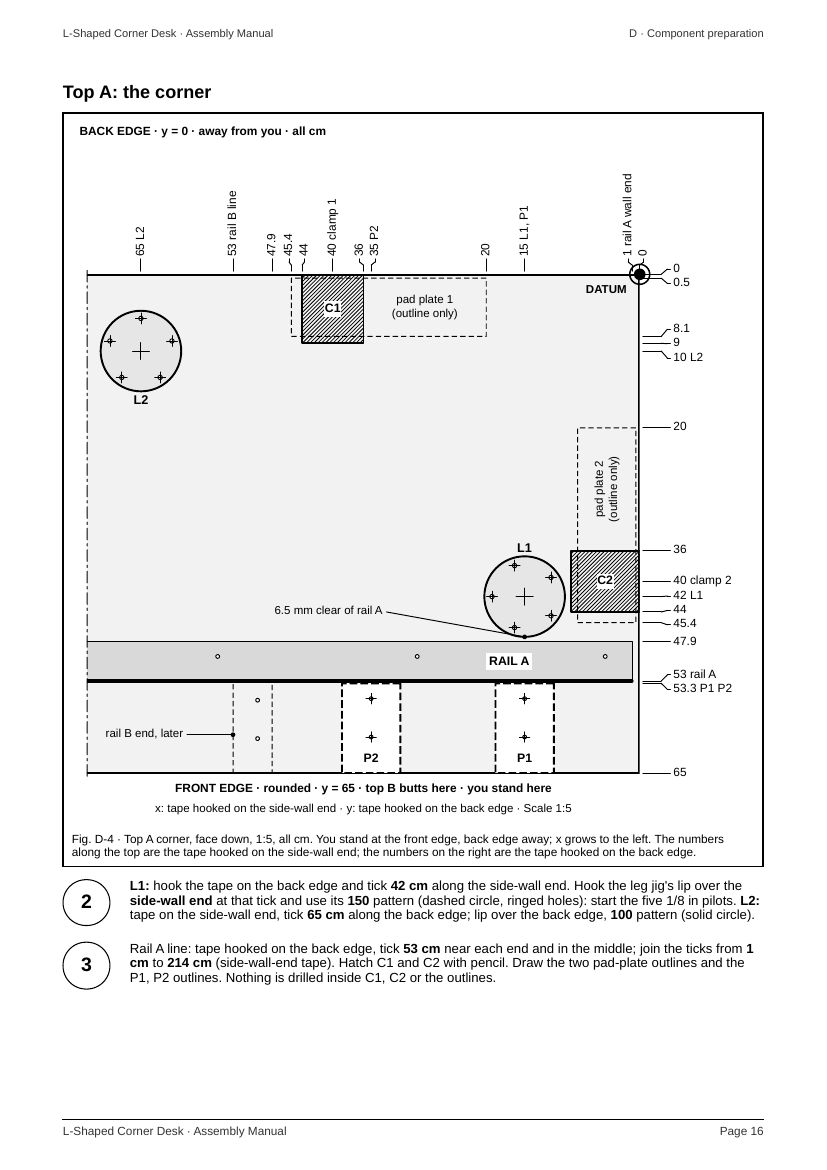
manual/build/png/manual-prep/p-16.png
