scotthowson/desk-setup/manual/build/png/manual-prep/p-17.png

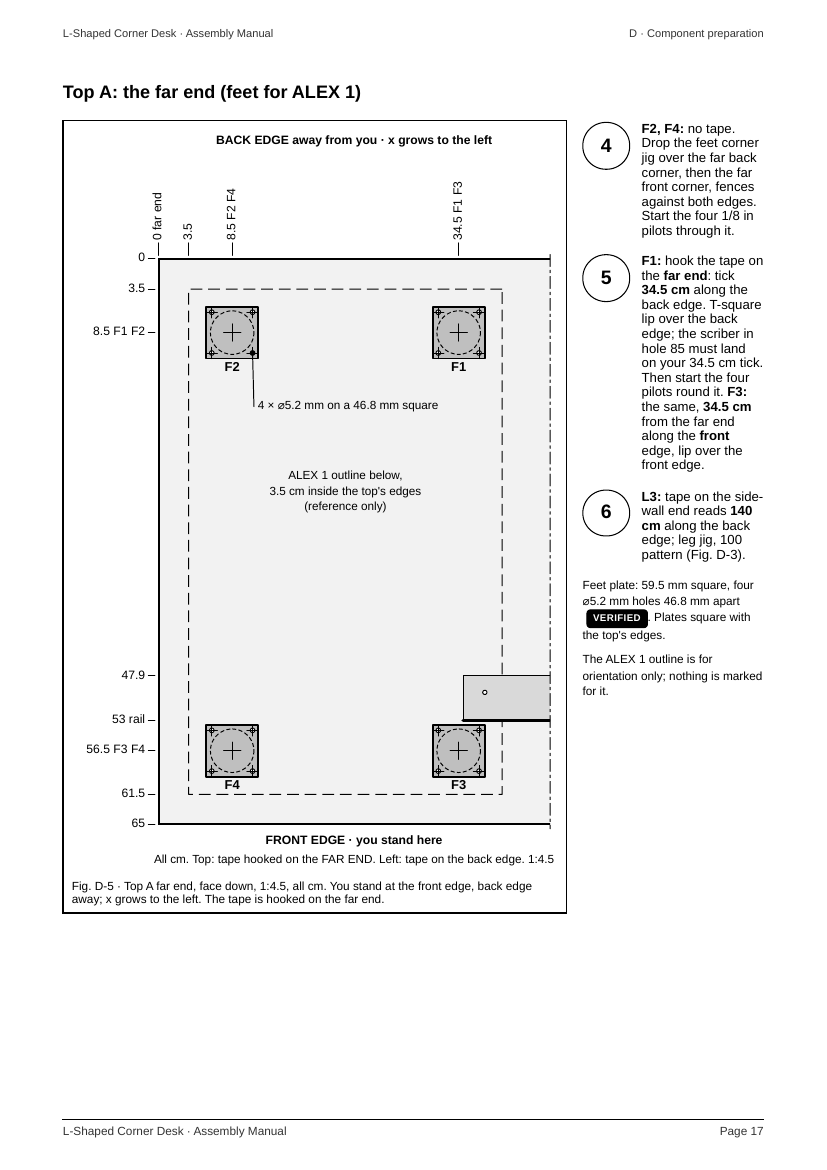
manual/build/png/manual-prep/p-17.png
