scotthowson/desk-setup/manual/build/png/manual-prep/p-18.png

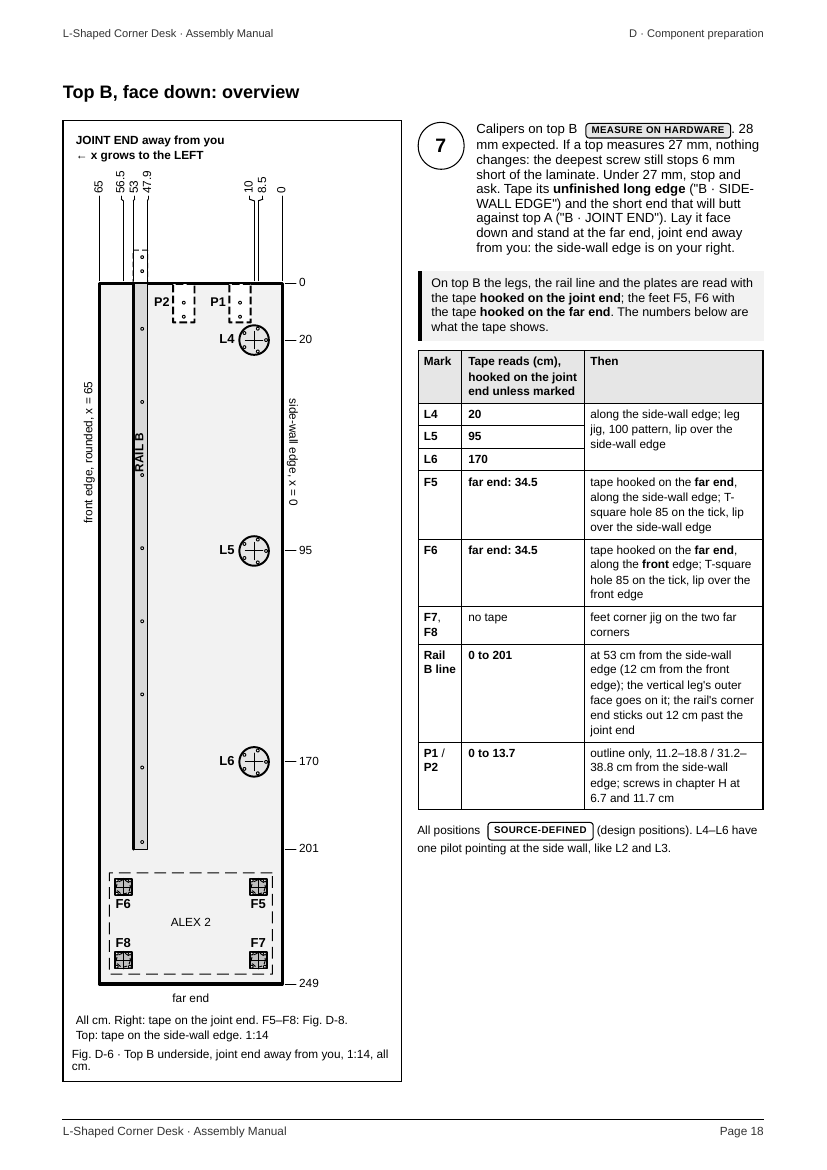
manual/build/png/manual-prep/p-18.png
