scotthowson/desk-setup/manual/build/png/manual-prep/p-19.png

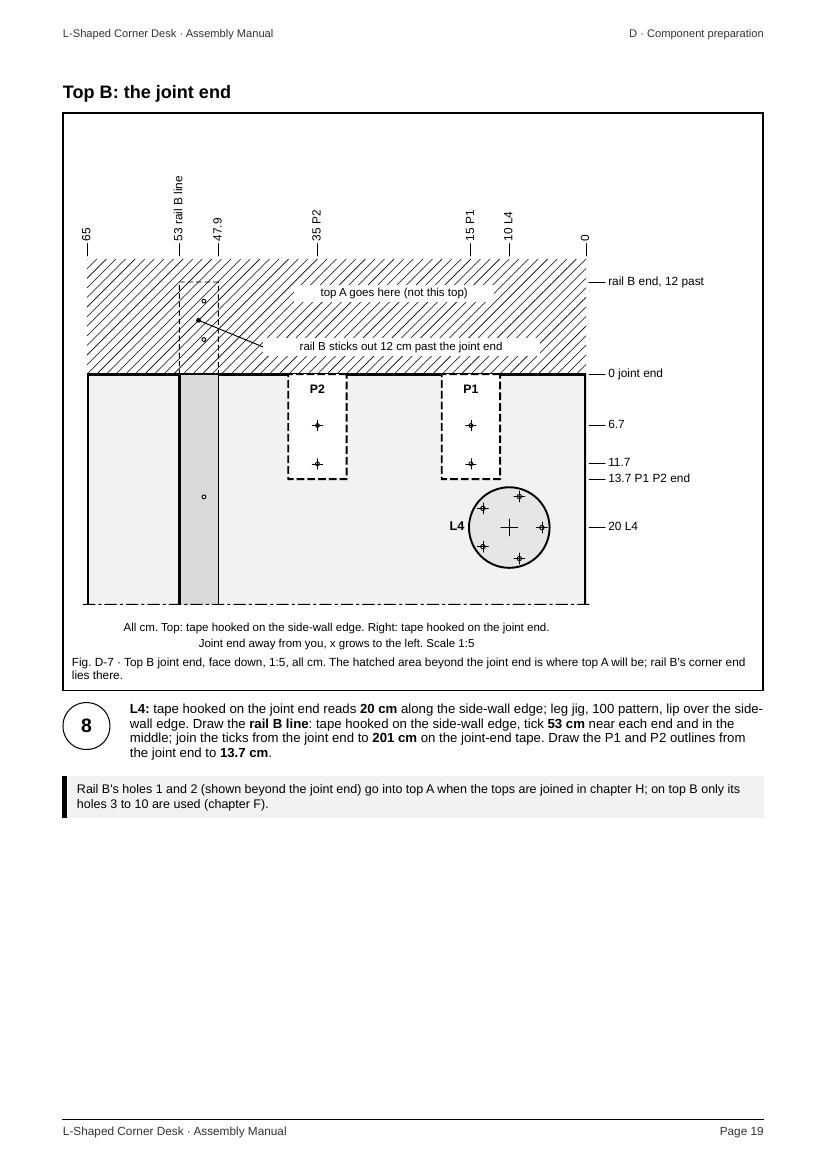
manual/build/png/manual-prep/p-19.png
