scotthowson/desk-setup/manual/build/png/manual-prep/p-20.png

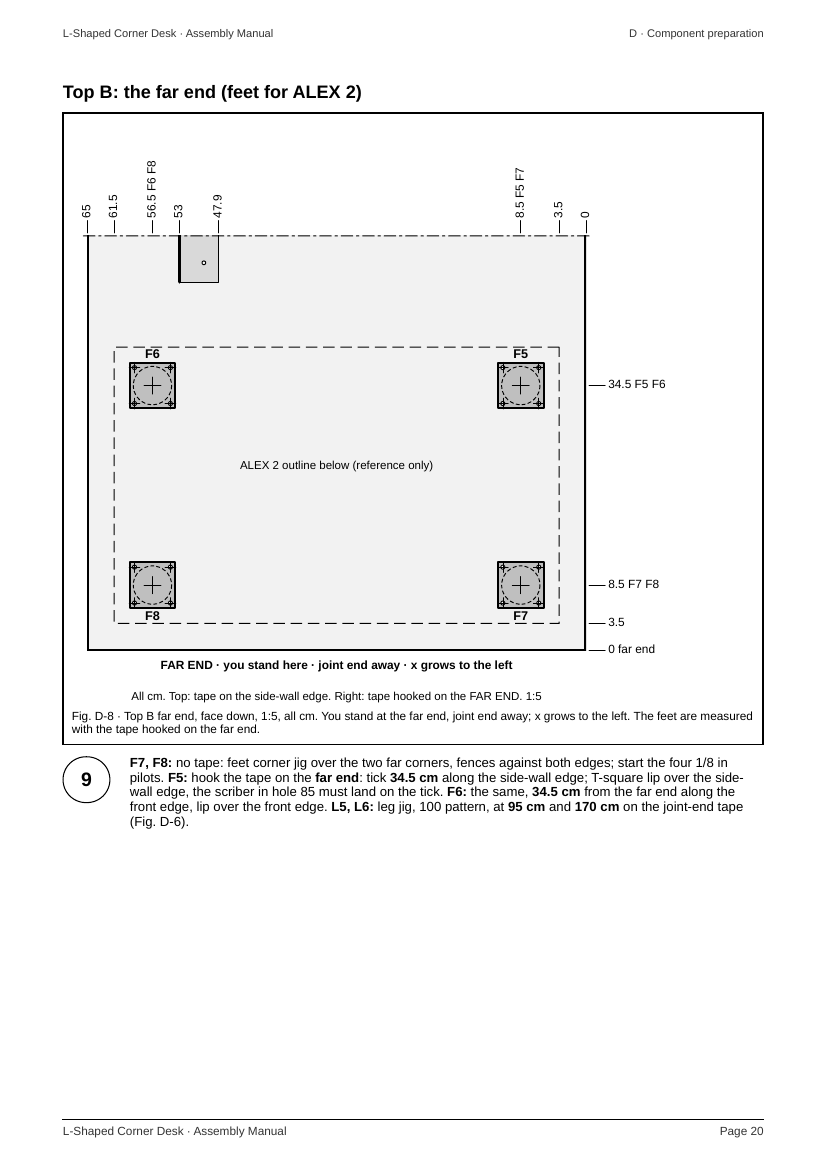
manual/build/png/manual-prep/p-20.png
