scotthowson/desk-setup/manual/build/png/manual-prep/p-21.png

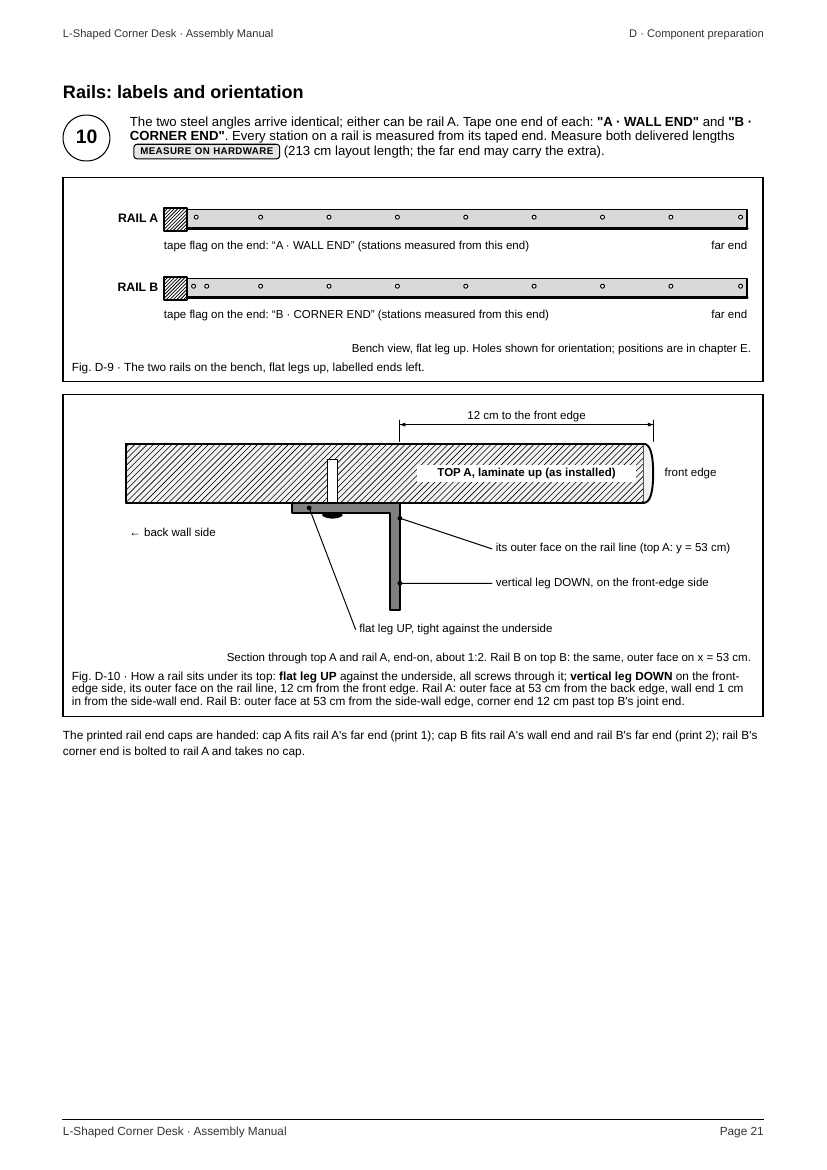
manual/build/png/manual-prep/p-21.png
