scotthowson/desk-setup/manual/build/png/manual-prep/p-22.png

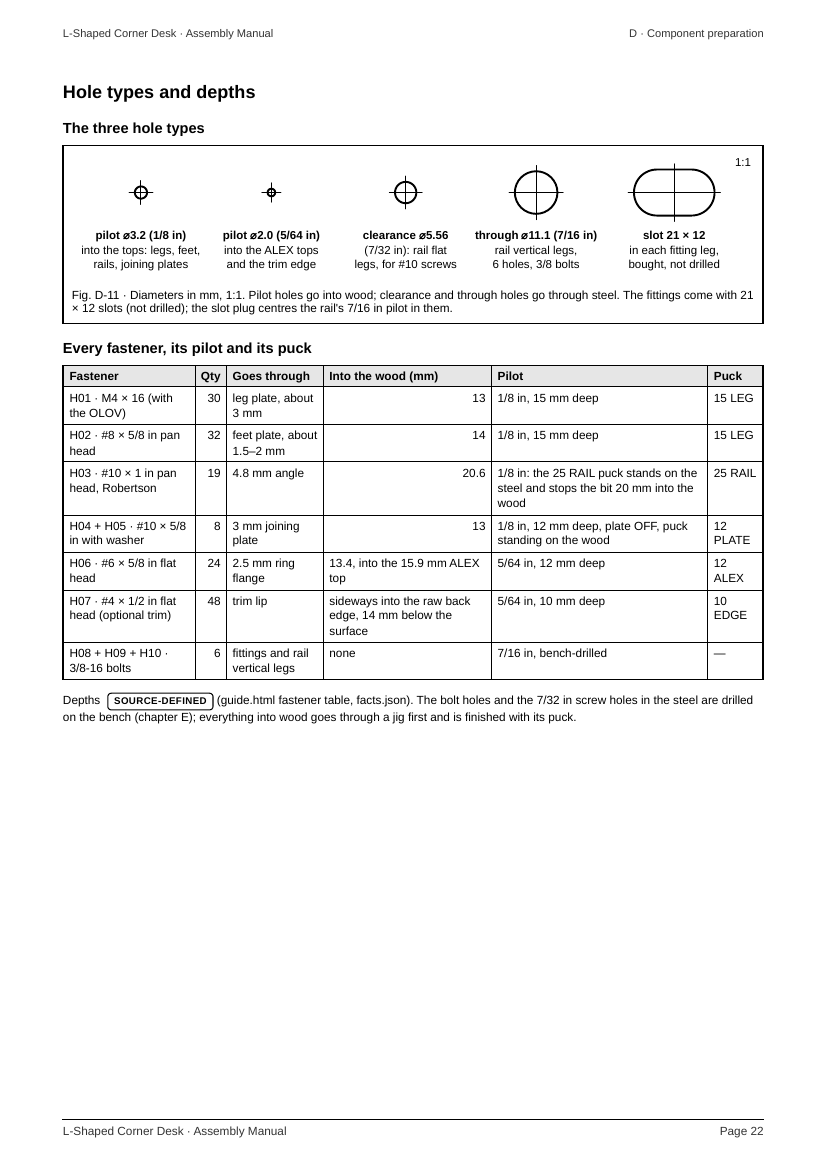
manual/build/png/manual-prep/p-22.png
