scotthowson/desk-setup/manual/build/png/manual-prep/p-23.png

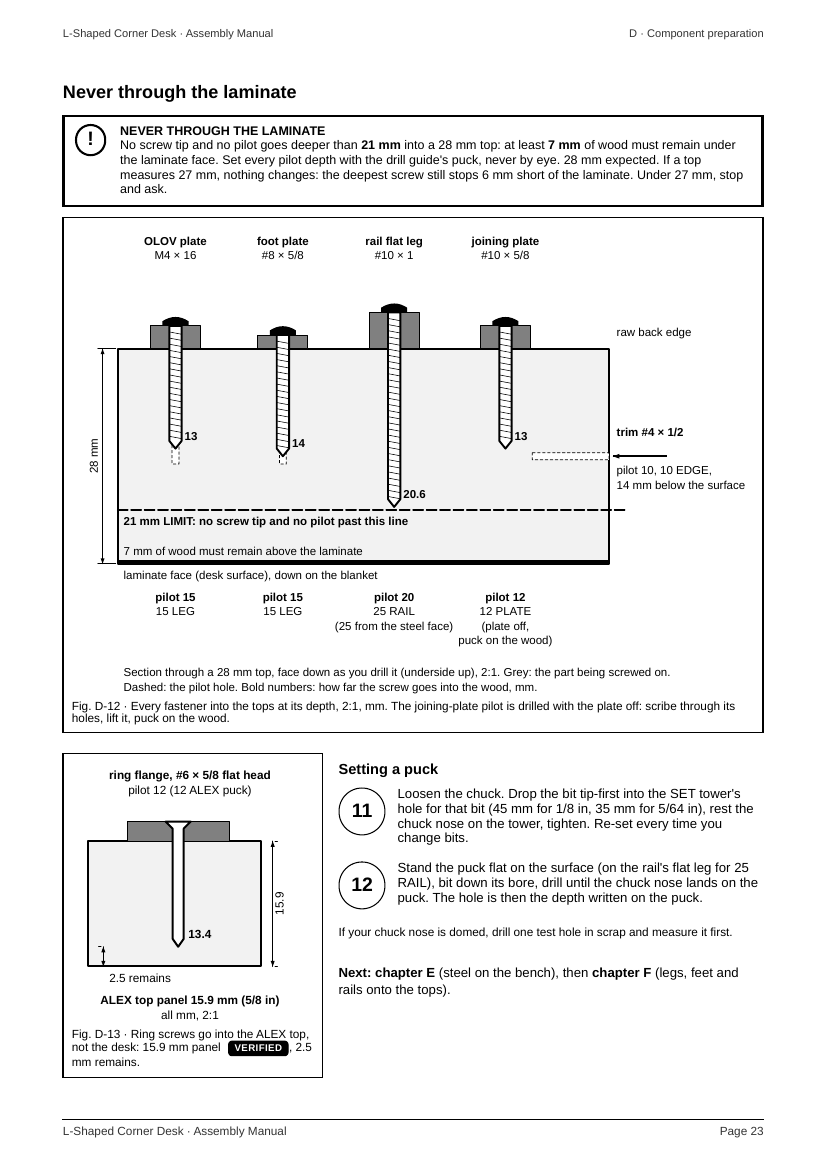
manual/build/png/manual-prep/p-23.png
