scotthowson/desk-setup/manual/build/png/manual-stand/p-01.png

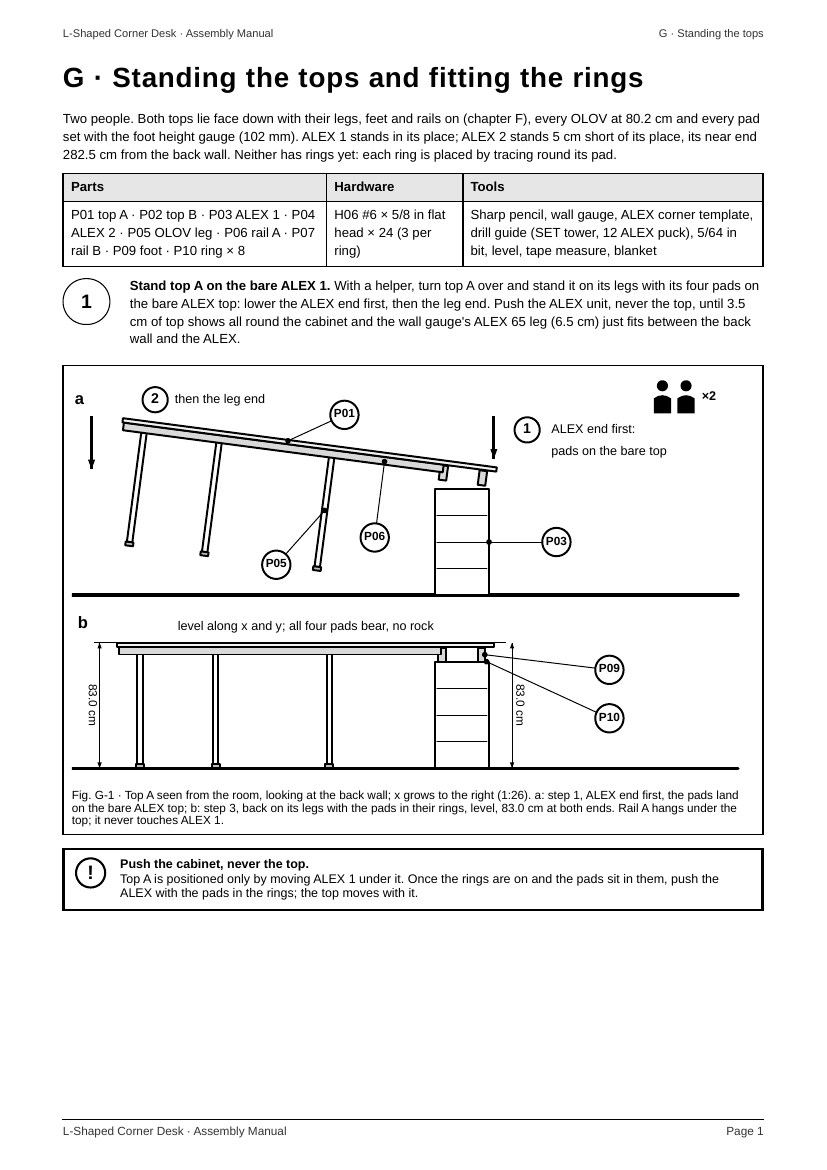
manual/build/png/manual-stand/p-01.png
