scotthowson/desk-setup/manual/build/png/manual-stand/p-02.png

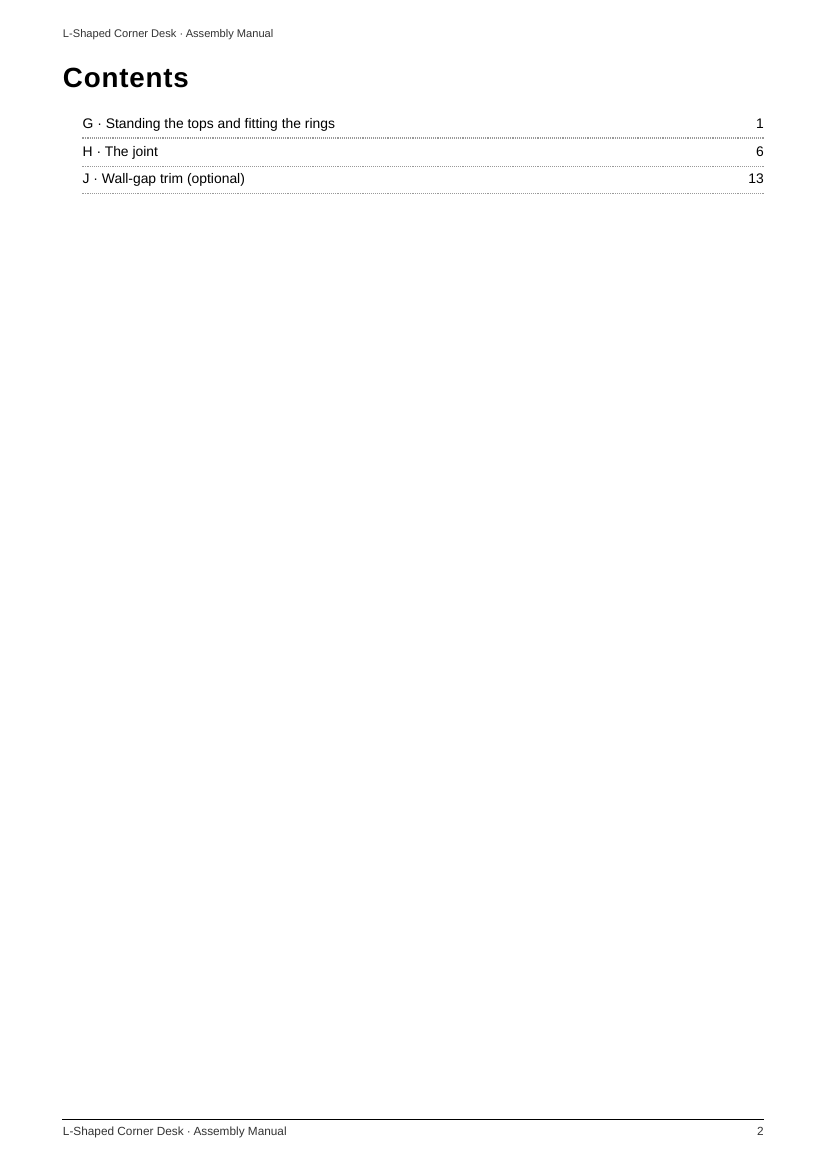
manual/build/png/manual-stand/p-02.png
