scotthowson/desk-setup/manual/build/png/manual-stand/p-03.png

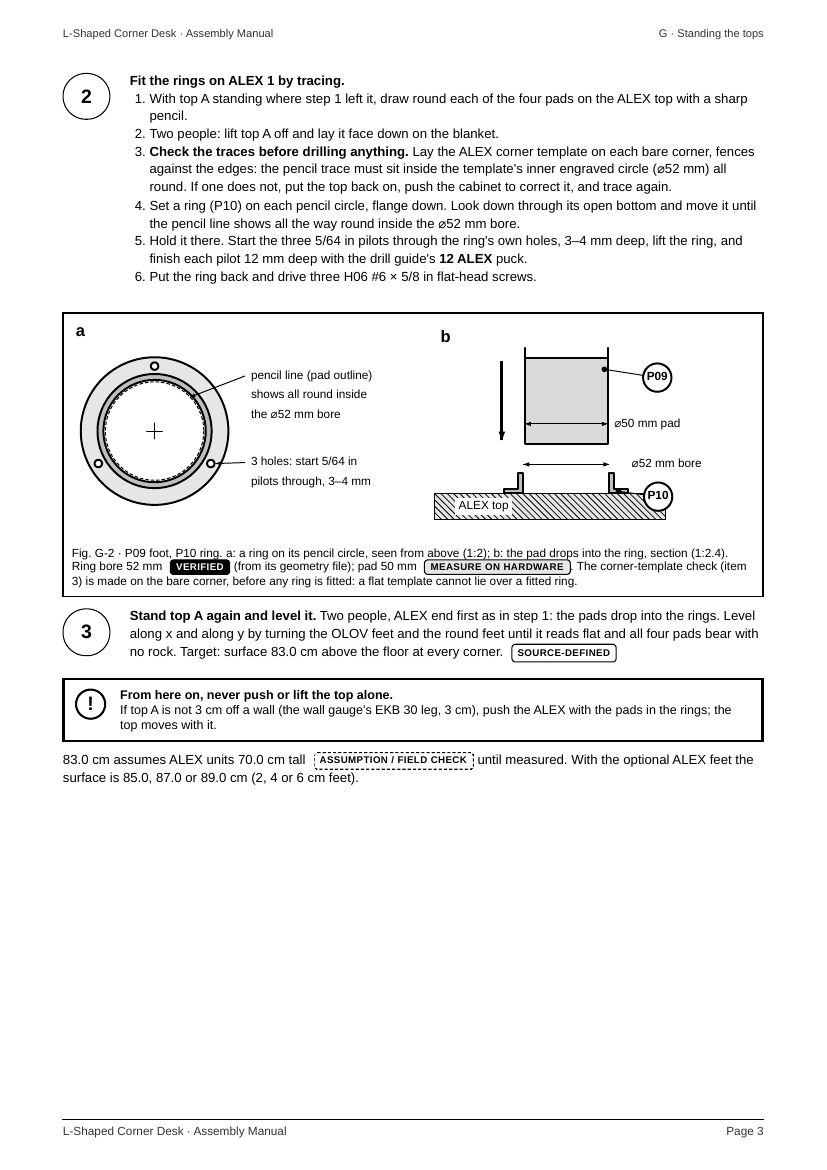
manual/build/png/manual-stand/p-03.png
