scotthowson/desk-setup/manual/build/png/manual-stand/p-04.png

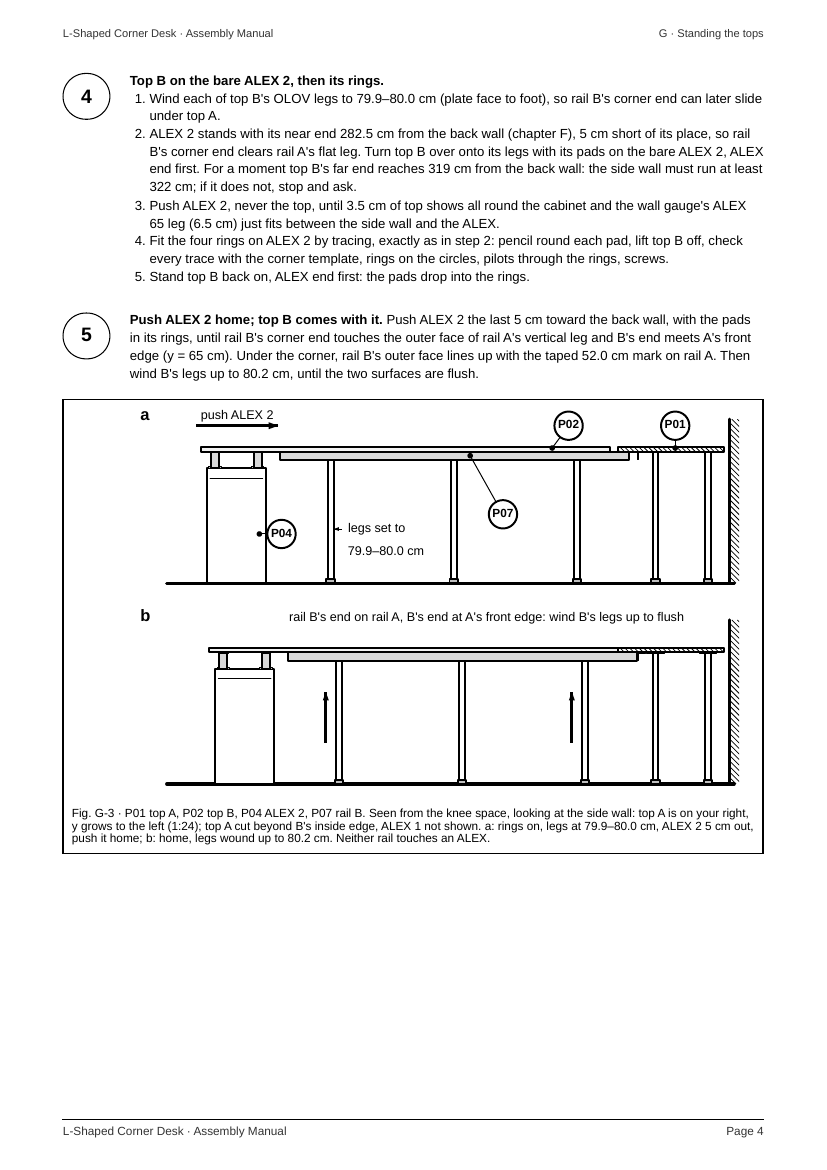
manual/build/png/manual-stand/p-04.png
