scotthowson/desk-setup/manual/build/png/manual-stand/p-05.png

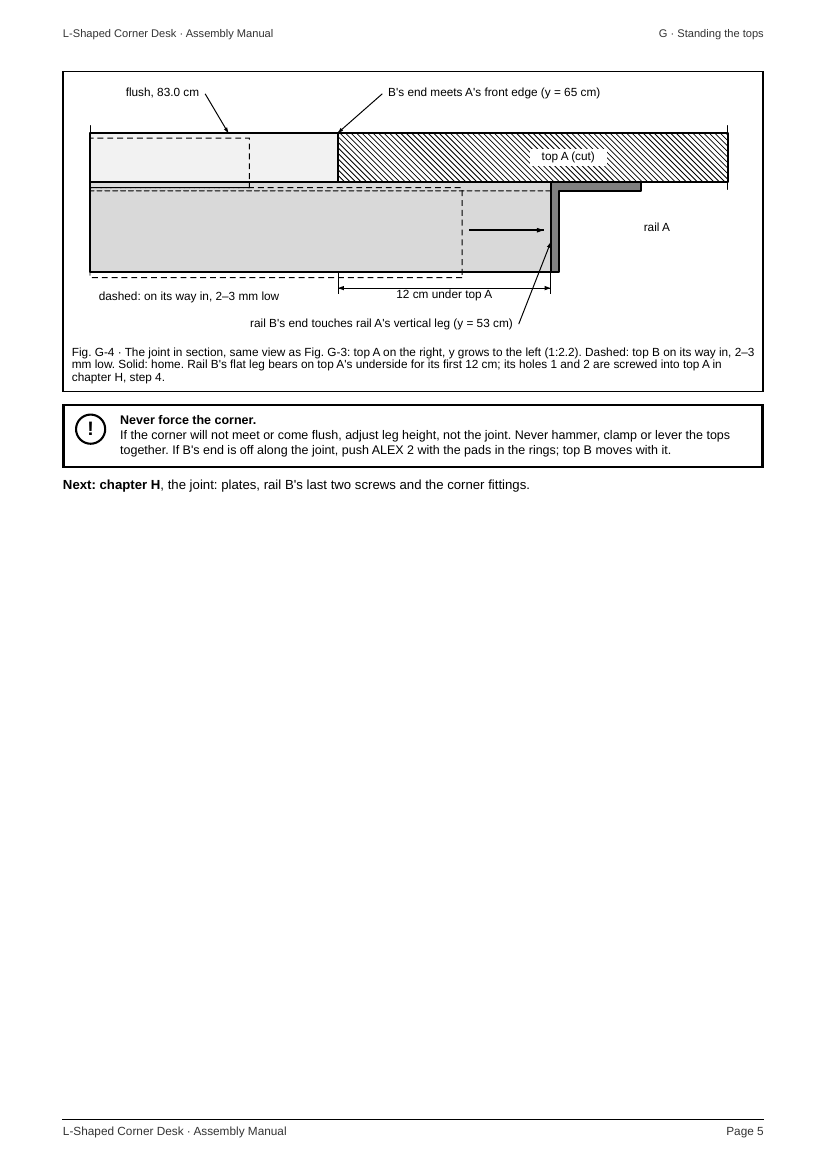
manual/build/png/manual-stand/p-05.png
