scotthowson/desk-setup/manual/build/png/manual-stand/p-06.png

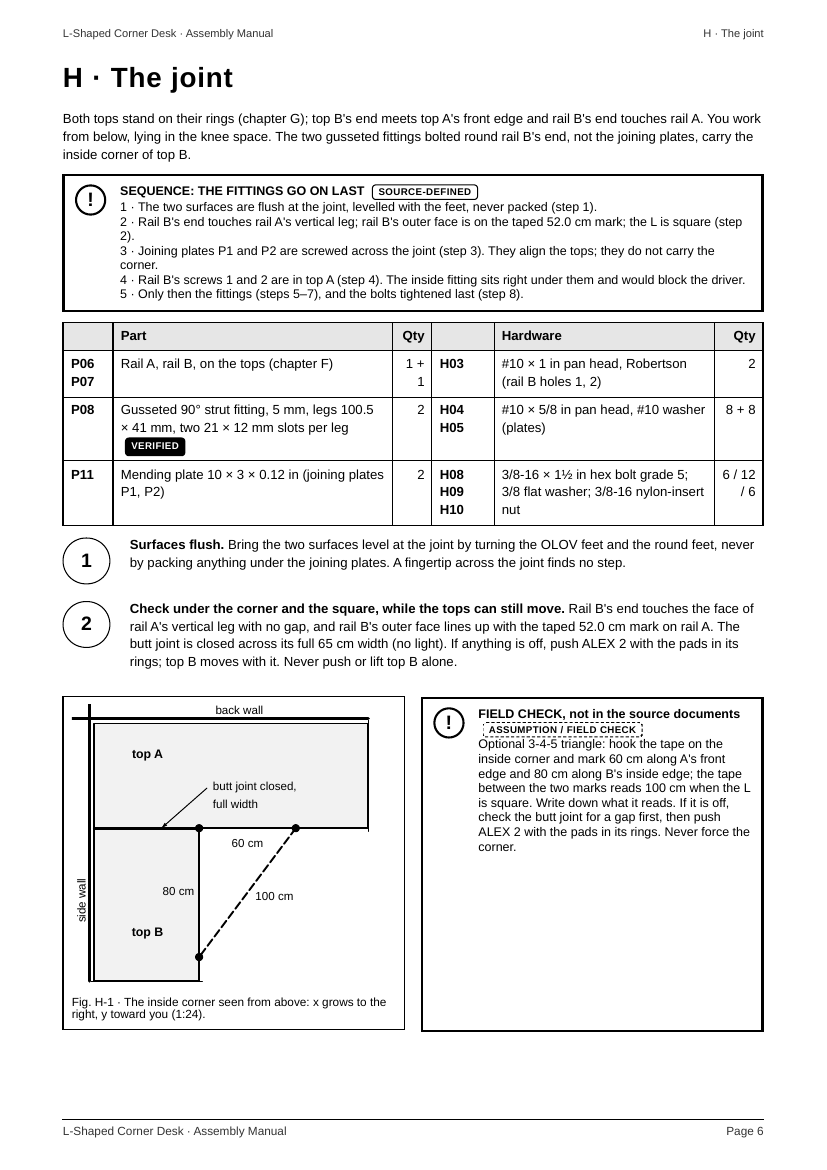
manual/build/png/manual-stand/p-06.png
