scotthowson/desk-setup/manual/build/png/manual-stand/p-07.png

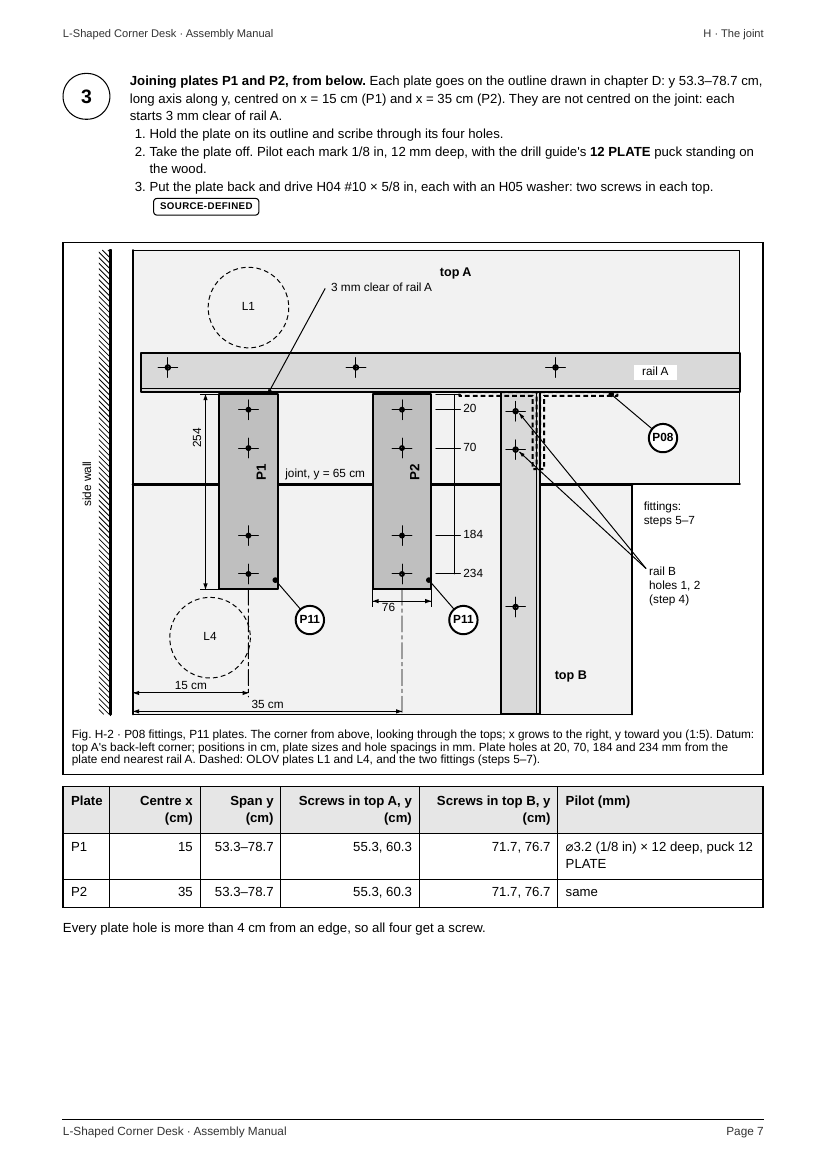
manual/build/png/manual-stand/p-07.png
