scotthowson/desk-setup/manual/build/png/manual-stand/p-08.png

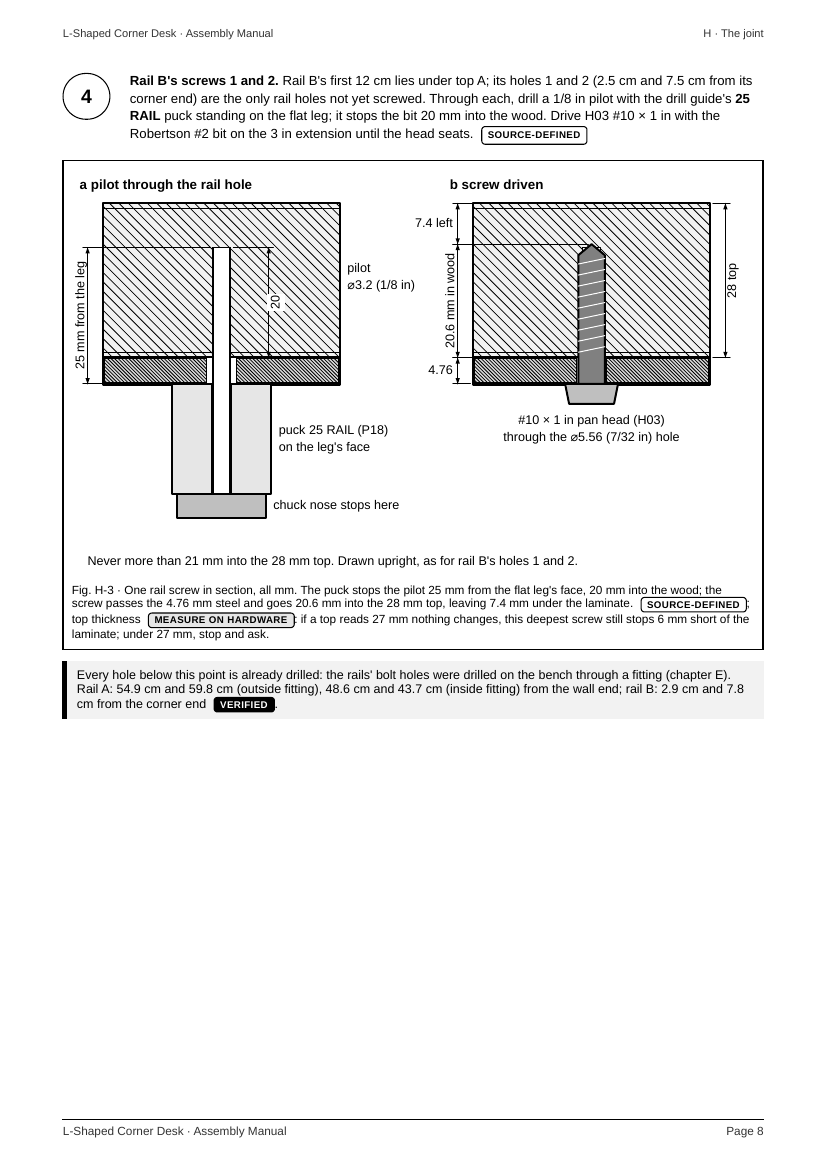
manual/build/png/manual-stand/p-08.png
