scotthowson/desk-setup/manual/build/png/manual-stand/p-09.png

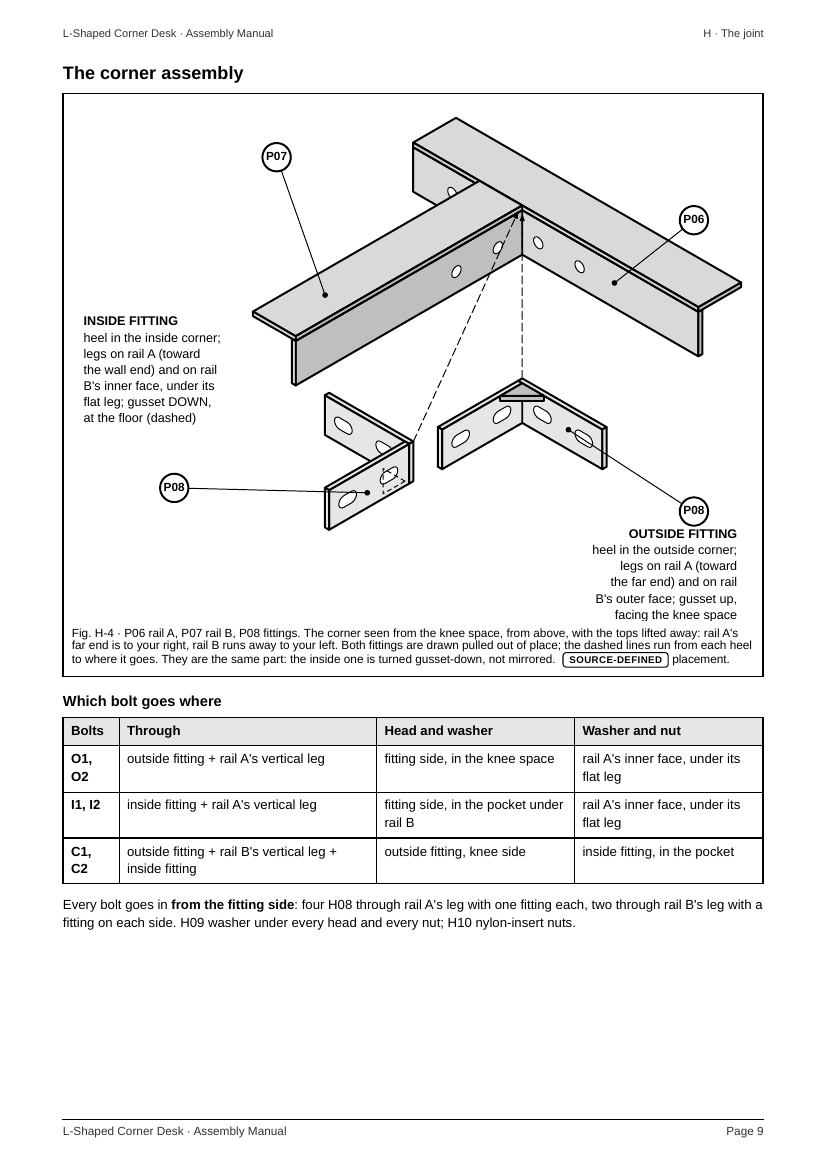
manual/build/png/manual-stand/p-09.png
