scotthowson/desk-setup/manual/build/png/manual-stand/p-10.png

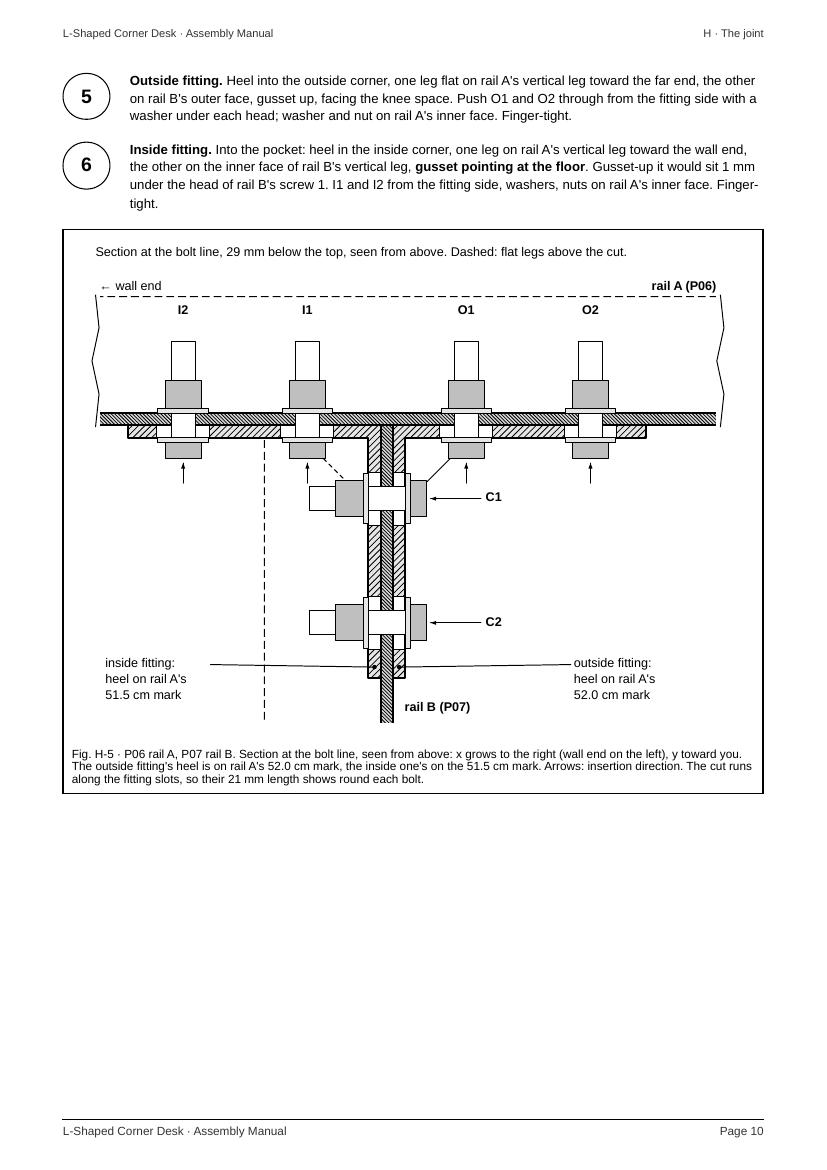
manual/build/png/manual-stand/p-10.png
