scotthowson/desk-setup/manual/build/png/manual-stand/p-11.png

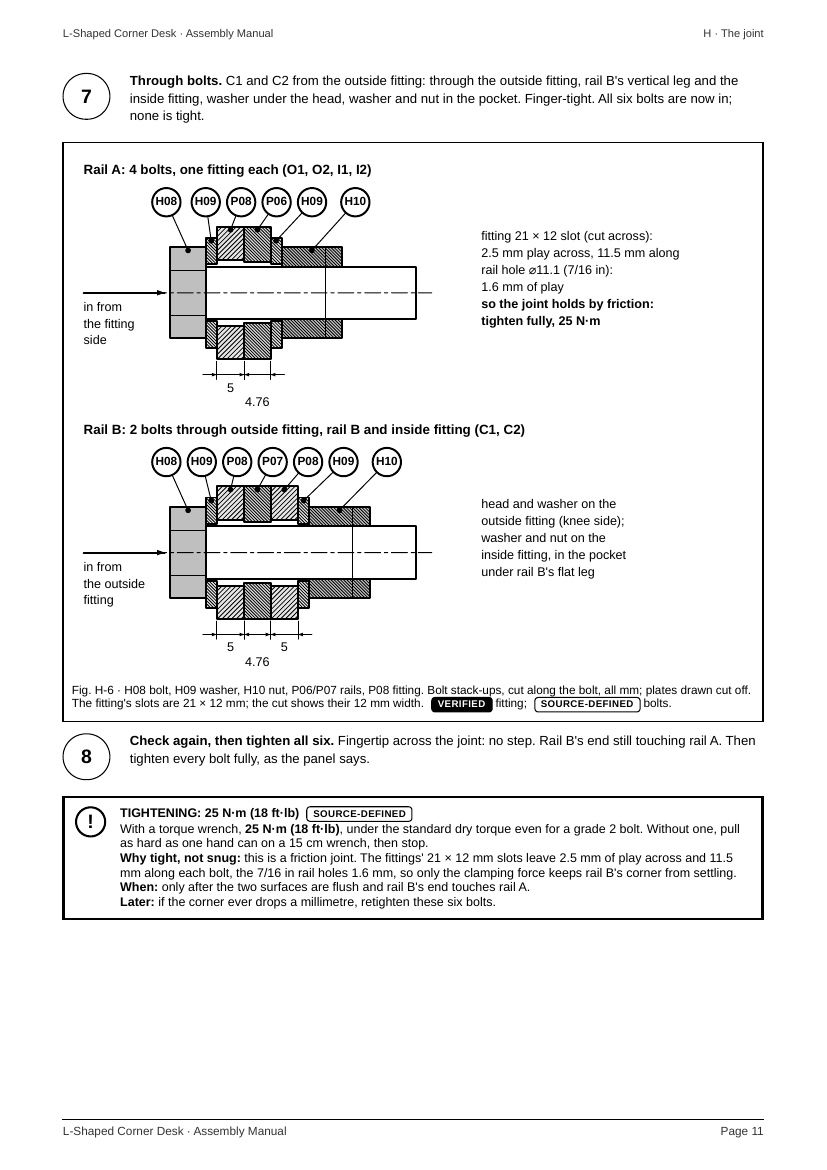
manual/build/png/manual-stand/p-11.png
