scotthowson/desk-setup/manual/build/png/manual-stand/p-12.png

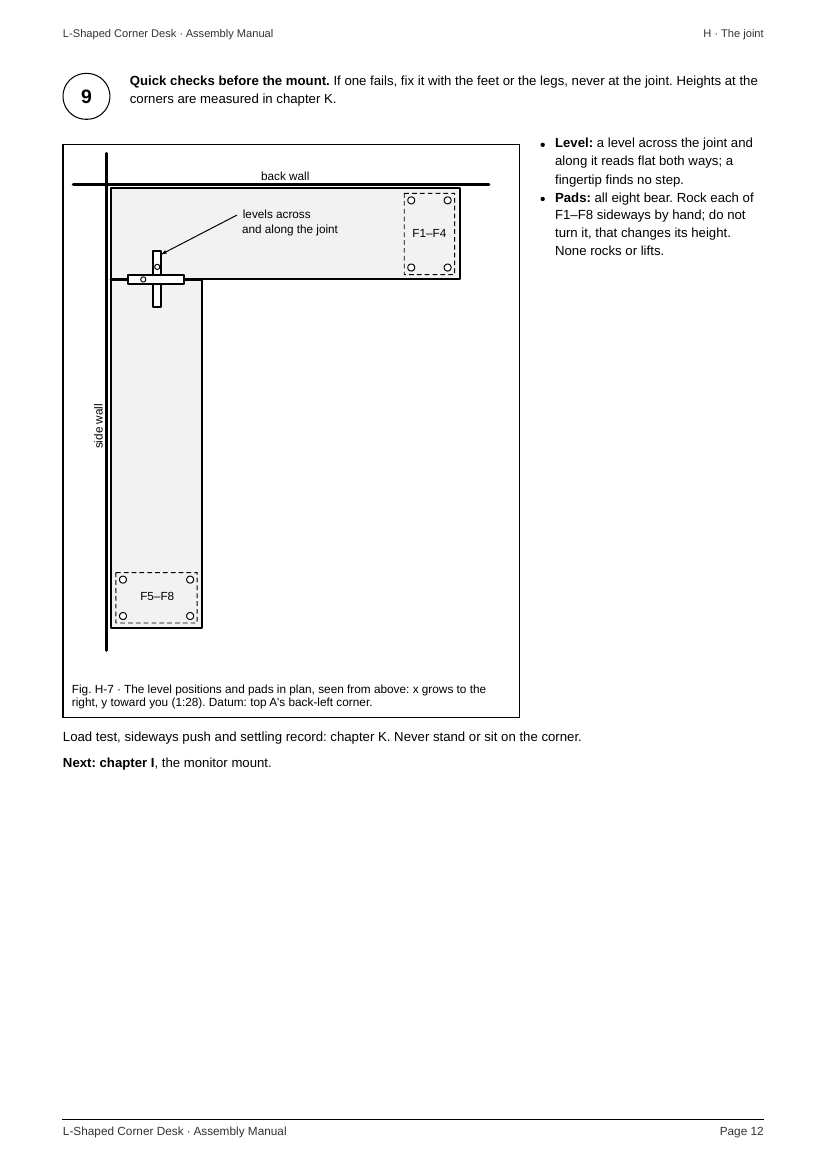
manual/build/png/manual-stand/p-12.png
