scotthowson/desk-setup/manual/build/png/manual-stand/p-13.png

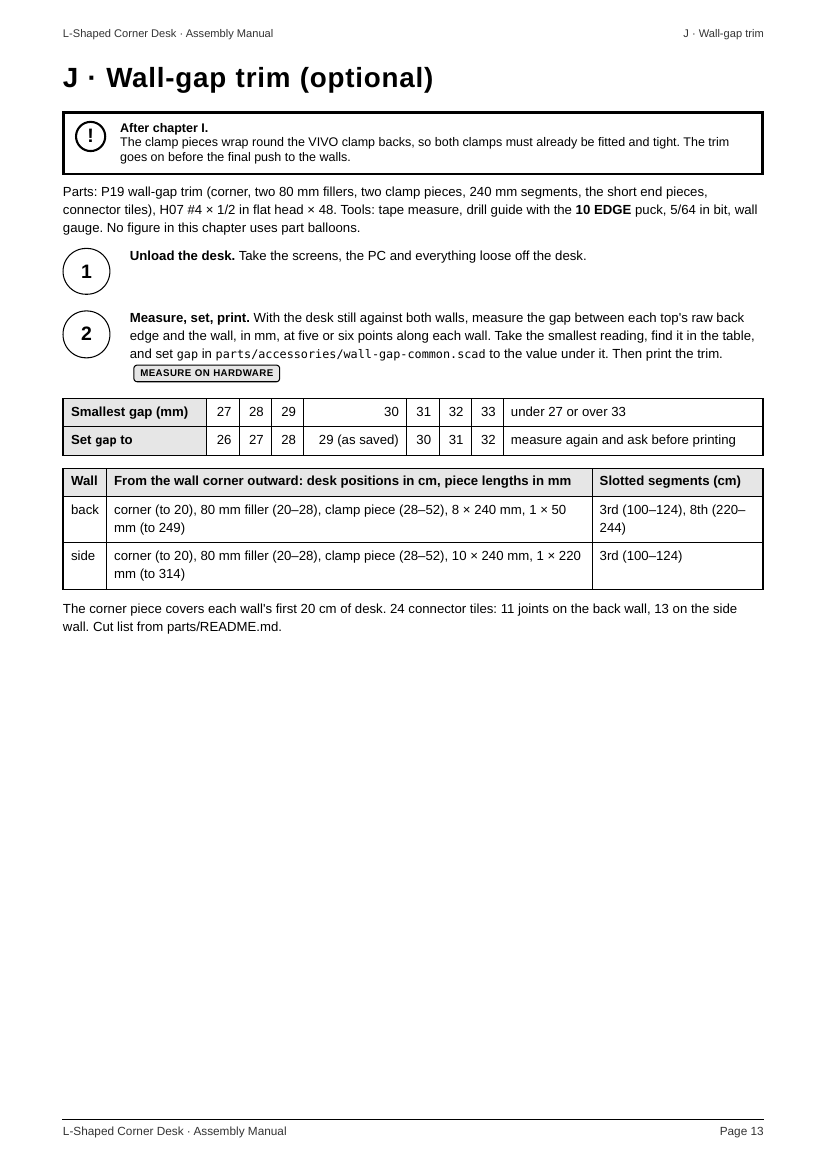
manual/build/png/manual-stand/p-13.png
