scotthowson/desk-setup/manual/build/png/manual-stand/p-14.png

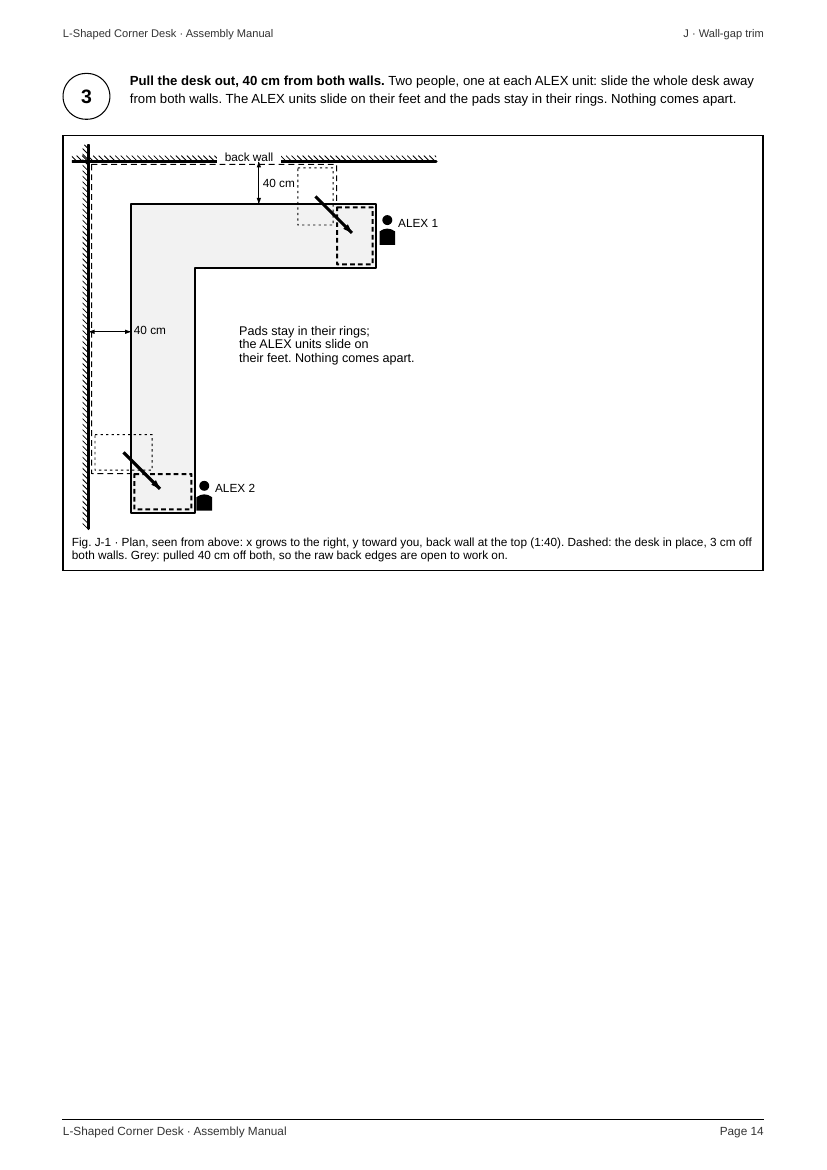
manual/build/png/manual-stand/p-14.png
