scotthowson/desk-setup/manual/build/png/manual-stand/p-15.png

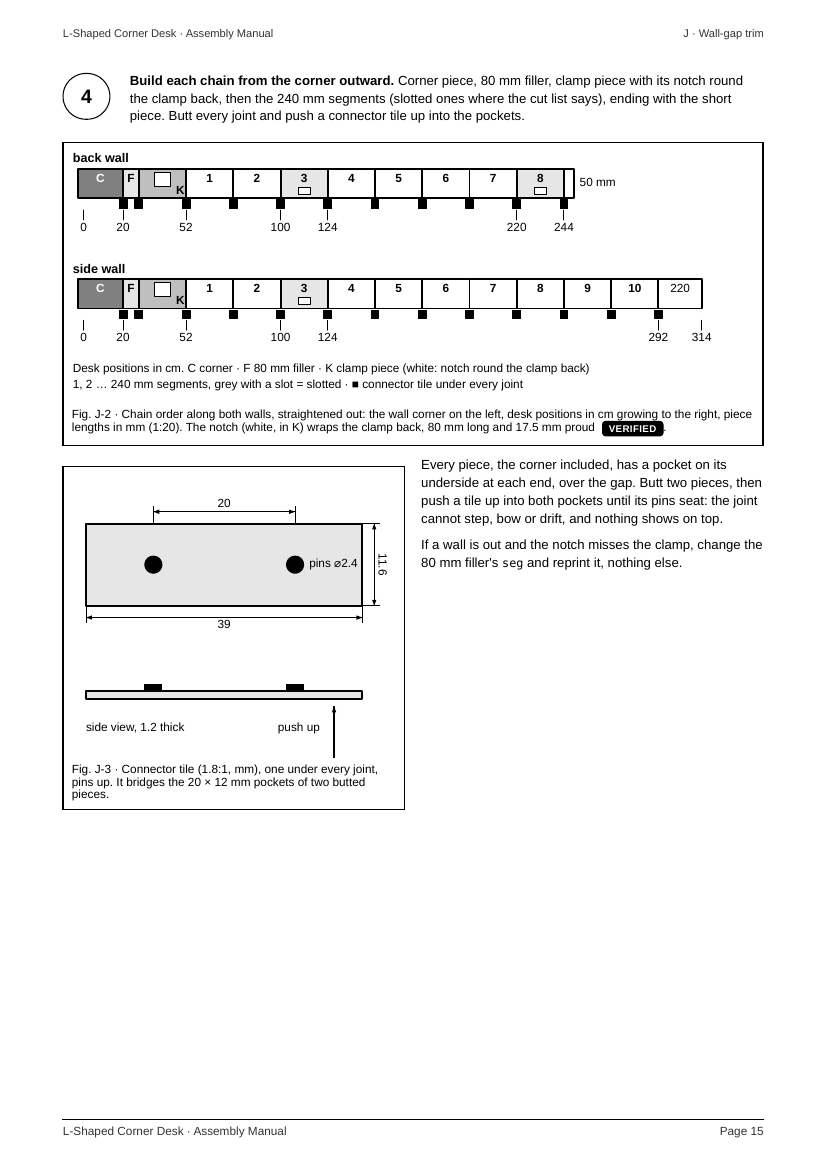
manual/build/png/manual-stand/p-15.png
