scotthowson/desk-setup/manual/build/png/manual-stand/p-16.png

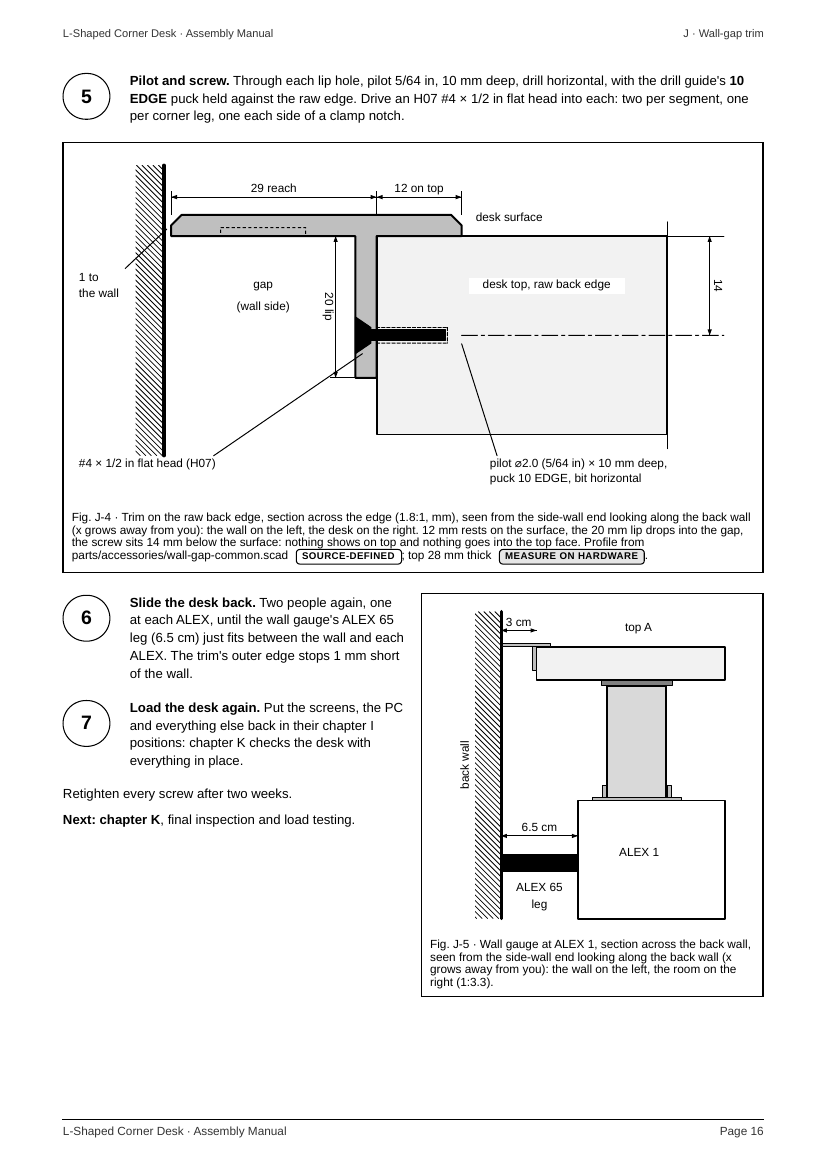
manual/build/png/manual-stand/p-16.png
