scotthowson/desk-setup/manual/build/png/manual-steel/p-01.png

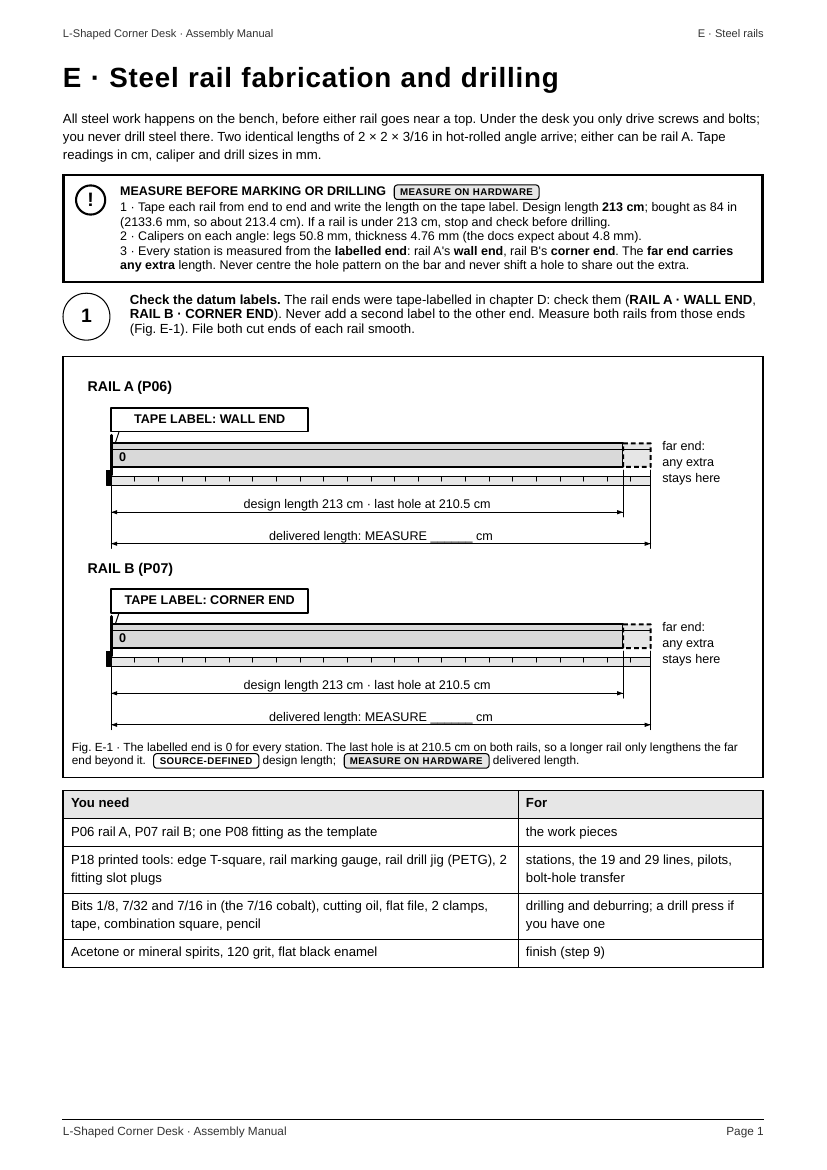
manual/build/png/manual-steel/p-01.png
