scotthowson/desk-setup/manual/build/png/manual-steel/p-03.png

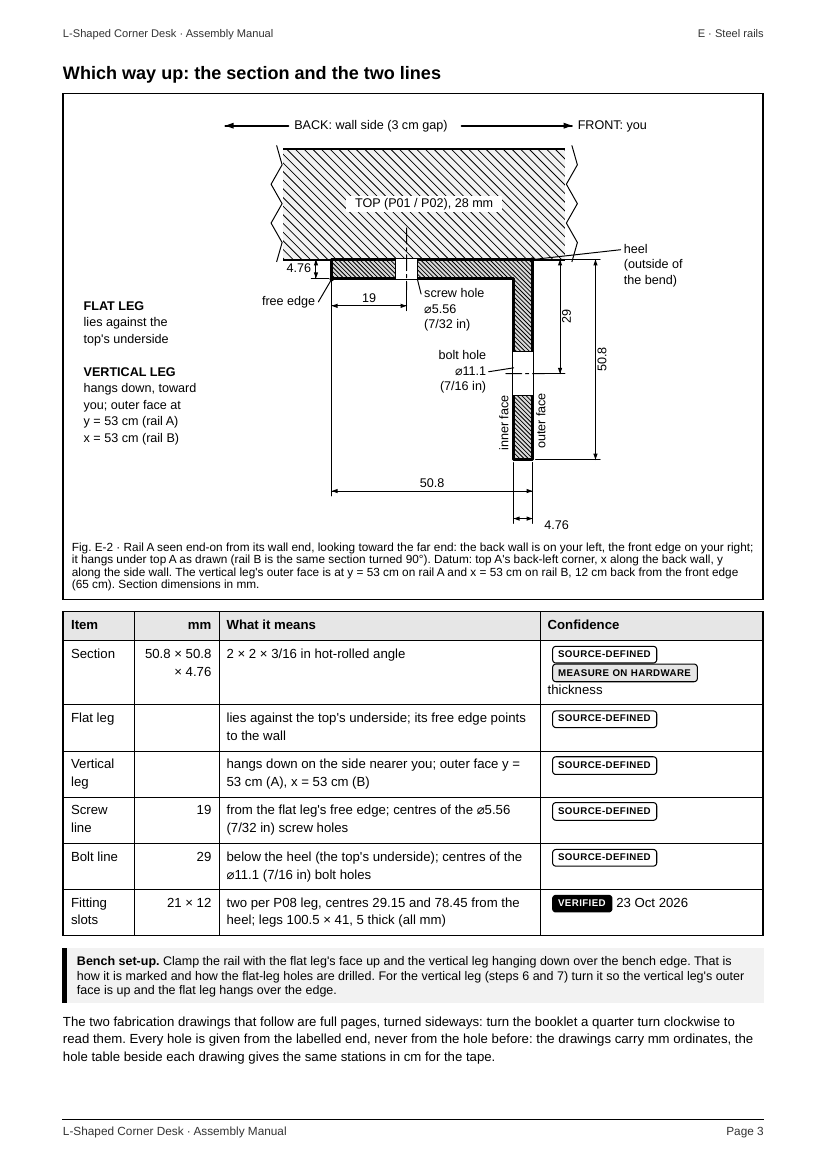
manual/build/png/manual-steel/p-03.png
