scotthowson/desk-setup/manual/build/png/manual-steel/p-04.png

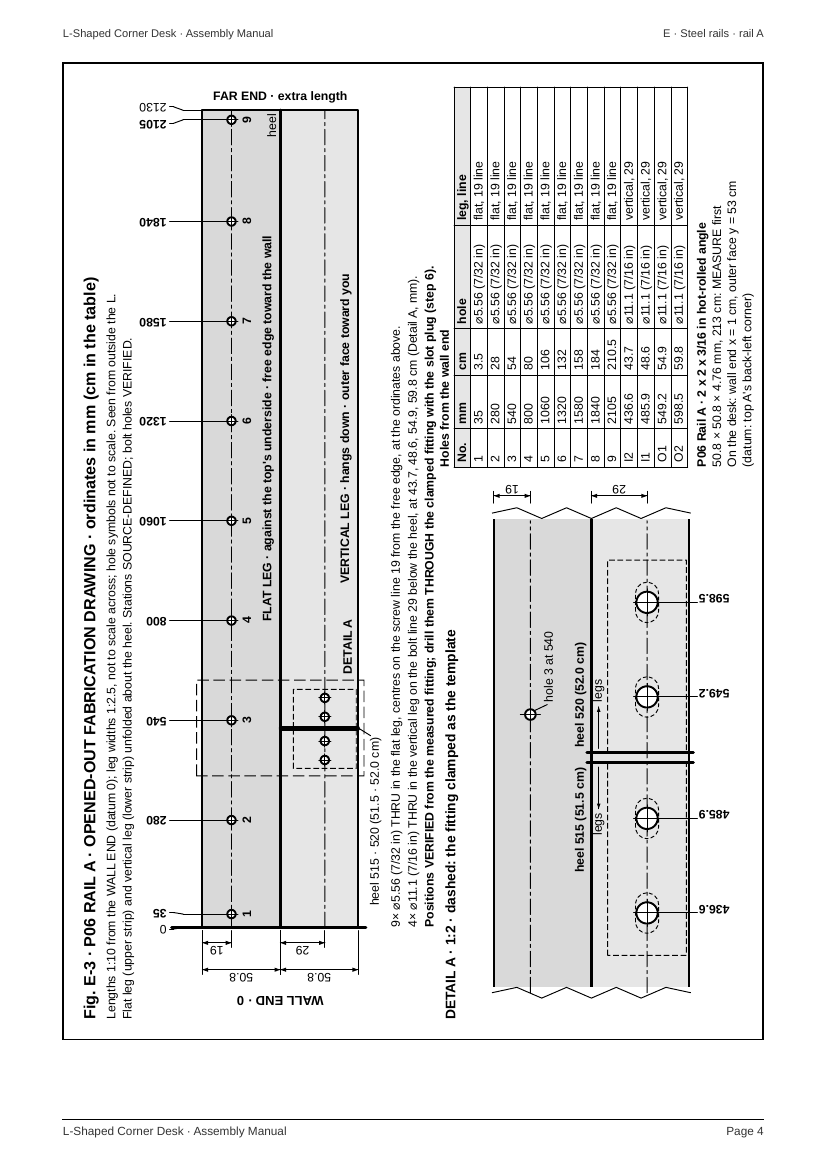
manual/build/png/manual-steel/p-04.png
