scotthowson/desk-setup/manual/build/png/manual-steel/p-06.png

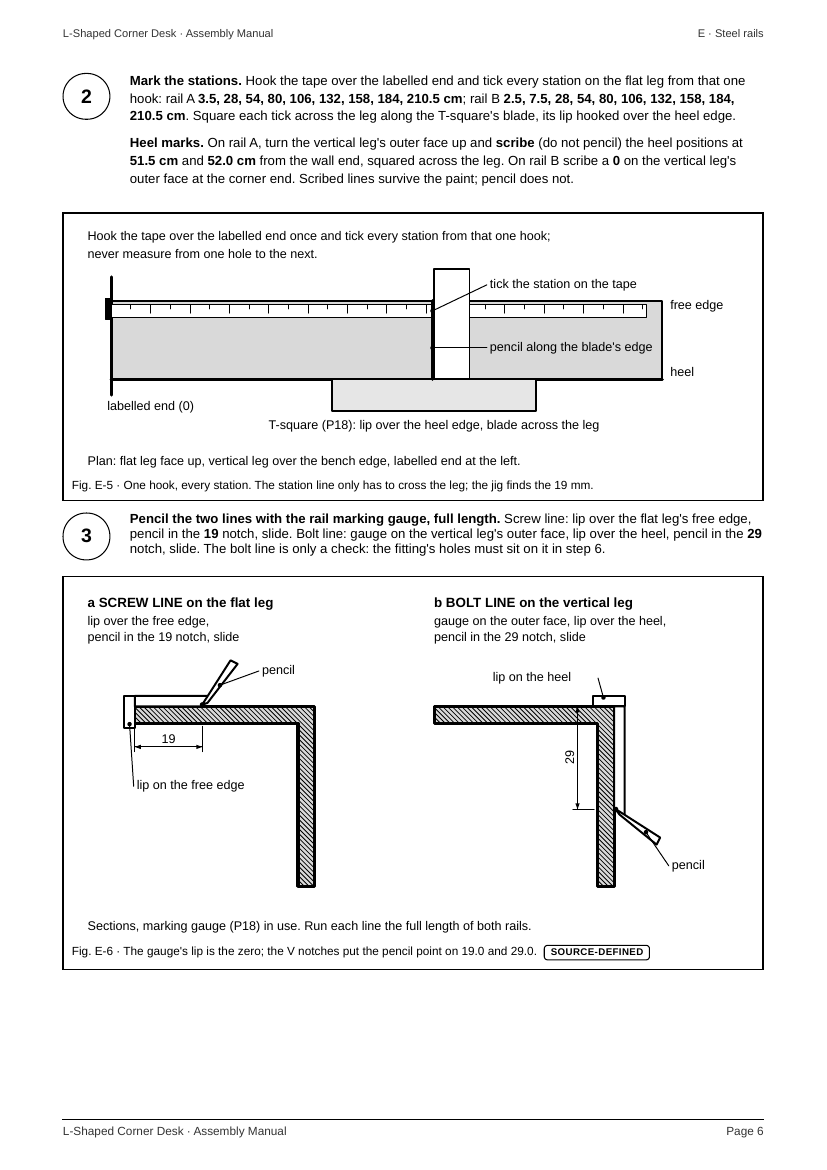
manual/build/png/manual-steel/p-06.png
