scotthowson/desk-setup/manual/build/png/manual-steel/p-07.png

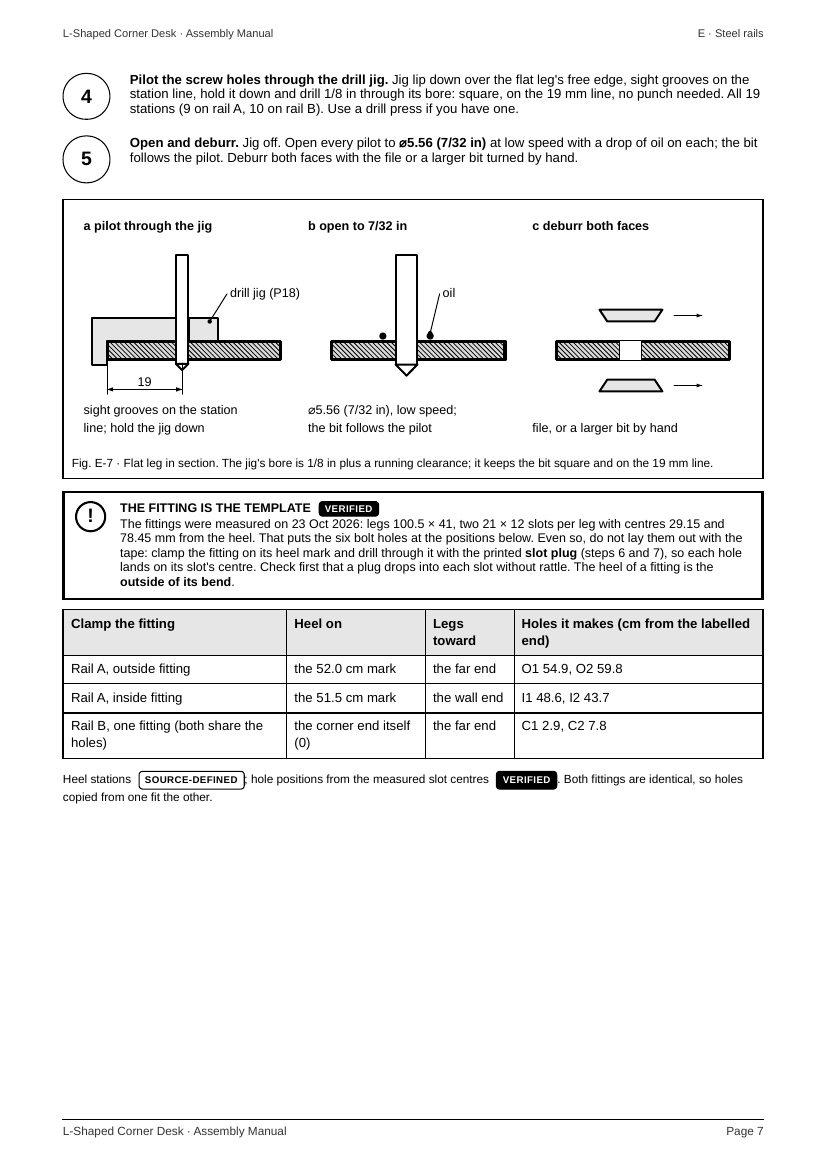
manual/build/png/manual-steel/p-07.png
