scotthowson/desk-setup/manual/build/png/manual-steel/p-08.png

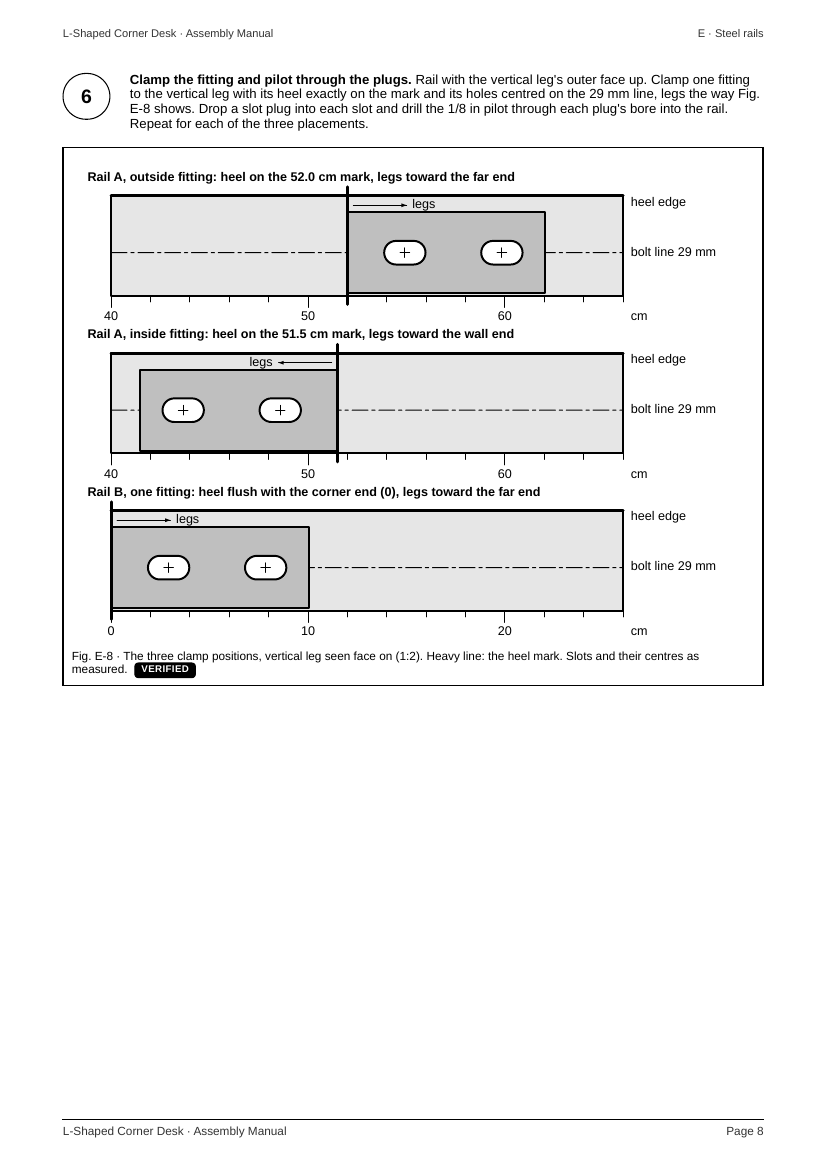
manual/build/png/manual-steel/p-08.png
