scotthowson/desk-setup/manual/build/png/manual-steel/p-09.png

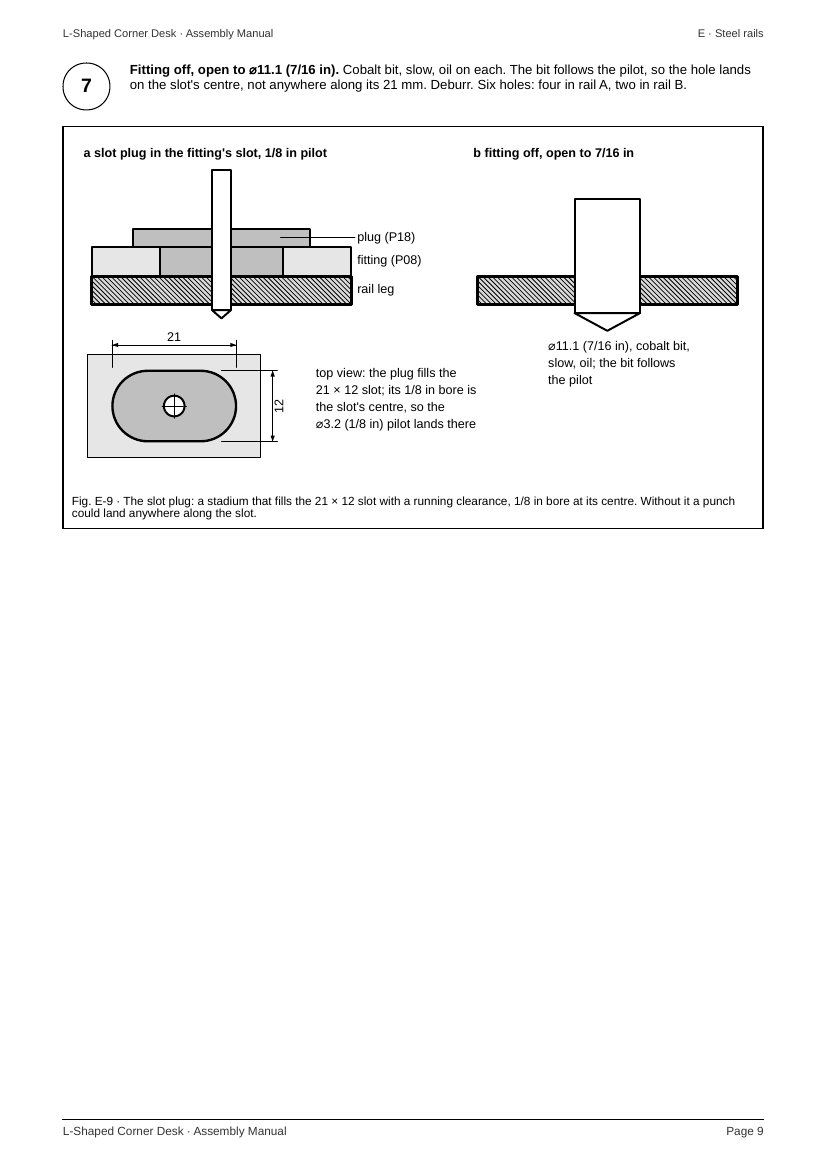
manual/build/png/manual-steel/p-09.png
