scotthowson/desk-setup/manual/build/png/manual-steel/p-10.png

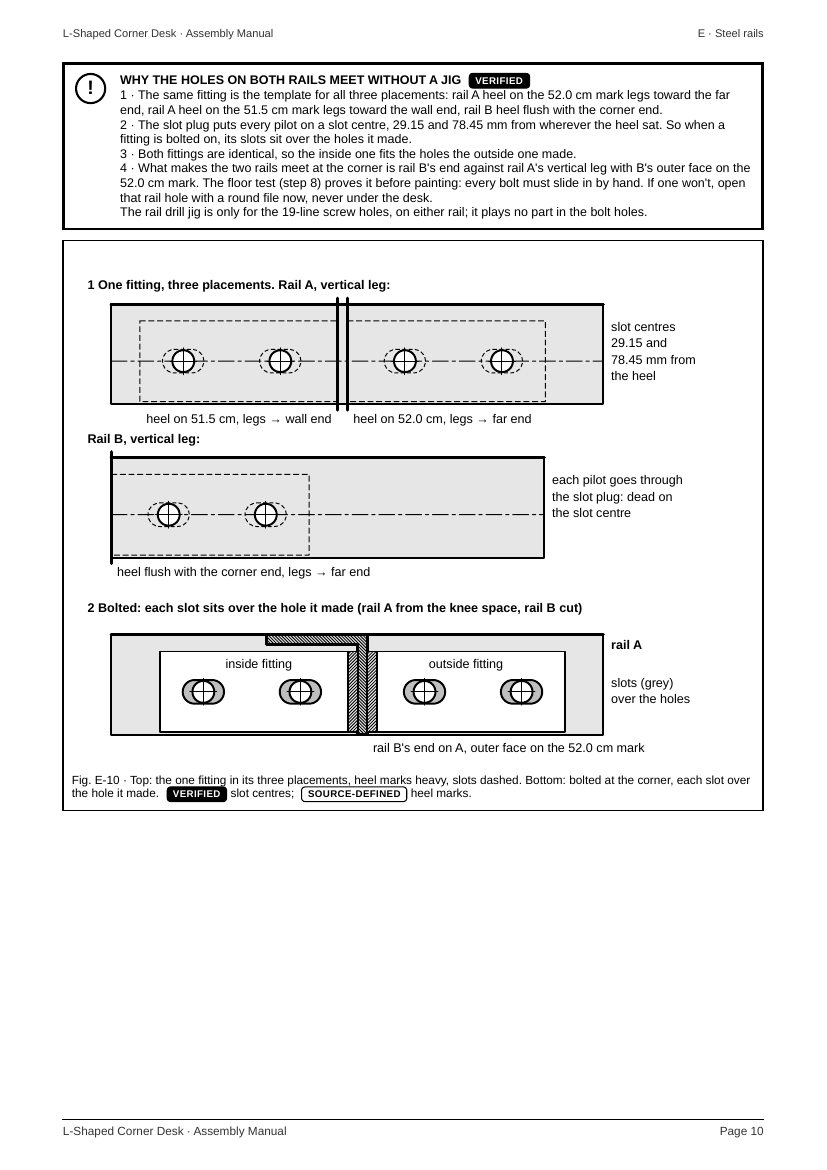
manual/build/png/manual-steel/p-10.png
