scotthowson/desk-setup/manual/build/png/manual-steel/p-11.png

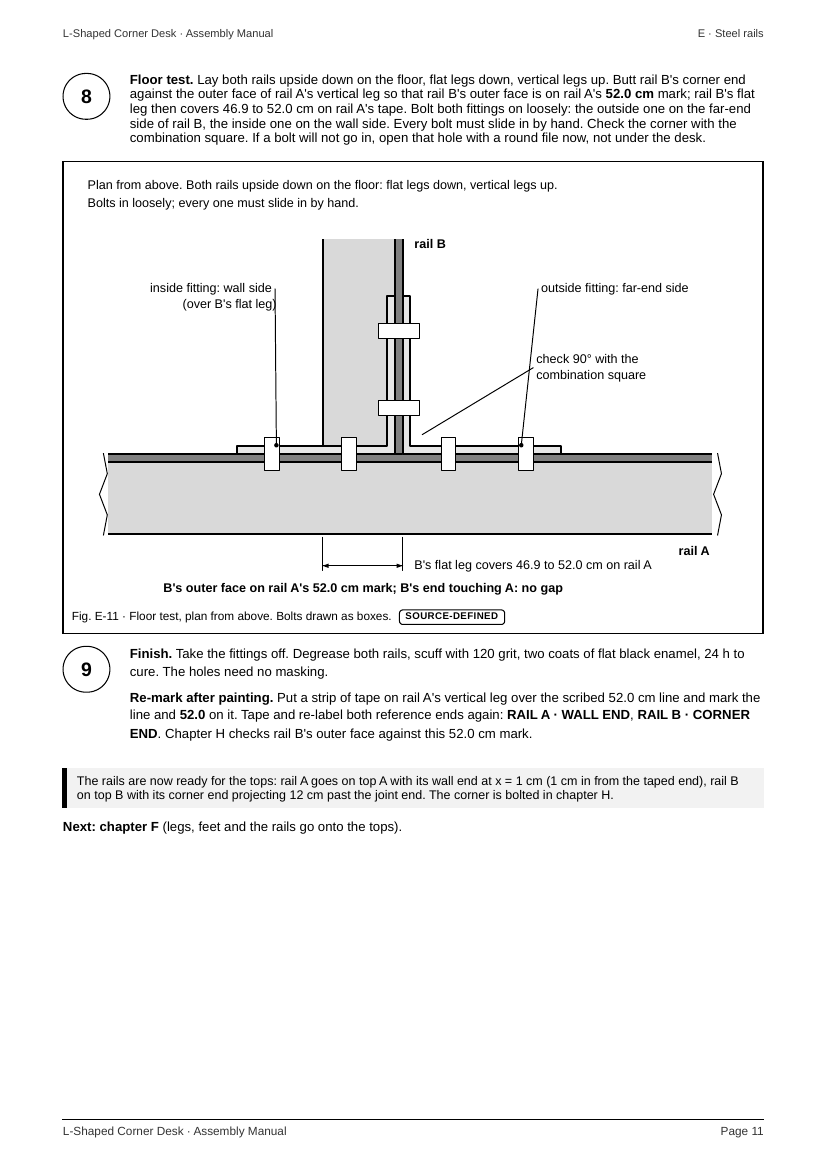
manual/build/png/manual-steel/p-11.png
