scotthowson/desk-setup/manual/build/png/manual/p-12.png

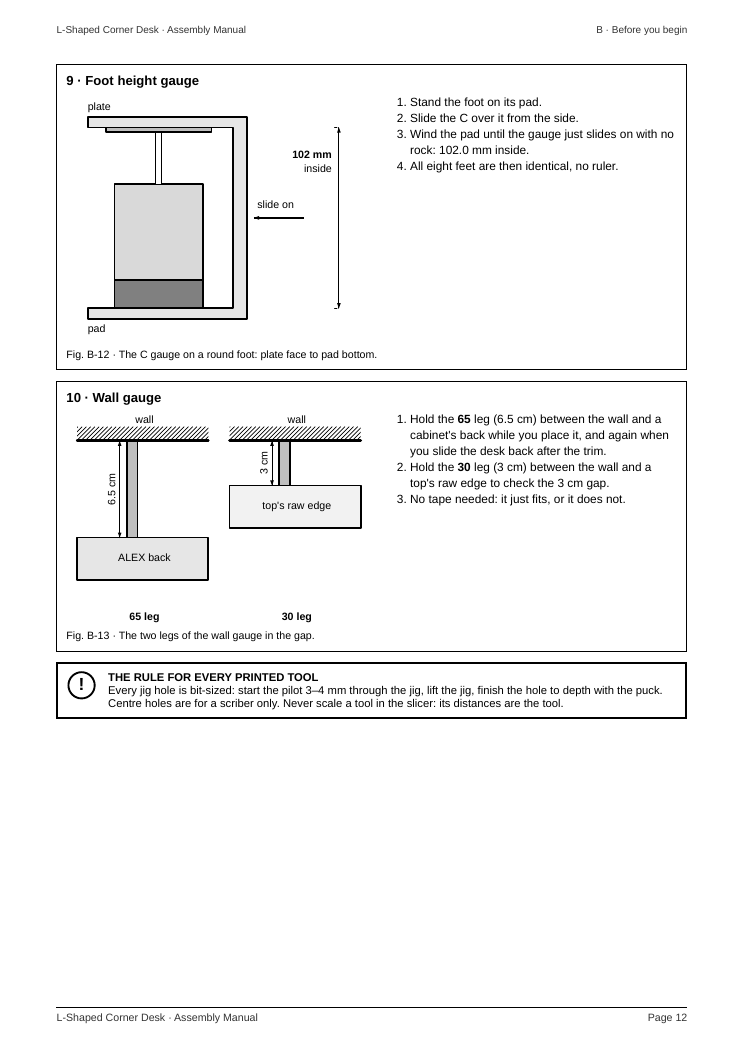
manual/build/png/manual/p-12.png
