scotthowson/desk-setup/manual/build/png/manual/p-16.png

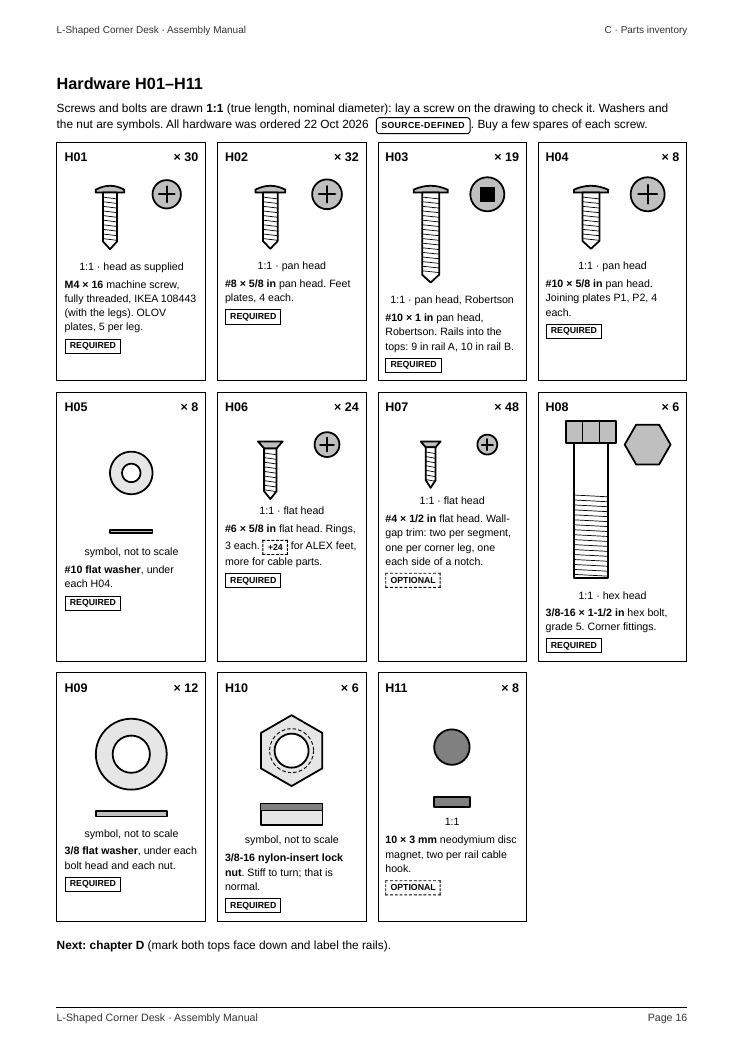
manual/build/png/manual/p-16.png
