scotthowson/desk-setup/manual/build/png/manual/p-17.png

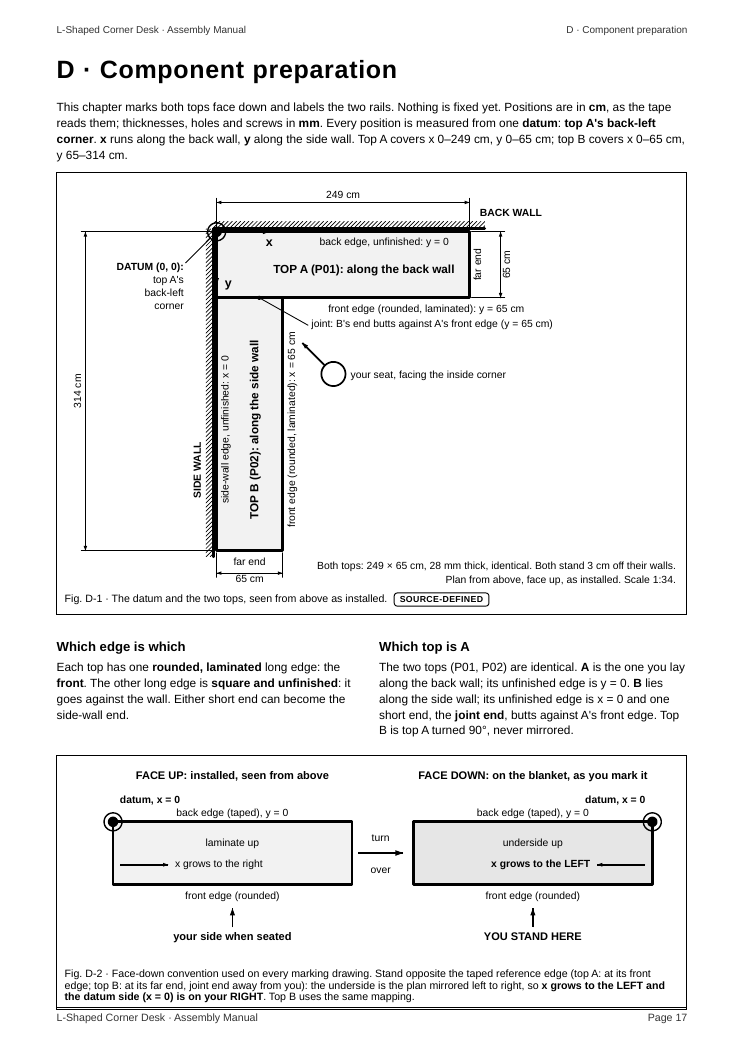
manual/build/png/manual/p-17.png
