scotthowson/desk-setup/manual/build/png/manual/p-19.png

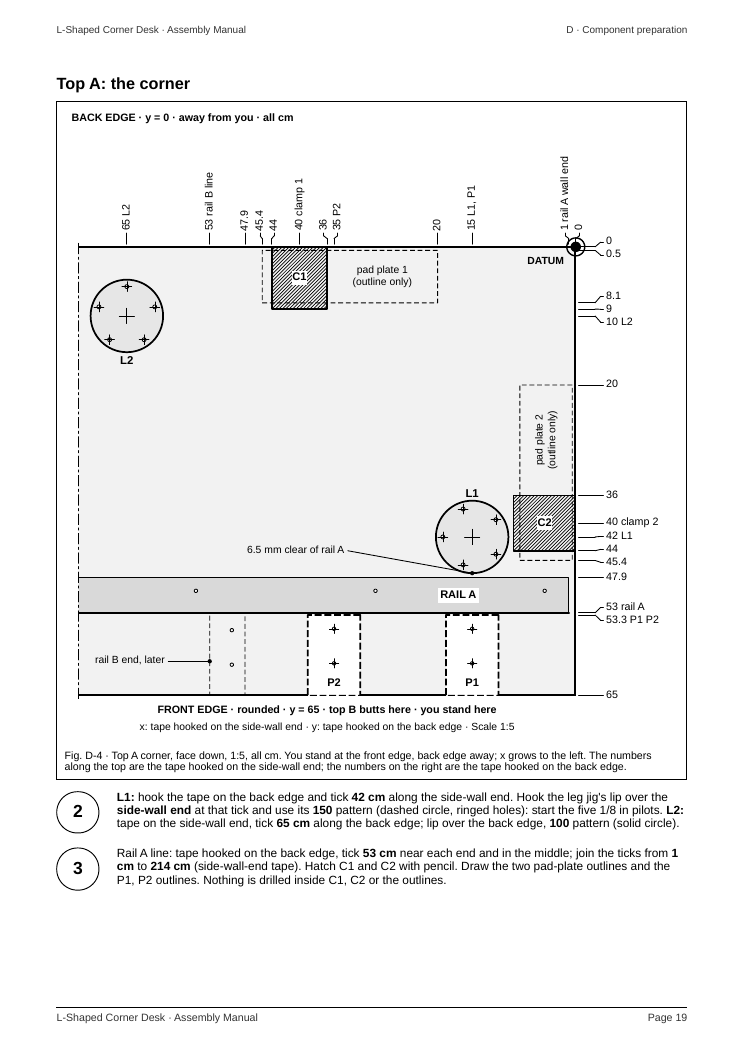
manual/build/png/manual/p-19.png
