scotthowson/desk-setup/manual/build/png/manual/p-26.png

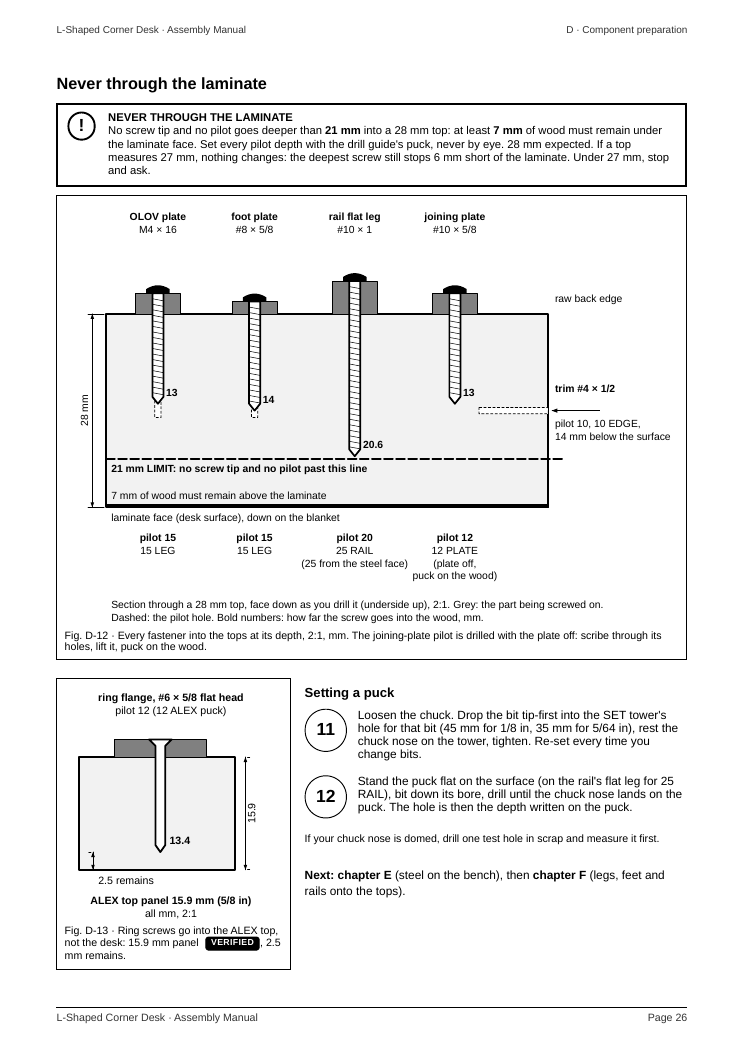
manual/build/png/manual/p-26.png
