scotthowson/desk-setup/manual/build/png/manual/p-28.png

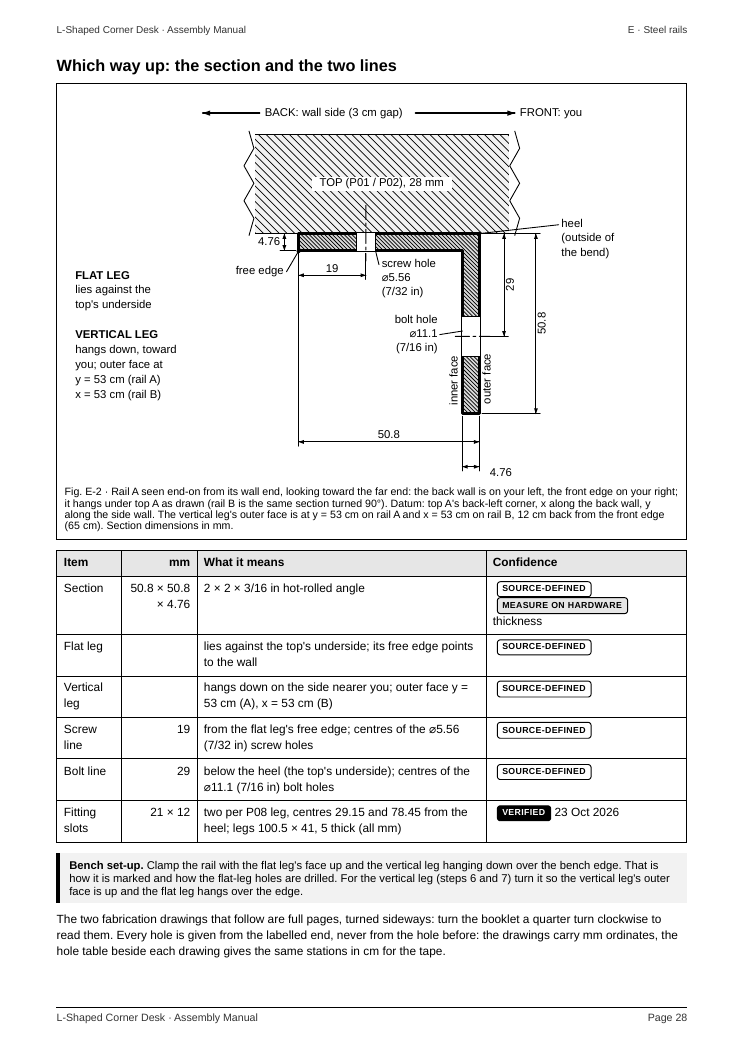
manual/build/png/manual/p-28.png
