scotthowson/desk-setup/manual/build/png/manual/p-30.png

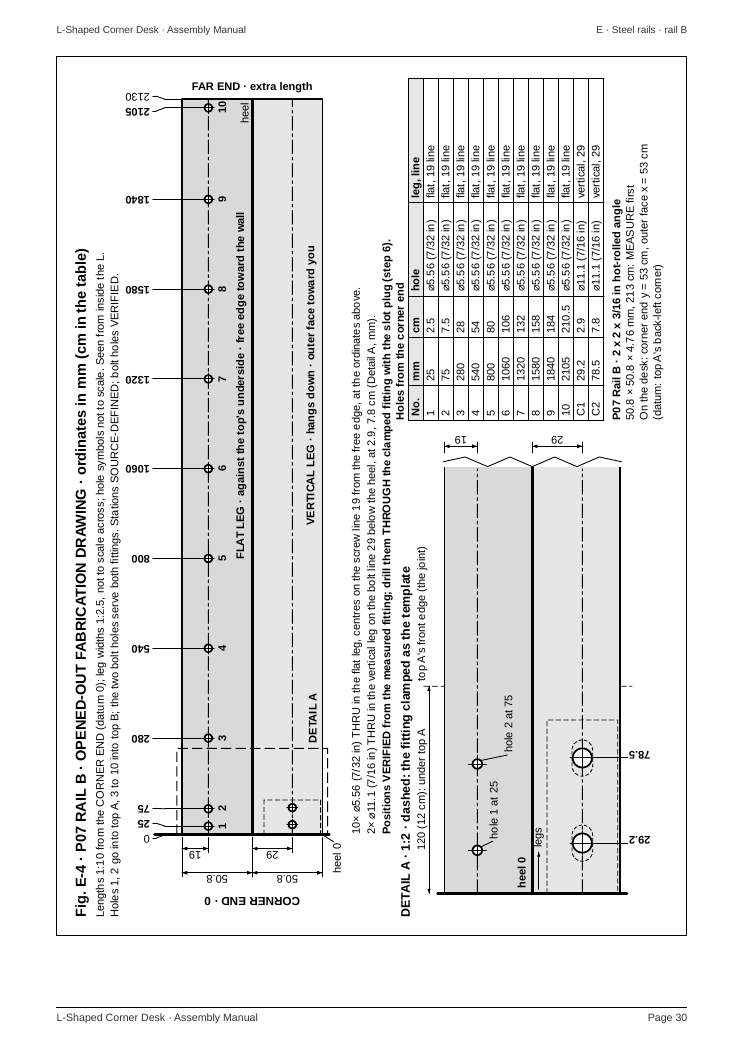
manual/build/png/manual/p-30.png
