scotthowson/desk-setup/manual/build/png/manual/p-33.png

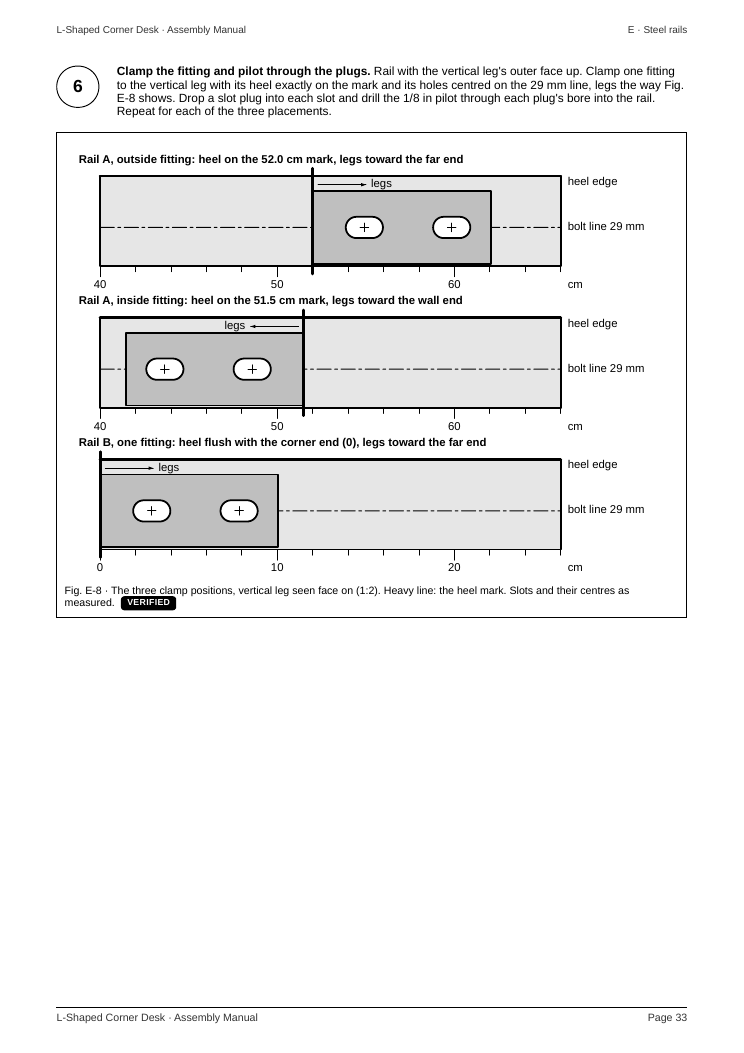
manual/build/png/manual/p-33.png
