scotthowson/desk-setup/manual/build/png/manual/p-34.png

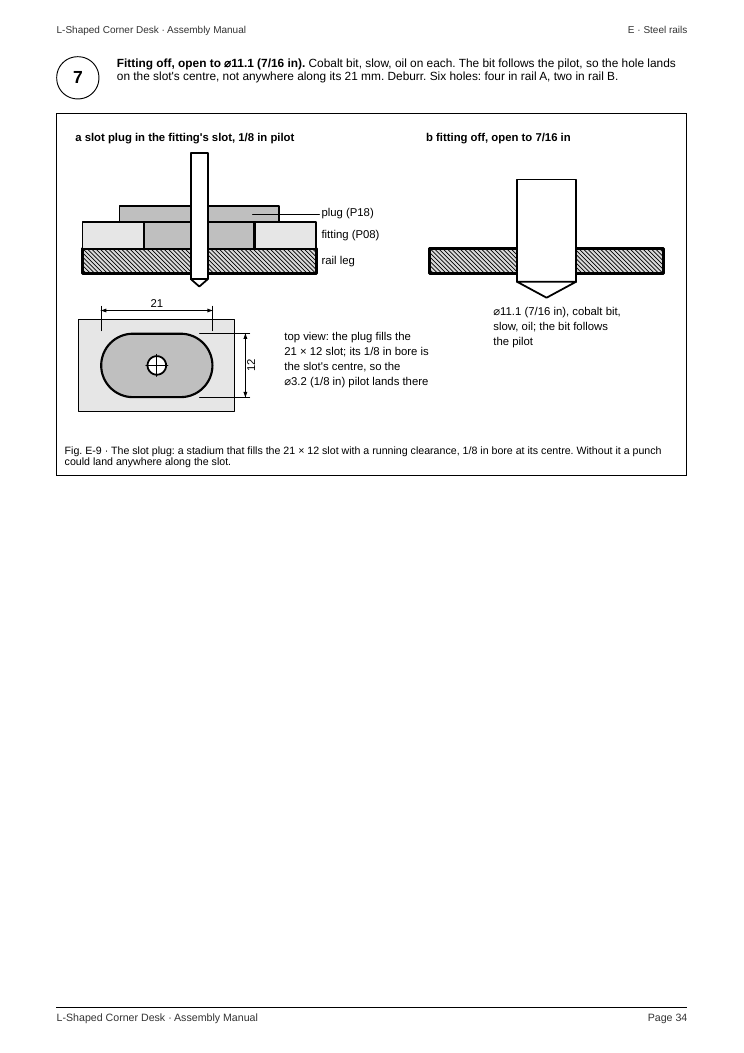
manual/build/png/manual/p-34.png
