scotthowson/desk-setup/manual/build/png/manual/p-36.png

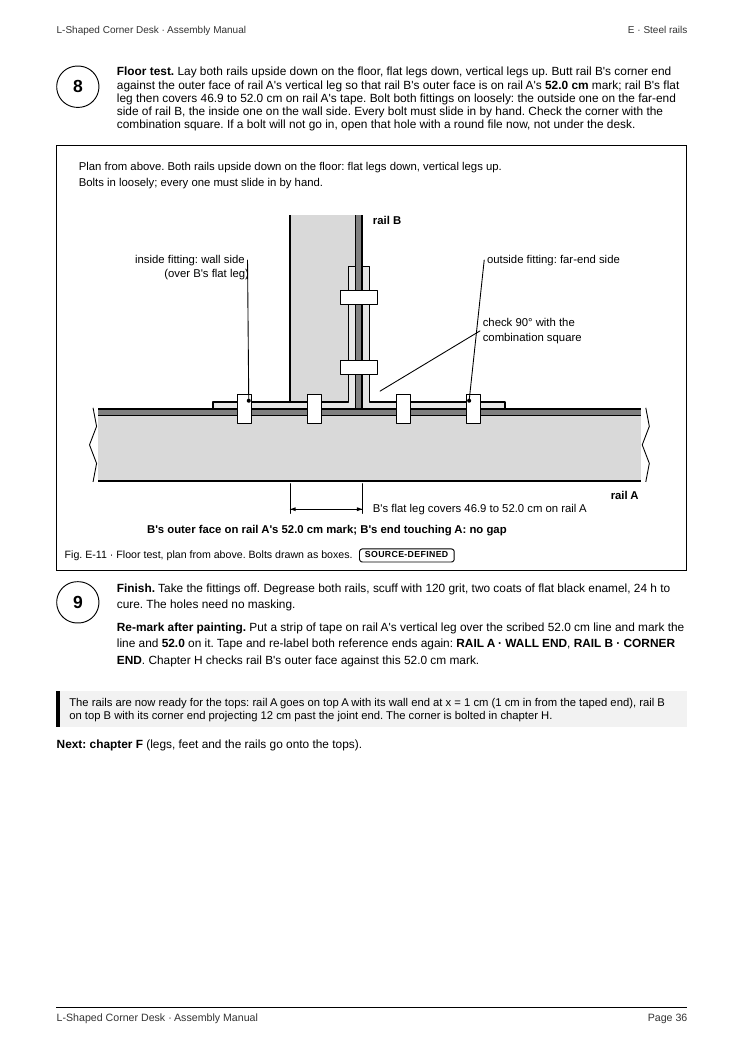
manual/build/png/manual/p-36.png
