scotthowson/desk-setup/manual/build/png/manual/p-44.png

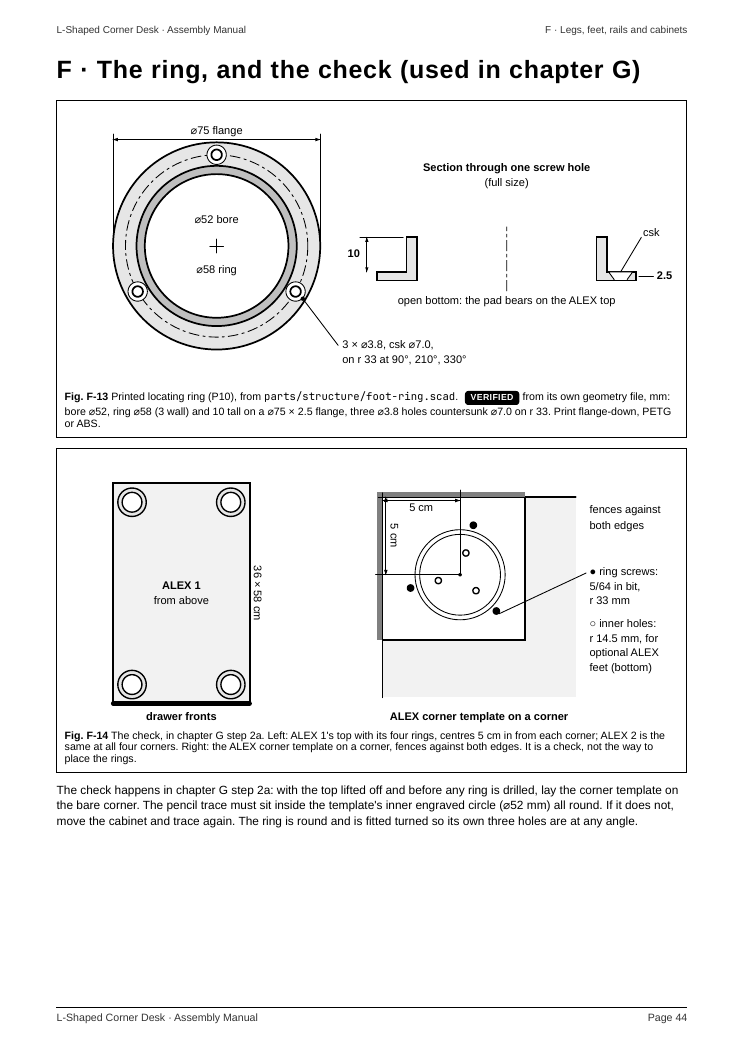
manual/build/png/manual/p-44.png
