scotthowson/desk-setup/manual/build/png/manual/p-45.png

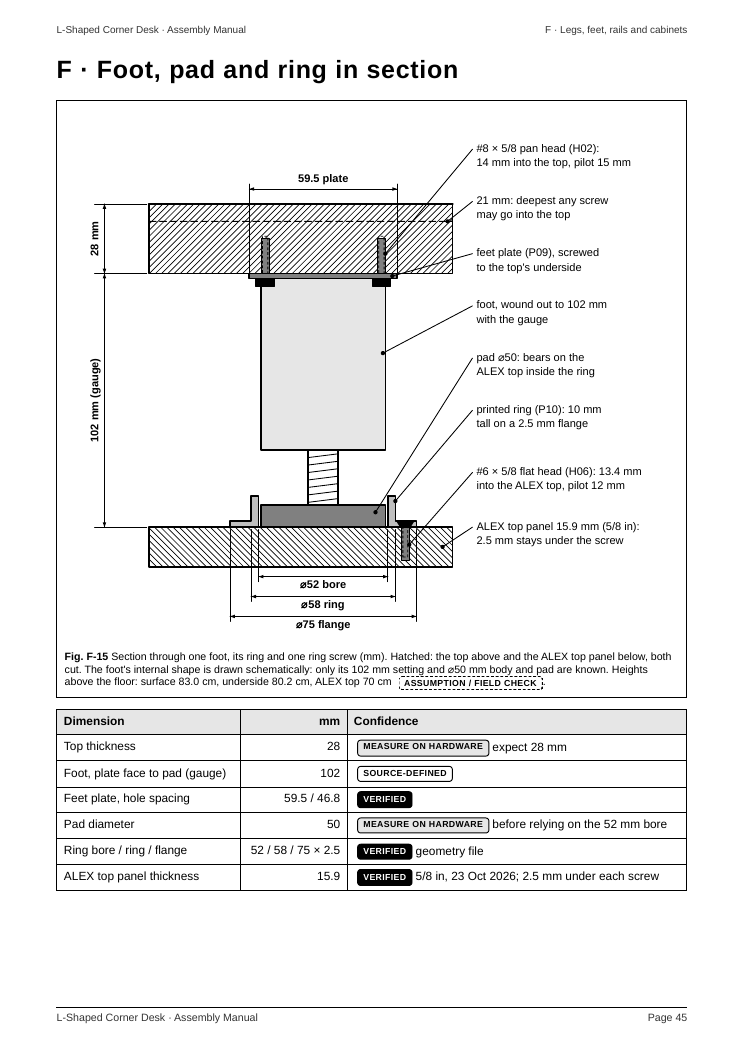
manual/build/png/manual/p-45.png
