scotthowson/desk-setup/manual/build/png/manual/p-51.png

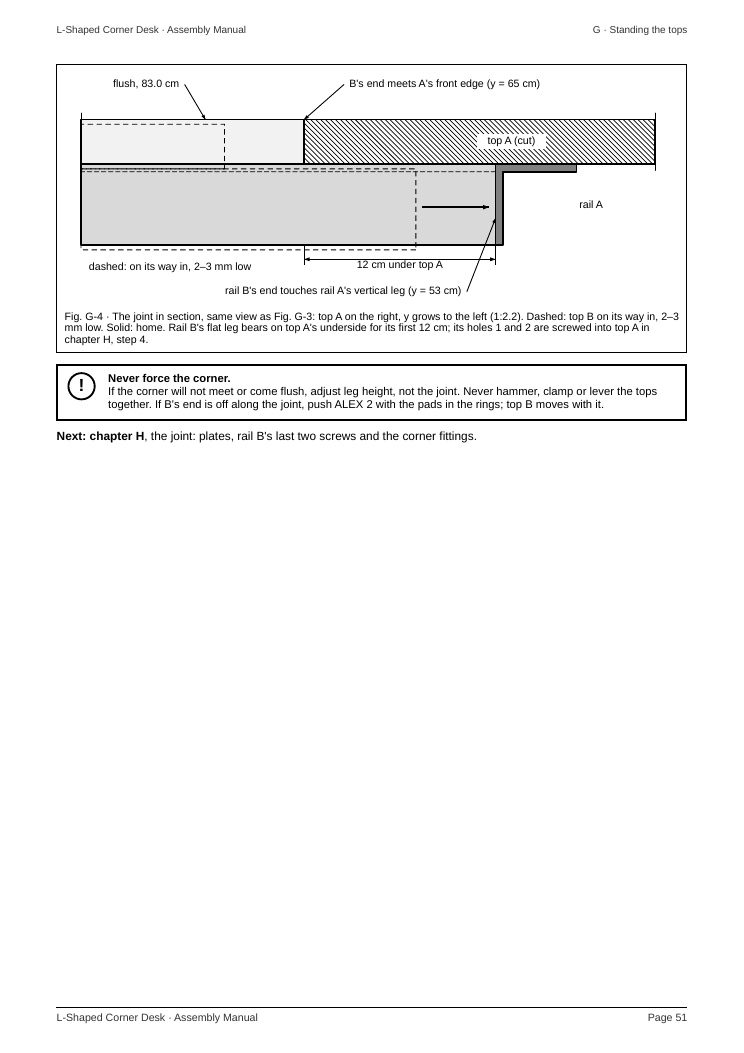
manual/build/png/manual/p-51.png
