scotthowson/desk-setup/manual/build/png/manual/p-55.png

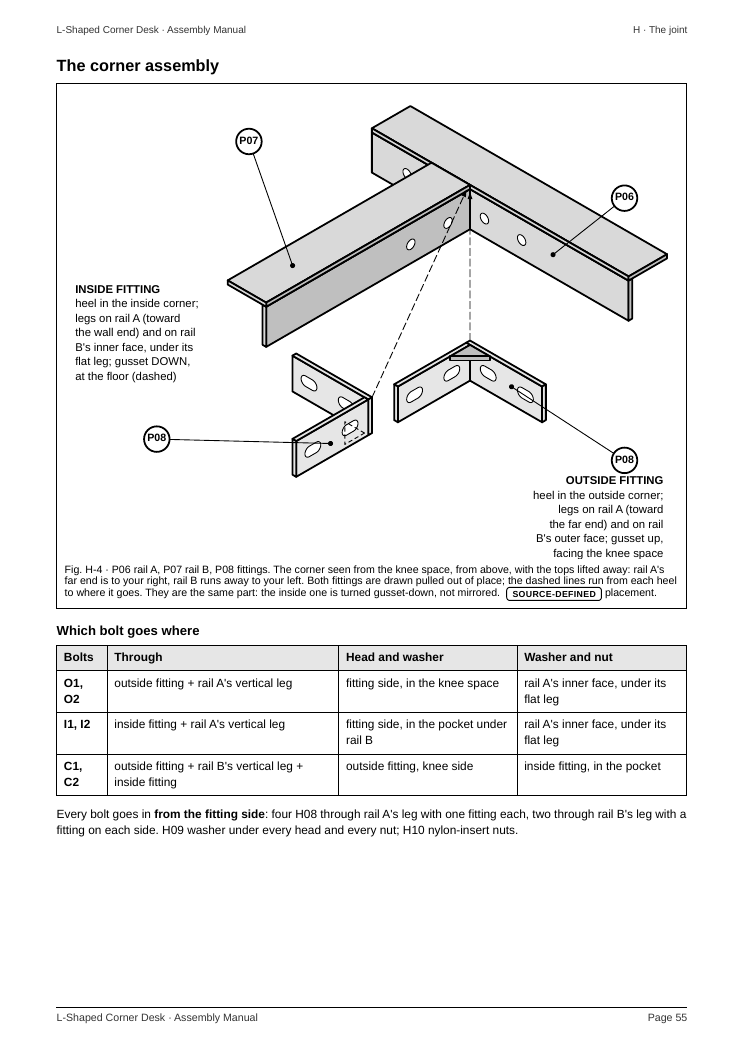
manual/build/png/manual/p-55.png
