scotthowson/desk-setup/manual/build/png/manual/p-56.png

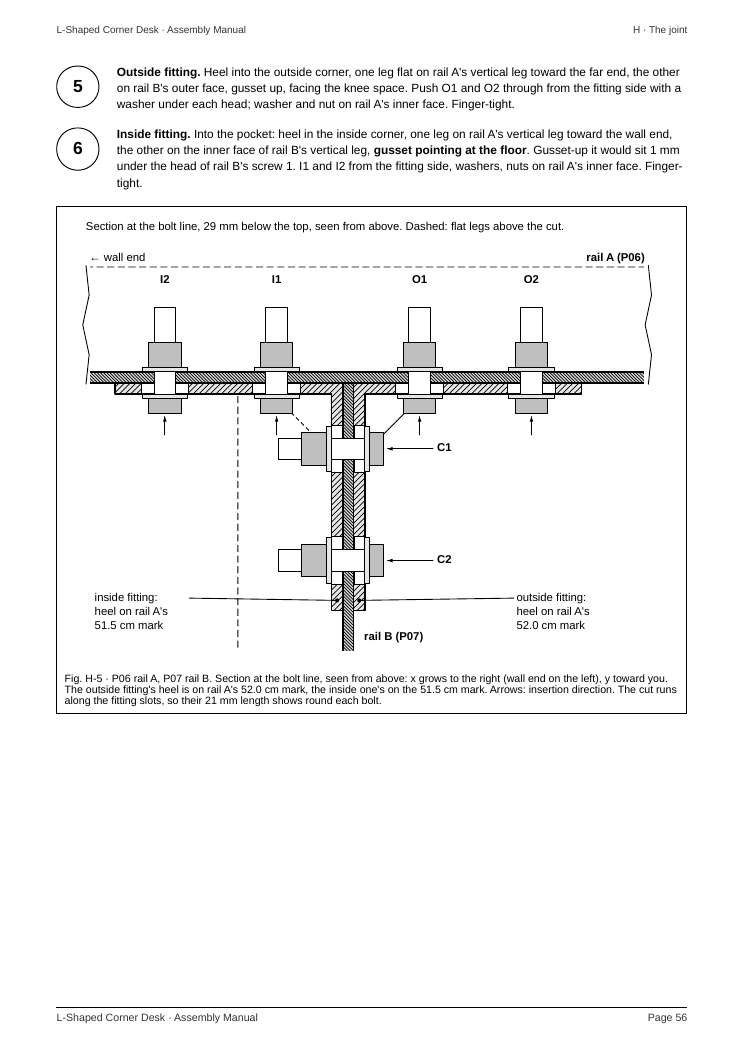
manual/build/png/manual/p-56.png
