scotthowson/desk-setup/manual/build/png/manual/p-65.png

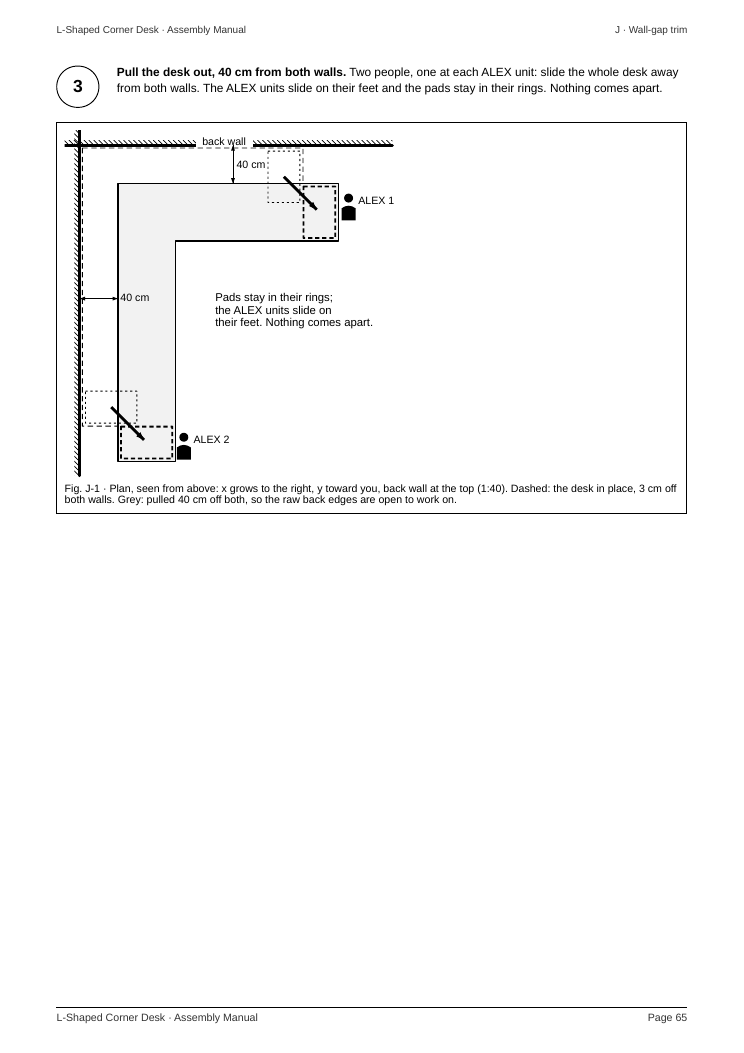
manual/build/png/manual/p-65.png
