scotthowson/desk-setup/manual/build/png/manual/p-69.png

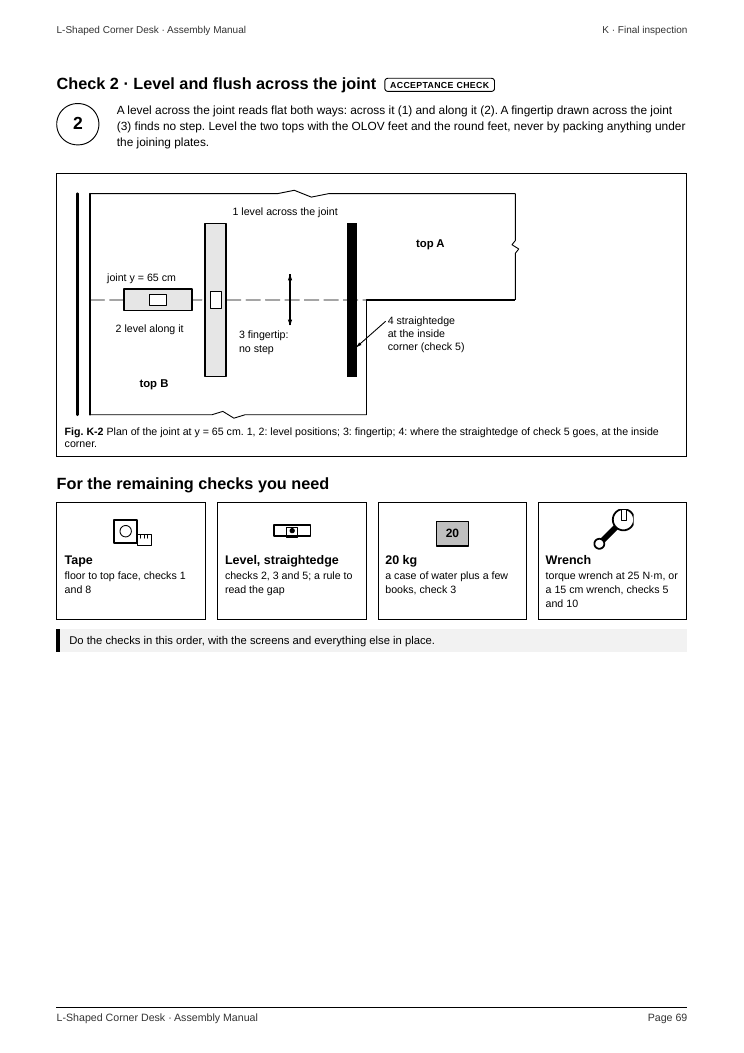
manual/build/png/manual/p-69.png
