scotthowson/desk-setup/manual/build/png/manual/p-72.png

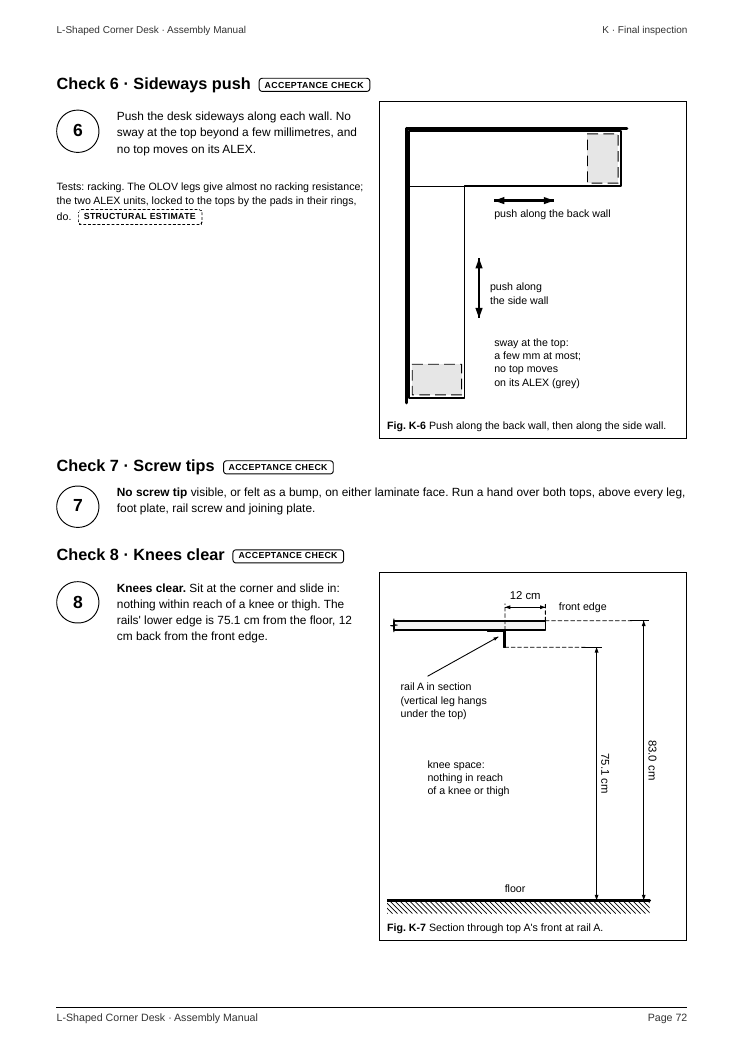
manual/build/png/manual/p-72.png
