scotthowson/desk-setup/manual/build/png/manual/p-75.png

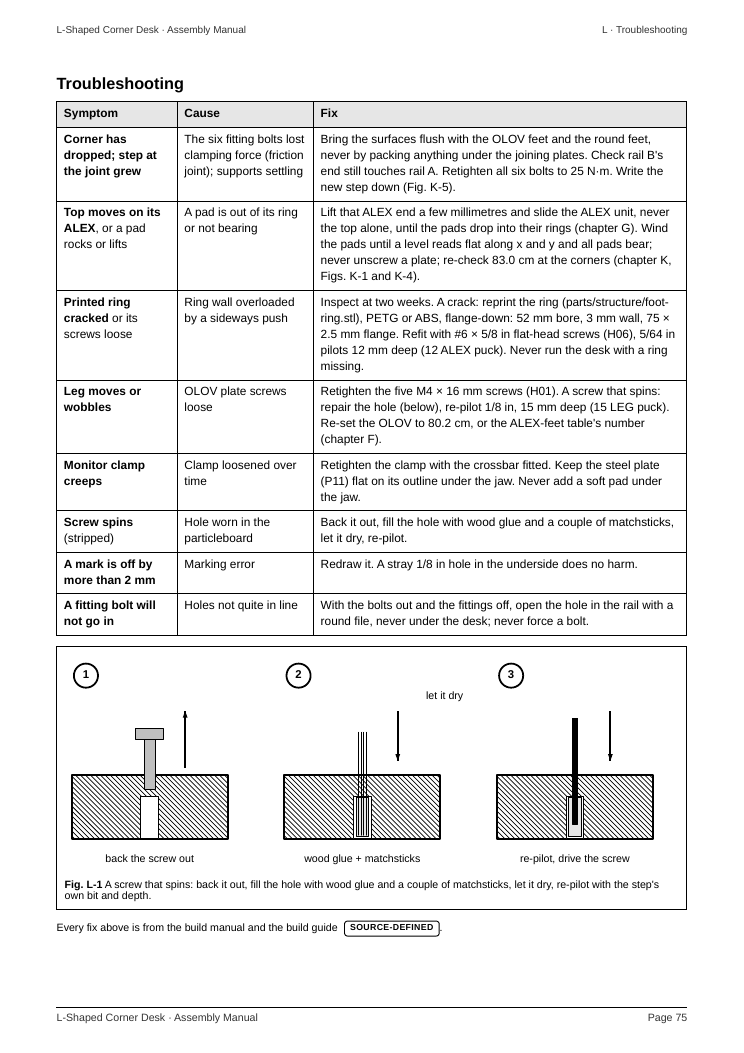
manual/build/png/manual/p-75.png
