scotthowson/desk-setup/manual/build/png/rv-a.png

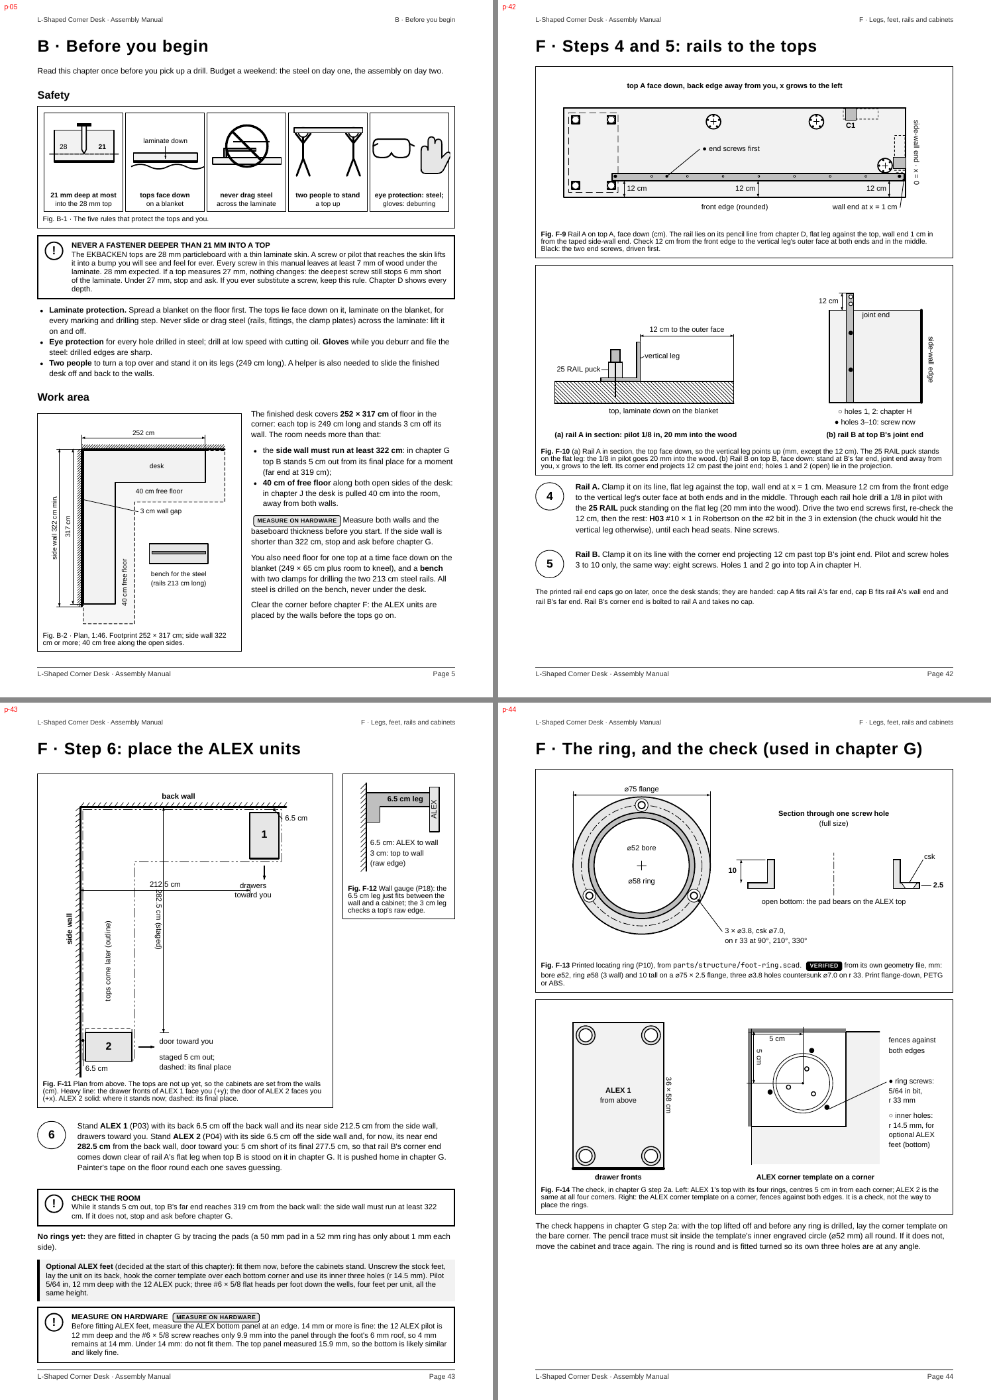
manual/build/png/rv-a.png
