scotthowson/desk-setup/manual/build/png/rv-b.png

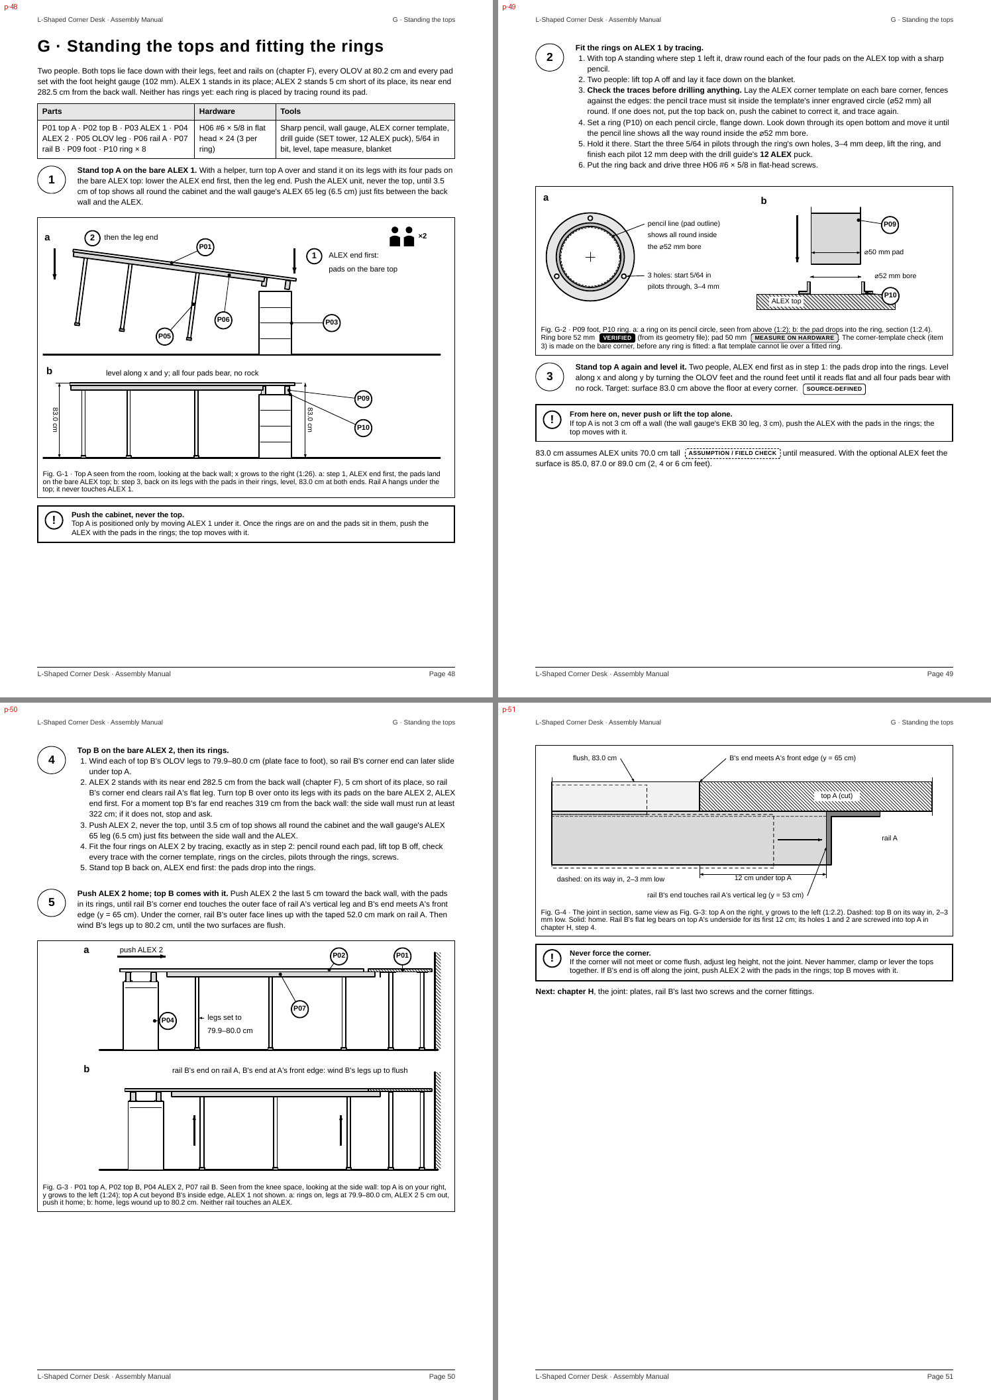
manual/build/png/rv-b.png
