scotthowson/desk-setup/manual/build/png/rv-c.png

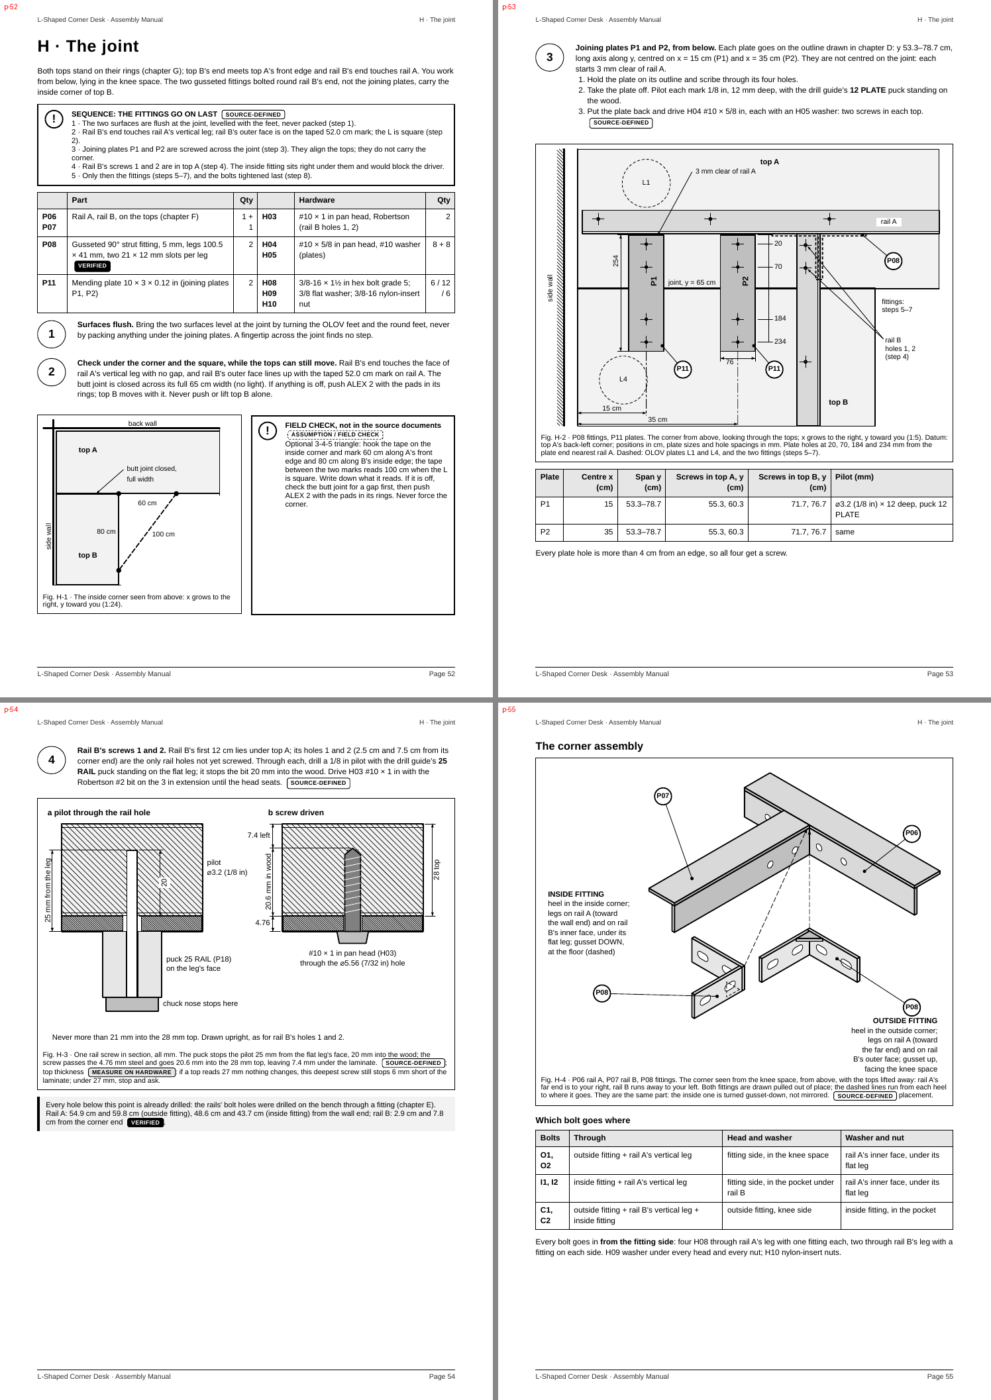
manual/build/png/rv-c.png
