scotthowson/desk-setup/manual/build/png/rv-d.png

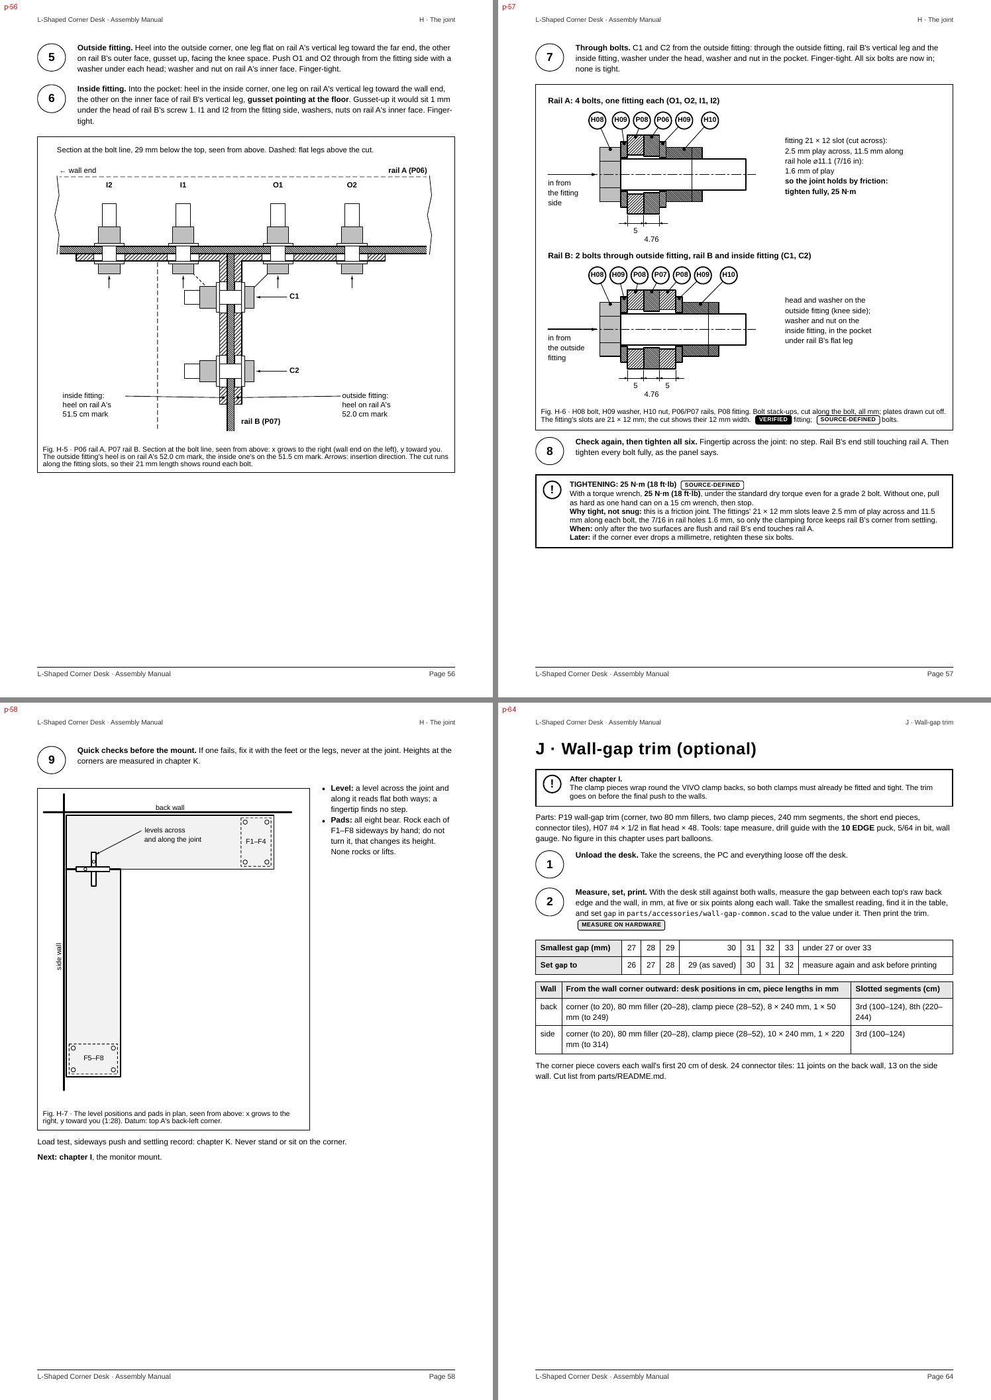
manual/build/png/rv-d.png
