scotthowson/desk-setup/manual/build/png/rv-e.png

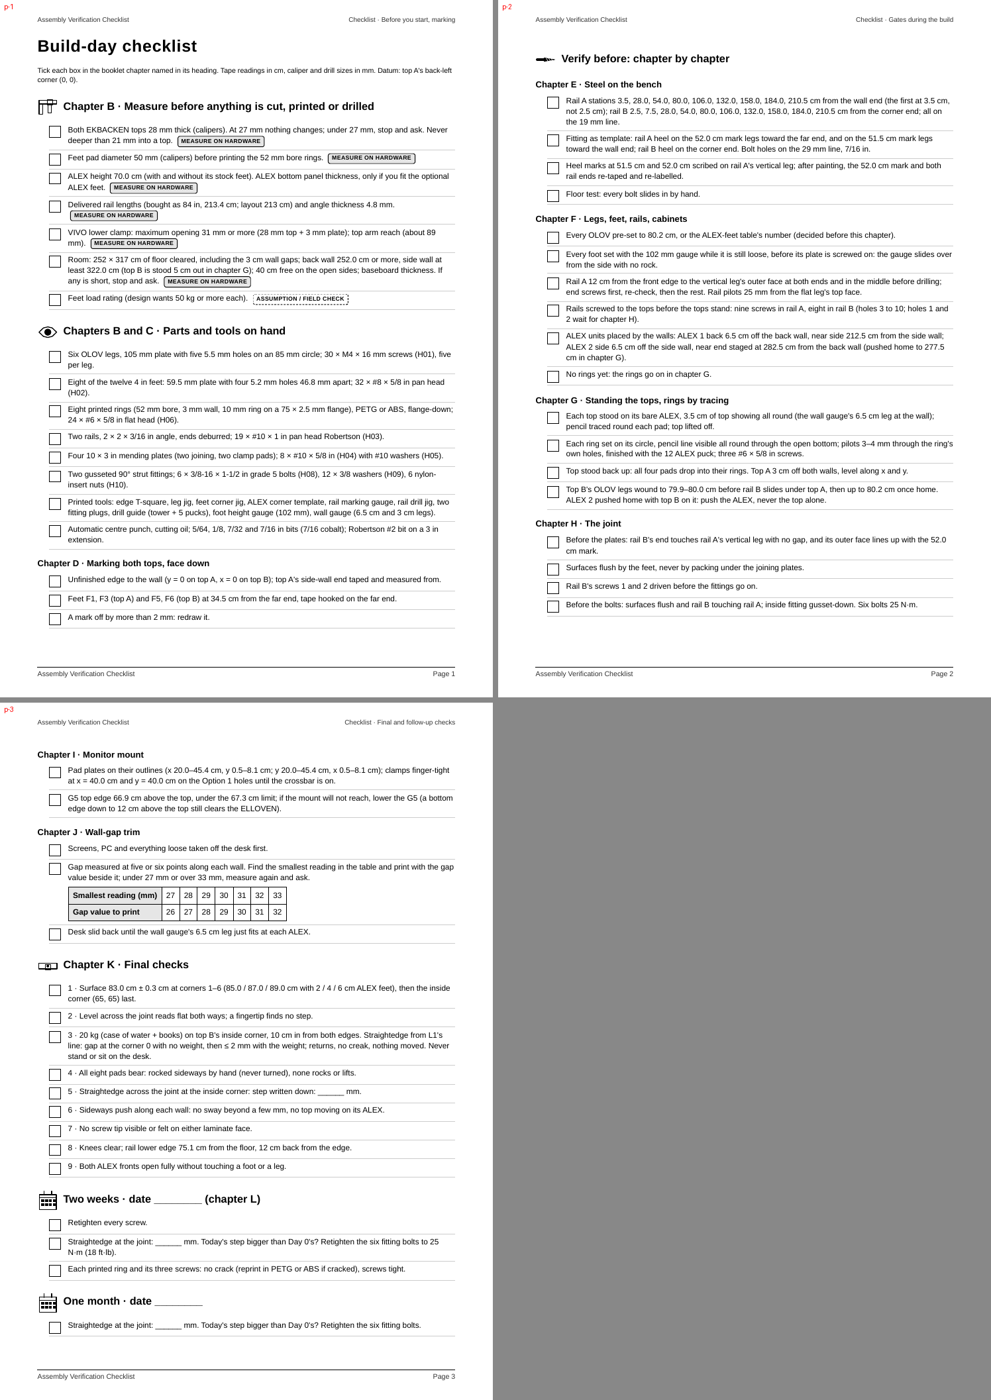
manual/build/png/rv-e.png
