scotthowson/desk-setup/manual/build/png/sheets-checklist/s01.png

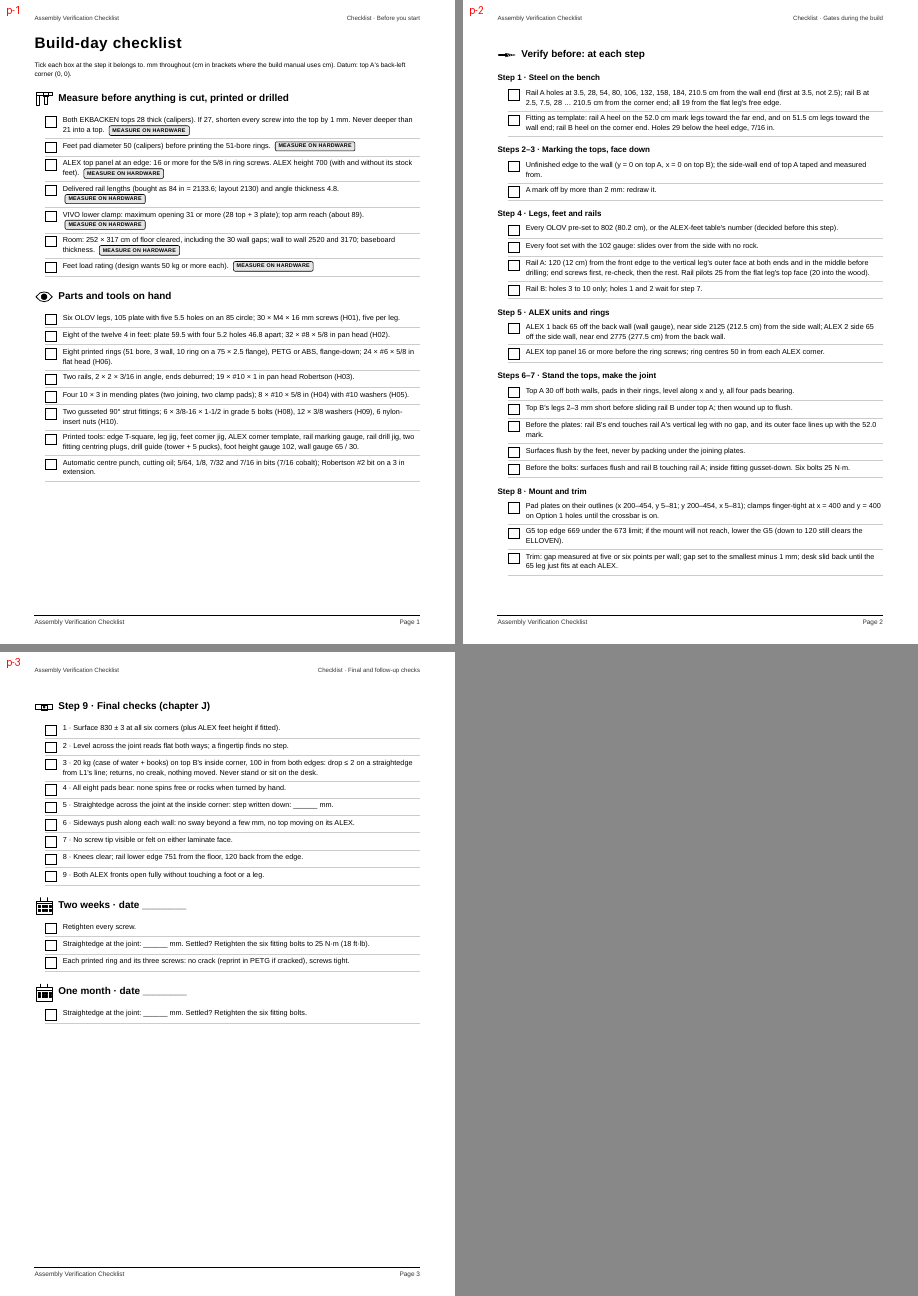
manual/build/png/sheets-checklist/s01.png
