scotthowson/desk-setup/manual/build/png/sheets-manual/s01.png

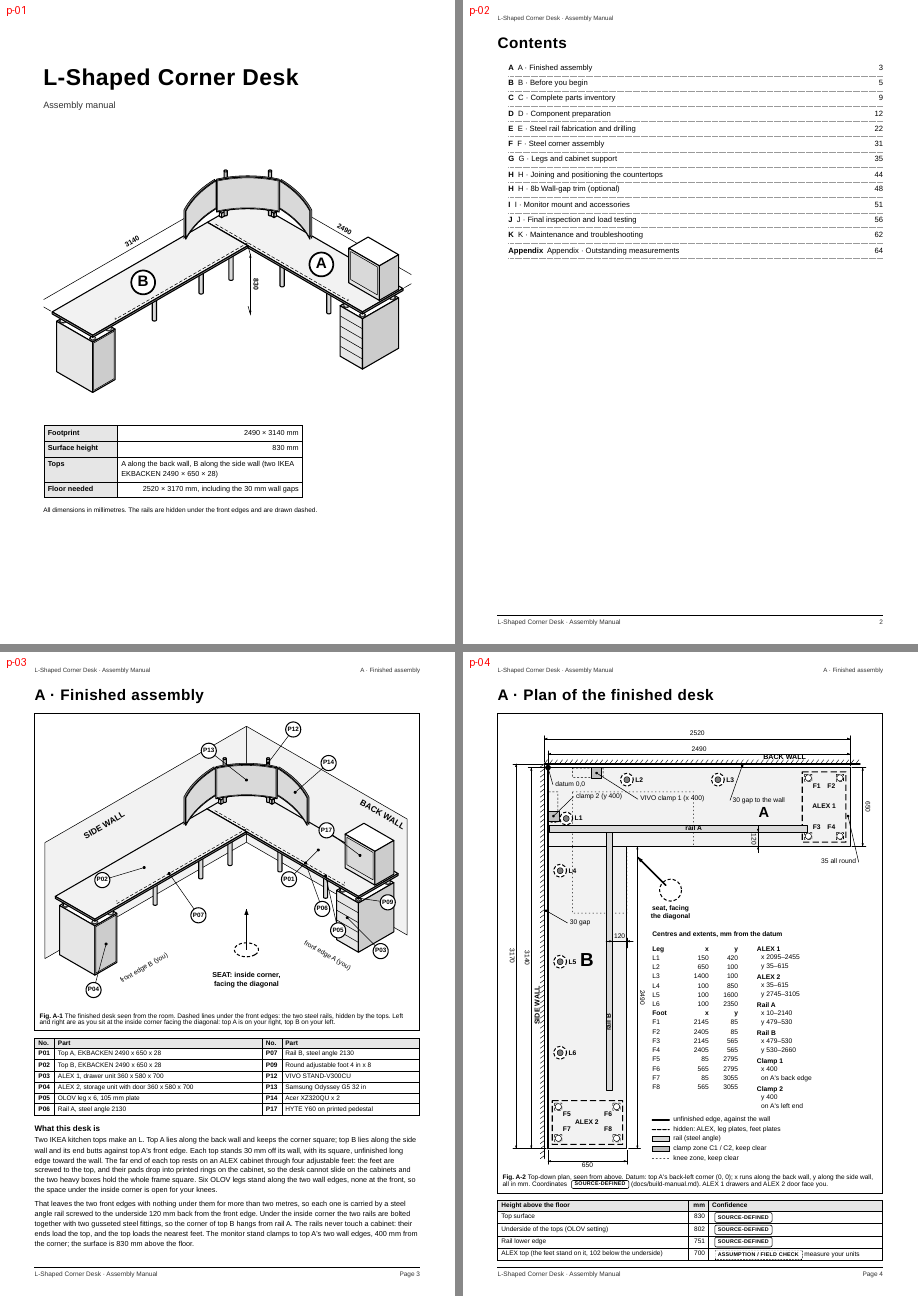
manual/build/png/sheets-manual/s01.png
