scotthowson/desk-setup/manual/build/png/sheets-manual/s02.png

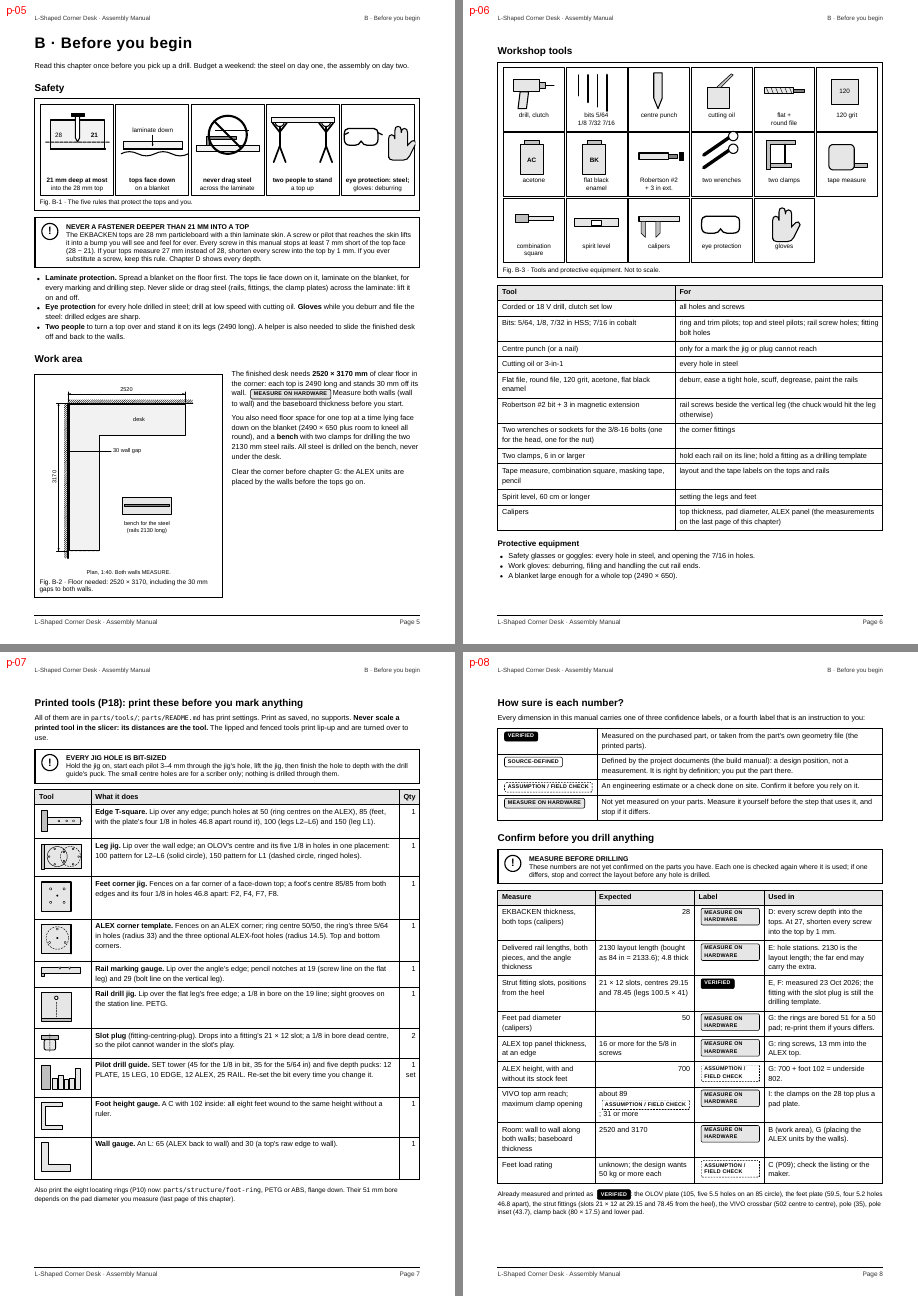
manual/build/png/sheets-manual/s02.png
