scotthowson/desk-setup/manual/build/png/sheets-manual/s03.png

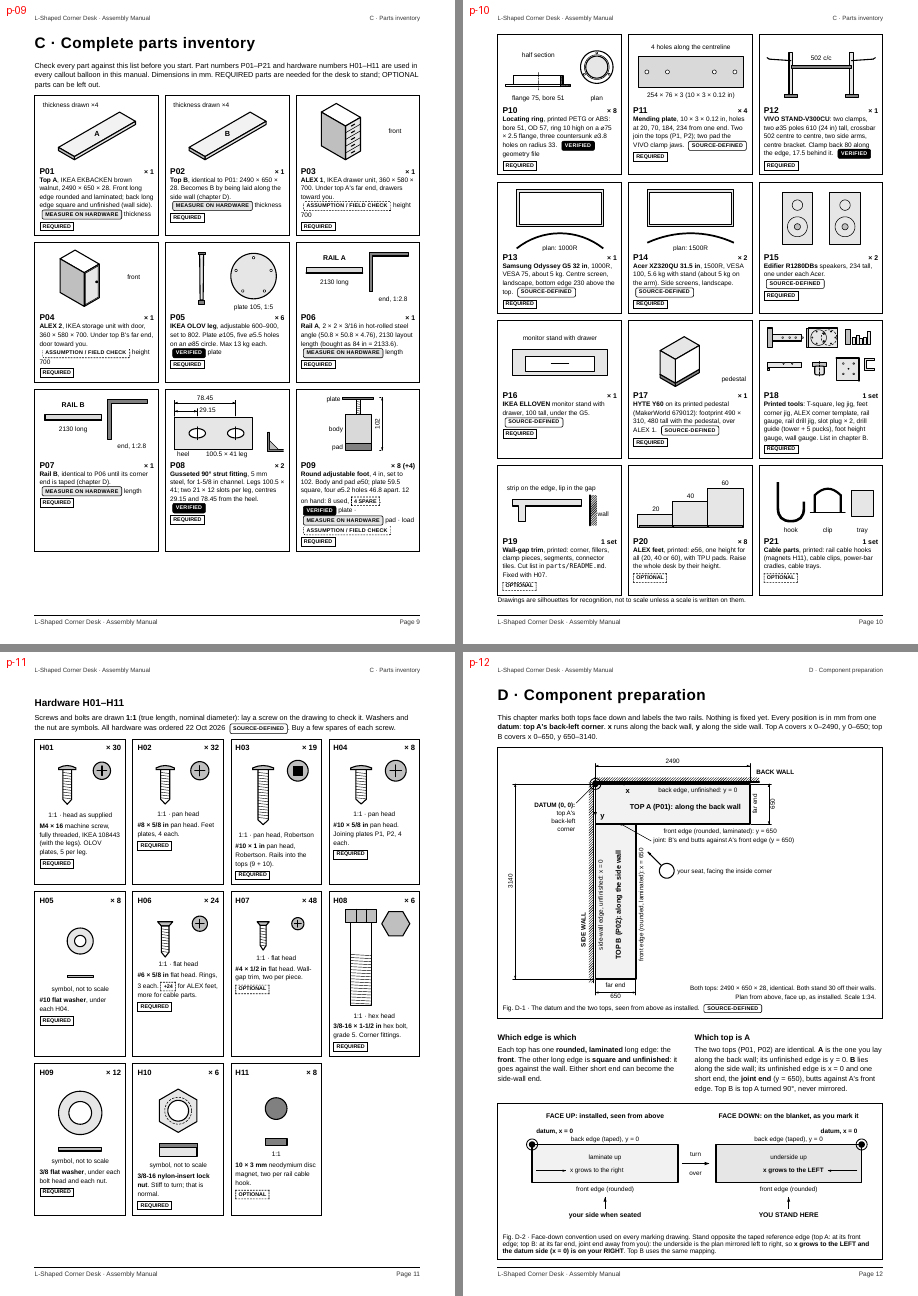
manual/build/png/sheets-manual/s03.png
