scotthowson/desk-setup/manual/build/png/sheets-manual/s04.png

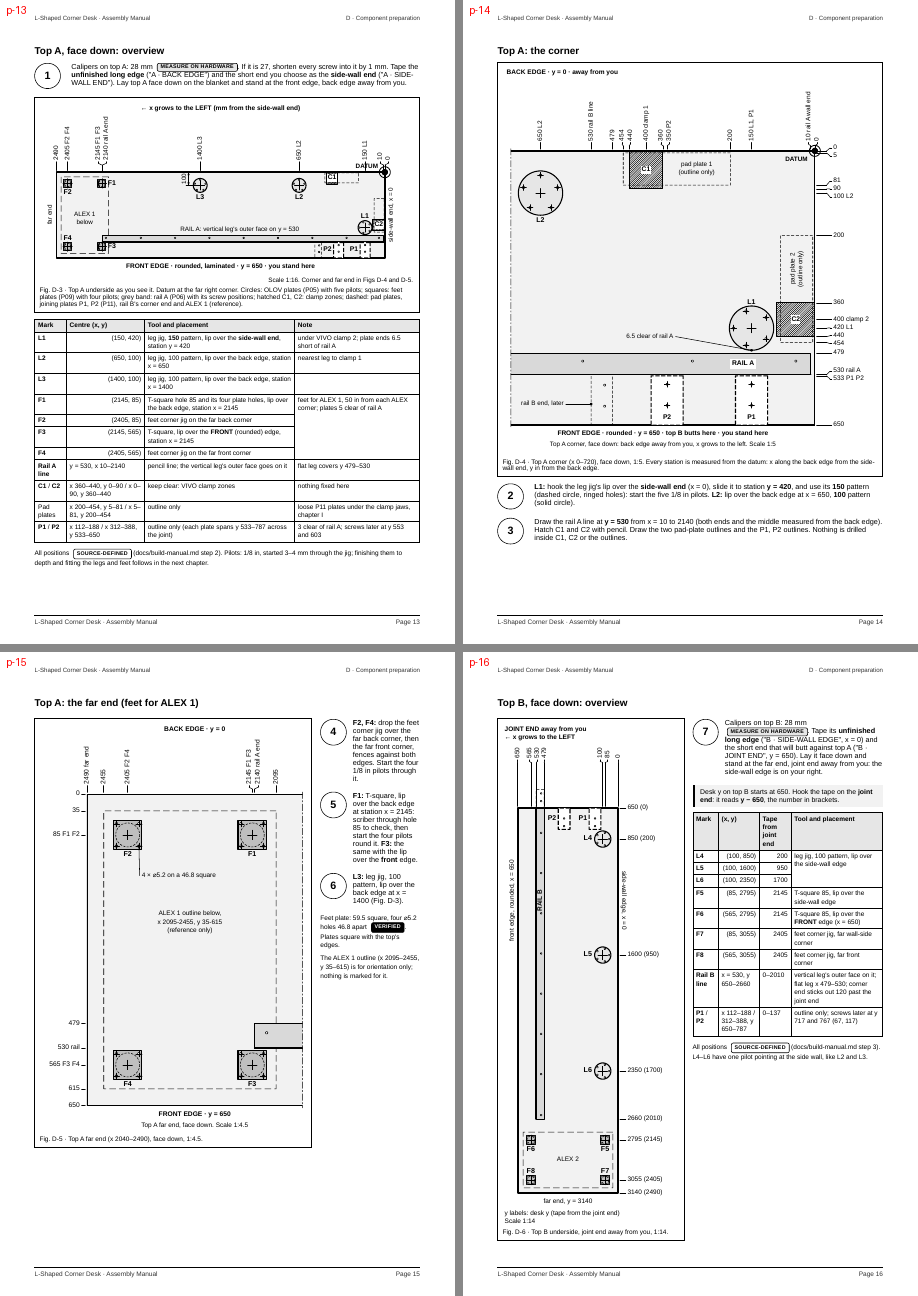
manual/build/png/sheets-manual/s04.png
