scotthowson/desk-setup/manual/build/png/sheets-manual/s05.png

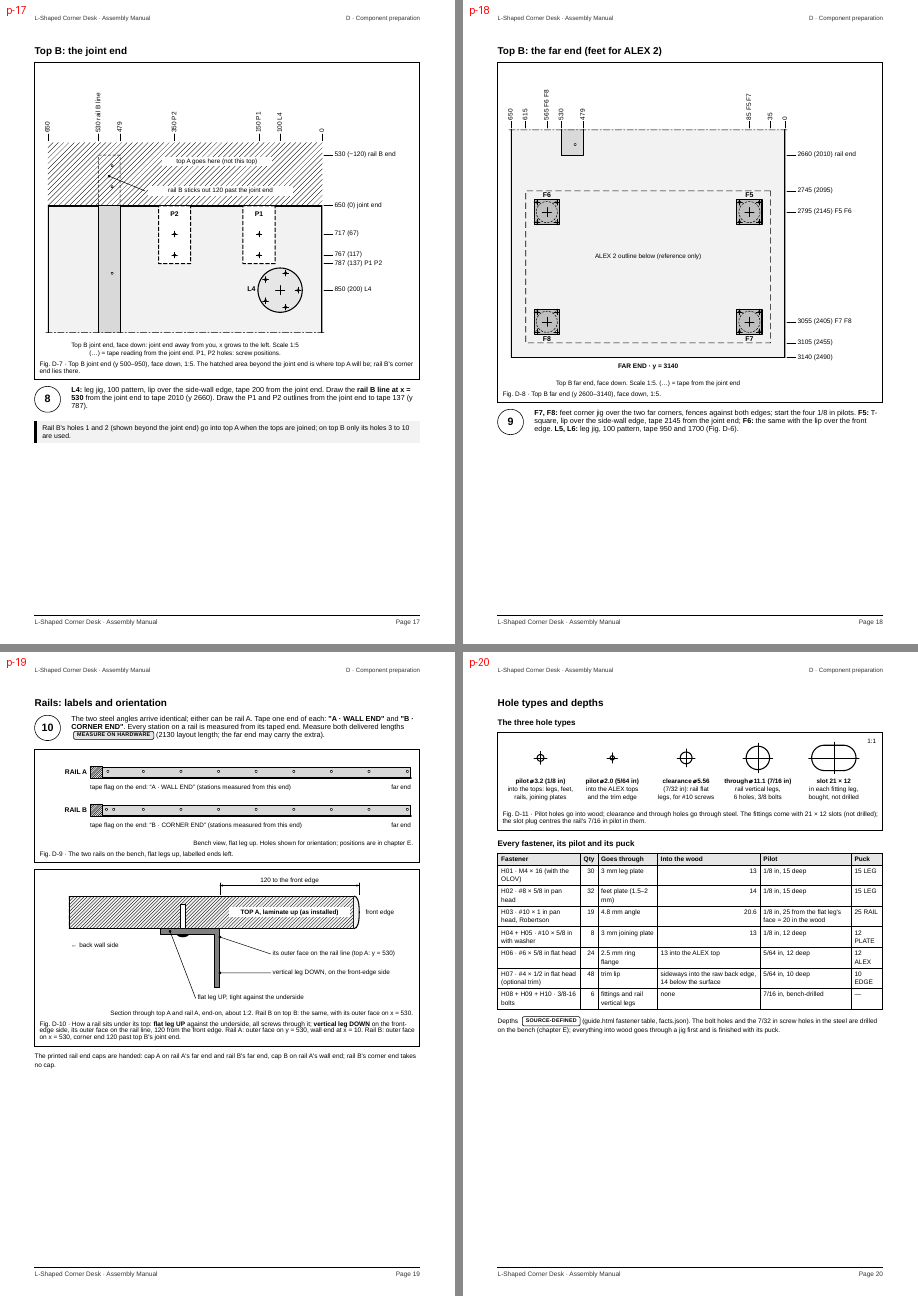
manual/build/png/sheets-manual/s05.png
