scotthowson/desk-setup/manual/build/png/sheets-manual/s06.png

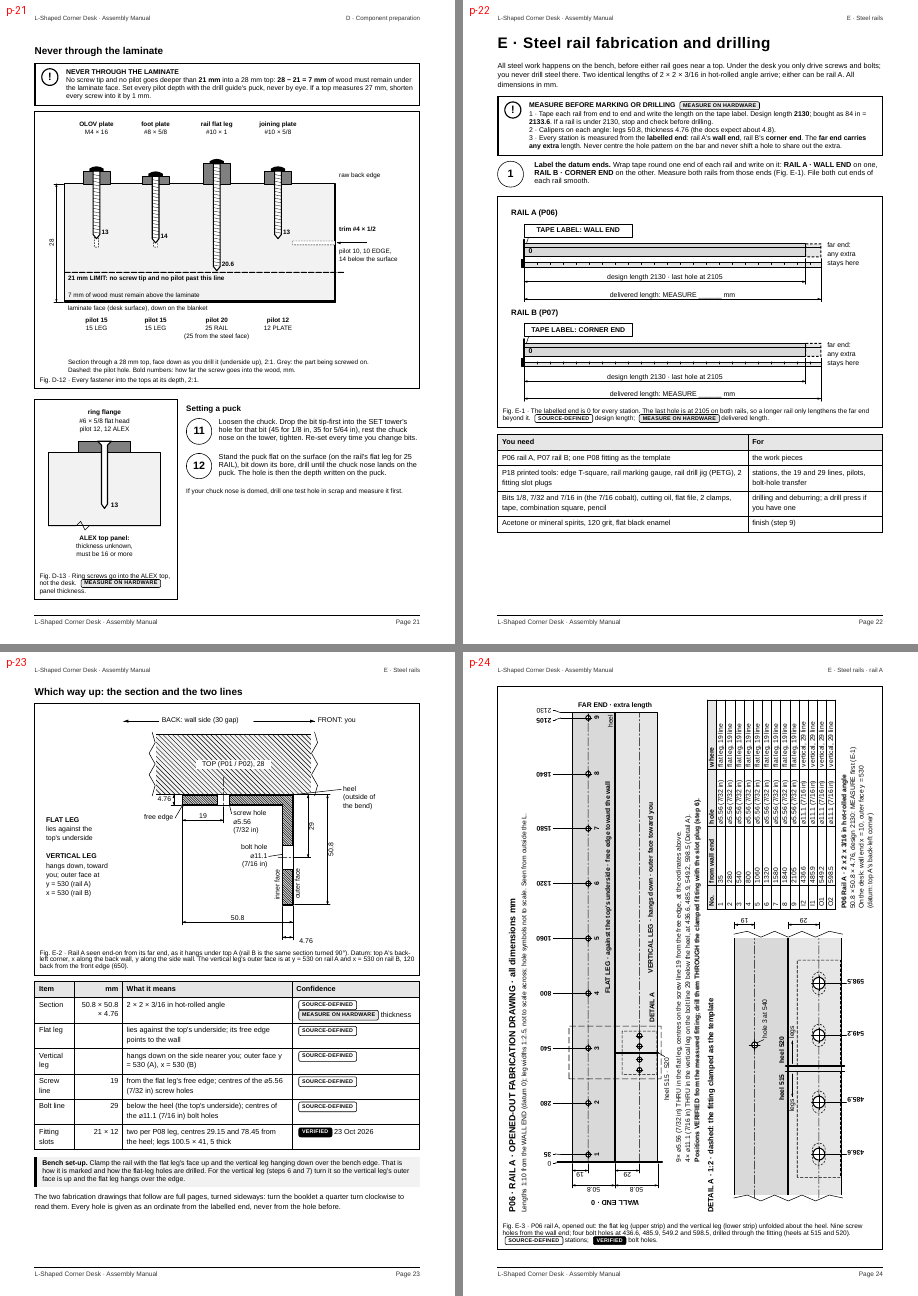
manual/build/png/sheets-manual/s06.png
