scotthowson/desk-setup/manual/build/png/sheets-manual/s07.png

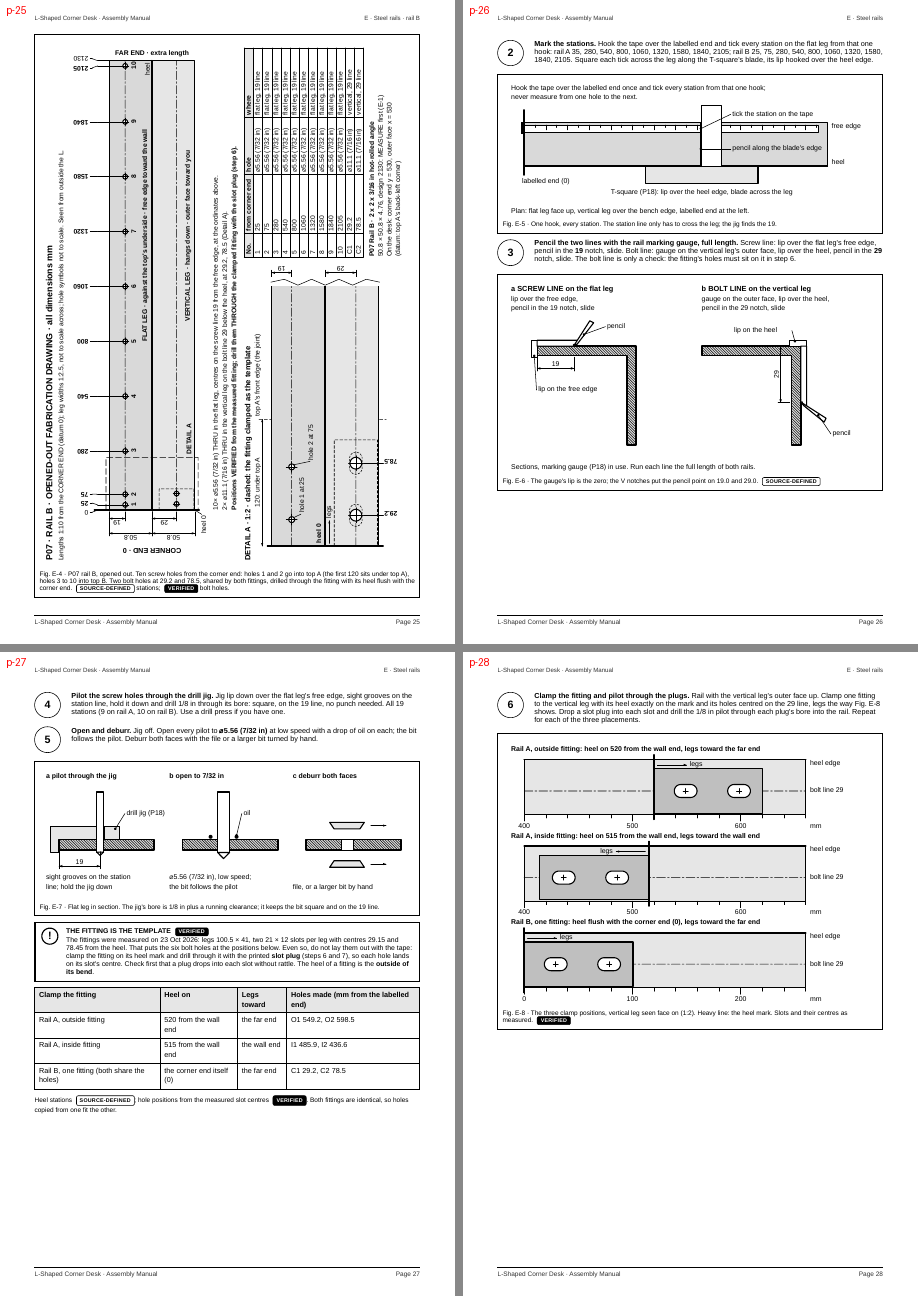
manual/build/png/sheets-manual/s07.png
