scotthowson/desk-setup/manual/build/png/sheets-manual/s08.png

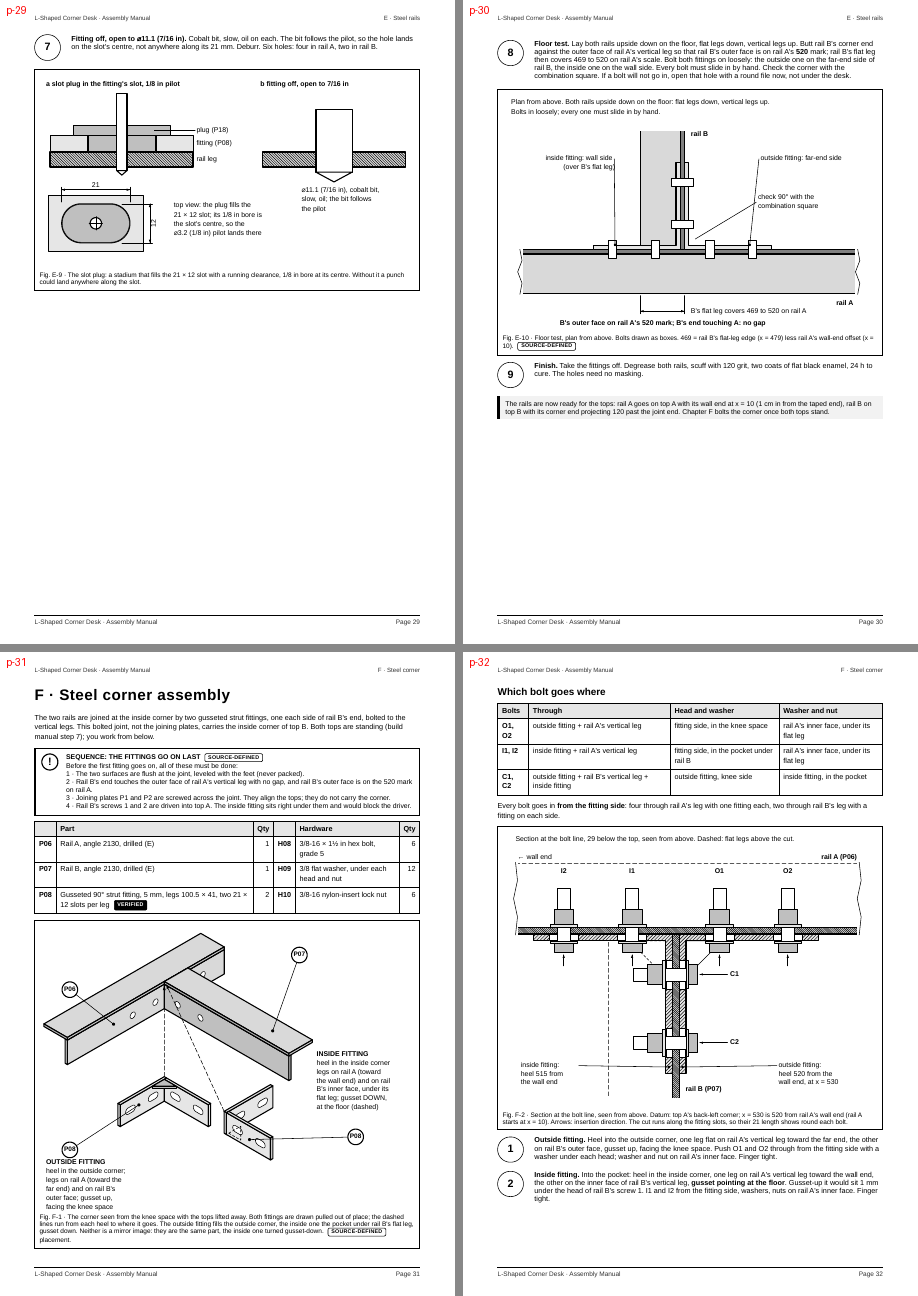
manual/build/png/sheets-manual/s08.png
