scotthowson/desk-setup/manual/build/png/sheets-manual/s09.png

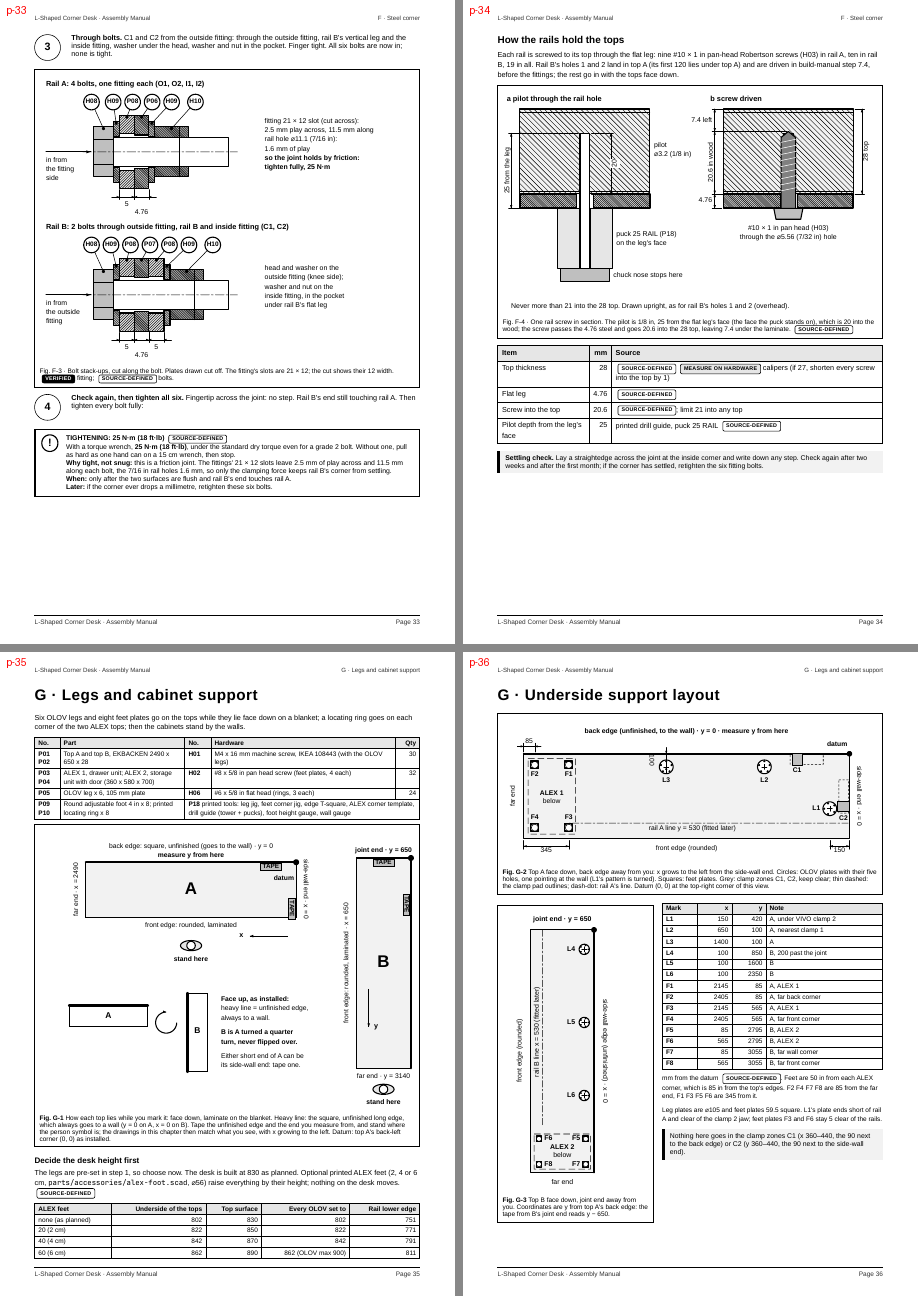
manual/build/png/sheets-manual/s09.png
