scotthowson/desk-setup/manual/build/png/sheets-manual/s10.png

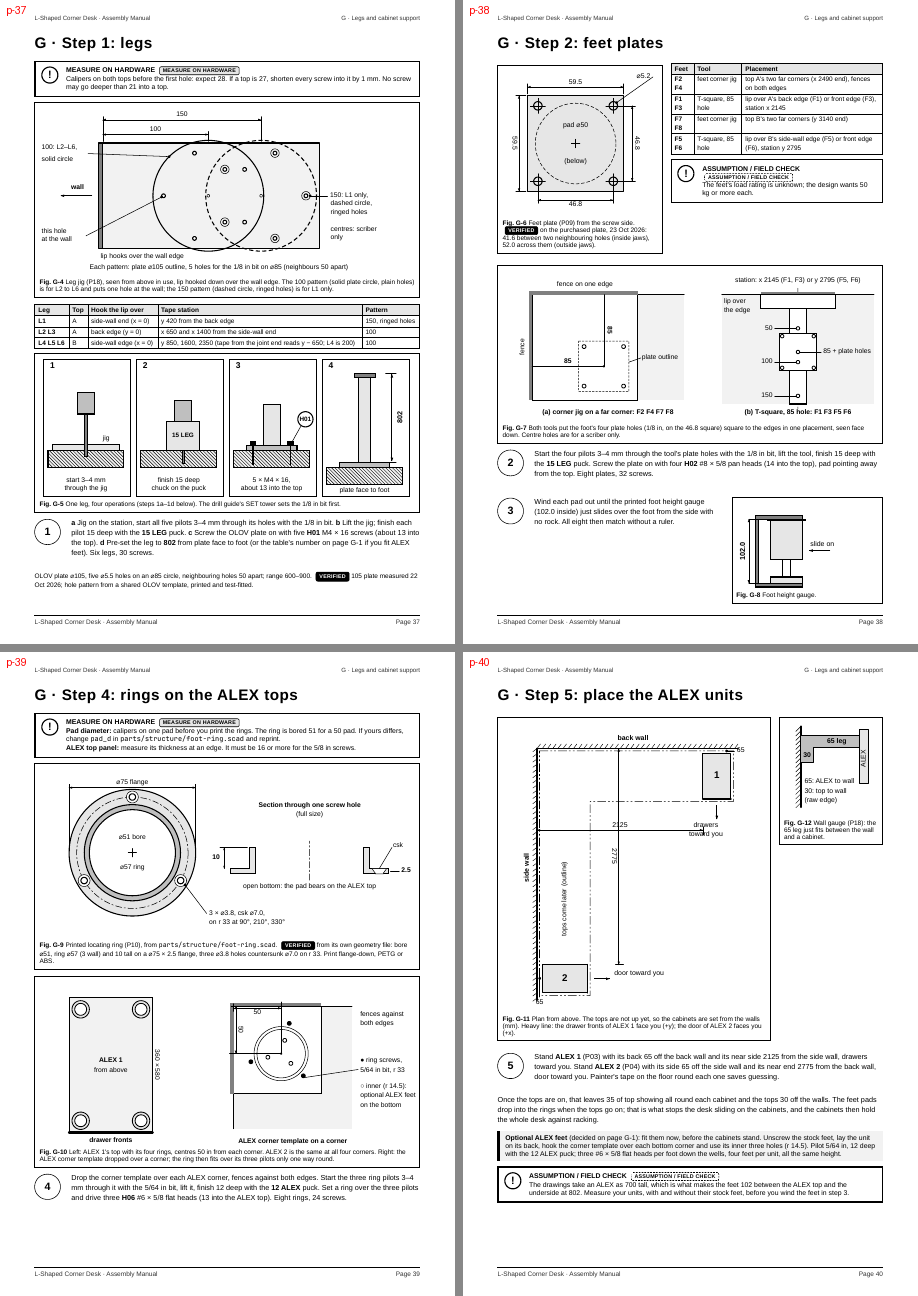
manual/build/png/sheets-manual/s10.png
