scotthowson/desk-setup/manual/build/png/sheets-manual/s11.png

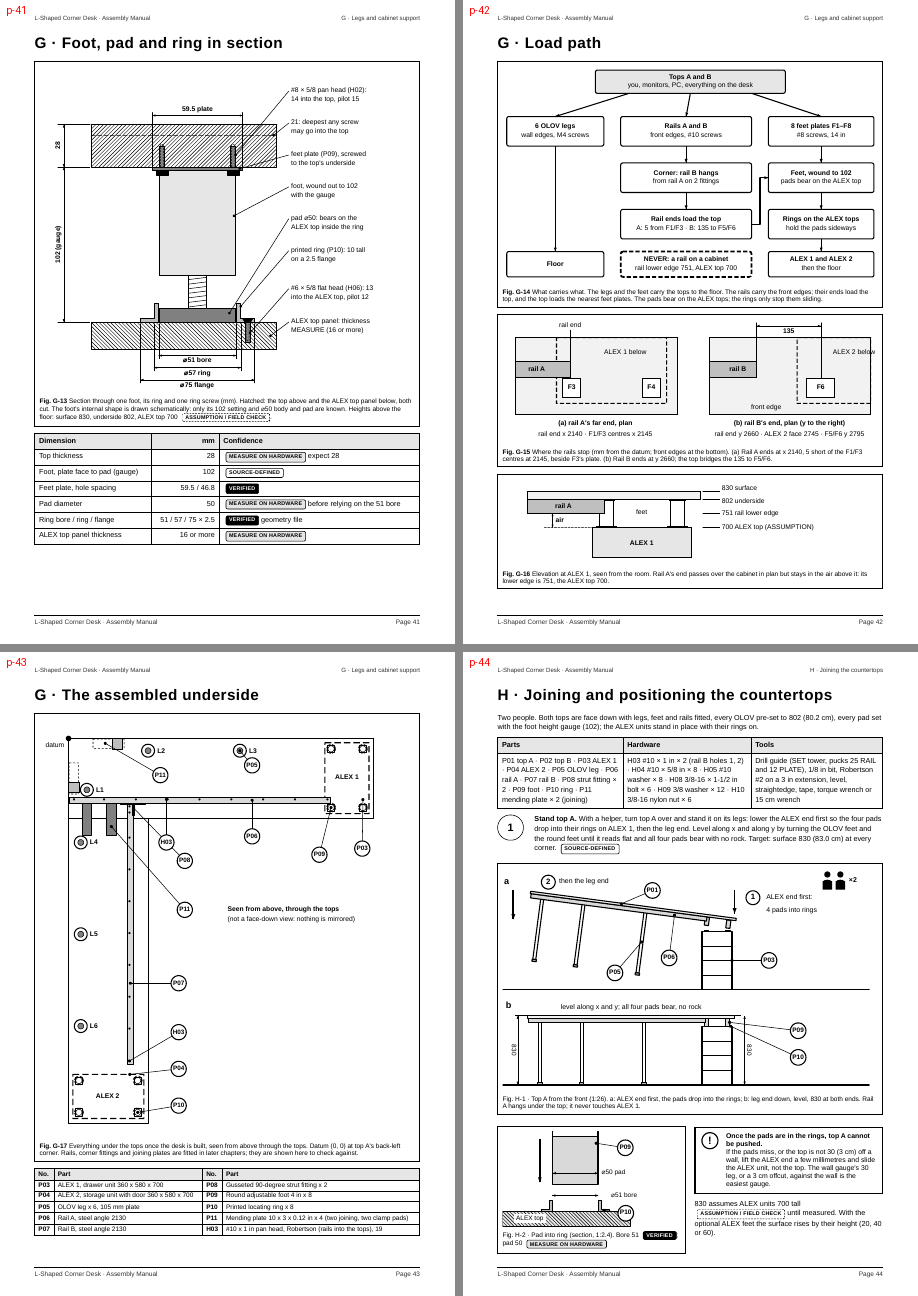
manual/build/png/sheets-manual/s11.png
