scotthowson/desk-setup/manual/build/png/sheets-manual/s12.png

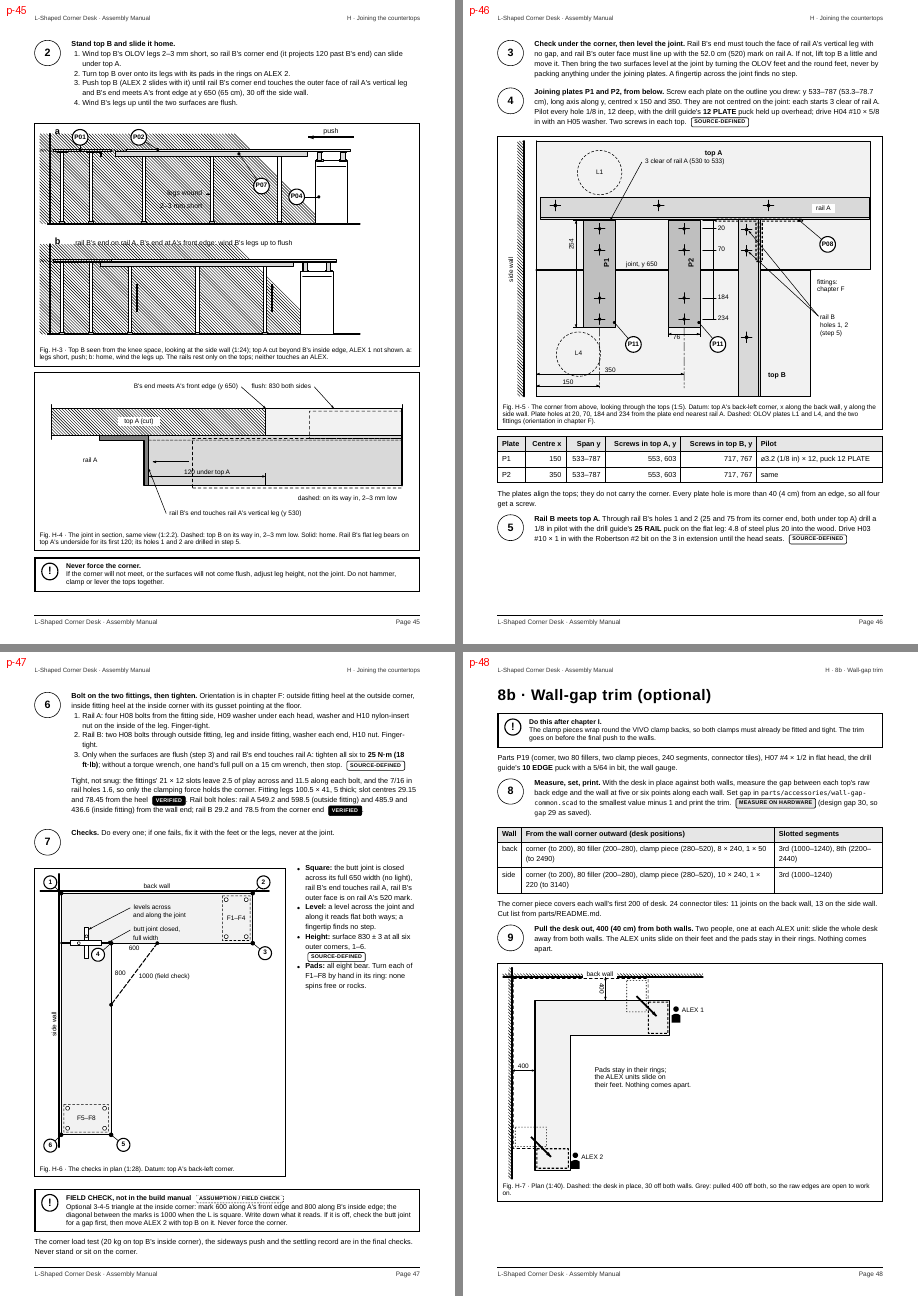
manual/build/png/sheets-manual/s12.png
