scotthowson/desk-setup/manual/build/png/sheets-manual/s13.png

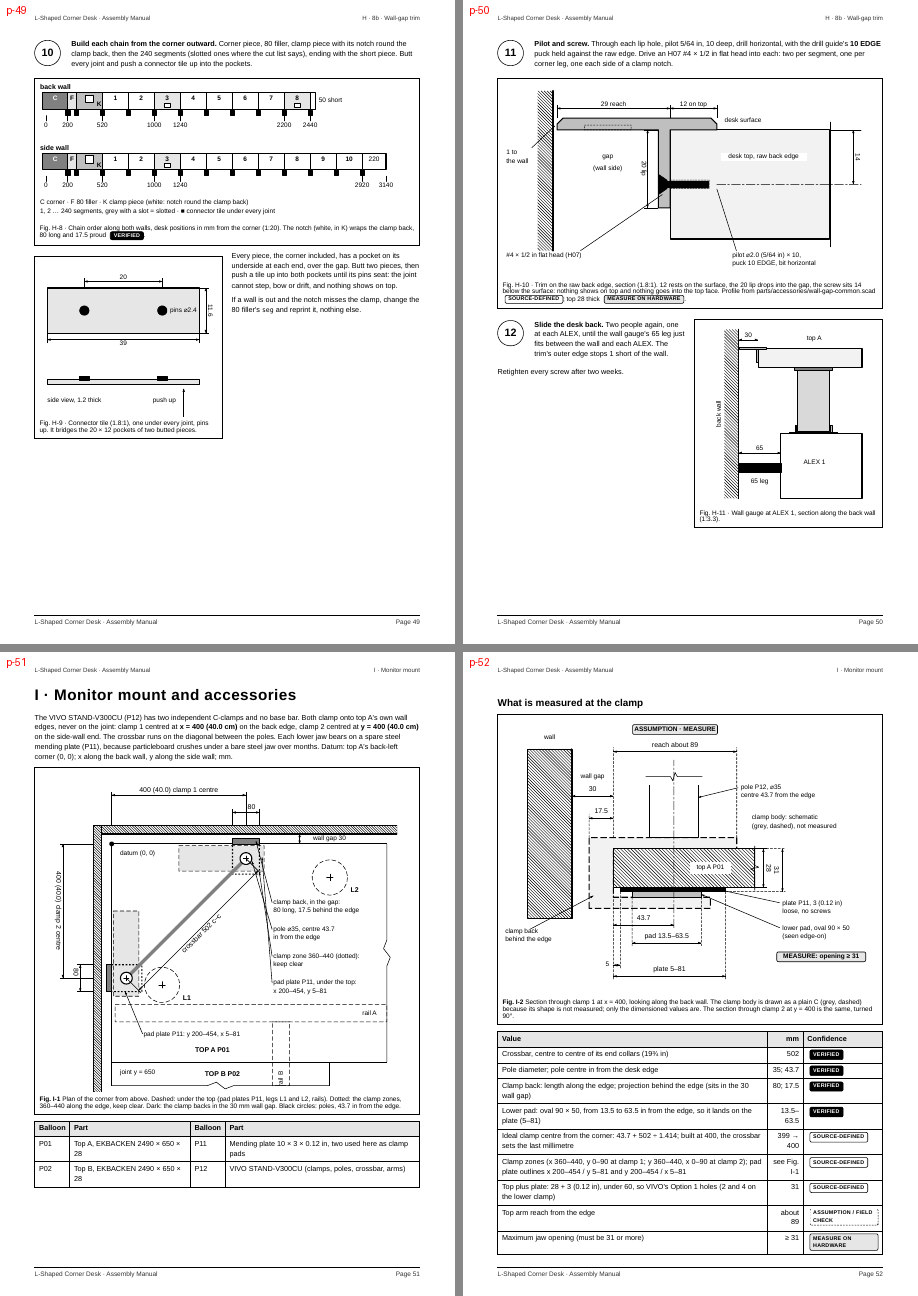
manual/build/png/sheets-manual/s13.png
