scotthowson/desk-setup/manual/build/png/sheets-manual/s14.png

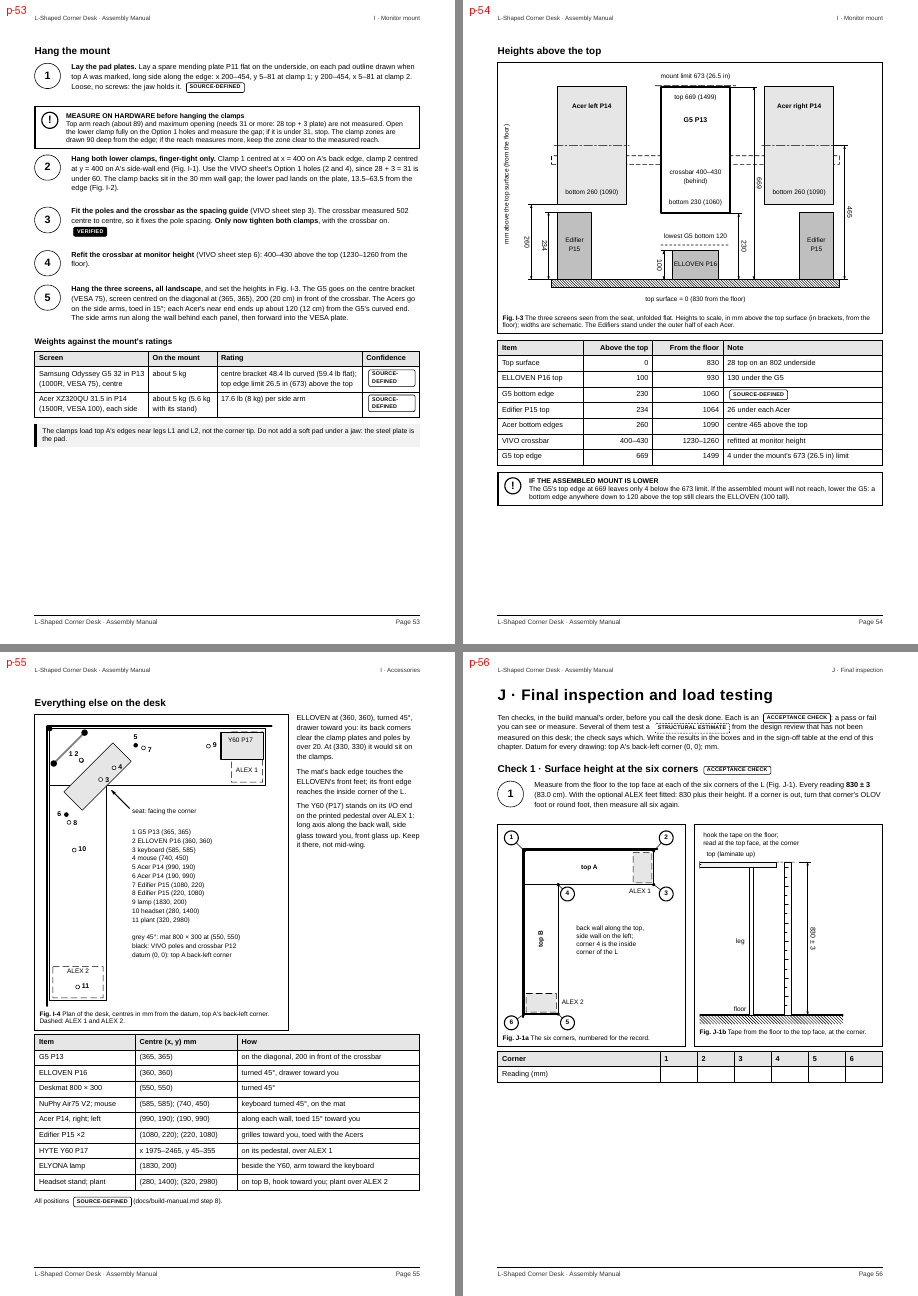
manual/build/png/sheets-manual/s14.png
