scotthowson/desk-setup/manual/build/png/sheets-manual/s15.png

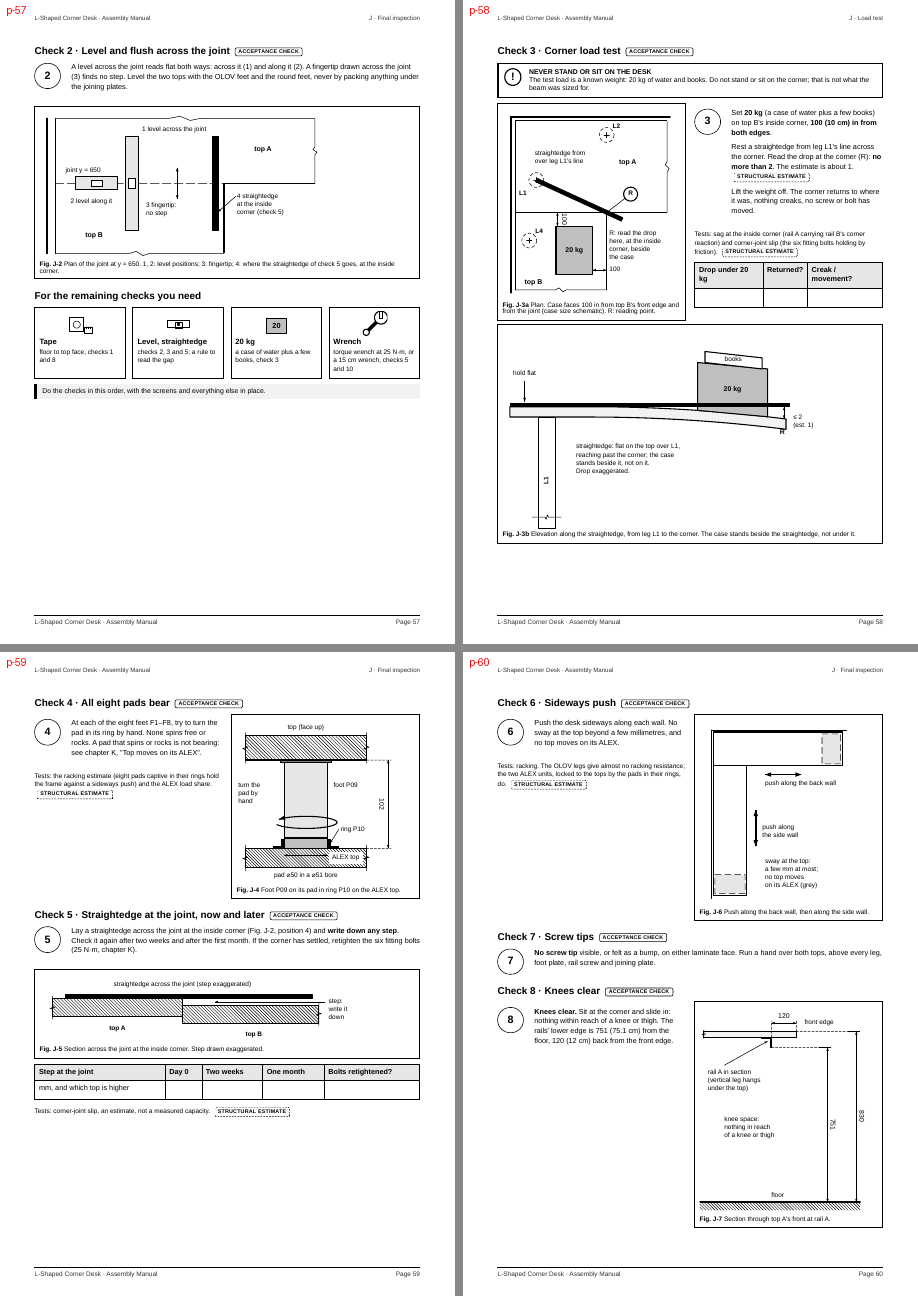
manual/build/png/sheets-manual/s15.png
