scotthowson/desk-setup/manual/build/png/sheets-manual/s16.png

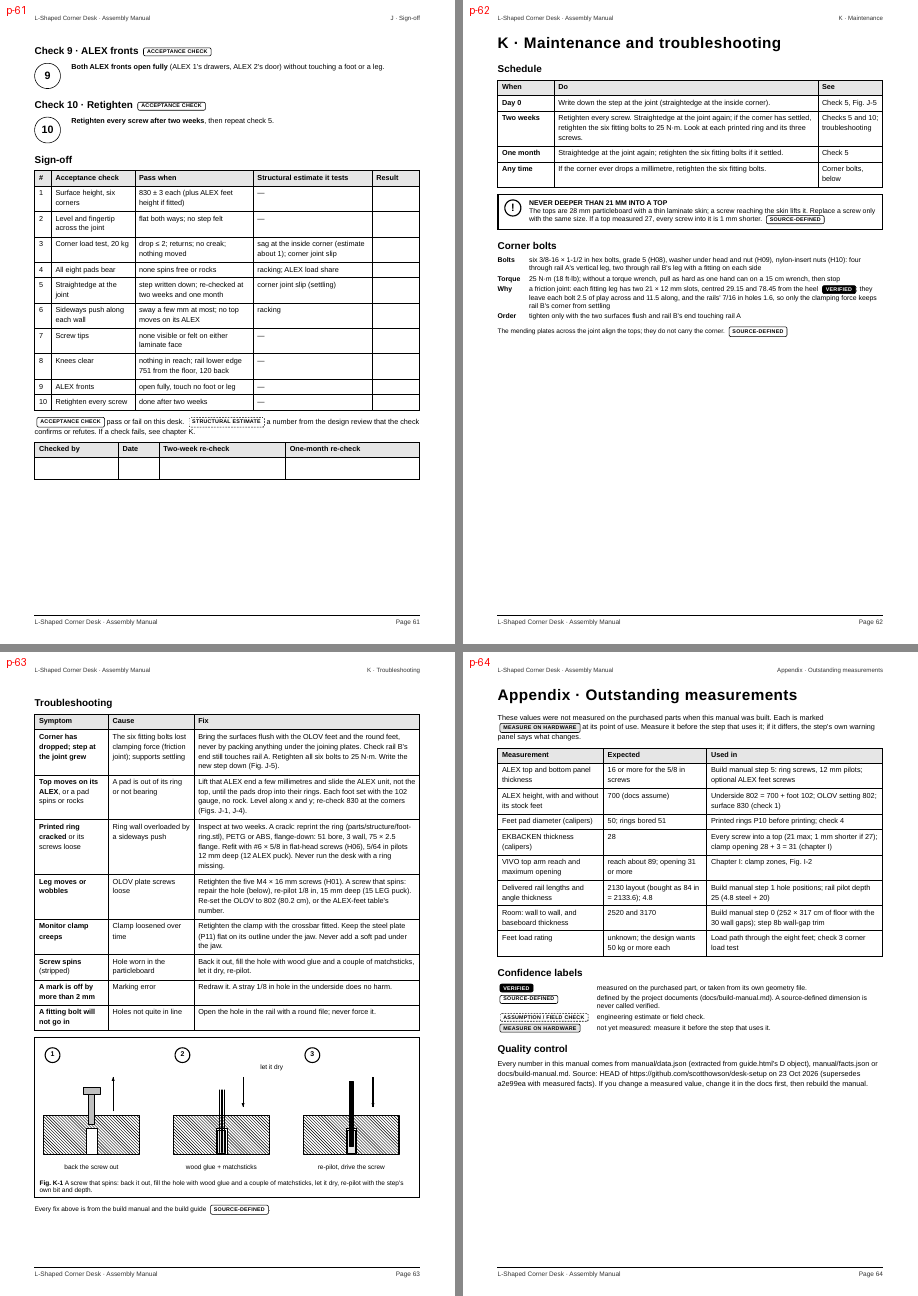
manual/build/png/sheets-manual/s16.png
