scotthowson/desk-setup/manual/build/png/sheets-templates/s01.png

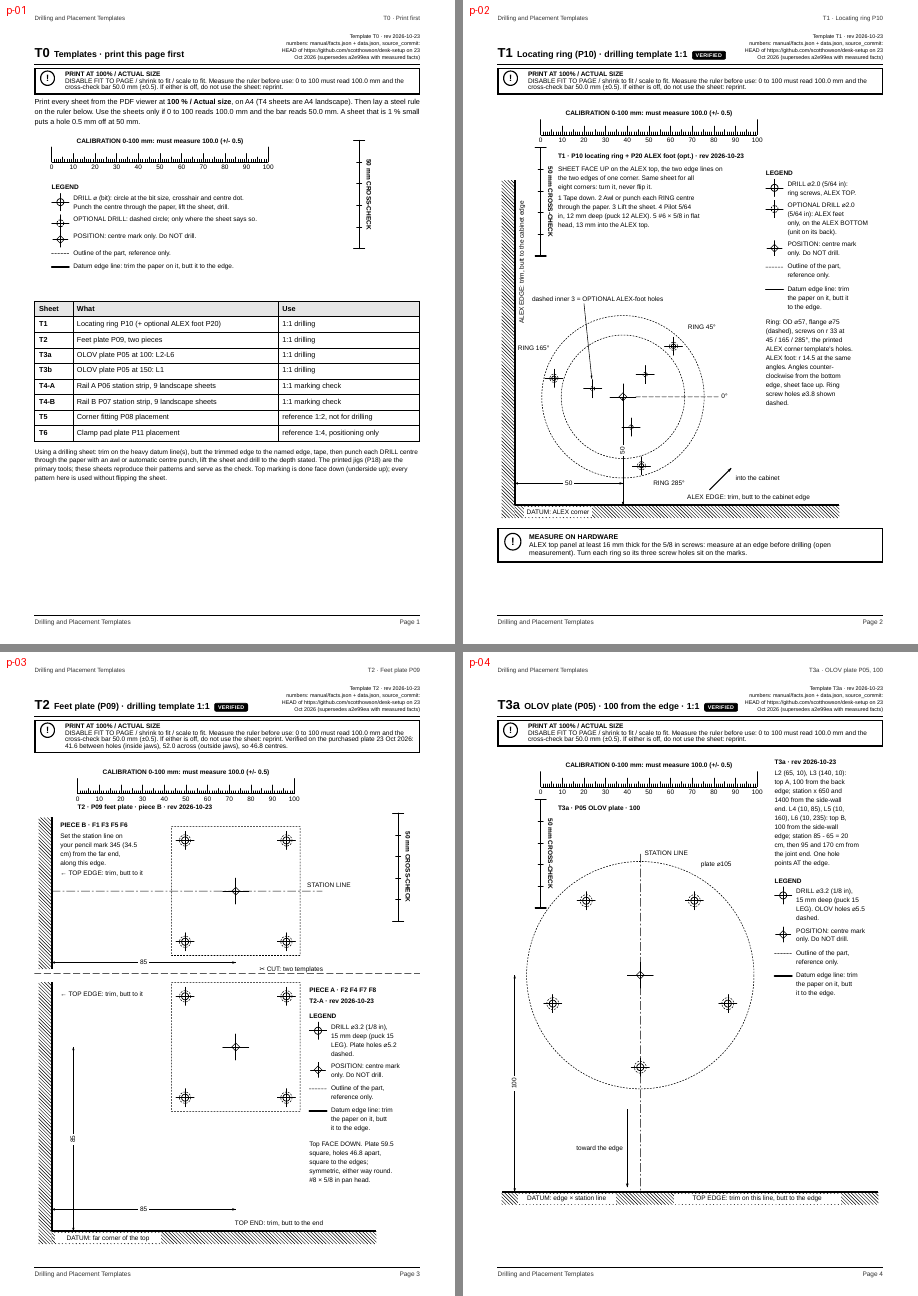
manual/build/png/sheets-templates/s01.png
