scotthowson/desk-setup/manual/build/png/sheets-templates/s02.png

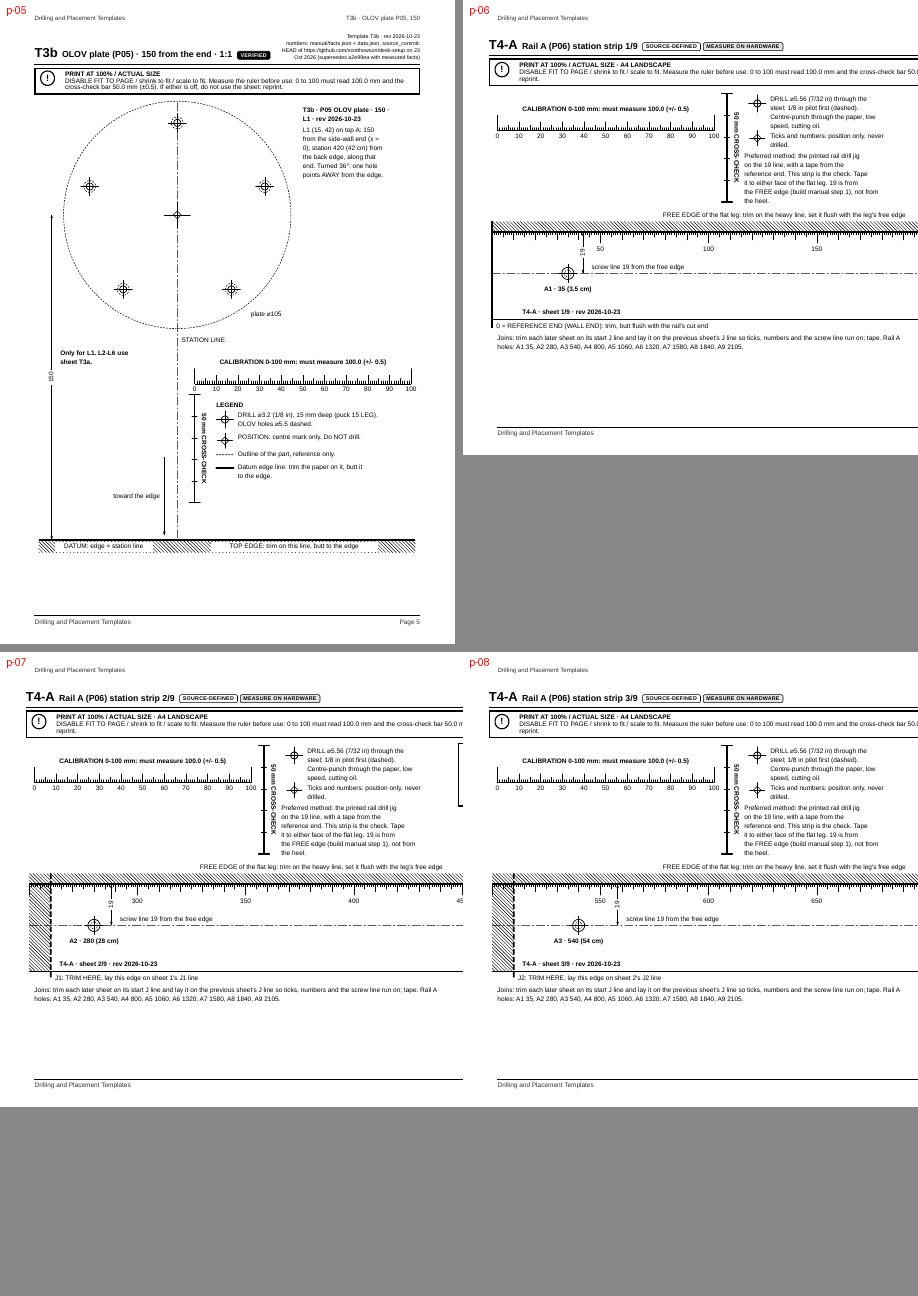
manual/build/png/sheets-templates/s02.png
