scotthowson/desk-setup/manual/build/png/sheets-templates/s03.png

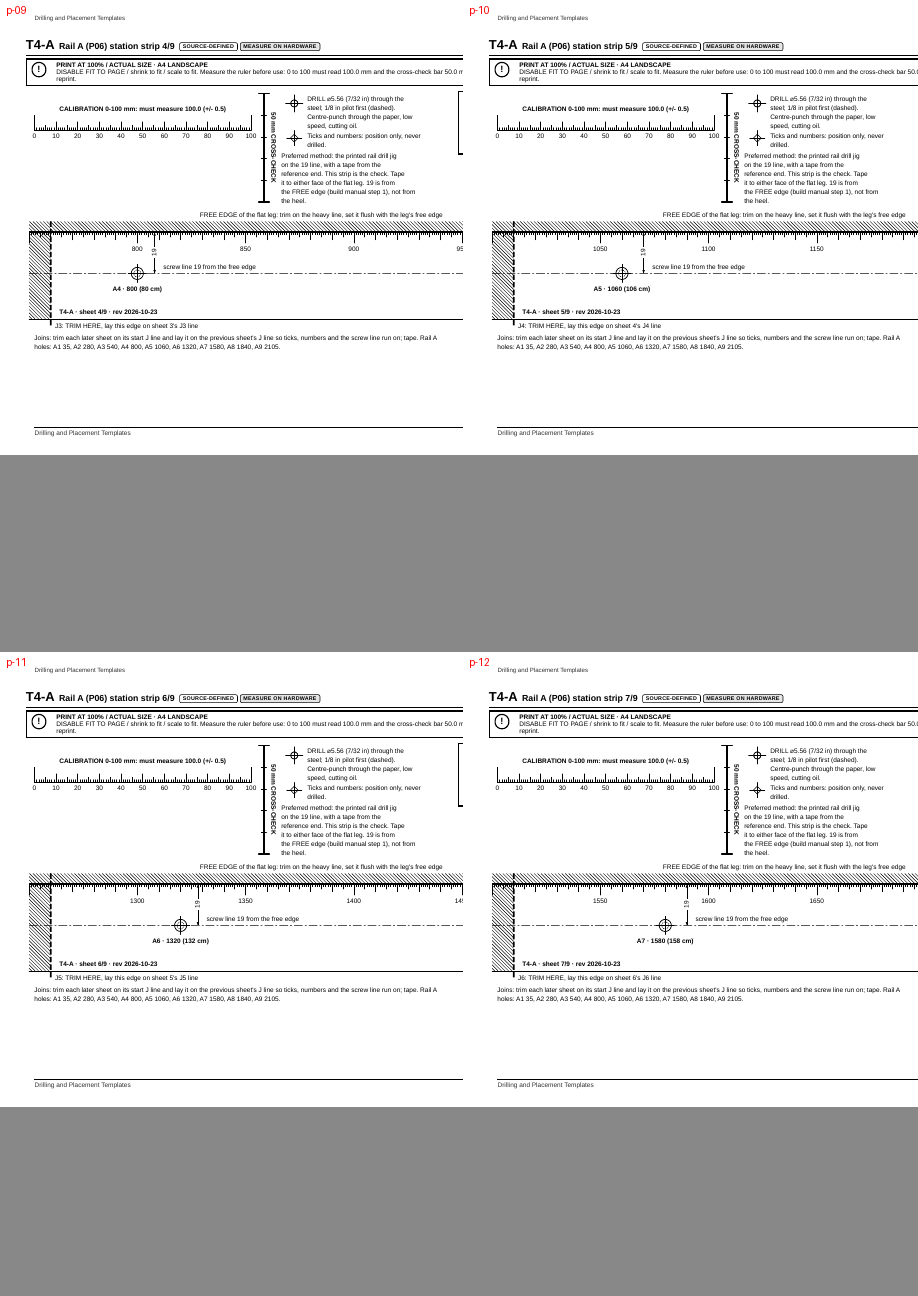
manual/build/png/sheets-templates/s03.png
