scotthowson/desk-setup/manual/build/png/sheets-templates/s04.png

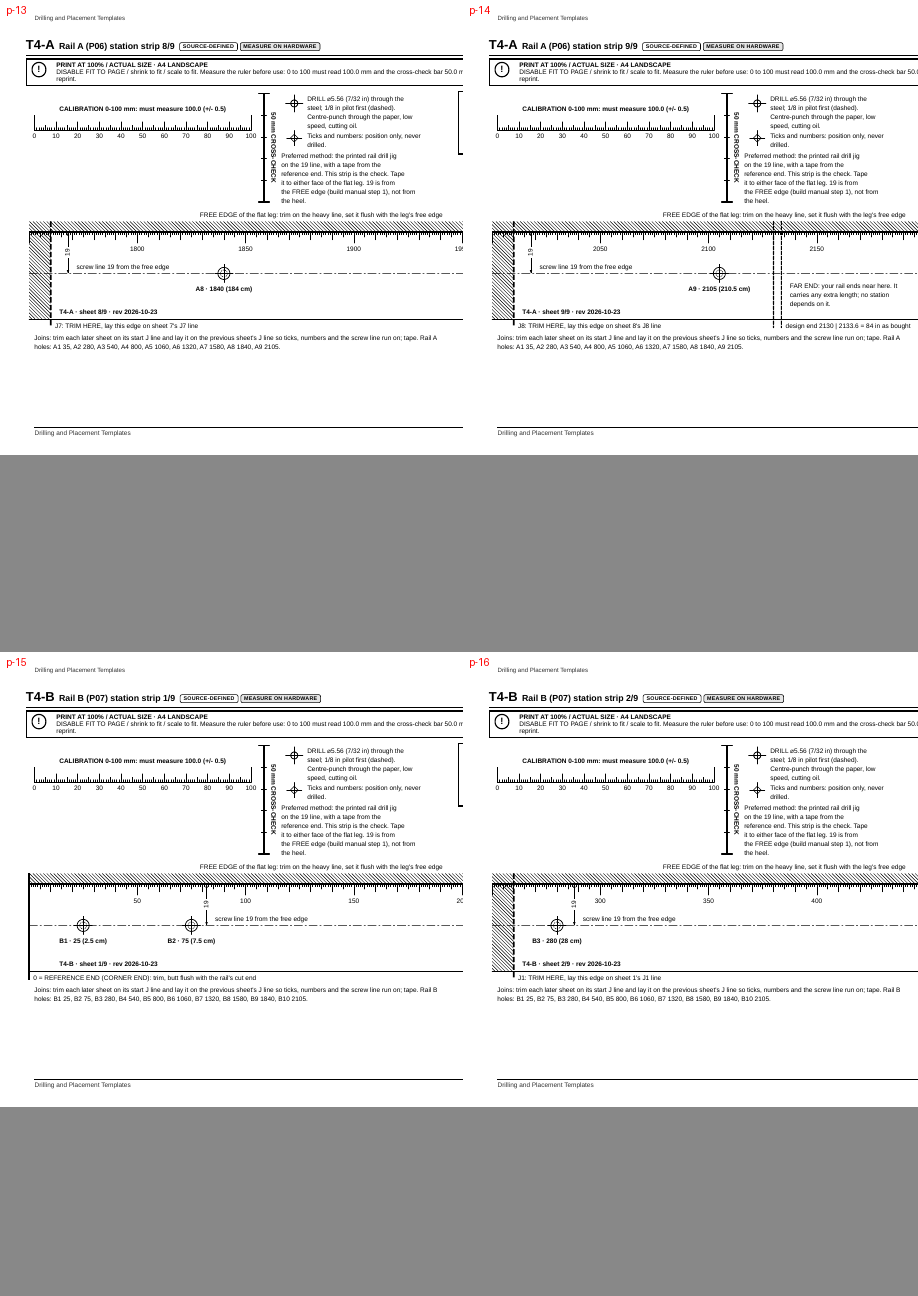
manual/build/png/sheets-templates/s04.png
