scotthowson/desk-setup/manual/build/png/sheets-templates/s06.png

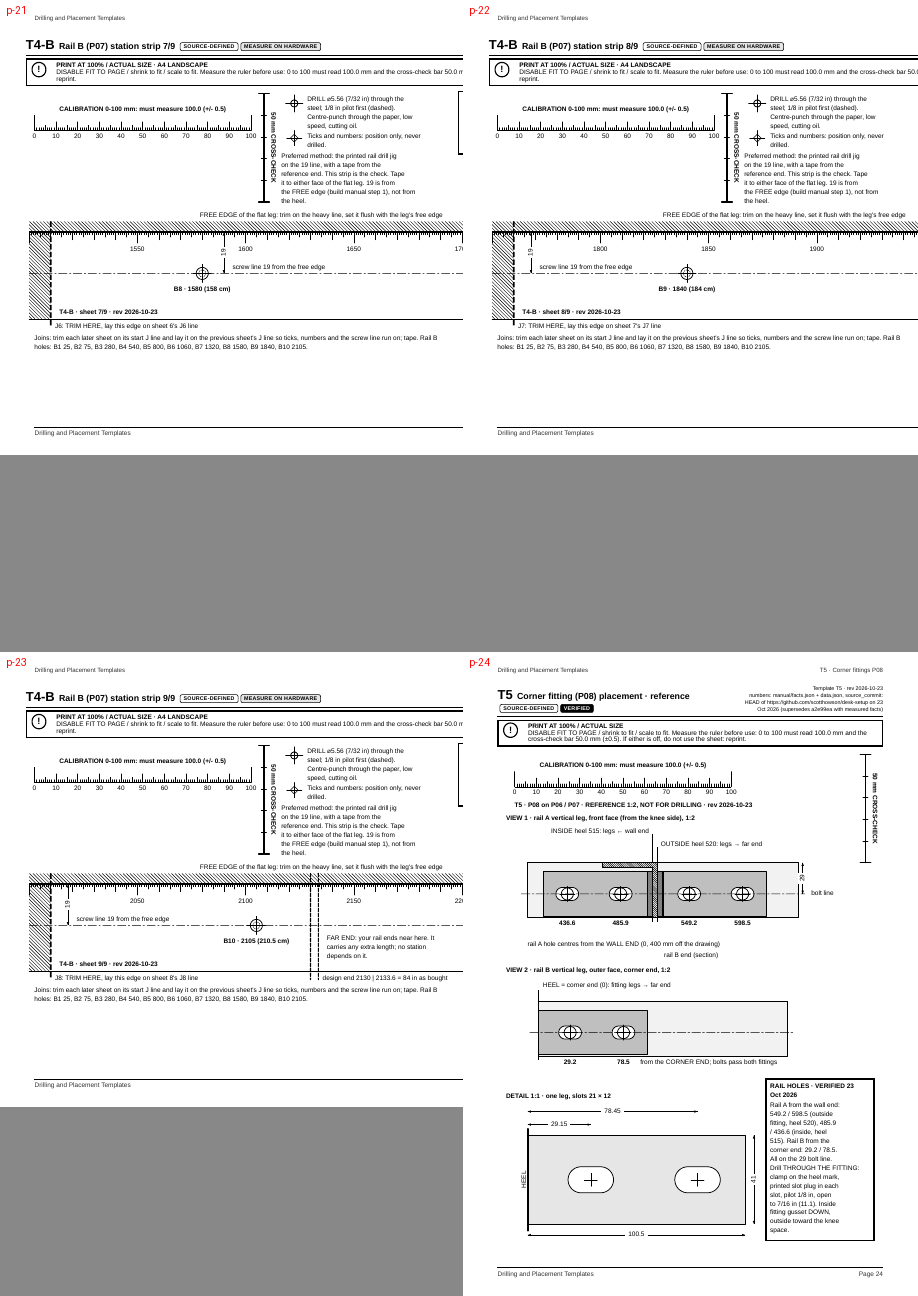
manual/build/png/sheets-templates/s06.png
