scotthowson/desk-setup/manual/build/png/sheets-templates/s07.png

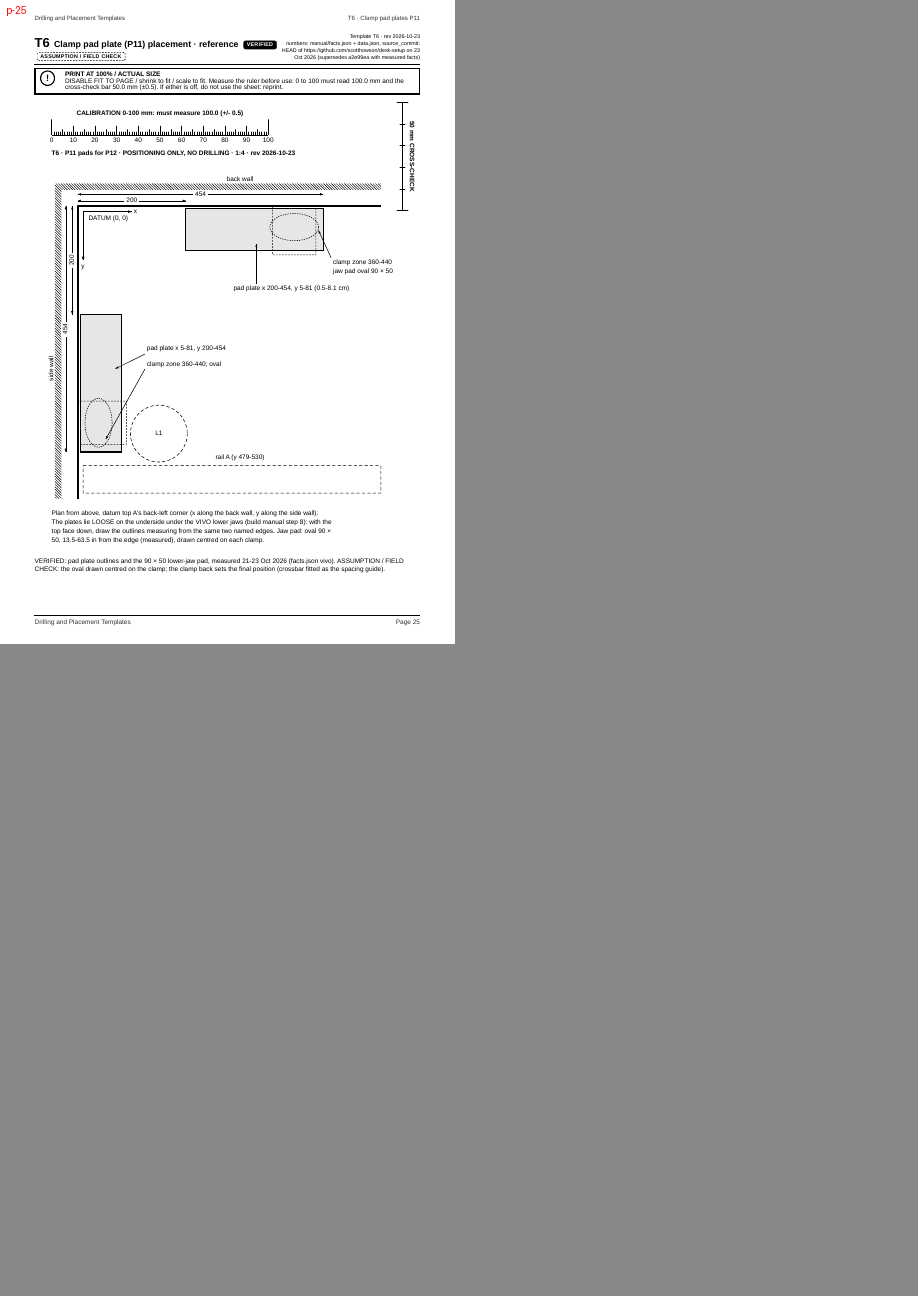
manual/build/png/sheets-templates/s07.png
