scotthowson/desk-setup/manual/build/png/templates/p-01.png

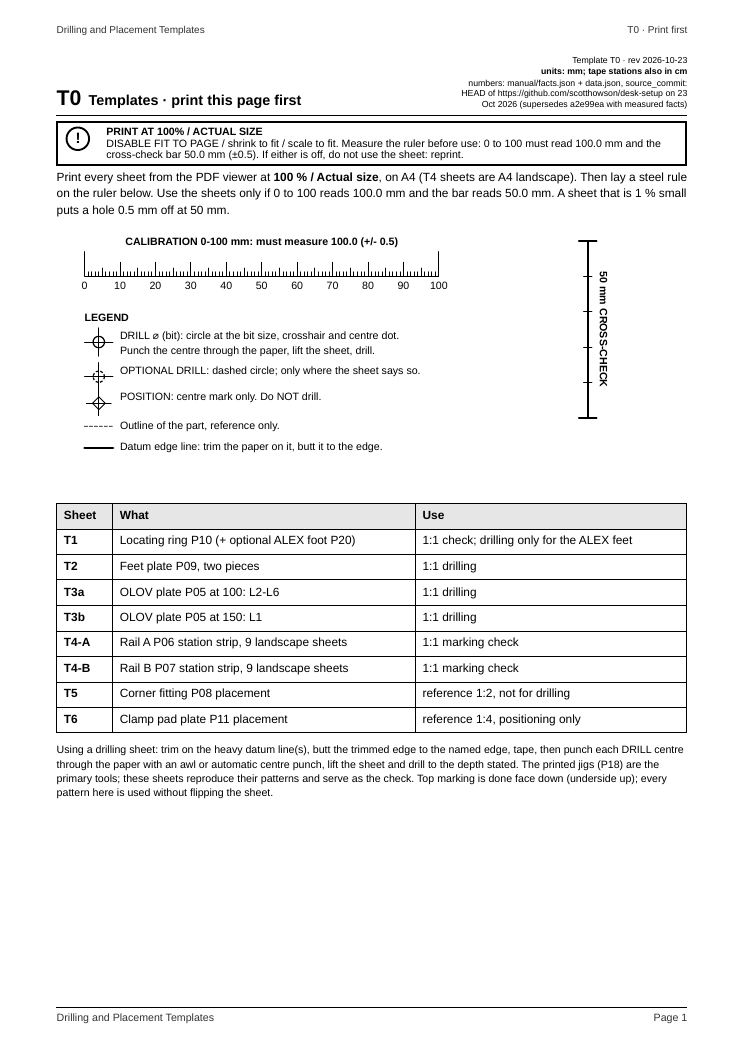
manual/build/png/templates/p-01.png
