scotthowson/desk-setup/manual/build/png/templates/p-02.png

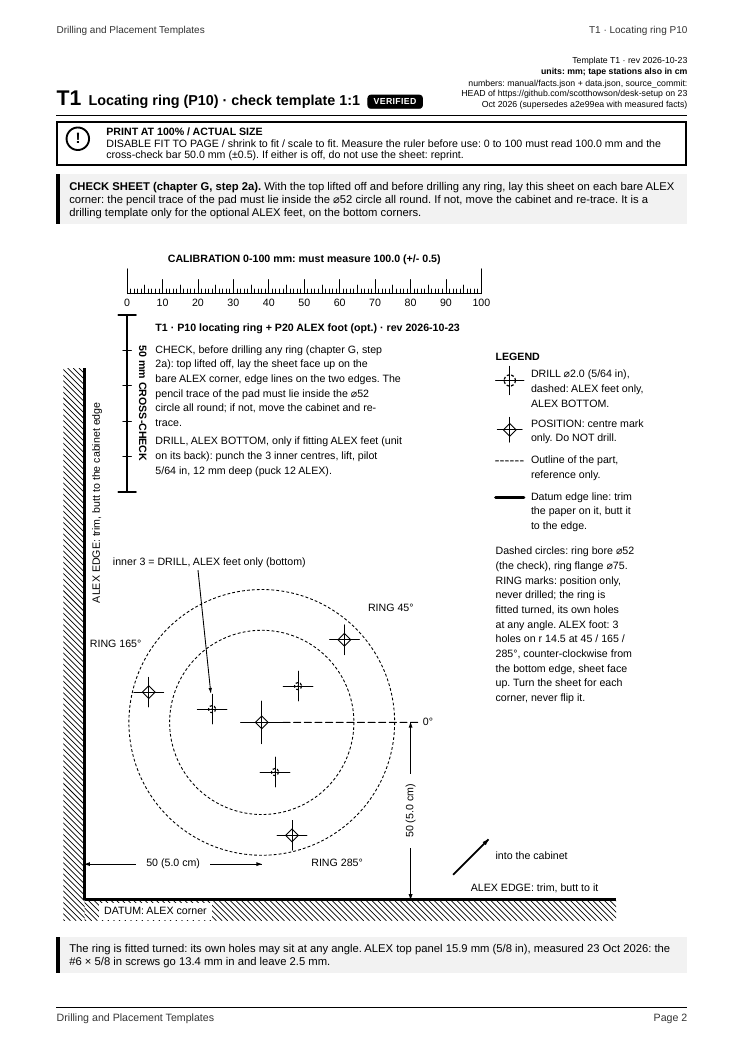
manual/build/png/templates/p-02.png
