scotthowson/desk-setup/manual/build/png/templates/p-03.png

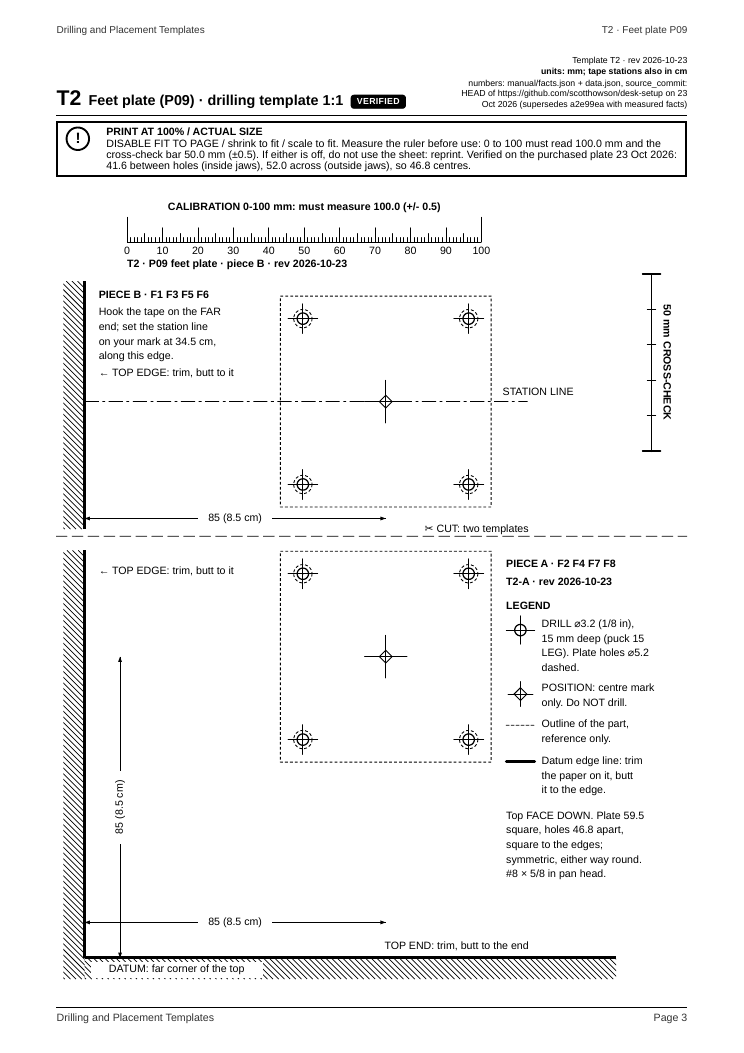
manual/build/png/templates/p-03.png
