scotthowson/desk-setup/manual/build/png/templates/p-04.png

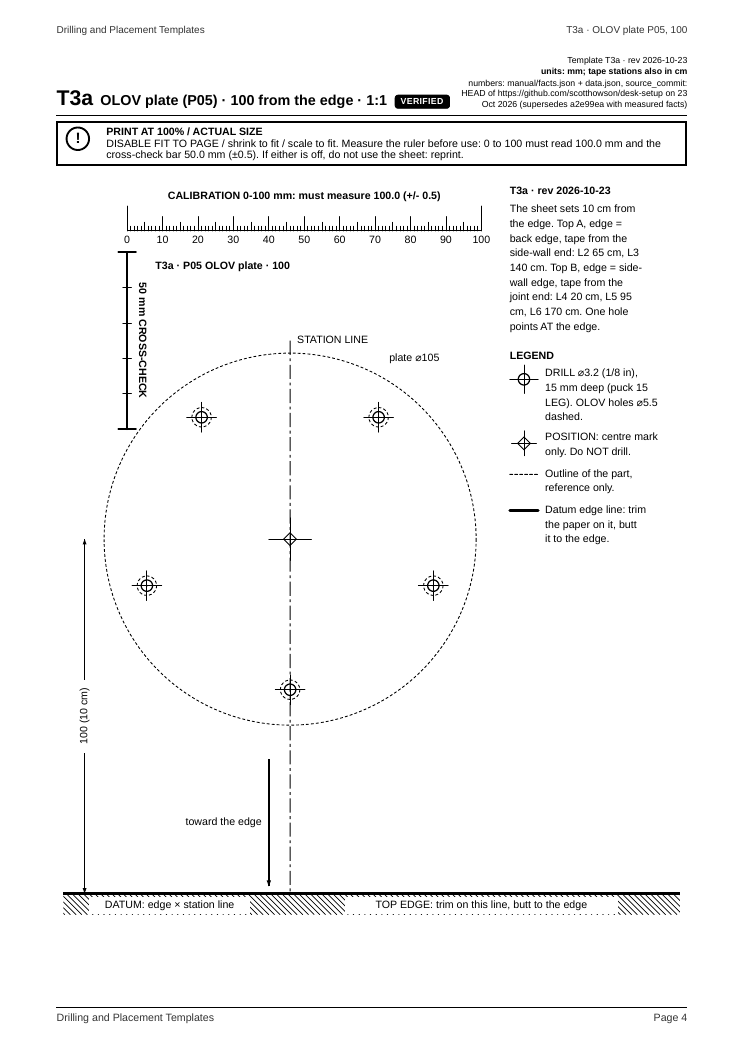
manual/build/png/templates/p-04.png
