scotthowson/desk-setup/manual/build/png/templates/p-05.png

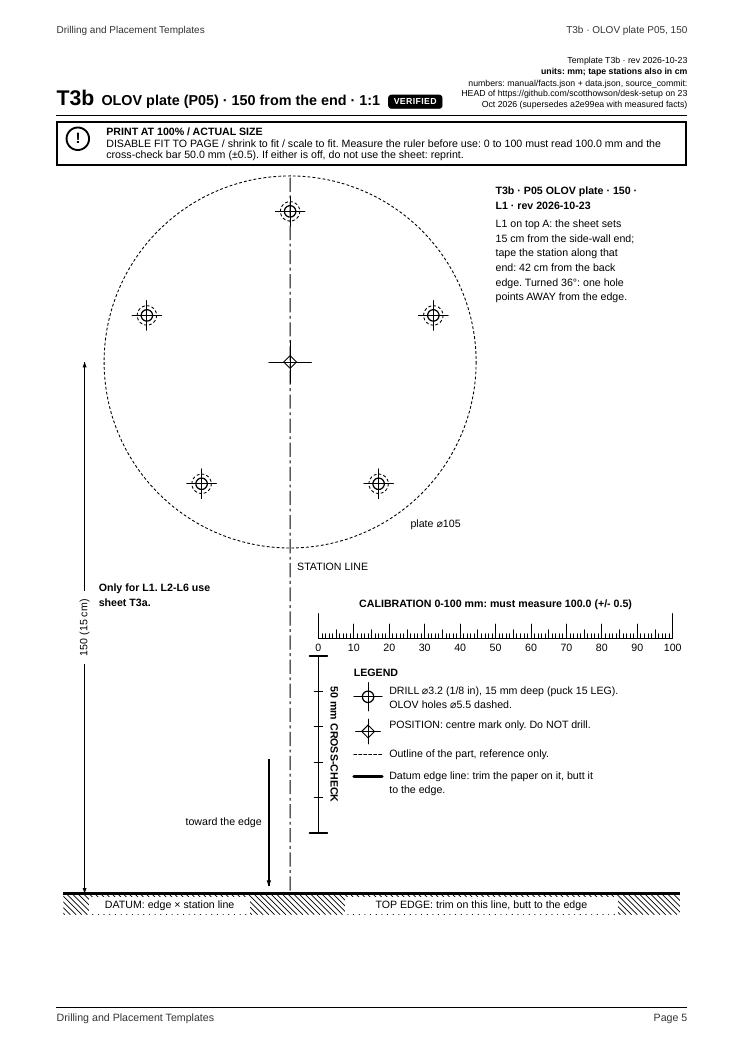
manual/build/png/templates/p-05.png
