scotthowson/desk-setup/manual/build/png/templates/p-06.png

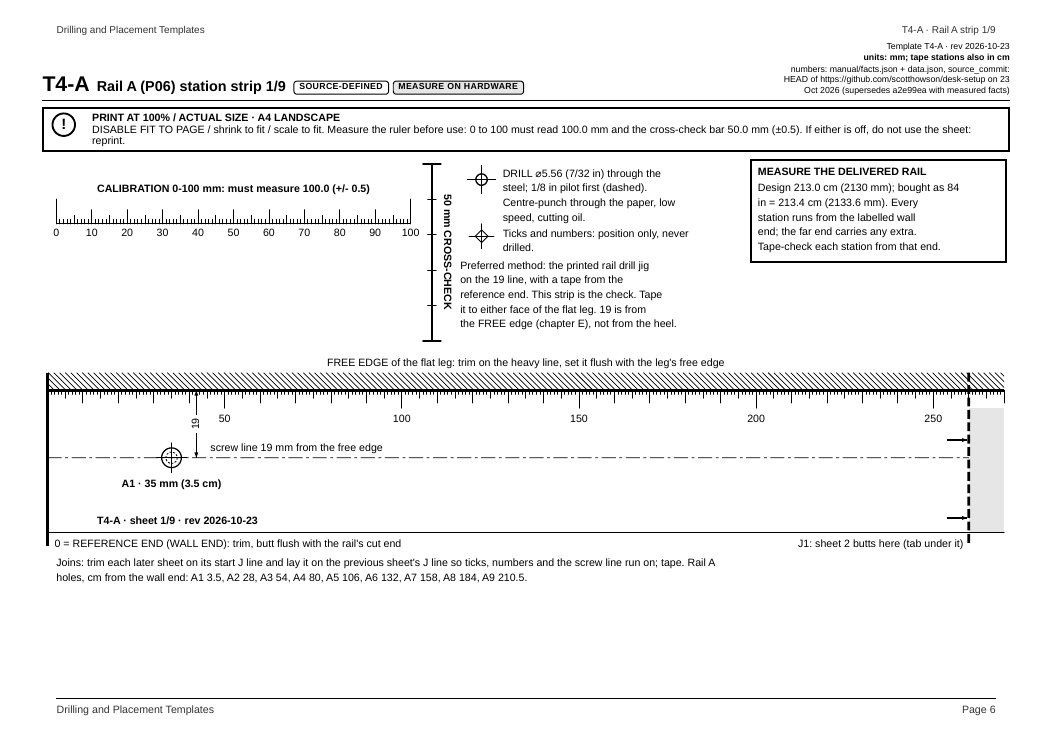
manual/build/png/templates/p-06.png
