scotthowson/desk-setup/manual/build/png/templates/p-08.png

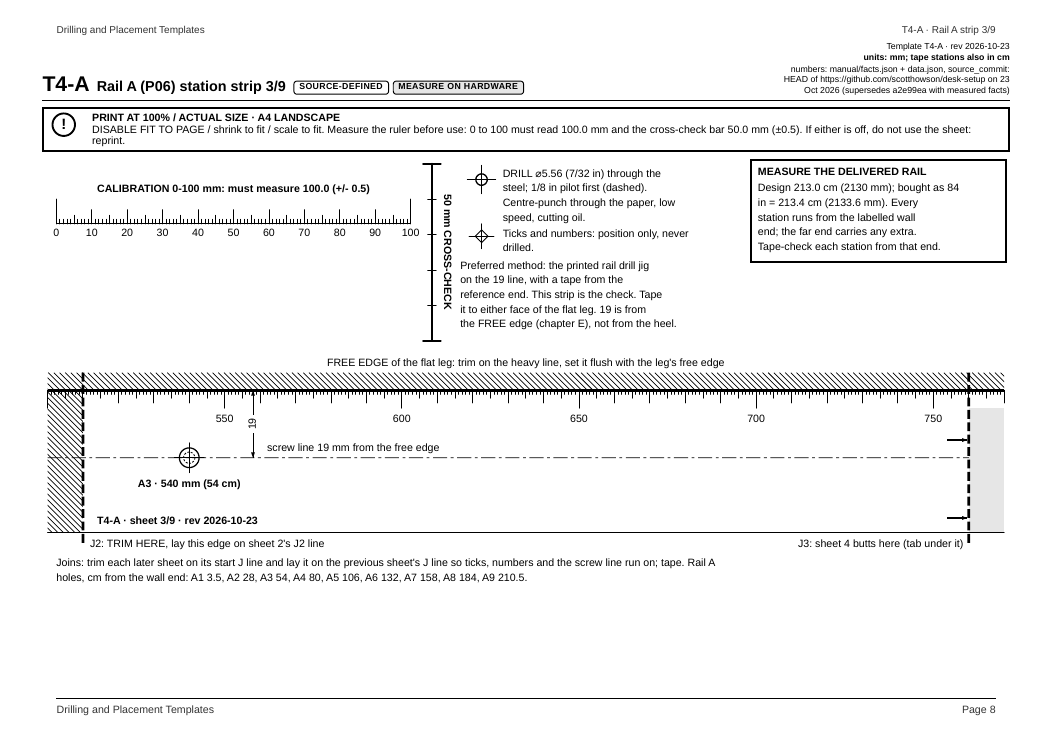
manual/build/png/templates/p-08.png
