scotthowson/desk-setup/manual/build/png/templates/p-13.png

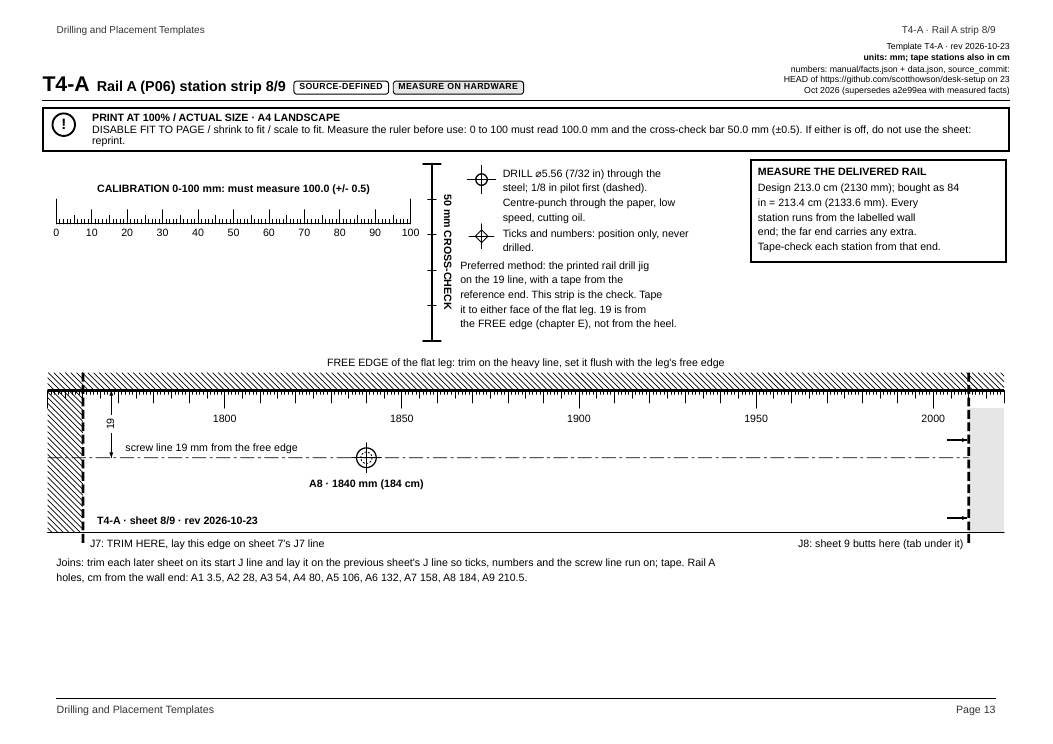
manual/build/png/templates/p-13.png
