scotthowson/desk-setup/manual/build/png/templates/p-14.png

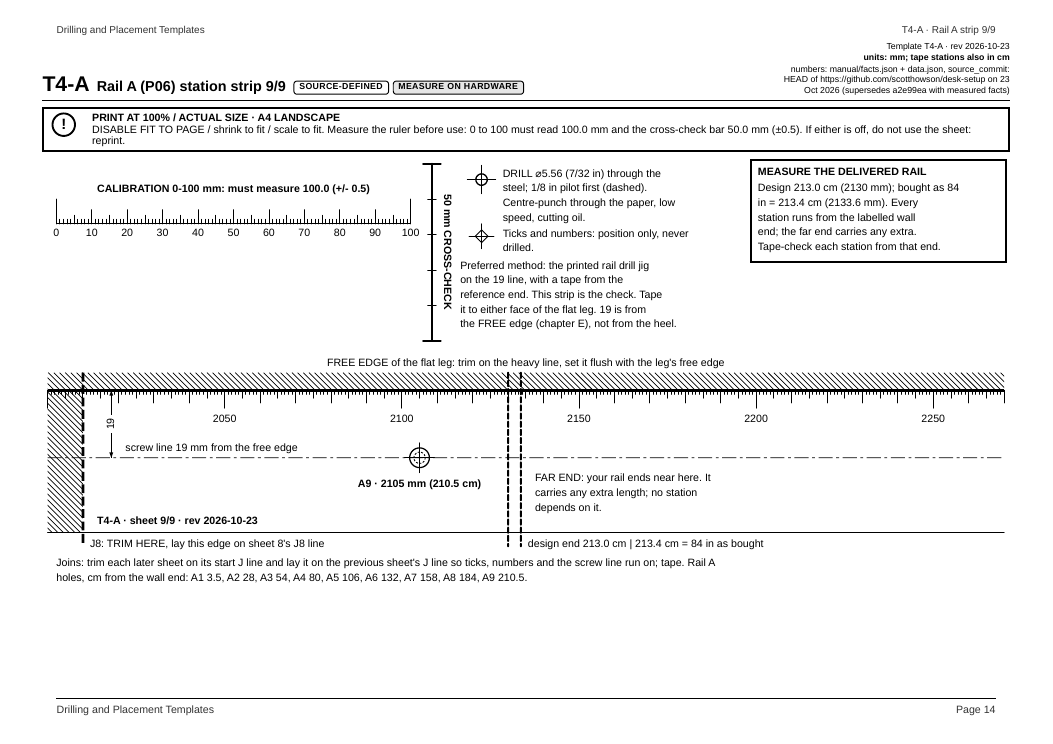
manual/build/png/templates/p-14.png
