scotthowson/desk-setup/manual/build/png/templates/p-20.png

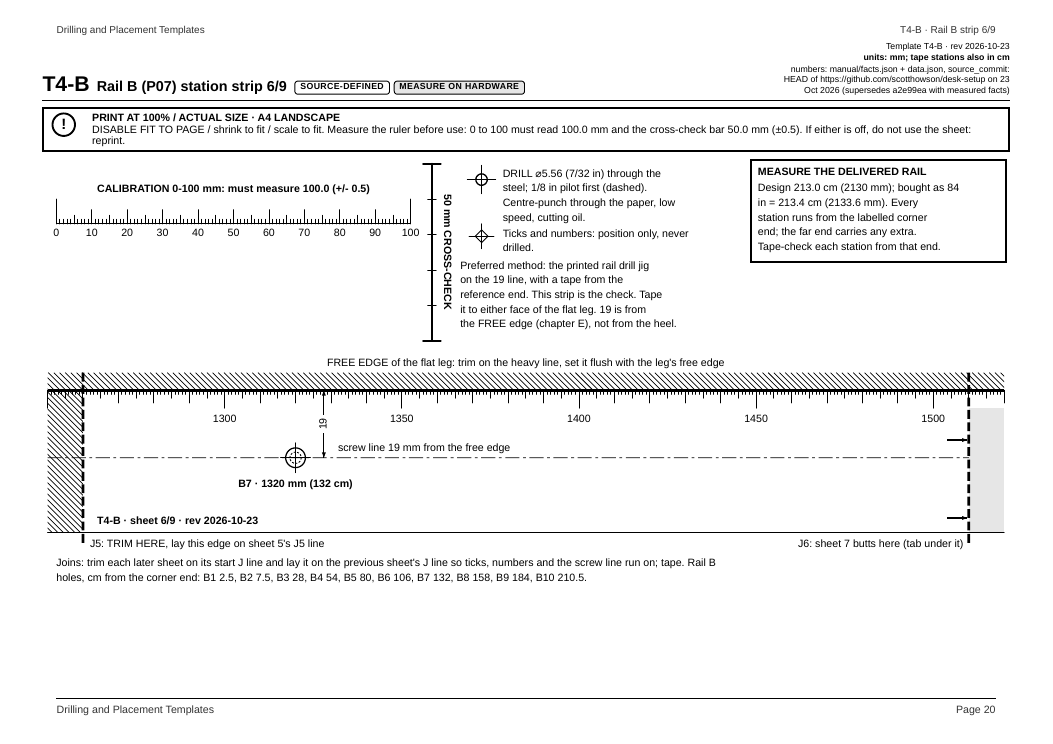
manual/build/png/templates/p-20.png
