scotthowson/desk-setup/manual/build/png/templates/p-21.png

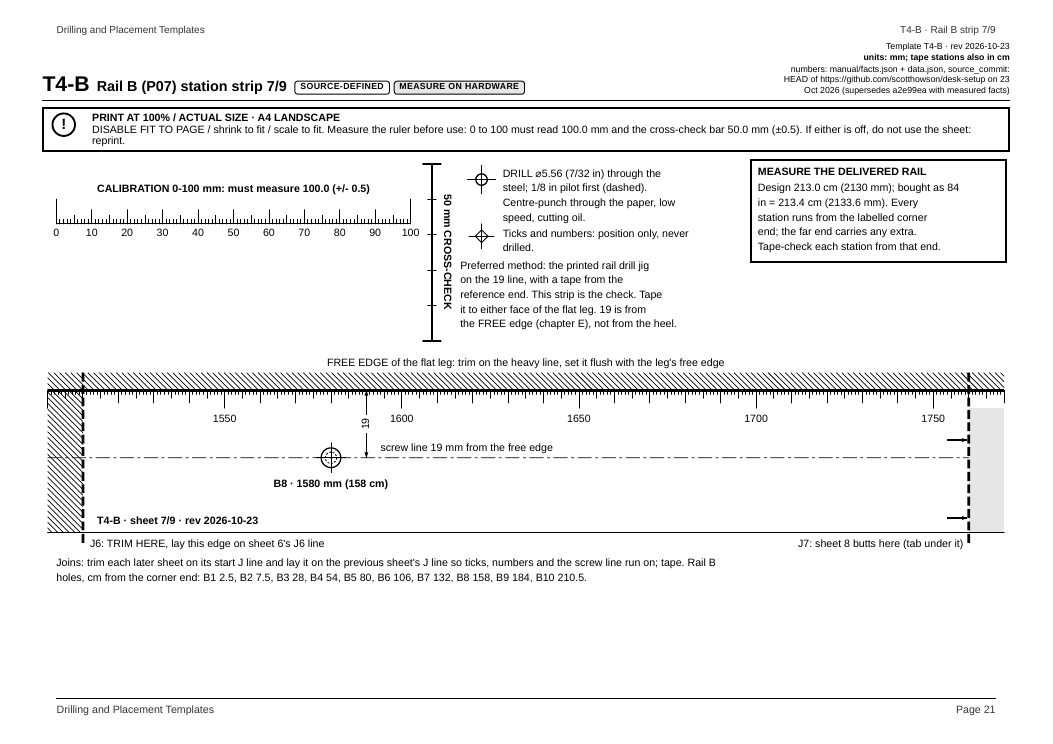
manual/build/png/templates/p-21.png
