scotthowson/desk-setup/manual/build/png/templates/p-24.png

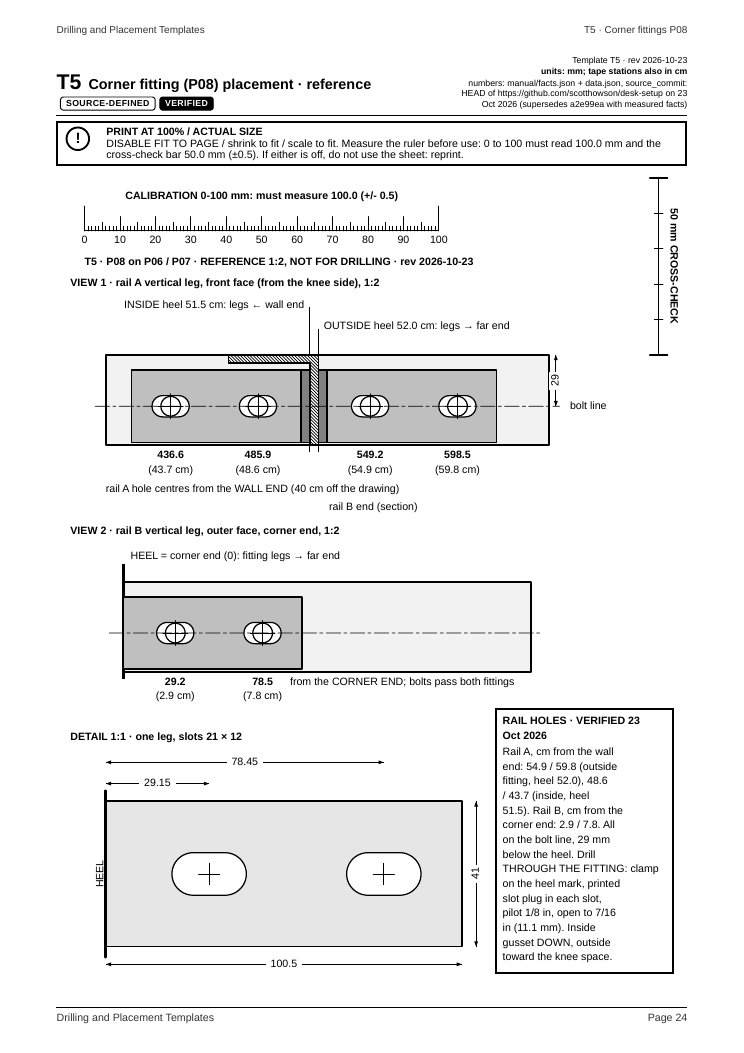
manual/build/png/templates/p-24.png
