scotthowson/desk-setup/manual/build/png/templates/p-25.png

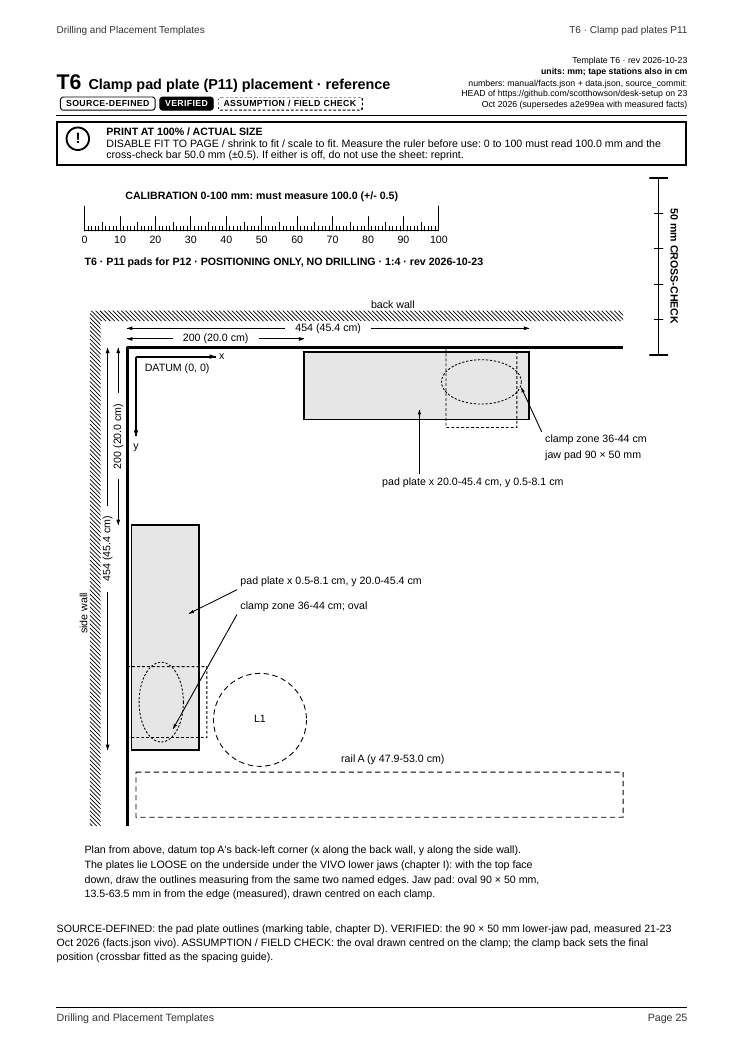
manual/build/png/templates/p-25.png
