scotthowson/desk-setup/parts/tools/pilot-drill-guide-preview.png

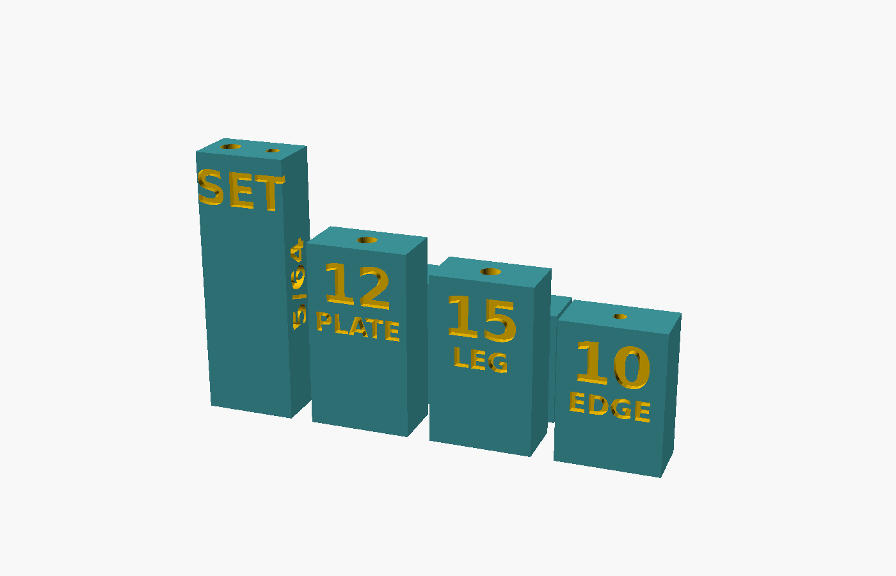
parts/tools/pilot-drill-guide-preview.png
