scotthowson/desk-setup/(commit log)

2026-10-19 VIVO: manual confirms corner mounting, crossbar sets spacing (54–58 cm likely), Option 1 clamp holes
2026-10-19 Close items 3 and 5a: 83 cm kept; OLOV plate 11 cm, screws M4 x 16; note L2 plate clash
2026-10-19 Six OLOV legs: drop the corner leg, L1 to (15, 42), renumber L1–L6; twelve feet with 5 cm plates
2026-10-19 Rails are 2 x 2 x 1/8 in square tube (what the yard stocks): two-hole drilling, 7/8 in screws, 4 in corner brace, rail B against rail A
2026-10-19 Rails: 2 x 2 x 3/16 angle ordered from Metal Supermarkets Ottawa ($161.22, pickup); back to one hole per station, 1 in screws, brace on the vertical legs
2026-10-19 Corner brace: relax to 2 mm or thicker, name sources
2026-10-20 Corner joint: two 5 mm gusseted strut fittings either side of rail B, 3/8 bolts in 7/16 holes, 28 mm below the top
2026-10-20 Walls 3 cm, feet 5 cm in with printed locating rings on the ALEX tops, Acers closer with 15° wrap, lamp beside the Y60, plant to the far end, headset stand, walnut grain
2026-10-20 Build guide (guide.html) with every measurement and dimensioned drawings; fittings 29 mm below the top; Acers to (99, 19), speakers out, half-ring headset, Y60 to the wall
2026-10-20 Guide: plain-words section, glossary, angle cross-section; fitting bolt holes template-drilled on the bench (rail A heel at 52.0 and 51.5, rail B at the end); labels untangled
2026-10-21 Printed locating ring for the ALEX feet: OpenSCAD source and STL (51 mm bore, 75 mm flange, 3 countersunk #6 holes)
    [foot-ring.scad, foot-ring.stl]
2026-10-21 Printed helpers: rail marking gauge, pilot drill guide with flag grooves, rail end caps, snap-on cable hooks, wall-gap strip; parts/README.md
    [pilot-drill-guide.scad, pilot-drill-guide.stl, rail-cable-hook.scad, rail-cable-hook.stl, rail-end-cap.scad, rail-end-cap.stl, rail-marking-gauge.scad, rail-marking-gauge.stl]
2026-10-21 Guide and CLAUDE.md: reference the printed helpers
2026-10-21 Printed parts: edge T-square, ALEX corner template, cable clip, power-bar cradle, cable tray, phone stand; grouped into tools/structure/cables/accessories
    [alex-corner-template.scad, alex-corner-template.stl, cable-clip.scad, cable-clip.stl, cable-tray.scad, cable-tray.stl, edge-t-square.scad, edge-t-square.stl]
2026-10-21 Parts: finish the folder move; marking gauge notch apex at the true 19/29 mm; all twelve STLs dimension-checked against spec
    [alex-corner-template.scad, alex-corner-template.stl, cable-clip.scad, cable-clip.stl, cable-tray.scad, cable-tray.stl, edge-t-square.scad, edge-t-square.stl]
2026-10-21 Tools in print orientation for the P1S/A1 (lip up, labels on the bed face); README print notes
    [alex-corner-template.scad, alex-corner-template.stl, edge-t-square.scad, edge-t-square.stl, rail-marking-gauge.scad, rail-marking-gauge.stl]
2026-10-21 VIVO crossbar measured: 21 1/4 in outer to outer, 4 cm collars, poles 50.0 cm apart; clamps to (40, 0) and (0, 40) everywhere
2026-10-21 Parts: end cap open on the desk face, cable hook magnetic (the flat leg is flush with the top), marking tools halved in thickness
    [alex-corner-template.scad, alex-corner-template.stl, edge-t-square.scad, edge-t-square.stl, rail-cable-hook.scad, rail-cable-hook.stl, rail-end-cap.scad, rail-end-cap.stl]
2026-10-21 Parts: slim drill guide, 240 mm wall-gap strips with hidden edge screws, slotted cable strip, corner piece, print and cut lists, where-it-goes notes
    [pilot-drill-guide.scad, pilot-drill-guide.stl, wall-gap-corner.scad, wall-gap-corner.stl, wall-gap-strip-slot.scad, wall-gap-strip-slot.stl, wall-gap-strip.scad, wall-gap-strip.stl]
2026-10-21 Drill guide is now a stepped depth stop with setting holes (12, 15, 25 RAIL, 12 RING); docs point at it
    [pilot-drill-guide.scad, pilot-drill-guide.stl]
2026-10-21 Joining plates to spec: 10 x 3 x 0.12 in, six holes; use the four end holes, plates at y 53.3-78.7 clear of rail A
2026-10-21 Joining plates: four holes at 2.0/7.0/18.4/23.4 cm along the plate (measured), all four used across the joint
2026-10-21 Four-agent audit applied: drill guide steps usable, marking gauge zero at the lip, tray/cradle rim-mounted, strips and tools in print orientation, handed end caps, 1 1/4 in rail A bolts, inside fitti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
    [alex-corner-template.scad, alex-corner-template.stl, cable-clip.scad, cable-clip.stl, cable-tray.scad, cable-tray.stl, edge-t-square.scad, edge-t-square.stl]
2026-10-21 Wall-gap trim: clamp-notched piece for each VIVO clamp, corner legs 231 mm; clamp projection noted as about 16 mm from the manual
    [wall-gap-corner.scad, wall-gap-corner.stl, wall-gap-strip-clamp.scad, wall-gap-strip-clamp.stl]
2026-10-21 VIVO listing figures reconciled: 23 in base = 20 in pole spacing, 1.4 in poles, 26.5 in centre height limit vs the M7 at 66 cm
2026-10-22 Centre monitor is the Samsung Odyssey G5 32 in (1000R, VESA 75): curved in the model, bottom edge 23 cm, all three screens landscape; clearances rechecked
2026-10-22 Acer weight recorded: 5.6 kg with stand, about 5 kg on each side arm (limit 8 kg)
2026-10-22 Wall-gap clamp piece: enclosed 82 x 19.5 notch centred on desk 40 for the measured 8 cm x 1.75 cm clamp back; 80 mm filler as the adjuster; cut list updated
    [wall-gap-strip-clamp.scad, wall-gap-strip-clamp.stl]
2026-10-22 Crossbar measured 19 3/4 in centre to centre: pole spacing 50.2 cm, clamps at 40 confirmed exact
2026-10-22 Last 50.0 mentions updated to the measured 50.2 cm; clamp back dimensions noted in the review
2026-10-22 Wall-gap trim: hidden click joints
    Every piece (strip, slot, clamp, fillers, corner) gets a 20 x 12 x 1.2 mm pocket on its underside at each end, over the gap, with a blind 2.5 mm pin hole. New wall-gap-connector tile (39 x 11.6 x 1.2, two 2.4 mm pins 20 mm apart) press-fits into two butted pockets so joints stay flush; nothing shows on top. Shared profile, lip, holes and pockets moved to wall-gap-common.scad. Corner legs 231 -> 230 so they end at desk 20.0 where the fillers start. README: 24 joints, 26 tiles, connector row.
    [wall-gap-common.scad, wall-gap-connector.scad, wall-gap-connector.stl, wall-gap-corner.scad, wall-gap-corner.stl, wall-gap-strip-80.stl, wall-gap-strip-clamp.scad, wall-gap-strip-clamp.stl]
2026-10-22 Optional ALEX feet: 2, 4 or 6 cm, with the desk height table
    parts/accessories/alex-foot.scad (h = 20/40/60): round foot under each ALEX bottom corner, 75 mm flange, 40 mm tapered column, three #6 x 5/8 screws on the locating ring pattern so the ALEX corner template marks them, pocket for a TPU pad (alex-foot-pad.scad). Height engraved on the flange. Corner template relabelled "ring / foot centre". Manual, review, guide and handoff get the height table: with 2/4/6 cm feet the surface is 85.0/87.0/89.0, OLOV 82.2/84.2/86.2, rail edge 77.1/79.1/81.1; the plan itself stays at 80.2/83.0.
    [alex-corner-template.scad, alex-corner-template.stl, alex-foot-20.stl, alex-foot-40.stl, alex-foot-60.stl, alex-foot-pad.scad, alex-foot-pad.stl, alex-foot.scad]
2026-10-22 ALEX foot: screws up through the solid column
    56 mm solid column, three #6 x 5/8 screws in 10 mm wells bored from the floor end so each head bears on 6 mm of core and the foot cannot pry; TPU pad now 52 mm. Corner template gains the three inner (r 16) holes for the foot screws. Docs updated.
    [alex-corner-template.scad, alex-corner-template.stl, alex-foot-20.stl, alex-foot-40.stl, alex-foot-60.stl, alex-foot-pad.scad, alex-foot-pad.stl, alex-foot.scad]
2026-10-22 ALEX foot screws 1.5 mm further in: screw circle 14.5 mm, template to match
    [alex-corner-template.scad, alex-corner-template.stl, alex-foot-20.stl, alex-foot-40.stl, alex-foot-60.stl, alex-foot.scad]
2026-10-22 Corner bolts: tight by torque, friction joint explained; review notes angle restraint and the ALEX desk rating
2026-10-22 Review: corner-joint friction margin, ALEX top-panel bending check, screw restraint of the angle; torque wording
2026-10-22 Corner bolts: one instruction everywhere (manual drilling row, review build order, guide glossary and step); estimates labelled; pad and settling checks added
2026-10-22 Corner test with a defined 20 kg load; guide checklist mirrors the manual; clamp pad footprint added to open measurements; ring racking estimate; G5 height fallback
2026-10-22 Review: rails bear through the tops onto the feet plates, not on the cabinets; rail B effective span 226 cm; ring stress labelled nominal
2026-10-22 Review wording: rails do not rest on the ALEX units; bridge stress labelled full-width estimate; corner path distinction
2026-10-22 README: current numbers (six legs, 3 cm gaps, clamps at 40, G5) and links to the guide and parts
2026-10-23 Fitting bolts: 3/8-16 x 1-1/2 in everywhere, one pack of ten
2026-10-23 Drilling tools: rail drill jig (1/8 bore on the 19 line), fitting centring plugs, 10 EDGE step on the drill guide; trim fitted with the desk pulled off the walls (manual 8b); guide section 2 uses the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
    [fitting-centring-plug.scad, fitting-centring-plug.stl, pilot-drill-guide.scad, pilot-drill-guide.stl, rail-drill-jig.scad, rail-drill-jig.stl]
2026-10-23 Feet plate measured: 59.5 mm, 5.4 mm holes 47.4 mm apart. T-square pattern updated; new feet corner jig marks F2, F4, F7, F8 in one placement; rail drill jig thinned to 6 mm
    [edge-t-square.scad, edge-t-square.stl, feet-corner-jig.scad, feet-corner-jig.stl, rail-drill-jig.scad, rail-drill-jig.stl]
2026-10-23 Every printed tool and part named on itself (ALEX / EKB / RAIL / FIT); drill guide steps renamed 12 PLATE, 15 LEG, 10 EDGE, 12 ALEX, 25 RAIL; foot height gauge (102 mm) added; docs follow
    [alex-corner-template.scad, alex-corner-template.stl, alex-foot-20.stl, alex-foot-40.stl, alex-foot-60.stl, alex-foot.scad, edge-t-square.scad, edge-t-square.stl]
2026-10-23 Measured 22 Oct: feet holes 36.6 mm apart (T-square and feet jig re-cut); OLOV plate 105 mm with five holes on r 49.08, new leg jig marks centre + five; docs follow
    [edge-t-square.scad, edge-t-square.stl, feet-corner-jig.scad, feet-corner-jig.stl, leg-jig.scad, leg-jig.stl]
2026-10-23 VIVO pole centre measured 4.37 cm from the edge: clamps at 40 confirmed; lower pad 90 x 50 oval at 13.5-63.5 mm sits on the plate
2026-10-23 Tools: labels read correctly on both faces (use-face text pre-mirrored for the flip), no label off a part or across a feature; OLOV pattern on the 85 mm circle from the shared template; rail drill ji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
    [alex-corner-template.scad, alex-corner-template.stl, edge-t-square.scad, edge-t-square.stl, feet-corner-jig.scad, feet-corner-jig.stl, fitting-centring-plug.scad, fitting-centring-plug.stl]
2026-10-23 Leg jig: solid vs dashed plate circles and ringed 150 holes so the two patterns read apart; positions verified against the shared OLOV template
    [leg-jig.scad, leg-jig.stl]
2026-10-23 Drill guide 10 mm deep instead of 18
    [pilot-drill-guide.scad, pilot-drill-guide.stl]
2026-10-23 Rail marking gauge: 3 mm body, 20 mm wide
    [rail-marking-gauge.scad, rail-marking-gauge.stl]
2026-10-23 Refined for material: drill guide as SET tower + five separate depth pucks (82 x 24 footprint, no chuck clash), T-square 162 x 110, leg jig 205 x 100, corner template 92, foot gauge 76 x 114 x 5. Cab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
    [alex-corner-template.scad, alex-corner-template.stl, cable-clip.scad, cable-clip.stl, cable-tray.scad, cable-tray.stl, edge-t-square.scad, edge-t-square.stl]
2026-10-23 Cable tray preview
2026-10-23 Feet plate holes re-measured 23 Oct: 46.6 mm apart (52.0 outer to outer, 3.9 from the edge); T-square pad and feet corner jig re-cut
    [edge-t-square.scad, edge-t-square.stl, feet-corner-jig.scad, feet-corner-jig.stl]
2026-10-23 Feet pattern 46.9 mm (41.5 inner to inner on the plate); jig holes 5.4 mm at the face tapering to 2.4 so the caliper check matches the plate and a scriber still centres
    [edge-t-square.scad, edge-t-square.stl, feet-corner-jig.scad, feet-corner-jig.stl]
2026-10-23 Feet pattern 47.0 mm: 41.6 between the holes with the inside jaws, as measured on the plate
    [edge-t-square.scad, edge-t-square.stl, feet-corner-jig.scad, feet-corner-jig.stl]
2026-10-23 Feet jigs: straight 5.2 mm holes 46.8 apart, so inside jaws read 41.6 between holes and outside jaws 52.0 across, as on the plate; taper removed
    [edge-t-square.stl, feet-corner-jig.stl]
2026-10-23 Feet jigs, for real this time: straight 5.2 mm holes 46.8 apart (41.6 between, 52.0 across, on both faces)
    [edge-t-square.scad, edge-t-square.stl, feet-corner-jig.scad, feet-corner-jig.stl]
2026-10-23 Feet hole wording 5.2 mm everywhere
    [edge-t-square.scad]
2026-10-23 Jigs are drill jigs: every hole sized for its bit (1/8 in -> 3.5, 5/64 in -> 2.3, bit + 0.3 so FDM prints a running fit), scriber-only 2.5 mm centres; rail jig, plug and pucks on the same rule; docs 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
    [alex-corner-template.scad, alex-corner-template.stl, edge-t-square.scad, edge-t-square.stl, feet-corner-jig.scad, feet-corner-jig.stl, fitting-centring-plug.scad, fitting-centring-plug.stl]
2026-10-23 Manual lib: dimension labels beside the line, unique hatch ids; captions 8.5 pt; L1 note 6.5 mm; plates wording in step 7
2026-10-23 Load test wording: where the case sits, how the straightedge is held; sag row distinguishes the 20 kg test from the worst case
2026-10-23 Consistency: T-square README 46.8; leg jig L1 note; 9/16 wrenches for the 3/8 bolts; top B tape readings from the joint end; ring screw depth 13.4
2026-10-23 Strut fittings measured: legs 100.5 x 41, 21 x 12 slots at 29.15 and 78.45 from the heel; rail hole positions now known; slot plug replaces the round centring plug; model bolts moved; docs, guide, re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
    [fitting-centring-plug.scad, fitting-centring-plug.stl]
2026-10-23 Bolt play wording: slots, not 9/16 holes, in every tightening note
2026-10-23 Bolt play wording: slots in the manual step 7 and the guide glossary
2026-10-23 Guide glossary: slots
2026-10-23 Feet jig labels say 46.8 (the holes already were); ELLOVEN under the G5 in the handoff; tops thickness confidence
    [edge-t-square.scad, edge-t-square.stl, feet-corner-jig.scad, feet-corner-jig.stl]
2026-10-23 Assembly manual, templates and checklist: all chapters, figures and built PDFs (first full build, 64 + 25 + 3 pages)
2026-10-23 Manual conventions: cm for tape measurements, mm for calipers and drills, no arithmetic for the reader
2026-10-23 Slot play 11.5 mm in the plug header and README
    [fitting-centring-plug.scad]
2026-10-23 Rings fitted by tracing the pads (top on the bare cabinet, pencil round each pad, lift, ring on the circle); bore 52 for the 50 pad; ALEX top panel measured 5/8 in (15.9): screws leave 2.5 mm
    [alex-corner-template.scad, alex-corner-template.stl, foot-ring.scad, foot-ring.stl]
2026-10-23 Ring screw circle pinned at r 33 (was derived 33.25 after the 52 bore); corner template references it
    [alex-corner-template.scad, alex-corner-template.stl, foot-ring.scad, foot-ring.stl]
2026-10-23 No arithmetic: 27 mm top needs no change (deepest screw stops 6 mm short); trim gap as a lookup table
2026-10-23 Manual rebuilt: units pass (cm for the tape, mm for calipers), rings by tracing, tools-in-use section, why-the-holes-meet panel, measured fittings and ALEX panel
2026-10-23 Sync: ring 52/58 everywhere (manual checklist, review, guide D, chapters B and C, ring-depth figure), ALEX panel 15.9 replaces the 16 mm rule; rebuilt, no stale text in the three PDFs; clean-clone bu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
2026-10-23 Source fixes from the independent review: feet measured from the far end; gauge feet before plates; ALEX 2 staged 15 cm out then pushed home; never push the top; plates piloted with the plate off; he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
    [rail-end-cap.scad]
2026-10-23 Chapters re-lettered into build order (F legs/feet/rails/cabinets, G standing and rings, H joint with the corner assembly, J trim after the mount, K checks, L maintenance); conventions carry the bind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
2026-10-23 ALEX feet: bottom panel rule is 14 mm or more (screw 9.9 in through the 6 mm roof, pilot 12)
2026-10-23 Manual rebuilt after the independent review: chapters in build order, rails-to-tops step, rings by tracing in G, corner bolting in H, trim as J, checklist keyed to the booklet; dead corner figure scr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
2026-10-23 Sources: 27 mm rule residue removed from manual step 2 and the guide; ALEX 2 staged 5 cm (not 15) with the room run-out stated (side wall 322 cm) and a stop-and-ask; corner template engraving says th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
    [alex-corner-template.scad, alex-corner-template.stl]
2026-10-23 Corner template engraving: ring check only
    [alex-corner-template.scad, alex-corner-template.stl]
2026-10-23 Manual: second independent review applied (room run-out, staging 5 cm, template check before drilling, square check before the plates, rock not turn, pilots finished not restarted, mirrored views cor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
2026-10-23 Showcase film: 1080p 30 s, chair with a curved slatted back, low shot under top B showing the rails, fittings, plates and legs (chair hidden for it), Y60 glass rendered with a blended pass, slower cl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
2026-10-24 Guide: drill bit table (5/64, 1/8, 7/32, 7/16 cobalt) with every hole each one makes
2026-10-24 Manual chapter B: drill bit table; slot plug step uses both plugs (one per slot), parts README agrees
2026-10-24 Guide and manual chapter B: the drill guide in plain words (chuck nose is the stop, 45 minus puck height, do not bottom the bit in the chuck, scrap test)
2026-10-25 Wall-gap trim: pre-rendered 50 and 220 mm end strips, print list names the three short STLs
    [wall-gap-strip-220.stl, wall-gap-strip-50.stl]
2026-10-25 Wall-gap trim: clip-in end cap (half a connector tile with a 28 mm end wall) closes the open end of the gap at each far end; print 2; README, build manual, manual J and C updated
    [wall-gap-end-cap.scad, wall-gap-end-cap.stl]
2026-10-26 Rail setback gauge (120 mm, lip over the front edge, print 2) replaces the three tape readings when clamping a rail; README, build manual, guide and manual chapters B, C, F updated
    [rail-setback-gauge.scad, rail-setback-gauge.stl]
2026-10-26 Guide and manual chapter B: rail setback gauge in five steps
2026-10-26 Corner bolts: never an impact wrench or driver; hand ratchet or torque wrench only (manual H, guide glossary, build manual step 7.5)
2026-10-26 Underware on openGrid: components/underware with the third-party sources, rendered tiles and channels named with print counts, continuous corner run planned in the model (Underware toggle) and in pla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
    [alex-corner-template-x1.stl, alex-foot-20-x8.stl, alex-foot-40-x8.stl, alex-foot-60-x8.stl, alex-foot-pad-x8.stl, alex-foot.scad, cable-clip-x6.stl, cable-tray-x3.stl]
2026-10-28 Mending plates measured: two rows of four holes, 5.0 cm apart; joining plates take 16 screws and washers (H04, H05 16); figure H-2 shows both rows; build finds chromium when google-chrome is absent
2026-10-28 SKÅDIS-compatible pegboard tile source: 40 mm pitch, 5 x 15 slots, dovetail joints, pattern 10 mm in from the edges so the pitch continues across tiles
    [skadis-board.scad]
2026-10-28 SKÅDIS 6x6 tile rendered (print 4) with preview; openGrid 8x9 and 9x9 Lite tiles as extras; README weights from the STLs
    [skadis-6x6-x4.stl, tile-8x9-lite.stl, tile-9x9-lite.stl]
2026-10-28 SKÅDIS tiles: twelve edge positions (TL..BR, L1 M1 R1) with chamfered outer edges, back-side bow-tie keys with snap lips at every joint, 12 mm skirt notched 40 and 60x4 for the MakerWorld 2780289 cla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
    [skadis-6x6-x4.stl, skadis-B-x1.stl, skadis-BL-x1.stl, skadis-BR-x1.stl, skadis-C-x1.stl, skadis-L-x1.stl, skadis-L1-x1.stl, skadis-M1-x1.stl]
2026-10-28 SKÅDIS bottom tiles: straight bottom edge, no clamp notches (sits flush in the clamps); print profile 3-4 walls, 15-20% gyroid
    [skadis-B-x1.stl, skadis-BL-x1.stl, skadis-BR-x1.stl, skadis-L1-x1.stl, skadis-M1-x1.stl, skadis-R1-x1.stl, skadis-tile.scad]
2026-10-28 SKÅDIS keys: real dovetail (11 at the tips, 5 at the waist); README on how the keys hold the pattern true
    [skadis-B-x1.stl, skadis-BL-x1.stl, skadis-BR-x1.stl, skadis-C-x1.stl, skadis-L-x1.stl, skadis-L1-x1.stl, skadis-M1-x1.stl, skadis-R-x1.stl]
2026-10-28 SKÅDIS key: chamfer built from slices, not a hull, so the 5 mm dovetail waist is real; previews
    [skadis-key-x24.stl, skadis-key.scad]
2026-10-29 SKÅDIS key: 0.1 mm fit allowance all round and a bottom chamfer against first-layer squish; tiles unchanged
    [skadis-6x6-x4.3mf, skadis-key-x24.stl, skadis-key.scad]
2026-10-29 SKÅDIS: corner cross brace (four flush pegs, glued from the back, one per inside corner); keys back to the original fit
    [skadis-bracket.scad, skadis-cross-x4.stl, skadis-key-x24.stl, skadis-key.scad]
2026-10-29 SKÅDIS: edge bridges (h and v) with placement rule and counts per board, 3x3 brace map; J-hook and back cable clip
    [skadis-bracket.scad, skadis-bridge-h-x4.stl, skadis-bridge-v-x4.stl, skadis-cable-clip-x6.stl, skadis-cable-clip.scad, skadis-hook-x4.stl, skadis-hook.scad]
2026-10-29 SKÅDIS bracket source: file names and bridge size in the header
    [skadis-bracket.scad]
2026-10-30 SKÅDIS: back ribs with built-in keys (12 x 20 in the slot-free bands, staggered across level joints), wall standoff, hanger library and six accessories (headset and controller hooks, shelf, keyboard 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
    [rib-160-k2-x2.stl, rib-240-k0.stl, rib-240-k1-x6.stl, rib-240-k3-x4.stl, rib-80-k1-x2.stl, skadis-arm-hook.scad, skadis-bracket.scad, skadis-bridge-h-x4.stl]
2026-11-01 Templates T0: the viewer's fit-to-printable-area default shrinks the sheets (97.3 % on the HL-2140, measured); print through lp with print-scaling=none, ruler page first
2026-11-01 Templates: T4 strips on portrait pages, rotated 90° in CSS, so the PDF is all-portrait and CUPS never rotates (its rotate step re-fits to the imageable area, 97 % on the HL-2140, even with print-scal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
2026-11-02 Templates: T7, corner bolt holes 1:1 (rail A's four 7/16 holes from a 40.0 cm tape line with a 62.0 check, rail B's two from the corner end, bolt line 29 below the heel), drilled on the bench; in the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
2026-11-02 Drill jigs: legible labels. Rail drill jig RAIL / 1/8 / 19 at 4.5-5 mm bold, 1 mm deep; pilot drill guide pucks carry the depth as a 7 mm number with the word under it, SET at 6 mm, bit sizes on the 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
    [pilot-drill-guide-x1.stl, pilot-drill-guide.scad, rail-drill-jig-x1.stl, rail-drill-jig.scad]
2026-11-02 Manual D: Fig. D-3 shows L1's 42 from the back edge; L1 row says the jig's lip gives the 15; step 3 says rail A's wall end goes on the 1 cm mark, not flush
2026-11-02 Rail bolt jig: hooks over the heel, 1/8 in bore 29 mm down the vertical leg for the corner fittings' six bolt holes; pilot through it, open to 7/16 free; T7 is the paper check of the same stations
    [rail-bolt-jig-x1.stl, rail-bolt-jig.scad]
2026-11-02 openGrid accessories on the Underware snap: brick dock (parametric, Dell 65 W and G5 defaults to be measured), J-hook, cable-exit comb; snap library reuses monokiniGrip; fit checked against a rendere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
    [og-brick-dock-dell65-x1.stl, og-brick-dock-g5-x1.stl, og-brick-dock.scad, og-cable-exit-x2.stl, og-cable-exit.scad, og-hook-x2.stl, og-hook.scad, og-lib.scad]
2026-11-02 Brick dock: Dell 65 W USB-C sized from Dell's spec (112 x 51 x 28); G5 adapter still to measure
    [og-brick-dock-dell65-x1.stl, og-brick-dock.scad]
2026-11-02 G5 brick dock: 90 x 60 x 29 from the one published listing, 1.5 mm clearance, flagged unconfirmed
    [og-brick-dock-g5-x1.stl, og-brick-dock.scad]
2026-11-02 Laptop sling under top B between the ALEX 2 feet: C-rails 253.4 apart at z 268-314, flared mouths at the far end, USB-C plug carriage at the stop (port position and plug size to measure); in the mode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
    [laptop-sling-carriage-x1.stl, laptop-sling-mouth-x2.stl, laptop-sling-rail-x2.stl, laptop-sling.scad]
2026-11-02 Laptop sling: USB-C plug in a screw-on clip (four M3 slots, 6 mm adjustment along the bay, overmould cradle with zip-tie slots) through a bridged window in the carriage, instead of a fixed pocket
    [laptop-sling-carriage-x1.stl, laptop-sling-usbc-clip-x1.stl, laptop-sling.scad]
